gallicchio/AMOD-and-RFMOD/docs/DESIGN_NOTES.md

# Design notes

What the boards are and why they are the way they are, in one place; the decisions with reasons are in `PLAN.md`,
the night's record in `CLAUDE_CODE_CHAT.md`, the general lessons in `~/OpticsPCBs/CLAUDE_PCB.md`.  Rev A, 2026-10-25.

## AMOD-P: the passive board

13 tiles, 27 jacks, 139 parts.  AMOD-P: the passive board.  Sixteen cells, thirteen tiles (PLAN.md section 4), 27 SMA jacks, two layers.  Every tile here is a ladder (scripts/tiles.ladder) or a hand-laid circuit using the same Tile model; the responses the silkscreen and the handbook quote come from sim/passive.py.

- **p1 pi pad**: 
- **p2 RC low-pass**: 
- **p3 RC high-pass**: 
- **p4 series RLC**: Series RLC between the jacks: 100 uH and 220 pF, with 47 pF and 100 pF switched in parallel with the capacitor by a 2-way DIP.  The line runs 0.65 mm high so the 1210 clears both jacks; the switch lies across the top-right quarter the OUT jack left (its ways as columns), its left column on the L-C node through the gap between the two parts, its right column to the two capacitors standing under it, whose other ends are on the OUT line.  The number, the sections and the IN loop take the bottom-left; no OUT loop (the switch has its corner: OUT is the jack).
- **p5 LC low-pass**: 
- **p6 LC low-pass**: 
- **p7 band-pass**: Four 0603 series parts cannot fit between the stubs (10.5 mm): the row is laid by hand from x 2.3 to 17.7 and the stubs enter round its ends; the outer parts' values go under them, out of the entries' way.
- **p8 quartz crystal**: A 4 MHz crystal in series between the jacks: the sharpest resonance on the board.  An HC-49S is 11.5 mm long, more than either quarter of a cell the jacks leave, so it lies at 45 degrees across the cell, from the bottom-left to the top-right, and the two jacks sit 0.5 mm further out along the other diagonal (TLo, BRo) so its courtyard clears theirs.  Each jack's stub runs straight to the crystal's near pad; the loops stand on the stubs, the number in the top-right corner, the name in the bottom-left, the sections in the gutter above.
- **p9 ceramic res.**: A 455 kHz ceramic resonator in series between the jacks, at 45 degrees across the cell (bottom-left to top-right) between the IN jack (top-left) and the OUT jack (bottom-right); each stub runs to the resonator's near lead.
- **p10 clipper**: A 1 k series resistor and two 1N4148W antiparallel to ground: the tutorial's clipper.  The diodes stand up from the OUT line into the top-right quarter, either side of the OUT loop's lead, each to its own ground via above it.
- **p11 delay line**: 20 LC sections of 1 uH and 390 pF (50 ohm, 20 ns each): a 400 ns tapped delay line on three cells.  Each section is an 0603 inductor on the line and an 0402 capacitor hanging from the node after it, 4.0 mm a section.  The jacks sit on the checkerboard: IN at the first cell's top-left, OUT at its bottom-right, the 100 and 200 ns taps at the second and third cells' top-left, the 300 ns tap at the third cell's bottom-right.  Row A runs right along the line from IN under the top jacks (twelve sections), drops left of the 300 ns jack, and row B runs back along y = 15.25 (eight) into OUT; row B's capacitors stand up, between row A's.  Each tap leaves its node through 470 ohm: nodes 5 and 10 up past row A to a resistor beside their jack, node 15 down under row B and along the bottom edge into its jack from below.
- **p12 LEDs**: Four LEDs on a 4-way DIP from one jack through 100 ohm: V_f against wavelength is Planck's constant.  The switch stands with its ways as rows (pins 1-4 down its left column), the LEDs in a column to its left at the ways' order, each to its own ground via at the tile's edge; the LED loop sits in the empty top-right slot.
- **p13 AM loopstick**: An AM loopstick: a 3-way terminal for the ferrite rod's coil (ends and tap), 47 / 100 / 220 / 470 pF across it on a 4-way DIP, a 2-way terminal beside it for an external tuning capacitor (VAR C, in parallel with the switched ones), the jack on the tap; the rod lies along the board's bottom edge under two pairs of cable-tie slots.  Both terminals take their wires from the bottom edge, and their pins are named in the margin below them.  The DIP and its capacitors fill the right cell's top half: each capacitor's wire leaves its switch pad and turns up or down to its row (the top pad's wire outermost, so none cross).

## AMOD-N: the second passive board

11 tiles, 28 jacks, 84 parts.  AMOD-N: the second passive board, rev A (Prompt 17).  Eleven tiles on sixteen cells: the RF and analog blocks the other boards lacked or dropped, every one passive except two that run on the Pmod's own 3.3 V (no USB): a step attenuator set by hand on a switch or by the FPGA over three Pmod lines, and a one-transistor oscillator.  Prompt 18 gave the attenuator a second cell for its switch and dropped P15 (two Smith-chart loads): n1's 25 ohm standard and n11's switched loads cover the Smith chart.  Jason, Prompt 17: "It seems like there is enough pressure that I should make another analog board.  We should really call this the 2nd board because it's so much simpler than even the active board ... All of the things that you suggested along with some of the things that we've dropped should go on this new analog board ... SLOT for VNA-type calibration, passive splitters" and, mid-turn, "If something can run on 3.3V, it could still be plugged into the PMOD port but wouldn't require an external USB 5V input."  Four layers on JLC04161H-7628 as RF-MOD: L1 the parts and the drawn wires with a ground pour 0.25 mm from every 50 ohm line (coplanar waveguide over L2), L2 ground, L3 the Pmod's 3.3 V under the whole board, L4 ground with the back-side text and the Pmod lines.  Every jack has RF-MOD's launch (no plane under its centre pin) except the calibration SHORT, whose pin is the pour.

- **n1 calibration**: Calibration standards for a vector network analyzer (Jason: "SLOT for VNA-type calibration"): SHORT, OPEN and LOAD at the jacks' pins, a 25 ohm check standard, and a THRU.  Calibrating here puts the reference plane at the board's surface, so every other tile is measured from its pad with its own jack de-embedded (the jacks are all the same part). SHORT: the centre pin is ground, joined all round to the top pour (no launch void).  OPEN: the bare pin with its launch void.  LOAD: 4 mm of 50 ohm line into two 100 ohm in parallel (a matched line is still a match).  25 OHM: two 49.9 ohm at the end of 4.75 mm of line (VSWR 2, a known mismatch to check a calibration with).  THRU: 19.8 mm of line between two jacks.
- **n2 resistive splitter**: A resistive splitter: three 16.9 ohm in a star (50 / 3), every port 50 ohm, 6 dB from any port to either other, DC to 6 GHz, no isolation between the outputs (6 dB of it).  IN at the right cell's top-left, OUT 1 and OUT 2 at the two bottom corners, the star between them so both outputs' lines are the same length (8.7 + 4.65 mm).
- **n3 transformer splitter**: A transformer splitter: Mini-Circuits ADP-2-1+ (case CD636, 0.5-400 MHz, 3 dB plus 0.3, 25 dB between the outputs), turned 270 at the tile's middle so SUM faces the top jack and ports 1 and 2 the bottom corners on lines of the same length; pins 2 and 5 joined by a track under the body and kept off ground, as Mini-Circuits' layout PL-116 does.
- **n4 quarter-wave stub**: A quarter-wave open stub on the line from IN to OUT: 17.3 mm of the same coplanar waveguide, open at its end, a short circuit at the junction at 2.45 GHz (and 7.35 GHz): a notch.  The line's effective permittivity (about 3.1 on JLC04161H-7628) puts the notch within a few percent of 2.45 GHz; measure where it is.
- **n5 low-pass**: A low-pass: Mini-Circuits LFCN-1000+ (LTCC, 1206), DC-1000 MHz, 3 dB at 1.3 GHz, 30 dB from 1.9 to 5 GHz: the harmonics of a 915 MHz synthesizer off, and a clean LO.
- **n6 detector**: A diode detector: 51 ohm across IN (the match), 10 nF in series, a Skyworks SMS7630-006LF pair as a voltage doubler (pin 2, an anode, on ground; pin 3, the joint, the RF; pin 1, a cathode, the output), 100 pF and 100 k on the output. Zero-bias Schottky: square law below about -20 dBm (the output in volts goes as the power), linear above (as the amplitude); 0.9 us of video time constant, so an AM envelope or a pulse comes through.
- **n7 bias-T**: A bias-T: RF in on the top-left jack through 100 nF to RF+DC on the bottom-right, DC fed onto that line through 27 nH, 330 nH and 10 uH in series (the 27 nH nearest the line, for the GHz end) from a test loop (a bench supply's clip, the GND loop beside it), with 100 nF across the DC.  For an active antenna, an LNA at the end of a cable, a varactor or a detector diode's bias.
- **n8 step attenuator**: A digital step attenuator: pSemi PE43711 (QFN-24 4 x 4), 9 kHz-6 GHz, 0-31.75 dB in 0.25 dB steps, set by hand or by the FPGA (Jason, Prompt 18: "If the FPGA pins are high impedance, this would be nice to do manually").  An 8-way DIP switch above the chip: way 1 is SPI (P/S: off = parallel, the chip's "direct parallel" mode with LE held high by 100 k, which pSemi calls "ideal for manual control ... switches or jumpers"; on = serial), ways 2-8 the seven bits 0.25-16 dB (on = that much more attenuation), each pulled down by 100 k standing in the gap beside its line.  In serial mode the seven bits must be off (the datasheet: the parallel inputs grounded), and SDATA, SCLK and LE come from Pmod IO2, IO3 and IO4 (RF-MOD's SPI lines).  Either way the chip needs the Pmod's 3.3 V (150 uA): it is an active switch array. 100 nF blocks at both RF pins (they must sit at 0 V).  Two cells: IN at the left cell's top-left, OUT at the right cell's bottom-right, the chip between them; the plug below the left cell.
- **n9 oscillator**: A one-transistor oscillator on the Pmod's 3.3 V (switched): a Clapp (series-tuned Colpitts) on an MMBT3904 as an emitter follower, 10 uH in series with a BB133 varactor from the base (through 1 nF) to ground, 220 pF base to emitter and 220 pF emitter to ground, 100 k from the supply to the base (about 1.5 mA), 680 ohm in the emitter.  The varactor's cathode sits at (3.3 V + TUNE) / 2 through two 100 k, so TUNE's -2..+2 V moves it from 9.6 to 11.5 MHz (about 10.5 MHz at 0 V); 2.2 pF from TUNE to the same node lets a tone near the oscillator's frequency pull it into lock.  OUT through 22 pF from the emitter (about -22 dBm into 50 ohm).  The transistor stands over the switch's FET (collector down, to the supply); the tank fills the top-right quarter; the supply reaches the bias and the tank, and the output reaches the OUT jack's centre pin, on the back.
- **n10 1:1 transformer**: A 1:1 transformer (Mini-Circuits TC1-1TG2+, 0.4-500 MHz, separate windings) in the top-right quarter: IN over its top onto the primary, the secondary down onto the OUT jack, whose four legs are a ground of their own (an island with no plane within 5.6 mm), so OUT floats.  A balun (OUT's centre and shell are the two halves of a dipole, the tutorial's on-the-air feed) and a ground-loop breaker between an instrument and the host.  The centre tap is left open.
- **n11 1:4 transformer**: A 1:4 transformer (Mini-Circuits TC4-1W+, 3-800 MHz) in the top-right quarter: IN on the primary, the secondary from ground to OUT, so OUT's impedance is four times IN's and its voltage twice.  A DIP switch in the bottom-left quarter puts 200 ohm (IN then reads 50) or 49.9 ohm (IN reads 12.5) across OUT: the turns ratio squared, measured.

## AMOD-A: the active board

12 tiles, 21 jacks, 184 parts.  AMOD-A: the active board.  Sixteen cells, twelve tiles (PLAN.md section 5), four layers: L1 the parts and the drawn wires, L2 ground, L3 the rails as pours (+5 V everywhere, -5 V and +3.3 V in the gutters the tiles reach with a via), L4 ground fill with the Pmod lines and the back-side text.  Every powered tile has the standard header (scripts/tiles.power_header): a slide switch along its left edge and a P-FET between its jacks, so the tile's own rail is dead until the slider is up.  The dense tiles let scripts/router.py find their wires (Tile.route); the silk draws whatever it found, as it draws every hand-laid wire.

- **a1 power**: 
- **a2 x10**: Gain x10: an OPA810 (140 MHz GBW) non-inverting, 1.1 k and 10 k, 50 ohm in, 49.9 ohm out (x10 into a high impedance, x5 into 50 ohm); 14 MHz.
- **a3 x100**: Gain x100 in one OPA810 stage (100 ohm and 10 k): 1.4 MHz, x100 into a high impedance.  The plan's two stages of x10 (9 MHz) did not fit a 20 mm cell beside the switch with 0.2 mm clearances; a4 covers the HF case at x100.
- **a4 LNA**: HF LNA: the OPA847 (SOT-23-6) at x101 (1 k / 10 ohm) in the shared checkerboard geometry (opa_tile_br), 50 ohm at the input, 49.9 ohm out.  DIS (pin 5) is tied to +VS beside it: enabled.  The feedback pair sits right at the pins, as a decompensated amplifier needs.
- **a5 Doppler**: 10.525 GHz Doppler radar: an HB100 module on three jumper wires to a 1 x 3 header (+5 V from the tile's switch, IF, ground), its IF through 1 uF (100 k to ground) into the a2 geometry at x101 (100 ohm / 10 k), 49.9 ohm out.  1 m/s toward the module is 70 Hz; walking, a fan's blades, a speaker cone and breathing are all within reach.  (Rev A's first a5 was a Johnson-noise amplifier: the ECP5-2ADC-2DAC board has that source and a x100 input of its own.)
- **a6 1-bit ADC**: Delta-sigma: a TLV3501 compares the integrator node (IN through 10 k, the FPGA's bit back through 10 k, 10 nF to ground) with a mid-rail reference (10 k / 10 k / 100 n from VS); its bit goes to Pmod IO7 and a loop; the FPGA's bit comes in on Pmod IO8.  +3.3 V so the bit is the FPGA's logic level.
- **a7 PLL 4046**: PLL: a 74HC4046A in TSSOP-16 (rot 180: VCOin, DEMout, R1, R2, PC2, SIGin, PC3, VCC down the left column; GND, C1B, C1A, INH, VCOout, COMPin, PC1, PCP down the right) in the top-right quarter, between the diagonal jacks.  IN through 100 n and 1 k (below the IN jack) into SIGin (self-biased); the VCO (R1 10 k, C1 1 nF: about 100 kHz) out through 470 ohm (in the right strip, beside C1) to the OUT jack and back into COMPin; PC2's tri-state output up through the chip's middle to the 10 k / 100 n lag filter above it, into VCOin.  No loops: probe pin 9 (VCOin, the demodulated FM) and pin 13.
- **a8 heat**: Heater and thermometer: two 15 ohm 2512 in series across VS (0.83 W at 5 V), stacked in the top-left, switched by an AO3400 beside them from Pmod IO6 (10 k pull-down); a TMP235 (10 mV/K + 500 mV) straight above the OUT jack, its output dropping into the jack's pin.  (The plan's NTC divider did not fit beside the two 2512s.)
- **a9 mixer**: Mixer: the MC1496 (SOIC-14 across the cell, rot 90: SIG+, GAIN, GAIN, SIG-, BIAS, OUT+, NC along the bottom; VEE, NC, OUT-, NC, CAR-, NC, CAR+ along the top) on +-5 V.  RF IN through 100 n into SIG+, 51 ohm from each signal input to ground; LO IN through 100 n into CAR+, 51 ohm from each carrier input to a 2.5 V bias (10 k / 10 k / 100 n); 1 k between the gain pins, 3.9 k from BIAS to -5 V (1 mA), 1.5 k loads to the switched 5 V; OUT+ through 100 n to IF OUT (high impedance: 1.5 k source).  The board's Pmod lines pass down the back of this tile's middle x 14 ... 16.5, which the layout keeps free there.  No carrier-null trimmer.
- **a10 impedance**: Impedance and I-V, two cells, +-5 V.  Left: DRIVE IN (50 ohm) into the a2 geometry at x2 (1 k / 1 k): the driven node S, which also leaves through 49.9 ohm on S OUT (the bottom-right jack).  Right: a 4-way DIP picks the reference resistor (47, 470, 4.7 k, 47 k) from S to X, the part under test between X and ground on the DUT jack, and an OPA810 follower brings X out through 49.9 ohm on X OUT.  With the host's two ADCs on S OUT and X OUT (50 ohm: each reads half), I = (S - X) / R and Z = R X / (S - X): an impedance analyzer from DC to a few MHz after an open-short calibration, and an I-V curve tracer to +-4 V and 40 mA.  (Rev A's first a10 was an LED driver and a photodiode amplifier: the ECP5-2ADC-2DAC board has both.)
- **a11 ultrasound**: 40 kHz ultrasound, two cells.  Left: the DRV8837 H-bridge (IN1, IN2 from Pmod IO4 and IO3) drives a transducer in pins 1 and 5 of a 1 x 5 socket along the top edge; the Pmod plug hangs off the bottom edge below this cell, and the board's Pmod lines come down the back of this cell's right third to it.  Right: the second transducer in its socket, 10 nF into the a2 geometry at x100 (100 ohm / 10 k, 3.9 k to ground at +IN) and out to RX OUT at the right cell's bottom-right jack. +-5 V (the op amp), the bridge on the switched +5 V.
- **a12 audio**: Audio, two cells.  Left: a PAM8302A class-D amplifier (MSOP-8, rot 270: IN-, IN+, NC, SD along the top; VO+, VDD, GND, VO- along the bottom; JLCPCB stocks only the MSOP-8, PAM8302AASCR: the SOIC-8 first drawn here did not fit it, which JLCPCB's placement preview showed, Prompt 22) driving a speaker on the screw terminal in the right cell's top-left; its input is SPEAKER IN through 1 u and the one-bit stream from Pmod IO2 through 10 k into 10 n.  Right: an electret in the 1 x 2 socket (2.2 k bias from VS), 1 u into the a2 geometry at x100 and out to MIC OUT.  +-5 V (the op amp; the class-D runs on the switched +5 V).  No 3.5 mm jack: the one-bit stream is heard on the speaker.

## AMOD-C: the conversion board

12 tiles, 26 jacks, 209 parts.  AMOD-C: conversion, rev A (Prompt 19).  Sixteen cells, four layers, USB-C power on c1 as AMOD-A's a1.  Power conversion (a buck and an LDO under an electronic load, a charge pump the FPGA clocks) and data conversion (a second-order delta-sigma with its integrators on jacks, a track-and-hold, a comparator that makes the host's DAC a SAR or tracking ADC), the switched capacitors both use (a filter chip and a capacitor-and-two-switches resistor), and the component-level stages Analog Devices' university labs teach (a differential pair on a current mirror, common emitter against cascode, a precision rectifier, a 555).  `docs/ADI_LABS_SURVEY.md` has the survey; PLAN.md sections 12 and 13 the decisions.  Jason, Prompt 18: "Whole areas that we are missing include power regulation and other component-level circuits, but something like a switched capacitor filter or details of their Delta - Sigma Modulator, if there is room, might be worth it."  L1 the parts and the drawn wires, L2 ground, L3 the rails (+5 V under the board; -5 V in the gutter under row 0, down the left margin and along the bottom margin; +3.3 V in the gutters under rows 1 and 2, joined down the right margin), L4 ground with the Pmod lines and the back-side text.  Every powered tile has the standard header (tiles.power_header): a slide switch and a P-FET, so its rail is dead until the slider is up.

- **c1 power**: 
- **c2 regulators**: A buck converter, an LDO after it and an electronic load, two cells.  Left: the TLV62568 (1.5 MHz, pulse-skipping at light load) from the switched 5 V with 2.2 uH, 10 uF in and out, its feedback 100 k / 20 k (3.6 V) and TRIM (a DAC) through 100 k into the feedback node, so the buck's output moves 2.2-5 V and the LDO can be pushed into dropout; BUCK~ is its output AC-coupled (1 uF, 49.9 ohm) for the ripple.  Right: the TPS7A2033 LDO (3.3 V) from the buck, LDO~ its output AC-coupled likewise; an OPA810 holds 10 ohm at LOAD's voltage through an AO3400A: 100 mA per volt from the LDO's output (LOAD terminated in 49.9 ohm), its loop closed slowly through 1 k and 1 nF so the FET's gate cannot make it ring.  The buck (SOT-23-5 at rot 0: EN, GND, SW down its left; VIN, FB up its right) in the left cell's top-right quarter, EN to VIN under its body, the inductor under SW, the feedback network stacked right of FB; its output along y 9.8 to BUCK~'s coupling in the gutter and on the back to the LDO in the right cell's top-right quarter (turned 0: IN, GND, EN down its left; OUT up its right), whose output goes right and down to LDO~'s coupling over its jack and left and down to the load in the right cell's bottom-left quarter.
- **c3 charge pump**: A charge pump the FPGA clocks: the ICL7660A from the switched 5 V, its OSC pin driven from Pmod IO6 through an SN74LV1T34 and 1 k (the pump runs at half the clock), 1 uF flying and 1 uF on the output, 1 k of load on the output; CAP shows the flying capacitor's top (0-5 V) and OUT the output (about -5 V), each through 47 k / 10 k (read at high impedance).  SOIC-8 at rot 0 (BOOST, CAP+, GND, CAP- down its left at 11.925; V+, OSC, LV, VOUT down its right at 16.875) in the top-right quarter: the flying capacitor standing left of it with CAP's 47 k above, the output capacitor, V+'s capacitor and the load down the right edge, OSC under the body to the 1 k from the buffer below; CAP's 10 k under its jack, OUT's divider over the OUT jack.  VS comes up the back to the buffer and V+; IO6 from the back.
- **c4 SC filter**: A switched-capacitor filter: the MAX7410 (5th-order Butterworth, fc = fCLK / 100, 5 V) clocked from Pmod IO3 through an SN74LV1T34 (the clock pin wants 4.5 V); IN terminated in 49.9 ohm and AC-coupled into the chip's input, biased at COM (2.5 V) by 100 k; OS on COM; OUT AC-coupled through 1 uF and 49.9 ohm to the OUT jack.  The chip at rot 0 (COM, IN, GND, VDD down its left at 12.8; CLK, SHDN, OS, OUT down its right at 17.2), the buffer above its right side, VS up the back along the tile's right edge to SHDN and the buffer.
- **c5 SC integrator**: A switched-capacitor resistor and integrator, two cells along the top: a TMUX4053 (three SPDTs on +-5 V, 3.3 V logic) switches 1 nF between IN and ground on one side (phi1, Pmod IO4) and between ground and the integrator's summing node on the other (phi2, IO8): the parasitic-insensitive integrator, whose resistor is 1 / (f C).  An OPA810 with 10 nF (C0G) and 1 M across it integrates; OUT through 49.9 ohm.  The FPGA makes the two phases, so it can make them overlap on purpose.  The third switch is grounded.  The chip turned 180 in the right cell's top-left quarter (SEL3, SEL2, SEL1, S1A, S1B, D1, D2, VDD down its left at 24.14; GND, VSS, EN, S3A, D3, S3B, S2A, S2B down its right at 29.86), its grounds joined under its body; IN along y 4.75 from the jack; the capacitor standing left of D1 and D2.  The integrator below (the OPA810 at rot 270: +IN, V-, OUT along its top, -IN and V+ along its bottom), the summing node coming down from S2B to a column on its left, the feedback pair lying under it, OUT over to the right and on to the jack between its top legs.  VS up the back from the header; -5 V on the back to the right edge and the gutter.
- **c6 delta-sigma**: A second-order delta-sigma modulator with its insides on jacks, two cells.  Both OPA2810 integrators sit on a 1.65 V virtual ground (VMID: the board's +3.3 V halved by two 0.1 % 10 k), so each one-bit DAC is just an SN74LVC1G3157 switching 10 k between +3.3 V and ground: +-165 uA about VMID, ratiometric with VMID, with no negative reference; 10 k from +3.3 V into the first node cancels IN's own offset from VMID.  IN through 10 k into 220 pF, the first output through 6.8 k into 680 pF; a TLV3501 compares the second output (through 10 k, which limits the current into its input clamps when an integrator rails) with VMID; a 74LVC1G79 registers it on the FPGA's clock (Pmod IO1) and hands the bit to IO7 and to both switches (the first wired the other way round, so both loops are negative).  INT1 and INT2 on their jacks through 3.3 k / 1 k (read at high impedance: about a quarter, offset by 0.38 V).  Full scale +-1.65 V; clock 1 MHz.  The OPA2810 (SOIC-8 at rot 0: OUT A, -IN A, +IN A, V- down its left at 24.5; V+, OUT B, -IN B, +IN B down its right at 29.5) in the right cell's top-left quarter: the first integrator's parts on a column left of it, the second's right of it; OUT A crosses under the body and out of its bottom to the 6.8 k and INT1's divider; +IN A and +IN B on vias under the body joined on the back, V+ on a via under the body.  The comparator and the register over the right cell's top-right, the second switch under the second integrator, the first switch beside its 10 k; VMID's divider in the right cell's bottom-left quarter.  VS comes along the bottom edge and up the back; the bit and IO1 leave on the back for the Pmod plug.
- **c7 track and hold**: A track-and-hold: the LF398 on +-5 V (its minimum), 1 nF C0G as the hold capacitor, LOGIC from Pmod IO5 (high: track; TTL threshold 1.4 V, so 3.3 V drives it), LOGIC REF grounded; IN terminated in 49.9 ohm, OUT through 49.9 ohm. The SOIC-14 turned 90 low in the cell (IN, V-, OUT along its bottom at y 10.08; OFFSET, V+, LOGIC, LOGIC REF, CH along its top at 5.13), the hold capacitor, V+'s capacitor and the logic's via in the band above it; IN down the left to pin 1, its termination below; OUT round the right edge to its 49.9 ohm and in between the jack's right legs; V- to a via under the body and on the back to its capacitor in the strip left of the jack and the bottom margin; VS up the back on the left.
- **c8 comparator**: A comparator for a successive-approximation or tracking ADC whose DAC is the host's: a TLV3201 on +3.3 V (40 ns, 1.2 mV of hysteresis: the TLV3501's 6 mV would be 12 LSB at 12 bits) compares IN with DAC, each averaged with the 3.3 V rail through a matched pair of 0.1 % 10 k (so both sit at 1.15-2.15 V inside the comparator's range and the comparison is unchanged), its decision to Pmod IO2 and a loop.  The gateware runs the search: set the DAC, read the bit, halve the step.
- **c9 differential pair**: A differential pair on a current mirror, two cells along the bottom: a matched NPN pair (DMMT3904W) with IN+ (DAC 1) and IN- (DAC 2) on the bases, each terminated in 49.9 ohm, their emitters on a 1 mA tail (an MMBT3904 with its base at -3.4 V from 6.8 k / 3.3 k and 1 k to -5 V); a matched PNP pair (BCM857BS) mirrors the left collector's current onto the right one, so the output node carries Ic1 - Ic2, which an OPA810 transimpedance stage (1 k) turns into OUT: tanh of the input difference over 2 VT, +-1 V at the tail's full 1 mA.  The mirror (SOT-363 turned 180: E2, B2, C1 down its left; C2, B1, E1 down its right) over the pair (turned 180: E1, E2, C2 down its left; C1, B1, B2 down its right) in the left cell's top-right quarter; IN- comes down the right to B2, IN+ down the left to a via, under the pair on the back to a via right of it and in to B1 (a SOT-363 leaves no room for a via under its body); the mirror's emitters joined under its body; the pair's joined on the left and down the middle under the body to the tail; the mirror's diode node in the channel between the two; the tail standing under the pair with its divider and emitter resistor below.  The output node reaches the TIA (rot 270 in the right cell's bottom-left quarter, its feedback lying under it) on the back.  The Pmod plug in the margin below the left cell.
- **c10 cascode**: Common emitter against cascode: Q1 (one half of a DMMT3904W matched pair) at about 1.4 mA with 100 ohm in its emitter and a 1 k collector load, biased by a chain from the switched 5 V (33 k / 20 k / 10 k: 2.4 V on the cascode's base, decoupled; 0.8 V on Q1's); IN terminated, AC-coupled and through 2.2 k, so the Miller capacitance shows; Q2 (the pair's other half) the cascode; a jumper on the 1 x 2 header shorts the cascode out (common emitter), parked on one pin it leaves it in; Q3 (MMBT3904) an emitter follower at about 6 mA into 1 uF and 51 ohm on OUT.  Gain about -8 at Q1's collector, -6 from IN (the 2.2 k against the stage's 6 k); the cascode lifts the bandwidth several times.  The pair (SOT-363 turned 180: E1, E2, C2 down its left; C1, B1, B2 down its right) in the middle of the top-right quarter, Q2's emitter to Q1's collector under the body; Q1's base out to a via on the right and on the back to the input network's column left of the pair; the header at the right edge; Q3 under the pair, its output down the strip left of the OUT jack and in between the jack's left legs.  C2 reaches the header, Q3's base and its collector resistor on the back; VS comes up the back round the jack's legs.
- **c11 555**: A 555 as a VCO: the TLC555 (CMOS) astable from the switched 5 V, 1 k and 10 k with 10 nF C0G (about 6.9 kHz); CV (a DAC, terminated) into the control pin through 2.2 k moves the thresholds and the frequency; OUT through 3.9 k / 1 k (about 1 V, read at high impedance).  SOIC-8 at rot 0 (GND, TRIG, OUT, RESET down its left at 11.725; VDD, DISCH, THRES, CONT down its right at 16.675) in the top-right quarter; the timing chain (1 k, 10 k, 10 nF) standing down the right edge, TRIG to THRES under the body; RESET to a via under the body and on the back to VS, which comes up the right edge round the jack's legs; OUT down the left to its divider and along the middle to the jack; CV on the back from beside its jack to the 2.2 k standing under CONT.
- **c12 rectifier**: A precision full-wave rectifier: an OPA2197's first half inverts IN through two Schottky diodes (BAT54S), so its second node X is -IN for positive inputs and 0 for negative ones; the second half sums -(IN + 2 X) = |IN|.  10 k / 10 k / 20 k / 10 k / 20 k; IN terminated, OUT through 49.9 ohm.  The chip (VSSOP-8 on KiCad's MSOP-8 pattern at rot 0: OUT A, -IN A, +IN A, V- down its left at 12.29; V+, OUT B, -IN B, +IN B down its right at 16.51) in the top-right quarter; OUT A goes under its body to the diodes' common pin below it, -IN A out to a column on the left that comes down to the X-to-N 10 k standing beside the diodes and on to the first stage's 10 k from IN.  The second half's Rf and V+'s capacitor stand right of the chip, its inputs lie under it on a column from -IN B, OUT B goes down the right edge to the 49.9 ohm over the jack.  X and IN reach the second stage on the back (IN comes down from its jack to the first stage's resistor); VS comes up the back round the jack's legs; -5 V goes down the back on the left to the bottom margin.

## AMOD-M: the motor board

11 tiles, 18 jacks, 205 parts.  AMOD-M: motors, rev A (Prompt 19).  Sixteen cells, four layers, USB-C power on m1 as AMOD-A's a1 and a motor supply of 5-16 V on m2 (a barrel jack), with the USB's 5 V joining it through a Schottky.  A brushed DC motor with its encoder (DRV8251A, the FPGA's PWM, the current and the back-EMF on jacks), a stepper (two DRV8251A), and the actuators whose command comes from a DAC (a servo, a solenoid with its flyback chosen by a jumper, a DC-coupled power amplifier for a voice coil or an electromagnet, a buck stage the FPGA closes the loop on); the sensors those loops need (a linear hall sensor, a reflective optical sensor, a load cell's amplifier).  PLAN.md section 14 has the decisions; the parts research of 2026-10-28 the choices.  Jason, Prompt 19: "motor drivers and mechanical servo-type feedback.  DC motor, stepper motor, 3-pole BLDC motor ... along with encoders or magnetic back reaction or some other fast mechanical feedback."  The brushless half is AMOD-B.  L1 the parts and the drawn wires, L2 ground, L3 the rails (+5 V under the board; -5 V in the gutters under rows 0 and 2 and down the left margin; +3.3 V in the gutter under row 1), L4 ground with the motor rail VMOT (a 1.6 mm track along the top margin and down the gutter between columns 1 and 2, which every motor tile taps), the Pmod lines and the back-side text.  Every tile with a +5 V load has the standard header (tiles.power_header): a slide switch and a P-FET; VMOT itself is not switched.

- **m1 power**: 
- **m2 motor supply**: The motor supply, one cell at the right edge: a 5.5 / 2.1 mm barrel jack (its face at the edge, in the cell's bottom-right quarter; no screw terminal, whose place the board's rubber foot takes: bare leads want a barrel-to- terminal adapter) through an SS34 into VMOT, the USB's +5 V through another; an SMBJ16A (26 V clamp: under the buck's 30 V FETs and the TPS28225's 27 V) and 220 uF on VMOT, which also soak up a motor's braking energy (the Schottkys stop it reaching the supply); a green LED; VMOT / 16 (15 k / 1 k) through 49.9 ohm on the VM jack (top-left).  VMOT leaves on the back down the gutter on the tile's left and along the gutter under row 0 to the bus at x 50, which every motor tile taps.  The electrolytic lies in the top-right quarter, the TVS stands down the left edge, the two Schottkys (cathodes left) in the middle, the divider under the jack.
- **m3 DC motor**: A brushed DC motor with its encoder, two cells along the bottom, the Pmod plug in the margin under the left cell. A DRV8251A (4.1 A, its undervoltage lockout at 4.45 V at most, so USB's 5 V through m2's Schottky runs it) from VMOT: IN1 on Pmod IO7 and IN2 on IO1 (pulled down in the chip: the motor coasts with no FPGA, and sleeps after 1 ms), drive / brake (IPROPI continuous) or drive / coast (the back-EMF shows in the off time) as the gateware chooses; VREF 2.0 V (1.5 k / 1 k from the switched 5 V) with 620 ohm on IPROPI: a 2 A limit, 0.98 V/A, and the tile's switch takes the limit to zero.  An OPA2171 on +-5 V: one half buffers IPROPI onto I through 49.9 ohm, the other takes the terminal voltage, (M1 - M2) / 13 (13 k / 1 k), onto V.  The motor and its hall encoder on a 6-way JST PH (2.0 mm) in the bottom margin: 1 M1, 2 GND, 3 A, 4 B, 5 3.3 V (a TPS7A2033 of its own, so A and B are 3.3 V logic), 6 M2 (an N20 with a ZH plug needs a ZH-to-PH lead); A on IO5, B on IO6 (the encoder's pull-ups, or the FPGA's).  The driver turned 270 in the left cell (its logic up, VM out to the left, OUT1 and OUT2 down and right to the PH); the op amp in the right cell's top-right quarter beside I, its two 13 k at the PH, its inputs up the cell's right edge; V on the left jack, reached along the top.
- **m4 stepper**: A bipolar stepper, two cells above m3: two DRV8251A (4.1 A, IN1 / IN2: the gateware makes EN / PH or microsteps from them) from VMOT, coil A's IN1 on Pmod IO2 and IN2 on IO3, coil B's IN1 on IO4 and IN2 on IO8 (each pulled down in the chip; the assignment is the one whose lanes to the plug never cross).  VREF 1.0 V from the switched 5 V with 620 ohm on each IPROPI: 1 A per coil, and the tile's switch takes the limit to zero; each IPROPI through 10 k onto IA, IB (0.98 V/A, read at high impedance; the 10 k keeps a 50 ohm input from upsetting the regulation).  The motor on a 4-way JST XH (A+, A-, B+, B-) between the drivers at the bottom, each OUT2 on its coil's + pin; VMOT from the bus on the back to each driver's VM. Each driver turned 270, A's in the left cell, B's in the right; the Pmod lines go up from vias above each driver to the gutter over the tile, along it to the left margin and down it to the plug under m3 (BACK_WIRES).
- **m5 servo**: An RC servo, one cell: CMD (a DAC's pulse of 0 / +1 V, terminated in 49.9 ohm) through 10 k into a TLV3501 on the switched 5 V whose threshold is 0.49 V (47 k / 5.1 k), its 5 V output on a 3-pin header (S, +, -) that powers the servo from the same switched 5 V (10 uF beside it); the servo's ground returns through 0.05 ohm, read by an INA181A1 (x20: 1 V/A) onto I through 49.9 ohm.  A 1-2 ms pulse every 20 ms from the DAC sets the angle; the current shows the load. The comparator and the INA181 stand in the top-right quarter, the header at its right edge, the shunt in the middle.
- **m6 solenoid**: A solenoid's low-side switch, two cells at the top left: CMD (a DAC's pulse of 0 / +1 V, terminated in 49.9 ohm) through 10 k into a TLV3501 on the switched 5 V (threshold 0.49 V, as m5), its output through 49.9 ohm to an NCE6020AK's gate (60 V, 20 A, 40 mohm at 4.5 V; 100 k holds it off), the FET lying in the left cell with its tab (the drain) to the right.  The coil on a 2-way screw terminal at the top of the right cell (wires in from the top margin): VMOT on pin 2 from the bus beside it (10 uF), the drain on pin 1.  The flyback by jumper on a 1 x 3 header: 1-2 a B5819W from the drain to VMOT (slow decay: the current circulates at the diode's 0.4 V), 2-3 an SMAJ24A from the drain to ground (fast decay: the drain clamps near 30 V), no jumper the FET's own avalanche near 70 V.  The source returns through 0.05 ohm, read by an INA181A1 (x20, on +5 V) onto I through 49.9 ohm (1 V/A); the drain through 5.1 k / 100 ohm onto VD through 49.9 ohm (the drain / 52).  The comparator above the FET as in m5, the shunt and the INA181 under it, the header, the clamps and the divider in the right cell's left half; the drain reaches the terminal on the back.
- **m7 linear amp**: A DC-coupled bridge amplifier, two cells in row 2 on the right, for a voice coil, a speaker as an actuator or a maglev's electromagnet: a TCA0372 (two 1 A power op amps, 40 V) from VMOT.  Side A inverts IN (terminated in 49.9 ohm) with a gain of 2 about VMOT / 2 (10 k in, 20 k back, its + input at VMOT / 6), side B inverts side A about VMOT / 2 (10 k, 10 k): the load between them sees 4 x IN, +-4 V for +-1 V, both ends at VMOT / 2 with IN at 0.  One chain (2 x 15 k, 20 k, 10 k: 3 : 2 : 1) sets both + inputs, so their ratio holds whatever VMOT is.  The load on a 2-way screw terminal in the right margin; its current through 0.1 ohm (in series, on side A's lead) read by an INA181A1 (x20 about 2.5 V from 1 k / 1 k) and an OPA810 on +-5 V that takes away the 2.5 V and halves it: I = 1 V/A, through 49.9 ohm.  No switch: the amplifier runs from VMOT, which no switch takes away, and sits at 0 V across the load with IN at 0.  The TCA0372 dissipates up to VMOT^2 / (4 R): about 1 W is its limit (thermal shutdown beyond), so 8 ohm at 5-6 V, or 30 ohm and more at 12 V.  The TCA0372 turned 270 at the right end of the right cell (its inputs to the left, its outputs to the terminal), the chain to its left, the shunt and the INA181 under the terminal, the difference amplifier in the left cell's lower-left corner; side A's output reaches side B's input on the back.
- **m8 buck stage**: A synchronous buck power stage the FPGA closes the loop on, two cells at the bottom right: PWM (a DAC's square wave, 0 / +1 V, terminated in 49.9 ohm) through 10 k into a TLV3501 on +5 V (threshold 0.49 V, as m5) that drives a TPS28225 (5 V gate driver, 14 ns adaptive dead time, its own bootstrap diode; 220 nF of bootstrap; its EN from the tile's switch through 100 k, so the switch stops it) and two AO3400A (30 V, 32 mohm at 4.5 V) from VMOT (22 uF beside them); 47 uH (SWPA6045, 1.2 A) into 2 x 22 uF, the output on a 2-way screw terminal in the right margin.  At 200 kHz from 12 V to 5 V the ripple is about 0.3 A peak to peak.  The inductor's current through 0.05 ohm (between it and the output) read by an INA181A1 (x20) onto I through 49.9 ohm: 1 V/A, as m5's and m6's, one way only (at light load the synchronous stage's current dips below zero and I sits at 0 there); VO / 16 (15 k / 1 k) through 49.9 ohm.  The half-bridge, its input capacitor and the inductor along the right cell's top, the driver under the FETs, the shunt and the INA181 under the inductor; the comparator, the switch and VO's divider in the left cell.
- **m9 hall**: A linear hall sensor, one cell: a DRV5055A3 (25 mV/mT at 5 V, +-85 mT, ratiometric about half its supply) in the top-left quarter where a magnet can come close, on the switched 5 V; an OPA810 on +-5 V subtracts half the supply (two 20 k from VS and ground on its -IN, the same ratio as the sensor's) and scales by 0.39 (10 k / 3.9 k): OUT is 9.75 mV/mT, +-0.83 V at +-85 mT, through 49.9 ohm.  The maglev and the position loops' sensor.
- **m10 optical**: A reflective optical sensor, one cell: a QRE1113GR (IR LED and phototransistor in one 2.9 x 3.6 mm package, best at 1 mm, useful to a few) in the top-left quarter facing up; the LED at 21 mA through 180 ohm (0805) from the switched 5 V; the phototransistor's collector held at 0 V by an OPA810 (its emitter on -5 V through 100 ohm), so OUT = 1 k x the collector current (0.1-0.9 mA: 0.1-0.9 V), with 100 pF across 1 k, through 49.9 ohm.  Distance, a reflective mark on a wheel (a tachometer), an edge.
- **m11 load cell**: A load cell's amplifier, one cell, always on (no switch: the bridge draws 5 mA): a 4-way JST XH standing down the left edge (1 E+ red, 2 E- black, 3 S- white, 4 S+ green) excites the bridge from +5 V; an INA828 on +-5 V at gain 201 (249 ohm, lying above it between pins 1 and 8) reads it, REF on ground, its output through 49.9 ohm onto OUT (the INA828's own 10 kHz at this gain is the filter).  A 1 mV/V cell at 5 V gives 5 mV at full load: about 1 V out.

## AMOD-B: the brushless board

12 tiles, 13 jacks, 145 parts.  AMOD-B: brushless, rev A (Prompt 19).  Sixteen cells, four layers, USB-C power on b1 as AMOD-A's a1 and a motor supply of 5-12 V on b2 (a barrel jack), with the USB's 5 V joining it through a Schottky.  A gimbal motor (a GBM2804H-100T class, 12N14P) on four radial slots over an MT6701 magnetic angle sensor and two linear hall sensors in the middle of the board, on a 2 x 2 tile; a DRV8311H three-phase driver under it from three FPGA PWM lines, its low-side current amplifiers on jacks and a DAC's COAST that lets every phase float; the bus current and one phase's current in line, the phase voltages against a virtual neutral (the back-EMF), the encoder's analog angle, the halls, an index sensor under the rotor's rim, a vibration pickup and an IMU on SPI.  PLAN.md section 14 has the decisions; the parts research of 2026-10-28 the choices.  Jason, Prompt 19: "3-pole BLDC motor (like for a drone or even better a gimbal), along with encoders or magnetic back reaction or some other fast mechanical feedback."  The brushed motors and the slow actuators are AMOD-M.  L1 the parts and the drawn wires, L2 ground, L3 the rails (+5 V under the board; -5 V in the gutters under rows 0 and 2, along the bottom margin and down the left margin; +3.3 V in the gutter under row 1, which runs under the gimbal's middle, with a band over the gimbal's side slots, which cut the strip, so the middle under the encoder joins the rest), L4 ground with the motor rail (VMOT from b2 down the gutter between columns 2 and 3 to b12's shunt, VMB from it on to the driver), the lines between tiles (the Pmod's SPI lines up the gutter between columns 0 and 1 to b6, the encoder's, the halls' and the index's from b5; BACK_WIRES) and the back-side text.

- **b1 power**: 
- **b2 motor supply**: The motor supply, one cell at the right edge (AMOD-M's m2 with a 12 V clamp): a 5.5 / 2.1 mm barrel jack (its face at the edge) through an SS34 into VMOT, the USB's +5 V through another; an SMBJ12A (20 V clamp, under the DRV8311's 24 V absolute maximum) and 220 uF on VMOT, which take a motor's braking energy; a green LED; VMOT / 16 (15 k / 1 k) through 49.9 ohm on the VM jack.  VMOT leaves on the back left to the gutter beside the tile and down it to b12.
- **b3 BLDC driver**: The three-phase driver, two cells along the bottom, the Pmod plug in the margin under the left cell: a DRV8311H (3-20 V, 5 A peak, 210 mohm) from VMB in 3x PWM mode: INHA on Pmod IO5, INHB on IO1, INHC on IO2 set each phase high or low; the three INL pins together are EN, from COAST (a DAC's 0 / +1 V, terminated in 49.9 ohm) through a TLV3501 on the driver's own 3.3 V (AVDD): COAST high floats every phase, so the back-EMF shows on b4.  The strap pins left open: MODE 3x PWM with a 9 A trip, SLEW 180 V/us, GAIN 1 V/A.  nSLEEP from the tile's switch (10 k, 100 k down); nFAULT left open.  Its low-side current amplifiers SOA and SOB (CSAREF = AVDD: 1.65 V + 1 V/A) each shifted to 0 by 3.3 k from SOx and 10 k to -5 V (1.65 x 10 = 5 x 3.3): IA, IB = phase A's and B's currents while the low side conducts, 0.75 V/A from 2.5 k (no amplifier: an ADC's or a scope's high-impedance input reads them).  The motor on a 3-way screw terminal at the top of the right cell (wires in from the gimbal above), its phases C, B, A from the left; phase A out to b11's shunt and back.  The driver turned 90 in the middle (VM and the outputs to the right, INH up to vias for the Pmod lanes on the back, the current amplifiers down), COAST's comparator by its jack.
- **b4 back-EMF**: The back-EMF, one cell left of the driver: each phase through 13 k / 1 k (/14: 12 V reads 0.86 V); with every phase floating (b3's COAST) the three dividers are the motor's ground, so A and B read each phase against the neutral: its back-EMF, the sinusoid a spun motor makes.  A and B followed by an OPA2171 on +-5 V, through 49.9 ohm; C's divider keeps the star balanced.  The phases arrive on the front along the gutter over the tile from b3.
- **b5 gimbal**: The gimbal motor, four cells in the middle of the board: its stator on four radial slots (3.4 mm wide, 6-10 mm from the centre: M2-M3 screws on any of the patterns reported for a 2804, the motor turned to suit) over an MT6701 (14-bit, SSI: CLK on SCK, CSN on CS ENC, DO to b6's buffer, which puts it on MISO only while CS ENC is low; its analog angle and its 3.3 V to b7) at the centre, where a 6 x 2.5 mm diametric magnet on the shaft's end sits 0.5-2 mm above it (the motor on spacers); two DRV5055A3 linear halls under the rotor's magnets 14.5 mm out, 17.1 degrees apart (120 electrical degrees for 7 pole pairs), to b10; a QRE1113 under the bell's rim 16.5 mm out toward b9 reads a white mark once a turn.  The motor's leads go to b3's terminal; no jacks here (the bell would cover them).  The motor's outline and its stator's are drawn on the silk.
- **b6 IMU**: The IMU and the SPI lines' junction, one cell left of the gimbal's lower half: an LSM6DSO (gyro to 2000 dps, accelerometer to 16 g, both to 6.66 kHz) on SPI (mode 3, 10 MHz) and the 74LVC1G125 that puts the encoder's DO on MISO only while CS ENC is low (the MT6701's DO never lets go), so the two share the Pmod's MISO.  The five lines come up the gutter on the back from the plug under b3 (BACK_WIRES); SCK, CS ENC and DO go on to the encoder on b5; the +3.3 V from the strip in the gutter over the tile.  Stand the board on edge with the motor's axis horizontal and the accelerometer sees the roll about it: a one-axis gimbal's level reference.  No jacks: its data comes over the Pmod.
- **b7 angle**: The encoder's analog angle, one cell at the top left: the MT6701's OUT (0 to its 3.3 V over a turn, a sawtooth) from b5 into an OPA810: ANG = 0.51 x (OUT - 1.65 V), +-0.84 V over the turn, through 49.9 ohm (the 1.65 V from 20 k / 20 k of the same 3.3 V, so it tracks: the MT6701's own, which comes with the angle up the gutter on the back).  The angle without the SSI: a scope's or an ADC's view of the shaft.
- **b8 vibration**: A vibration pickup, one cell at the top: a piezo disc on a 2-way screw terminal (wires in from the top margin) into an OPA810 charge amplifier (1 nF with 1 M across: OUT = -Q / 1 nF above 160 Hz), through 49.9 ohm.  Stick the disc to the motor's mount: the cogging and the commutation's ripple, the bearing's noise, the frame's resonances.
- **b9 index**: The index, one cell at the top over the gimbal: the QRE1113 under the bell's rim (on b5) held at 0 V on its collector by an OPA810 (its emitter on -5 V through 100 ohm): IDX = 4.7 k x the collector current, 100 pF across, through 49.9 ohm.  A white mark on the bell's rim gives a pulse once a turn: an index for the encoder, a tachometer.
- **b10 halls**: The halls, one cell left of the gimbal: the two DRV5055A3 under the rotor's magnets (on b5, 120 electrical degrees apart) each less half its 5 V (20 k / 20 k) times 0.39 (10 k / 3.9 k), as AMOD-M's m9: HA, HB = 9.75 mV/mT through 49.9 ohm.  Two sinusoids in quadrature-ish: an analog encoder of the rotor's electrical angle, the commutation a hall-sensored motor uses, and the rotor's field to compare with the back-EMF.
- **b11 phase current**: Phase A's current in line, one cell right of the driver: phase A from b3 through 0.05 ohm and back to the motor's terminal, read by an INA240A1 (common mode -4 to 80 V and its PWM rejection: the phase swings the whole supply at every edge) about half its 5 V (REF1 on 5 V, REF2 on ground) and an OPA810 that takes the 2.5 V away: IPA = the phase's whole current, both ways and through every PWM state, 1 V/A, through 49.9 ohm.  Set beside b3's IA (the low side only, sampled) it shows what a low-side amplifier misses.
- **b12 bus current**: The bus current, one cell beside the gimbal: VMOT from b2 through 0.1 ohm (VMB on to the driver), read by an INA181A1 about 2.5 V and an OPA810 as AMOD-M's m7: I = the driver's supply current, 1 V/A both ways (negative while the motor brakes and gives its energy back), through 49.9 ohm.  With VM it is the electrical power in; against the phase currents it is the driver's losses.  The shunt and the INA181 in the top-left corner beside the bus, the difference amplifier right of them, I bottom right.

## RF-MOD: the RF board

10 tiles, 24 jacks, 164 parts.  RF-MOD: 915 MHz and 2.4 GHz, rev A.  Four layers: L1 the parts, the drawn wires and, on the RF tiles, a ground pour 0.25 mm from every 50 ohm line (coplanar waveguide over L2); L2 ground; L3 the rails (+5 V everywhere, +7.8 V in the gutter under row 1); L4 ground with the back-side text.  Every jack of an RF tile has a launch void under its centre pin (no copper on L2-L4 within 2.2 mm, the top pour 1.9 mm away) and every 50 ohm line a fence of ground vias.  Every tile keeps IN at the top-left slot and takes OUT at the bottom-right slot (not top-right as the AMOD boards do): the jacks then form a checkerboard whose closest pair is 14.85 mm apart instead of 10.5, room for fingers and a wrench.  Rev A builds what JLCPCB had in stock on 2026-10-25: a diode-ring mixer (r1, in the splitter's place since Prompt 15), the two filters (r2, r4), the QPL9547 LNA (r5) and a GALI-84+ gain block (r12), the power and reference tile (r9), two ADL5350 mixers (r7, r8), a MAX2871 synthesizer (r10, which carries the Pmod plug) and the TRF3722 quadrature transmitter (r13: Jason's "Yes. Add that tile.", Prompt 13). The printed antennas, the RFX2401C front end and the LTC5510 mixers stayed out.

- **r1 diode mixer**: A double-balanced diode-ring mixer: Mini-Circuits ADEX-10L+ (case CD542, 10-1000 MHz, LO +4 dBm) in the top-middle of the left cell (rot 0: LO pin 6 top-left, RF pin 3 bottom-right, IF pin 2 bottom-middle, ground 1, 4, 5), LO from the top-left jack along y 4.75 between its legs and up into pin 6, RF from pin 3 to the right cell's top-left jack, IF straight down to the left cell's bottom-right jack.  The right cell's bottom half draws what is inside the package: the LO balun, the ring of four Schottky diodes (two of them crossed), the RF balun whose centre tap is the IF.  Passive, no power: the comparison with r7/r8's ADL5350 at 915 MHz and with AMOD-A's a9 Gilbert cell at 10-30 MHz (Jason, Prompt 15: "Do the diode-ring mixer instead of the least useful passive splitter").
- **r2 2.45 GHz filter**: 2.45 GHz band-pass: Murata LFB212G45SG8A127 LTCC (2.0 x 1.25 mm), 1.7 dB loss, 2.4-2.5 GHz, 50 ohm both sides; pads 4 in, 2 out, 1 and 3 ground (as JLCPCB numbers them).
- **r4 915 MHz filter**: 915 MHz band-pass: RF360 B39921B2672P810 SAW (1.4 x 1.1 mm, 5 pads), 902-928 MHz, 1.1 dB loss; pad 1 in, 4 out, 2, 3 and 5 ground (the datasheet's section 4).  The output pad sits 0.29 mm above the line: a short 45 degree jog brings it back; pad 3, below it, joins pad 2's ground.
- **r5 LNA**: 
- **r7 TX mixer**: 
- **r8 RX mixer**: 
- **r9 power**: Power and reference, two cells.  Right cell: AMOD-A's USB-C input (CC pull-downs, 2 A PTC, 5 V TVS, 2 x 10 uF) and an MT3608 boost (22 uH, SS34, 12 k / 1 k: 7.8 V) with 10 uF out, feeding the +8V strip in the gutter below through two vias (its own and the divider's); a yellow LED says 7.8 V is up, a green one that 5 V is in.  Left cell: a TPS7A2033 makes 3.3 V for a TC32H4 25 MHz TCXO whose output a 74LVC1G17 buffers through 51 ohm to the REF OUT jack (top-left); the synthesizers' REF IN jacks are unterminated: REF OUT into r10's REF IN, and a back trace takes it on to r13.
- **r10 synthesizer**: 
- **r12 gain block**: 
- **r13 I/Q transmitter**: 

## PhMOD: the physics board

10 tiles, 26 jacks, 232 parts.  PhMOD (AMOD-2 until Prompt 17): magnetic resonance, the ionosphere and light, rev A.  The second-level HF board, for the ECP5-2ADC-2DAC board, whose converters sample DC to 30 MHz directly: a 1 W pulse amplifier and a duplexer with a low-noise preamplifier for pulsed NMR, a coil driver for gradients and Helmholtz pairs, a two-channel HF receiver front end, VLF loop amplifiers, a 50 ohm reflection bridge for complex S11, coupled and parametric resonators, a switched noise source and a laser driver with an RF bias-T.  Four layers: L1 parts and drawn wires, L2 ground, L3 the rails (+5 V everywhere, -5 V in the gutter under row 0), L4 ground with the back-side text; +-15 V only reach the pulse amplifier, on the back from h1 below it.  Designed for Prompt 13 (the second-level boards, for the ECP5-2ADC-2DAC board).  PLAN_LEVEL2.md section 3 has the reasons and the changes from Appendix D's first AMOD-2 (the optics tiles moved to a future board).

- **h1 power**: Power, two cells, no jacks.  Left: the TPS65131 boost and inverter make +15 and -15 V from the 5 V (1 M / 88.7 k and 1.3 M / 105 k, TI's 4.7 uH and Schottky rectifiers, 3 x 10 uF on each output), carried up the back to h2's pulse amplifier only.  Right: AMOD-A's USB-C input (5.1 k CC pull-downs, 2 A PTC, 5 V TVS, 2 x 10 uF) and the LM2664 that makes -5 V into the strip in the gutter above; a green LED on +5 V, a red one on -5 V, a yellow one on +15 V.
- **h2 pulse amplifier**: The pulse amplifier: a THS3491 (VQFN-16 at (12.0, 8.5), rot 0: FB, -IN, +IN down its left, VOUT on its right, +VS on top, -VS along the bottom) at gain 10.3 (698 ohm from its FB pin, which is the output, to -IN; 75 ohm to ground) from +-15 V.  IN is terminated in 49.9 ohm, so a DAC's +-1 V into 50 ohm becomes +-10 V into a 50 ohm load: 1 W.  OUT is not back-terminated (it drives the T/R switch and the probe).  PD from Pmod IO1 through 4.7 k, 10 k to ground: off unless the FPGA holds it high, so it is silent between pulses; it heats if left on at full power (pulse it).  +-15 V come up the back from h1.
- **h3 duplexer and preamp**: NMR's duplexer and preamplifier, two cells.  Left: TX IN through two pairs of crossed 1N4148W diodes to PROBE: the pulse passes (1.4 V drop), the transmitter's noise between pulses does not.  Right: LINE (from the probe through a quarter-wave cable, or a short cable and a 6 dB pad) clamped to ground by crossed diodes and terminated in 49.9 ohm, into AMOD-A's op-amp tile with an OPA847 at gain 12 (1.1 k / 100 ohm), 49.9 ohm out to RX OUT.  With the quarter-wave line the clamp shorts its far end during the pulse, so the probe sees an open there; between pulses the echo reaches the preamplifier.
- **h4 coil driver**: The coil driver, one cell in the board's corner: a DRV8876 H-bridge in PH/EN mode (Pmod IO6 enables and is the PWM, IO7 the direction; 100 k holds both low), nSLEEP and the 5 V divider from the switched rail.  VM through two B5819W: USB's 5 V (4.6 V) or 12-18 V on the right-margin terminal, whichever is higher (the 25 V bulk capacitor sets the limit).  IPROPI into 1.5 k sets the current limit with VREF (5.1 k / 3.3 k: 2 V) and is buffered by an OPA810 (from VM) into MON through 49.9 ohm. The coil on the lower terminal.  The chip at (13, 12.5), rot 0: control pins down its left, the charge pump, VM and OUT2 down its right, OUT1 at its foot; the diodes above it, the buffer beside the MON jack; IO6 / IO7 come down the back at x 9.55 / 8.95 to vias beside pins 1 and 2.
- **h5 HF receiver**: The two-channel HF receiver front end: two LMH6629 amplifiers (0.69 nV/rtHz, gain 9.9), 50 ohm in and out, from a few kHz to 100 MHz, on one switched 5 V; the host's ADCs sample both coherently (the host's own front end rolls off at 23 MHz; add a 30 MHz low-pass ahead of it for a station beside an FM transmitter).  It carries the Pmod plug in its bottom margin.
- **h6 VLF loop amplifier**: A VLF / LF loop amplifier, one cell: the loop (or a ferrite rod's coil) on the IN jack through an SMA lead, 1 uF into an OPA810 biased at half the supply by 100 k / 100 k (the loop is a low-impedance source; the 50 ohm termination stays off), gain 101 (10 k / 100 ohm, the 100 ohm to ground through 1 uF: a 1.6 kHz high-pass), 100 pF across 10 k (a 160 kHz roll-off that keeps the AM broadcast band out), 1 uF and 49.9 ohm into OUT.  The LMH6629 tile's core with other values.
- **h7 reflection bridge**: The reflection bridge, two cells, +-5 V.  DRIVE (the top-left jack) feeds node D; 49.9 ohm from D to A, which runs right along y 4.75 to the DUT jack (the right cell's top-left); 49.9 ohm from D to B and 49.9 ohm from B to ground.  With a 50 ohm DUT the bridge balances (A = B); in general A - B = B x Gamma.  Two OPA810 (SOT-23-5, rot 270) stand under the line, each input a millimetre or two from its node: U1 at gain 2 on B (INC, through 49.9 ohm to the left cell's bottom-right jack) and U2 as a difference amplifier, +IN on A and 499 ohm from U1's output to -IN, 499 ohm feedback: 2 A - 2 B (REFL, through 49.9 ohm along y 10 to the right cell's bottom-right jack).  REFL / INC = Gamma, complex, at every frequency the host makes.  -5 V comes down the back from the gutter above at x 14.6 and 19.8; VS up the back from the switch at x 10.2.
- **h8 coupled resonators**: Coupled and parametric resonators, two cells, passive: two 10 MHz LC tanks (TDK's 10 uH NLV32, Q about 30), each tuned by a back-to-back pair of BB133 varactors whose cathodes sit at half the supply through 100 k / 100 k.  Like two cavities each has weak capacitive ports: SIG (terminated in 49.9 ohm) drives tank 1 through 2.2 pF, and 2.2 pF from each tank feeds its OUT jack, which the host's 50 ohm ADC input loads (about -43 dB, no buffer, no loading of the tank).  TUNE / PUMP reaches tank 2's varactor cathodes through 100 k (DC: tank 2's frequency, half the open-circuit voltage) and 1 nF (RF: the pump at twice the resonance).  A DIP4 switches 1 pF and 2.2 pF of coupling between the tanks and 2 k of damping across either.  Tank 1 in the left cell's top-right quarter on a bus along y 4.75, tank 2 in the right cell's on y 5.5; the switch under the right jack, its top row fed along y 8.55 - 9.35 from the left and y 9.0 from the right, its bottom row joined to tank 2 round its right side.
- **h9 noise source**: A switched HF noise source: the base-emitter junction of an MMBT3904 in avalanche (the base at -5 V, the emitter fed from the switched rail VN through 680 ohm: about 8 V across it at 2-3 mA), its noise straight into an LMH6629 at gain 9.9 (the h5 channel without its input termination) and out through 1 uF and 49.9 ohm.  A TPS22917 load switch makes VN from the tile's 5 V when Pmod IO8 is high: off is the cold state of a Y-factor measurement (the amplifier's own noise), on the hot. The switch and the junction stand in the top-left quarter (no jack there), the amplifier in the top-right; -5 V comes up a finger of L3 from the gutter below.
- **h10 laser driver**: The laser driver with an RF bias-T, two cells.  SET (terminated, 1 k / 100 nF) drives OPA810 U1 and a 2N7002 that pull SET / 1 k through 1 k from VS: REF = VS - SET.  OPA810 U2 holds the AO3401's source at REF (1 k into -IN, 10 nF to its output, 100 ohm to the gate), so 10 ohm from VS carries SET / 10 ohm: 100 mA per volt, from 0.  The drain (ID) feeds the diode through 330 nH and 27 nH; RF IN reaches it through 100 pF and 47 ohm (about 20 MHz to 3 GHz); an AO3400 from ID to ground (Pmod IO5 high) steals the current for microsecond pulses without upsetting the loop; a B5819W guards against reverse current.  MON is the diode's voltage through 10 k into the host's 50 ohm (1/200).  The RF line drops from RF IN and runs along y 9 to the LD jack's left; the gate and source lines go under it on the back.

## IQ-MOD: the second-level RF board

11 tiles, 27 jacks, 183 parts.  IQ-MOD: a coherent I/Q transceiver and microwave physics, rev A.  The second-level RF board, for the ECP5-2ADC-2DAC board: its two DACs drive the I/Q modulator, its two ADCs read the I/Q demodulator, and one synthesizer's two complementary outputs are the LOs of both, so the transmitter and the receiver share one phase.  Around them a dual directional coupler, a low-noise amplifier, a log detector, an absorptive switch, a switched noise source, a GNSS front end and a loop for NV centres' magnetic resonance.  Four layers as RF-MOD: L1 the parts, the drawn wires and a ground pour 0.25 mm from every 50 ohm line; L2 ground; L3 the rails (+5 V everywhere, -5 V in the gutter under row 1 and under q10, the synthesizer's 3.3 V island); L4 ground with the back-side text.  Every jack sits at a cell's top-left or bottom-right corner (the checkerboard of rev A, Prompt 12).  Designed for Prompt 13 ("work on the 2nd version of each board, filling them with whatever would make the most interesting RF (physics and communications) tutorials"; "the second-level boards will almost certainly only be used with the 2DAC+2ADC board").  PLAN_LEVEL2.md section 4 has the reasons.

- **q1 I/Q modulator**: The ADL5375-05 I/Q modulator (LFCSP-24 at (20.0, 9.0), rot 90: the I pair down its left side, the Q pair down its right, RFOUT on top, the LO pins along the bottom).  Each baseband input is single-ended from a DAC (+-1 V into 50 ohm): the jack sees 68 ohm across 150 ohm into a node that 510 ohm from 5 V and 91 ohm to ground hold at 0.50 V, so +-1 V at the jack is +-0.34 V at the pin (0.16-0.84 V, inside the 0-1 V the pins allow); the negative pin of each pair sits at 0.50 V on 510 / 56 ohm (both nodes 50 ohm Thevenin, so the 41 uA bias currents cancel).  LO in through 100 pF to LOIP, LOIN to ground through 100 pF; RFOUT through 100 pF up to the RF OUT jack.  DSOP is grounded (always on).  The tile's switched 5 V (VS) is an island on L3 under the chip and both networks; every VS pin and resistor reaches it with a via.
- **q2 I/Q demodulator**: The ADL5380 I/Q demodulator (LFCSP-24 at (21.6, 11.0), rot 0: RF on top, LO along the bottom, the I outputs down its left side, Q down its right) and two OPA810 difference amplifiers that turn each 2.5 V-common-mode pair into one output around 0 V for the ECP5 board's +-1 V ADCs: 499 ohm into each input, 1 k of feedback and 1 k to ground (gain 2), 49.9 ohm out, so a 50 ohm ADC sees the pair's difference and a high-impedance one twice it.  RF in single-ended to RFIN through 100 pF (RFIP to ground through 100 pF), LO likewise; ADJ on 1.5 k to 5 V (the datasheet's value below 3 GHz); ENBL grounded.  The amplifiers run from the tile's 5 V and the board's -5 V; the 5 V is an island on L3.
- **q3 synthesizer**: The synthesizer: RF-MOD's MAX2871 tile (r10) with its own REF IN at the right cell's top-left (its line on the back) and RFOUTA- on OUT A- at the right cell's bottom-right, so OUT A+ and OUT A- are the LOs of q1 and q2 without a splitter (Prompt 15). It carries the Pmod plug; the switch's two lines (IO5, IO8), the noise source's (IO6) and the modulator's output disable (IO7) leave its other pads along the bottom margin, below OUT A-'s line.
- **q4 LNA**: RF-MOD's QPL9547 LNA tile, unchanged.
- **q5 coupler**: A dual directional coupler in the splitter's place (Prompt 15): two TDK HHM22137A1 couplers back to back on one 50 ohm line at y 10 from IN (top-left) to OUT (the right cell's bottom-right), each with its isolated port in 51 ohm.  The first (rot 180 at x 15.8: its through row on top, input pad 3 toward IN) samples the wave travelling from IN to OUT on its pad 4, straight down to FWD (the left cell's bottom-right jack); the second (rot 0 at x 25.7, input pad 3 toward OUT) samples the wave coming back from OUT on its pad 4, straight up to REFL (the right cell's top-left jack).  The middle ground pads go to vias above and below the line, the outer ones diagonally away from the coupled lines.
- **q6 log detector**: The AD8318 log detector (LFCSP-16 at (14.0, 6.5), rot 90: the input pins on its left, VOUT and VSET on its right, TADJ and VPSO along the top, VPSI along the bottom).  ADI's basic connections: 51 ohm across the input, 1 nF to INHI and from INLO to ground, 499 ohm on TADJ, VSET tied to VOUT (measurement mode, -25 mV/dB), CLPF open (10 ns).  VOUT (0.5-2.1 V) through 110 ohm into 91 ohm to ground: a 50 ohm source, 0.23-0.95 V open (inside the ADC's +-1 V), half that into 50 ohm.
- **q7 noise source**: A switched noise source: the base-emitter junction of an MMBT3904 in avalanche (the base at -5 V, the emitter fed from the switched rail VN through 680 ohm, about 8 V across it at 2-3 mA), its noise through 1 nF into an ADL5611 gain block (22 dB, the 43 nH choke from VN), then 1 nF and a 20 dB pi pad (62 / 240 / 62 ohm) to the OUT jack.  A TPS22917 load switch makes VN from the tile's 5 V when Pmod IO6 is high: off, nothing is biased and OUT is the pad's own 50 ohm at room temperature, the cold state of a Y-factor measurement; on, the hot state.  QOD and CT open: the ADL5611's 94 mA empties VN within microseconds anyway, and the fastest turn-on (about 100 us).
- **q8 GNSS front end**: A GNSS front end for an active antenna: a bias-T on ANT (3.3 V through 10 ohm and 18 nH, for the antenna's own LNA), a 100 pF block, Murata's 1561-1602 MHz SAW, Maxim's MAX2659 LNA (470 pF and 6.8 nH at its input, its own matched, blocked output), a second SAW, OUT.  A TPS7A2033 makes the 3.3 V from the tile's switched 5 V.
- **q9 ODMR loop**: A loop for NV centres' magnetic resonance: the IN line (50 ohm CPW) runs to a one-turn loop 1.6 mm across at the cell's centre and on to the OUT jack, so the current that makes the field is the line's own and nothing resonates: any frequency from DC to 6 GHz, the 2.87 GHz of NV's zero-field splitting and every Zeeman line around it.  No copper on any layer within 2 mm of the loop (a plane under it would carry the image current and cancel the field).  Terminate OUT in 50 ohm, or in a short to double the current (the source sees the reflection).
- **q10 power**: Power: AMOD-A's a1 without its 3.3 V regulator and rails socket.  USB-C on the right edge (5.1 k CC pull-downs), a 2 A PTC, a 5 V TVS, 2 x 10 uF; the LM2664 inverts +5 to -5 V (40 mA) for the demodulator's difference amplifiers and the noise source's junction.  +5 V leaves through a via into the pour that covers L3; -5 V through vias into the island under this tile's bottom half and the gutter strip below row 1.  A green LED on +5 V, a red one on -5 V.
- **q11 switch**: The SKY13370 absorptive SPDT (DFN-6 at (13.5, 8.0), rot 270: V1, RFC, V2 down its left side, RF1, GND, RF2 down its right).  RFC from the top-left jack, RF2 to the left cell's bottom-right jack, RF1 along y 7.5 to the right cell's.  100 pF blocks on every port (the switch wants them); V1 and V2 come from Pmod IO5 and IO8 on the back, 100 pF on each: drive one high and the other low.  The throw that is off is terminated in 50 ohm inside the chip.
