gallicchio/AMOD-and-RFMOD/CLAUDE_CODE_CHAT.md

# Claude Code Chat Log: AMOD and RF-MOD, the boards of analog and RF building blocks

Every prompt, verbatim (minor typos fixed), followed by the response as it was given, with the
renders as they were at the time (kept under `docs/history/`).  Model: Claude Fable 5.1, then Claude Opus 5.5 from Prompt 6.  The
boards were specified first in the tutorial's Appendix D
(`icepi-zero-dac-adc/tutorial/D_coming_soon.md`, "An AMOD: a board of analog blocks" and
"For the agent that will design these boards"), and Jason's answers to the open questions
there are the starting point of this log.

## Prompt 1

> I answered the questions in `~/mudd/133electronics/icepi-zero-dac-adc/tutorial/D_coming_soon.md`.
> I've decided that I want *you* to be the agent to design these things. You'll need to switch
> to PCB design mode now. Feel free to use `/home/jason/.local/bin/kicad-10.0.7-x86_64.AppImage`
> and any simulation and 3D rendering tools. I have already created a github project for these
> boards in `~/mudd/pcbs/AMOD-and-RFMOD`, where you should do this PCB-design work. There are
> other examples of PCBs in the `~/mudd/pcbs/` and `~/OpticsPCBs` directories. The recent boards
> have been designed by you and I in the style that I want you to use here (at least as a
> starting point). In particular, you should begin a `CLAUDE_CODE_CHAT.md` file somewhere in
> `~/mudd/pcbs/AMOD-and-RFMOD` and record this prompt as the first prompt, and record your
> responses as you've done for the other boards. Your main set of instructions and lessons is in
> `~/OpticsPCBs/CLAUDE_PCB.md`, and you should feel free to add to it as you learn things on
> this project. I expect that this might take most of the night, so get it right.

The answers in Appendix D that this prompt points at (2026-10-25):

> - Which boards first? **Yes, completely design the three first-level boards, but be ready to
>   modify the plan for those or for the advanced boards as things come up.**
> - How many of each? **Let's start with the usual 5+2 until we know this works and that I want
>   a class's worth of boards.**
> - The piezo rail: **I mostly have 150V piezo stacks from Thorlabs, so there should be a switch
>   or jumper option to go up to that.**
> - Lasers: **We don't have a TeachSpin optical pumping apparatus, but we have a Rubidium vapor
>   cell, a Fabry-Perot cavity, and we have been working on our own cavities and
>   grating-stabilized lasers for Rubidium.**
> - A TRF3722 on RF-MOD? **Yes. Add that tile. These boards will mostly be used with the
>   ECP5-2ADC-2DAC board, not with the IcepiZero board. If there is room on the Raspberry Pi
>   connector, though, I would like a converter board that hosts the existing ADC+DAC along with
>   a single PMOD to plug one of these boards into the Icepi Zero. If there aren't enough free
>   FPGA pins, exclusively focus on the ECP5-2ADC-2DAC board.**
> - The bimorph: **I don't know. I've never used a bimorph cantilever. If this would be
>   interesting for steering a mirror, let's go with that. The 40 kHz transducers that I have
>   don't seem that useful beyond sonar and communication. The students have already suspended
>   foam particles or drops using arrays of these 40 kHz transducers, so unless the DAC+ADC adds
>   more to something like that than a bimorph cantilever would add, stick with the bimorph
>   cantilever. You do need to find specific ones to buy and record their dimensions and
>   mechanical and electrical specs.**

### Response 1 (2026-10-25, 00:40 onward; this entry is kept up to date as the night goes on)

**The plan first** (`PLAN.md`, 01:05): the three boards on one 100 x 100 mm, 4 x 4-cell tile
grid (20 mm cells, 1.5 mm gutters, 7.75 mm margins: the geometry of Appendix D's sketches), a
jack-slot rule that keeps every pair of SMA jacks 10.5 mm or more apart whatever the neighbours
do, "IN top-left, OUT top-right, the signal along a line under the jacks", "the silkscreen is the
schematic" (every wire laid as copper and drawn on the silk, clipped round pads), and one parts
table (`scripts/parts.py`) that the schematics, the boards, the BOMs and the legends all read.
JLCPCB's shelf was queried for every part by its API with the time of the answer kept.  The
decisions that changed Appendix D are listed in the plan with their reasons: the vertical SMA
(BWSMA-KE-Z001, 113 k in stock) instead of the right-angle one (a right-angle barrel on an
interior tile has nowhere to go), the TRF3722 tile that Jason asked for, the 455 kHz ceramic
resonator for P9 (JLCPCB stocks no 455 kHz IF filter), switched capacitors instead of a trimmer on
P4 (no SMD trimmers in stock), an OPA847 for the one HF LNA and an OPA1612 for the noise tiles
beside the OPA2810s, the LTC5510 mixers with a Digi-Key fallback (35 on the shelf), the TMP235 for
the dead TMP36, and the feasible Icepi Zero adapter (ten free header pins) as a fourth, last board.

**The framework** (01:05-02:00): `scripts/geometry.py` (the grid and the jack rule, asserted per
board), `scripts/tiles.py` (a Tile declares its netlist once; the schematic drawing and the board
layout both have to reproduce it and the build checks both), `scripts/gen_sch.py` (one sheet per
board, a block per tile, ERC, the netlist, the circuit check and a text-overlap check),
`scripts/gen_pcb.py` (runs under KiCad's own Python, which has no numpy, so it reads the tiles
from a JSON the schematic step dumps), `sim/passive.py` (ABCD two-ports for every passive tile's
expected response; the silk and the handbook quote it), the footprints and 3D stand-ins drawn or
vendored (`scripts/gen_footprints.py`, `gen_models.py`), and `make.py` to run it all.

**AMOD-P** (02:00-03:40): thirteen tiles, 27 jacks, 138 parts, two layers.  ERC 0, every tile's
connectivity equal to its declared netlist, DRC 0, the fab package through every check
(gerbers, BOM, both placement files, 59 LCSC codes checked against JLCPCB's own descriptions,
$16.97 of parts a board).  What it took, and what changed on the way:

- *The 20 mm vertical budget.*  The first board put the 4 x 2.2 mm test loops on top of the name
  line and spilled the end shunts' values into the next tile.  The budget that works: jacks to
  y 8.4 (their legs' 2.2 mm pads), the values at y 9.0, the signal line at 10.6, shunts hanging
  to a via and a ground symbol by 15.4, the loops lying along x under the jacks at 16.6 with
  their names between them, the tile's name at 18.6, the frame at 19.7.  The tutorial sections
  stand one under the other below the tile's number, between the jacks' legs (3.2 mm of room:
  three-character numbers like P10 are set at 0.9 mm).  KiCad's DRC box for 0.8 mm text is 0.5
  above and 0.7 below the line, and the project rules ask 0.15 mm between silk items, so every
  margin was budgeted with those numbers, not the glyphs'.
- *Half-pitch DIP switches.*  The 2.54 mm DSIC02/04 (11.7 x 6.9 and 11.5 x 12 mm) would not fit
  beside two jacks in a cell; the DSHP02/04/06TSGET (C40735/36/37, 1.27 mm, 4.8 x 9.7 and
  7.2 x 9.7 mm, 13 k / 31 k / 5 k in stock) do.  A pen tip flips them; the part is printed ON.
- *P11, the delay line.*  Twenty 0603 inductors with 0603 capacitors at the nodes need 4.5 mm a
  section; ten do not fit beside the three top jacks.  0402 capacitors (CC0402JRNPO9BN391, NP0,
  92 k in stock) bring a section to 4.0 mm: row A along the line, row B back along y = 15.25
  into the OUT jack, row B's capacitors standing up between row A's.  The 100 and 200 ns tap
  resistors stand above the line either side of the text block, the 300 ns one lies under row B.
- *P4 lost its IN loop* (the switch took that corner; IN is the DAC's own signal) and its coil's
  and capacitor's values moved into its name (no room under the 1210 once the switch's feed runs
  there).  *P6's inner 10 nF pair* is unlabelled (no room beside the 1210's tall pads; the outer
  pair says 10nF).  *P12* lost its wavelength texts (the colours are visible lit; the handbook has
  them).  *P7's* band on the silk is the simulated 4.7-7.5 MHz, not the design's 4.7-7.8.
- *The QR code* sits on the back under P12's switch, the only 14 mm of back with no hole in it,
  as a 29-module version 3 at 0.42 mm; the back text runs between the two rows of cable-tie
  slots, which lie along x (a tie's width) 5.7 mm apart.
- *P13's terminal pins* are named in the margin below the tile, where the wires come in.

The record of the pre-compaction work in this session is in the summary at the head of the
session; the files are the truth.  AMOD-A next (03:45).

**AMOD-A** (03:45-08:30): twelve tiles, 21 jacks, 186 placed parts, four layers (L2 solid ground,
L3 the rails as pours: +5 V everywhere, -5 V as one polygon through the gutters under rows 0 and 2
and down the left margin, +3.3 V in the gutter under row 1; L4 ground with the back wires), the
Pmod plug on the bottom edge with its lines, ERC 0, DRC 0, the fab package through every check
($45.97 of parts a board, 63 BOM lines, 133 LCSC codes checked against JLCPCB's own
descriptions), the handbook and the manufacturing notes written from the same sources.  What it
took:

- *The router put a via on an SMA leg.*  The pad table was keyed by pad number, so a jack's four
  legs (all "2") and the USB-C's four shell pads collapsed to one each: three legs were invisible
  to the router and to the silk clipper.  Every pad is now an obstacle; the (ref, number) table
  keeps the first for wire ends.  That bug had eaten A2's first three hours; once found, the
  geometry below was written by hand against the real pad boxes (a `fpdump` of every footprint's
  courtyard and pads from KiCad itself).
- *One op-amp geometry for every x-gain tile* (`opa_tile` in `boards/amod_a.py`): the SOT-23-5
  at (10.5, 12.5), the output over the top at y 9.4 into the series 49.9 and down into Rf, the
  feedback along y 14.3, VS from the header's FET on the back through two vias, -5 V on the back
  to the gutter, the loop under the OUT jack with its name hidden.  A2, A3, A5 (an LT6230,
  1.1 nV/rtHz, with a 2-way DIP and a 1 x 2 socket for the source resistor where the IN jack
  would be), A11's receiver and A12's microphone amplifier use it, with an x offset for the right
  cell of a double tile.
- *The SOIC-16 and SOIC-14 across a cell* (A7, A9): rot 90 or 270, 0.25 mm below the jacks'
  legs, the wires that must cross the chip in the 3 mm gap between its pin rows, the resistors
  that hang off pins as 0402s in a column beside the chip or under the bottom row at the pin
  pitch.  The MC1496's NC pins carry the output past the chip, as the OPA847's pin 1 carries A4's
  feedback node: box symbols with those pins passive.
- *A1's socket moved to the top edge* with its pins named in the gutter above (the tile below
  owns the gutter below), the LEDs into the right margin above the USB-C, the red one on the end
  of the -5 V strip, which stops at x 93.6 so the +5 V pour keeps its only path down the right
  margin.  The USB-C's SMD ground pads reach its shell holes with a wire each.
- *The Pmod lines.*  Twelve 1.8 mm pads in two rows under a 15 mm body: the upper row fed from
  the back, the lower row through the upper row's 0.74 mm gaps on the front with 0.2 mm tracks
  or along the bottom edge for the two outer ones; the lines come down the back of A9 and A11 at
  x 21.8-24.3 (the one strip clear of those tiles' sockets and jacks), each feed above the feed
  of the pad to its right so none cross.
- *Lost on the way* (the DOA list has them): A4's loop, A7's loop-filter DIP and its two loops,
  A8's NTC divider and loop, A10's laser terminal and DIP, A12's 3.5 mm jack, A9's carrier-null
  trimmer and output follower, A5's four-way DIP (two values and a socket instead), A11's TX IN
  jack and comparator.  Each fell to the 20 mm cell beside the switch and FET; each is a line in
  the tile's handbook entry.
- *The generic schematic block* now joins adjacent same-net pins under one label, spaces its
  passive rows by the longest net name, starts them under the tallest chip symbol and shrinks
  the notes when the drawing needs the room.  Three library footprints without a STEP file in
  KiCad's share (the WSON-8, the USB-C, the 1812 fuse) are pointed at stand-in bodies.

**RF-MOD** (08:30-09:55, first five tiles, then the synthesizers): the RF framework in the same generators, then the
tiles.  What it took:

- *The RF rules, from CostasLink.*  A wire 0.29 mm wide (`Tile.rf`) is a 50 ohm CPWG line on JLC04161H-7628: an "RF"
  net class (0.25 mm clearance), a ground pour on L1 over every RF tile at 0.25 mm, a fence of ground vias 0.845 mm
  off each line every 1.0 mm wherever one fits, and rule areas under every jack of an RF tile (no fill within 2.2 mm
  of the centre pin on L2-L4, 1.9 mm on L1).  CostasLink's `gen/rf_launch.py` numbers.
- *IN top-left, OUT bottom-right* on every RF tile: the jacks form a checkerboard, closest pair 14.4 mm.
- *Stock decided the tiles.*  QPL9547 none, LTC5510 35, so: two GALI-84+ gain blocks (22 ohm from a 7.8 V MT3608
  boost on an L3 strip), the two filters, R9 (USB-C, the boost, a TC32H4 TCXO through a 74LVC1G17 to REF OUT), and
  the two MAX2871 synthesizers in CostasLink's circuit.
- *The loop filter for both bands at once.*  The VCO runs 3-6 GHz whatever the output divider, so 915 MHz (VCO / 4,
  N 146) and 2.44 GHz (VCO / 2, N 195) see the loop through Kvco / N.  A search of stocked C0G values with
  CostasLink's open-loop model gave C1 470 p, R2 820 + C2 6.8 n, R3 470, C3 100 p: 77-120 kHz and 61-64 degrees over
  Kvco 35-75 MHz/V (the first search reported 350 degrees: an unwrapped phase, caught and fixed).
- *The QFN fan-out* needed a "Fine" net class (0.127 mm, 0.15 mm tracks, 0.45 / 0.25 vias) on the synthesizer's nets
  only, the board's floor lowered to JLCPCB's four-layer limits, per-tile V33 islands on L3 under each chip, and
  `FRONT_WIRES` for the one line that had to cross the back's.
- *Stand-in 3D bodies drawn 2.54 times too big:* VRML's unit is 2.54 mm.  The loader now gives a substituted stand-in a
  1/2.54 scale, and copies the model vectors' numbers rather than the SWIG proxies (which had written a scale of
  1486236861 into the board file).

## Prompt 2 (about 08:05, during the RF-MOD work)

> Keep going, but do the mounting holes take up too much room or are inappropriate for such a board? They may be a
> good idea and maybe they should be kept, but it pushes the PMOD connector away from the edge and seems to really
> squish all of the SMA connectors together in a way that might make them difficult to use. If it would free up a lot
> of breathing room, the mounting holes could be replaced by the same type of rubber half-spheres that are stuck to
> the bottom of the PYNQ board with adhesive.

## Prompt 3 (about 08:20)

> Im not wedded to the 20 mm cell layout. The goal is just to fit it all in 100 mm by 100 mm.

## Prompt 4 (about 09:35)

> Keep going, but why are there so few tiles on the RF-MOD board?

## Prompt 5 (about 09:40)

> Fill the RF-MOD, even if it's not with what you initially thought it would be filled with. Prioritize things that
> work nicely together.

## Prompt 6 (about 09:55)

> keep going, but I switched you from Fable 5.1 to Opus 5.5 because I ran out of credits.

## Prompt 7 (about 09:57)

> You can ignore the time constraint now and keep going as long as you need to go to finish the job well.

### Response to Prompts 2-7 (09:40-10:30; Claude Opus 5.5 from 09:55)

**The holes and the jacks.**  The holes cost only the corners.  The 7.75 mm margins, and the jacks' 10.5 mm, come
from the grid: two jacks in one 20 mm cell, 4.75 mm in from its sides.  Dropping the holes alone frees nothing for
the jacks.  Moving OUT to the bottom-right slot does: the checkerboard's closest pair is 14.4 mm.  RF-MOD was laid
that way from the start of this exchange.  AMOD-P and AMOD-A keep IN and OUT along the top, because changing them
means re-laying 24 finished, DRC-clean tiles.  That rework is offered as the next decision, not done.  The holes did
go on AMOD-A and RF-MOD, for the reason below, and four rubber feet are circled on the back instead.

**Why so few tiles, and filling the board.**  RF-MOD had five tiles at that point because stock had removed half the
plan (QPL9547 none, LTC5510 35), and the antennas, the RFX2401C and the TRF3722 were cut for time.  Filled with
things that work together, it is one complete link on one reference (handbook, "The tiles together"):

| tile | what |
|---|---|
| R1 | resistive splitter, 3 x 18 ohm: the reference to both synthesizers, one LO to two mixers |
| R2, R4 | 2.45 GHz LTCC and 915 MHz SAW filters |
| R5, R12 | GALI-84+ gain blocks |
| R7, R8 | ADL5350 passive mixers (2,036 in stock), a 200 MHz crossover on the RF/IF node: every band, either direction |
| R9 | USB-C power, 7.8 V boost, 25 MHz TCXO to REF OUT |
| R10, R11 | MAX2871 synthesizers, R10 carrying the Pmod plug |

ERC 0, DRC 0, the fab checks pass, $55.78 of parts.

**The Pmod plugs were mirrored, on both boards (found while drawing the adapter's socket).**  The plug footprint is
JLCPCB's drawing of the PZ254R-12-12P.  Its pad 1 is at the other end of the row nearest the body from KiCad's
horizontal header's pad 1, so its pad p is KiCad's pad 13 - p.  The boards used KiCad's rule (Pmod pin k = pad 2k-1)
on JLCPCB's numbering, so every plug pin k met the host's pin 13 - k.  That puts IO lines on the host's ground and
3.3 V.  The fix keeps every feed as laid:

- the plug moved two columns left, into the corner where a mounting hole stood (hence the feet);
- the nets were renamed to the standard IO numbers (AMOD-A: A6 IO8/IO7, A8 IO6, A10 IO5, A11 IO4/IO3, A12 IO2);
- `check_outputs.check_pmod` maps every plug pad to its pin by position, and fails on the old layout (11 of 12 pads).

**The fourth board, the Icepi Zero adapter with a Pmod** (`icepi_adapter/`, from the OpticsPCBs generator's new board
`adda12p`).  The socket's housing does not fit on the 65 mm board, so the board is 80 x 30 mm, the extra 15 mm past
the Icepi's end.  It has four layers: the original fan-out untouched on the outside, and the eight lines on In2
between through-hole pads, with no vias and no crossings.  Header pins 8, 10, 22, 27, 28, 36, 38 and 40 are IO1-8 and
pin 1 gives 3.3 V.  DRC 0, no unconnected pads; the `.lpf` and pin map are generated with it.

Commits: c429126 (RF-MOD filled), the Pmod fix, `icepi_adapter/`, and OpticsPCBs 08305ee (the generator).

## Prompt 8 (about 10:30)

> Keep going, but do the speaker and microphone have SMAs because you need to attach them to an external speaker and
> external mic? Or are the SMAs inputs and outputs to drive an onboard speaker and microphone?

### Response 8

The SMAs are signal ports for the converters, not transducer connections.  On A12, AUDIO IN (top-left) takes a DAC's
output into the PAM8302A class-D amplifier, and MIC OUT (top-right) is the electret preamplifier's output (x100) for
the ADC.  The transducers attach on the tile itself.  The speaker's wires go into the 2-way screw terminal in the
right cell.  The electret capsule plugs into the 1 x 2 socket beside the preamplifier (pin 1 is its + side, biased
through 2.2 k).  Neither is on the board because JLCPCB stocks neither in a form worth placing.

## Prompt 9 (about 10:35)

> In general, give me a list of external components that are required that are not on the ECP5-2DAC-2ADC board and
> not on any of these boards. What will students need in their kit? A USB-C power brick of some current rating, some
> SMA cables of some particular lengths, maybe quarter wave or half wave antennas with SMA connectors, and what else?

## Prompt 10 (about 10:40)

> That list should include prices and links to specific things that are in stock and able to be purchased from the US
> and shipped there.

### Response 9 and 10

`docs/KIT.md`, read from the tiles' own declarations: per board a 5 V / 3 A USB-C supply and cable; SMA cables (6 x
15 cm, 6 x 30 cm, 2 x 1 m), SMA-BNC adapters, terminators, 10 and 20 dB attenuators and barrels; SMA-male (not RP-SMA)
2.4 GHz and 915 MHz whips; the 40 kHz transducer pair, a 2-3 W speaker, an electret capsule, a 330 uH ferrite-rod
coil, a resistor assortment and cable ties for the tiles' sockets and terminals; rubber feet; a Pmod extension cable
for the Icepi adapter.  Prices, links and stock as read on 2026-10-25 were gathered by two research agents and added
to the same file.

## Prompt 11 (about 11:13)

> Status update?

### Response 11

The design work was finished and nothing was running.  A clean rebuild of all three boards had passed every check
(ERC 0, DRC 0, the fab checks with the new Pmod check), and the Icepi adapter had no DRC errors.  This repository was
committed; OpticsPCBs had its generator and rule-book changes committed, with `ECP5-2ADC-2DAC.kicad_pro` showing as
modified by someone else; the tutorial's Appendix D additions were left uncommitted beside Jason's own answers.  Open
for Jason: the 10.5 mm jack spacing on AMOD-P and AMOD-A (RF-MOD's was 14.4 mm), a design review from
`docs/REVIEW_BRIEF.md`, and the kit list's search-result prices.

## Prompt 12 (about 11:16)

> Is ECP5-2ADC-2DAC.kicad_pro modified just because someone opened it up, possibly in a different version of kicad?
> You can commit Appendix D and anything else that's relevant to commit in that repo. It should end with a clean git
> status. If saved numpy data should be .gitignored, do that. Otherwise commit it. There's no need to match the jack
> spacing, but I would like you to spread the jacks out away from each other (even away from jacks on other tiles)

### Response 12 (11:16-12:45)

**The `.kicad_pro`:** yes.  KiCad re-saved it on 2026-10-23 at 00:37: it sorted the net classes alphabetically and
wrote `null` as `{}`.  A JSON comparison finds every value the same.  It is left uncommitted in OpticsPCBs.

**The tutorial repository** is committed (1066aa5: Appendix D with Jason's answers, the boards as built and their
renders) and clean.  The 121 `.npz`/`.npy` files were already tracked and the build outputs already ignored, so
nothing new went into `.gitignore`.

**The jacks, on every board, now stand in a checkerboard:** IN at a cell's top-left slot, OUT at its bottom-right,
a two-cell tile's third jack at its right cell's top-left.  Two jacks in one cell are 14.85 mm apart and two across a
gutter 15.2 mm; the closest pair on each board is 14.85 mm (it was 10.5 on AMOD-P and AMOD-A, 14.37 on RF-MOD).
`scripts/geometry.py` now asserts 14.3 mm for every pair.

- **AMOD-P:** all thirteen tiles re-laid with OUT at the bottom-right.  P4's inductor and capacitors, P6's and P7's
  ladders and P11's delay line were re-placed around the new jack positions; P11's taps are now at its cells'
  top-left and bottom-right slots.  P8's HC-49S crystal did not fit straight between diagonal jacks, so it stands at
  45 degrees with its jacks 0.5 mm further out (slots TLo and BRo); P9's resonator is at 45 degrees too.
- **AMOD-A:** A2, A3 and A4 share a new op-amp layout (`opa_tile_br`) in the top-right quarter.  A4's OPA847 moved
  from the SOIC-8 to the SOT-23-6 (OPA847IDBVR, C160422, 724 in stock), whose pinout was read from TI's datasheet.
  A7's 4046 moved from TI's SOIC-16 to Nexperia's 74HC4046APW-Q100J in TSSOP-16 (C546981, 234 in stock; the same pin
  table), which fits between the jacks with its loop filter above it and C1 and the output resistor beside it.
  A8's heaters moved to the top-left with the TMP235 straight above the bottom-right jack.  A9's IF OUT and A11's
  RX OUT moved to their right cells' bottom-right slots; A11's receiver uses the A2 layout.  A5, A6, A10 and A12
  kept their jacks, which were already 14.3 mm or more from every other.  The QR code on the back moved left of
  A11's new jack.
- **RF-MOD:** the two mixers' LO jacks moved from the top middle to the right cell's top-left, the 50 ohm line
  extended along the same row.

All three boards: ERC 0, DRC 0, every fab check passed.  AMOD-A's parts rose from $45.97 to $50.90 a board, mostly
the OPA847's SOT-23-6.  PLAN.md (the jack rule, the tables, the status), the DOA list (items 8, 9, 17), the review
brief, the README, the assembler's notes (the 45-degree parts) and Appendix D (the text, the cost and the three
renders) were updated, and CLAUDE_PCB.md has the lesson.

## Prompt 13 (about 12:50)

> Go back to Appendix D of the tutorial and make sure that the first AMOD and first RF-MOD board contain the right
> things to build first to maximize interesting experiments. Then work on the 2nd version of each board, filling them
> with whatever would make the most interesting RF (physics and communications) tutorials/experiments/demonstrations.

Two follow-ups during the work:

> The second-level boards will almost certainly only be used with the 2DAC+2ADC board, so make them interesting for
> thst board.

> 14 and 21 in stock isn't great, but I would not consider that level too low to proceed.

### Response 13 (12:50 onward)

**The first level, checked against Appendix D and the host.**  The ECP5-2ADC-2DAC board has its own Johnson-noise
source, photodiode amplifier and LED driver, so two AMOD-A tiles were duplicates, and two parts Appendix D wanted had
come into stock.  Four changes, each built to ERC 0, DRC 0 and the fab checks (`PLAN_LEVEL2.md` section 2):

- RF-MOD's R5 is now the QPL9547 LNA (QPL9547TR7, C5367093, 5,070 in stock): 0.3 dB of noise figure instead of a
  second GALI-84+.
- RF-MOD gained R13, a TRF3722 quadrature transmitter (C1850395) fed by the host's two DACs, in place of the second
  MAX2871: an image-free transmitter whose LO output drives a receive mixer coherently.
- AMOD-A's A5 is a Doppler tile: a socket for an HB100 10.525 GHz module and x101 of IF gain.
- AMOD-A's A10 is an impedance and I-V tile: a DIP-selected reference resistor and two buffered outputs, V and I, for
  the host's two ADCs.

**RF-MOD-2 (rev A, $98.61 of parts a board): a coherent I/Q transceiver and microwave physics.**  One MAX2871 (X3,
locked to the host's CLK OUT) split by X5 is the LO of an ADL5375 modulator (X1, the host's DACs on I and Q) and an
ADL5380 demodulator (X2, the host's ADCs on I and Q, through OPA810 difference amplifiers): a 0.4-6 GHz zero-IF
transceiver whose baseband is the host's 30 MHz.  Around it the QPL9547 LNA (X4), an AD8318 log detector (X6), an
ADL5611 noise source switched by a TPS22917 (X7), a GNSS front end with a MAX2659 between two SAWs (X8), a broadband
through-line loop for NV-centre ODMR (X9), USB-C power (X10) and a SKY13370 absorptive SPDT (X11).  The ADL5380 had
14 in stock; Jason accepted it, and `check_outputs` records the exception per part.  The plan's printed coupler and
split-ring resonator were dropped (they need a field solver and bench tuning); the switch moved to X11 and X5 became
the splitter the shared LO needs.

**AMOD-2 (rev A, $78.19 a board): HF, magnetic resonance and the reflectometer.**  Ten tiles for DC to 30 MHz:
Y1 power (USB-C, an LM2664 for -5 V, a TPS65131 for +-15 V carried to Y2 only); Y2 a THS3491 pulse amplifier (1 W into
50 ohm, gated by IO1); Y3 NMR's passive duplexer (crossed diodes) and an OPA847 preamplifier; Y4 a DRV8876 coil driver
(IO6 PWM, IO7 direction, IPROPI buffered to MON, USB or 12-18 V); Y5 two LMH6629 receive channels at x9.9 with the
Pmod plug; Y6 a VLF loop amplifier (x101, 1.6-160 kHz); Y7 a reflection bridge (REFL / INC = Gamma); Y8 two passive
coupled 10 MHz tanks with varactor tuning, a pump input and 2.2 pF ports; Y9 a switched avalanche-noise source
(IO8); Y10 a 100 mA/V laser driver with a 20 MHz-3 GHz bias-T and an IO5 shunt for pulses.  The handbook's "tiles
together" lists the experiments: pulsed NMR and one-dimensional MRI, Earth's-field NMR, ESR of DPPH, WWV Doppler and
VLF sferics, the Smith chart, normal modes and the EIT analogue, parametric gain, noise figure, CPT and ODMR.

Where AMOD-2 differs from its plan, `PLAN_LEVEL2.md` section 3 says why: no I/O expander (five Pmod lines suffice),
crossed diodes instead of a PIN switch, Y5 without attenuators, Y6 with one channel (two did not fit a cell), Y8
without buffers, Y10 with one range.

**Build and documents.**  Both boards: ERC 0, DRC 0, every fab check.  New this round in the scripts: per-board
fiducials, the schematic's label-width layout with wrapped notes, `+-15 V` as power symbols, stacked hidden pins as
passive, footprints for the MAX2659, the 1109 SAW and the SKY13370 from JLCPCB's drawings, `stock_exception` for
accepted thin stock.  Handbooks (`docs/HANDBOOK_amod_2.md`, `docs/HANDBOOK_rf_mod_2.md`), DOA lists for both new
boards and the updated first-level ones, `PLAN_LEVEL2.md` as built, the README, the kit list and Appendix D were
written; CLAUDE_PCB.md section 20 has the lessons (the empty-string replace that corrupted a board module, net-name
collisions with helpers, planning a tile's crossings before its coordinates, back-layer polylines and vias).

## Prompt 14 (2026-10-27/28)

> In the README.md, under each board's rendering, make a table of the regions in each board with what it does, a link
> to the IC's web page or data sheet (if it's more than a passive), some specs, some limitations, what experiments can
> be done with it, how do I use it, and what external components (not on the board) need to be bought to use that
> region.  While you're at it, answer some questions about your design choices: [AMOD-P: why that band-pass range,
> why both a crystal and a ceramic resonator, why the LEDs, why switched capacitors on the loopstick rather than a
> knob.  AMOD-A: do "4.06 5.02" refer to section numbers (if so, get rid of all references to section numbers); how to
> use the Doppler module, and is an external module or antenna needed; how to use the 1-bit ADC and what "DRIVE IN"
> and "TEMP OUT" mean; the mixer's useful range and quality, and should a double-balanced diode mixer be on a board;
> what A10 and its switches do; how to use the ultrasound tile and how it differs from clipping the transducers on;
> what A12's two SMAs and screw terminal are.  RF-MOD: why so much space on the splitter; is the I/Q modulator useful
> without a demodulator; the silk does not say what the blocks are (QPL9547, GALI-84+, MAX2871); the mixers'
> frequency and power ranges belong on the board; jacks in a box need their own labels.  RF-MOD-2: how useful is the
> splitter; what the AD8318, QPL9547, MAX2871, SKY13370 and X7 do; how its I/Q pair differs from RF-MOD's
> modulator.]  Better silkscreen labels are required.

Then, while it ran: "Maybe some of this information is in docs/HANDBOOK*.  Make sure that a summary is also in README,
with a link to the relevant HANDBOOK for more info." and "In the handbooks, each tile should be a table where the
first column is a thumbnail of just that tile so that I don't have to scroll up when I read the description.  The
other information there can be other columns.  Be sure to say what external components need to be added."

**What was done.**

- *The jacks' names.*  They sat in the 1.5 mm gutter between rows, where "OUT A  REF IN  IF" under R7 read as R7's when
  two belonged to R10 below (and "DRIVE IN  TEMP OUT" under A8 was A10's input and A8's output).  Every jack's name now
  sits on its own tile's frame line beside the jack, the frame broken round it (`gen_pcb.frame_texts`); any tile text
  on the frame breaks it the same way (A1's socket pins moved there from the gutter).
- *What each tile is, in words.*  A title on the top frame where it fits ("LNA QPL9547", "GAIN", "TX MIXER ADL5350",
  "SYNTHESIZER", "POWER METER", "NOISE SOURCE", "GNSS PREAMP", "PULSE AMP", "NMR DUPLEXER", "PREAMP x12",
  "REFLECTOMETER", "LASER DRIVER", "VLF LOOP AMP"), and ranges and levels inside the tile, placed by a raster search
  clear of pads, bodies, wires and other text (`Tile.info`, `gen_pcb.place_labels`): the mixers' RF, LO, IF and loss,
  the synthesizer's range, output and reference, the switch's control lines, A11's TX and RX sockets, A5's IF pin, Y4's
  coil and 12-18 V terminals.  About fifteen tiles had no room for their ranges; those are in the README and handbook.
- *Section numbers.*  Yes, "4.06 5.02" were the tutorial's sections.  They are off every board; the handbooks name the
  tutorial's pages by title, and the tiles' notes no longer cite numbers.  The tutorial's own cross-links are untouched.
- *README.*  Under each board's picture, a table of its tiles: what it does, the chip with its maker's page, specs,
  limits, experiments, how to use it and what to buy, each tile linked to its handbook entry.  Generated by
  `gen_docs.readme` from `boards/tile_docs.py` between markers; the rest of the README is hand-written.
- *Handbooks.*  Each tile is a table: its picture (`scripts/tile_thumbs.py` crops it from a 25 px/mm render), then what
  it does, its jacks and where they are, its Pmod lines, what to expect, how to use it, what to buy (with KIT.md's
  products), specs, limits, experiments, the chip, the tutorial pages, the circuit and the parts.
- All five boards rebuilt: ERC 0, DRC 0, every fab check passed; costs unchanged.  Appendix D's renders refreshed and
  a bullet added for the silkscreen; its spec row no longer asks for section numbers on the boards.

**The answers** (the full text is the session's reply): P7's band is the digital-communications pages' 6.25 MHz
carrier and its chips; LC, ceramic and quartz are three points on a ladder of Q (6, hundreds, 50,000), the ceramic at
the AM superhet's 455 kHz; the LEDs are Planck's constant; the loopstick has switched C0G capacitors because JLCPCB
stocks no tuning capacitor (nothing hand-soldered) and known values let the tuning be checked against the silk.
The HB100 is a module to buy (it carries its own antennas); A6 is a delta-sigma loop closed through the FPGA (IO7 in,
IO8 out); A9 is a teaching Gilbert cell whose 1.5 k IF output limits it to an IF of about 1 MHz on a metre of coax;
a diode-ring mixer is worth adding (proposed, not placed); A10's switches pick the reference resistor; A11 gives about
50 dB more than transducers clipped to the converters (10 V p-p drive, x100 at the receiver); A12 is a speaker
channel and a microphone channel.  RF-MOD's splitter takes two cells for its three jacks, and is the least needed tile
(the reference is shared by a trace); R13 pairs with R8 and R10 as a heterodyne receiver on one reference.  RF-MOD-2's
splitter is what makes X1 and X2 coherent.  Proposed for Jason's decision: bring each MAX2871's complementary output
(RFOUTA-, now terminated) to a second jack and free both splitters' two cells.

## Prompt 15 (2026-10-28)

> Your decision was correct to remove the section numbers from the PCB and keep them in the computer files.  Web pages
> can be updated; PCBs are forever.
>
> I'd be willing to hand solder the AM tuning capacitor.  I don't know if you can find a physically small enough knob
> for the board.  If you can't, keep the switches, but maybe add screw terminals for an external large knob if there is
> room.
>
> Do the diode-ring mixer instead of the "least useful" passive splitter.  I have passive splitters.
>
> On the ultrasound module tile, I understand that the header pins are not power, but what is power used for at all on
> this tile?  TX and RX amplifiers, it would seem.
>
> Don't say "AUDIO IN".  That's confusing.  Whose "in"?  Say SPEAKER IN and MIC OUT.
>
> Yes, free both splitters and bring out RFOUTA-.  Add the diode-ring mixer and, on RF-MOD-2, a directional coupler.

**Response** (2026-10-28, 08:00-09:00).

- *The AM tuning capacitor (P13).*  The smallest AM polyvaricons are 15-20 mm square, with a 20-25 mm dial on top: a
  whole cell beside the jack, the dial overhanging the neighbours.  So the switches stay, and a 2-way screw terminal
  (VAR C, the same KF301 as the coil's) sits beside the coil's terminal at the bottom edge, in parallel with the
  switched capacitors.  An external 365 pF air variable with a big knob tunes the whole band by itself (switches off),
  or between the switches' steps.  The DIP and its four capacitors moved up into the right cell's top half.  KIT.md
  lists one (Amplified Parts' single-section 365 pF, about $31; its page refused a script, so unverified).
- *The diode-ring mixer instead of RF-MOD's splitter.*  R1 is now a Mini-Circuits ADEX-10L+ (861 in stock at JLCPCB,
  $8.93): LO and RF 10-1000 MHz, IF DC-800 MHz, +4 dBm of LO (R10 at its top setting drives it directly), 7.2 dB of
  loss.  The silk draws what is in the package beside it: the LO balun, the ring of four diodes (two crossed), the RF
  balun whose centre tap is the IF.  It covers 10-30 MHz, where AMOD-A's MC1496 Gilbert cell works, and 915 MHz, where
  R8's ADL5350 works, so it can be compared with both.  The jack order is LO top-left, RF top of the right cell, IF
  bottom of the left cell: the package's pins only allow that without a crossing.
- *RFOUTA- on both synthesizers.*  R10 and X3 bring the MAX2871's complementary output to its own jack: OUT A+ and
  OUT A-, the same frequency and power, 180 degrees apart.  The line drops past the chip, runs in the margin 1.25 mm
  below the tile (the slide switch fills the tile's bottom edge) with the ground pour following it, and turns up into
  the right cell's bottom-right jack.  On RF-MOD-2, X3's REF IN moved to the right cell's top-left with its line on the
  back, and the IO5 and IO6 wires in the margin moved 1 mm down.  An unused output wants the kit's 50 ohm terminator.
- *A directional coupler on RF-MOD-2.*  X5 is two TDK HHM22137A1 couplers back to back, each with its isolated port in
  51 ohm.  FWD samples the wave going from IN to OUT, REFL the wave coming back from OUT, 25 dB down from 0.67 to 2.7
  GHz (27 dB at 0.6, 14 dB at 3.5 GHz), with about 20 dB of directivity.  X1 on IN, a device on OUT and REFL into X2
  measure the device's reflection (S11, magnitude and phase) as well as the transmission the pair already measured.
  JLCPCB's land pattern left 0.2 mm between pads, under the RF class's 0.25; the pads are drawn 0.29 wide (the part's
  terminals are 0.25).
- *SPEAKER IN.*  A12's jack is SPEAKER IN on the board, in the handbook, README, plan and tutorial.
- *The ultrasound tile's power.*  Yes: the slide switch's 5 V feeds the two amplifiers.  The DRV8837 H-bridge drives
  the transmitter (each end swings 0-5 V in antiphase, so the transducer sees 10 V peak to peak), and the receive op
  amp takes its positive rail from it (its negative rail is the board's -5 V).  The handbook now says so.
- *Generators.*  Silk drawings that are not wires (`Tile.draw_line`, `draw_arc`), a pour tongue below a tile
  (`Tile.pour_below`), jack names that slide up to 4.5 mm and print what blocks them when they cannot fit.
- All five boards rebuilt: ERC 0, DRC 0, every fab check passed.  Parts per board: AMOD-P $17.07 (was $16.97),
  AMOD-A $50.40, RF-MOD $66.51 (was $57.18: the mixer), AMOD-2 $78.19, RF-MOD-2 $99.65 (was $98.61).  Handbooks,
  README tables, DOA lists, PLAN files, the review brief, KIT.md and Appendix D's renders updated; CLAUDE_PCB.md
  section 22 has the lessons.  One thing noticed, not changed: AMOD-A's In2 pour fills to one of two equivalent shapes
  on alternate builds (both DRC-clean).

## Prompt 16 (2026-10-28)

> Are there any other RF or Analof building blocks that we are sorely lacking in this set of tiles?

### Response 16 (about 10:50; an answer, no change to the boards)

Every tile on the five boards was checked against the usual RF and analog blocks, and JLCPCB's shelf read for the
candidates (2026-10-28).  Mixers (six kinds), amplifiers, switches, detectors, couplers and bridges, noise sources and
synthesizers are well covered.  Two real gaps and two smaller ones:

1. *A step attenuator* (the biggest gap).  Nothing changes a signal's level by a known amount; the only attenuator is
   P1's fixed 20 dB.  It is what compression point, IP3, noise figure, sensitivity, bit-error rate against SNR, the
   log detector's slope and an AGC loop all need.  The pSemi PE43711B-Z (C470929, 1,673, $3.91): 9 kHz-6 GHz,
   0-31.75 dB in 0.25 dB steps, so one tile serves HF and RF; a DIP switch (parallel mode) or three Pmod lines
   (serial: on RF-MOD-2 the MAX2871's data and clock, its latch on IO7, the spare line).  The PE4312C-Z (C500480,
   1,978, $2.22) is the 1 MHz-4 GHz, 0.5 dB alternative.
2. *An oscillator made of a transistor and a tank.*  Every frequency on the boards comes from a chip.  A Colpitts on an
   MMBTH10 (C545531, 7,387, $0.015) or BFR92P (C273250, 1,508, $0.42), an LC tank with BB133 varactors (Y8's) or a
   crystal on a DIP switch, a TUNE/INJECT jack and OUT: start-up and loop gain, an FM transmitter from a DAC, phase
   noise against the crystal and the MAX2871, and injection locking (Adler's equation) from the DAC.
3. *A zero-bias Schottky detector* (smaller): square law at low power, linear at high, AM's envelope; the AD8318 hides
   the diode.  SMS7630-006LF (C6489012, 83, $6.22) or SMS7621-005LF (C74287, 354, $3.59, wants a little bias).
4. *Wideband transformers* (smaller; Appendix D's "maybe" twice): TC4-1W+ 1:4 (C879855, 2,227, $1.71) and
   TC1-1TG2+ 1:1 (C3305009, 85, $4.17): baluns for 6.12's dipole, breaking a ground loop, single-ended to balanced.

Not on the list: RF low-passes for the MAX2871's harmonics (LFCN-320+/530+ are in stock) if the lab has none on SMA.
All 80 cells are full.  Suggested homes: the attenuator in place of RF-MOD-2's X4 (a copy of RF-MOD's R5; a cable to
R5 does its job); the oscillator in place of AMOD-A's A3 (the host's x100 input now does its job, though A2 and A3
together show gain times bandwidth).  Waiting for Jason's choice.

## Prompt 17 (2026-10-28)

> It seems like there is enough pressure that I should make another analog board. We should really call this the 2nd
> board because it's so much simpler than even the active board. The board with the laser stuff and NV center stuff
> should maybe be renamed  OMOD for optics or PhMOD for physics. All of the things that you suggested along with some of
> the things that we've dropped should go on this new analog board. Things that I can recall off the top of my head which
> would benefit from inclusion in a new analog passive board include SLOT for VNA-type calibration, passive splitters,  If
> it make sense to move the diode mixer onto this new analog passive board, do that to free up space there. Allow
> yourself to make a analog passive board and fill it with the tiles that got bumped or new one that would be great to
> have. Work on this for however long it takes and let me know when the images and docs are all updated.

Mid-turn:

> Keep going. If something can run on 3.3V, it could still be plugged into the PMOD port but wouldn't require an
> external USB 5V input.

> To distinguish whole-tile labels from SMA or port labels, use different cases (upper, lower, mixed).

### Response 17 (about 11:00 to 17:00)

- *AMOD-2 is PhMOD* (physics: magnetic resonance, the ionosphere and light).  The stem is `phmod`; the tiles keep
  Y1-Y10.  OMOD is left for the optics board of PLAN_LEVEL2 section 6.
- *AMOD-P2, the second passive board*, second in every list.  It did not take the freed name AMOD-2, which the history
  uses for the physics board.  Twelve tiles, P14-P25, on sixteen cells, four layers on RF-MOD's stack and launch, no USB:
  - P14 calibration: SHORT and OPEN at the pin, LOAD, a 25 ohm check standard, a 19.8 mm THRU.
  - P15 two Smith-chart loads: 200 ohm, and 200 ohm matched at 9.2 MHz.
  - P16 a resistive splitter, DC-6 GHz.
  - P17 an ADP-2-1+ transformer splitter.
  - P18 a quarter-wave stub, with a notch near 2.45 GHz.
  - P19 an LFCN-1000+ low-pass.
  - P20 a zero-bias SMS7630 doubler detector.
  - P21 a bias-T.
  - P22 a PE43711 step attenuator on the Pmod's SPI lines.
  - P23 a 10.5 MHz Clapp oscillator, varactor-tuned and injection-lockable from TUNE.
  - P24 a 1:1 balun whose OUT jack floats.
  - P25 a 1:4 transformer with switched loads.

  P22 and P23 run on the Pmod's 3.3 V, as the mid-turn message said, and carry the board's plug.  $43.91 of parts.
- *The diode mixer stayed on RF-MOD.*  With the two powered tiles on AMOD-P2, the tiles asked for, suggested and dropped
  filled its sixteen cells exactly.  Moving R1 would have left two cells on RF-MOD with nothing waiting for them.
- *Left out:* the oscillator's crystal (a VCXO; no room), a 30 MHz anti-alias low-pass (the host has its own), a crystal
  ladder filter, a 10.7 MHz ceramic filter (none in stock), a quadrature hybrid.
- *Case on the silk, all six boards:* ports in capitals, tile labels in mixed case, the rest lower case.
- *Placements.*  A new check (`scripts/check_rotations.py`) fits JLCPCB's own drawing of every part onto its footprint.
  It found every SOT-23-family part at 0 where JLCPCB needs 180 (or 270), including the AO3401A in every powered tile.
  It also found SOICs, the TSSOP and the headers needing 270, and the USB-C, SOT-89s, slide switches and headers needing
  a move to JLCPCB's origin.  The upload CPLs of all six boards now apply both; the DOA lists make it an order gate.
- All six boards: ERC 0, DRC 0, every fab check.  Handbooks, README, PLAN.md section 11, the review brief, KIT.md,
  DOA_amod_p2.md, Appendix D (with fresh renders) and CLAUDE_PCB.md section 23 updated.  Nothing pushed.

## Prompt 18 (2026-10-28)

> Make sure that the rotation bug you found is documented in the appropriate place in ~/OpticsPCBs/CLAUDE_PCB.md. I
> think you probably put that there, but just check.. Can the P22 Attenuator (PE43711) also still be controlled with
> switches? Does this part need the 3.3V power? If the FPGA pins are high impedance, this would be nice to do manually.
> Can the P23 Oscillator be used with a mixer (and the DAC board) to transmit FM in a way that an FM radio can pick it
> up? Is there a path to receive and digitize broadcast FM with these boards? Are there any tiles that would make sense
> to swap around between boards in terms of power (3.3V vs the 5V USB input) or similarity for logical or pedagogical
> reasons? I hope that the silkscreen (including on the back) is appropriately used to document anything that a user
> definitely needs to know to use the tiles successfully and without damaging anything. If there is additional room on
> the back, putting plots of expected responses or other relevant parameters would be great. When someone is screwing
> things into the board, it's far easier to read the silkscreen in front of them than it is to look up stuff on github
> and try to make sure they are looking at the correct list for the correct board. Is there a path on these boards to
> transmit and receive Bluetooth Low Energy (BLE) from back and forth between the ECP5 FPGA and, say, a phone or laptop?
> What other common radio protocols could be done from these boards to a phone, laptop, or handheld radio?

Mid-turn:

> Look at these sets of labs from Analog Devices: https://wiki.analog.com/university/courses/electronics/labs  Maybe you
> already did this. I think that there is value in building most of these things on a breadboard with individual ICs,
> but if there are some labs here that fit in the spirit of these boards (along with the ECP5 2DAC 2ADC board), if we
> are missing something, let's see if we can add it. Whole areas that we are missing include power regulation and other
> component-level circuits, but something like a switched capacitor filter or details of their Delta – Sigma Modulator,
> if there is room, might be worth it.

### Response 18 (about 17:00 onward)

- *The rotation bug* is in CLAUDE_PCB.md section 8's rotation table (the SOT-23 family by its drawing's suffix, SOIC and
  TSSOP, headers, 3225 crystals, the datums) and section 23's lessons; section 24 now adds the back panels' lessons.
- *P22 by hand:* yes.  The PE43711's direct parallel mode (P/S low, LE high) is meant for switches.  P22 took a second
  cell for an 8-way DIP: way 1 SPI, ways 2-8 the bits, 100 k pull-downs, LE pulled up so a floating FPGA pin leaves the
  switches in charge; in SPI mode the bits must be off.  It still needs the Pmod's 3.3 V (an active switch array).  P15
  (the Smith-chart loads) gave up its cell; P23 moved to (3,0).
- *The back of every board:* a panel under each tile (its limits, loads, supply, the one thing that breaks it) and a
  plot of the response to expect where there is room (AMOD-P's ladders, P10's clipping curve, P17, P18, P19, P23, A2-A4,
  Y5, Y6, X5).  Placed in reading order, every panel and plot on all six boards, DRC 0.  The front gained PULSES ONLY
  (Y2), "start at mV" (Y10) and the LNAs' "IN -20 dBm" (R5, X4).
- *FM:* transmit with the DAC (an FM IF from the gateware) or P23 (audio on TUNE, about 0.5 MHz/V) into R1's IF, R10 at
  about 87 MHz on its LO, 98 MHz on its RF port, a few centimetres of wire (Part 15.239).  Receive with R1 and R10 down to
  a few MHz, AMOD-P's LC low-pass, the ADC at 25 MS/s and an FM discriminator in the gateware, A12 for the sound.
- *BLE:* advertising from the FPGA is practical (GFSK on the two DACs into RF-MOD-2's X1 on X3's LO at 2402/2426/2480
  MHz, or R13 alone); a phone's scanner lists it.  Receiving a phone's advertising through R2, R5 and X2 into the ADCs
  is practical too.  A connection (150 us turnaround, hopping) is possible in gateware but the largest project.
- *Other protocols:* an 802.11b beacon (a fake SSID in a laptop's list), AM broadcast straight from the DAC, 433 MHz OOK
  for rtl_433, LoRa at 915 MHz to a Meshtastic handheld, receiving FRS/GMRS or a ham handheld's NBFM; receive-only
  ADS-B, GPS and NOAA APT.  Not practical: Bluetooth Classic, OFDM Wi-Fi, Zigbee/Thread to a phone.
- *Swaps:* none made (PLAN.md section 12): X4 duplicates R5 and is the first cell to give up; R1 suits AMOD-P2 but wants
  R10 beside it; A6 and A7 could run on 3.3 V but moving them saves AMOD-A nothing.
- *Analog Devices' labs* (a subagent read all 109 pages; docs/ADI_LABS_SURVEY.md): power regulation is the one whole
  area missing; switched capacitors, a second-order delta-sigma, track-and-hold, SAR and transistor blocks also fit.  The
  boards are full, so PLAN.md section 12 proposes a seventh board, AMOD-A2, for Jason to decide.
- Full rebuild: ERC 0, DRC 0, every check; check_rotations 186 codes, 0 differ.  AMOD-P2: eleven tiles, 28 jacks,
  $43.82.  README, PLAN.md, DOA, KIT, review brief, handbooks, Appendix D (fresh renders and AMOD-P2's back) updated.
  Nothing pushed.

## Prompt 19 (2026-10-28)

> The only other things that I might be interested in are motor drivers and mechanical servo-type feedback. DC motor,
> stepper motor, 3-pole BLDC motor (like for a drone or even better a gimball), along with encoders or magnetic back
> reaction or some other fast mechanical feedback. Would this fit on your 7th board, or would these things be an 8th
> board. Either way, design those boards. We need a better naming system for the boards and tiles. I'm happy with the
> 11th tile on the passive analog board being called A11, but should we call the 11th tile on the active analog board
> B11 or C11 or something? For the RF boards, I'm happy with R11, but then S11 and T11?  Or go back to C11 for comms?
> For the motor board, M11 for its 11th tile? If we can have a nice, well justified single-letter designator for each
> board, it would make everything much more clear. Do all of this. Take your time and do it right. Cross check all
> existing documentation for consistency.

Mid-turn:

> If it makes more sense to do 2 boards rather than one board with two Pmods, stick with an extra board. If you need
> more than 8 FPGA pins, I guess you're stuck with the two Pmods.

> Maybe you want to make the tiles lower case, because D11, Q11, C11, etc look like a  reference designators for
> diodes, transistors, and capacitors. d11, q11, and c11 don't look like obvious electronics or PCB things.

### Response 19 (2026-10-28 into 10-29)

- *Names* (PLAN.md section 13): one letter per board, the initial of what it is about, and tiles as that letter in
  lower case with a number: p (AMOD-P), n (AMOD-N, was AMOD-P2: the pieces of a network analyzer), a (AMOD-A), c
  (AMOD-C, conversion), m (AMOD-M, motors), b (AMOD-B, brushless), r (RF-MOD), h (PhMOD), q (IQ-MOD, was RF-MOD-2:
  quadrature).  No letter moved to another board and no retired name is reused, so a stale reference points at
  nothing rather than at the wrong tile; not s (s11 is a reflection coefficient), not i, l or o.  Every board, the
  handbooks, the README and Appendix D renamed with a tokenizer; the generator refuses a tile whose name is not its
  board's letter and a number.
- *The seventh board, AMOD-C* (conversion, the ADI labs' missing area from Prompt 18): a buck and an LDO with an
  electronic load, a charge pump the FPGA clocks, a switched-capacitor filter and integrator, a second-order
  delta-sigma modulator with both integrators on jacks, a track-and-hold, a SAR comparator, a differential pair, a
  cascode, a 555 V-to-F and a precision rectifier.  Twelve tiles, 26 jacks, $43.57.  check_pinouts.py (new: every
  symbol's pins against EasyEDA's) found two real pinout errors, fixed: the DMMT3904W pair and RF-MOD's 915 MHz SAW.
- *Motors take two boards, one Pmod each* (sixteen FPGA lines in all).  **AMOD-M** (eleven tiles, 18 jacks, $35.98): a
  DC motor with its encoder and a stepper on DRV8251A (it runs from USB's 5 V through the Schottky, unlike the
  DRV8876), a servo, a solenoid with three flybacks on a jumper, a TCA0372 bridge amplifier for a voice coil or a
  maglev, a TPS28225 buck stage the FPGA closes the loop on, and a hall, an optical and a load-cell sensor.
  **AMOD-B** (twelve tiles, 13 jacks, $42.11): a GBM2804 gimbal motor on four slots over an MT6701 encoder, two halls
  and an index sensor (a 2 x 2 tile); a DRV8311H in 3x PWM from three Pmod lines with COAST from a DAC; the back-EMF,
  the phase current in line (INA240) and the bus current; the encoder's angle as a voltage, a vibration pickup; an
  LSM6DSO sharing MISO with the encoder through a buffer (the MT6701's DO never lets go).  The driver's current
  amplifiers reach the jacks through a passive 3.3 k / 10 k shift to -5 V (0.75 V/A) where an op amp did not fit.  The
  SPI lines nest up a gutter because their Pmod pins were chosen for it; the encoder's lines run on 45-degree corridors
  between the motor's slots; the +3.3 V pour got a band over the slots, which had cut it.
- *Checks*: all nine boards rebuilt: ERC 0, DRC 0, every fab check; check_rotations 241 codes, 0 differ;
  check_pinouts: naming differences only on the new boards, each read against its datasheet (DOA lists).
- *Documents cross-checked*: PLAN.md sections 13-15 (section 14 rewritten as built, 15 for AMOD-C), KIT.md (AMOD-C's
  note, a motors section from a parts search: about $100 a bench; no fixed 12 V adapter was in stock, so the 3-12 V
  supply PhMOD already uses; the a12 speaker now out of stock), REVIEW_BRIEF.md (nine boards, three review items),
  README (nine boards, AMOD-B's row and table), DOA_amod_c/m/b, the handbooks, AMOD-M's module note (it still said
  DRV8876), Appendix D (the three boards with renders, and three image links Prompt 19's rename had broken), and
  CLAUDE_PCB.md section 26.  Nothing pushed.
- *Left for Jason*: the gimbal motor's base thread is unpublished (iFlight says M2), so the kit's screws are unpriced;
  the tutorial checker's three remaining errors are on pages this prompt did not touch (two anchors in 0.01, one in
  0.00).

## Prompt 20 (2026-10-29)

> Great. Fix those links in 3.00 and 6.00. I rewrote some of the earlier material, stripping it down to its essentials
> so that the students could see something running on their boards as soon as possible. If the section names simply
> changed, that's an easy fix. But check that the content that those links were meant to point to is still relevant.

### Response 20 (2026-10-29)

Tutorial repo only, one commit (60b6d5e); the checker now reports 0 errors.
- *3.00 and 6.00*: the heading was renamed ("Where does this run?" became "Where does a command run?") and the table
  of prompts is still under it, matching what the pages use (Chapter 3: `#`, `>>>`; Chapter 6: `$`).  One gap: 6.12
  and 7.03 type at `B$`, which the table lacked, so its two-board row became two rows (`A#`, `B#`: root's shell on each
  board; `A$`, `B$`: the laptop, a command for board A or B).
- *Appendix B*: "Which SMA is which?" moved from 0.00 to 1.02; the link follows it.
- *Not flagged by the checker*: 0.00's converter table (ranges, the conversions code = 126.7 + 25.35 x V and V =
  0.0307 x code - 3.95, 7.1 effective bits) moved to 1.02's "What the converters can do", but 1.04, 1.06, 1.07 and
  2.05 still linked 0.00's top for it, and six printed code files (with their src/ copies) and two dev figure scripts
  said "(0.00)".  All now cite 1.02; 2.05's "half-code residual of 0.00's sine fit" became "behind 1.02's 7.1
  effective bits", which is what it meant.  The other links to 0.00 and 0.01 (the hardware list, cloning, the serial
  port's name) still find their content.
- *Left*: the checker's one warning, that 0.00 opens with a sentence rather than a picture, is from the rewrite and
  left for Jason.  Nothing pushed.

## Prompt 21 (2026-10-29)

> There are some new lessons in ~/OpticsPCBs/CLAUDE_PCB.md. Look over them and do any checks that you think would help
> ensure the successful fabrication and assembly of revA of this board. Then I will submit the JLCPCB order for at least
> a few boards. Make a table here of the board, its approximate price, and the likelihood that it will work (or the
> fraction of tiles you expect, on average, to work).

Mid-turn:

> Check ~/OpticsPCBs/CostasLink-PYNQ-Z2/tools/fit_pdf.py for those tools

### Response 21 (2026-10-29)

The new lessons (sections 1, 2, 5, 9, 10, 11, 14, 27, 28 since 9561e5d) run as checks on all nine boards; what they found,
fixed and rebuilt (all nine: ERC 0, DRC 0, the new layout checks, every fab check; check_rotations 241 codes, 0 differ):
- *Screw terminals backwards* (section 28, the op-amp review): JLCPCB's KF301 has its wire openings on the side our
  footprint called the back, so all ten blocks (AMOD-P, -A, -M, -B, PhMOD) would have faced into the board.  CPL +180,
  the footprint body 3.7 / 4.0 and its 3D model flipped, four blocks moved 0.4 mm forward off their neighbours, and a
  wire-face check in `check_outputs.py`.
- *Oversold parts* (the stock gate read raw stock): four codes showed stock but a negative free count.  Swapped for the
  same value and package: 27 ohm (C100353), 6.8 k (C93940), 220 nF (C16772, X7R 16 V: both uses at 5 V or less),
  OPA847IDBVT (C2059024, whose JLCPCB drawing is a quarter turn from the IDBVR's: +180, caught by check_rotations).  The
  gate now uses the free count, for codes a BOM orders.
- *Vias in pads*: ten vias had their holes in or across SMD lead pads, four more 0.02-0.03 mm inside (a12, m2, b2, r5,
  r9, r12, q4, h1, h4, h7, h10).  All moved; `scripts/check_layout.py` fails one in every build (and gate 24's detours).
- *Terminations' power* (the op-amp review's scope clip): the 49.9 ohm terminations and back-terminations, 62.5 mW in
  0402 and 0.1 W in 0603, become 200 mW (Vishay CRCW0402...HP) and 250 mW (Yageo SR0603): a generator's 10 V p-p is 0.25 W.
- *Assembly drawings* (section 2, `fit_pdf.py` from CostasLink as asked): they put the board 1:1 in an A4 corner under the
  pours; now Fab, silkscreen and outline fitted to Letter with the scale, 88-92 % fill, checked in the build.
- *RF gates 24-32* (`scripts/rf_extract.py`, `rf_survey.py`): lines exact, no matching part on a branch (the chips are
  internally matched), chokes 0.5-2 mm off the line; fences 0.2-1.7 vias/mm and the pour up to 9.8 mm from a via: fine at
  2.4 GHz, short at the 5.8 GHz stretch.  In the RF DOA lists.  The as-laid simulation was not run.
- *Checked and fine*: diode, LED, TVS and electrolytic polarity against JLCPCB's drawings; the slide switches' posts
  (already slotted); the LF398's pin 1; the THS3491's unisolated OUT goes on the bench list (terminate it).

| board | tiles | parts / board | 5 PCBs, 2 assembled | 5 PCBs, 5 assembled | tiles expected to work |
|---|---|---|---|---|---|
| AMOD-P | 13 | $17 | ~$155 | ~$195 | ~95 % |
| AMOD-N | 11 | $44 | ~$175 | ~$300 | ~90 % |
| AMOD-A | 12 | $50 | ~$220 | ~$340 | ~88 % |
| AMOD-C | 12 | $44 | ~$240 | ~$355 | ~85 % |
| AMOD-M | 11 | $36 | ~$230 | ~$320 | ~85 % |
| AMOD-B | 12 | $42 | ~$200 | ~$305 | ~78 % |
| RF-MOD | 10 | $67 | ~$270 | ~$445 | ~80 % |
| PhMOD | 10 | $78 | ~$295 | ~$490 | ~78 % |
| IQ-MOD | 11 | $100 | ~$355 | ~$630 | ~72 % |

Costs: JLCPCB's economic PCBA fees of 2026-10-09 ($8.18 setup, $1.53 stencil, $3.58 hand-soldering, $3.07 per Extended
part, $0.0164 per through-hole joint), today's part prices with JLCPCB's own attrition, and a guessed $12 for five bare
4-layer boards ($5 for 2-layer); no shipping or tariff.  The tutorial repo's index had been set to 1493241's tree by
something else (commit there would revert eight commits), so Appendix D's new prices are left uncommitted.  Nothing pushed.

## Prompt 22 (2026-10-29)

> AMOD-A's U1201 seems to have the wrong package in the preview.

(with a screenshot of JLCPCB's placement preview: the PAM8302's leads half-way between U1201's pads)

Mid-turn:

> For the RF-MOD board, I cannot pick the particular stackup.

(with screenshots of the PCB quote page: Specify Stackup No / Yes, Via Covering Plugged, Min via hole size 0.3 mm)

### Response 22 (2026-10-29)

- *U1201*: right.  C113367 (PAM8302AASCR) is an MSOP-8, the only PAM8302 JLCPCB stocks (the SOP-8 PAM8302AADCR, C112137,
  has none); the footprint was a SOIC-8.  check_rotations had fitted it at +270 with 0.77 mm rms and called it ok: it
  never failed on a residual.  a12 re-laid on KiCad's MSOP-8 (every wire into the chip redrawn, pin 2 NC as Diodes'
  application circuit and JLCPCB's symbol have it, its 1 u dropped), rms now 0.03 mm, ERC 0, DRC 0.
- *The gate*: `scripts/check_overlay.py`, run in the out stage: JLCPCB's drawing laid where the table's turn and datum put
  it, every pad centre inside our same-numbered pad (custom pads' primitives read: the SOT-89 tabs).  All nine boards:
  108 codes, 0 off their pads; it fails a quarter turn by 2 mm.  The 310 two-pad lines' size codes all agree with
  JLCPCB's packages.  `check_pinouts.py` paired EasyEDA's names by c_spicepin, which is not the printed number on the
  PAM8302's symbol; fixed (only the PAM8302 and ADL5350 readings changed, both now agree).
- *The stackup*: leave Specify Stackup at No.  JLCPCB's impedance page lists "No requirement" for 4-layer 1.6 mm as the
  JLC04161H-7628 layers (0.2104 mm 7628 prepreg, 1.065 mm core).  Min via hole size 0.25mm/(0.35/0.4mm) for RF-MOD,
  IQ-MOD, PhMOD, AMOD-B and AMOD-N (0.25 mm holes in 0.45 mm vias), the default 0.3 mm for the rest; Plugged vias are
  fine.  These are now in MANUFACTURING.md's order steps.
- *MSK12C02*: section 28's new 0.55 mm datum is for round post holes; AMOD's slotted posts take JLCPCB's drawing at the
  0.251 mm datum (its posts at the slots' centre) and Shouhan's spacing alike.  Kept.
- AMOD-A's parts $49.73.  CLAUDE_PCB.md section 29 extended (b01eb39).  Nothing pushed.

## Prompt 23 (2026-10-29)

> Now for the RF-MOD, my order looks like this (still no Impedance Control).

(with screenshots of the quote: Specify Stackup Yes, JLC04161H-7628; Impedance Control No requirement; Min via
0.25 mm, which made JLCPCB select FR4 TG155 and a 4-wire Kelvin test; LeadFree HASL; Economic PCBA, top, 2 pieces,
Confirm Parts Placement Yes; PCB $51.43)

### Response 23 (2026-10-29)

- The order is right.  JLC04161H-7628 by name is better than "No requirement" (the same layers, stated).  Keep Impedance
  Control at No requirement: the lines are drawn for that stack (0.29 mm, 0.25 mm gap: about 54 ohm, CostasLink's field
  solve of the same geometry), and the service would let the fab re-width them.
- The 0.25 mm vias cost about $38 on each of the five fine boards (TG155 $3.56, Kelvin test $17.20, via size $17.37):
  my $12 PCB guess holds for the other four, so the total is about $190 more than my table.  Changing those vias to
  0.3 mm holes would need every tight via re-checked on five boards; not worth it for this order.
- ENIG instead of lead-free HASL is optional: flatter pads for the 0.5 mm leadless parts; HASL assembles them too.
- MANUFACTURING.md's order steps say all of this.  Nothing pushed.
