gallicchio/AMOD-and-RFMOD/docs/DOA_amod_a.md

# AMOD-A: what could make it dead on arrival, and what to check before paying

Rev A, 2026-10-25.  Every item is a fact the design assumed that a datasheet, JLCPCB's placement preview or the
first bench test must confirm.  The ones marked **order gate** must be confirmed before the order is placed.

**Placements (Prompt 17).**  `scripts/check_rotations.py` found rev A's table placing every SOT-23, SOT-23-5 and
SOT-23-6 as KiCad draws them, while JLCPCB's drawings are turned 180 ("-BR") or 90 ("-BL"); the upload CPL now turns
them, and moves the USB-C, SOT-89s, slide switches and headers to JLCPCB's origins (`parts.JLC_DATUM`).  In the preview,
check that each SOT-23's pin 1 sits at its silkscreen dot and the USB-C's shell sits on its pads: an **order gate**.

## Order gate: pin and polarity assumptions

1. **The HB100's header (a5, J501).**  A 1 x 3 socket wired +5 V (the tile's switched rail), IF, ground.  HB100
   modules differ in their pin order (some print "+5V GND IF", some "IF GND +5V"): the module goes on three jumper
   wires, so read the module's own print and wire it to match.  +5 V on the IF pin does no harm through 1 uF; on the
   ground pin it shorts the tile's rail through the P-FET (the PTC on a1 limits it).
2. **a10's DIP4 (SW1001).**  One reference resistor at a time (47, 470, 4.7 k, 47 k from S to X); two closed give
   their parallel value, which the analysis must use.  The DUT jack's part sees up to +-4 V and 40 mA (47 ohm).
3. (Rev A's LT6230 item: a5 no longer carries an LT6230.)
4. **TLV3501 (a6, U601).** SOT-23-6, taken as -IN 1, V- 2, +IN 3, V+ 4, OUT 5, SHDN 6 with SHDN grounded (active
   high).  Confirm.
5. **PAM8302A (a12, U1201).** MSOP-8 (PAM8302AASCR, C113367: JLCPCB stocks no other), SD 1, NC 2, IN+ 3, IN- 4,
   VO+ 5, VDD 6, GND 7, VO- 8 (Diodes' application circuit and JLCPCB's symbol).  Until 2026-10-29 it sat on a SOIC-8
   footprint, which JLCPCB's placement preview showed (its leads half-way between our pads); `check_overlay.py` now
   fails a part whose drawing does not land on its pads.  SD is tied to VS (on when the tile is on).  Confirm SD's polarity (active low shutdown).
6. **DRV8837 (a11, U1101).** WSON-8 with the thermal pad on ground; pins taken as VM 1, OUT1 2, OUT2 3, GND 4,
   IN2 5, IN1 6, nSLEEP 7, VCC 8, nSLEEP tied to VS.  Confirm against the DSG package drawing (pin 1 at the dot).
7. **MC1496 (a9, U901).** SOIC-14 as the datasheet's "pin connections": SIG+ 1, GAIN 2 and 3, SIG- 4, BIAS 5,
   OUT+ 6, CAR+ 8, CAR- 10, OUT- 12, VEE 14; pins 7, 9, 11, 13 no connection.  Pin 7 carries the output wire past
   the chip: that is only safe if pin 7 is truly unconnected inside the package (the datasheet says so).
8. **OPA847 (a4, U401).** Now the SOT-23-6 (OPA847IDBVT, C2059024, the 250-piece reel: the IDBVR reel, C160422,
   was oversold on 2026-10-29; the SOIC-8 did not fit between the checkerboard jacks), taken as TI's DBV pinout: OUT 1, -VS 2, +IN 3, -IN 4, DIS 5, +VS 6, with DIS tied to +VS (enabled; low
   disables).  Confirm against the DBV package drawing and the pin-1 mark in JLCPCB's preview.
9. **74HC4046A (a7, U701).** Now Nexperia's 74HC4046APW-Q100J in TSSOP-16 (C546981, 234 in stock on 2026-10-25):
   TI's SOIC-16 (C6542) was too long for the cell between the checkerboard jacks.  Nexperia's pin table is the same
   as TI's (pin 15 is PC3out, unused).  Check two things: the stock on the order day (TI's CD74HC4046APWR, C6543,
   is the same footprint but had only 21), and the VCO range with R1 10 k and C1 1 nF against Nexperia's Fig. 29,
   since its curves differ a little from TI's.
10. **The MSK12C02 slide switch** (every powered tile): pad 1 is taken as the contact made with the slider UP
    (toward the jacks), pad 2 the common, pad 3 the other end.  The tile grounds pad 1 (on) and puts the rail on
    pad 3 (off); if the switch is mirrored the labels are wrong but nothing is damaged (the FET is either on or
    off).  Check the "ON" marking in the preview.
11. **The HRO TYPE-C-31-M-12 footprint** (a1): both CC pins have 5.1 k; the SMD ground pads A1/B1 reach the shell
    holes with a short wire each (the plane carries them).  Check the connector's overhang (1.2 mm past the edge)
    in the preview.

12a. **The Pmod plug (J1104).**  Fixed 2026-10-25: the first layout mirrored every line (see PLAN.md section 2).  The
     plug now sits two columns left with ground on pads 3-4 and 3.3 V on pads 1-2 in JLCPCB's numbering, which is
     Pmod pins 5/11 and 6/12; `check_pmod` confirms every pad.  Confirm in the placement preview that the plug's body
     hangs off the bottom edge and pad 1's square is at the left end of the row nearest the edge.  The lines are now
     IO8/IO7 (a6), IO6 (a8), IO4/IO3 (a11), IO2 (a12); IO1 and IO5 are spare (a10 and a5 no longer use a line).
12b. **No mounting holes.**  Four stick-on rubber feet (8 mm, circled on the back) replace them; buy them with the order.

## Order gate: the rails

12. The -5 V rail is one polygon on L3 (In2) through the gutters under rows 0 and 2 and down the left margin; its
    end in the right margin stops at x 93.6 so the +5 V pour keeps a path down that margin.  Every tile's -5 V via
    lands in a gutter strip; `check_outputs` found the net connected, and KiCad's DRC found no island.
13. The +3.3 V rail is the strip in the gutter under row 1; only a6 draws from it, through the header via at the
    tile's bottom edge.
14. a1's LM2664 gives 40 mA of -5 V.  The op-amp tiles draw about 4 mA each at rest (OPA810), the MC1496 2 mA, the
    class-D nothing from -5 V: all twelve tiles on at once stay under 40 mA.  The USB-C source must give 1.5 A for
    the heater (170 mA), the HB100 (about 40 mA), a10's DUT drive (40 mA at most) and the class-D at full volume.

## Bench, first power

15. With every tile off, the green LED lights and the socket shows +5, -5 and 3.3 V.  Then one tile at a time.
16. a10: with the DUT jack open, S OUT and X OUT read the same (half of S each into 50 ohm); shorted, X OUT reads 0.
    Calibrate open and short at every range before measuring.  a5: wave a hand a metre in front of the HB100 and the
    IF shows tens of hertz at x101.
17. a8's heater is 170 mA when Pmod IO6 is high; the 2512 pair runs warm (0.83 W).  It now sits in a8's top-left,
    about 2 mm below a4's slide switch and FET across the gutter, which tolerate the rise; no precise part is near it.
18. a9's IF OUT is a 1.5 k source: read it with a high-impedance scope input or the ADC's high-impedance setting.

## What was dropped from the plan (not faults: scope)

a4's loop; a7's loop-filter and VCO-capacitor DIPs and its two loops (probe pins 9 and 13); a8's NTC divider and
loop; rev A's first a10 (an LED driver and a photodiode amplifier, now on the host) and a5 (Johnson noise, now on the
host); a12's 3.5 mm jack; a9's
carrier-null trimmer and output follower; a5's 4-way DIP (10 k, 1 k and a socket instead); a11's TX IN jack and
comparator (the bridge is driven from the Pmod); a2's and a3's two-stage variants.
