gallicchio/AMOD-and-RFMOD/docs/HANDBOOK_phmod.md

# PhMOD handbook: the physics board

Generated by `scripts/gen_docs.py` from the tiles' own declarations (`boards/phmod.py`); the expected results come from
the same text the silkscreen quotes.  Rev A, 2026-10-25.

## The board

front

Ten tiles on sixteen 20 mm cells, four layers, USB-C power on h1, built for the ECP5-2ADC-2DAC board, whose converters sample
DC to 30 MHz directly: two DACs and two ADCs, so most tiles take one or two DAC channels and give one or two ADC channels.
Every tile's input is its top-left jack and its output its bottom-right jack; a two-cell tile has two of each.  The powered
tiles have the AMOD-A slide switch (up: on).  +5 V is everywhere on L3; -5 V (40 mA, the LM2664) reaches the tiles above and
below the gutter under row 0 (h3, h7, h9); +-15 V from the TPS65131 reach only h2, on two tracks on the back.  Nothing here
needs more than USB's 5 V except h4's coil, which may have 12-18 V of its own on its upper terminal.

### Pmod lines

The 2 x 6 plug on h5's bottom edge (pins 1-4 are IO1-4, 7-10 are IO5-8, 5 and 11 ground, 6 and 12 the FPGA's 3.3 V,
which the board does not use: every chip here runs from its own 3.3 V, so the lines are 3.3 V CMOS both ways):

- Pmod pin 1 (PMOD1): h2's PD (high: the pulse amplifier on), h2
- Pmod pin 7 (PMOD5): h10's shunt (high: the laser's current diverted), h10
- Pmod pin 8 (PMOD6): h4's EN (high: the bridge on; PWM it), h4
- Pmod pin 9 (PMOD7): h4's PH (the current's direction), h4
- Pmod pin 10 (PMOD8): h9's load switch (high: noise on), h9

## The tiles together

Every experiment below uses the ECP5 board's converters directly: DAC 1 and DAC 2 make the stimulus, ADC 1 and ADC 2 read the
response, and the gateware does the rest (quadrature demodulation, averaging, lock-in).  One clock, so phase means something.

1. **Pulsed NMR, 5-25 MHz.**  DAC 1 into h2 (IO1 high only during the pulse: +-1 V becomes +-10 V, 1 W into 50 ohm), h2's
   OUT into h3's TX IN, h3's PROBE to the probe (match it first with h7: S11 below -20 dB at the Larmor frequency), a
   quarter-wave cable from a tee at the probe back to LINE; h3's RX OUT (the OPA847, x12) into ADC 1, demodulated at the
   Larmor frequency in the gateware.  A Halbach or yoke magnet of N52
   cubes (0.3-0.5 T, protons at 13-21 MHz), a 5 mm vial of water with a little copper sulphate: the FID, the spin echo, CPMG,
   T1 by inversion recovery, T2.  h4 on a gradient coil during the echo: a one-dimensional image.
2. **Earth's-field NMR, 2 kHz.**  h4 drives a polarizing coil round a litre of water for a few seconds (12 V, an amp), then
   stops (IO6 low); a second, receive coil round the same bottle into h6 (gain 101) and ADC 1: the protons' precession in the
   Earth's 50 uT, outdoors, away from mains wiring.
3. **ESR of DPPH, 10-100 MHz.**  A small loop round the sample, tuned to the DAC's frequency and read by h7 (DRIVE from DAC 1,
   INC and REFL into the ADCs); h4 sweeps a Helmholtz pair through g = 2 (1.07 mT at 30 MHz): the loop's S11 dips on resonance.
4. **The ionosphere.**  Two HF antennas into h5's IN A and IN B (gain 9.9 each, 0.7 nV/rtHz): WWV's carrier Doppler at 5, 10
   and 15 MHz (HamSCI), the phase between the channels as a bearing, FT8 and WSPR decoded in software.  A VLF loop into h6:
   sferics from lightning thousands of kilometres away, the Navy's MSK stations near 24 kHz (and their daily phase change at
   sunrise and sunset), sudden ionospheric disturbances from solar flares, WWVB's 60 kHz time code.
5. **Impedance and the Smith chart.**  h7: DRIVE from DAC 1, REFL and INC into the ADCs; REFL / INC = Gamma at every
   frequency the DAC makes.  Calibrate with an open, a short and 50 ohm on DUT, then a crystal's motional arm, an antenna's
   match, a cable's length (time-domain reflectometry from a step), an NMR probe's tuning.
6. **Coupled and parametric resonators.**  h8: DAC 1 into SIG, DAC 2 into TUNE / PUMP (a slow ramp, a 20 MHz pump, or both
   added), OUT 1 and OUT 2 into the ADCs.  Normal-mode splitting and the avoided crossing as TUNE sweeps tank 2 through tank
   1 (the DIP's 1 and 2.2 pF set the coupling); damp tank 1 (the DIP's 2 k) and its response shows a transparency window: the
   EIT analogue; pump at twice the frequency: phase-sensitive gain and de-amplification, then parametric oscillation.
7. **Noise.**  h9 into h5 (or h3's preamp) with IO8 toggled: the Y-factor gives the amplifier's noise figure; h9's noise into
   a filter with ADC 1 on its input and ADC 2 on its output: the transfer function from the cross-spectrum.
8. **Lasers and atoms.**  h10 drives a VCSEL or a laser diode on its LD jack (SET from DAC 1: 100 mA per volt; a VCSEL runs
   at about 1.5 mA, so put 30 dB of SMA attenuation on SET and the DAC's full scale is 3 mA); IQ-MOD's synthesizer on RF IN
   puts sidebands on the light: 3.417 GHz on a 795 nm VCSEL through a rubidium
   cell is coherent population trapping, the chip-scale atomic clock's physics; IO5 blanks the light for pulsed ODMR with
   IQ-MOD's q9 loop; MON (the diode's voltage) with a photodiode on an ADC gives the L-I-V curve and the threshold.

Levels to remember: h2 gives 1 W into 50 ohm from +-1 V and is for pulses (keep the duty cycle under 10 %); h3 lets through
the transmitter above about 0.7 V and gives x12 on the way back; h5's channels give x9.9 (20 dB); h6 x101; h7's REFL and INC
reach the ADCs at half (49.9 ohm into 50 ohm), and so does every output here; h8's ports are -43 dB; h10 stops at 100 mA (1 V);
h4 chops at about 1.3 A.

## The tiles

Each tile in a table: its picture, then what it does, its jacks, what to expect, how to cable it, what to buy
(the links are in [KIT.md](KIT.md)), its numbers and limits, the experiments it is for and the circuit.

### h1  power, USB-C 5 V in: +5, -5, +15, -15 out

<table><tr>
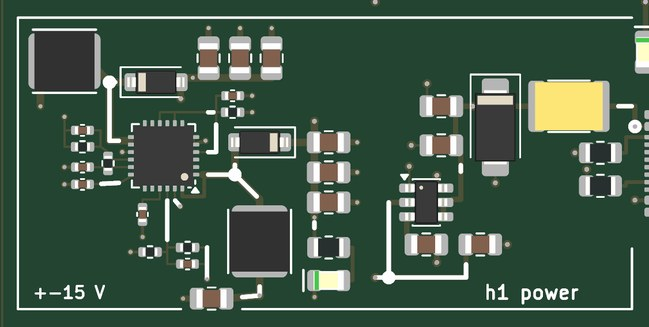
[picture p23: docs/images/tiles/phmod_h1.jpg]
h1 power, USB-C 5 V in: +5, -5, +15, -15 out
<td valign="top" width="528"></td>
<td valign="top">

<b>Power: 5 V from USB-C, and -5 V and +-15 V made from it (the +-15 V for the pulse amplifier).</b><br><br>
<b>Expect:</b> +5 V from the USB-C (up to 2 A), -5 V at 40 mA, +15 V and -15 V at about 150 mA each for the pulse amplifier; green: 5 V in, red: -5 V up, yellow: +15 V up<br><br>
<b>How to use it:</b> Plug in the USB-C; switch on each tile you use.<br><br>
<b>You need:</b> A 5 V USB-C supply, 2 A or more (kit: Raspberry Pi 5.1 V 3 A supply). (<a href="KIT.md">KIT.md</a>)<br><br>
<b>Specs:</b> +5 V up to 2 A; -5 V at 40 mA; +15 V and -15 V at about 150 mA each; LEDs: green 5 V, red -5 V, yellow +15 V.<br><br>
<b>Limits:</b> +-15 V reaches only h2.<br><br>
<b>Chip:</b> <a href="https://www.ti.com/product/TPS65131">TPS65131</a>, <a href="https://www.ti.com/product/LM2664">LM2664</a><br><br>
<b>The circuit:</b> USB-C power only (5.1 k on each CC).  The TPS65131 runs both converters at 1.25 MHz with power-save off (quieter); +15 V = 1.213 V x (1 + 1 M / 88.7 k) = 14.9 V, -15 V = -1.213 V x 1.3 M / 105 k = -15.0 V.  Only h2 draws them, through two back-side tracks; everything else runs from +5 V and the LM2664's -5 V (40 mA: h3, h7 and h9 draw about 30).<br><br>
<b>Parts:</b> B5819W (C64885), SWPA4030S4R7MT (C57269), KT-0805G (C2297), NCD0805R1 (C84256), KT-0805Y (C2296), LM2664M6X/NOPB (C108573), MF-MSMF200-2 (C210837), TPS65131RGER (C87663), SMAJ5.0A (C78401), TYPE-C-31-M-12 (C165948).

</td></tr></table>

### h2  pulse amplifier, THS3491

<table><tr>
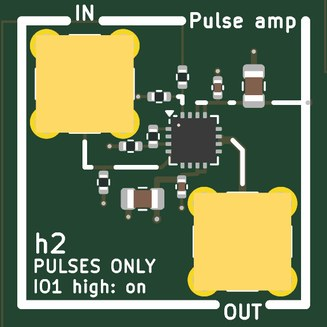
[picture p24: docs/images/tiles/phmod_h2.jpg]
h2 pulse amplifier, THS3491
<td valign="top" width="270"></td>
<td valign="top">

<b>A pulse amplifier: a DAC's +-1 V becomes +-10 V into 50 ohm (1 W), for NMR and ESR transmit pulses.  Pmod IO1 turns it on.</b><br><br>
<b>Jacks:</b> IN, top left (+-1 V); OUT, bottom right (+-10 V into 50 ohm).<br><br>
<b>Pmod:</b> IO1 (Pmod pin 1): h2's PD (high: the pulse amplifier on)<br><br>
<b>Supply:</b> +-15 V<br><br>
<b>Expect:</b> gain 10.3 to 30 MHz: a DAC's +-1 V to +-10 V into 50 ohm (1 W); off (PD low) unless Pmod IO1 is high<br><br>
<b>How to use it:</b> DAC 1 to IN; IO1 high only during the pulse; OUT to h3's TX IN (or a 50 ohm load).<br><br>
<b>You need:</b> A 2 W 50 ohm termination for tests (kit: TERM-2W-183S+). (<a href="KIT.md">KIT.md</a>)<br><br>
<b>Specs:</b> Gain 10.3, DC to 30 MHz (a 900 MHz part); +-10 V into 50 ohm; IO1 high: on.<br><br>
<b>Limits:</b> Pulses only: keep the duty cycle under 10 % (1 W continuous overheats it); never into an open or a short for long.<br><br>
<b>Experiments:</b> NMR and ESR excitation pulses; a 1 W HF source for antenna and coil experiments.<br><br>
<b>Chip:</b> <a href="https://www.ti.com/product/THS3491">THS3491</a><br><br>
<b>The circuit:</b> TI THS3491, current feedback, 900 MHz and 420 mA from +-15 V.  698 ohm from the FB pin (the output, inside) to -IN and 75 ohm to ground set gain 10.3.  The 49.9 ohm input termination makes the DAC's +-1 V into 50 ohm the full +-10 V output. PD from Pmod IO1 (4.7 k, 10 k to ground): high = on.  Pulse it: 1 W continuous heats the 3 x 3 mm package past its limit.<br><br>
<b>Parts:</b> THS3491IRGTR (C2058688).

</td></tr></table>

### h3  duplexer and preamp, OPA847

<table><tr>
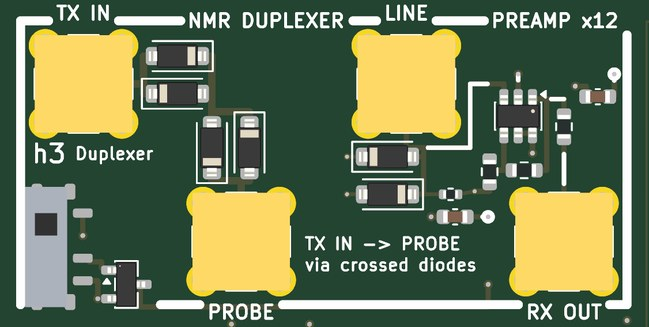
[picture p25: docs/images/tiles/phmod_h3.jpg]
h3 duplexer and preamp, OPA847
<td valign="top" width="528"></td>
<td valign="top">

<b>The pulsed-NMR duplexer and preamplifier: the transmitter reaches the probe through crossed diodes, and the echo, through a quarter-wave cable, reaches a x12 low-noise amplifier.</b><br><br>
<b>Jacks:</b> TX IN, top left (+-15 V); PROBE, bottom of the left cell; LINE, top of the right cell; RX OUT, bottom right.<br><br>
<b>Supply:</b> +5 V<br><br>
<b>Expect:</b> TX IN passes to PROBE through 1.4 V of diodes; the echo at LINE gains 12 (OPA847, 0.85 nV/rtHz) to RX OUT, about 200 MHz wide; LINE is clamped to +-0.7 V and terminated in 50 ohm<br><br>
<b>How to use it:</b> h2's OUT to TX IN; PROBE to the NMR probe; a quarter-wave cable from a tee at the probe back to LINE; RX OUT to ADC 1.<br><br>
<b>You need:</b> An NMR probe (a coil and trimmer capacitors: kit's magnet wire and BFC280811229 trimmers), a quarter-wave of coax and an SMA tee, a magnet (kit: N52 cubes for a Halbach ring). (<a href="KIT.md">KIT.md</a>)<br><br>
<b>Specs:</b> TX IN to PROBE through 1.4 V of diodes; LINE clamped to +-0.7 V and terminated in 50 ohm; RX OUT = x12 (0.85 nV/rtHz), about 200 MHz wide.<br><br>
<b>Limits:</b> Needs the quarter-wave cable cut for your frequency (2.6 m of RG-316 at 20 MHz); without it, a short cable and a 6 dB pad work at a few dB of loss.<br><br>
<b>Experiments:</b> The FID, spin echoes, CPMG, T1 by inversion recovery, T2; a one-dimensional image with h4 on a gradient coil.<br><br>
<b>Chip:</b> <a href="https://www.ti.com/product/OPA847">OPA847</a><br><br>
<b>The circuit:</b> The classic pulsed-NMR duplexer, broadband except for its one cable: crossed diodes in series with the transmitter, and a quarter wave of coax from PROBE to LINE (2.6 m of RG-316 at 20 MHz) whose far end the clamp diodes short during the pulse. Between pulses the diodes are off: the PA's noise does not reach the probe, the echo reaches the OPA847 (1.1 k / 100 ohm: x12, its minimum stable gain).  Without the cable, a short one and a 6 dB pad work at a few dB of loss.<br><br>
<b>Parts:</b> 1N4148W (C81598), OPA847IDBVT (C2059024).

</td></tr></table>

### h4  coil driver, DRV8876

<table><tr>
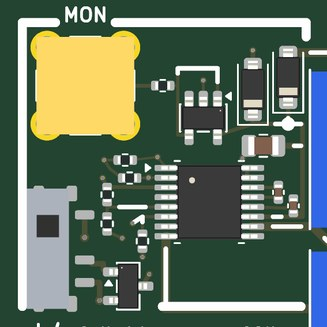
[picture p26: docs/images/tiles/phmod_h4.jpg]
h4 coil driver, DRV8876
<td valign="top" width="270"></td>
<td valign="top">

<b>A coil driver (H-bridge): up to about 1.3 A either way into a coil, PWM from Pmod IO6, direction from IO7, current measured on MON.</b><br><br>
<b>Jacks:</b> MON, top left (IPROPI).<br><br>
<b>Pmod:</b> IO6 (Pmod pin 8): h4's EN (high: the bridge on; PWM it); IO7 (Pmod pin 9): h4's PH (the current's direction)<br><br>
<b>Supply:</b> +5 V or 12-18 V<br><br>
<b>Expect:</b> about 1.3 A either way into a coil, PWM on IO6; MON about 1.5 V per amp<br><br>
<b>How to use it:</b> The coil in the lower terminal; optionally 12-18 V in the upper; PWM on IO6 and the direction on IO7; MON to an ADC.<br><br>
<b>You need:</b> The coil (kit's magnet wire); a 12 V supply for more current (kit: Adafruit 4880 and 368). (<a href="KIT.md">KIT.md</a>)<br><br>
<b>Specs:</b> About 1.3 A (cycle-by-cycle limit); MON about 1.5 V per amp; VM from USB (4.6 V) or 12-18 V on the upper terminal; the coil on the lower terminal.<br><br>
<b>Limits:</b> Keep the outside supply at 18 V or less (the 25 V capacitor); USB's 4.6 V is just above the DRV8876's minimum.<br><br>
<b>Experiments:</b> Gradient coils for imaging, a Helmholtz sweep for ESR, the Earth's-field NMR polarizing pulse, magnetic field mapping.<br><br>
<b>Chip:</b> <a href="https://www.ti.com/product/DRV8876">DRV8876</a>, <a href="https://www.ti.com/product/OPA810">OPA810</a><br><br>
<b>The circuit:</b> DRV8876 in PH/EN mode: IO6 enables (PWM), IO7 the direction; VM = USB or 12-18 V (two B5819W); IPROPI buffered to MON.<br><br>
<b>Parts:</b> B5819W (C64885), DRV8876PWPR (C575551), OPA810IDBVR (C2833513).

</td></tr></table>

### h5  HF receiver, 2 x LMH6629

<table><tr>
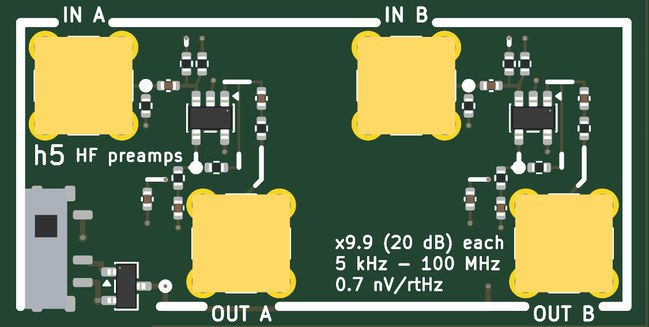
[picture p27: docs/images/tiles/phmod_h5.jpg]
h5 HF receiver, 2 x LMH6629
<td valign="top" width="528"></td>
<td valign="top">

<b>A two-channel HF preamplifier: x9.9 (20 dB) on each channel with 0.7 nV/rtHz input noise, 50 ohm in and out.</b><br><br>
<b>Jacks:</b> IN A, top left (-10 dBm); OUT A, bottom of the left cell; IN B, top of the right cell (-10 dBm); OUT B, bottom right.<br><br>
<b>Supply:</b> +5 V<br><br>
<b>Expect:</b> gain 9.9 (20 dB) on each channel, 50 ohm in and out, about 5 kHz to 100 MHz; 0.7 nV/rtHz at the input (NF about 2.5 dB)<br><br>
<b>How to use it:</b> Two antennas to IN A and IN B; OUT A and OUT B through low-pass filters to the two ADCs.<br><br>
<b>You need:</b> HF antennas (kit: HAON MLA-30 active loop) and 30 MHz low-pass filters (kit: SLP-30+). (<a href="KIT.md">KIT.md</a>)<br><br>
<b>Specs:</b> x9.9 each; about 5 kHz to 100 MHz; NF about 2.5 dB; inputs up to about -10 dBm.<br><br>
<b>Limits:</b> Wideband: strong broadcast stations and anything above the ADC's Nyquist fold in unless you filter (the kit's 30 MHz low-pass).<br><br>
<b>Experiments:</b> WWV's carrier Doppler (the ionosphere), the phase between two antennas (direction finding), FT8 and WSPR decoded in software.<br><br>
<b>Chip:</b> <a href="https://www.ti.com/product/LMH6629">LMH6629</a><br><br>
<b>The circuit:</b> Two TI LMH6629 (0.69 nV/rtHz, 4 GHz at gain 10) on one 5 V: 49.9 ohm terminates each input, 1 uF couples it to +IN at half the supply, 240 / 27 ohm (the 27 ohm to ground through 1 uF) set the gain, 1 uF and 49.9 ohm feed the output jack.  Two antennas into IN A and IN B and the host's two ADCs: a coherent two-channel HF receiver (WWV Doppler, direction finding).<br><br>
<b>Parts:</b> LMH6629MFX/NOPB (C2059678).

</td></tr></table>

### h6  VLF loop amplifier, OPA810 x101

<table><tr>
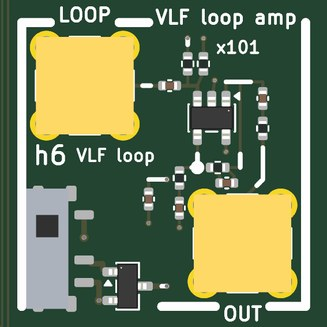
[picture p28: docs/images/tiles/phmod_h6.jpg]
h6 VLF loop amplifier, OPA810 x101
<td valign="top" width="270"></td>
<td valign="top">

<b>A VLF loop amplifier: x101 from 1.6 to 160 kHz for a loop antenna.</b><br><br>
<b>Jacks:</b> LOOP, top left (mV); OUT, bottom right.<br><br>
<b>Supply:</b> +5 V<br><br>
<b>Expect:</b> gain 101 from 1.6 kHz to 160 kHz (the loop's EMF rises with frequency on top): sferics, the Navy's MSK stations near 24 kHz, WWVB at 60 kHz<br><br>
<b>How to use it:</b> The loop to LOOP; OUT to an ADC.<br><br>
<b>You need:</b> A loop antenna: about 10 turns of wire on a 1 m square frame, or the kit's 60 kHz ferrite rod. (<a href="KIT.md">KIT.md</a>)<br><br>
<b>Specs:</b> Gain 101; 1.6-160 kHz.<br><br>
<b>Limits:</b> Mains hum and its harmonics: work outdoors, away from wiring; the loop sets the sensitivity.<br><br>
<b>Experiments:</b> Sferics from lightning thousands of kilometres away; the Navy's MSK stations near 24 kHz and their phase at sunrise; WWVB's 60 kHz time code; solar-flare ionospheric disturbances.<br><br>
<b>Chip:</b> <a href="https://www.ti.com/product/OPA810">OPA810</a><br><br>
<b>The circuit:</b> A loop's EMF is N A dB/dt: a 1 m square of 10 turns gives about 1 uV for 1 pT at 20 kHz.  1 uF into an OPA810 at half the supply (100 k / 100 k), gain 101 (10 k / 100 ohm to ground through 1 uF), 100 pF across 10 k: 1.6 - 160 kHz.  Sferics (lightning, thousands of kilometres away), NAA's 24 kHz MSK, WWVB's 60 kHz time code.  Two loops at right angles (this and h5's IN A, or two boards) give a lightning stroke's bearing from the ratio of the two signals.<br><br>
<b>Parts:</b> OPA810IDBVR (C2833513).

</td></tr></table>

### h7  reflection bridge, 2 x OPA810

<table><tr>
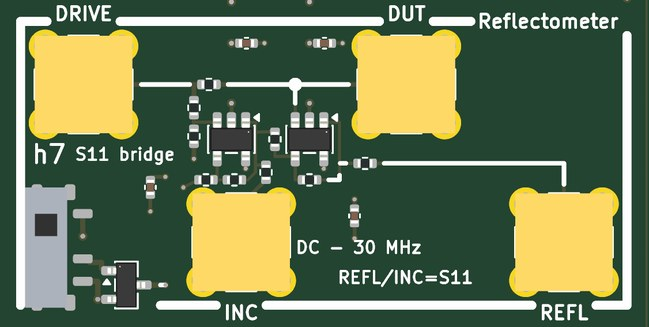
[picture p29: docs/images/tiles/phmod_h7.jpg]
h7 reflection bridge, 2 x OPA810
<td valign="top" width="528"></td>
<td valign="top">

<b>A reflection bridge: REFL / INC is the reflection coefficient (S11) of whatever is on the DUT jack, magnitude and phase, DC to 30 MHz.</b><br><br>
<b>Jacks:</b> DRIVE, top left (+-1 V into 50 ohm); INC, bottom of the left cell; DUT, top of the right cell; REFL, bottom right.<br><br>
<b>Supply:</b> +-5 V<br><br>
<b>Expect:</b> REFL / INC = Gamma (S11) from DC to about 30 MHz: 0 for 50 ohm, +1 open, -1 short; after open-short-load calibration, better than -35 dB<br><br>
<b>How to use it:</b> DAC 1 to DRIVE; INC to ADC 1, REFL to ADC 2; the device on DUT.<br><br>
<b>You need:</b> An SMA open, short and 50 ohm load for calibration (kit: ANNE-50+ and a short). (<a href="KIT.md">KIT.md</a>)<br><br>
<b>Specs:</b> REFL / INC = Gamma: 0 for 50 ohm, +1 open, -1 short; better than -35 dB after open-short-load calibration.<br><br>
<b>Limits:</b> DC to about 30 MHz; calibrate at each frequency (three complex numbers).<br><br>
<b>Experiments:</b> Impedance and the Smith chart; matching an NMR probe or an antenna; a crystal's motional arm; a cable's length by time-domain reflectometry; ESR as a dip in a loop's S11.<br><br>
<b>Chip:</b> <a href="https://www.ti.com/product/OPA810">OPA810</a><br><br>
<b>The circuit:</b> A 50 ohm resistive bridge: D from DRIVE, 49.9 ohm to A (the DUT jack) and 49.9 + 49.9 ohm from D to ground with B between. A - B = B x Gamma.  OPA810 U1 at gain 2 on B gives INC; U2, +IN on A and 499 / 499 ohm from U1's output, gives 2 A - 2 B, REFL; each leaves through 49.9 ohm, so into the host's 50 ohm inputs REFL / INC = Gamma, magnitude and phase.  Calibrate with an open, a short and a 50 ohm load on DUT (three complex numbers per frequency), then match an NMR probe or an antenna.<br><br>
<b>Parts:</b> OPA810IDBVR (C2833513).

</td></tr></table>

### h8  coupled resonators, 2 x LC + BB133

<table><tr>
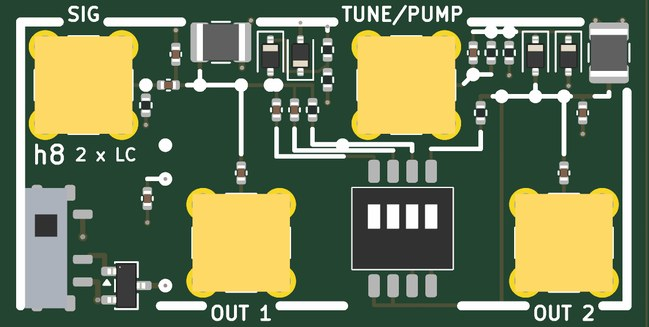
[picture p30: docs/images/tiles/phmod_h8.jpg]
h8 coupled resonators, 2 x LC + BB133
<td valign="top" width="528"></td>
<td valign="top">

<b>Two coupled 10 MHz LC resonators with varactor tuning: normal modes, the avoided crossing, an EIT analogue and parametric gain on one tile.</b><br><br>
<b>Jacks:</b> SIG, top left (+-1 V into 50 ohm); OUT 1, bottom of the left cell; TUNE/PUMP, top of the right cell (+-2 V open); OUT 2, bottom right.<br><br>
<b>Supply:</b> +5 V<br><br>
<b>Expect:</b> two 10 MHz tanks (Q about 30); coupled by 1, 2.2 or 3.2 pF they split by 0.4 - 1.2 MHz; TUNE moves tank 2 by +-5 %; a 20 MHz pump on it gives parametric gain<br><br>
<b>How to use it:</b> DAC 1 to SIG, DAC 2 to TUNE / PUMP (a slow ramp, a 20 MHz pump, or both); OUT 1 and OUT 2 to the ADCs; the DIP sets coupling and loss.<br><br>
<b>You need:</b> Nothing beyond SMA cables.<br><br>
<b>Specs:</b> Two tanks near 10 MHz, Q about 30; coupling 1, 2.2 or 3.2 pF (DIP) splits them by 0.4-1.2 MHz; TUNE moves tank 2 by +-5 %; a 20 MHz pump on TUNE / PUMP gives parametric gain.<br><br>
<b>Limits:</b> The ports couple through 2.2 pF: -43 dB into 50 ohm, so the ADCs see small signals.<br><br>
<b>Experiments:</b> Normal-mode splitting and the avoided crossing; a lossy tank coupled to a sharp one (EIT analogue); phase-sensitive parametric gain and oscillation.<br><br>
<b>Chip:</b> <a href="https://www.lcsc.com/product-detail/C5334579.html">BB133</a><br><br>
<b>The circuit:</b> Two LC tanks, 10 uH and about 25 pF each (fixed, two BB133 back to back at 2.5 V, the ports), near 10 MHz, Q about 30. SIG drives tank 1 through 2.2 pF; each tank feeds its OUT jack through 2.2 pF, -43 dB into the host's 50 ohm.  The DIP: 1 pF and 2.2 pF between the tanks (normal modes, the avoided crossing as TUNE sweeps tank 2), 2 k across tank 1 or tank 2 (a lossy tank coupled to a sharp one: the EIT analogue).  A pump at twice the frequency on TUNE / PUMP: parametric gain.<br><br>
<b>Parts:</b> BB133 (C5334579), DSHP04TSGET (C40736).

</td></tr></table>

### h9  noise source, MMBT3904 + LMH6629

<table><tr>
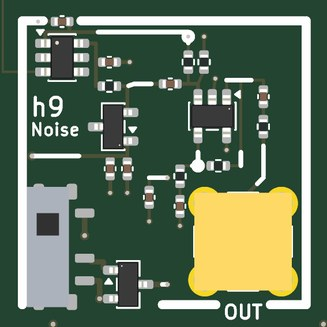
[picture p31: docs/images/tiles/phmod_h9.jpg]
h9 noise source, MMBT3904 + LMH6629
<td valign="top" width="270"></td>
<td valign="top">

<b>A switched noise source: avalanche noise from a transistor junction, amplified, from 10 kHz to 50 MHz.  Pmod IO8 turns it on.</b><br><br>
<b>Jacks:</b> OUT, bottom right.<br><br>
<b>Pmod:</b> IO8 (Pmod pin 10): h9's load switch (high: noise on)<br><br>
<b>Supply:</b> +5 V<br><br>
<b>Expect:</b> off: the amplifier's own noise (about 6 nV/rtHz at OUT); on: tens to hundreds of nV/rtHz from 10 kHz to 50 MHz, flat to about 1 dB<br><br>
<b>How to use it:</b> OUT to the amplifier or filter under test; toggle IO8.<br><br>
<b>You need:</b> Nothing beyond SMA cables.<br><br>
<b>Specs:</b> On: tens to hundreds of nV/rtHz, flat to about 1 dB; off: the amplifier's own 6 nV/rtHz.<br><br>
<b>Limits:</b> Its level must be calibrated for absolute noise figures.<br><br>
<b>Experiments:</b> Y-factor noise figure of h5 or h3's preamp; a transfer function from the cross-spectrum of a filter's input and output.<br><br>
<b>Chip:</b> <a href="https://www.ti.com/product/LMH6629">LMH6629</a>, <a href="https://www.ti.com/product/TPS22917">TPS22917</a><br><br>
<b>The circuit:</b> An MMBT3904's emitter-base junction breaks down near 8 V; between -5 V and the switched 5 V through 680 ohm it carries 2-3 mA and its avalanche noise, many times kT's, goes straight into an LMH6629 at gain 9.9 and out through 49.9 ohm.  IO8 high turns it on (a TPS22917 switches its 5 V): hot and cold for a Y-factor noise figure, or a broadband stimulus whose cross-spectrum against the response on the host's second ADC is a transfer function.<br><br>
<b>Parts:</b> LMH6629MFX/NOPB (C2059678), MMBT3904(RANGE:100-300) (C20526), TPS22917DBVR (C2681320).

</td></tr></table>

### h10  laser driver, current source + bias-T

<table><tr>
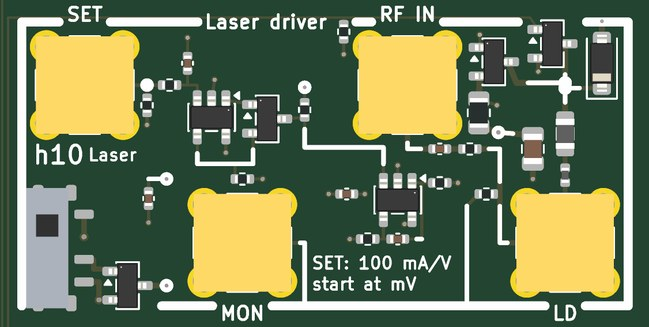
[picture p32: docs/images/tiles/phmod_h10.jpg]
h10 laser driver, current source + bias-T
<td valign="top" width="528"></td>
<td valign="top">

<b>A laser-diode driver: 0-100 mA set by a voltage, with an RF input (bias-T) to modulate the current at 20 MHz-3 GHz and a Pmod line to blank it.</b><br><br>
<b>Jacks:</b> SET, top left (0-1 V: 0-100 mA); MON, bottom of the left cell; RF IN, top of the right cell (+10 dBm max); LD, bottom right (100 mA max).<br><br>
<b>Pmod:</b> IO5 (Pmod pin 7): h10's shunt (high: the laser's current diverted)<br><br>
<b>Supply:</b> +5 V<br><br>
<b>Expect:</b> 0-100 mA from 0-1 V on SET, about 10 kHz of loop bandwidth; IO5 blanks it in about 1 us; RF from about 20 MHz to 3 GHz rides on the current<br><br>
<b>How to use it:</b> DAC 1 to SET (through 30 dB for a VCSEL); the laser on LD; RF IN from a synthesizer; MON to an ADC.<br><br>
<b>You need:</b> A laser diode or VCSEL (kit: Thorlabs L650P007, L795VH1) with a socket (S7060R) or soldered to an SMA plug; 10 and 20 dB SMA attenuators; laser goggles. (<a href="KIT.md">KIT.md</a>)<br><br>
<b>Specs:</b> 100 mA per volt on SET (0-1 V); about 10 kHz loop bandwidth; RF IN 20 MHz-3 GHz, +10 dBm max; IO5 high blanks it in about 1 us; MON = the diode's voltage / 200.<br><br>
<b>Limits:</b> No current limit beyond SET: a VCSEL (about 1.5 mA) needs 30 dB of attenuation on SET; start every laser at a few millivolts.<br><br>
<b>Experiments:</b> L-I-V curves and threshold; coherent population trapping in rubidium (3.417 GHz on a 795 nm VCSEL: an atomic clock); pulsed ODMR with IQ-MOD's q9.<br><br>
<b>Chip:</b> <a href="https://www.ti.com/product/OPA810">OPA810</a><br><br>
<b>The circuit:</b> A high-side current source: REF = VS - SET (OPA810 and a 2N7002 through 1 k / 1 k), OPA810 holds the AO3401's source at REF so 10 ohm carries SET / 10 ohm, 100 mA per volt (start a VCSEL at a few millivolts).  The drain feeds the diode through 330 nH + 27 nH; RF IN joins through 100 pF + 47 ohm: the modulation for a rubidium CPT clock (3.4 GHz) or NV ODMR.  IO5 high shorts the drain (the AO3400) for pulses.  MON = the diode's voltage / 200 into 50 ohm: with SET swept, its I-V curve.<br><br>
<b>Parts:</b> B5819W (C64885), AO3400A (C20917), 2N7002 (C8545), OPA810IDBVR (C2833513).

</td></tr></table>

## Ground, loops and probing

Two ground loops stand in the margins; every tile's loops are on the signal they name.  The RH-5019
loops take a scope's grabber.  The SMA jacks are 50 ohm; where an input is not 50 ohm the jack's silk says so.
