gallicchio/AMOD-and-RFMOD/docs/images/amod_a-bottom.png

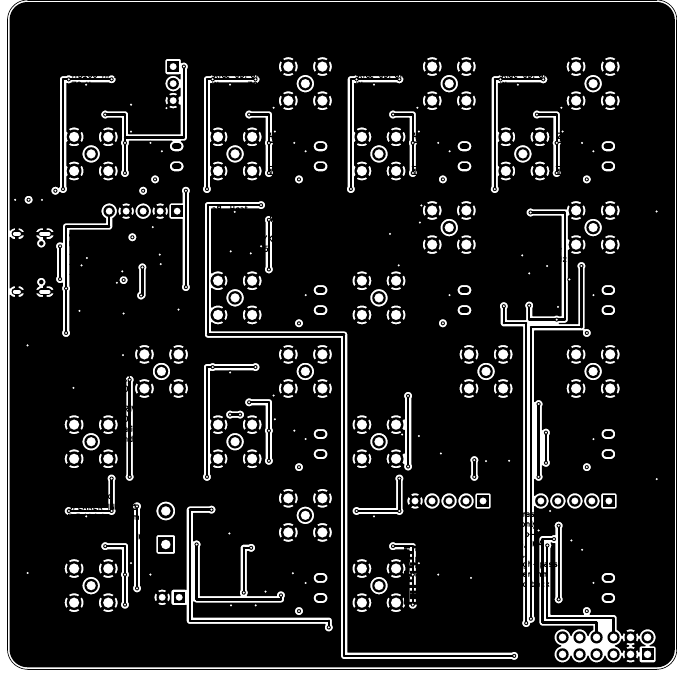
docs/images/amod_a-bottom.png
