gallicchio/AMOD-and-RFMOD/docs/images/amod_a-in1-ground.png

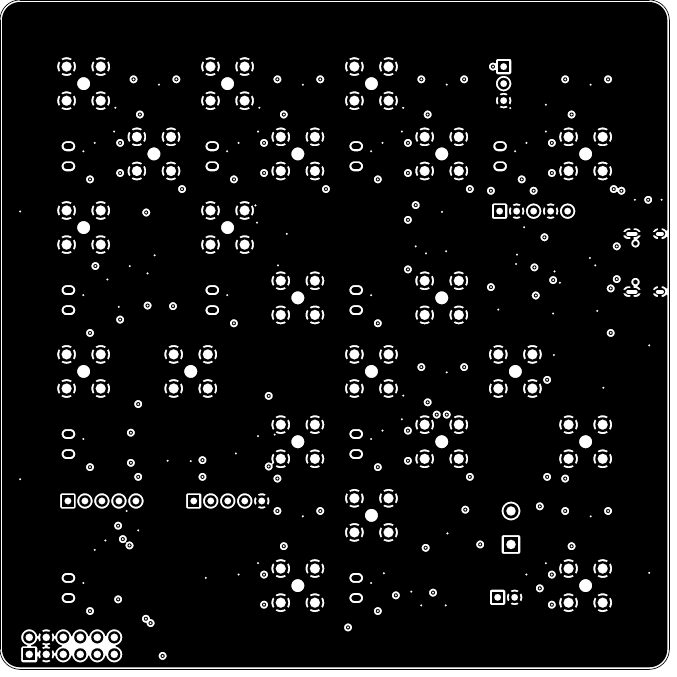
docs/images/amod_a-in1-ground.png
