gallicchio/AMOD-and-RFMOD/docs/images/amod_a-in2-power.png

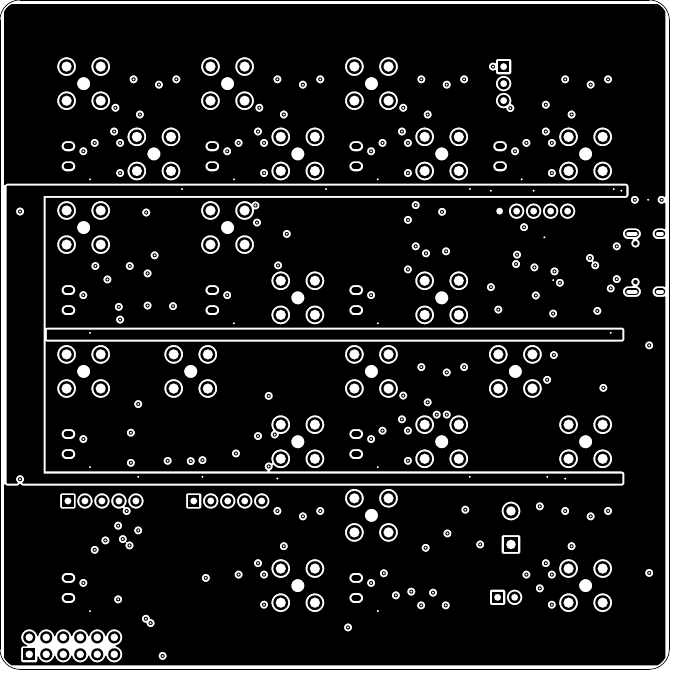
docs/images/amod_a-in2-power.png
