gallicchio/AMOD-and-RFMOD/docs/images/amod_a-render-bottom.png

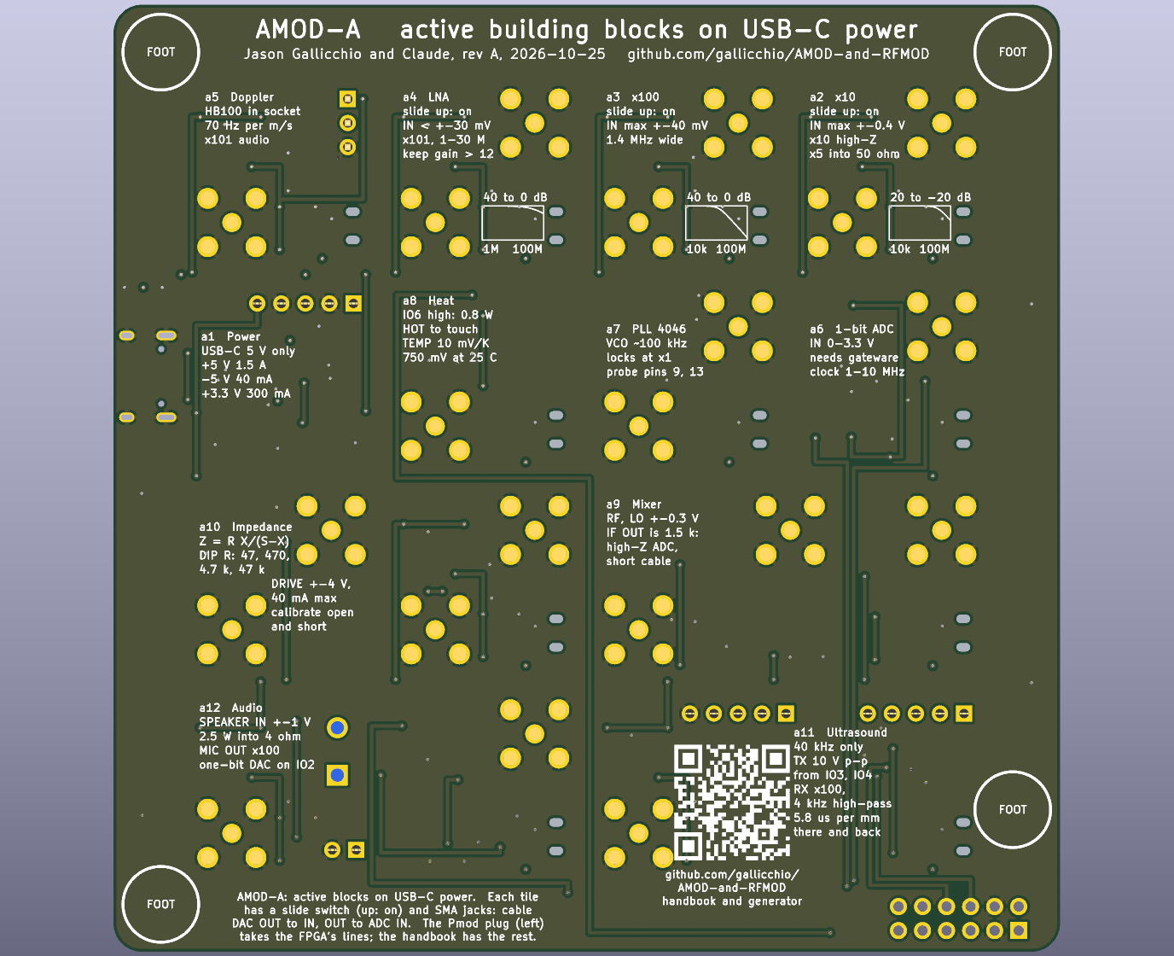
docs/images/amod_a-render-bottom.png
