gallicchio/AMOD-and-RFMOD/docs/images/amod_a-render-iso.png

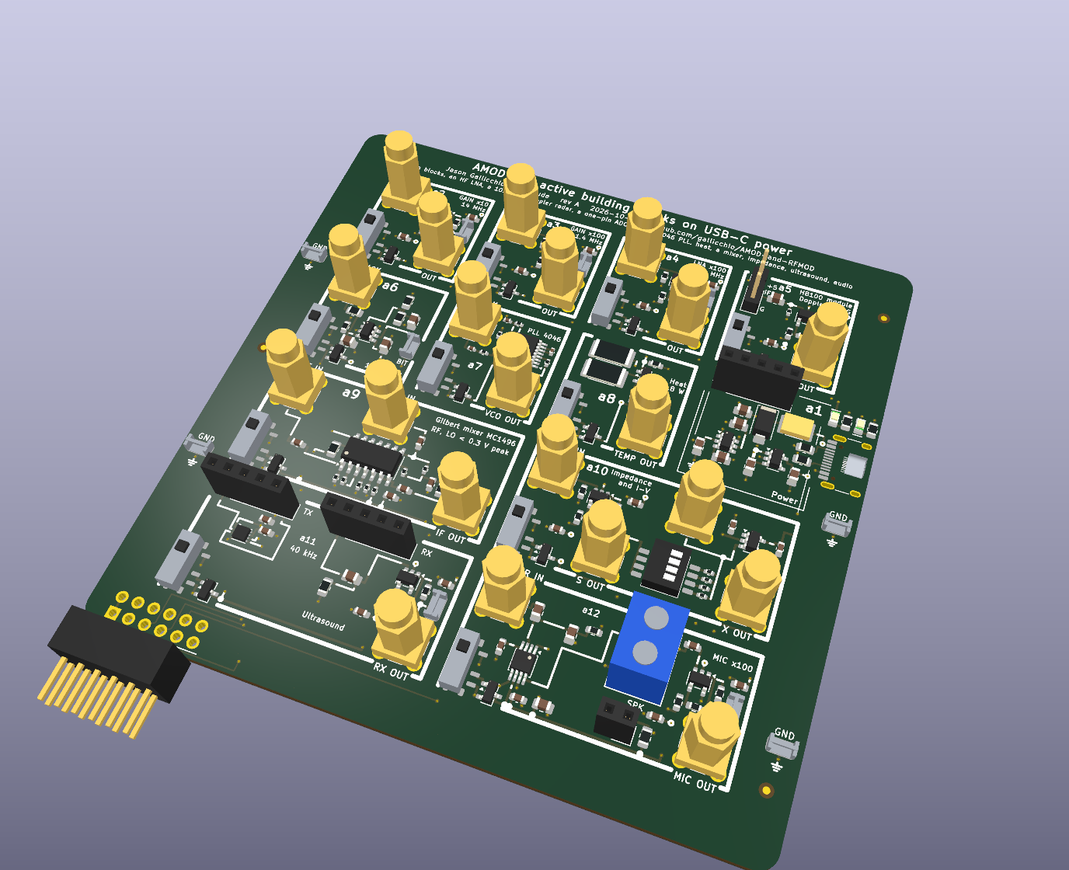
docs/images/amod_a-render-iso.png
