gallicchio/AMOD-and-RFMOD/docs/images/amod_a-schematic.png

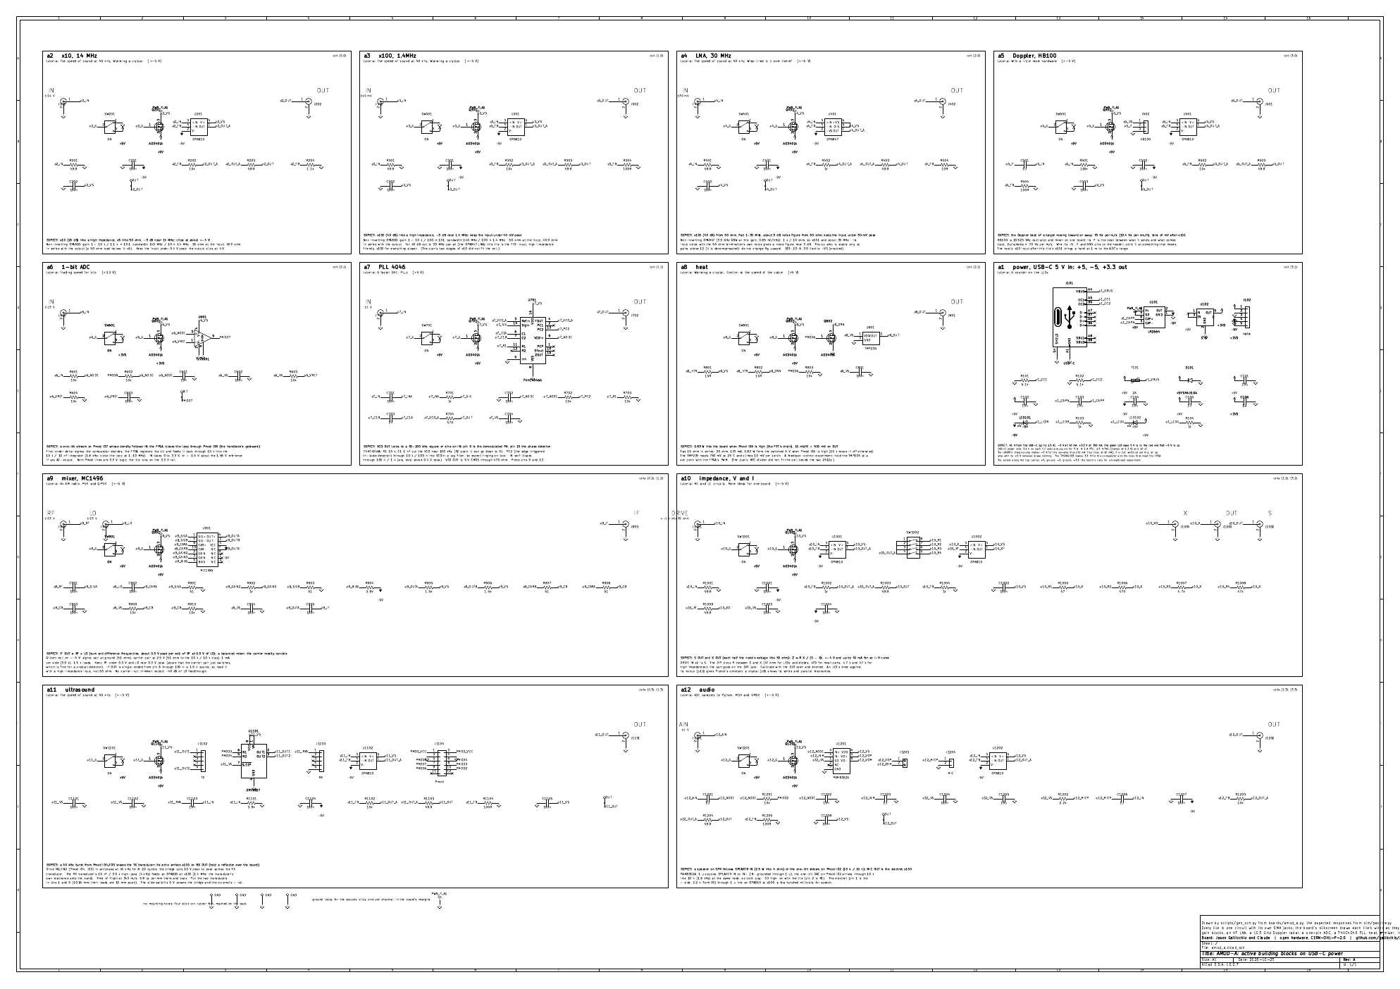
docs/images/amod_a-schematic.png
