gallicchio/AMOD-and-RFMOD/docs/images/amod_a-silk-bottom.png

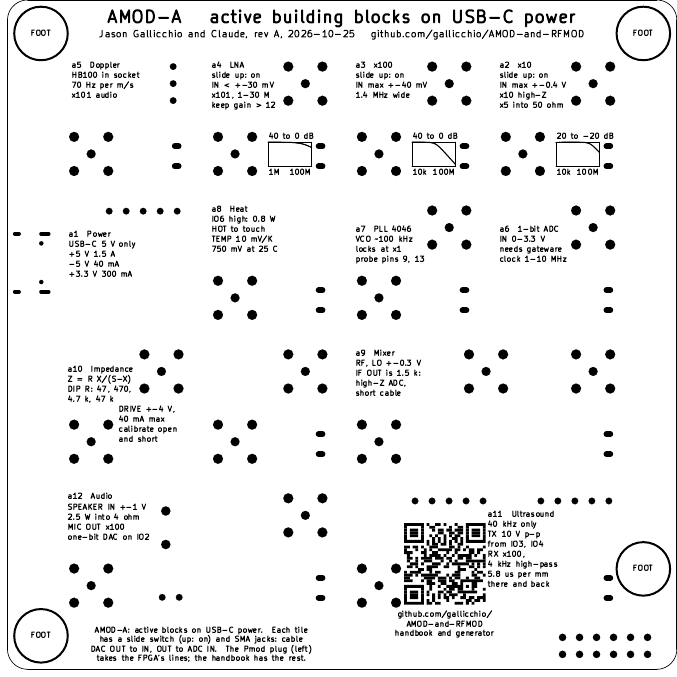
docs/images/amod_a-silk-bottom.png
