gallicchio/AMOD-and-RFMOD/docs/images/amod_a-silk-top.png

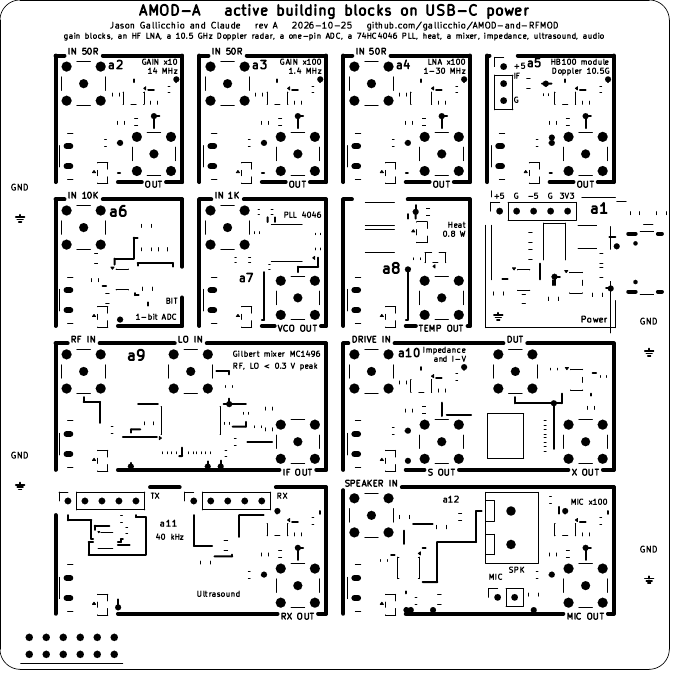
docs/images/amod_a-silk-top.png
