gallicchio/AMOD-and-RFMOD/docs/images/amod_a-top.png

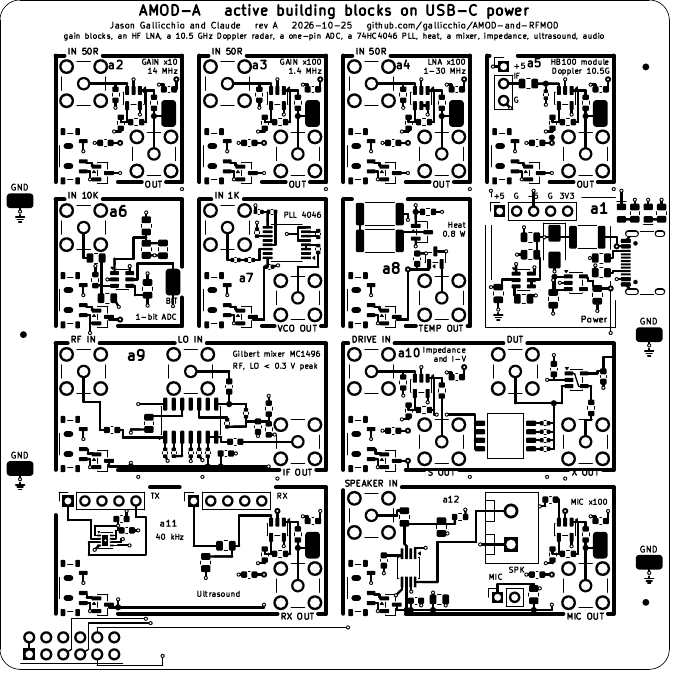
docs/images/amod_a-top.png
