gallicchio/AMOD-and-RFMOD/docs/images/amod_b-bottom.png

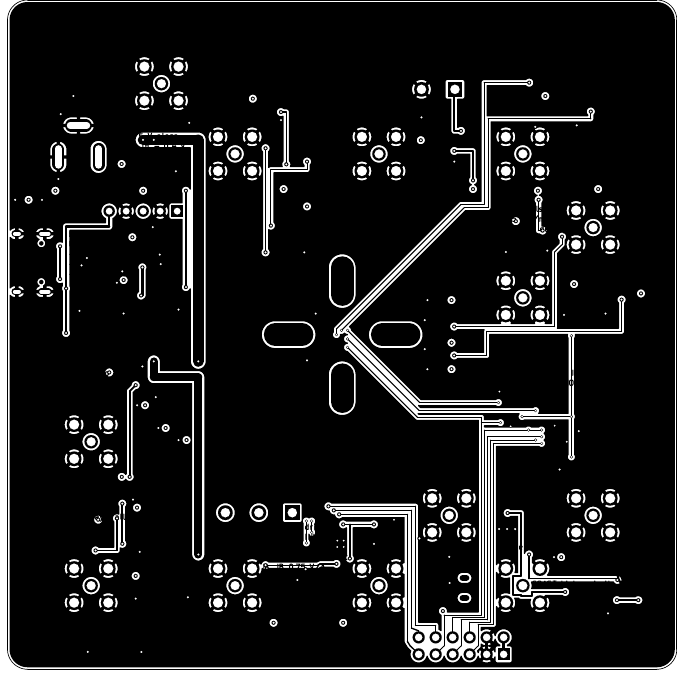
docs/images/amod_b-bottom.png
