gallicchio/AMOD-and-RFMOD/docs/images/amod_b-in1-ground.png

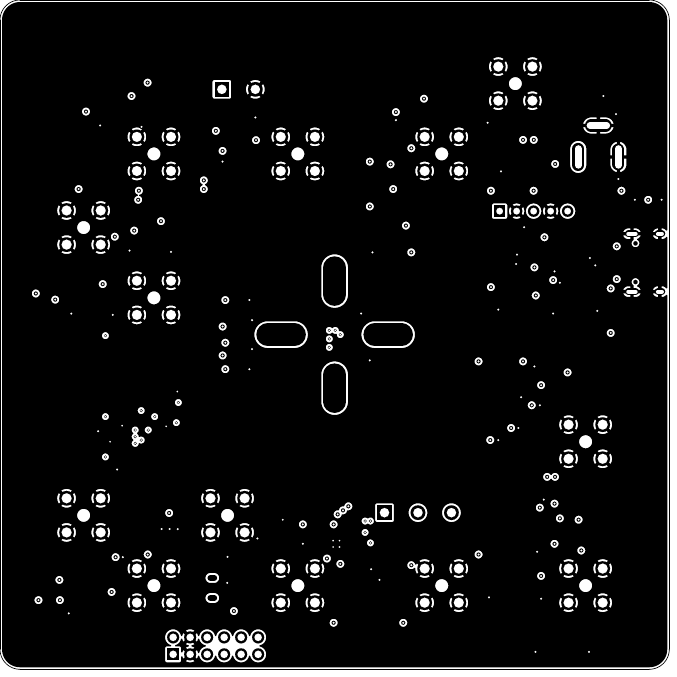
docs/images/amod_b-in1-ground.png
