gallicchio/AMOD-and-RFMOD/docs/images/amod_b-in2-power.png

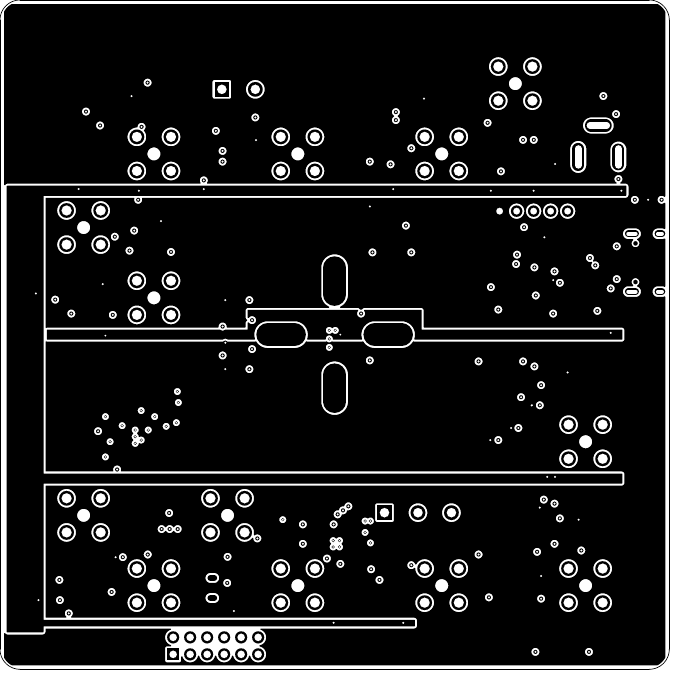
docs/images/amod_b-in2-power.png
