gallicchio/AMOD-and-RFMOD/docs/images/amod_b-render-bottom.png

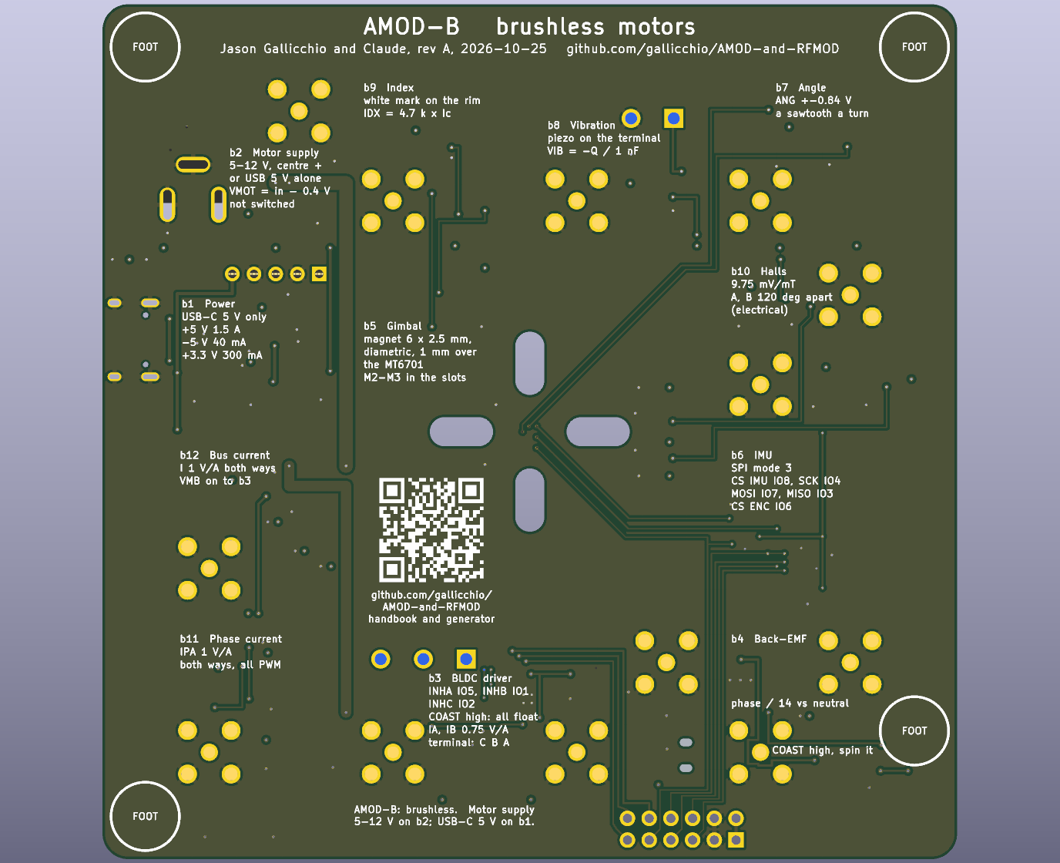
docs/images/amod_b-render-bottom.png
