gallicchio/AMOD-and-RFMOD/docs/images/amod_b-render-iso.png

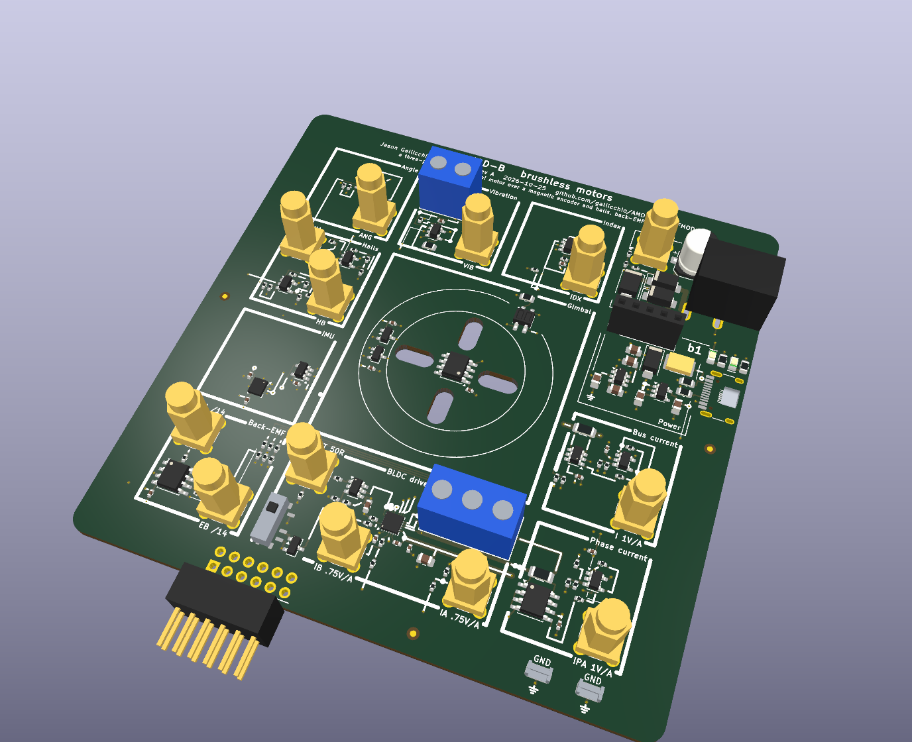
docs/images/amod_b-render-iso.png
