gallicchio/AMOD-and-RFMOD/docs/images/amod_b-schematic.png

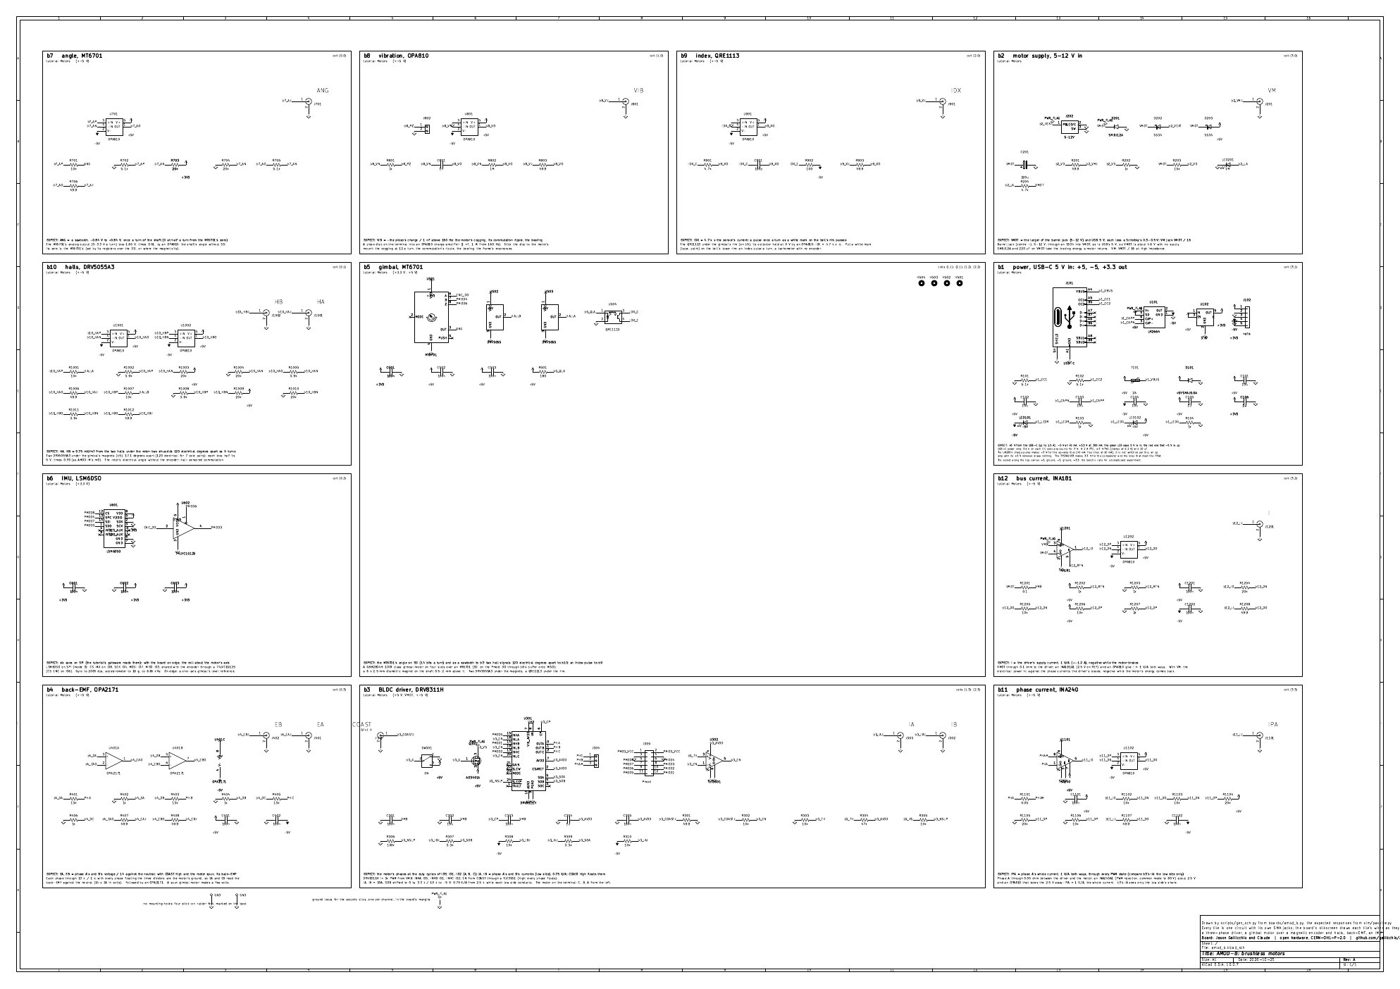
docs/images/amod_b-schematic.png
