gallicchio/AMOD-and-RFMOD/docs/images/amod_b-silk-bottom.png

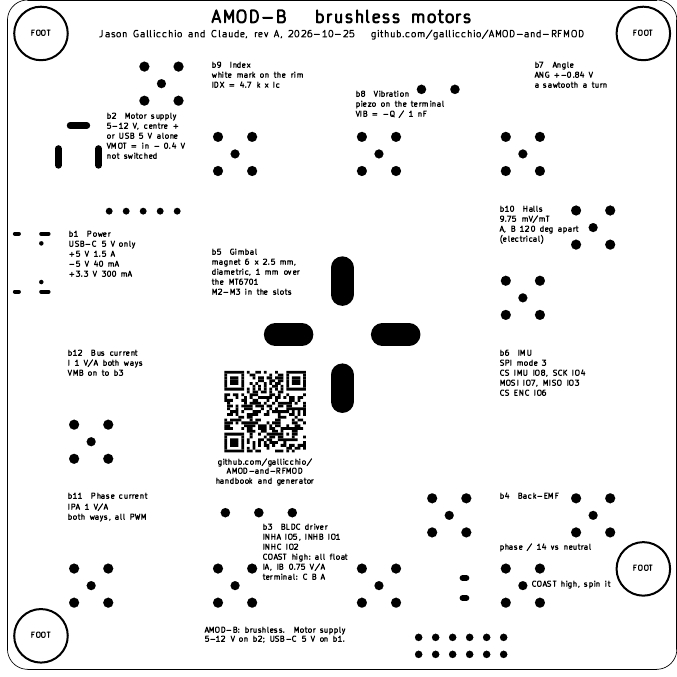
docs/images/amod_b-silk-bottom.png
