gallicchio/AMOD-and-RFMOD/docs/images/amod_b-silk-top.png

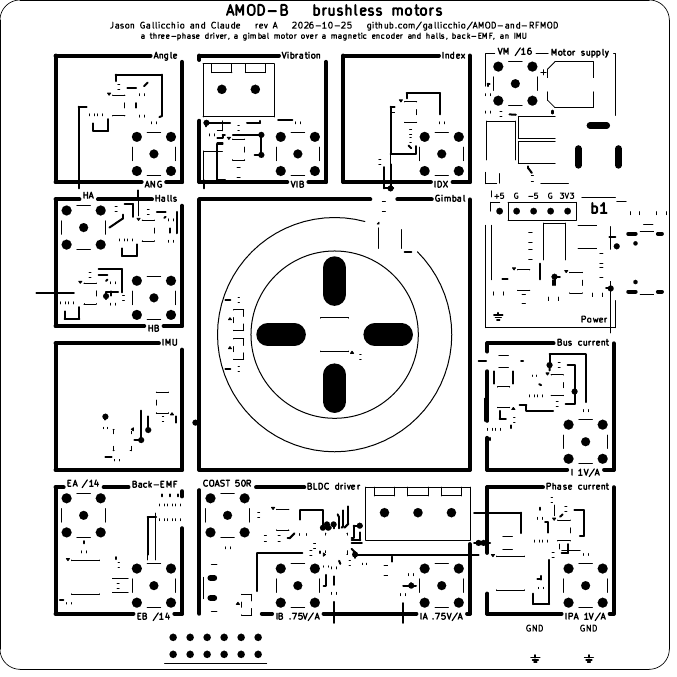
docs/images/amod_b-silk-top.png
