gallicchio/AMOD-and-RFMOD/docs/images/amod_b-top.png

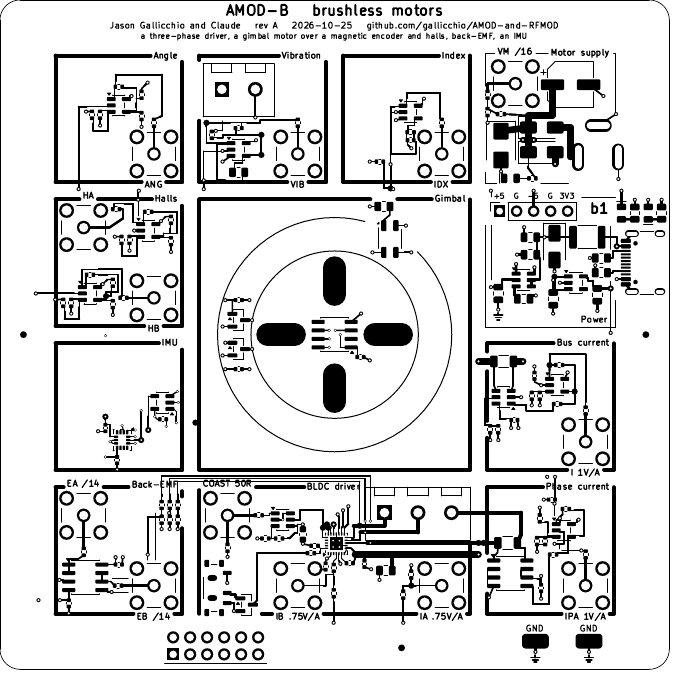
docs/images/amod_b-top.png
