gallicchio/AMOD-and-RFMOD/docs/images/amod_c-bottom.png

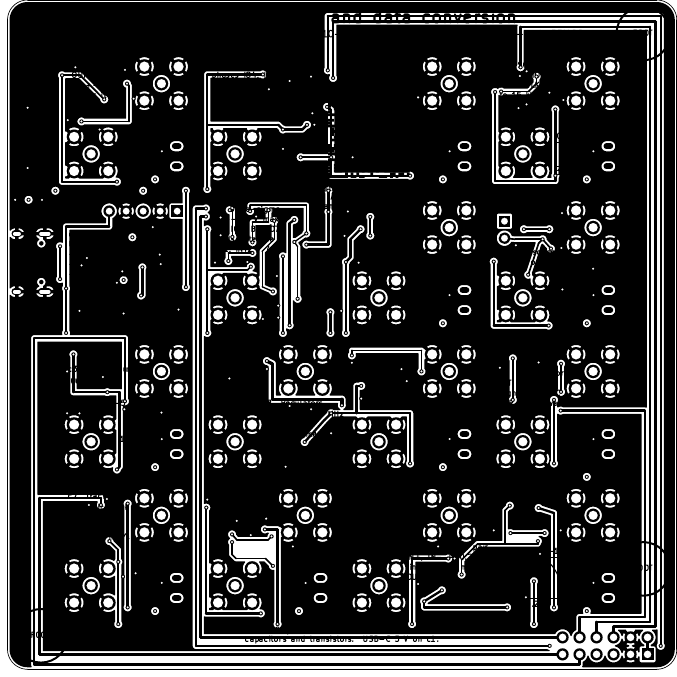
docs/images/amod_c-bottom.png
