gallicchio/AMOD-and-RFMOD/docs/images/amod_c-in1-ground.png

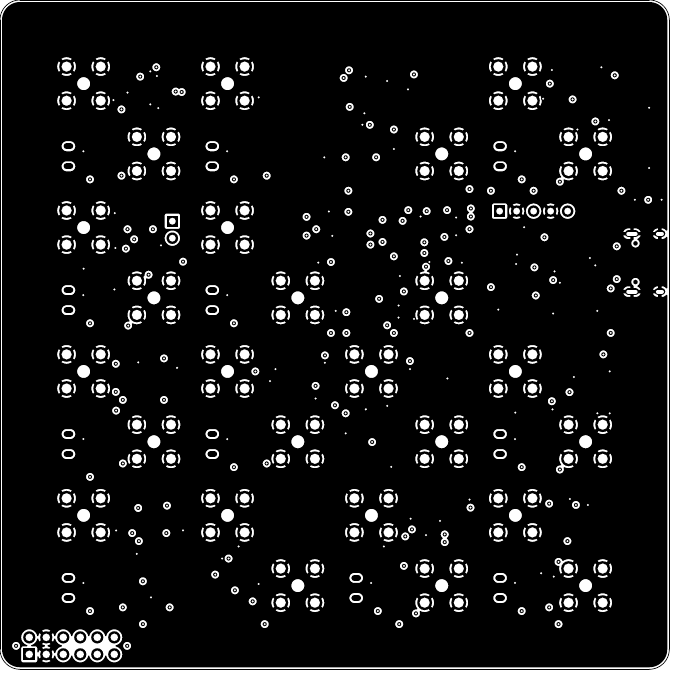
docs/images/amod_c-in1-ground.png
