gallicchio/AMOD-and-RFMOD/docs/images/amod_c-in2-power.png

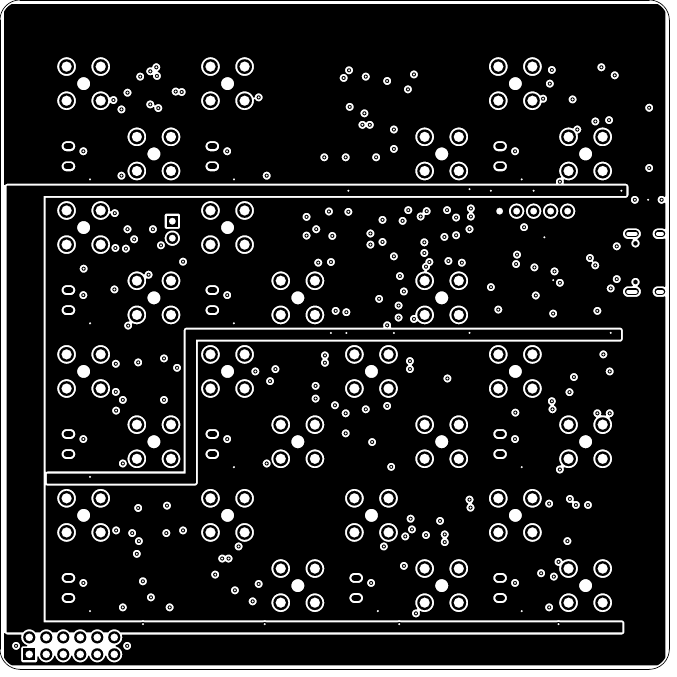
docs/images/amod_c-in2-power.png
