gallicchio/AMOD-and-RFMOD/docs/images/amod_c-render-bottom.png

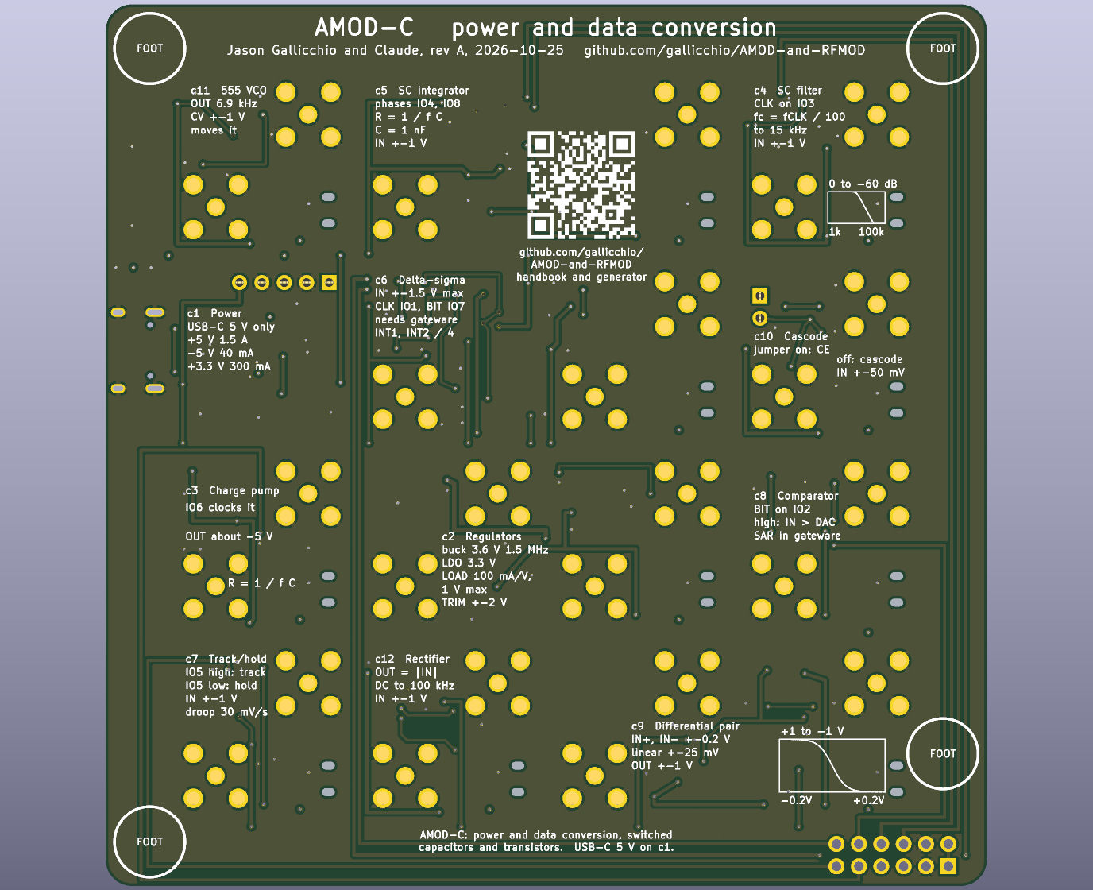
docs/images/amod_c-render-bottom.png
