gallicchio/AMOD-and-RFMOD/docs/images/amod_c-render-iso.png

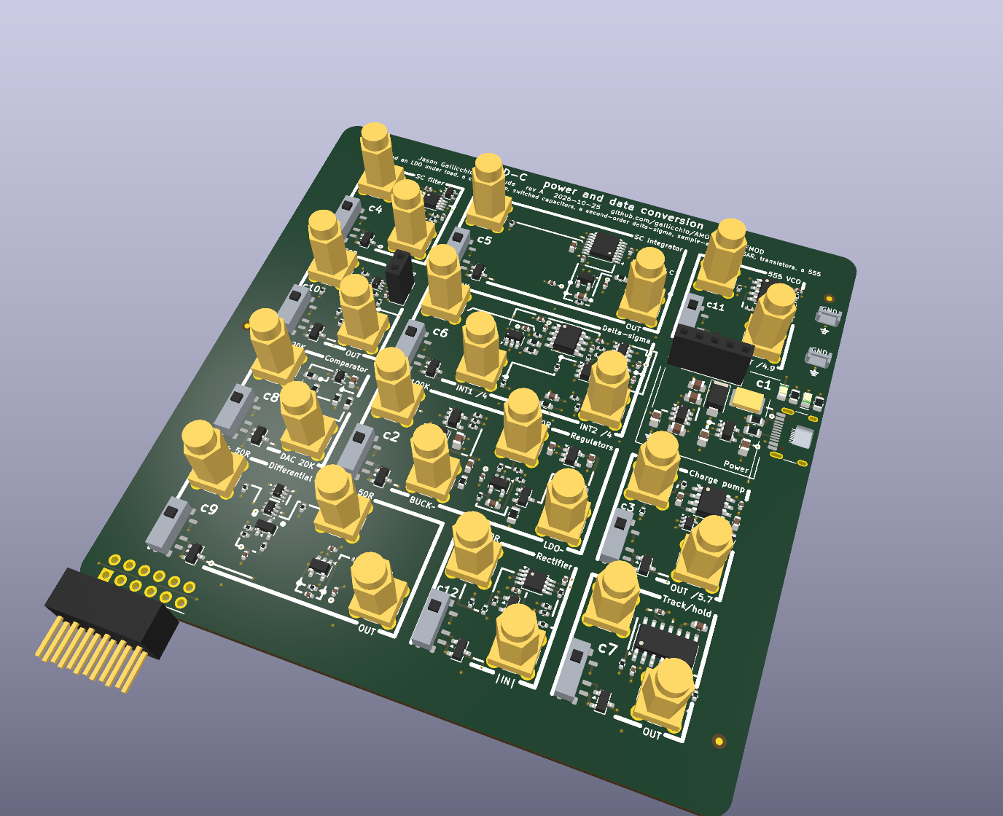
docs/images/amod_c-render-iso.png
