gallicchio/AMOD-and-RFMOD/docs/images/amod_c-schematic.png

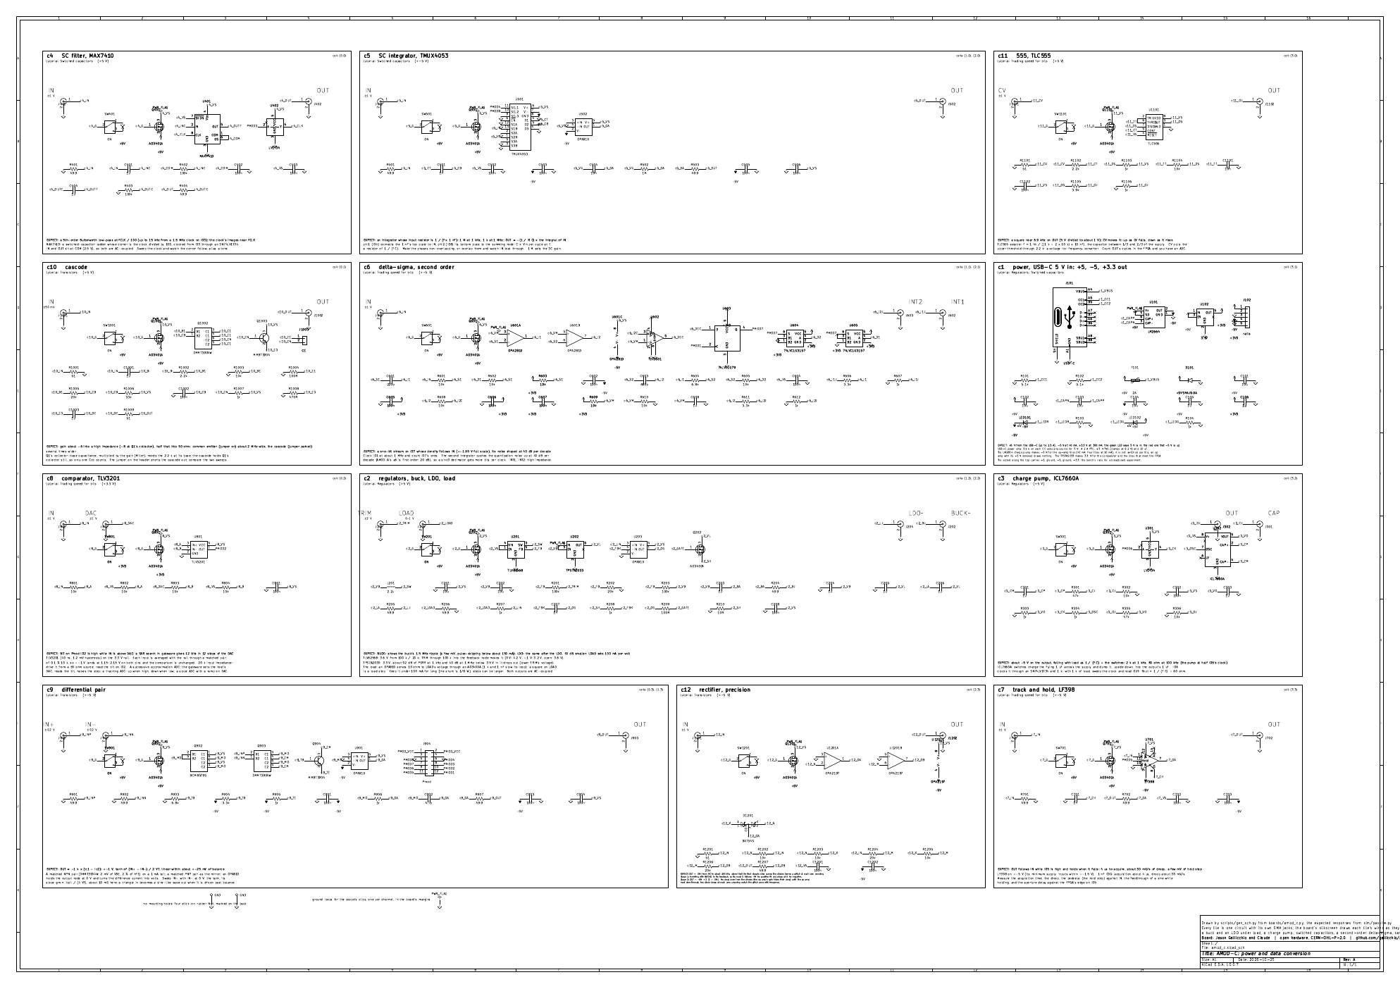
docs/images/amod_c-schematic.png
