gallicchio/AMOD-and-RFMOD/docs/images/amod_c-silk-bottom.png

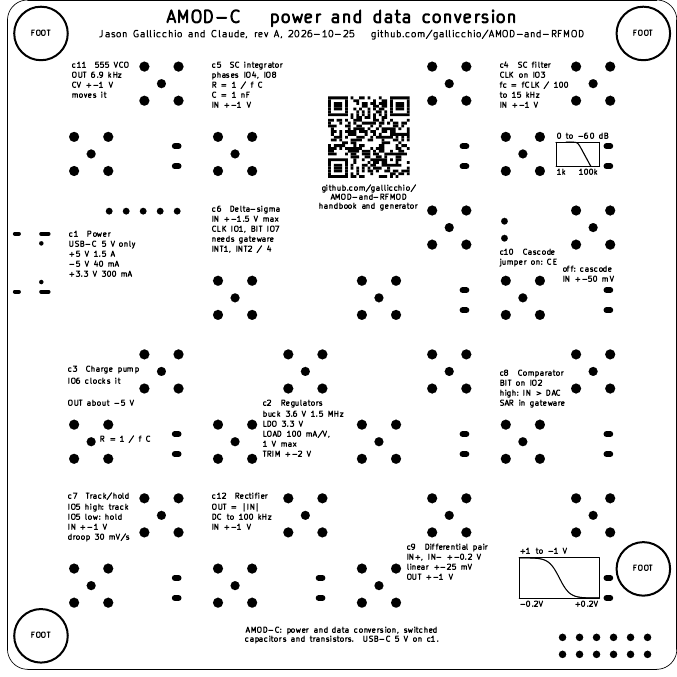
docs/images/amod_c-silk-bottom.png
