gallicchio/AMOD-and-RFMOD/docs/images/amod_c-silk-top.png

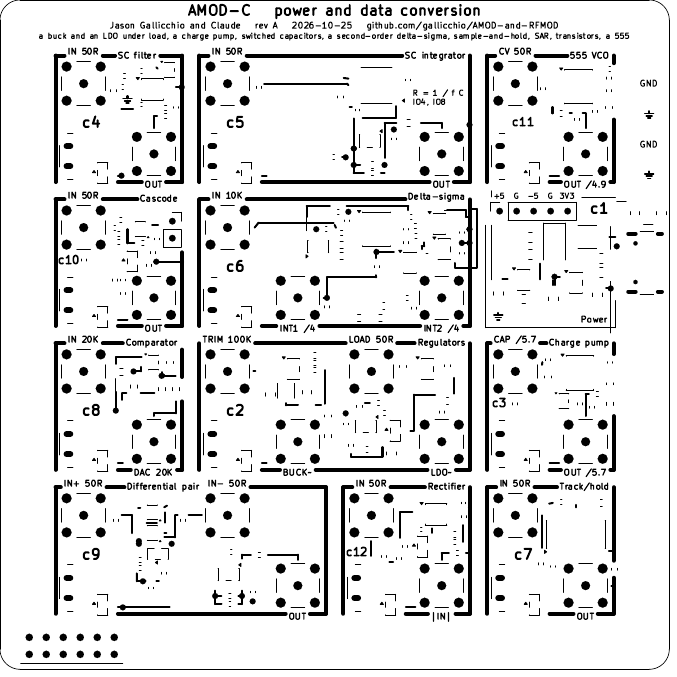
docs/images/amod_c-silk-top.png
