gallicchio/AMOD-and-RFMOD/docs/images/amod_c-top.png

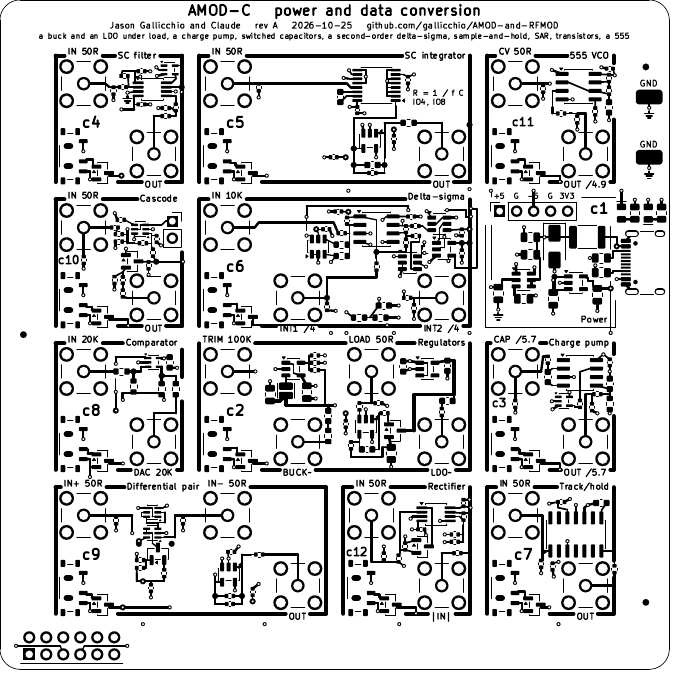
docs/images/amod_c-top.png
