gallicchio/AMOD-and-RFMOD/docs/images/amod_m-bottom.png

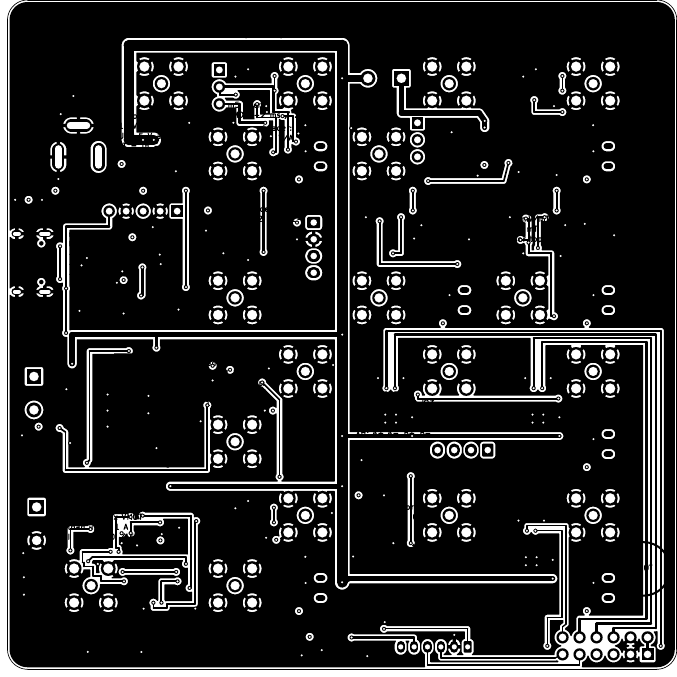
docs/images/amod_m-bottom.png
