gallicchio/AMOD-and-RFMOD/docs/images/amod_m-in1-ground.png

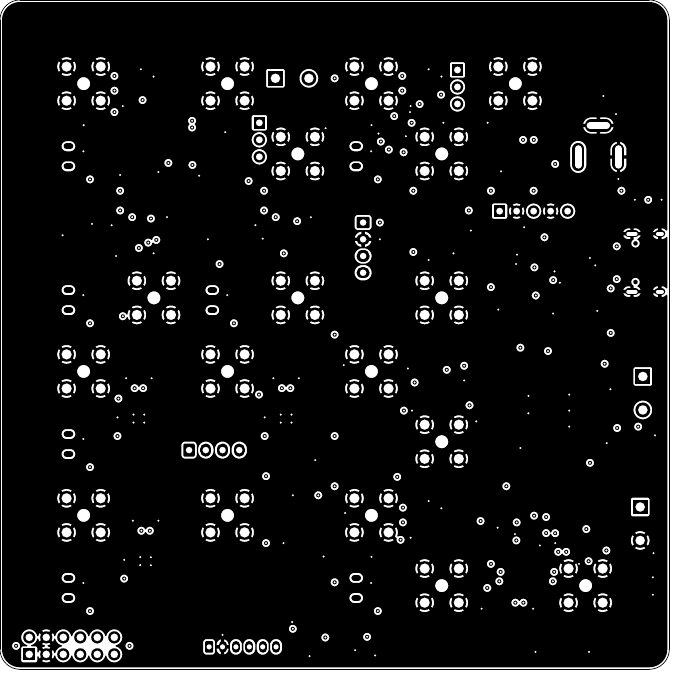
docs/images/amod_m-in1-ground.png
