gallicchio/AMOD-and-RFMOD/docs/images/amod_m-in2-power.png

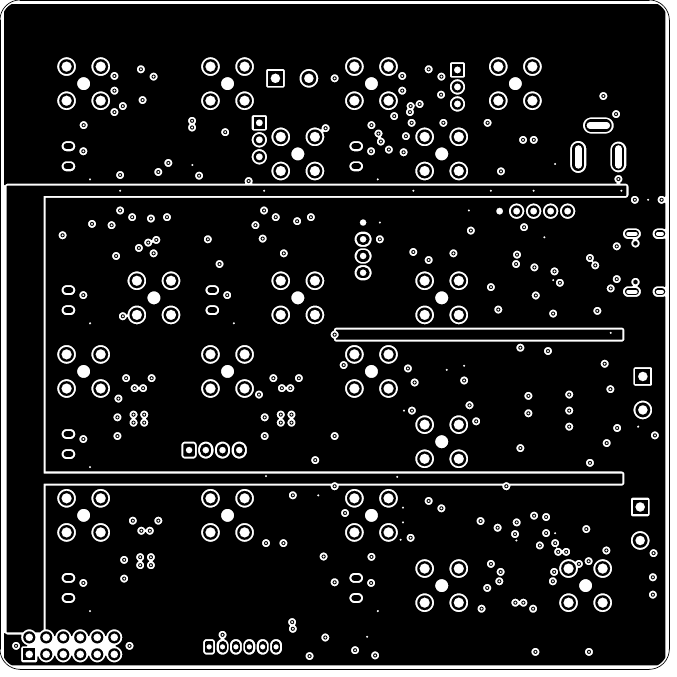
docs/images/amod_m-in2-power.png
