gallicchio/AMOD-and-RFMOD/docs/images/amod_m-render-bottom.png

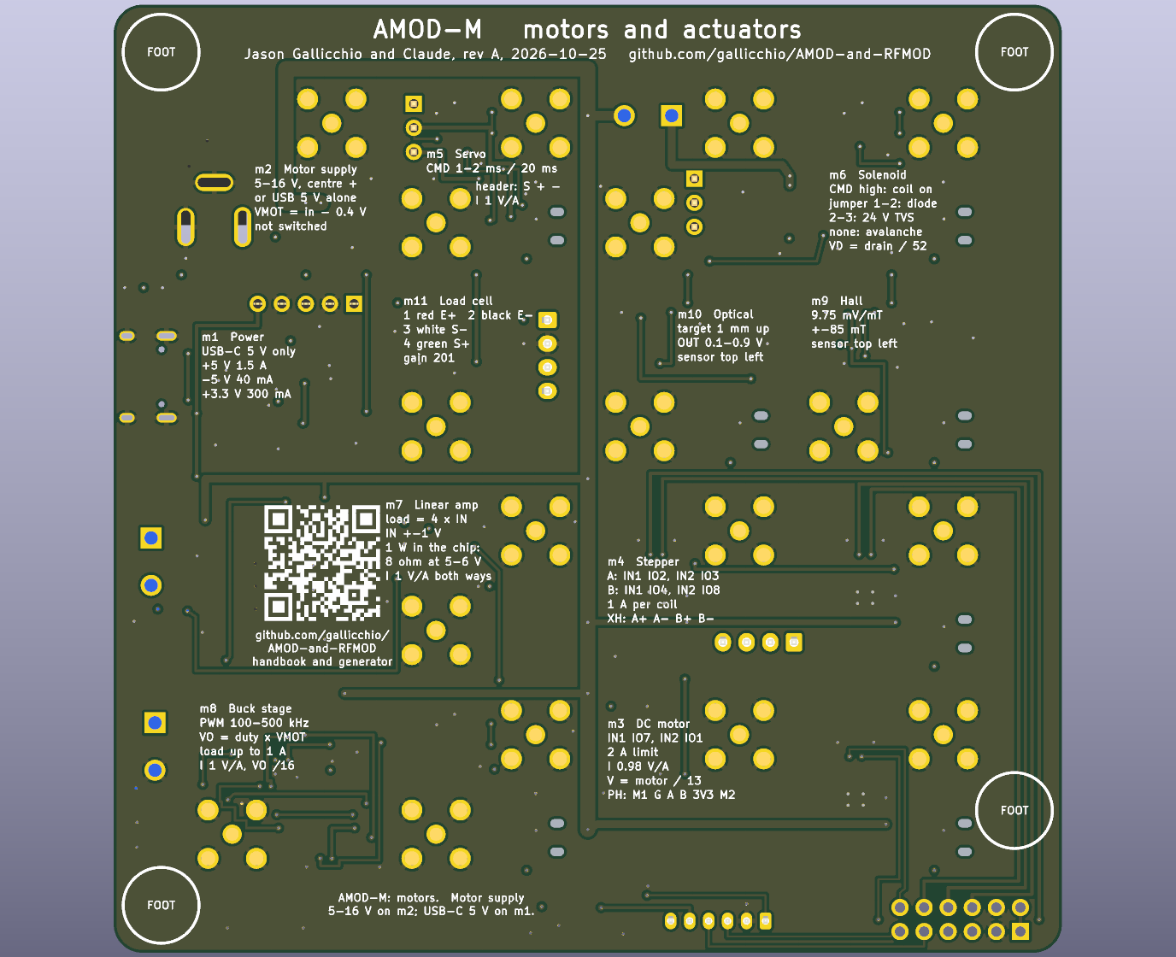
docs/images/amod_m-render-bottom.png
