gallicchio/AMOD-and-RFMOD/docs/images/amod_m-render-iso.png

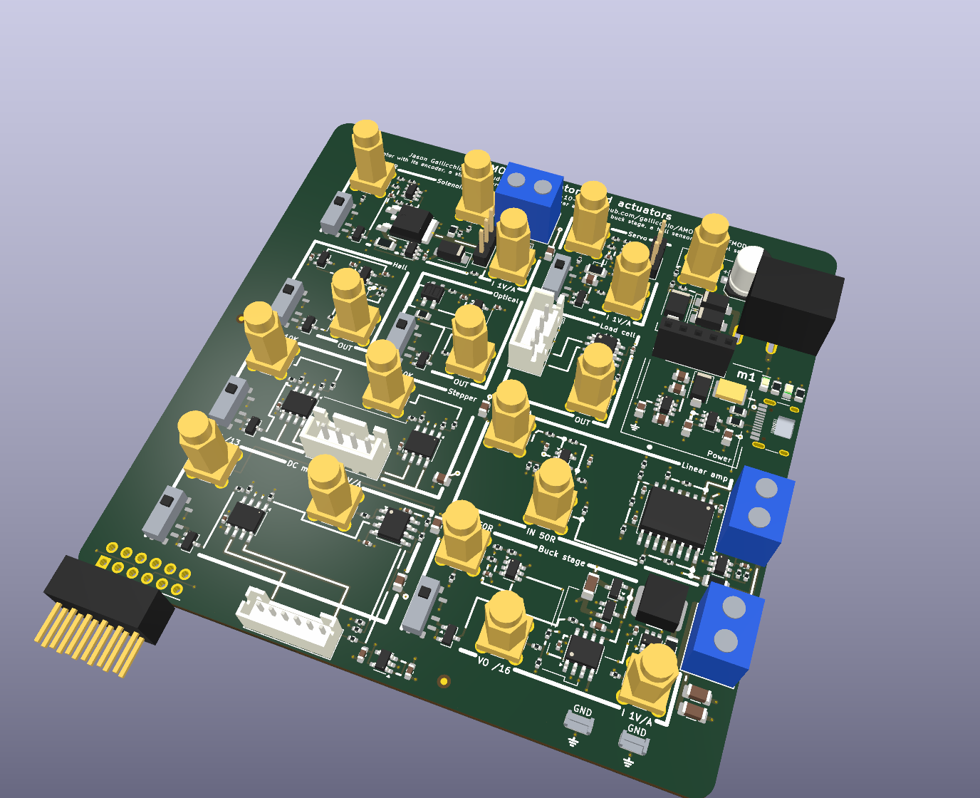
docs/images/amod_m-render-iso.png
