gallicchio/AMOD-and-RFMOD/docs/images/amod_m-schematic.png

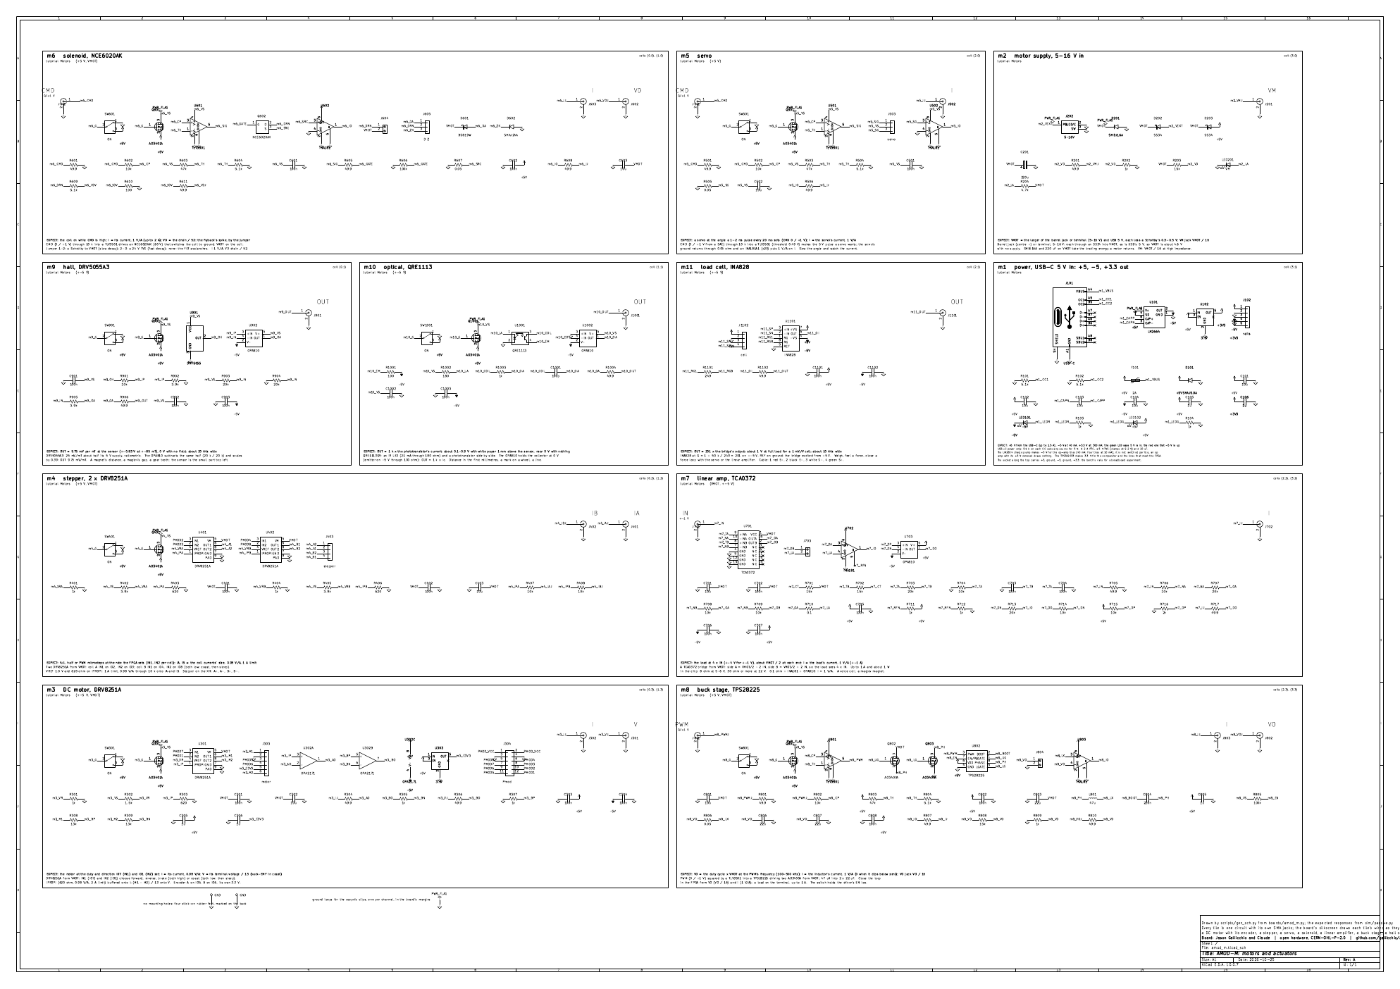
docs/images/amod_m-schematic.png
