gallicchio/AMOD-and-RFMOD/docs/images/amod_m-silk-bottom.png

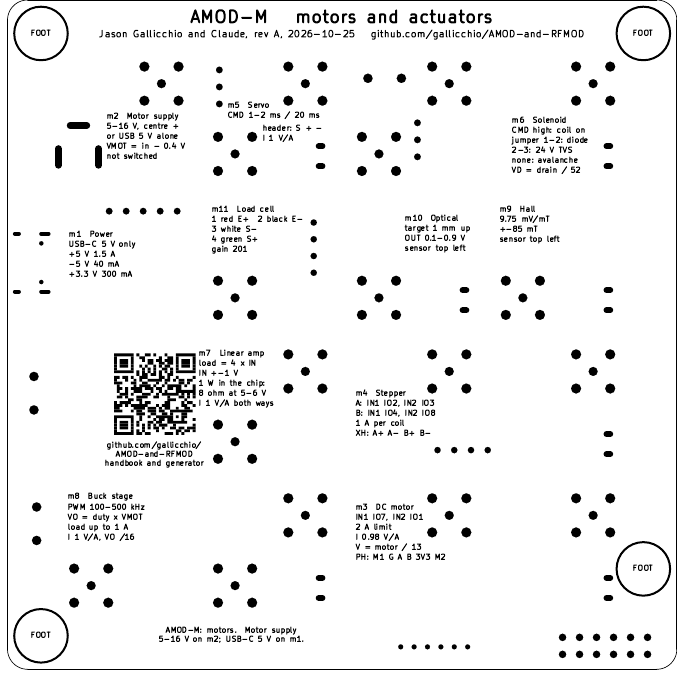
docs/images/amod_m-silk-bottom.png
