gallicchio/AMOD-and-RFMOD/docs/images/amod_m-silk-top.png

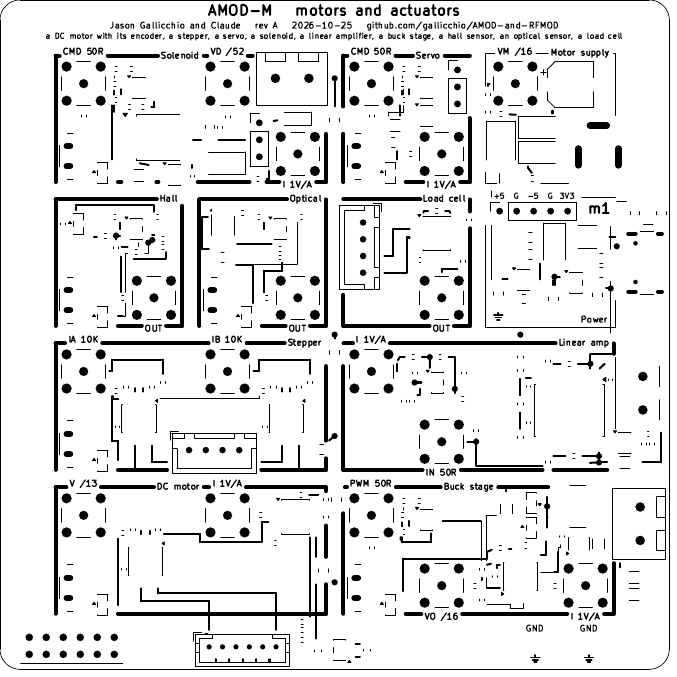
docs/images/amod_m-silk-top.png
