gallicchio/AMOD-and-RFMOD/docs/images/amod_m-top.png

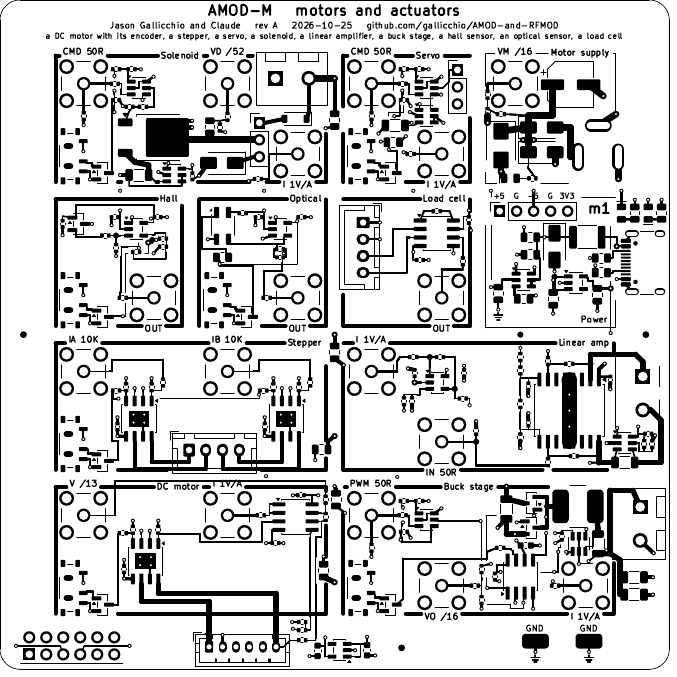
docs/images/amod_m-top.png
