gallicchio/AMOD-and-RFMOD/docs/images/amod_n-bottom.png

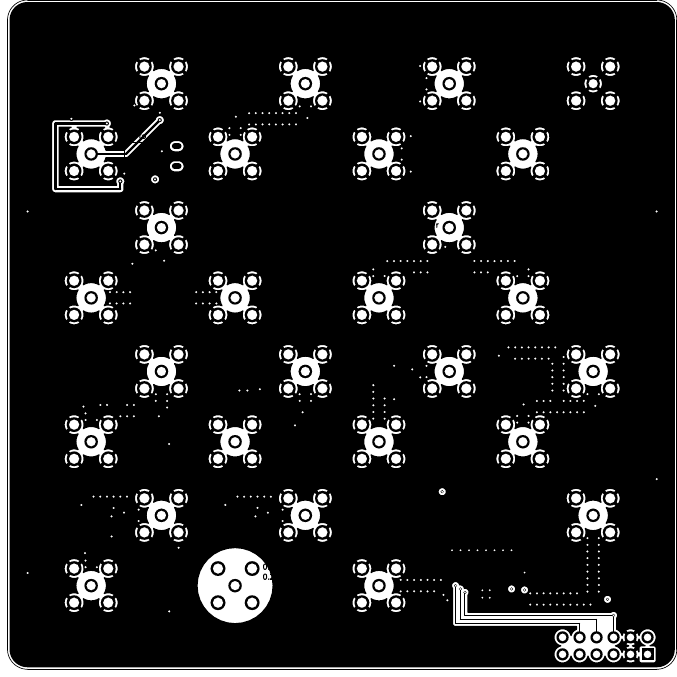
docs/images/amod_n-bottom.png
