gallicchio/AMOD-and-RFMOD/docs/images/amod_n-in1-ground.png

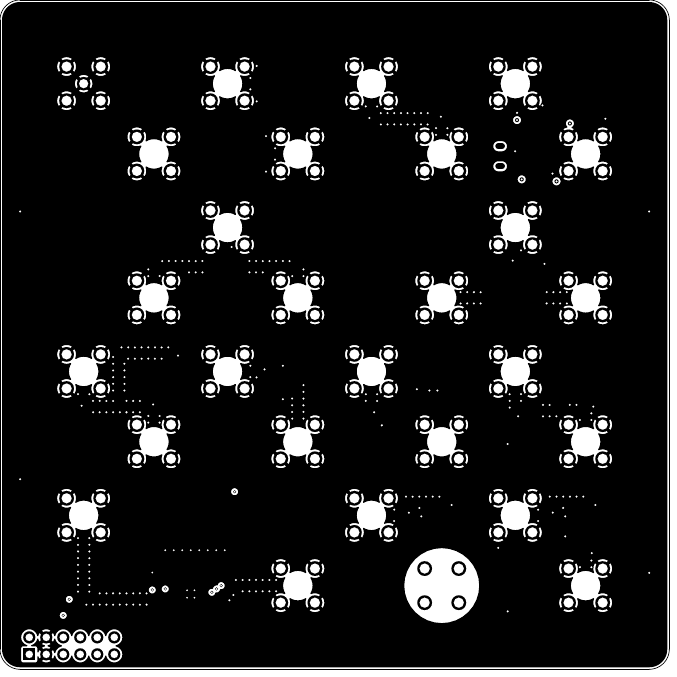
docs/images/amod_n-in1-ground.png
