gallicchio/AMOD-and-RFMOD/docs/images/amod_n-in2-power.png

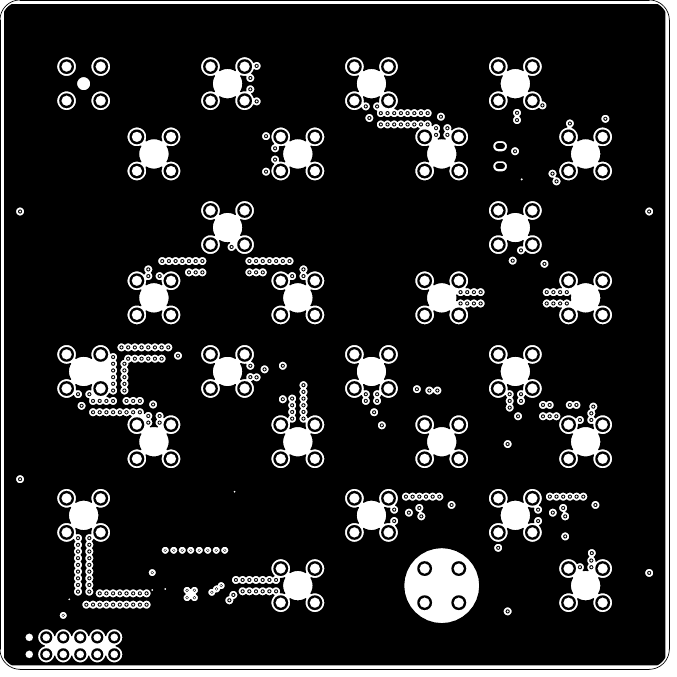
docs/images/amod_n-in2-power.png
