gallicchio/AMOD-and-RFMOD/docs/images/amod_n-render-bottom.png

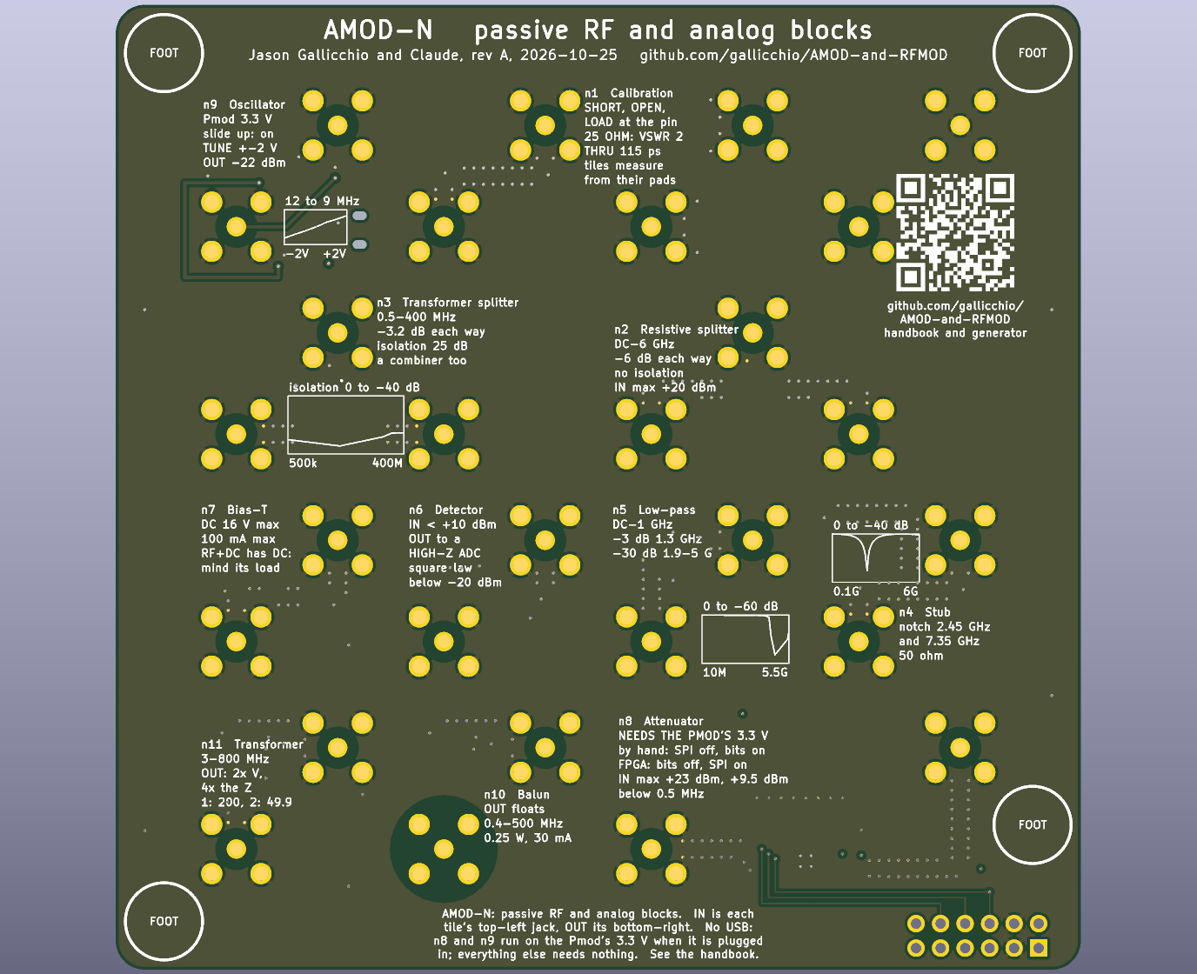
docs/images/amod_n-render-bottom.png
