gallicchio/AMOD-and-RFMOD/docs/images/amod_n-render-iso.png

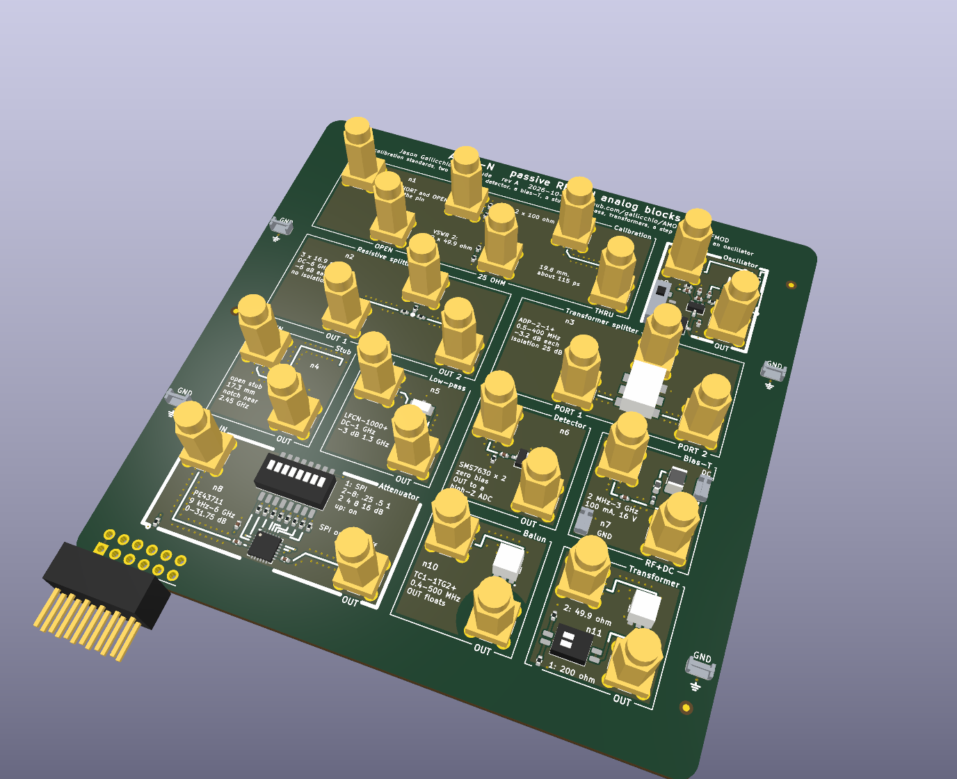
docs/images/amod_n-render-iso.png
