gallicchio/AMOD-and-RFMOD/docs/images/amod_n-schematic.png

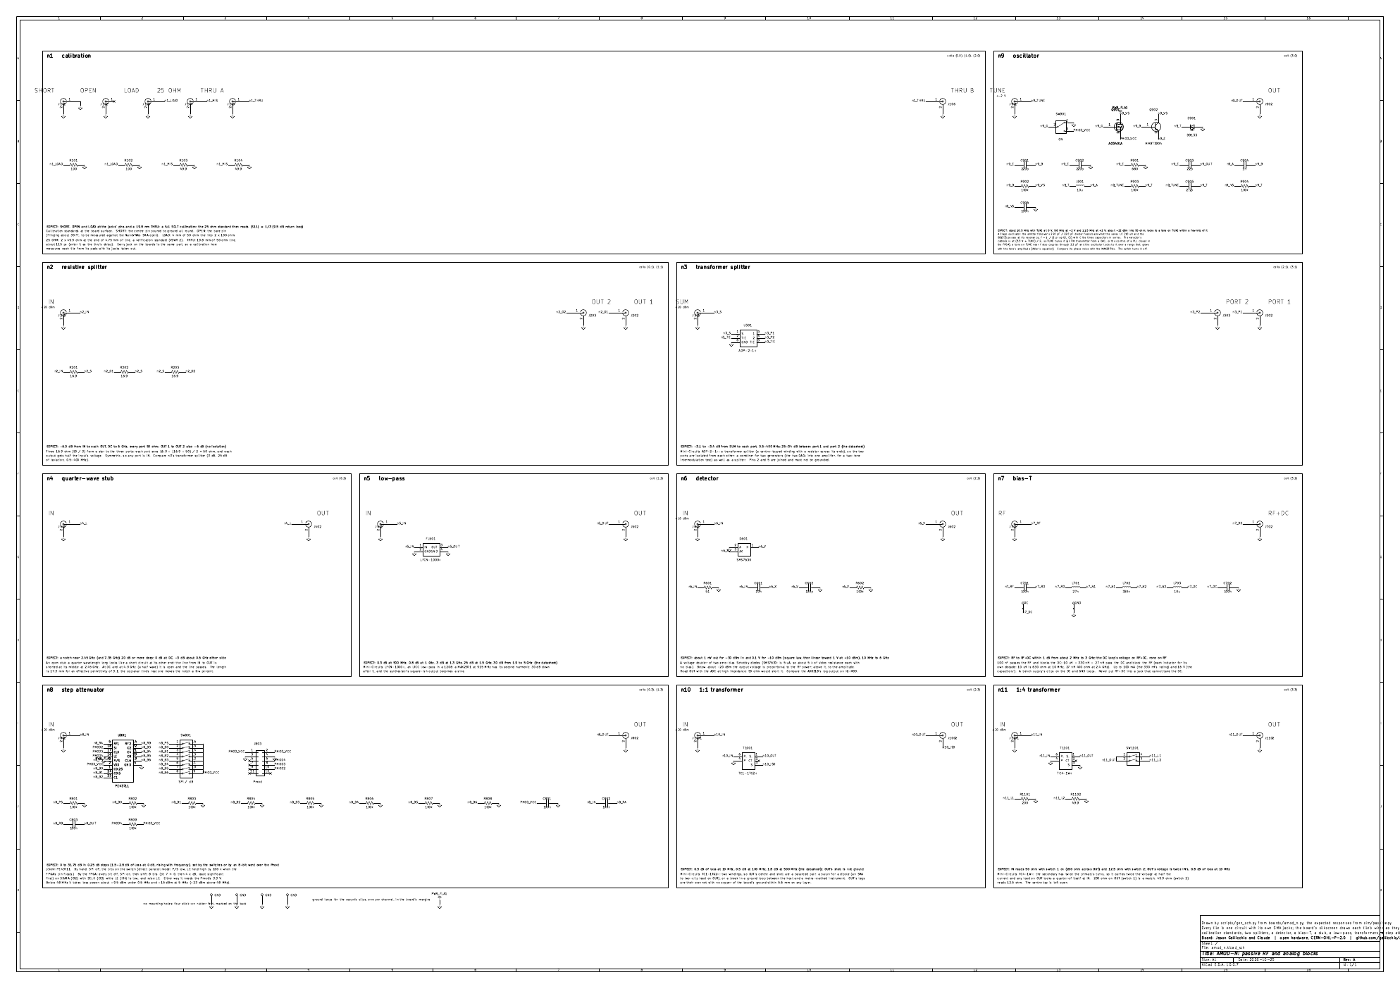
docs/images/amod_n-schematic.png
