gallicchio/AMOD-and-RFMOD/docs/images/amod_n-silk-bottom.png

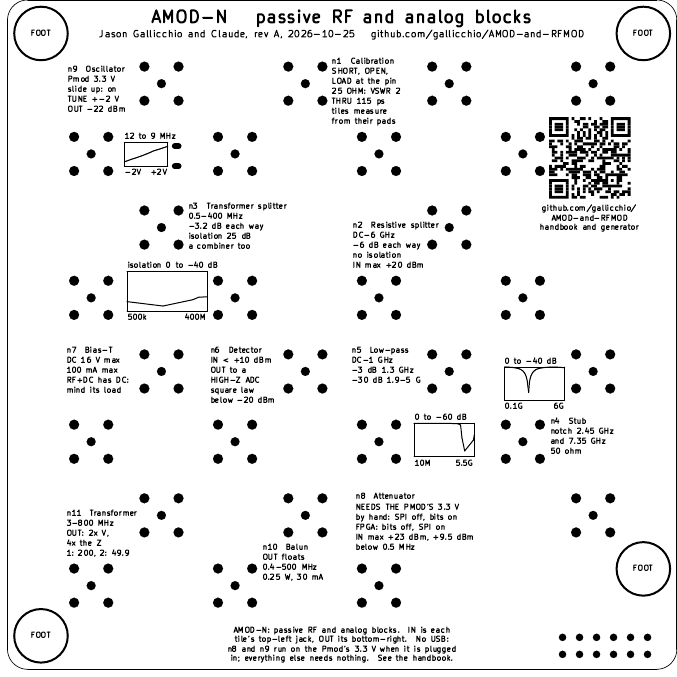
docs/images/amod_n-silk-bottom.png
