gallicchio/AMOD-and-RFMOD/docs/images/amod_n-silk-top.png

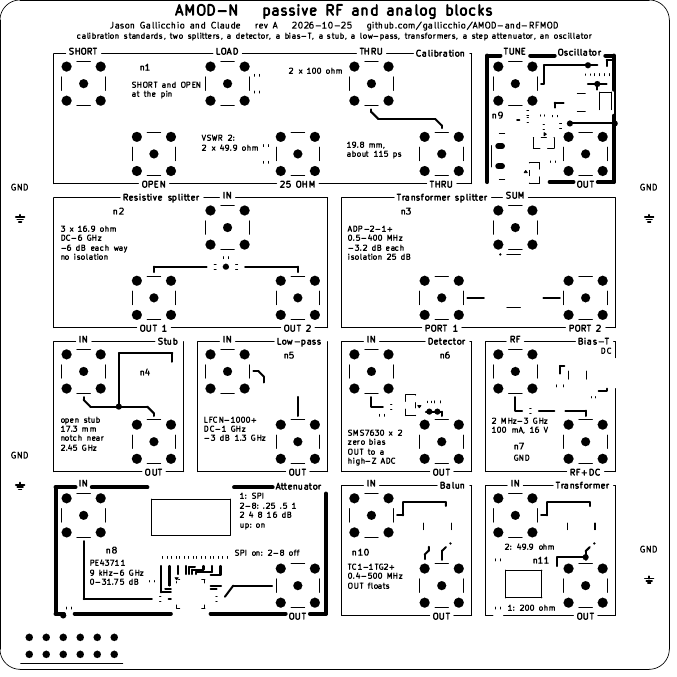
docs/images/amod_n-silk-top.png
