gallicchio/AMOD-and-RFMOD/docs/images/amod_n-top.png

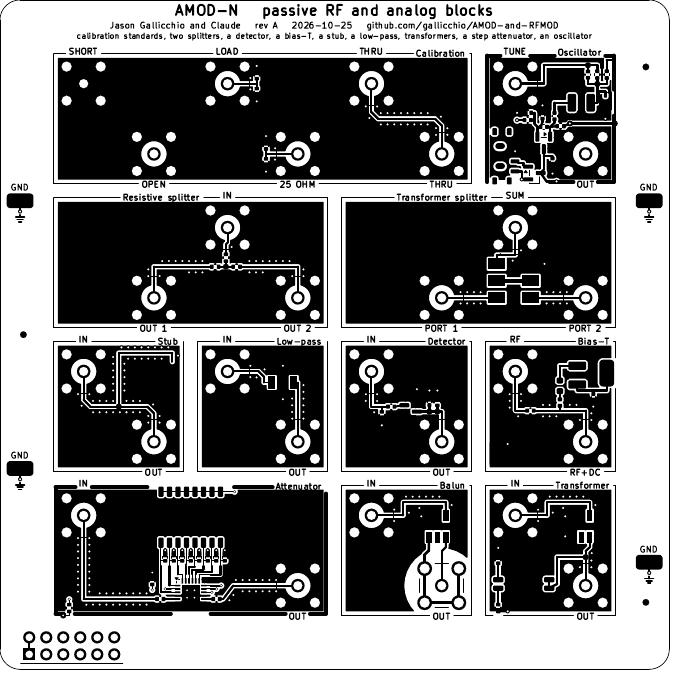
docs/images/amod_n-top.png
