gallicchio/AMOD-and-RFMOD/docs/images/amod_p-bottom.png

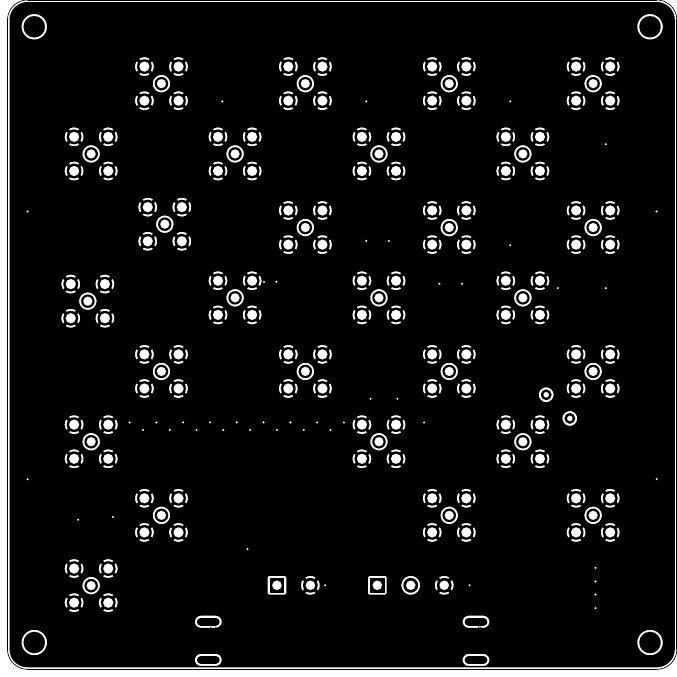
docs/images/amod_p-bottom.png
