gallicchio/AMOD-and-RFMOD/docs/images/amod_p-render-bottom.png

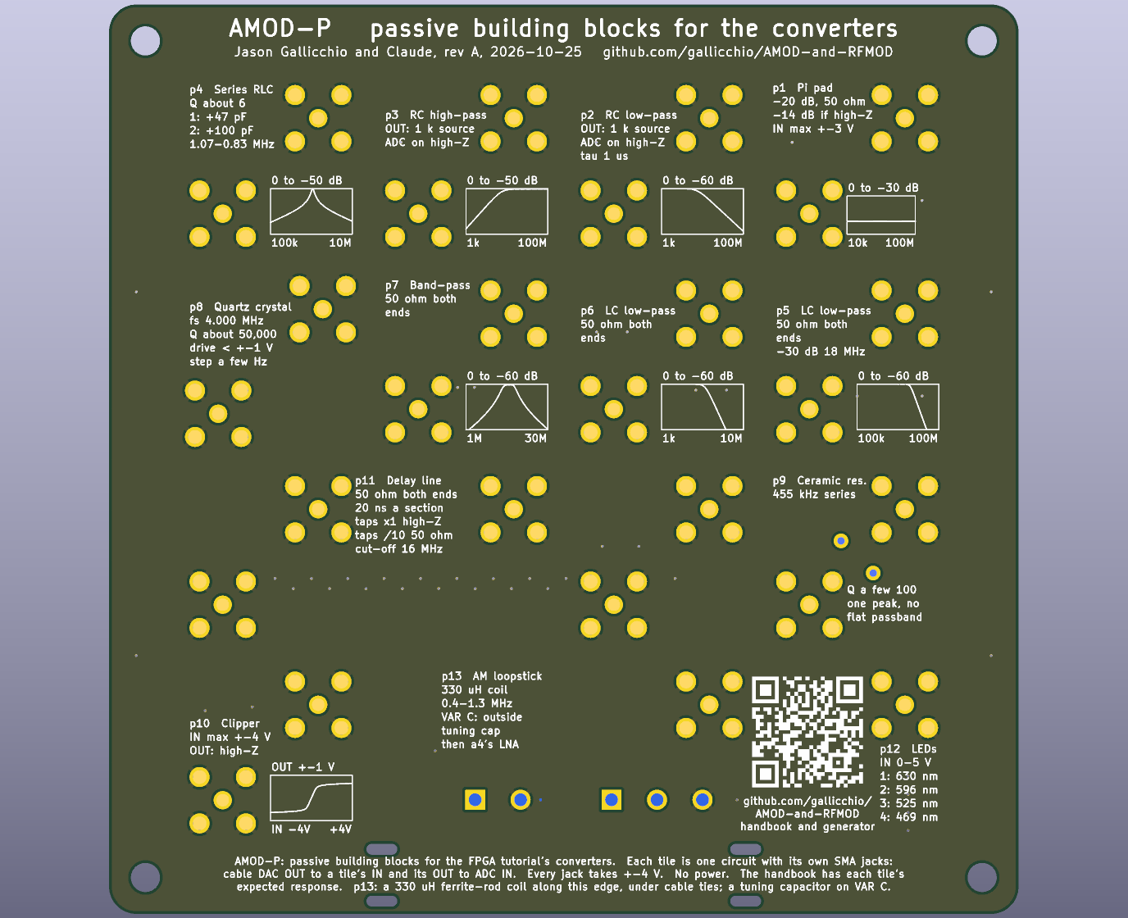
docs/images/amod_p-render-bottom.png
