gallicchio/AMOD-and-RFMOD/docs/images/amod_p-render-iso.png

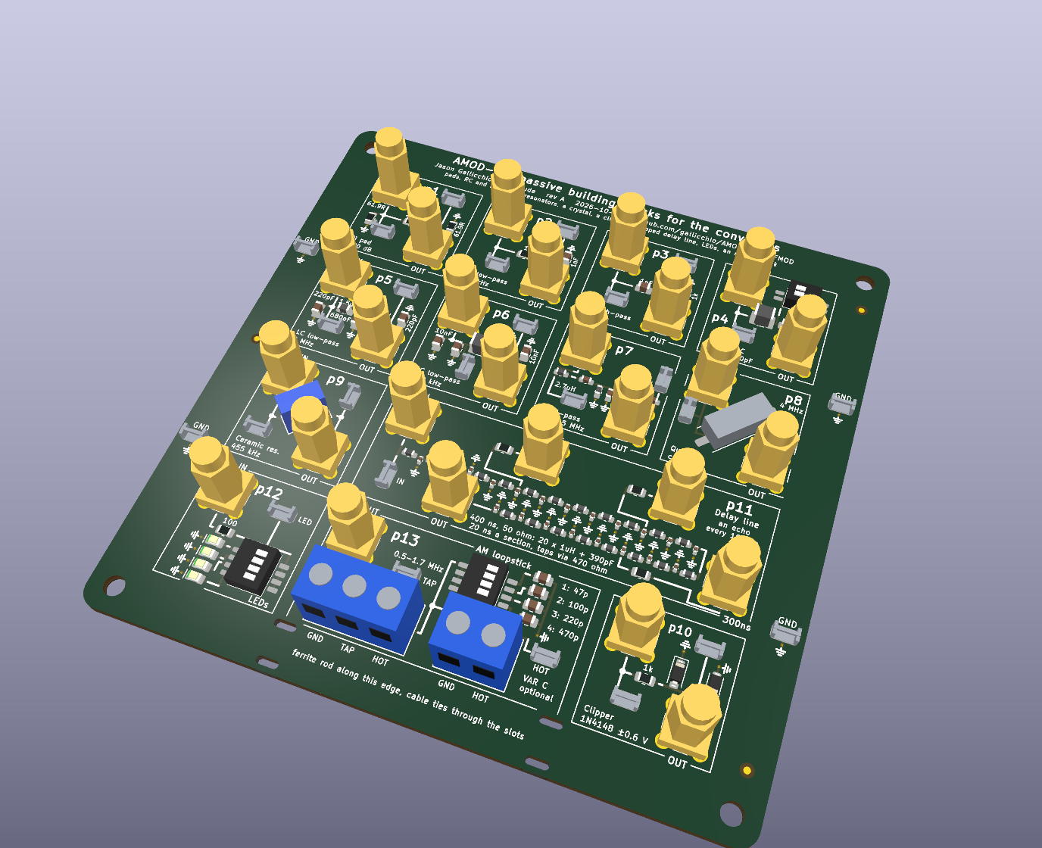
docs/images/amod_p-render-iso.png
