gallicchio/AMOD-and-RFMOD/docs/images/amod_p-schematic.png

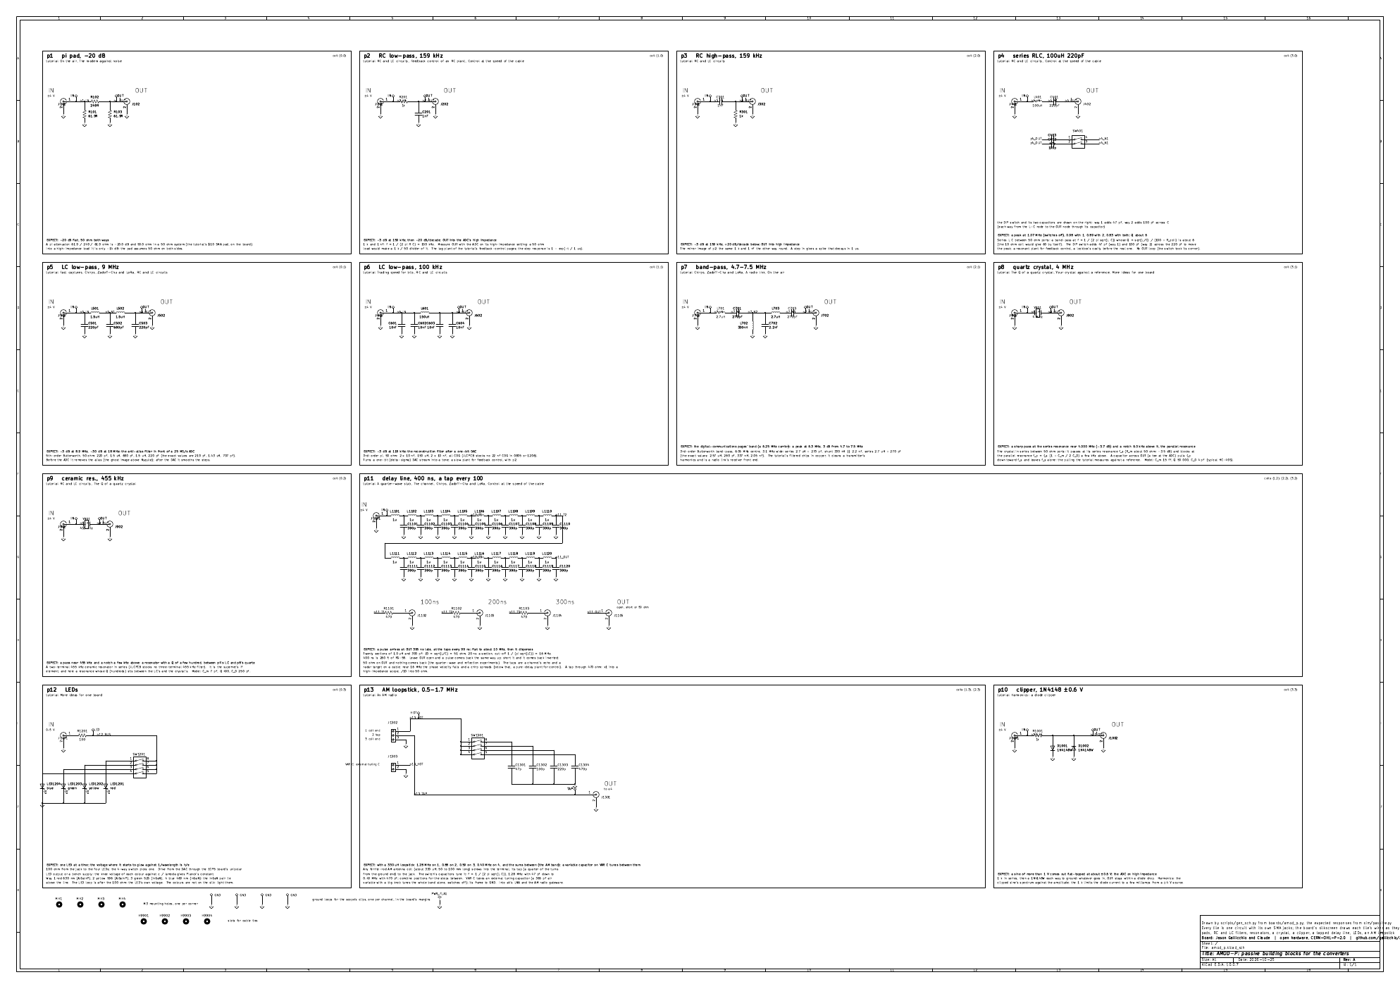
docs/images/amod_p-schematic.png
