gallicchio/AMOD-and-RFMOD/docs/images/amod_p-silk-bottom.png

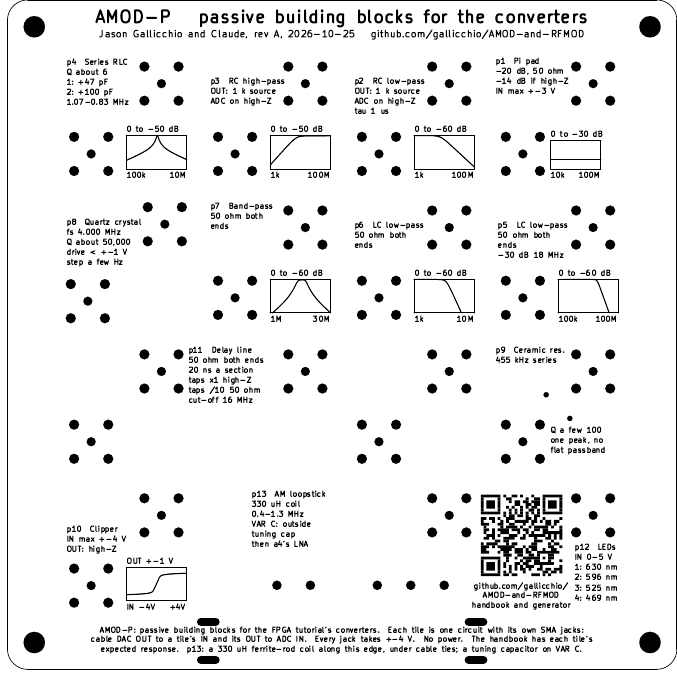
docs/images/amod_p-silk-bottom.png
