gallicchio/AMOD-and-RFMOD/docs/images/amod_p-silk-top.png

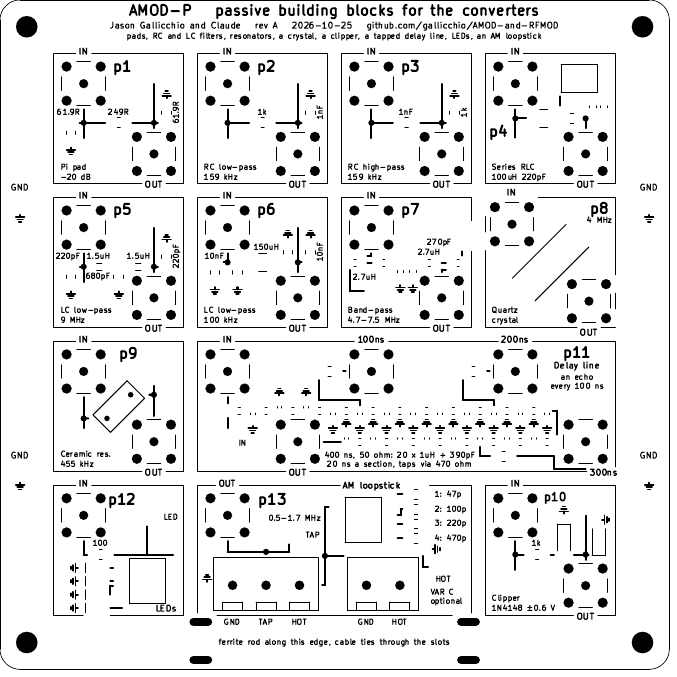
docs/images/amod_p-silk-top.png
