gallicchio/AMOD-and-RFMOD/docs/images/amod_p-top.png

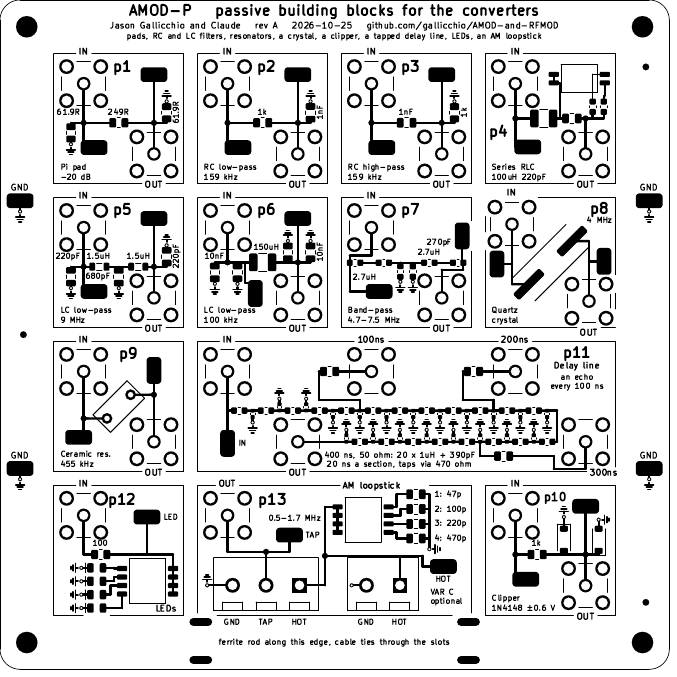
docs/images/amod_p-top.png
