gallicchio/AMOD-and-RFMOD/docs/images/iq_mod-bottom.png

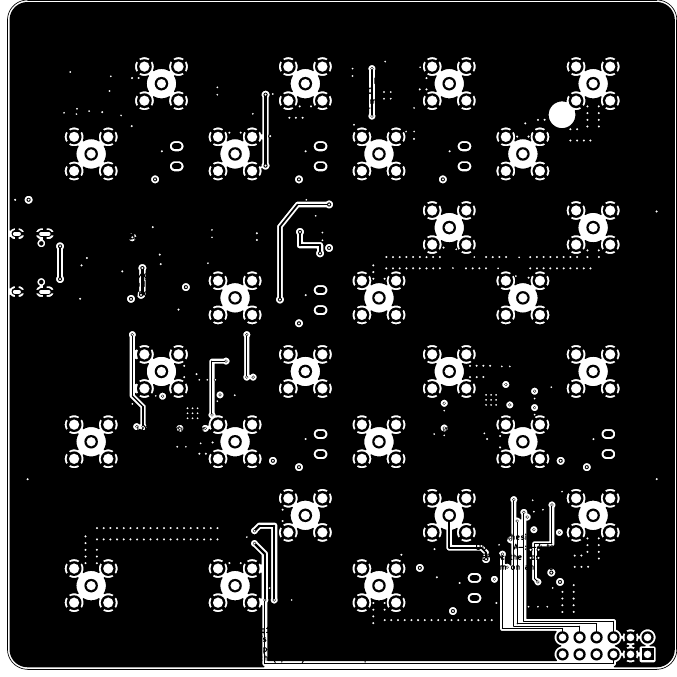
docs/images/iq_mod-bottom.png
