gallicchio/AMOD-and-RFMOD/docs/images/iq_mod-in1-ground.png

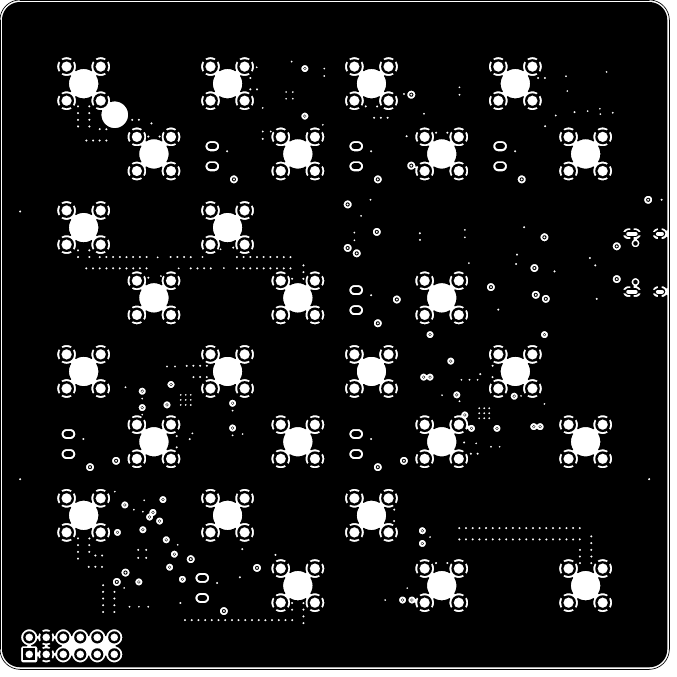
docs/images/iq_mod-in1-ground.png
