gallicchio/AMOD-and-RFMOD/docs/images/iq_mod-in2-power.png

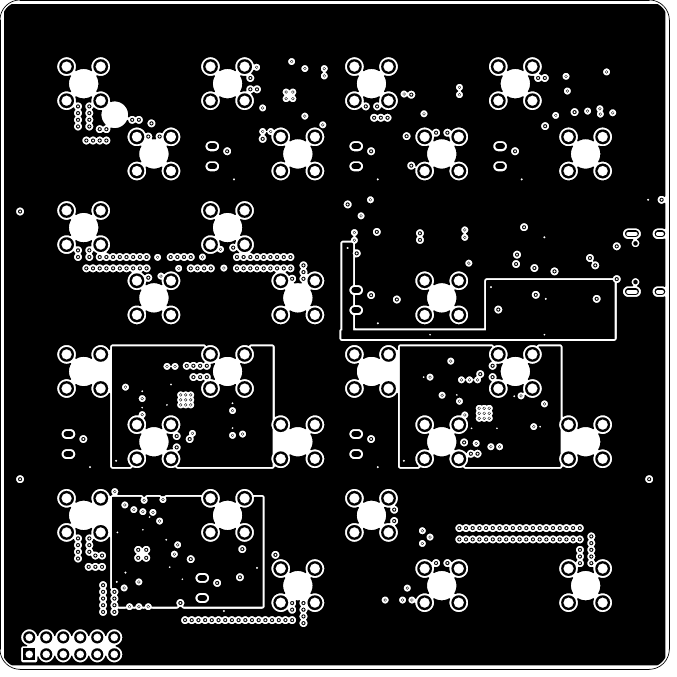
docs/images/iq_mod-in2-power.png
