gallicchio/AMOD-and-RFMOD/docs/images/iq_mod-render-bottom.png

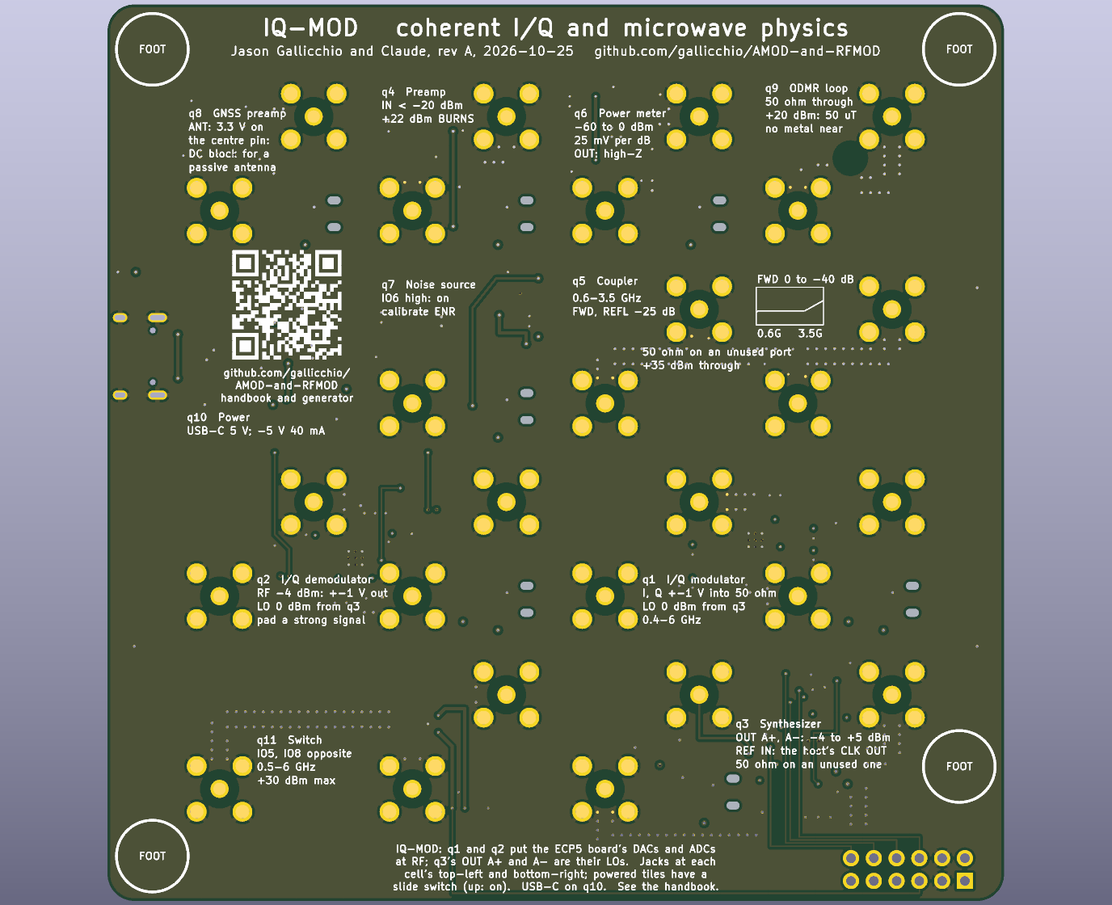
docs/images/iq_mod-render-bottom.png
