gallicchio/AMOD-and-RFMOD/docs/images/iq_mod-render-iso.png

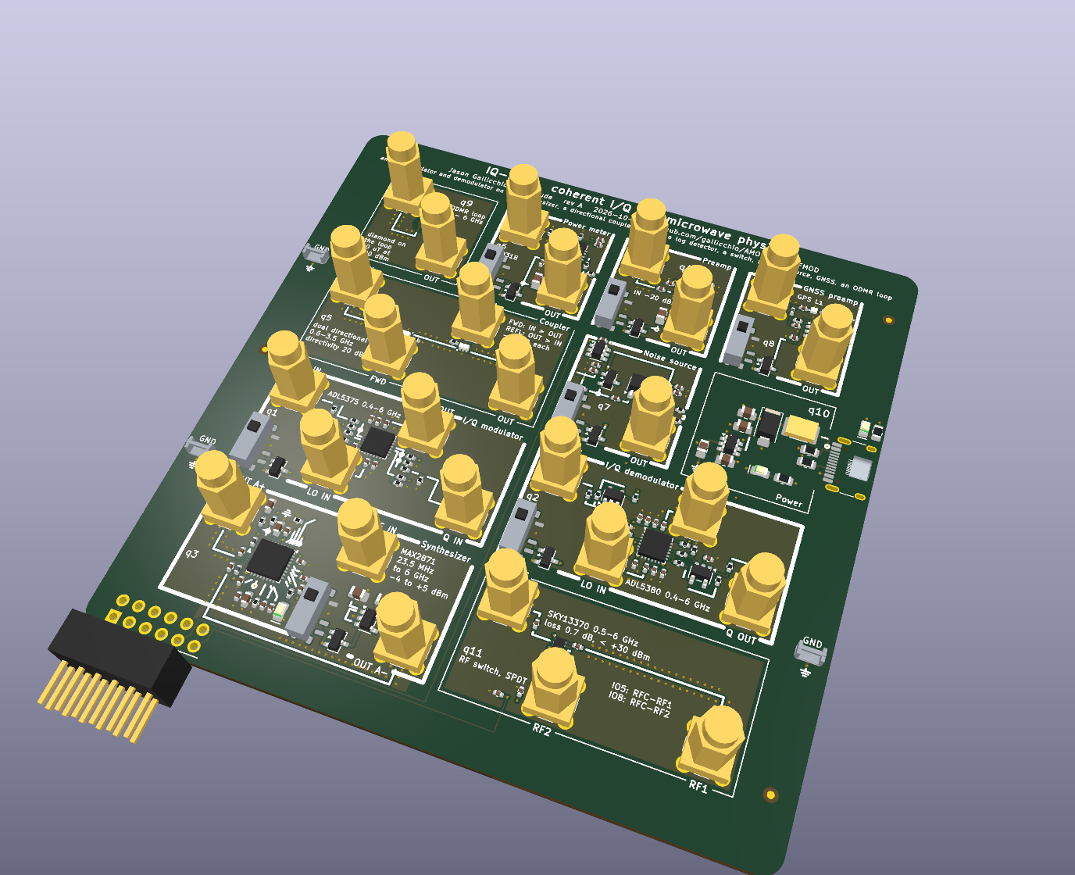
docs/images/iq_mod-render-iso.png
