gallicchio/AMOD-and-RFMOD/docs/images/iq_mod-schematic.png

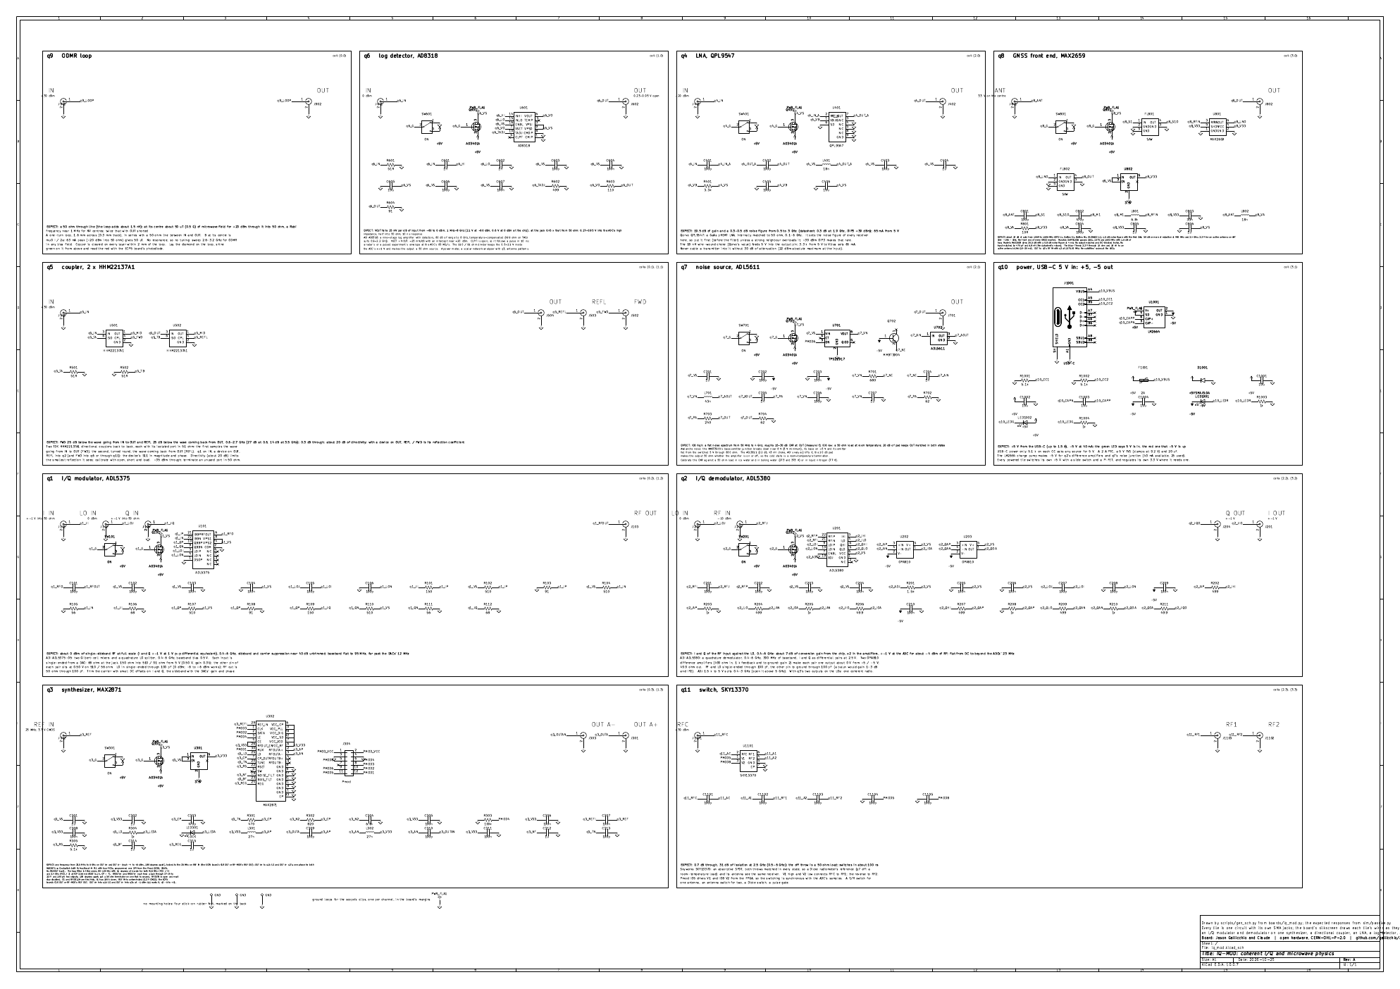
docs/images/iq_mod-schematic.png
