gallicchio/AMOD-and-RFMOD/docs/images/iq_mod-silk-bottom.png

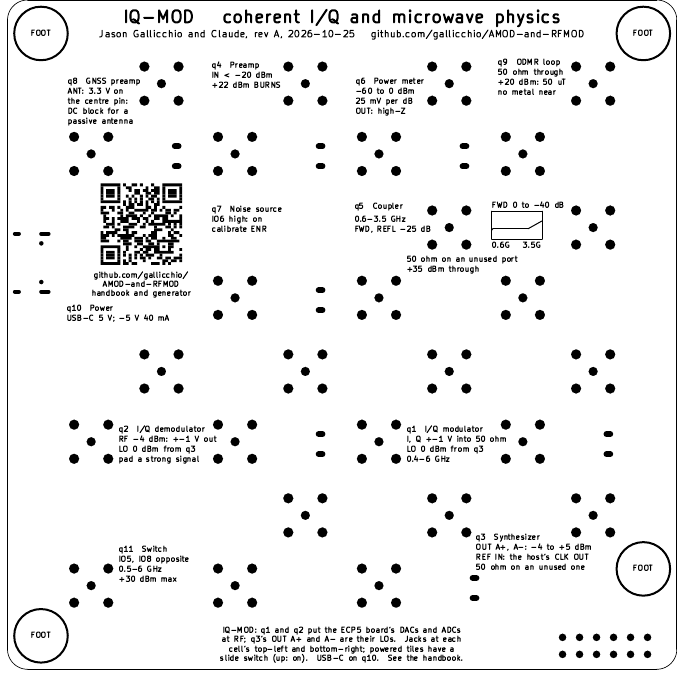
docs/images/iq_mod-silk-bottom.png
