gallicchio/AMOD-and-RFMOD/docs/images/iq_mod-silk-top.png

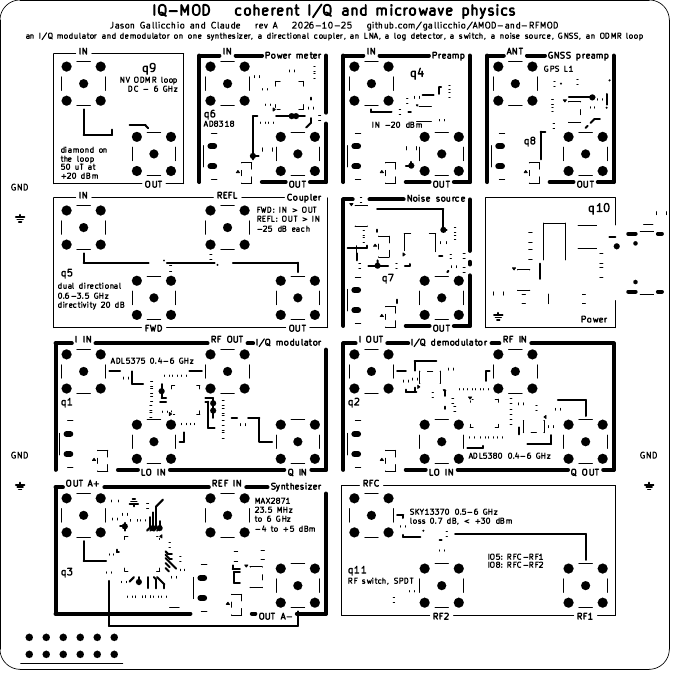
docs/images/iq_mod-silk-top.png
