gallicchio/AMOD-and-RFMOD/docs/images/iq_mod-top.png

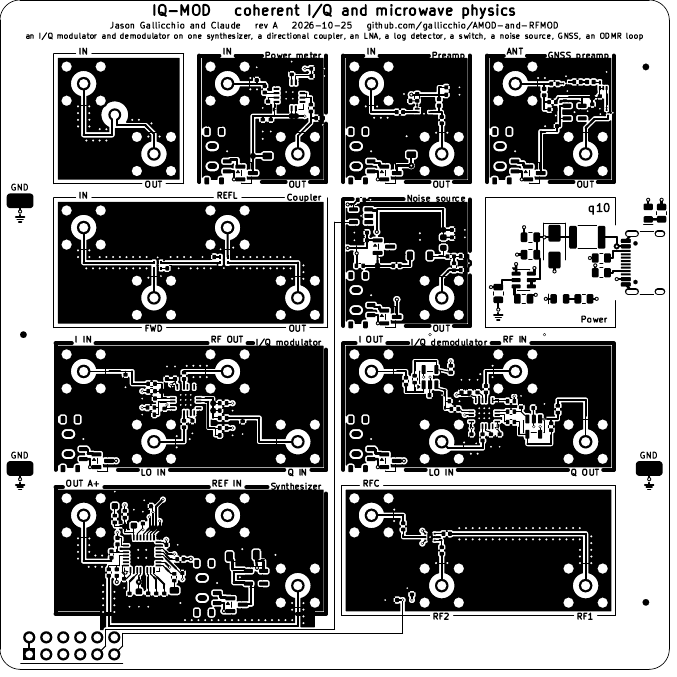
docs/images/iq_mod-top.png
