gallicchio/AMOD-and-RFMOD/docs/images/phmod-bottom.png

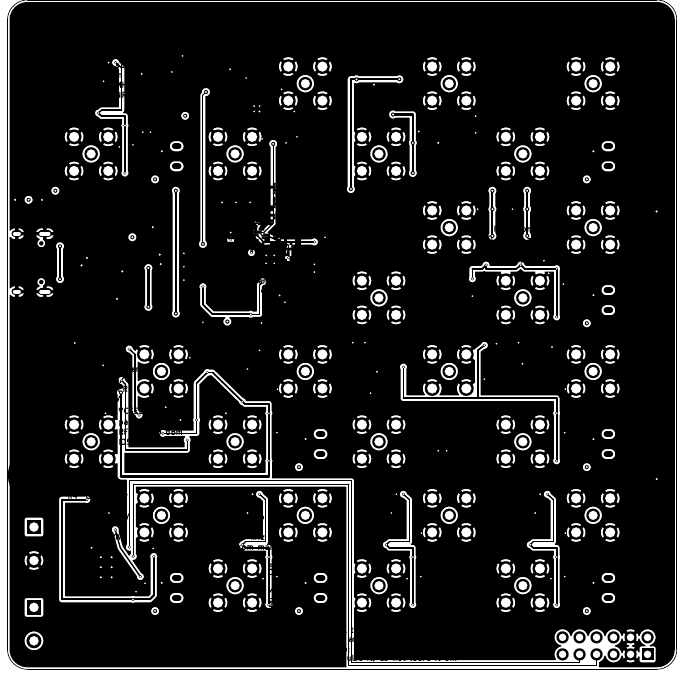
docs/images/phmod-bottom.png
