gallicchio/AMOD-and-RFMOD/docs/images/phmod-in1-ground.png

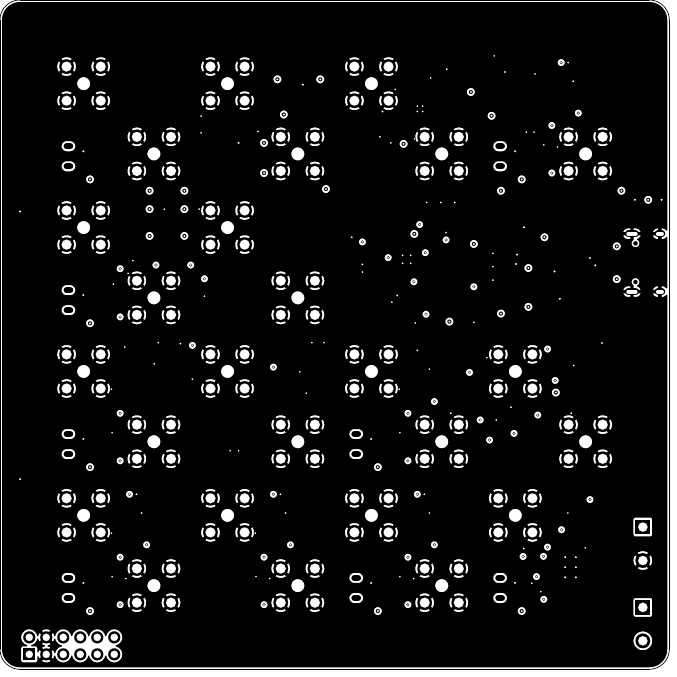
docs/images/phmod-in1-ground.png
