gallicchio/AMOD-and-RFMOD/docs/images/phmod-in2-power.png

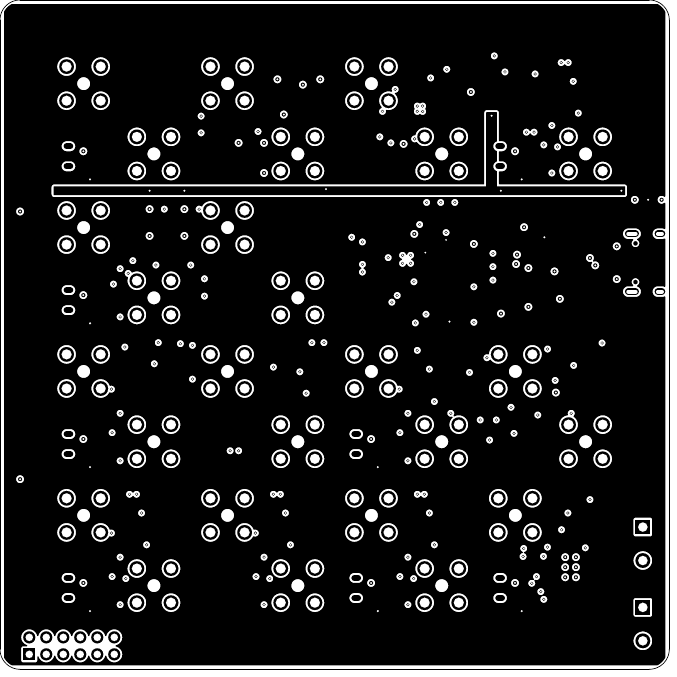
docs/images/phmod-in2-power.png
