gallicchio/AMOD-and-RFMOD/docs/images/phmod-render-bottom.png

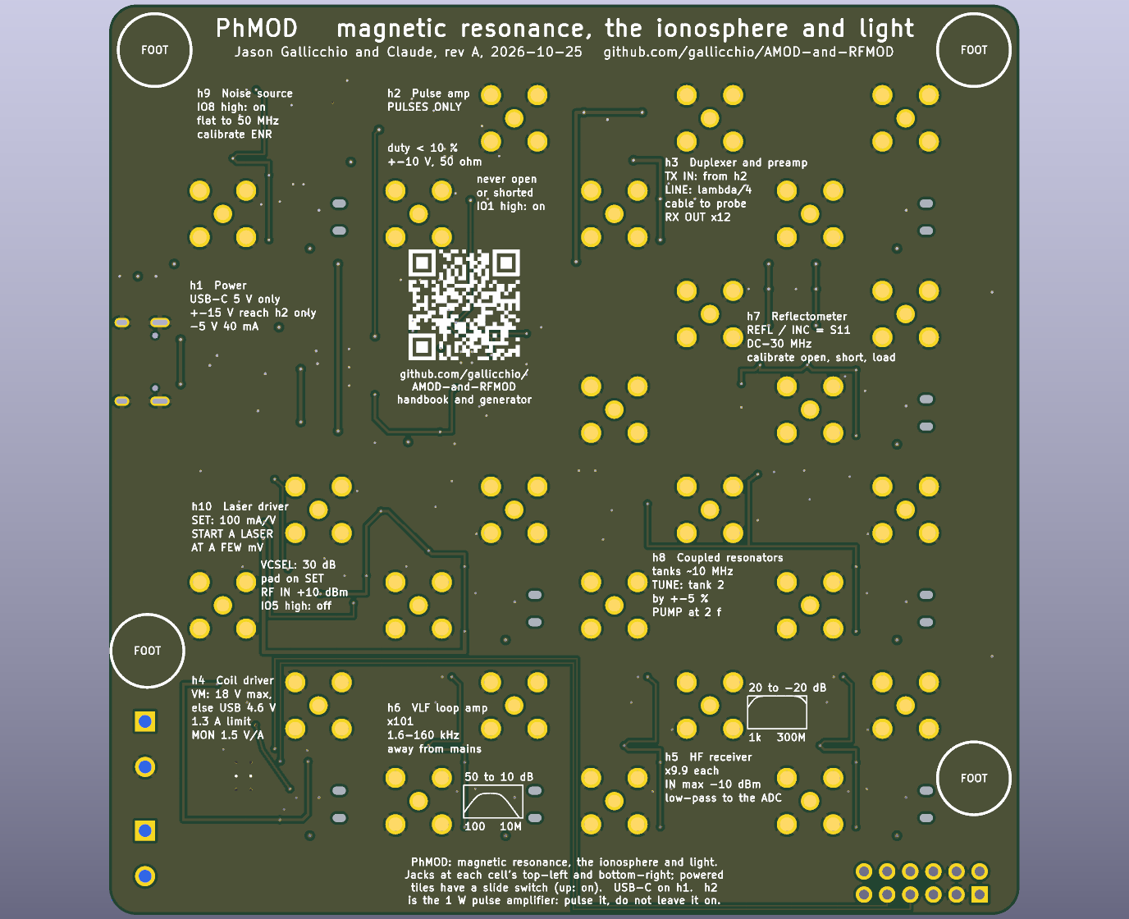
docs/images/phmod-render-bottom.png
