gallicchio/AMOD-and-RFMOD/docs/images/phmod-render-iso.png

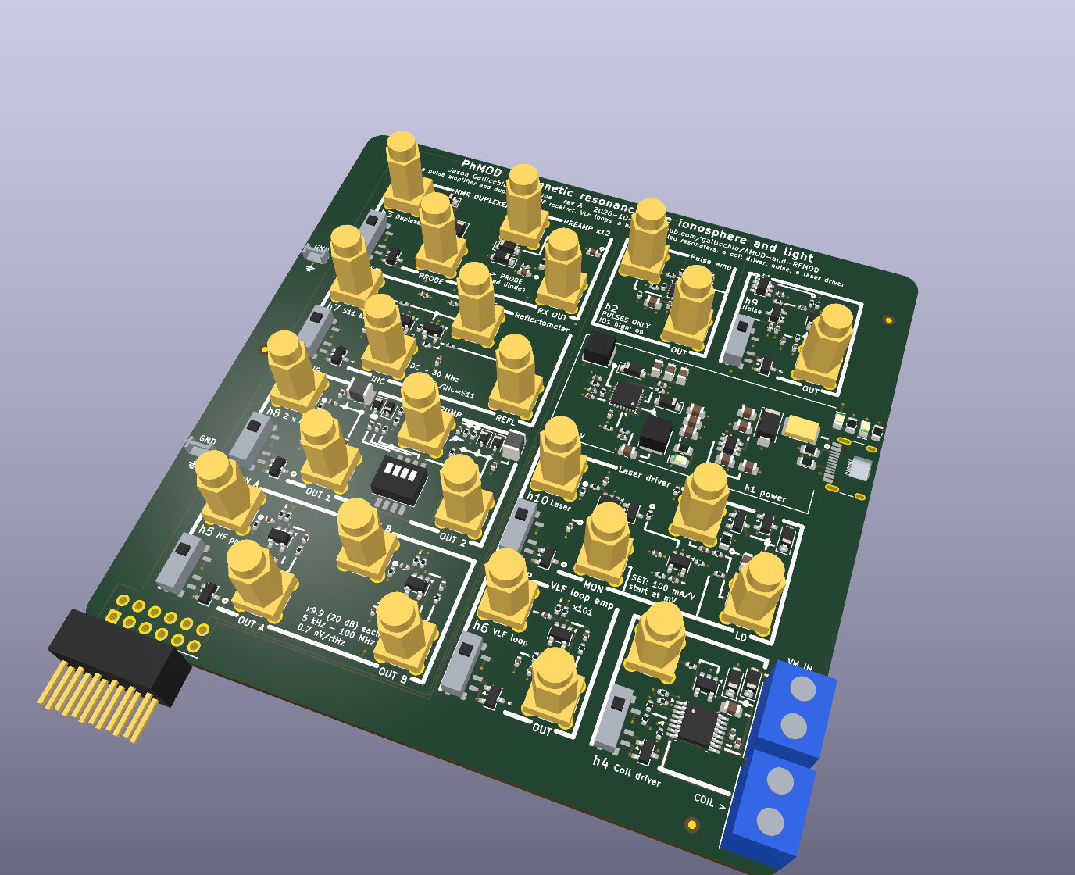
docs/images/phmod-render-iso.png
