gallicchio/AMOD-and-RFMOD/docs/images/phmod-schematic.png

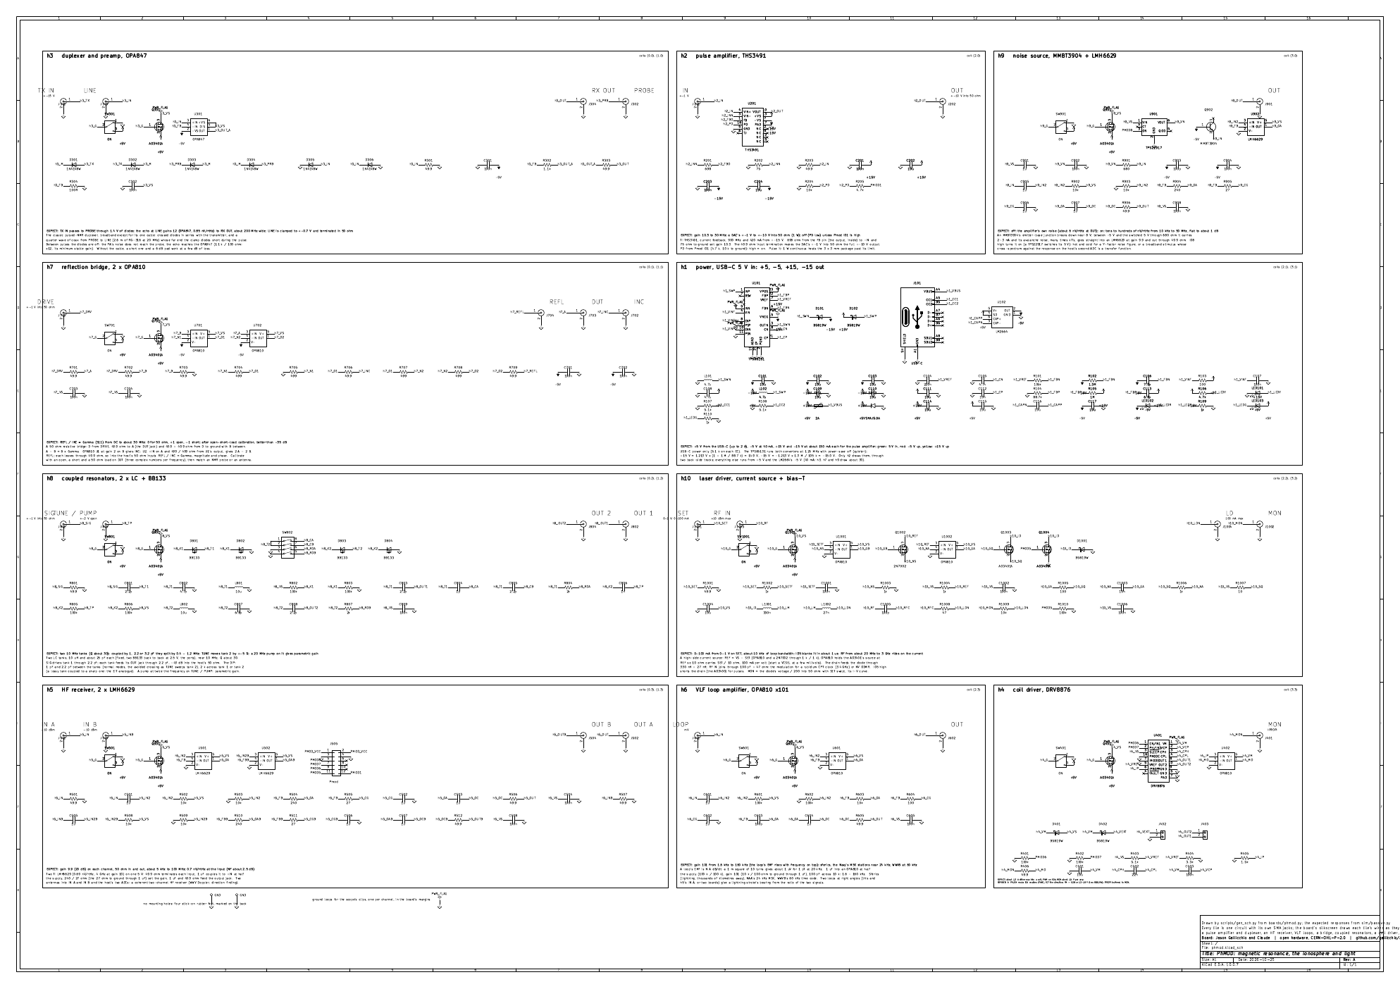
docs/images/phmod-schematic.png
