gallicchio/AMOD-and-RFMOD/docs/images/phmod-silk-bottom.png

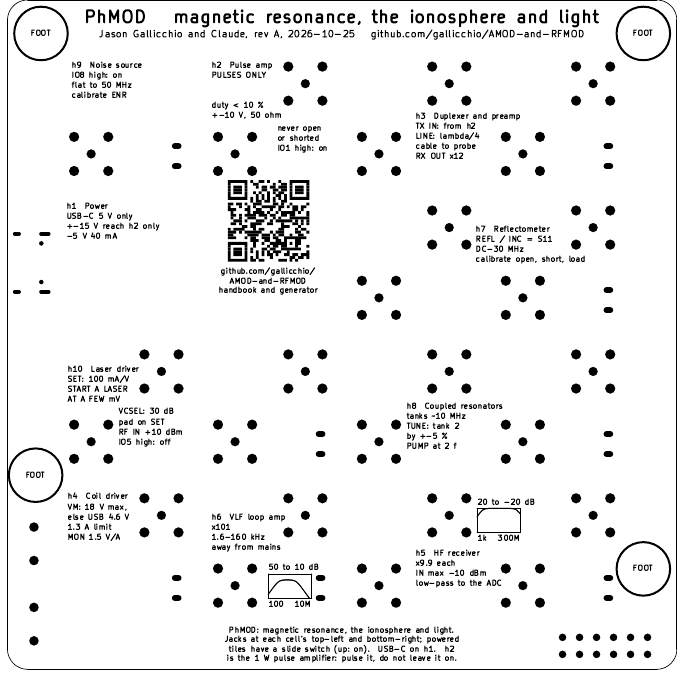
docs/images/phmod-silk-bottom.png
