gallicchio/AMOD-and-RFMOD/docs/images/phmod-silk-top.png

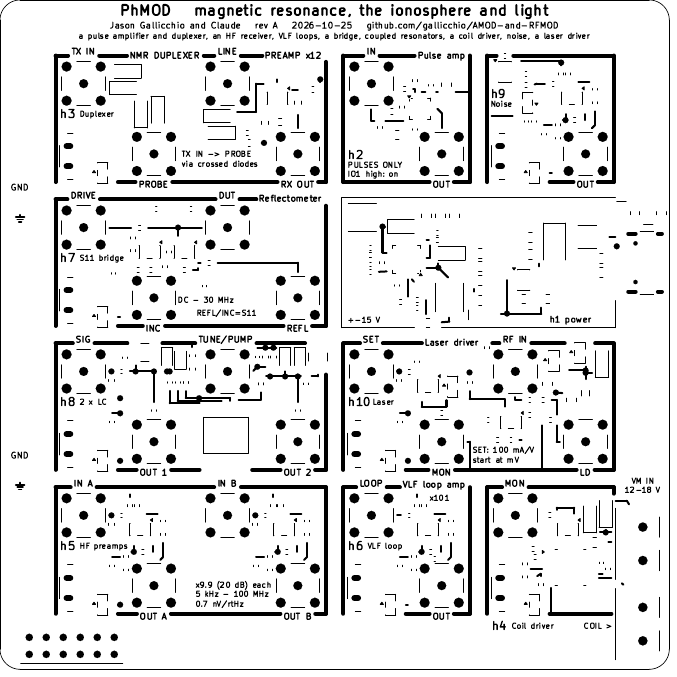
docs/images/phmod-silk-top.png
