gallicchio/AMOD-and-RFMOD/docs/images/phmod-top.png

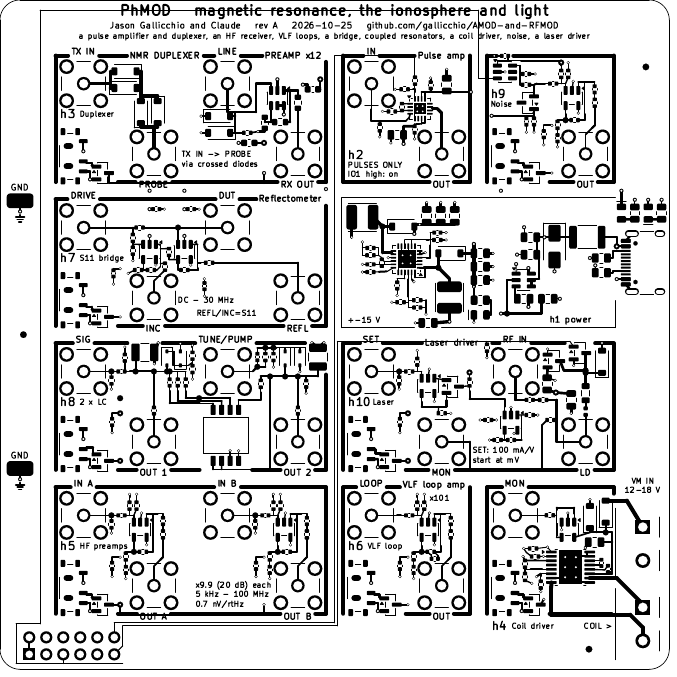
docs/images/phmod-top.png
