gallicchio/AMOD-and-RFMOD/docs/images/rf_mod-bottom.png

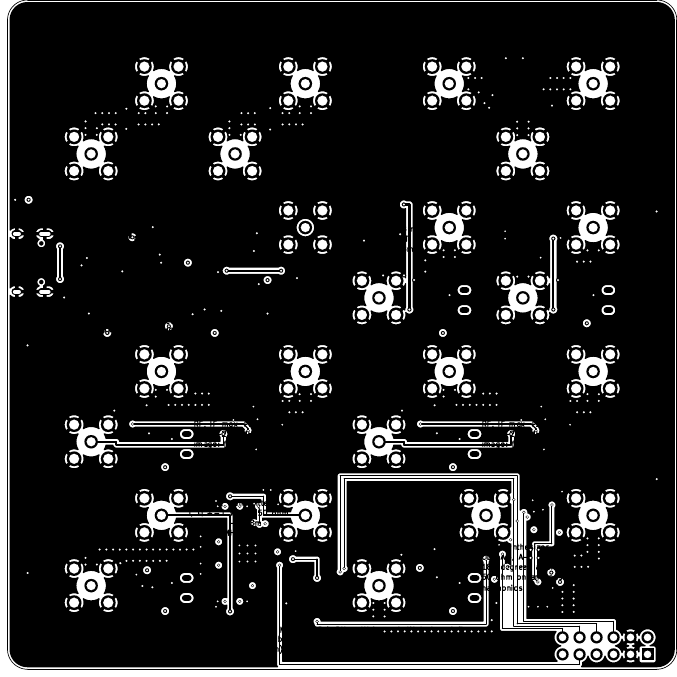
docs/images/rf_mod-bottom.png
