gallicchio/AMOD-and-RFMOD/docs/images/rf_mod-in1-ground.png

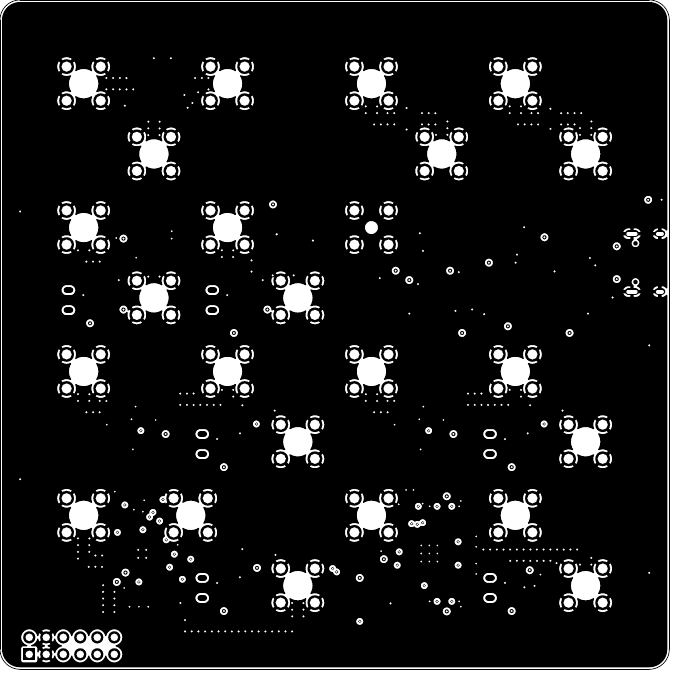
docs/images/rf_mod-in1-ground.png
