gallicchio/AMOD-and-RFMOD/docs/images/rf_mod-in2-power.png

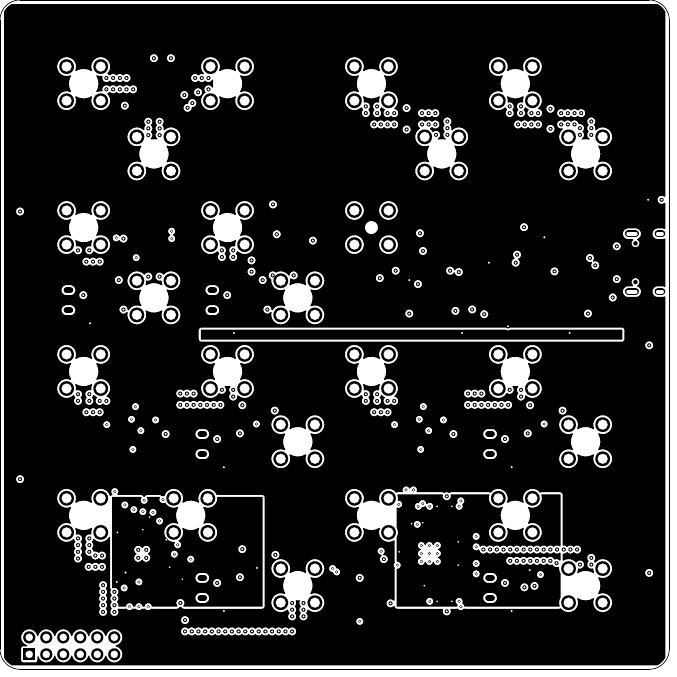
docs/images/rf_mod-in2-power.png
