gallicchio/AMOD-and-RFMOD/docs/images/rf_mod-render-bottom.png

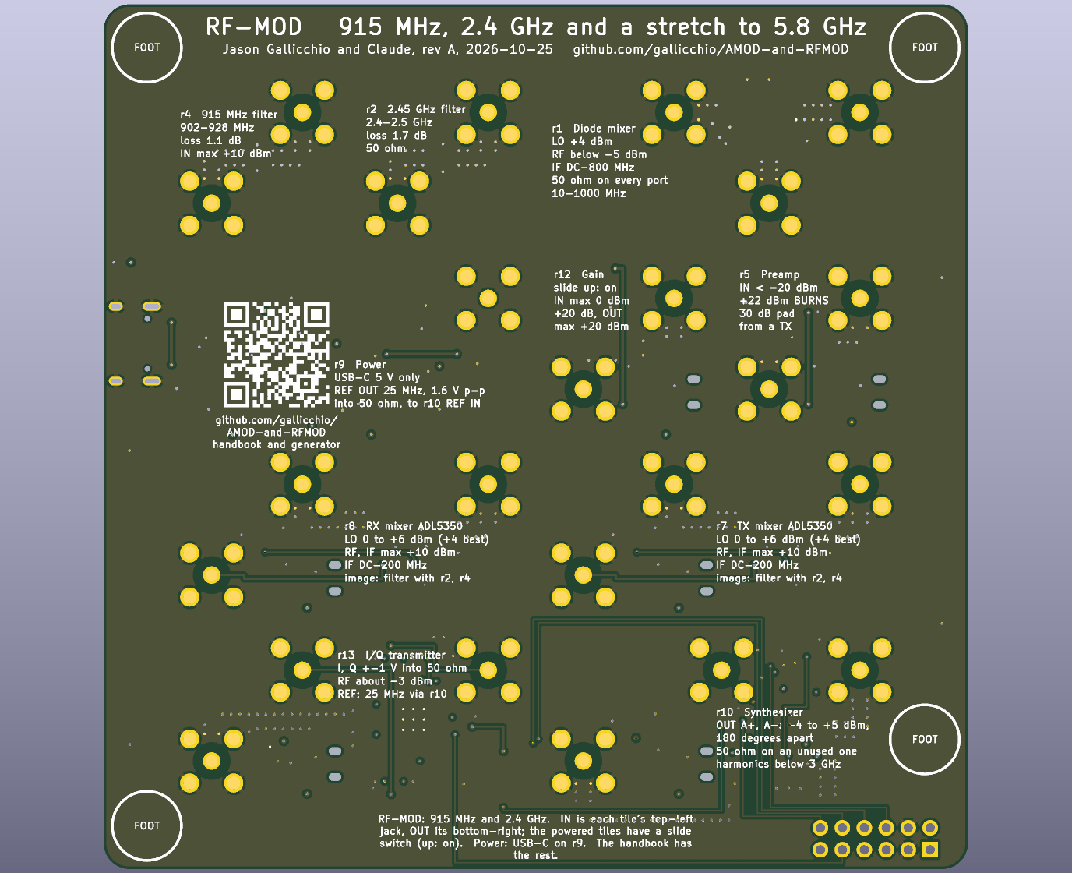
docs/images/rf_mod-render-bottom.png
