gallicchio/AMOD-and-RFMOD/docs/images/rf_mod-render-iso.png

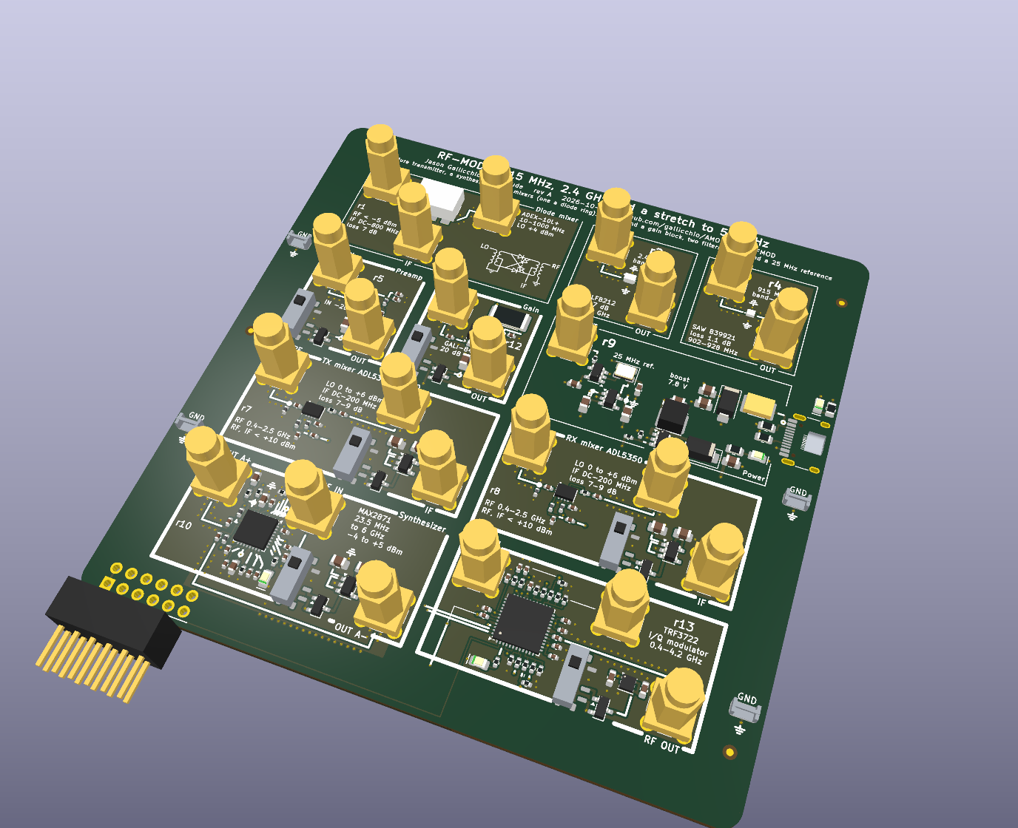
docs/images/rf_mod-render-iso.png
