gallicchio/AMOD-and-RFMOD/docs/images/rf_mod-schematic.png

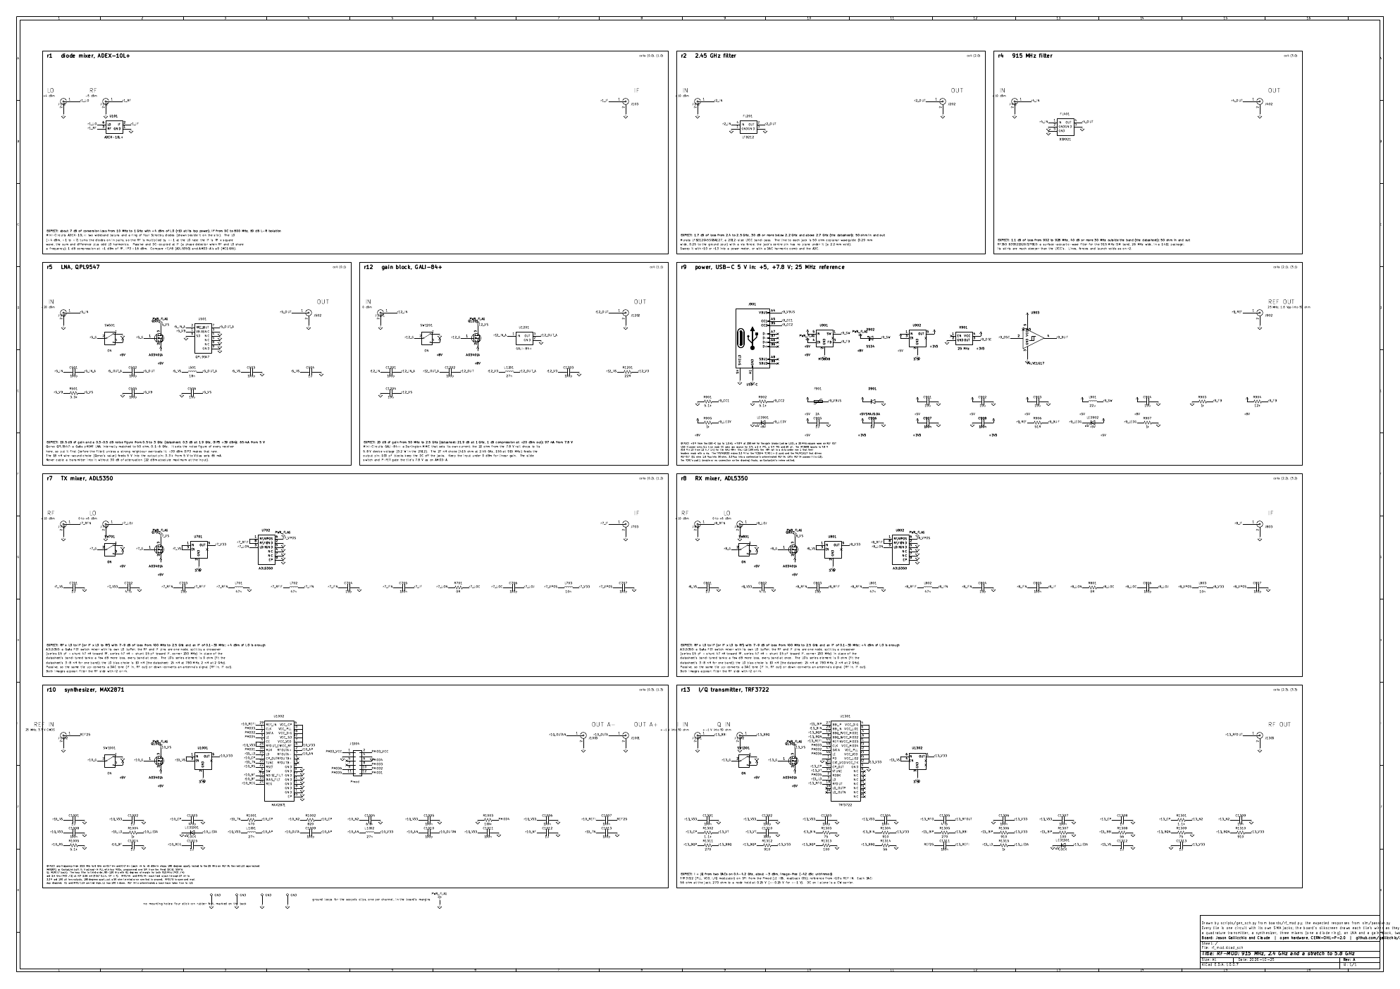
docs/images/rf_mod-schematic.png
