gallicchio/AMOD-and-RFMOD/docs/images/rf_mod-silk-bottom.png

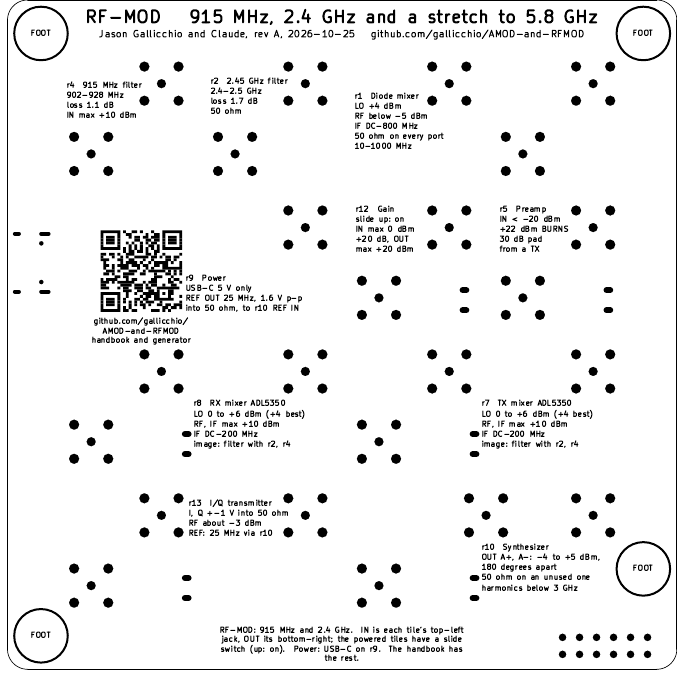
docs/images/rf_mod-silk-bottom.png
