gallicchio/AMOD-and-RFMOD/docs/images/rf_mod-silk-top.png

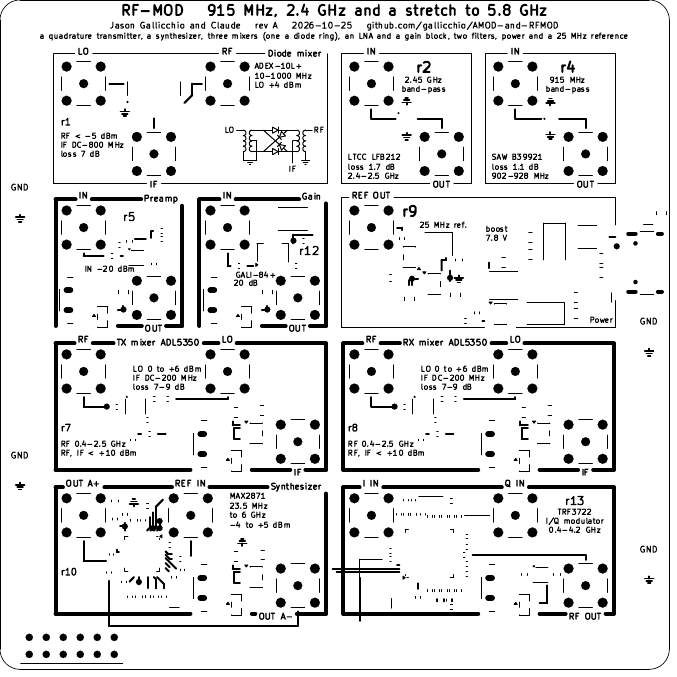
docs/images/rf_mod-silk-top.png
