gallicchio/AMOD-and-RFMOD/docs/images/rf_mod-top.png

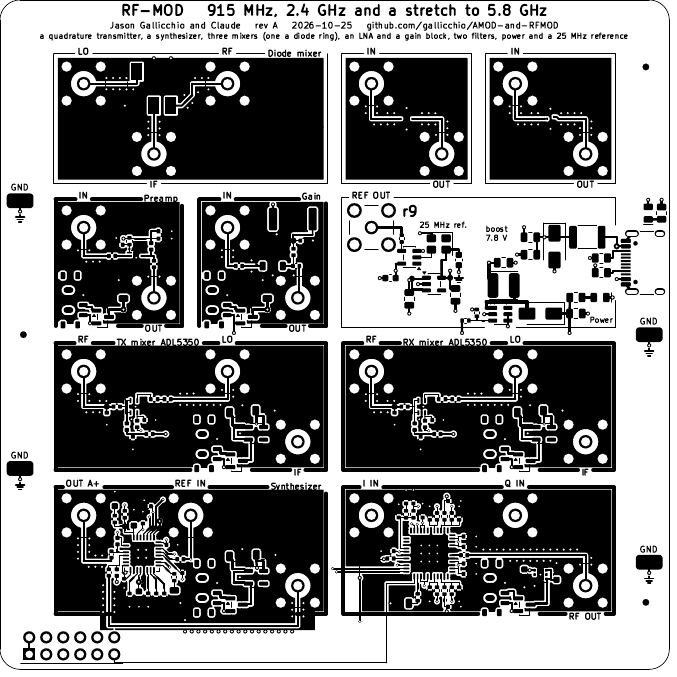
docs/images/rf_mod-top.png
