gallicchio/AMOD-and-RFMOD/icepi_adapter/render-iso.png

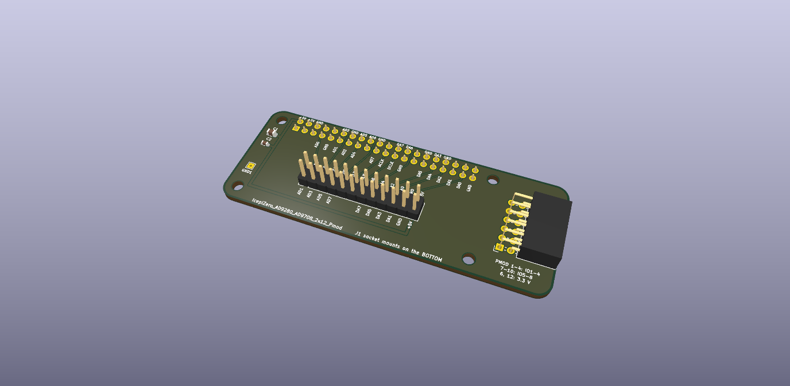
icepi_adapter/render-iso.png
