gallicchio/AMOD-and-RFMOD/out/amod_a/amod_a_bom_costed.csv

Comment | Designator | Footprint | LCSC Part # | MPN | Qty | Unit $ | Ext $ | JLC
1n | C703 | C_0402_1005Metric | C1523 | 0402B102K500NT | 1 | 0.0038 | 0.004 | basic
100n | C602,C603 | C_0805_2012Metric | C49678 | CC0805KRX7R9BB104 | 2 | 0.0205 | 0.041 | basic
1u | C1203,C1206 | C_0603_1608Metric | C15849 | CL10A105KB8NNNC | 2 | 0.0146 | 0.029 | basic
100n | C701,C702,C704 | C_0402_1005Metric | C1525 | CL05B104KO5NNNC | 3 | 0.0035 | 0.011 | basic
10n | C601,C1103,C1202 | C_0805_2012Metric | C2971995 | 0805CG103J500NT | 3 | 0.0421 | 0.126 | extended
1u | C105,C106,C501,C1201 | C_0805_2012Metric | C28323 | CL21B105KBFNNNE | 4 | 0.0341 | 0.136 | basic
10u | C101,C102,C103,C104,C1205 | C_0805_2012Metric | C15850 | CL21A106KAYNNNE | 5 | 0.0426 | 0.213 | basic
100n | C201,C202,C301,C302,C401,C402,C502,C503,C801,C901,C902,C903,C904,C905,C1001,C1002,C1003,C1004,C1101,C1102,C1104,C1105,C1204,C1207,C1208 | C_0603_1608Metric | C14663 | CC0603KRX7R9BB104 | 25 | 0.0084 | 0.210 | basic
SMAJ5.0A | D101 | D_SMA | C78401 | SMAJ5.0A | 1 | 0.0537 | 0.054 | extended
2A | F101 | Fuse_1812_4532Metric | C210837 | MF-MSMF200-2 | 1 | 0.0650 | 0.065 | extended
USB-C | J101 | USB_C_Receptacle_HRO_TYPE-C-31-M-12 | C165948 | TYPE-C-31-M-12 | 1 | 0.1888 | 0.189 | extended
rails | J102 | PinSocket_1x05_P2.54mm_Vertical | C2894928 | PZ254-1-05-Z-8.5 | 1 | 0.0588 | 0.059 | extended
HB100 | J502 | PinHeader_1x03_P2.54mm_Vertical | C2937625 | PZ254V-11-03P | 1 | 0.0199 | 0.020 | extended
TX | J1102 | PinSocket_1x05_P2.54mm_Vertical | C2894928 | PZ254-1-05-Z-8.5 | 1 | 0.0588 | 0.059 | extended
RX | J1103 | PinSocket_1x05_P2.54mm_Vertical | C2894928 | PZ254-1-05-Z-8.5 | 1 | 0.0588 | 0.059 | extended
Pmod | J1104 | PinHeader_2x06_P2.54mm_Horizontal_PZ254R-12-12P | C492434 | PZ254R-12-12P | 1 | 0.1036 | 0.104 | extended
SPK | J1203 | TerminalBlock_KF301_1x02_P5.00mm | C474881 | KF301-5.0-2P | 1 | 0.1017 | 0.102 | extended
MIC | J1204 | PinSocket_1x02_P2.54mm_Vertical | C2894925 | PZ254-1-02-Z-8.5 | 1 | 0.0266 | 0.027 | extended
SMA | J201,J202,J301,J302,J401,J402,J501,J601,J701,J702,J801,J901,J902,J903,J1001,J1002,J1003,J1004,J1101,J1201,J1202 | SMA_BWSMA-KE-Z001_Vertical | C496549 | BWSMA-KE-Z001 | 21 | 0.4043 | 8.490 | extended
-5V | LED101 | LED_0805_2012Metric_Kbar | C84256 | NCD0805R1 | 1 | 0.0135 | 0.013 | basic
+5V | LED102 | LED_0805_2012Metric_Kbar | C2297 | KT-0805G | 1 | 0.0164 | 0.016 | basic
AO3400A | Q802 | SOT-23 | C20917 | AO3400A | 1 | 0.0889 | 0.089 | basic
AO3401A | Q201,Q301,Q401,Q501,Q601,Q701,Q801,Q901,Q1001,Q1101,Q1201 | SOT-23 | C15127 | AO3401A | 11 | 0.0959 | 1.055 | basic
1.1k | R204 | R_0603_1608Metric | C22764 | 0603WAF1101T5E | 1 | 0.0018 | 0.002 | extended
10R | R404 | R_0603_1608Metric | C22859 | 0603WAF100JT5E | 1 | 0.0032 | 0.003 | basic
100k | R501 | R_0402_1005Metric | C25741 | 0402WGF1003TCE | 1 | 0.0015 | 0.002 | basic
3.9k | R904 | R_0402_1005Metric | C51721 | 0402WGF3901TCE | 1 | 0.0012 | 0.001 | extended
1.5k | R905 | R_0402_1005Metric | C25867 | 0402WGF1501TCE | 1 | 0.0029 | 0.003 | basic
1.5k | R906 | R_0805_2012Metric | C4310 | 0805W8F1501T5E | 1 | 0.0038 | 0.004 | basic
47 | R1005 | R_0402_1005Metric | C25118 | 0402WGF470JTCE | 1 | 0.0012 | 0.001 | basic
4.7k | R1007 | R_0402_1005Metric | C25900 | 0402WGF4701TCE | 1 | 0.0021 | 0.002 | basic
47k | R1008 | R_0402_1005Metric | C25792 | 0402WGF4702TCE | 1 | 0.0020 | 0.002 | basic
3.9k | R1101 | R_0805_2012Metric | C17614 | 0805W8F3901T5E | 1 | 0.0030 | 0.003 | basic
2.2k | R1202 | R_0805_2012Metric | C17520 | 0805W8F2201T5E | 1 | 0.0049 | 0.005 | basic
5.1k | R101,R102 | R_0805_2012Metric | C27834 | 0805W8F5101T5E | 2 | 0.0036 | 0.007 | basic
1k | R103,R104 | R_0805_2012Metric | C17513 | 0805W8F1001T5E | 2 | 0.0035 | 0.007 | basic
1k | R701,R902 | R_0402_1005Metric | C11702 | 0402WGF1001TCE | 2 | 0.0013 | 0.003 | basic
10k | R702,R703 | R_0402_1005Metric | C25744 | 0402WGF1002TCE | 2 | 0.0011 | 0.002 | basic
15R | R801,R802 | R_2512_6332Metric | C20087 | 25121WF150JT4E | 2 | 0.0375 | 0.075 | extended
470 | R704,R1006 | R_0402_1005Metric | C25117 | 0402WGF4700TCE | 2 | 0.0012 | 0.002 | basic
10k | R601,R603,R604 | R_0805_2012Metric | C17414 | 0805W8F1002T5E | 3 | 0.0034 | 0.010 | basic
1k | R402,R1002,R1004 | R_0603_1608Metric | C21190 | 0603WAF1001T5E | 3 | 0.0017 | 0.005 | basic
51 | R901,R903,R907,R908 | R_0402_1005Metric | C25125 | 0402WGF510JTCE | 4 | 0.0012 | 0.005 | extended
100R | R304,R504,R1104,R1205 | R_0603_1608Metric | C22775 | 0603WAF1000T5E | 4 | 0.0023 | 0.009 | basic
10k | R202,R302,R502,R602,R803,R909,R910,R1102,R1201,R1203 | R_0603_1608Metric | C25804 | 0603WAF1002T5E | 10 | 0.0022 | 0.022 | basic
49.9 | R201,R203,R301,R303,R401,R403,R503,R1001,R1003,R1009,R1103,R1204 | R_0603_1608Metric | C6230117 | SR0603FR-7T49R9L | 12 | 0.0150 | 0.180 | extended
DIP4 | SW1002 | SW_DIP_SPSTx04_Slide_1.27mm_DSHP04 | C40736 | DSHP04TSGET | 1 | 0.5450 | 0.545 | extended
ON | SW201,SW301,SW401,SW501,SW601,SW701,SW801,SW901,SW1001,SW1101,SW1201 | SW_SPDT_Shouhan_MSK12C02 | C431540 | MSK12C02 | 11 | 0.0529 | 0.582 | extended
BIT | TP601 | TestPoint_Loop_RH-5019 | C5199800 | RH-5019 | 1 | 0.0966 | 0.097 | extended
GND | TP9901,TP9902,TP9903,TP9904 | TestPoint_Loop_RH-5019 | C5199800 | RH-5019 | 4 | 0.0966 | 0.386 | extended
OUT | TP201,TP301,TP401,TP501,TP1101,TP1201 | TestPoint_Loop_RH-5019 | C5199800 | RH-5019 | 6 | 0.0966 | 0.580 | extended
LM2664 | U101 | SOT-23-6 | C108573 | LM2664M6X/NOPB | 1 | 0.3346 | 0.335 | extended
3.3V | U102 | SOT-23-5 | C2862740 | TPS7A2033PDBVR | 1 | 0.2097 | 0.210 | extended
OPA847 | U401 | SOT-23-6 | C2059024 | OPA847IDBVT | 1 | 9.5279 | 9.528 | extended
TLV3501 | U601 | SOT-23-6 | C193413 | TLV3501AIDBVR | 1 | 1.9246 | 1.925 | extended
74HC4046A | U701 | TSSOP-16_4.4x5mm_P0.65mm | C546981 | 74HC4046APW-Q100J | 1 | 1.1816 | 1.182 | extended
TMP235 | U801 | SOT-23 | C2868809 | TMP235A4DBZR | 1 | 0.3243 | 0.324 | extended
MC1496 | U901 | SOIC-14_3.9x8.7mm_P1.27mm | C7295 | MC1496DR2G | 1 | 0.2492 | 0.249 | extended
DRV8837 | U1101 | Texas_DSG0008A_WSON-8-1EP_2x2mm_P0.5mm_EP0.9x1.6mm | C39159 | DRV8837DSGR | 1 | 0.2622 | 0.262 | extended
PAM8302A | U1201 | MSOP-8_3x3mm_P0.65mm | C113367 | PAM8302AASCR | 1 | 0.3089 | 0.309 | extended
OPA810 | U201,U301,U501,U1001,U1002,U1102,U1202 | SOT-23-5 | C2833513 | OPA810IDBVR | 7 | 3.0996 | 21.697 | extended
