gallicchio/AMOD-and-RFMOD/out/amod_b/amod_b_bom_costed.csv

Comment | Designator | Footprint | LCSC Part # | MPN | Qty | Unit $ | Ext $ | JLC
220u | C201 | CP_Elec_6.3x7.7 | C2992606 | XT220UF25V90RV0075 | 1 | 0.0534 | 0.053 | extended
1u | C304 | C_0603_1608Metric | C15849 | CL10A105KB8NNNC | 1 | 0.0146 | 0.015 | basic
1n | C801 | C_0402_1005Metric | C1523 | 0402B102K500NT | 1 | 0.0038 | 0.004 | basic
100p | C901 | C_0402_1005Metric | C1546 | 0402CG101J500NT | 1 | 0.0033 | 0.003 | basic
1u | C105,C106 | C_0805_2012Metric | C28323 | CL21B105KBFNNNE | 2 | 0.0341 | 0.068 | basic
10u | C101,C102,C103,C104,C302 | C_0805_2012Metric | C15850 | CL21A106KAYNNNE | 5 | 0.0426 | 0.213 | basic
100n | C301,C303,C305,C401,C402,C501,C502,C503,C601,C602,C603,C1101,C1102,C1201,C1202 | C_0402_1005Metric | C1525 | CL05B104KO5NNNC | 15 | 0.0035 | 0.052 | basic
SMAJ5.0A | D101 | D_SMA | C78401 | SMAJ5.0A | 1 | 0.0537 | 0.054 | extended
SMBJ12A | D201 | D_SMB | C19077565 | SMBJ12A | 1 | 0.0525 | 0.052 | preferred
SS34 | D202,D203 | D_SMA | C8678 | SS34 | 2 | 0.0351 | 0.070 | basic
2A | F101 | Fuse_1812_4532Metric | C210837 | MF-MSMF200-2 | 1 | 0.0650 | 0.065 | extended
USB-C | J101 | USB_C_Receptacle_HRO_TYPE-C-31-M-12 | C165948 | TYPE-C-31-M-12 | 1 | 0.1888 | 0.189 | extended
rails | J102 | PinSocket_1x05_P2.54mm_Vertical | C2894928 | PZ254-1-05-Z-8.5 | 1 | 0.0588 | 0.059 | extended
5-12V | J202 | BarrelJack_DC-005-5A_Horizontal | C381116 | DC-005-5A-2.0 | 1 | 0.2631 | 0.263 | extended
motor | J304 | TerminalBlock_KF301_1x03_P5.00mm | C474882 | KF301-5.0-3P | 1 | 0.1396 | 0.140 | extended
Pmod | J305 | PinHeader_2x06_P2.54mm_Horizontal_PZ254R-12-12P | C492434 | PZ254R-12-12P | 1 | 0.1036 | 0.104 | extended
piezo | J802 | TerminalBlock_KF301_1x02_P5.00mm | C474881 | KF301-5.0-2P | 1 | 0.1017 | 0.102 | extended
SMA | J201,J301,J302,J303,J401,J402,J701,J801,J901,J1001,J1002,J1101,J1201 | SMA_BWSMA-KE-Z001_Vertical | C496549 | BWSMA-KE-Z001 | 13 | 0.4043 | 5.256 | extended
-5V | LED101 | LED_0805_2012Metric_Kbar | C84256 | NCD0805R1 | 1 | 0.0135 | 0.013 | basic
+5V | LED102 | LED_0805_2012Metric_Kbar | C2297 | KT-0805G | 1 | 0.0164 | 0.016 | basic
VM | LED201 | LED_0805_2012Metric_Kbar | C2297 | KT-0805G | 1 | 0.0164 | 0.016 | basic
AO3401A | Q301 | SOT-23 | C15127 | AO3401A | 1 | 0.0959 | 0.096 | basic
15k | R203 | R_0402_1005Metric | C25756 | 0402WGF1502TCE | 1 | 0.0010 | 0.001 | basic
47k | R304 | R_0402_1005Metric | C25792 | 0402WGF4702TCE | 1 | 0.0020 | 0.002 | basic
100k | R306 | R_0402_1005Metric | C25741 | 0402WGF1003TCE | 1 | 0.0015 | 0.002 | basic
180 | R501 | R_0805_2012Metric | C25270 | 0805W8F1800T5E | 1 | 0.0031 | 0.003 | extended
1M | R802 | R_0805_2012Metric | C17514 | 0805W8F1004T5E | 1 | 0.0038 | 0.004 | basic
100 | R902 | R_0402_1005Metric | C25076 | 0402WGF1000TCE | 1 | 0.0012 | 0.001 | basic
0.05 | R1101 | R_1206_3216Metric | C127691 | 1206W3F500MT5E | 1 | 0.0110 | 0.011 | extended
0.1 | R1201 | R_1206_3216Metric | C25334 | 1206W4F100LT5E | 1 | 0.0080 | 0.008 | basic
2k | R1207 | R_0402_1005Metric | C4109 | 0402WGF2001TCE | 1 | 0.0026 | 0.003 | basic
5.1k | R101,R102 | R_0805_2012Metric | C27834 | 0805W8F5101T5E | 2 | 0.0036 | 0.007 | basic
1k | R103,R104 | R_0805_2012Metric | C17513 | 0805W8F1001T5E | 2 | 0.0035 | 0.007 | basic
4.7k | R204,R901 | R_0402_1005Metric | C25900 | 0402WGF4701TCE | 2 | 0.0021 | 0.004 | basic
3.3k | R307,R309 | R_0402_1005Metric | C25890 | 0402WGF3301TCE | 2 | 0.0036 | 0.007 | basic
5.1k | R702,R705 | R_0402_1005Metric | C25905 | 0402WGF5101TCE | 2 | 0.0023 | 0.005 | basic
13k | R401,R403,R405 | R_0402_1005Metric | C25754 | 0402WGF1302TCE | 3 | 0.0023 | 0.007 | extended
3.9k | R1002,R1005,R1008,R1011 | R_0402_1005Metric | C51721 | 0402WGF3901TCE | 4 | 0.0012 | 0.005 | extended
1k | R202,R402,R404,R406,R801,R1202,R1203 | R_0402_1005Metric | C11702 | 0402WGF1001TCE | 7 | 0.0013 | 0.009 | basic
20k | R703,R704,R1003,R1004,R1009,R1010,R1104,R1105,R1204 | R_0402_1005Metric | C25765 | 0402WGF2002TCE | 9 | 0.0011 | 0.010 | basic
49.9 | R201,R301,R407,R408,R706,R803,R903,R1006,R1012,R1107,R1208 | R_0402_1005Metric | C844112 | CRCW040249R9FKEDHP | 11 | 0.0318 | 0.350 | extended
10k | R302,R303,R305,R308,R310,R701,R1001,R1007,R1102,R1103,R1106,R1205,R1206 | R_0402_1005Metric | C25744 | 0402WGF1002TCE | 13 | 0.0011 | 0.014 | basic
ON | SW301 | SW_SPDT_Shouhan_MSK12C02 | C431540 | MSK12C02 | 1 | 0.0529 | 0.053 | extended
GND | TP9901,TP9902 | TestPoint_Loop_RH-5019 | C5199800 | RH-5019 | 2 | 0.0966 | 0.193 | extended
LM2664 | U101 | SOT-23-6 | C108573 | LM2664M6X/NOPB | 1 | 0.3346 | 0.335 | extended
3.3V | U102 | SOT-23-5 | C2862740 | TPS7A2033PDBVR | 1 | 0.2097 | 0.210 | extended
DRV8311H | U301 | Texas_RRW0024A_WQFN-24-1EP_3x3mm_P0.4mm_EP1.9x1.9mm | C5218862 | DRV8311HRRWR | 1 | 1.3773 | 1.377 | extended
TLV3501 | U302 | SOT-23-6 | C193413 | TLV3501AIDBVR | 1 | 1.9246 | 1.925 | extended
OPA2171 | U401 | SOIC-8_3.9x4.9mm_P1.27mm | C40904 | OPA2171AIDR | 1 | 0.3423 | 0.342 | extended
MT6701 | U501 | SOIC-8_3.9x4.9mm_P1.27mm | C3003196 | MT6701CT-STD-R | 1 | 1.7343 | 1.734 | extended
QRE1113 | U504 | OnSemi_CASE100CY | C232862 | QRE1113GR | 1 | 0.7354 | 0.735 | extended
LSM6DSO | U601 | LGA-14_3x2.5mm_P0.5mm_LayoutBorder3x4y | C2655100 | LSM6DSOTR | 1 | 3.9926 | 3.993 | extended
74LVC1G125 | U602 | SOT-23-5 | C23654 | SN74LVC1G125DBVR | 1 | 0.0667 | 0.067 | extended
INA240 | U1101 | SOIC-8_3.9x4.9mm_P1.27mm | C2060769 | INA240A1DR | 1 | 0.9008 | 0.901 | extended
INA181 | U1201 | SOT-23-6 | C2058943 | INA181A1IDBVR | 1 | 0.4717 | 0.472 | extended
DRV5055 | U502,U503 | SOT-23 | C266128 | DRV5055A3QDBZR | 2 | 0.5241 | 1.048 | extended
OPA810 | U701,U801,U901,U1001,U1002,U1102,U1202 | SOT-23-5 | C2833513 | OPA810IDBVR | 7 | 3.0996 | 21.697 | extended
