gallicchio/AMOD-and-RFMOD/out/amod_m/amod_m_bom_costed.csv

Comment | Designator | Footprint | LCSC Part # | MPN | Qty | Unit $ | Ext $ | JLC
220u | C201 | CP_Elec_6.3x7.7 | C2992606 | XT220UF25V90RV0075 | 1 | 0.0534 | 0.053 | extended
220n | C804 | C_0402_1005Metric | C16772 | CL05B224KO5NNNC | 1 | 0.0047 | 0.005 | basic
100p | C1001 | C_0402_1005Metric | C1546 | 0402CG101J500NT | 1 | 0.0033 | 0.003 | basic
1u | C105,C106 | C_0805_2012Metric | C28323 | CL21B105KBFNNNE | 2 | 0.0341 | 0.068 | basic
1u | C305,C306,C805 | C_0603_1608Metric | C15849 | CL10A105KB8NNNC | 3 | 0.0146 | 0.044 | basic
22u | C803,C806,C807 | C_1206_3216Metric | C12891 | CL31A226KAHNNNE | 3 | 0.1673 | 0.502 | basic
10u | C101,C102,C103,C104,C302,C403,C502,C603,C701,C801 | C_0805_2012Metric | C15850 | CL21A106KAYNNNE | 10 | 0.0426 | 0.426 | basic
100n | C301,C303,C304,C401,C402,C501,C601,C602,C702,C703,C704,C705,C706,C707,C802,C808,C901,C902,C903,C1002,C1003,C1101,C1102 | C_0402_1005Metric | C1525 | CL05B104KO5NNNC | 23 | 0.0035 | 0.081 | basic
SMAJ5.0A | D101 | D_SMA | C78401 | SMAJ5.0A | 1 | 0.0537 | 0.054 | extended
SMBJ16A | D201 | D_SMB | C353386 | SMBJ16A | 1 | 0.0395 | 0.040 | extended
B5819W | D601 | D_SOD-123 | C64885 | B5819W | 1 | 0.0195 | 0.019 | extended
SMAJ24A | D602 | D_SMA | C113962 | SMAJ24A | 1 | 0.0407 | 0.041 | extended
SS34 | D202,D203 | D_SMA | C8678 | SS34 | 2 | 0.0351 | 0.070 | basic
2A | F101 | Fuse_1812_4532Metric | C210837 | MF-MSMF200-2 | 1 | 0.0650 | 0.065 | extended
USB-C | J101 | USB_C_Receptacle_HRO_TYPE-C-31-M-12 | C165948 | TYPE-C-31-M-12 | 1 | 0.1888 | 0.189 | extended
rails | J102 | PinSocket_1x05_P2.54mm_Vertical | C2894928 | PZ254-1-05-Z-8.5 | 1 | 0.0588 | 0.059 | extended
5-16V | J202 | BarrelJack_DC-005-5A_Horizontal | C381116 | DC-005-5A-2.0 | 1 | 0.2631 | 0.263 | extended
motor | J303 | JST_PH_B6B-PH-K_1x06_P2.00mm_Vertical | C131342 | B6B-PH-K-S(LF)(SN) | 1 | 0.0728 | 0.073 | extended
Pmod | J304 | PinHeader_2x06_P2.54mm_Horizontal_PZ254R-12-12P | C492434 | PZ254R-12-12P | 1 | 0.1036 | 0.104 | extended
stepper | J403 | JST_XH_B4B-XH-A_1x04_P2.50mm_Vertical | C144395 | B4B-XH-A(LF)(SN) | 1 | 0.0569 | 0.057 | extended
servo | J503 | PinHeader_1x03_P2.54mm_Vertical | C2937625 | PZ254V-11-03P | 1 | 0.0199 | 0.020 | extended
coil | J604 | TerminalBlock_KF301_1x02_P5.00mm | C474881 | KF301-5.0-2P | 1 | 0.1017 | 0.102 | extended
D Z | J605 | PinHeader_1x03_P2.54mm_Vertical | C2937625 | PZ254V-11-03P | 1 | 0.0199 | 0.020 | extended
load | J703 | TerminalBlock_KF301_1x02_P5.00mm | C474881 | KF301-5.0-2P | 1 | 0.1017 | 0.102 | extended
out | J804 | TerminalBlock_KF301_1x02_P5.00mm | C474881 | KF301-5.0-2P | 1 | 0.1017 | 0.102 | extended
cell | J1102 | JST_XH_B4B-XH-A_1x04_P2.50mm_Vertical | C144395 | B4B-XH-A(LF)(SN) | 1 | 0.0569 | 0.057 | extended
SMA | J201,J301,J302,J401,J402,J501,J502,J601,J602,J603,J701,J702,J801,J802,J803,J901,J1001,J1101 | SMA_BWSMA-KE-Z001_Vertical | C496549 | BWSMA-KE-Z001 | 18 | 0.4043 | 7.277 | extended
47u | L801 | L_6x6_SWPA6045 | C36414 | SWPA6045S470MT | 1 | 0.0801 | 0.080 | extended
-5V | LED101 | LED_0805_2012Metric_Kbar | C84256 | NCD0805R1 | 1 | 0.0135 | 0.013 | basic
+5V | LED102 | LED_0805_2012Metric_Kbar | C2297 | KT-0805G | 1 | 0.0164 | 0.016 | basic
VM | LED201 | LED_0805_2012Metric_Kbar | C2297 | KT-0805G | 1 | 0.0164 | 0.016 | basic
NCE6020AK | Q602 | TO-252-2 | C108639 | NCE6020AK | 1 | 0.1560 | 0.156 | extended
AO3400A | Q802,Q803 | SOT-23 | C20917 | AO3400A | 2 | 0.0889 | 0.178 | basic
AO3401A | Q301,Q401,Q501,Q601,Q801,Q901,Q1001 | SOT-23 | C15127 | AO3401A | 7 | 0.0959 | 0.671 | basic
4.7k | R204 | R_0402_1005Metric | C25900 | 0402WGF4701TCE | 1 | 0.0021 | 0.002 | basic
1.5k | R302 | R_0402_1005Metric | C25867 | 0402WGF1501TCE | 1 | 0.0029 | 0.003 | basic
0.1 | R710 | R_1206_3216Metric | C25334 | 1206W4F100LT5E | 1 | 0.0080 | 0.008 | basic
2k | R716 | R_0402_1005Metric | C4109 | 0402WGF2001TCE | 1 | 0.0026 | 0.003 | basic
180 | R1002 | R_0805_2012Metric | C25270 | 0805W8F1800T5E | 1 | 0.0031 | 0.003 | extended
249 | R1101 | R_0402_1005Metric | C25096 | 0402WGF2490TCE | 1 | 0.0015 | 0.002 | extended
1k | R103,R104 | R_0805_2012Metric | C17513 | 0805W8F1001T5E | 2 | 0.0035 | 0.007 | basic
13k | R308,R309 | R_0402_1005Metric | C25754 | 0402WGF1302TCE | 2 | 0.0023 | 0.005 | extended
100k | R606,R805 | R_0402_1005Metric | C25741 | 0402WGF1003TCE | 2 | 0.0015 | 0.003 | basic
100 | R610,R1001 | R_0402_1005Metric | C25076 | 0402WGF1000TCE | 2 | 0.0012 | 0.002 | basic
5.1k | R101,R102,R609 | R_0805_2012Metric | C27834 | 0805W8F5101T5E | 3 | 0.0036 | 0.011 | basic
620 | R303,R403,R406 | R_0402_1005Metric | C4961 | 0402WGF6200TCE | 3 | 0.0019 | 0.006 | extended
47k | R503,R603,R803 | R_0402_1005Metric | C25792 | 0402WGF4702TCE | 3 | 0.0020 | 0.006 | basic
5.1k | R504,R604,R804 | R_0402_1005Metric | C25905 | 0402WGF5101TCE | 3 | 0.0023 | 0.007 | basic
0.05 | R505,R607,R806 | R_1206_3216Metric | C127691 | 1206W3F500MT5E | 3 | 0.0110 | 0.033 | extended
15k | R203,R701,R702,R808 | R_0402_1005Metric | C25756 | 0402WGF1502TCE | 4 | 0.0010 | 0.004 | basic
3.9k | R402,R405,R902,R905 | R_0402_1005Metric | C51721 | 0402WGF3901TCE | 4 | 0.0012 | 0.005 | extended
20k | R703,R707,R713,R903,R904 | R_0402_1005Metric | C25765 | 0402WGF2002TCE | 5 | 0.0011 | 0.006 | basic
1k | R202,R301,R305,R307,R401,R404,R711,R712,R809,R1003 | R_0402_1005Metric | C11702 | 0402WGF1001TCE | 10 | 0.0013 | 0.013 | basic
10k | R407,R408,R502,R602,R704,R706,R708,R709,R714,R715,R802,R901 | R_0402_1005Metric | C25744 | 0402WGF1002TCE | 12 | 0.0011 | 0.013 | basic
49.9 | R201,R304,R306,R501,R506,R601,R605,R608,R611,R705,R717,R801,R807,R810,R906,R1004,R1102 | R_0402_1005Metric | C844112 | CRCW040249R9FKEDHP | 17 | 0.0318 | 0.541 | extended
ON | SW301,SW401,SW501,SW601,SW801,SW901,SW1001 | SW_SPDT_Shouhan_MSK12C02 | C431540 | MSK12C02 | 7 | 0.0529 | 0.370 | extended
GND | TP9901,TP9902 | TestPoint_Loop_RH-5019 | C5199800 | RH-5019 | 2 | 0.0966 | 0.193 | extended
LM2664 | U101 | SOT-23-6 | C108573 | LM2664M6X/NOPB | 1 | 0.3346 | 0.335 | extended
OPA2171 | U302 | SOIC-8_3.9x4.9mm_P1.27mm | C40904 | OPA2171AIDR | 1 | 0.3423 | 0.342 | extended
TCA0372 | U701 | SOIC-16W_7.5x10.3mm_P1.27mm | C362060 | TCA0372DWR2G | 1 | 1.1775 | 1.177 | extended
TPS28225 | U802 | SOIC-8_3.9x4.9mm_P1.27mm | C52897 | TPS28225DR | 1 | 0.8565 | 0.857 | extended
DRV5055 | U901 | SOT-23 | C266128 | DRV5055A3QDBZR | 1 | 0.5241 | 0.524 | extended
QRE1113 | U1001 | OnSemi_CASE100CY | C232862 | QRE1113GR | 1 | 0.7354 | 0.735 | extended
INA828 | U1101 | SOIC-8_3.9x4.9mm_P1.27mm | C544342 | INA828IDR | 1 | 1.5394 | 1.539 | extended
3.3V | U102,U303 | SOT-23-5 | C2862740 | TPS7A2033PDBVR | 2 | 0.2097 | 0.419 | extended
DRV8251A | U301,U401,U402 | HSOP-8-1EP_3.9x4.9mm_P1.27mm_EP2.41x3.1mm | C5218844 | DRV8251ADDAR | 3 | 0.4420 | 1.326 | extended
TLV3501 | U501,U601,U801 | SOT-23-6 | C193413 | TLV3501AIDBVR | 3 | 1.9246 | 5.774 | extended
OPA810 | U703,U902,U1002 | SOT-23-5 | C2833513 | OPA810IDBVR | 3 | 3.0996 | 9.299 | extended
INA181 | U502,U602,U702,U803 | SOT-23-6 | C2058943 | INA181A1IDBVR | 4 | 0.4717 | 1.887 | extended
