gallicchio/AMOD-and-RFMOD/out/amod_n/amod_n_bom_jlcpcb_upload.csv

Comment | Designator | Footprint | LCSC Part #
10n | C601 | C_0402_1005Metric | C15195
100p | C602 | C_0402_1005Metric | C1546
22p | C903 | C_0402_1005Metric | C1555
1n | C904 | C_0402_1005Metric | C1523
2.2p | C905 | C_0402_1005Metric | C1559
220p | C901,C902 | C_0402_1005Metric | C39122
100n | C701,C702,C801,C802,C803,C906 | C_0402_1005Metric | C1525
SMS7630 | D601 | SOT-23 | C6489012
BB133 | D901 | D_SOD-323 | C5334579
LFCN-1000+ | FL501 | Filter_LTCC_1206_LFCN | C879868
Pmod | J803 | PinHeader_2x06_P2.54mm_Horizontal_PZ254R-12-12P | C492434
SMA | J101,J102,J103,J104,J105,J106,J201,J202,J203,J301,J302,J303,J401,J402,J501,J502,J601,J602,J701,J702,J801,J802,J901,J902,J1001,J1002,J1101,J1102 | SMA_BWSMA-KE-Z001_Vertical | C496549
27n | L701 | L_0402_1005Metric | C882469
330n | L702 | L_0603_1608Metric | C142165
10u | L703,L901 | L_1210_3225Metric | C76835
AO3401A | Q901 | SOT-23 | C15127
MMBT3904 | Q902 | SOT-23 | C20526
51 | R601 | R_0402_1005Metric | C25125
680 | R901 | R_0402_1005Metric | C25130
200 | R1101 | R_0402_1005Metric | C25087
100 | R101,R102 | R_0402_1005Metric | C25076
16.9 | R201,R202,R203 | R_0402_1005Metric | C82287
49.9 | R103,R104,R1102 | R_0402_1005Metric | C844112
100k | R602,R801,R802,R803,R804,R805,R806,R807,R808,R809,R902,R903,R904 | R_0402_1005Metric | C25741
SPI / dB | SW801 | SW_DIP_SPSTx08_Slide_1.27mm_DSHP08 | C40738
ON | SW901 | SW_SPDT_Shouhan_MSK12C02 | C431540
LOAD | SW1101 | SW_DIP_SPSTx02_Slide_1.27mm_DSHP02 | C40735
TC1-1TG2+ | T1001 | MiniCircuits_AT224_5P | C3305009
TC4-1W+ | T1101 | MiniCircuits_AT224_5P | C879855
DC | TP701 | TestPoint_Loop_RH-5019 | C5199800
GND | TP702,TP9901,TP9902,TP9903,TP9904 | TestPoint_Loop_RH-5019 | C5199800
ADP-2-1+ | U301 | MiniCircuits_CD636_ADP-2-1 | C2683460
PE43711 | U801 | QFN-24-1EP_4x4mm_P0.5mm_EP2.7x2.7mm | C470929
