gallicchio/AMOD-and-RFMOD/docs/MANUFACTURING.md

# Manufacturing: ordering the boards at JLCPCB

Generated by `scripts/gen_docs.py` from the fab packages in `out/`.  Rev A, 2026-10-25.  Five boards of each, two
assembled, is the order Appendix D asked for; the cost lines below are the parts of one assembled board at JLCPCB's
unit prices on the day the stock was checked (`scripts/jlc_cache.json` has the time of every answer).

## AMOD-P: the passive board

- Gerbers and drills: `out/amod_p/amod_p-gerbers.zip` (upload as the PCB file).
- Board: 100 x 100 mm, 2 layers, 1.6 mm, JLCPCB's standard stack.
- BOM: `out/amod_p/amod_p_bom_jlcpcb_upload.csv`; placements: `out/amod_p/amod_p_cpl_jlcpcb_upload.csv` (rotations already turned
  for JLCPCB's conventions; the native KiCad file is beside it).
- Assembly: top side only, every part from JLCPCB's shelf, nothing hand-soldered.  42 BOM lines, 31 of them
  extended parts (each adds JLCPCB's loading fee).
- Parts per board: $17.07.  Read `out/amod_p/amod_p-assembly-notes.txt` before confirming the order.

### Order steps

1. Order now > PCB: upload the gerber zip; 100 x 100 mm, 2 layers, 1.6 mm, any colour, HASL or ENIG, 5 pieces.
   Specify Stackup: No (two layers: no stack to choose).
   Min via hole size: the default 0.3mm/(0.4/0.45mm); every via is 0.3 mm in 0.6 mm.
   Via covering: Plugged (the default) is fine: the design assumes tented vias, and plugged is better.
2. PCB assembly: economic, top side, 2 pieces; upload the BOM and placement files; confirm the parts list (check
   every line against the notes: the DIP switches and the LEDs have printed orientation, the SMA and terminals are
   through-hole and must be selected for assembly).
3. Check the placement preview against `docs/images/amod_p-render-top.png`: polarised parts (diodes, LEDs, ICs' pin 1).
4. Pay; keep the order number in the chat log.

## AMOD-N: the second passive board

- Gerbers and drills: `out/amod_n/amod_n-gerbers.zip` (upload as the PCB file).
- Board: 100 x 100 mm, 4 layers, 1.6 mm, JLCPCB's standard stack (JLC04161H-7628 for the RF lines).
- BOM: `out/amod_n/amod_n_bom_jlcpcb_upload.csv`; placements: `out/amod_n/amod_n_cpl_jlcpcb_upload.csv` (rotations already turned
  for JLCPCB's conventions; the native KiCad file is beside it).
- Assembly: top side only, every part from JLCPCB's shelf, nothing hand-soldered.  33 BOM lines, 22 of them
  extended parts (each adds JLCPCB's loading fee).
- Parts per board: $43.91.  Read `out/amod_n/amod_n-assembly-notes.txt` before confirming the order.

### Order steps

1. Order now > PCB: upload the gerber zip; 100 x 100 mm, 4 layers, 1.6 mm, any colour, HASL or ENIG, 5 pieces.
   Specify Stackup: Yes, JLC04161H-7628 ("No requirement" is the same construction: 0.2104 mm of 7628 prepreg under
   L1, a 1.065 mm core, 1 oz outer and 0.5 oz inner copper; jlcpcb.com/impedance, 2026-10-29).  Impedance Control: No
   requirement: the lines are drawn for that stack (0.29 mm, 0.25 mm to the pour, about 54 ohm by CostasLink's field
   solve of the same geometry), and the service would let the fab change their widths.
   Min via hole size: 0.25mm/(0.35/0.4mm); this board's fine rules use 0.25 mm holes in 0.45 mm vias.  JLCPCB then
   selects FR4 TG155 and a 4-wire Kelvin test itself: about $38 more for five boards (RF-MOD's quote, 2026-10-29).
   Via covering: Plugged (the default) is fine: the design assumes tented vias, and plugged is better.
2. PCB assembly: economic, top side, 2 pieces; upload the BOM and placement files; confirm the parts list (check
   every line against the notes: the DIP switches and the LEDs have printed orientation, the SMA and terminals are
   through-hole and must be selected for assembly).
3. Check the placement preview against `docs/images/amod_n-render-top.png`: polarised parts (diodes, LEDs, ICs' pin 1).
4. Pay; keep the order number in the chat log.

## AMOD-A: the active board

- Gerbers and drills: `out/amod_a/amod_a-gerbers.zip` (upload as the PCB file).
- Board: 100 x 100 mm, 4 layers, 1.6 mm, JLCPCB's standard stack.
- BOM: `out/amod_a/amod_a_bom_jlcpcb_upload.csv`; placements: `out/amod_a/amod_a_cpl_jlcpcb_upload.csv` (rotations already turned
  for JLCPCB's conventions; the native KiCad file is beside it).
- Assembly: top side only, every part from JLCPCB's shelf, nothing hand-soldered.  61 BOM lines, 32 of them
  extended parts (each adds JLCPCB's loading fee).
- Parts per board: $49.74.  Read `out/amod_a/amod_a-assembly-notes.txt` before confirming the order.

### Order steps

1. Order now > PCB: upload the gerber zip; 100 x 100 mm, 4 layers, 1.6 mm, any colour, HASL or ENIG, 5 pieces.
   Specify Stackup: Yes, JLC04161H-7628 ("No requirement" is the same construction: 0.2104 mm of 7628 prepreg under
   L1, a 1.065 mm core, 1 oz outer and 0.5 oz inner copper; jlcpcb.com/impedance, 2026-10-29).  Impedance Control: No
   requirement: the lines are drawn for that stack (0.29 mm, 0.25 mm to the pour, about 54 ohm by CostasLink's field
   solve of the same geometry), and the service would let the fab change their widths.
   Min via hole size: the default 0.3mm/(0.4/0.45mm); every via is 0.3 mm in 0.6 mm.
   Via covering: Plugged (the default) is fine: the design assumes tented vias, and plugged is better.
2. PCB assembly: economic, top side, 2 pieces; upload the BOM and placement files; confirm the parts list (check
   every line against the notes: the DIP switches and the LEDs have printed orientation, the SMA and terminals are
   through-hole and must be selected for assembly).
3. Check the placement preview against `docs/images/amod_a-render-top.png`: polarised parts (diodes, LEDs, ICs' pin 1).
4. Pay; keep the order number in the chat log.

## AMOD-C: the conversion board

- Gerbers and drills: `out/amod_c/amod_c-gerbers.zip` (upload as the PCB file).
- Board: 100 x 100 mm, 4 layers, 1.6 mm, JLCPCB's standard stack.
- BOM: `out/amod_c/amod_c_bom_jlcpcb_upload.csv`; placements: `out/amod_c/amod_c_cpl_jlcpcb_upload.csv` (rotations already turned
  for JLCPCB's conventions; the native KiCad file is beside it).
- Assembly: top side only, every part from JLCPCB's shelf, nothing hand-soldered.  67 BOM lines, 42 of them
  extended parts (each adds JLCPCB's loading fee).
- Parts per board: $43.93.  Read `out/amod_c/amod_c-assembly-notes.txt` before confirming the order.

### Order steps

1. Order now > PCB: upload the gerber zip; 100 x 100 mm, 4 layers, 1.6 mm, any colour, HASL or ENIG, 5 pieces.
   Specify Stackup: Yes, JLC04161H-7628 ("No requirement" is the same construction: 0.2104 mm of 7628 prepreg under
   L1, a 1.065 mm core, 1 oz outer and 0.5 oz inner copper; jlcpcb.com/impedance, 2026-10-29).  Impedance Control: No
   requirement: the lines are drawn for that stack (0.29 mm, 0.25 mm to the pour, about 54 ohm by CostasLink's field
   solve of the same geometry), and the service would let the fab change their widths.
   Min via hole size: the default 0.3mm/(0.4/0.45mm); every via is 0.3 mm in 0.6 mm.
   Via covering: Plugged (the default) is fine: the design assumes tented vias, and plugged is better.
2. PCB assembly: economic, top side, 2 pieces; upload the BOM and placement files; confirm the parts list (check
   every line against the notes: the DIP switches and the LEDs have printed orientation, the SMA and terminals are
   through-hole and must be selected for assembly).
3. Check the placement preview against `docs/images/amod_c-render-top.png`: polarised parts (diodes, LEDs, ICs' pin 1).
4. Pay; keep the order number in the chat log.

## AMOD-M: the motor board

- Gerbers and drills: `out/amod_m/amod_m-gerbers.zip` (upload as the PCB file).
- Board: 100 x 100 mm, 4 layers, 1.6 mm, JLCPCB's standard stack.
- BOM: `out/amod_m/amod_m_bom_jlcpcb_upload.csv`; placements: `out/amod_m/amod_m_cpl_jlcpcb_upload.csv` (rotations already turned
  for JLCPCB's conventions; the native KiCad file is beside it).
- Assembly: top side only, every part from JLCPCB's shelf, nothing hand-soldered.  69 BOM lines, 42 of them
  extended parts (each adds JLCPCB's loading fee).
- Parts per board: $36.49.  Read `out/amod_m/amod_m-assembly-notes.txt` before confirming the order.

### Order steps

1. Order now > PCB: upload the gerber zip; 100 x 100 mm, 4 layers, 1.6 mm, any colour, HASL or ENIG, 5 pieces.
   Specify Stackup: Yes, JLC04161H-7628 ("No requirement" is the same construction: 0.2104 mm of 7628 prepreg under
   L1, a 1.065 mm core, 1 oz outer and 0.5 oz inner copper; jlcpcb.com/impedance, 2026-10-29).  Impedance Control: No
   requirement: the lines are drawn for that stack (0.29 mm, 0.25 mm to the pour, about 54 ohm by CostasLink's field
   solve of the same geometry), and the service would let the fab change their widths.
   Min via hole size: the default 0.3mm/(0.4/0.45mm); every via is 0.3 mm in 0.6 mm.
   Via covering: Plugged (the default) is fine: the design assumes tented vias, and plugged is better.
2. PCB assembly: economic, top side, 2 pieces; upload the BOM and placement files; confirm the parts list (check
   every line against the notes: the DIP switches and the LEDs have printed orientation, the SMA and terminals are
   through-hole and must be selected for assembly).
3. Check the placement preview against `docs/images/amod_m-render-top.png`: polarised parts (diodes, LEDs, ICs' pin 1).
4. Pay; keep the order number in the chat log.

## AMOD-B: the brushless board

- Gerbers and drills: `out/amod_b/amod_b-gerbers.zip` (upload as the PCB file).
- Board: 100 x 100 mm, 4 layers, 1.6 mm, JLCPCB's standard stack.
- BOM: `out/amod_b/amod_b_bom_jlcpcb_upload.csv`; placements: `out/amod_b/amod_b_cpl_jlcpcb_upload.csv` (rotations already turned
  for JLCPCB's conventions; the native KiCad file is beside it).
- Assembly: top side only, every part from JLCPCB's shelf, nothing hand-soldered.  57 BOM lines, 30 of them
  extended parts (each adds JLCPCB's loading fee).
- Parts per board: $42.45.  Read `out/amod_b/amod_b-assembly-notes.txt` before confirming the order.

### Order steps

1. Order now > PCB: upload the gerber zip; 100 x 100 mm, 4 layers, 1.6 mm, any colour, HASL or ENIG, 5 pieces.
   Specify Stackup: Yes, JLC04161H-7628 ("No requirement" is the same construction: 0.2104 mm of 7628 prepreg under
   L1, a 1.065 mm core, 1 oz outer and 0.5 oz inner copper; jlcpcb.com/impedance, 2026-10-29).  Impedance Control: No
   requirement: the lines are drawn for that stack (0.29 mm, 0.25 mm to the pour, about 54 ohm by CostasLink's field
   solve of the same geometry), and the service would let the fab change their widths.
   Min via hole size: 0.25mm/(0.35/0.4mm); this board's fine rules use 0.25 mm holes in 0.45 mm vias.  JLCPCB then
   selects FR4 TG155 and a 4-wire Kelvin test itself: about $38 more for five boards (RF-MOD's quote, 2026-10-29).
   Via covering: Plugged (the default) is fine: the design assumes tented vias, and plugged is better.
2. PCB assembly: economic, top side, 2 pieces; upload the BOM and placement files; confirm the parts list (check
   every line against the notes: the DIP switches and the LEDs have printed orientation, the SMA and terminals are
   through-hole and must be selected for assembly).
3. Check the placement preview against `docs/images/amod_b-render-top.png`: polarised parts (diodes, LEDs, ICs' pin 1).
4. Pay; keep the order number in the chat log.

## RF-MOD: the RF board

- Gerbers and drills: `out/rf_mod/rf_mod-gerbers.zip` (upload as the PCB file).
- Board: 100 x 100 mm, 4 layers, 1.6 mm, JLCPCB's standard stack (JLC04161H-7628 for the RF lines).
- BOM: `out/rf_mod/rf_mod_bom_jlcpcb_upload.csv`; placements: `out/rf_mod/rf_mod_cpl_jlcpcb_upload.csv` (rotations already turned
  for JLCPCB's conventions; the native KiCad file is beside it).
- Assembly: top side only, every part from JLCPCB's shelf, nothing hand-soldered.  64 BOM lines, 38 of them
  extended parts (each adds JLCPCB's loading fee).
- Parts per board: $66.51.  Read `out/rf_mod/rf_mod-assembly-notes.txt` before confirming the order.

### Order steps

1. Order now > PCB: upload the gerber zip; 100 x 100 mm, 4 layers, 1.6 mm, any colour, HASL or ENIG, 5 pieces.
   Specify Stackup: Yes, JLC04161H-7628 ("No requirement" is the same construction: 0.2104 mm of 7628 prepreg under
   L1, a 1.065 mm core, 1 oz outer and 0.5 oz inner copper; jlcpcb.com/impedance, 2026-10-29).  Impedance Control: No
   requirement: the lines are drawn for that stack (0.29 mm, 0.25 mm to the pour, about 54 ohm by CostasLink's field
   solve of the same geometry), and the service would let the fab change their widths.
   Min via hole size: 0.25mm/(0.35/0.4mm); this board's fine rules use 0.25 mm holes in 0.45 mm vias.  JLCPCB then
   selects FR4 TG155 and a 4-wire Kelvin test itself: about $38 more for five boards (RF-MOD's quote, 2026-10-29).
   Via covering: Plugged (the default) is fine: the design assumes tented vias, and plugged is better.
2. PCB assembly: economic, top side, 2 pieces; upload the BOM and placement files; confirm the parts list (check
   every line against the notes: the DIP switches and the LEDs have printed orientation, the SMA and terminals are
   through-hole and must be selected for assembly).
3. Check the placement preview against `docs/images/rf_mod-render-top.png`: polarised parts (diodes, LEDs, ICs' pin 1).
4. Pay; keep the order number in the chat log.

## PhMOD: the physics board

- Gerbers and drills: `out/phmod/phmod-gerbers.zip` (upload as the PCB file).
- Board: 100 x 100 mm, 4 layers, 1.6 mm, JLCPCB's standard stack.
- BOM: `out/phmod/phmod_bom_jlcpcb_upload.csv`; placements: `out/phmod/phmod_cpl_jlcpcb_upload.csv` (rotations already turned
  for JLCPCB's conventions; the native KiCad file is beside it).
- Assembly: top side only, every part from JLCPCB's shelf, nothing hand-soldered.  76 BOM lines, 41 of them
  extended parts (each adds JLCPCB's loading fee).
- Parts per board: $77.89.  Read `out/phmod/phmod-assembly-notes.txt` before confirming the order.

### Order steps

1. Order now > PCB: upload the gerber zip; 100 x 100 mm, 4 layers, 1.6 mm, any colour, HASL or ENIG, 5 pieces.
   Specify Stackup: Yes, JLC04161H-7628 ("No requirement" is the same construction: 0.2104 mm of 7628 prepreg under
   L1, a 1.065 mm core, 1 oz outer and 0.5 oz inner copper; jlcpcb.com/impedance, 2026-10-29).  Impedance Control: No
   requirement: the lines are drawn for that stack (0.29 mm, 0.25 mm to the pour, about 54 ohm by CostasLink's field
   solve of the same geometry), and the service would let the fab change their widths.
   Min via hole size: 0.25mm/(0.35/0.4mm); this board's fine rules use 0.25 mm holes in 0.45 mm vias.  JLCPCB then
   selects FR4 TG155 and a 4-wire Kelvin test itself: about $38 more for five boards (RF-MOD's quote, 2026-10-29).
   Via covering: Plugged (the default) is fine: the design assumes tented vias, and plugged is better.
2. PCB assembly: economic, top side, 2 pieces; upload the BOM and placement files; confirm the parts list (check
   every line against the notes: the DIP switches and the LEDs have printed orientation, the SMA and terminals are
   through-hole and must be selected for assembly).
3. Check the placement preview against `docs/images/phmod-render-top.png`: polarised parts (diodes, LEDs, ICs' pin 1).
4. Pay; keep the order number in the chat log.

## IQ-MOD: the second-level RF board

- Gerbers and drills: `out/iq_mod/iq_mod-gerbers.zip` (upload as the PCB file).
- Board: 100 x 100 mm, 4 layers, 1.6 mm, JLCPCB's standard stack (JLC04161H-7628 for the RF lines).
- BOM: `out/iq_mod/iq_mod_bom_jlcpcb_upload.csv`; placements: `out/iq_mod/iq_mod_cpl_jlcpcb_upload.csv` (rotations already turned
  for JLCPCB's conventions; the native KiCad file is beside it).
- Assembly: top side only, every part from JLCPCB's shelf, nothing hand-soldered.  63 BOM lines, 39 of them
  extended parts (each adds JLCPCB's loading fee).
- Parts per board: $99.71.  Read `out/iq_mod/iq_mod-assembly-notes.txt` before confirming the order.

### Order steps

1. Order now > PCB: upload the gerber zip; 100 x 100 mm, 4 layers, 1.6 mm, any colour, HASL or ENIG, 5 pieces.
   Specify Stackup: Yes, JLC04161H-7628 ("No requirement" is the same construction: 0.2104 mm of 7628 prepreg under
   L1, a 1.065 mm core, 1 oz outer and 0.5 oz inner copper; jlcpcb.com/impedance, 2026-10-29).  Impedance Control: No
   requirement: the lines are drawn for that stack (0.29 mm, 0.25 mm to the pour, about 54 ohm by CostasLink's field
   solve of the same geometry), and the service would let the fab change their widths.
   Min via hole size: 0.25mm/(0.35/0.4mm); this board's fine rules use 0.25 mm holes in 0.45 mm vias.  JLCPCB then
   selects FR4 TG155 and a 4-wire Kelvin test itself: about $38 more for five boards (RF-MOD's quote, 2026-10-29).
   Via covering: Plugged (the default) is fine: the design assumes tented vias, and plugged is better.
2. PCB assembly: economic, top side, 2 pieces; upload the BOM and placement files; confirm the parts list (check
   every line against the notes: the DIP switches and the LEDs have printed orientation, the SMA and terminals are
   through-hole and must be selected for assembly).
3. Check the placement preview against `docs/images/iq_mod-render-top.png`: polarised parts (diodes, LEDs, ICs' pin 1).
4. Pay; keep the order number in the chat log.
