gallicchio/AMOD-and-RFMOD/out/amod_a/amod_a-assembly-bottom.pdf

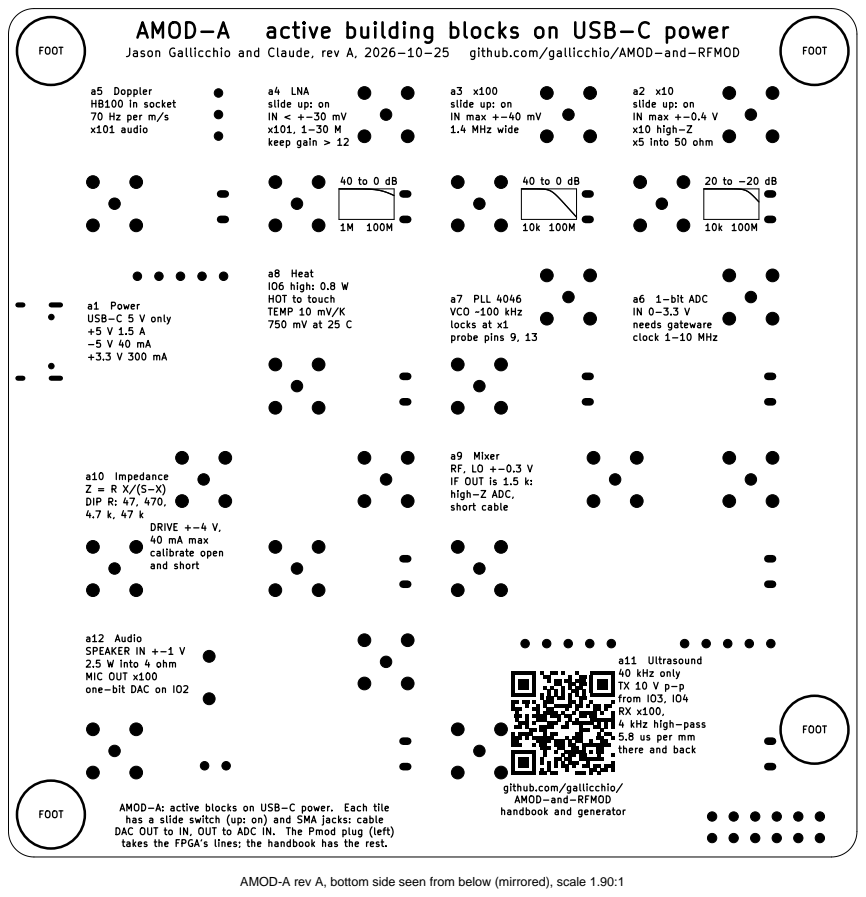
[picture p193: page 1]

a12 Audio
SPEAKER IN +-1 V
2.5 W into 4 ohm
MIC OUT x100
one-bit DAC on IO2

handbook and generator AMOD-A: active blocks on USB-C power. Each tile
has a slide switch (up: on) and SMA jacks: cable
DAC OUT to IN, OUT to ADC IN. The Pmod plug (left)
takes the FPGA's lines; the handbook has the rest.

AMOD-A rev A, bottom side seen from below (mirrored), scale 1.90:1
