gallicchio/AMOD-and-RFMOD/out/amod_a/amod_a-assembly-top.pdf

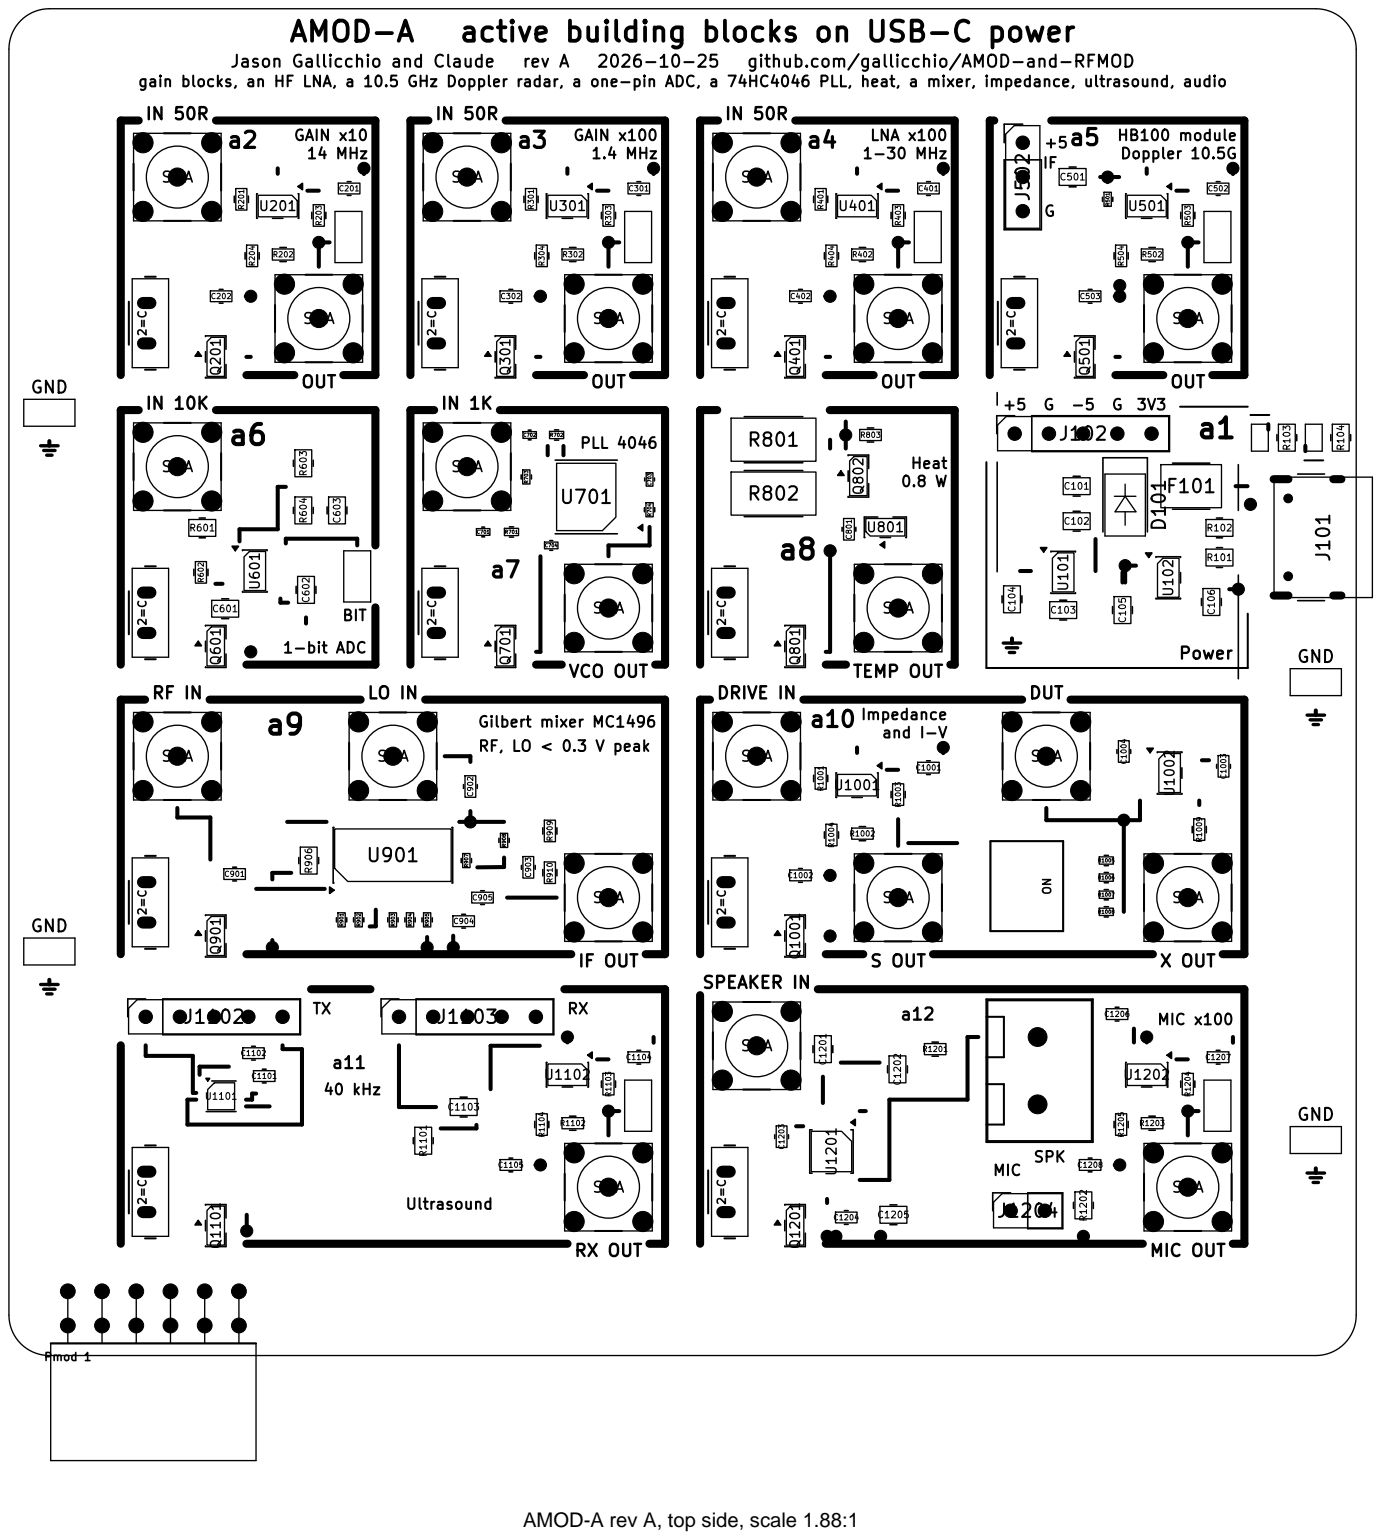
[picture p194: page 1]

gain blocks, an HF LNA, a 10.5 GHz Doppler radar, a one-pin ADC, a 74HC4046 PLL, heat, a mixer, impedance, ultrasound, audio

AMOD-A rev A, top side, scale 1.88:1
