gallicchio/AMOD-and-RFMOD/out/amod_b/amod_b-assembly-bottom.pdf

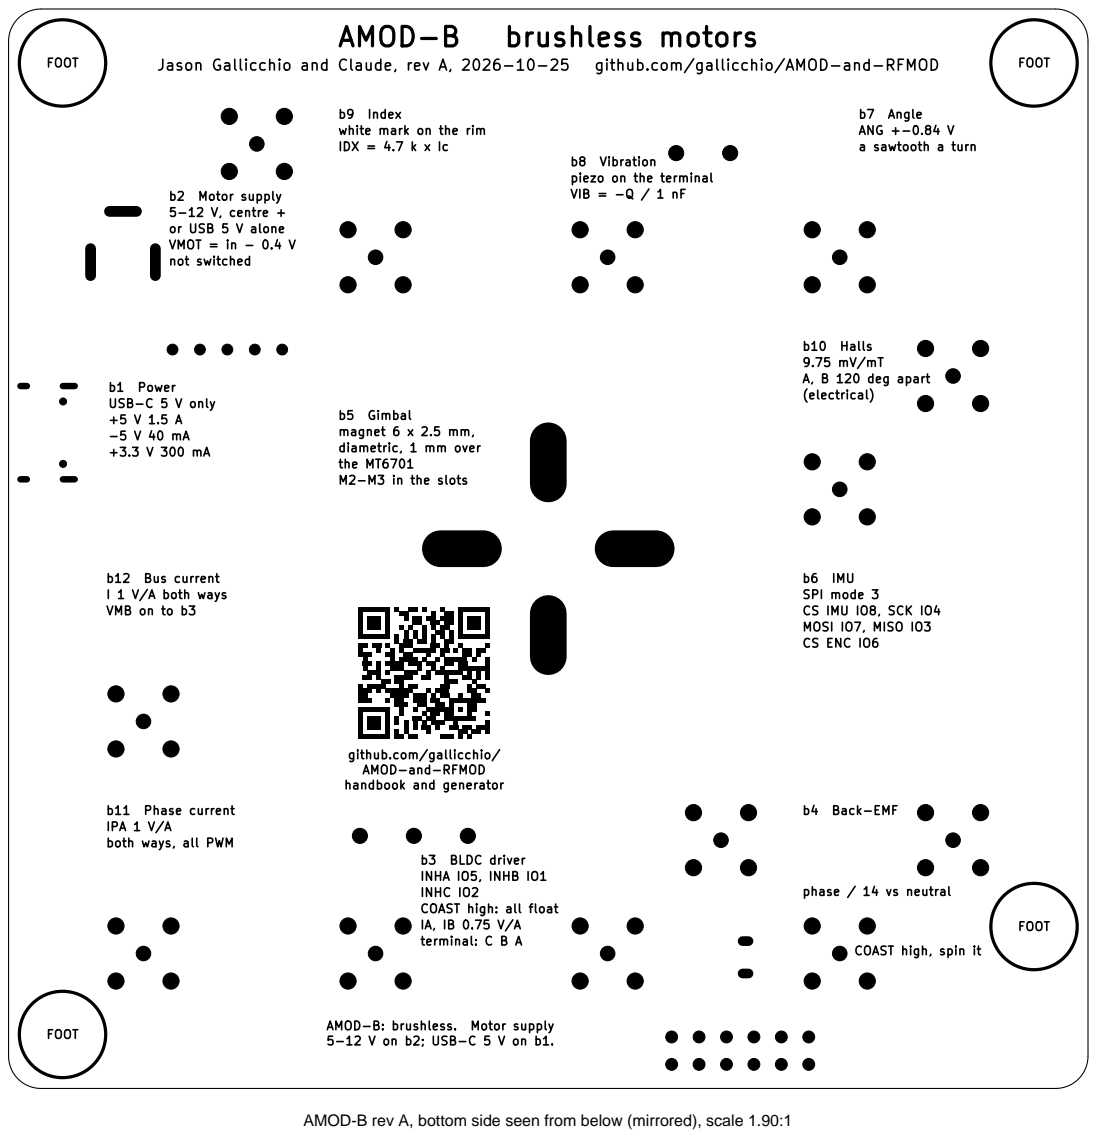
[picture p195: page 1]

b9 Index
white mark on the rim
IDX = 4.7 k x Ic

b8 Vibration
piezo on the terminal
VIB = -Q / 1 nF

b11 Phase current
IPA 1 V/A
both ways, all PWM

b3 BLDC driver
INHA IO5, INHB IO1
INHC IO2
COAST high: all float
terminal: C B A

COAST high, spin it

AMOD-B: brushless. Motor supply
5-12 V on b2; USB-C 5 V on b1.

AMOD-B rev A, bottom side seen from below (mirrored), scale 1.90:1
