gallicchio/AMOD-and-RFMOD/out/amod_b/amod_b-assembly-top.pdf

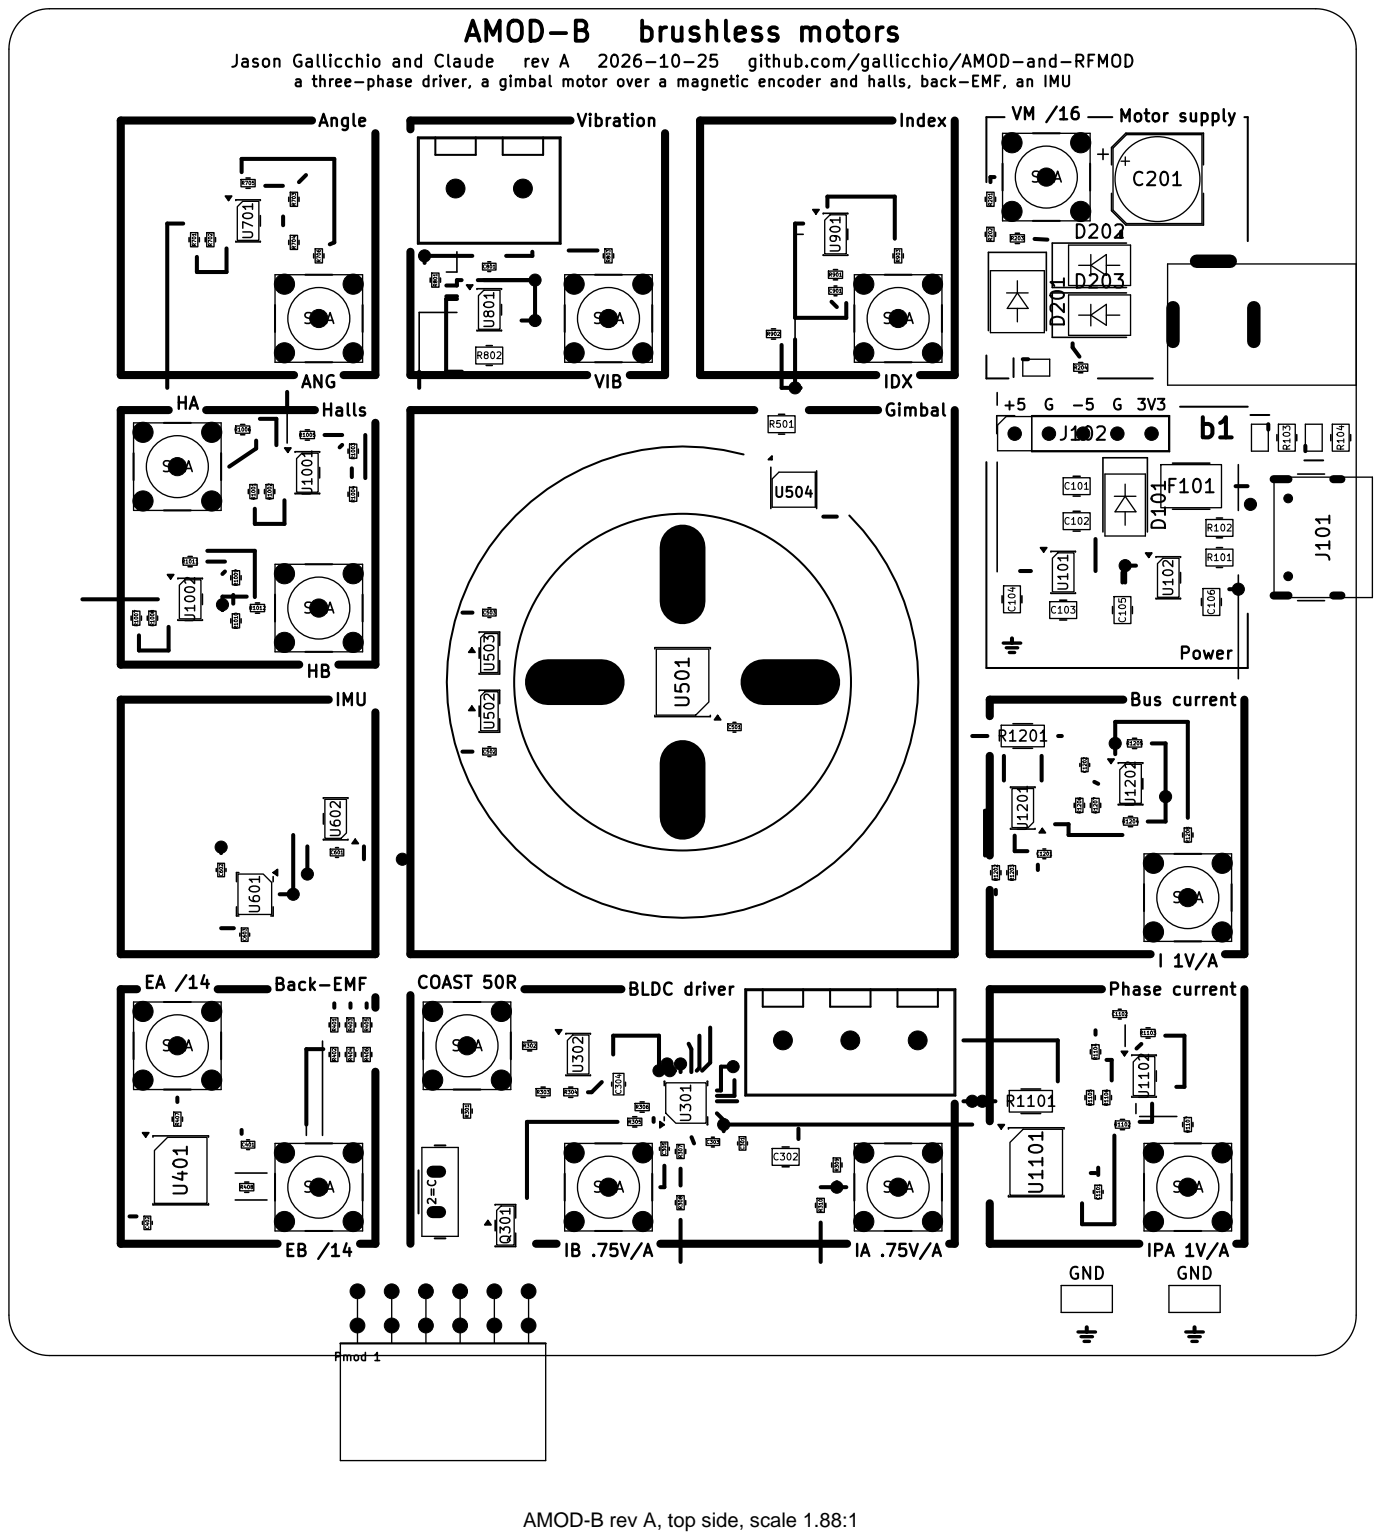
[picture p196: page 1]

a three-phase driver, a gimbal motor over a magnetic encoder and halls, back-EMF, an IMU

AMOD-B rev A, top side, scale 1.88:1
