gallicchio/AMOD-and-RFMOD/out/amod_b/amod_b-schematic.pdf

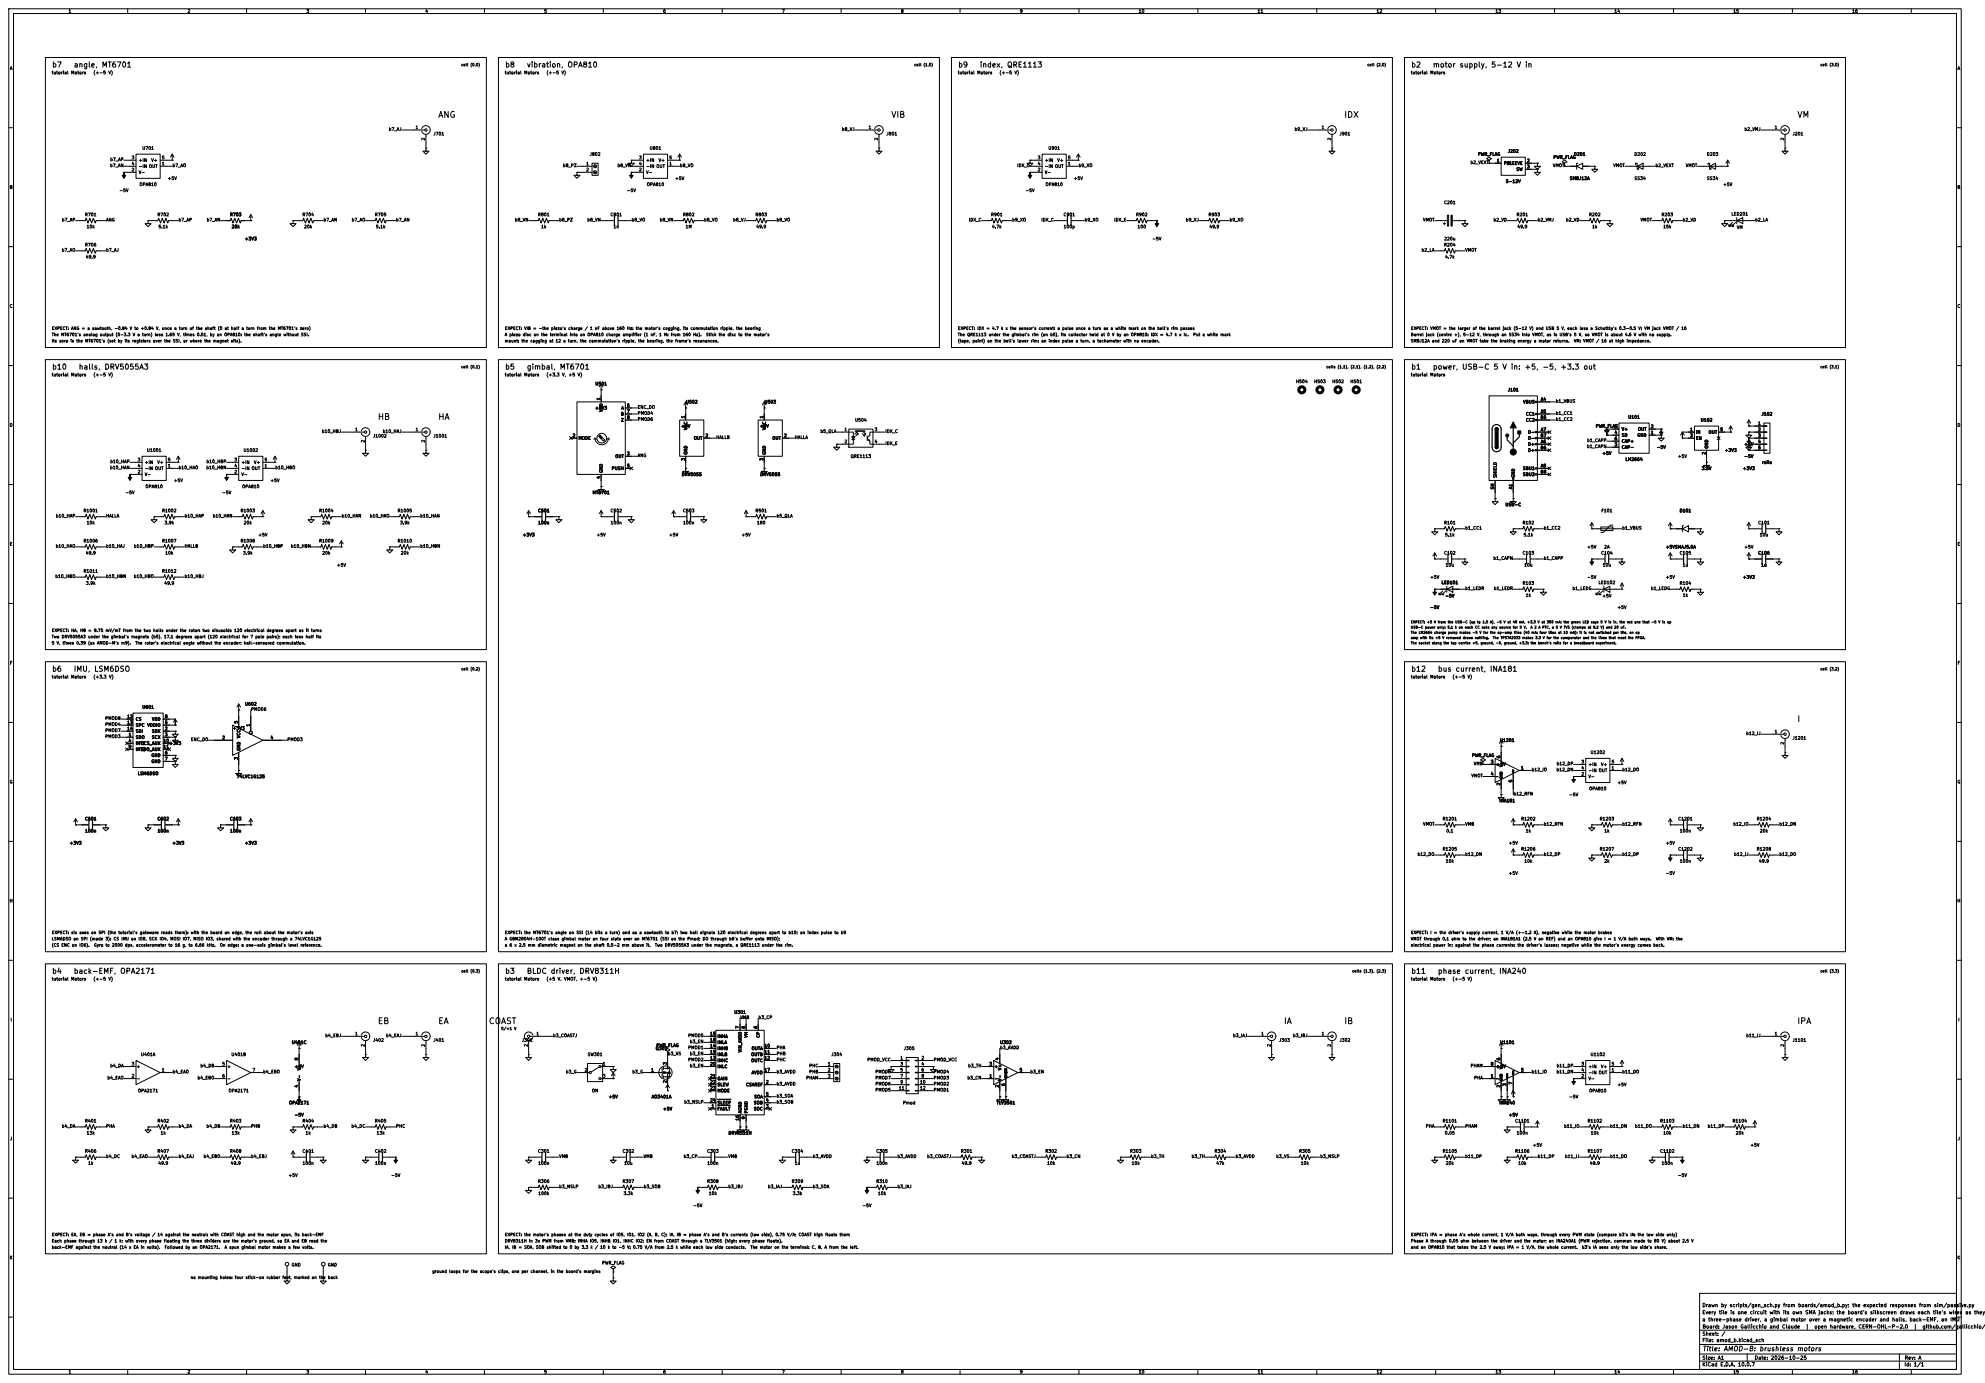
[picture p197: page 1]

EXPECT: ANG = a sawtooth, -0.84 V to +0.84 V, once a turn of the shaft (0 at half a turn from the MT6701's zero)

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

EXPECT: VIB = -the piezo's charge / 1 nF above 160 Hz: the motor's cogging, its commutation ripple, the bearing
A piezo disc on the terminal into an OPA810 charge amplifier (1 nF, 1 M: from 160 Hz). Stick the disc to the motor's
mount: the cogging at 12 a turn, the commutation's ripple, the bearing, the frame's resonances.
10k VDD

The QRE1113 under the gimbal's rim (on b5), its collector held at 0 V by an OPA810: IDX = 4.7 k x Ic. Put a white mark EXPECT: IDX = 4.7 k x the sensor's current: a pulse once a turn as a white mark on the bell's rim passes

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

(tape, paint) on the bell's lower rim: an index pulse a turn, a tachometer with no encoder. HB

EXPECT: +5 V from the USB-C (up to 1.5 A), -5 V at 40 mA, +3.3 V at 300 mA; the green LED says 5 V is in, the red one that -5 V is up USB-C power only: 5.1 k on each CC asks any source for 5 V. A 2 A PTC, a 5 V TVS (clamps at 9.2 V) and 20 uF.

EXPECT: HA, HB = 9.75 mV/mT from the two halls under the rotor: two sinusoids 120 electrical degrees apart as it turns

The socket along the top carries +5, ground, -5, ground, +3.3: the bench's rails for a breadboard experiment. amp with its +5 V removed draws nothing. The TPS7A2033 makes 3.3 V for the comparator and the lines that meet the FPGA. The LM2664 charge pump makes -5 V for the op-amp tiles (40 mA: four tiles at 10 mA); it is not switched per tile, an op

EXPECT: six axes on SPI (the tutorial's gateware reads them): with the board on edge, the roll about the motor's axis
LSM6DSO on SPI (mode 3): CS IMU on IO8, SCK IO4, MOSI IO7, MISO IO3, shared with the encoder through a 74LVC1G125

EXPECT: the MT6701's angle on SSI (14 bits a turn) and as a sawtooth to b7; two hall signals 120 electrical degrees apart to b10; an index pulse to b9
a 6 x 2.5 mm diametric magnet on the shaft 0.5-2 mm above it. Two DRV5055A3 under the magnets, a QRE1113 under the rim.

VMOT through 0.1 ohm to the driver; an INA181A1 (2.5 V on REF) and an OPA810 give I = 1 V/A both ways. With VM: the EXPECT: I = the driver's supply current, 1 V/A (+-1.2 A), negative while the motor brakes electrical power in; against the phase currents: the driver's losses; negative while the motor's energy comes back.

9 OUTA 10 OUTB 11 OUTC 12 INHC 13
INLB 19

EXPECT: EA, EB = phase A's and B's voltage / 14 against the neutral: with COAST high and the motor spun, its back-EMF Each phase through 13 k / 1 k; with every phase floating the three dividers are the motor's ground, so EA and EB read the

and an OPA810 that takes the 2.5 V away: IPA = 1 V/A, the whole current. b3's IA sees only the low side's share. Phase A through 0.05 ohm between the driver and the motor; an INA240A1 (PWM rejection, common mode to 80 V) about 2.5 V EXPECT: IPA = phase A's whole current, 1 V/A both ways, through every PWM state (compare b3's IA: the low side only) no mounting holes: four stick-on rubber feet, marked on the back

EXPECT: the motor's phases at the duty cycles of IO5, IO1, IO2 (A, B, C); IA, IB = phase A's and B's currents (low side), 0.75 V/A; COAST high floats them
DRV8311H in 3x PWM from VMB: INHA IO5, INHB IO1, INHC IO2; EN from COAST through a TLV3501 (high: every phase floats).
IA, IB = SOA, SOB shifted to 0 by 3.3 k / 10 k to -5 V: 0.75 V/A from 2.5 k while each low side conducts. The motor on the terminal: C, B, A from the left.

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

ground loops for the scope's clips, one per channel, in the board's margins

Drawn by scripts/gen_sch.py from boards/amod_b.py; the expected responses from sim/passive.py
Every tile is one circuit with its own SMA jacks; the board's silkscreen draws each tile's wires as they are laid.
a three-phase driver, a gimbal motor over a magnetic encoder and halls, back-EMF, an IMU
Board: Jason Gallicchio and Claude | open hardware, CERN-OHL-P-2.0 | github.com/gallicchio/AMOD-and-RFMOD
Sheet: /
File: amod_b.kicad_sch
Title: AMOD-B: brushless motors

Size: A1 | Rev: A
KiCad E.D.A. 10.0.7 | Id: 1/1
