gallicchio/AMOD-and-RFMOD/out/amod_c/amod_c-assembly-bottom.pdf

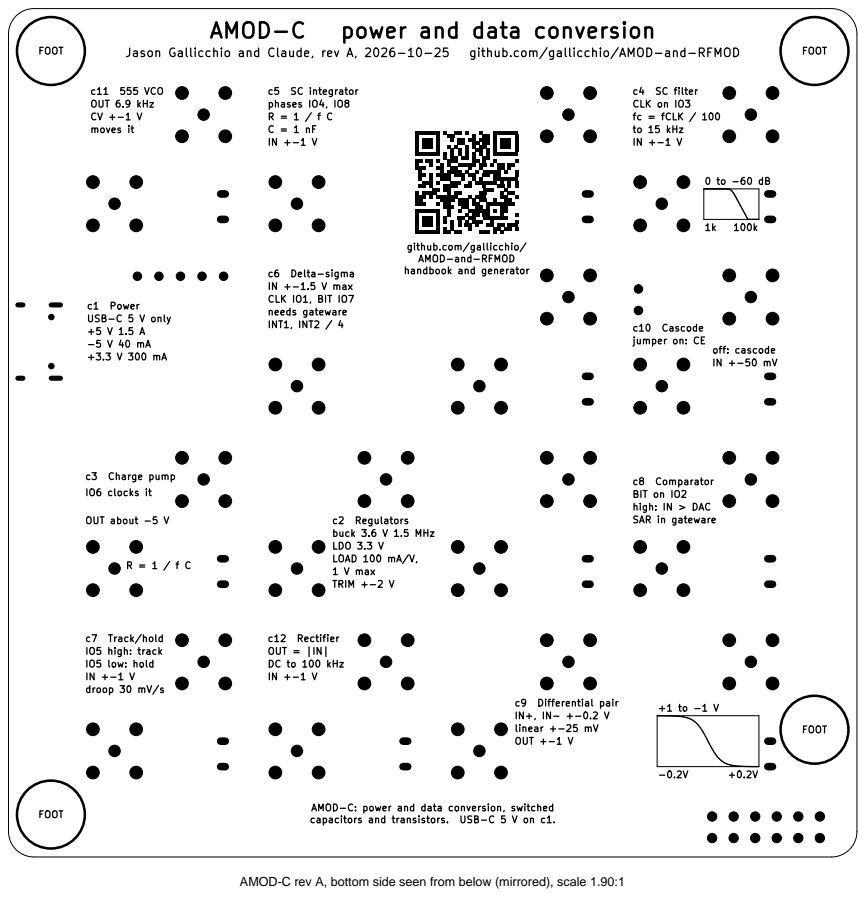
[picture p198: page 1]

AMOD-C: power and data conversion, switched
capacitors and transistors. USB-C 5 V on c1.

AMOD-C rev A, bottom side seen from below (mirrored), scale 1.90:1
