gallicchio/AMOD-and-RFMOD/out/amod_c/amod_c-assembly-top.pdf

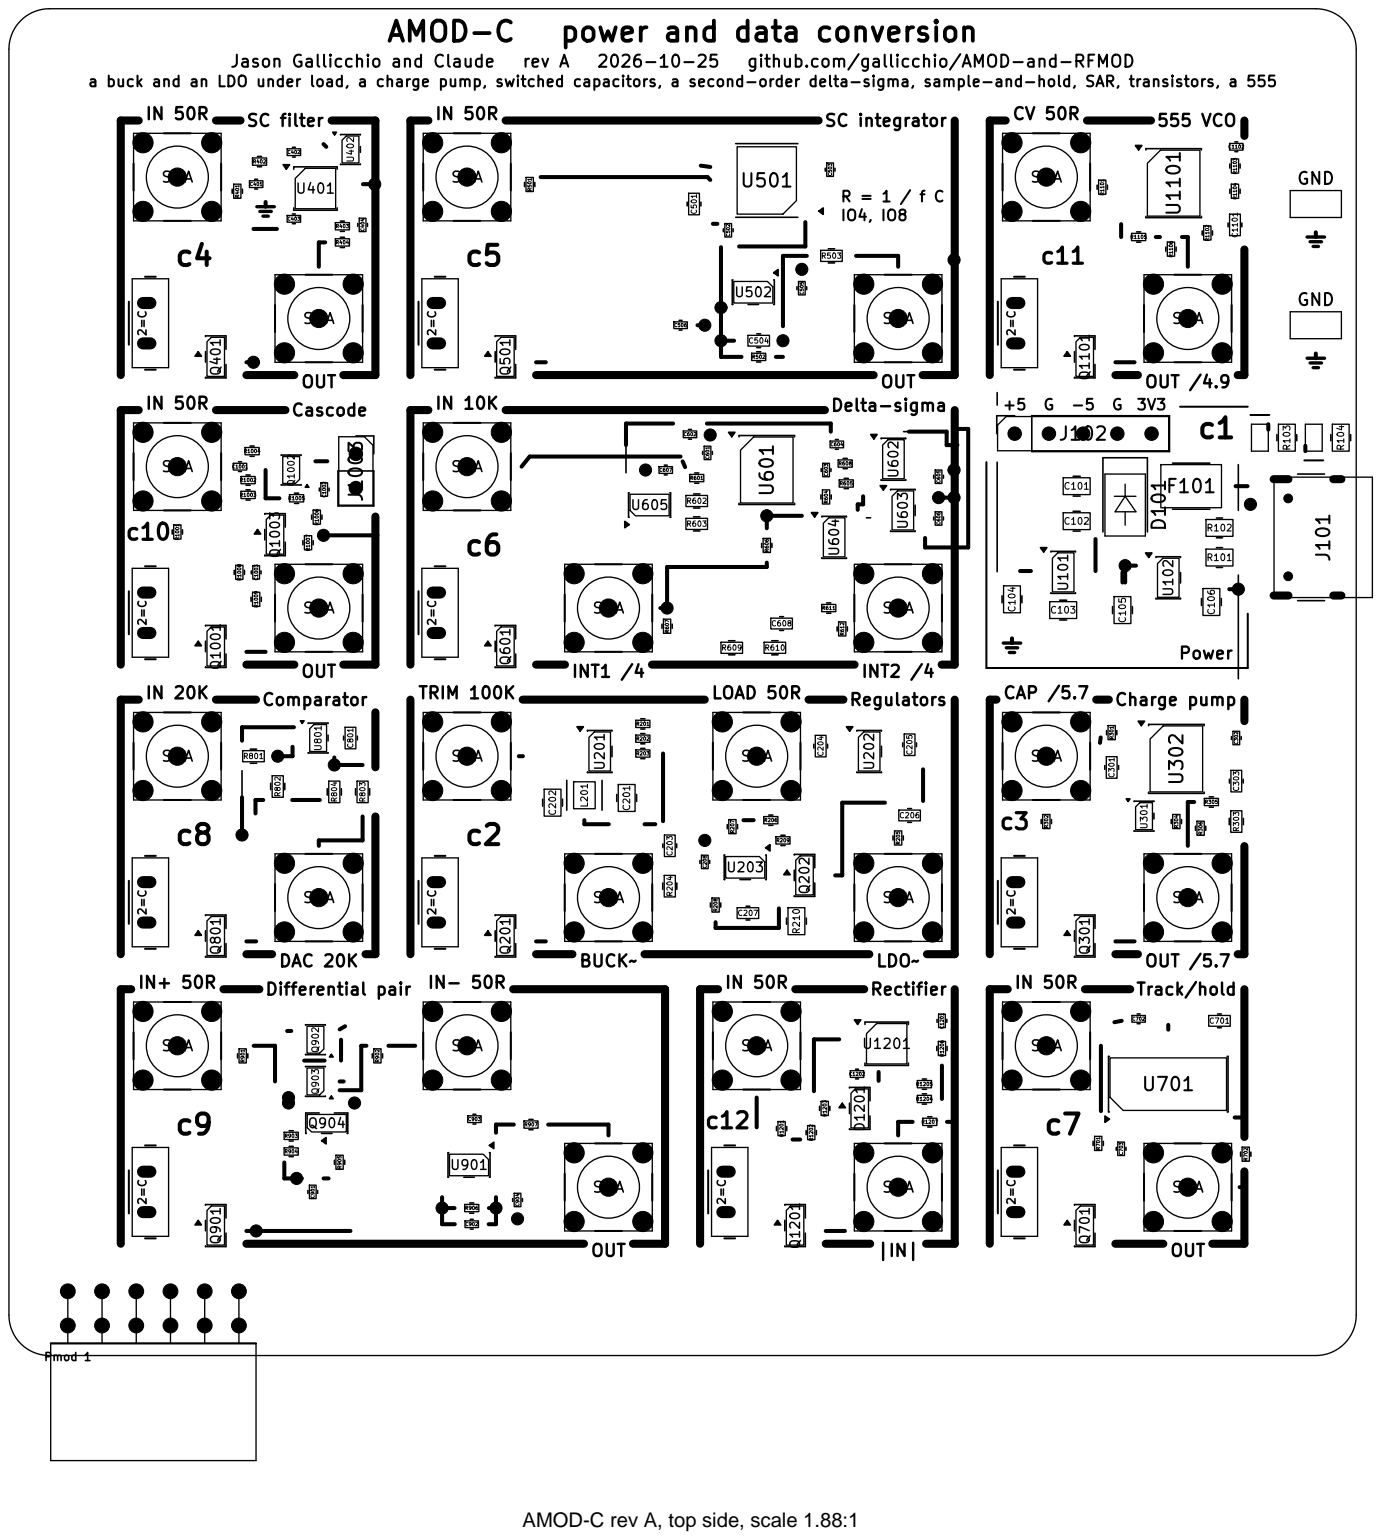
[picture p199: page 1]

a buck and an LDO under load, a charge pump, switched capacitors, a second-order delta-sigma, sample-and-hold, SAR, transistors, a 555
555 VCO IN 50R

AMOD-C rev A, top side, scale 1.88:1
