gallicchio/AMOD-and-RFMOD/out/amod_m/amod_m-assembly-bottom.pdf

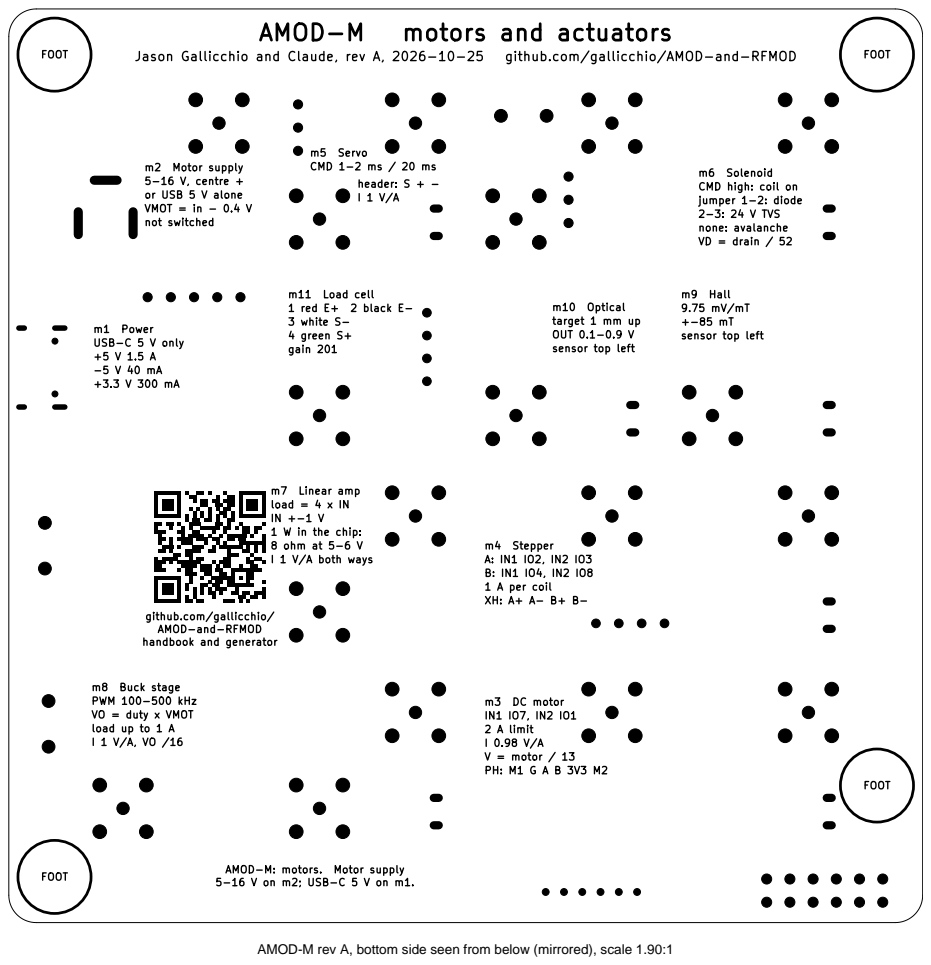
[picture p200: page 1]

m6 Solenoid
CMD high: coil on
jumper 1-2: diode
2-3: 24 V TVS
none: avalanche
VD = drain / 52

AMOD-M: motors. Motor supply
5-16 V on m2; USB-C 5 V on m1.

AMOD-M rev A, bottom side seen from below (mirrored), scale 1.90:1
