gallicchio/AMOD-and-RFMOD/out/amod_m/amod_m-assembly-top.pdf

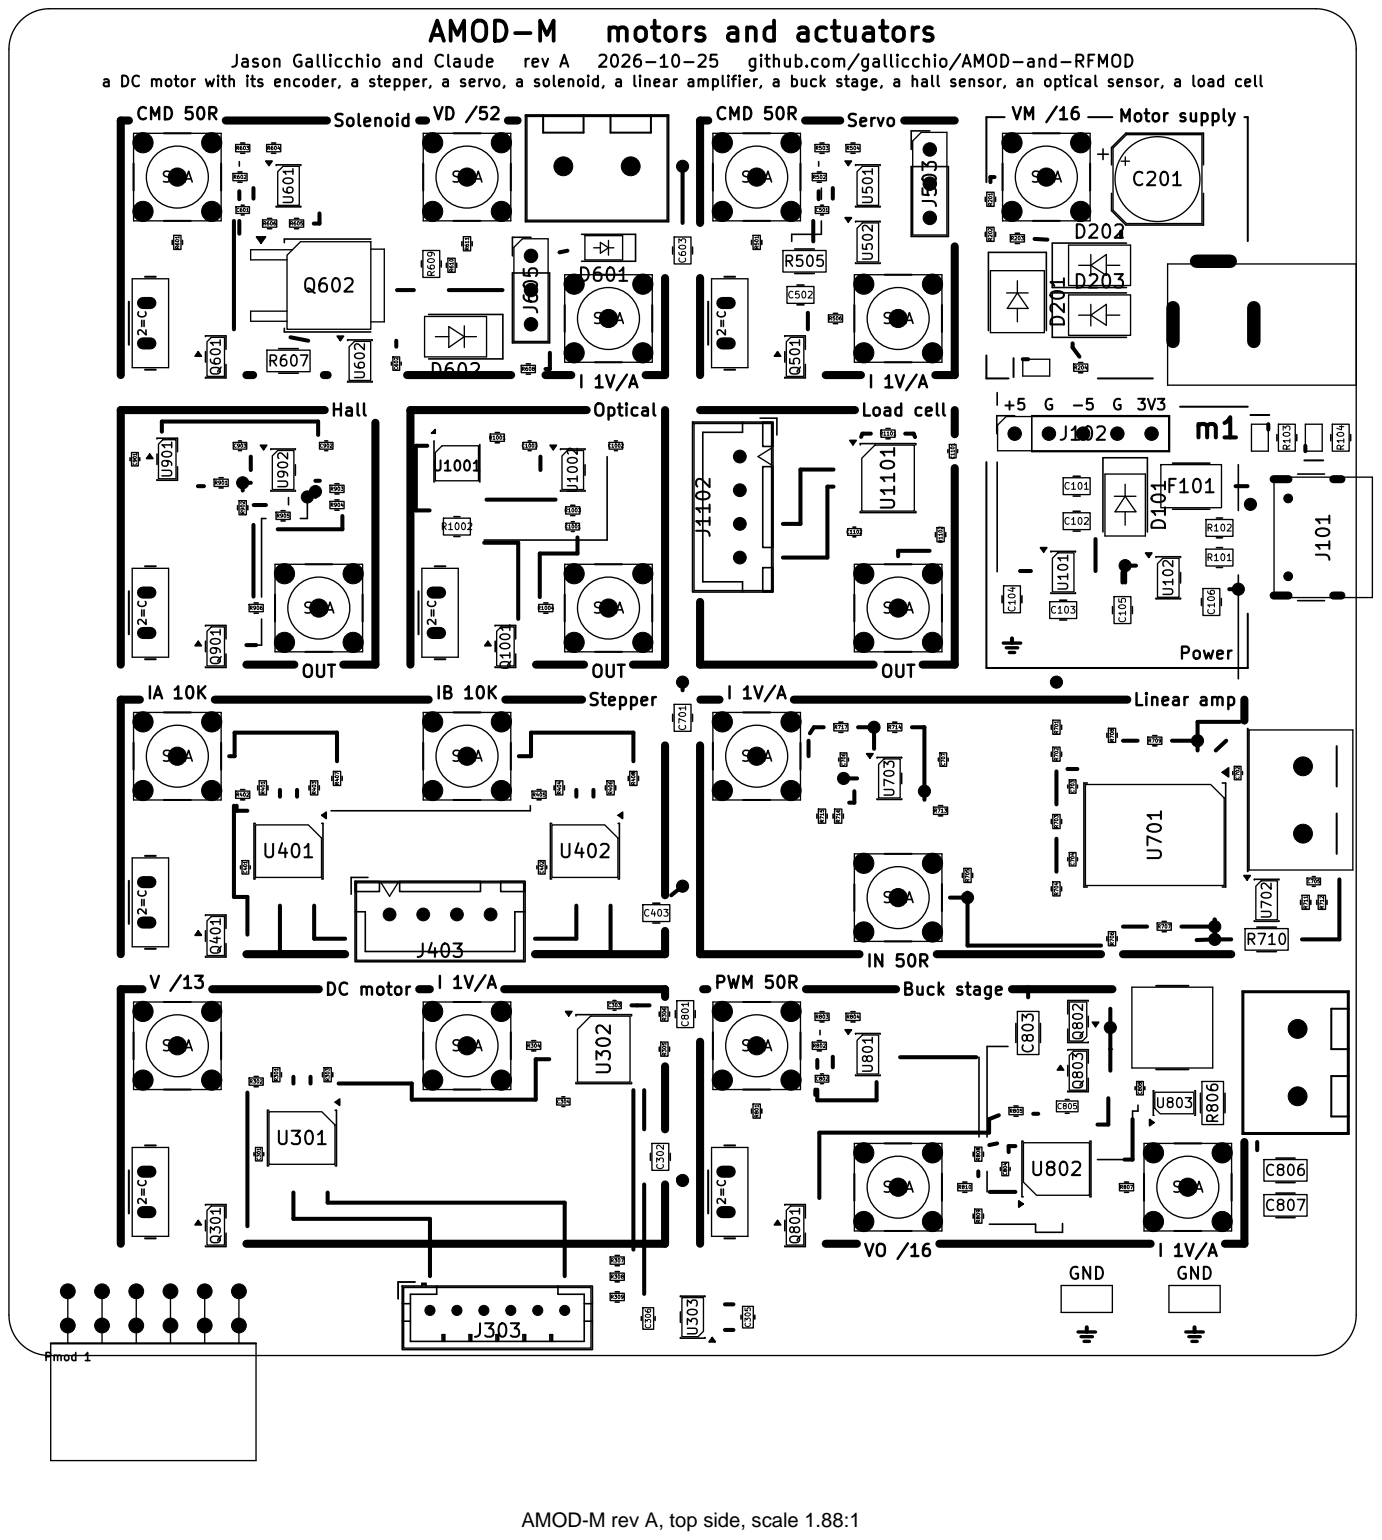
[picture p201: page 1]

a DC motor with its encoder, a stepper, a servo, a solenoid, a linear amplifier, a buck stage, a hall sensor, an optical sensor, a load cell
CMD 50R

AMOD-M rev A, top side, scale 1.88:1
