gallicchio/AMOD-and-RFMOD/out/amod_n/amod_n-assembly-bottom.pdf

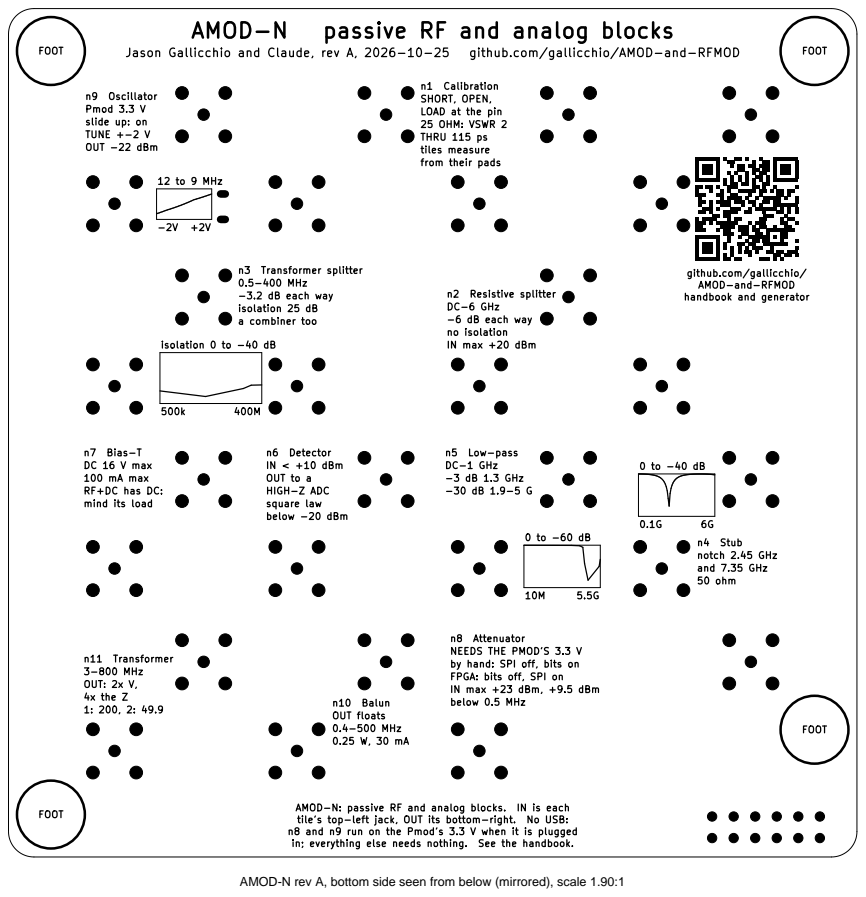
[picture p202: page 1]

n1 Calibration
SHORT, OPEN,
LOAD at the pin
25 OHM: VSWR 2
THRU 115 ps
tiles measure
from their pads

n7 Bias-T
DC 16 V max
100 mA max
RF+DC has DC:
mind its load

n8 Attenuator
NEEDS THE PMOD'S 3.3 V
by hand: SPI off, bits on
FPGA: bits off, SPI on
IN max +23 dBm, +9.5 dBm
below 0.5 MHz

AMOD-N: passive RF and analog blocks. IN is each
tile's top-left jack, OUT its bottom-right. No USB:
n8 and n9 run on the Pmod's 3.3 V when it is plugged
in; everything else needs nothing. See the handbook.

AMOD-N rev A, bottom side seen from below (mirrored), scale 1.90:1
