gallicchio/AMOD-and-RFMOD/out/amod_n/amod_n-assembly-top.pdf

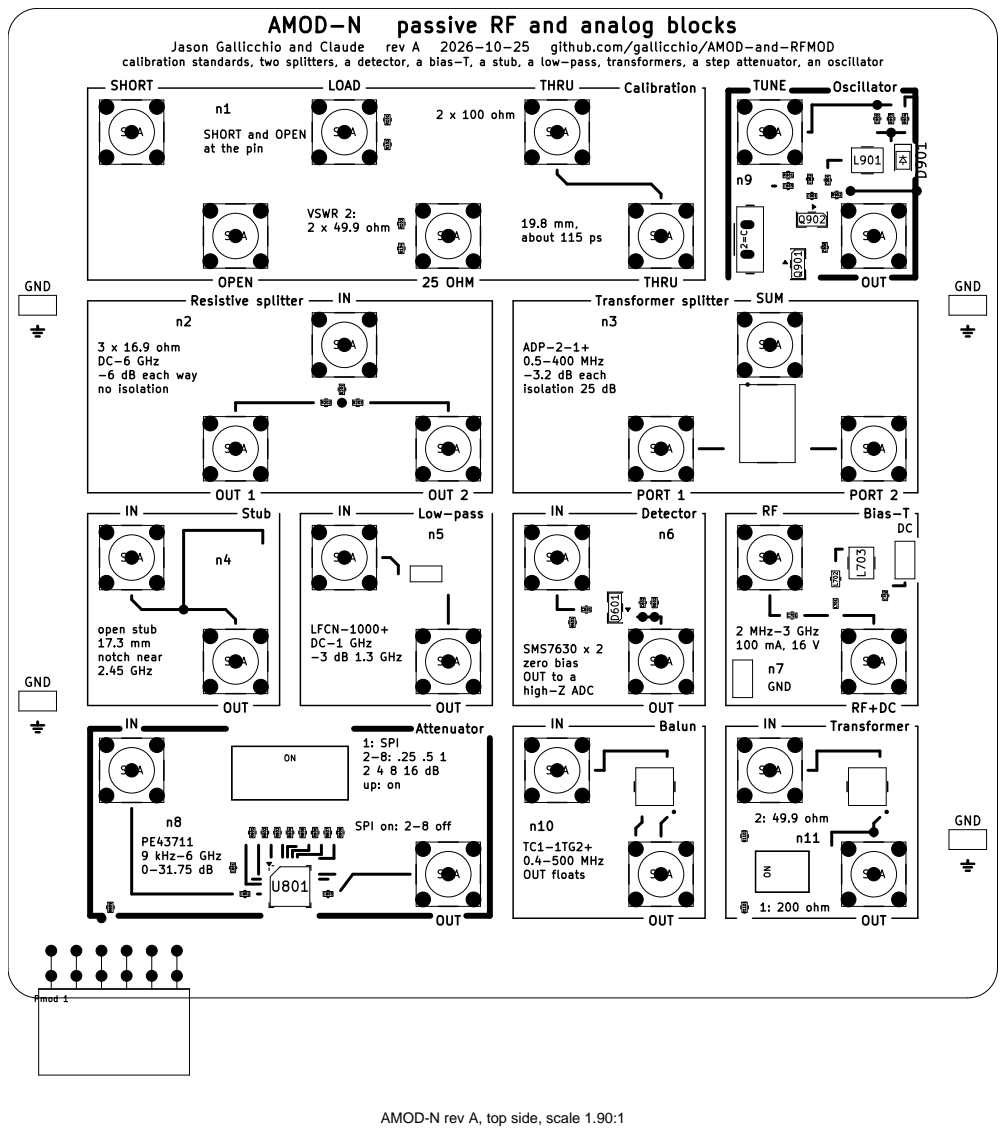
[picture p203: page 1]

calibration standards, two splitters, a detector, a bias-T, a stub, a low-pass, transformers, a step attenuator, an oscillator
SHORT

AMOD-N rev A, top side, scale 1.90:1
