gallicchio/AMOD-and-RFMOD/out/amod_p/amod_p-assembly-bottom.pdf

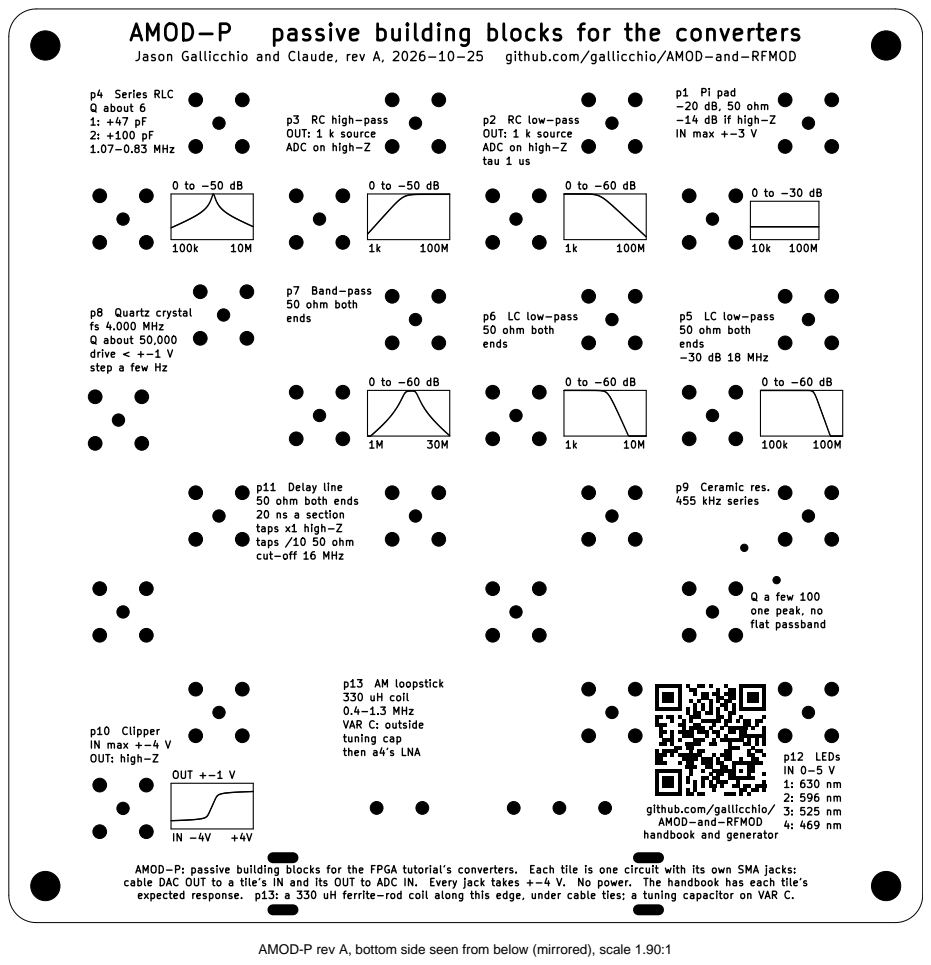
[picture p204: page 1]

AMOD-P: passive building blocks for the FPGA tutorial's converters. Each tile is one circuit with its own SMA jacks:
cable DAC OUT to a tile's IN and its OUT to ADC IN. Every jack takes +-4 V. No power. The handbook has each tile's
expected response. p13: a 330 uH ferrite-rod coil along this edge, under cable ties; a tuning capacitor on VAR C.

AMOD-P rev A, bottom side seen from below (mirrored), scale 1.90:1
