gallicchio/AMOD-and-RFMOD/out/amod_p/amod_p-assembly-top.pdf

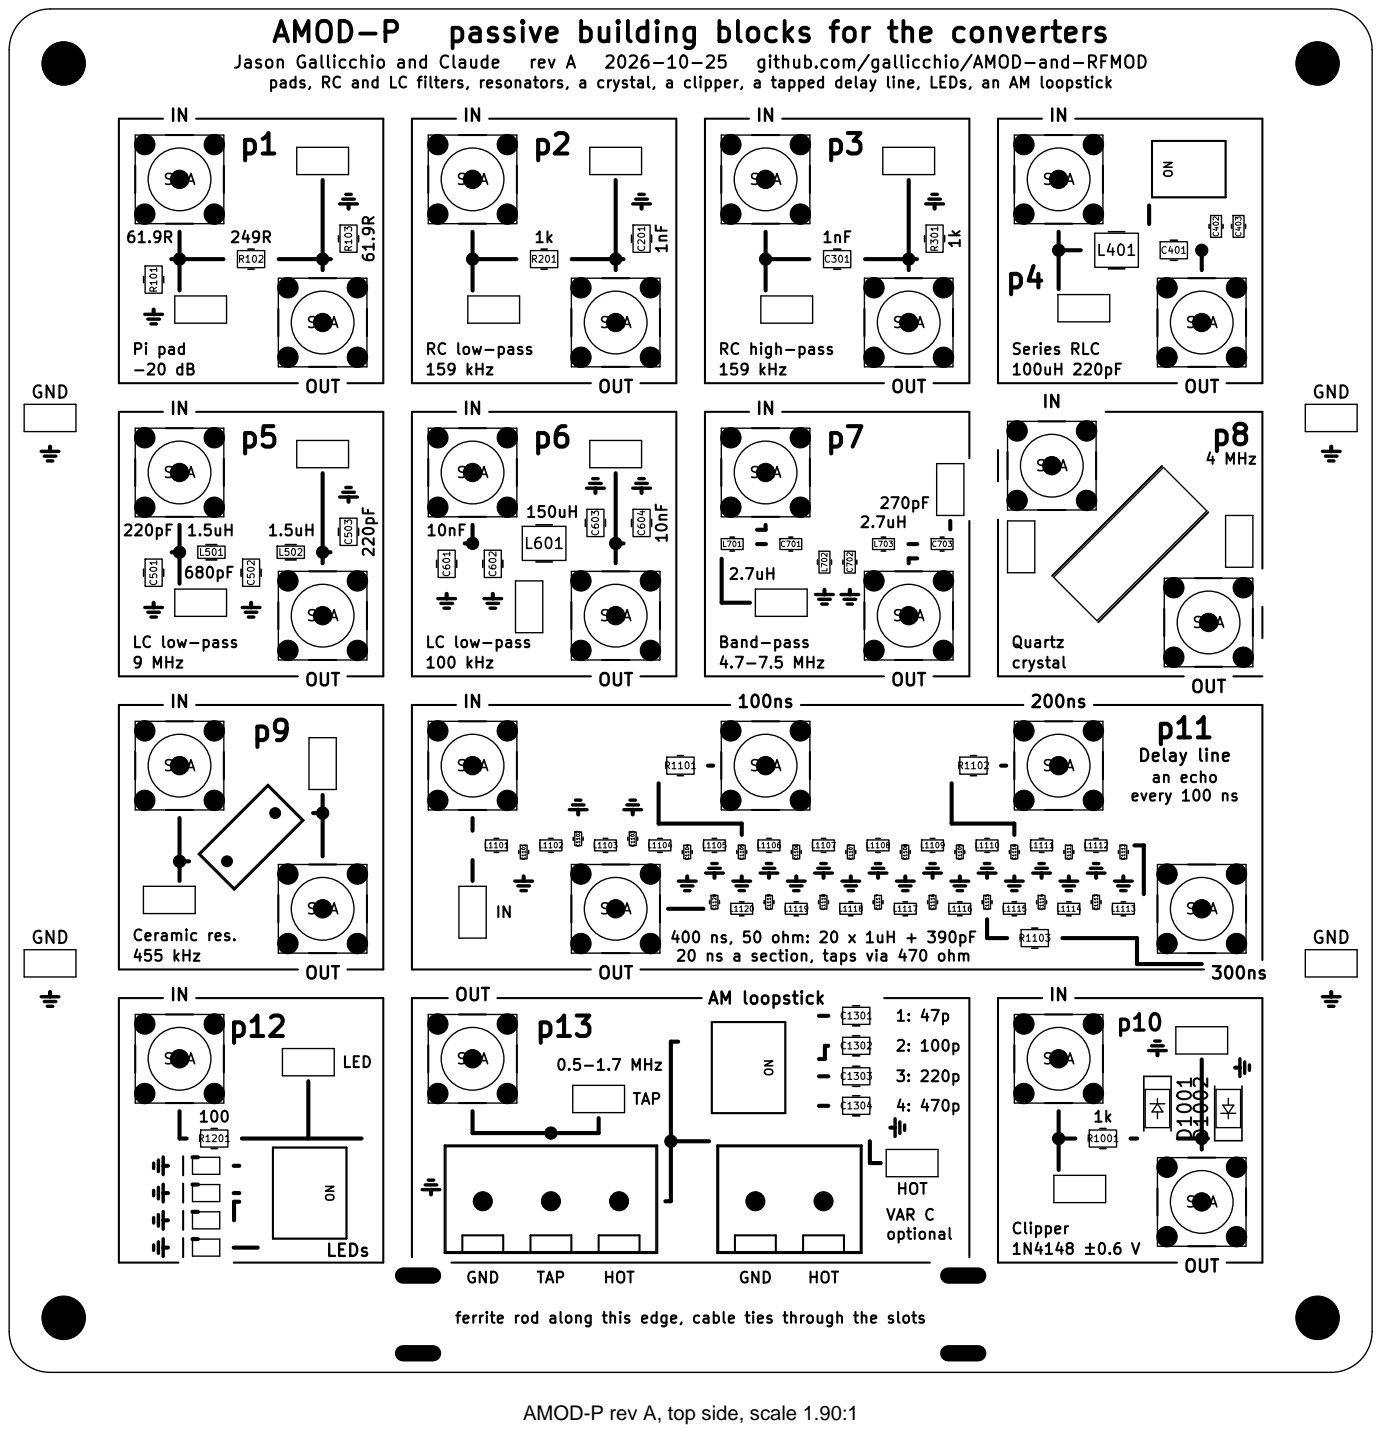
[picture p205: page 1]
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

400 ns, 50 ohm: 20 x 1uH + 390pF
20 ns a section, taps via 470 ohm

ferrite rod along this edge, cable ties through the slots

AMOD-P rev A, top side, scale 1.90:1
