gallicchio/AMOD-and-RFMOD/out/amod_p/amod_p-schematic.pdf

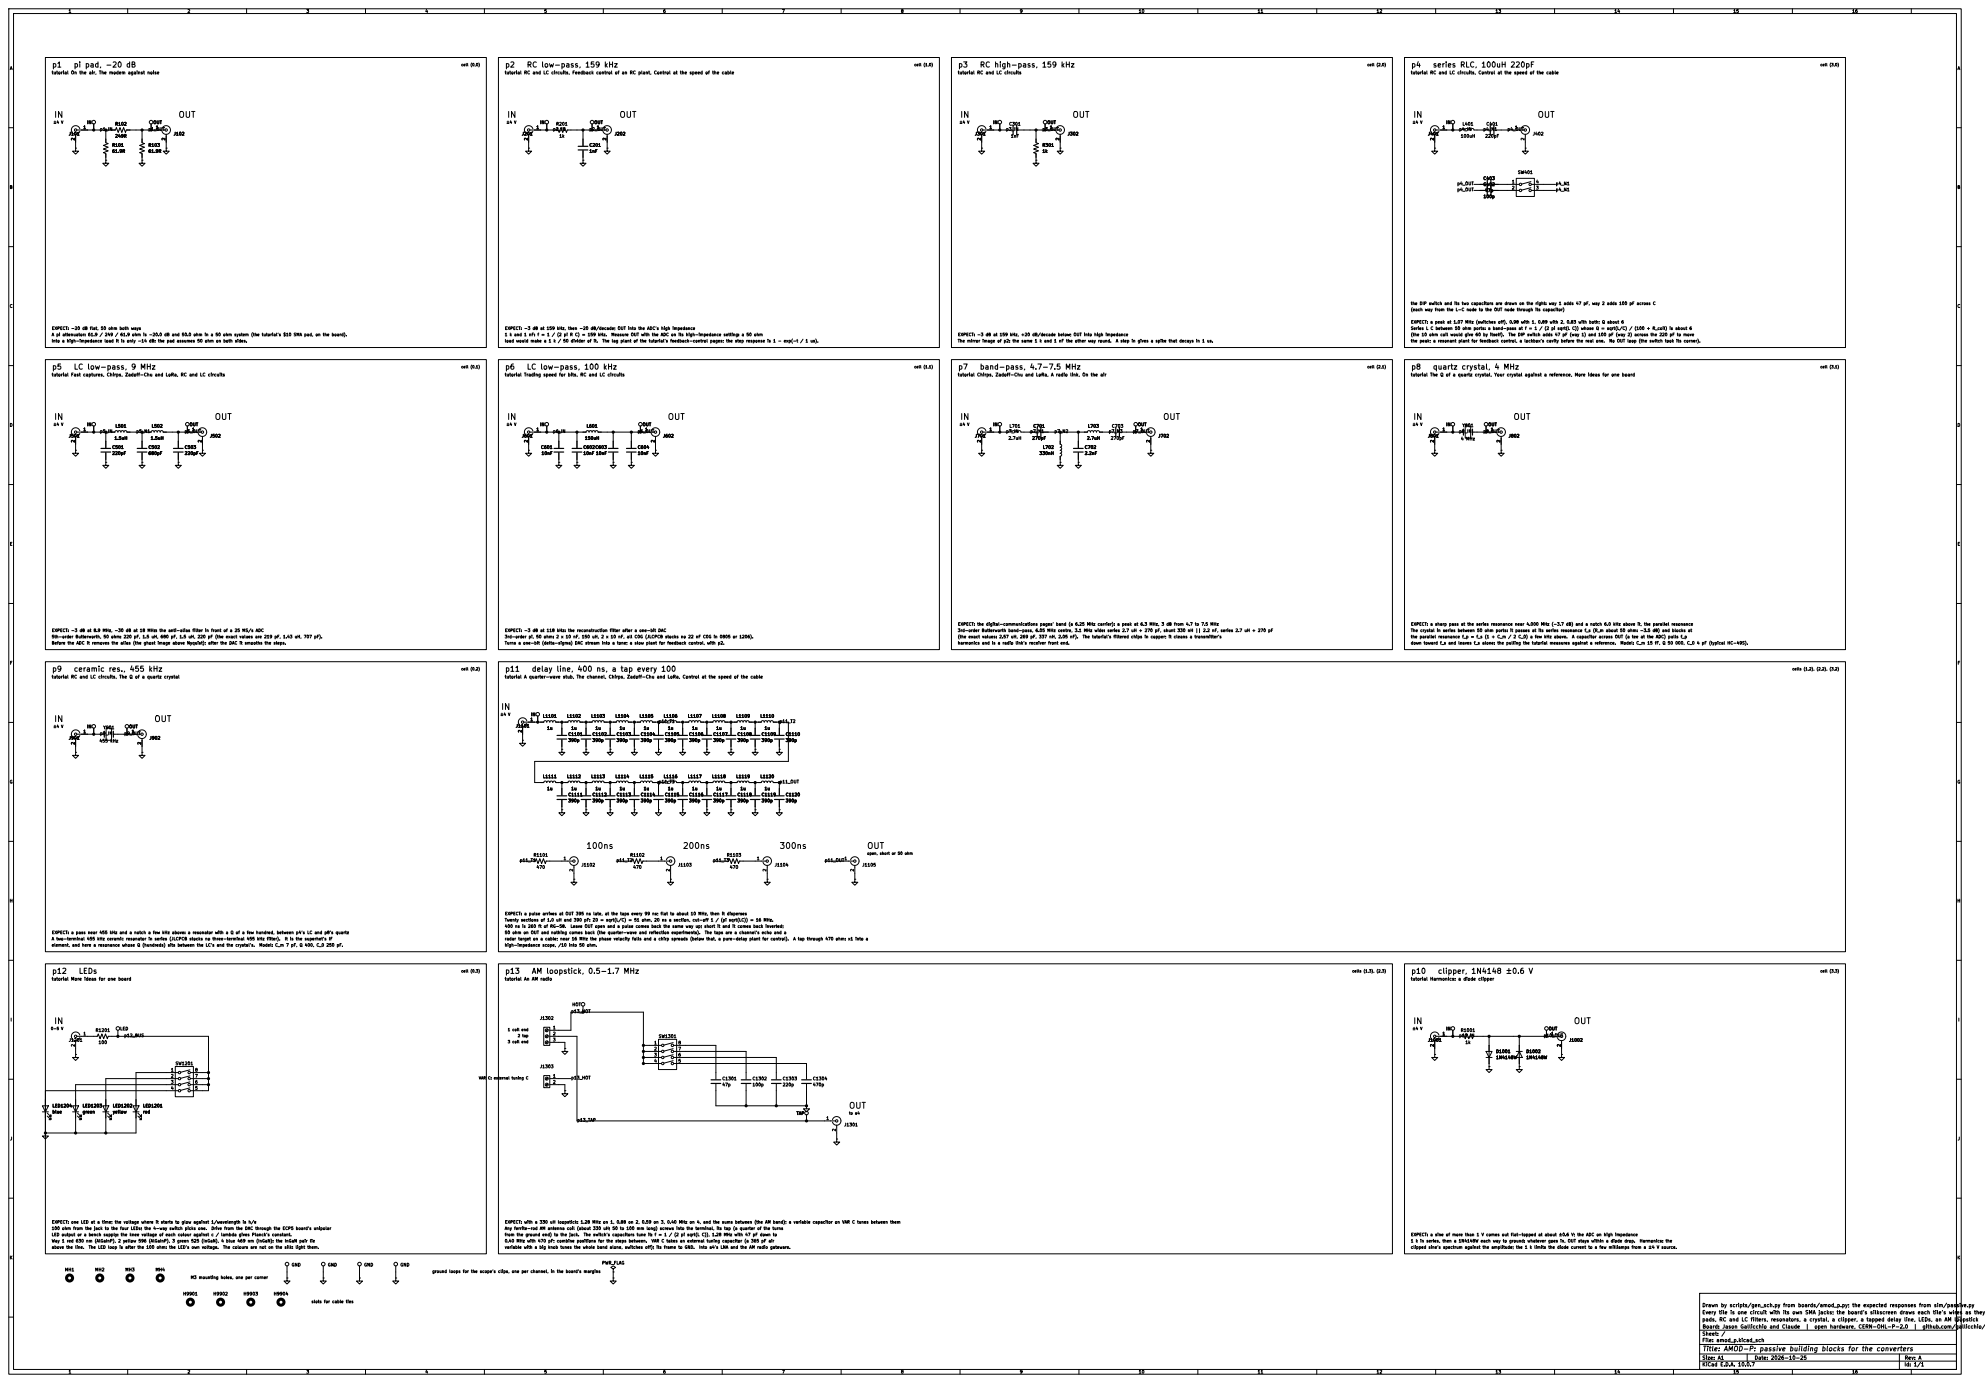
[picture p206: page 1]

tutorial RC and LC circuits, Feedback control of an RC plant, Control at the speed of the cable

tutorial RC and LC circuits

the DIP switch and its two capacitors are drawn on the right: way 1 adds 47 pF, way 2 adds 100 pF across C OUT
(each way from the L-C node to the OUT node through its capacitor) EXPECT: a peak at 1.07 MHz (switches off), 0.98 with 1, 0.89 with 2, 0.83 with both; Q about 6

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

tutorial Chirps, Zadoff-Chu and LoRa, A radio link, On the air EXPECT: -3 dB at 118 kHz: the reconstruction filter after a one-bit DAC

tutorial Fast captures, Chirps, Zadoff-Chu and LoRa, RC and LC circuits ±4 V IN

tutorial Trading speed for bits, RC and LC circuits

tutorial The Q of a quartz crystal, Your crystal against a reference, More ideas for one board

EXPECT: the digital-communications pages' band (a 6.25 MHz carrier): a peak at 6.3 MHz, 3 dB from 4.7 to 7.5 MHz ±4 V 3rd-order pi, 50 ohm: 2 x 10 nF, 150 uH, 2 x 10 nF, all C0G (JLCPCB stocks no 22 nF C0G in 0805 or 1206).

EXPECT: a sharp pass at the series resonance near 4.000 MHz (-3.7 dB) and a notch 6.0 kHz above it, the parallel resonance
The crystal in series between 50 ohm ports: it passes at its series resonance f_s (R_m about 50 ohm: -3.5 dB) and blocks at
the parallel resonance f_p = f_s (1 + C_m / 2 C_0) a few kHz above. A capacitor across OUT (a tee at the ADC) pulls f_p
down toward f_s and leaves f_s alone: the pulling the tutorial measures against a reference. Model: C_m 15 fF, Q 50 000, C_0 4 pF (typical HC-49S).

EXPECT: -3 dB at 8.9 MHz, -30 dB at 18 MHz: the anti-alias filter in front of a 25 MS/s ADC
Before the ADC it removes the alias (the ghost image above Nyquist); after the DAC it smooths the steps. 5th-order Butterworth, 50 ohm: 220 pF, 1.5 uH, 680 pF, 1.5 uH, 220 pF (the exact values are 219 pF, 1.43 uH, 707 pF).

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

tutorial RC and LC circuits, The Q of a quartz crystal

tutorial A quarter-wave stub, The channel, Chirps, Zadoff-Chu and LoRa, Control at the speed of the cable

1 coil end EXPECT: with a 330 uH loopstick: 1.28 MHz on 1, 0.88 on 2, 0.59 on 3, 0.40 MHz on 4, and the sums between (the AM band); a variable capacitor on VAR C tunes between them 100ns

open, short or 50 ohm OUT

EXPECT: a pulse arrives at OUT 395 ns late, at the taps every 99 ns; flat to about 10 MHz, then it disperses
Twenty sections of 1.0 uH and 390 pF: Z0 = sqrt(L/C) = 51 ohm, 20 ns a section, cut-off 1 / (pi sqrt(LC)) = 16 MHz. radar target on a cable; near 16 MHz the phase velocity falls and a chirp spreads (below that, a pure-delay plant for control). A tap through 470 ohm: x1 into a

A two-terminal 455 kHz ceramic resonator in series (JLCPCB stocks no three-terminal 455 kHz filter). It is the superhet's IF EXPECT: a pass near 455 kHz and a notch a few kHz above: a resonator with a Q of a few hundred, between p4's LC and p8's quartz element, and here a resonance whose Q (hundreds) sits between the LC's and the crystal's. Model: C_m 7 pF, Q 400, C_0 250 pF.

tutorial More ideas for one board

tutorial An AM radio

tutorial Harmonics: a diode clipper

clipped sine's spectrum against the amplitude; the 1 k limits the diode current to a few milliamps from a ±4 V source. 1 k in series, then a 1N4148W each way to ground: whatever goes in, OUT stays within a diode drop. Harmonics: the OUT

EXPECT: one LED at a time; the voltage where it starts to glow against 1/wavelength is h/e
LED output or a bench supply: the knee voltage of each colour against c / lambda gives Planck's constant. above the line. The LED loop is after the 100 ohm: the LED's own voltage. The colours are not on the silk: light them. 100 ohm from the jack to the four LEDs; the 4-way switch picks one. Drive from the DAC through the ECP5 board's unipolar

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

slots for cable ties Way 1 red 630 nm (AlGaInP), 2 yellow 596 (AlGaInP), 3 green 525 (InGaN), 4 blue 469 nm (InGaN): the InGaN pair lie

ground loops for the scope's clips, one per channel, in the board's margins

Drawn by scripts/gen_sch.py from boards/amod_p.py; the expected responses from sim/passive.py
Every tile is one circuit with its own SMA jacks; the board's silkscreen draws each tile's wires as they are laid.
pads, RC and LC filters, resonators, a crystal, a clipper, a tapped delay line, LEDs, an AM loopstick
Board: Jason Gallicchio and Claude | open hardware, CERN-OHL-P-2.0 | github.com/gallicchio/AMOD-and-RFMOD
Sheet: /
File: amod_p.kicad_sch
Title: AMOD-P: passive building blocks for the converters

Size: A1 | Rev: A
KiCad E.D.A. 10.0.7 | Id: 1/1
