gallicchio/AMOD-and-RFMOD/out/iq_mod/iq_mod-assembly-bottom.pdf

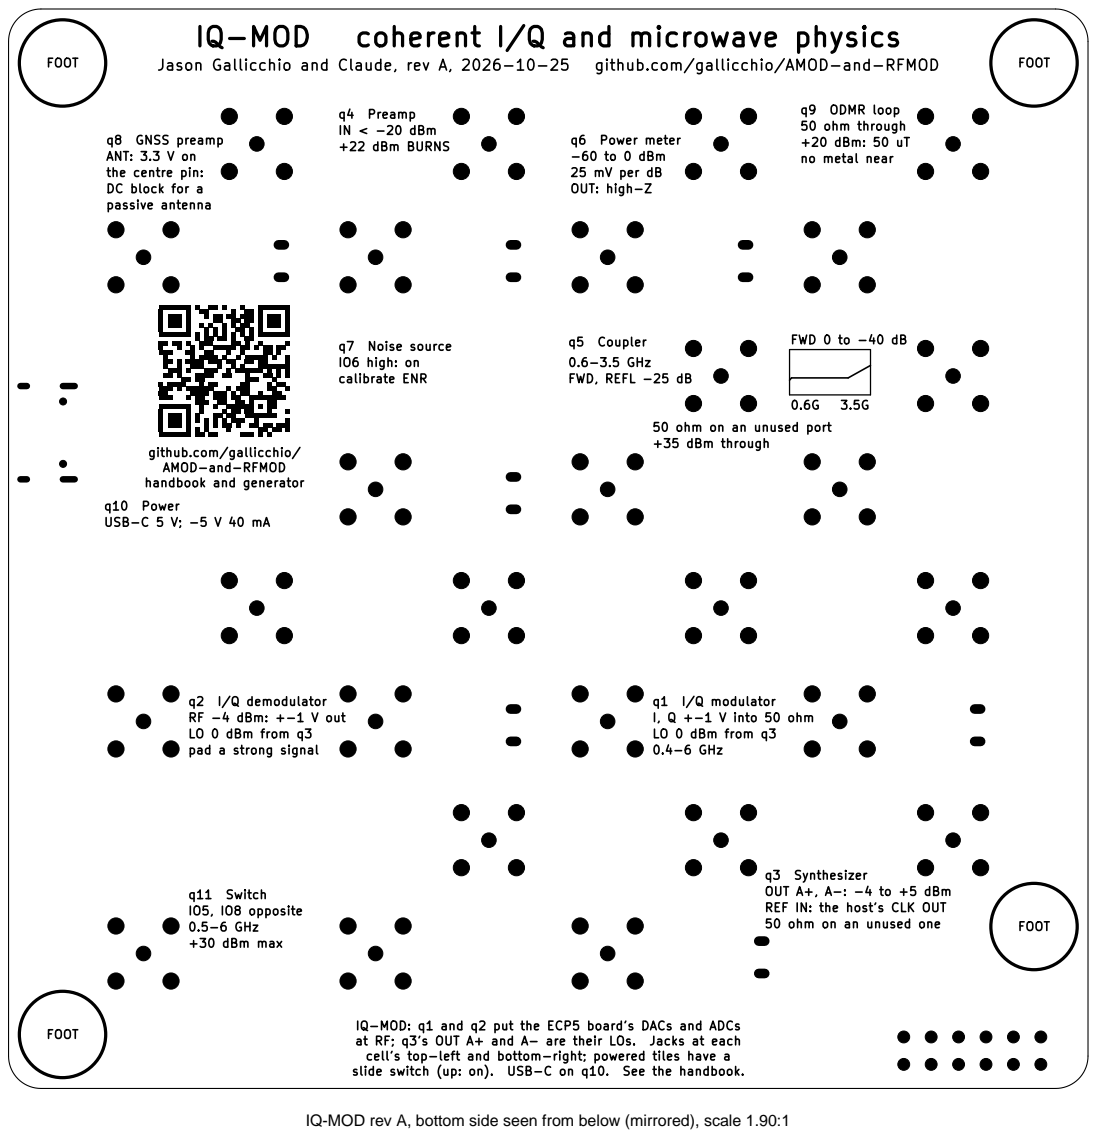
[picture p207: page 1]

50 ohm on an unused port
+35 dBm through

q3 Synthesizer
OUT A+, A-: -4 to +5 dBm
REF IN: the host's CLK OUT
50 ohm on an unused one

IQ-MOD: q1 and q2 put the ECP5 board's DACs and ADCs
at RF; q3's OUT A+ and A- are their LOs. Jacks at each
cell's top-left and bottom-right; powered tiles have a
slide switch (up: on). USB-C on q10. See the handbook.

IQ-MOD rev A, bottom side seen from below (mirrored), scale 1.90:1
