gallicchio/AMOD-and-RFMOD/out/iq_mod/iq_mod-assembly-top.pdf

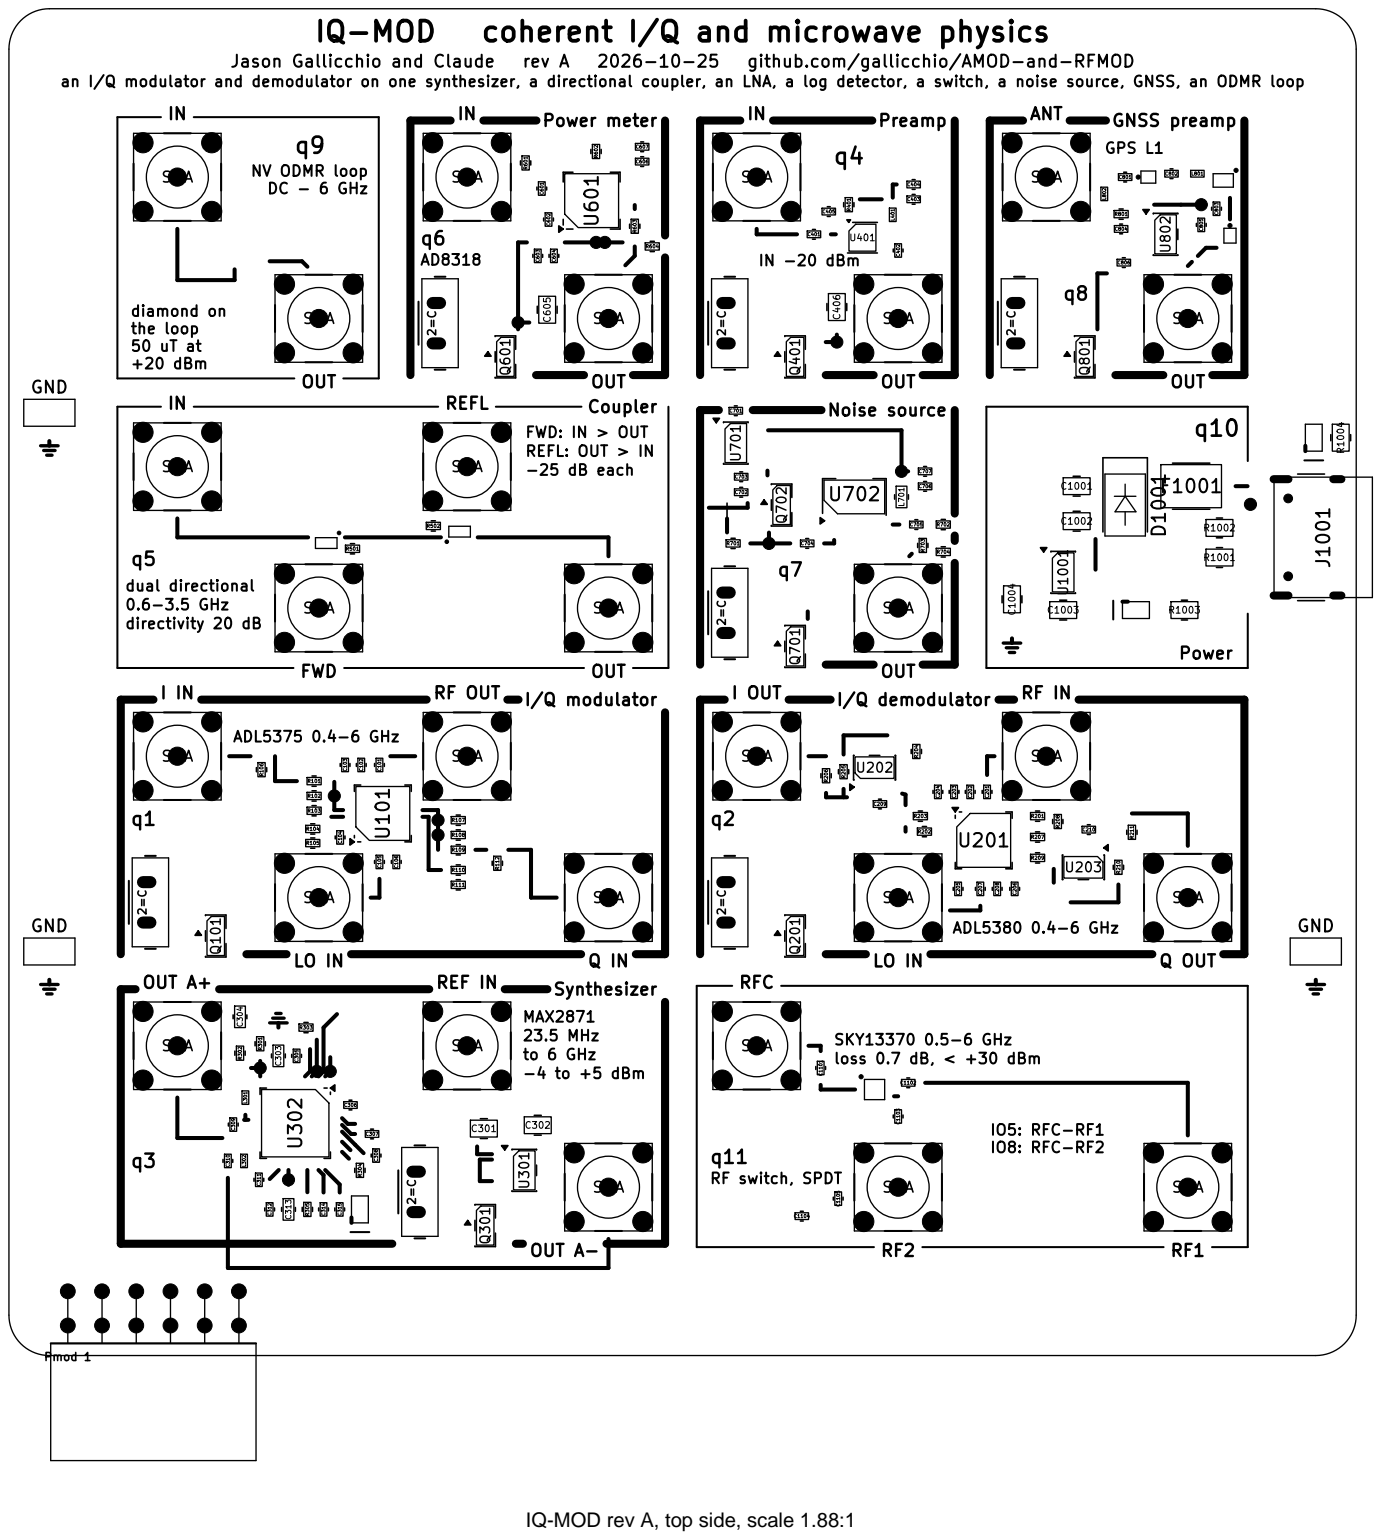
[picture p208: page 1]

an I/Q modulator and demodulator on one synthesizer, a directional coupler, an LNA, a log detector, a switch, a noise source, GNSS, an ODMR loop

IQ-MOD rev A, top side, scale 1.88:1
