gallicchio/AMOD-and-RFMOD/out/phmod/phmod-assembly-bottom.pdf

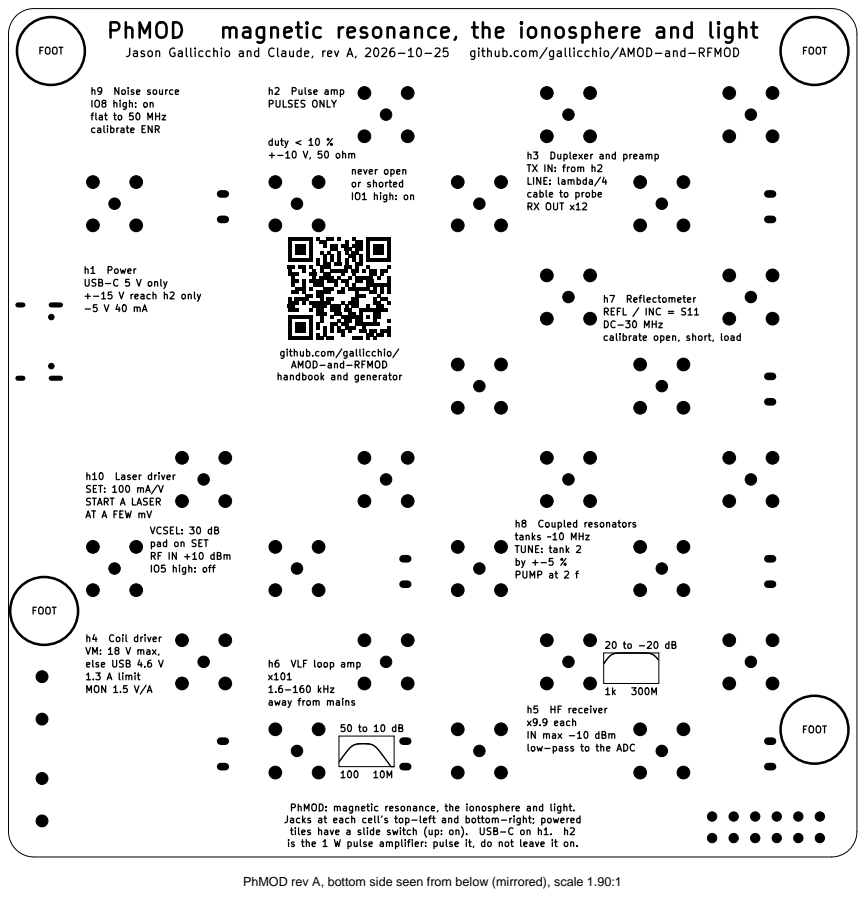
[picture p209: page 1]

h7 Reflectometer
REFL / INC = S11
DC-30 MHz
calibrate open, short, load

h5 HF receiver
x9.9 each
IN max -10 dBm
low-pass to the ADC

PhMOD: magnetic resonance, the ionosphere and light.
Jacks at each cell's top-left and bottom-right; powered
tiles have a slide switch (up: on). USB-C on h1. h2
is the 1 W pulse amplifier: pulse it, do not leave it on.

PhMOD rev A, bottom side seen from below (mirrored), scale 1.90:1
