gallicchio/AMOD-and-RFMOD/out/phmod/phmod-assembly-top.pdf

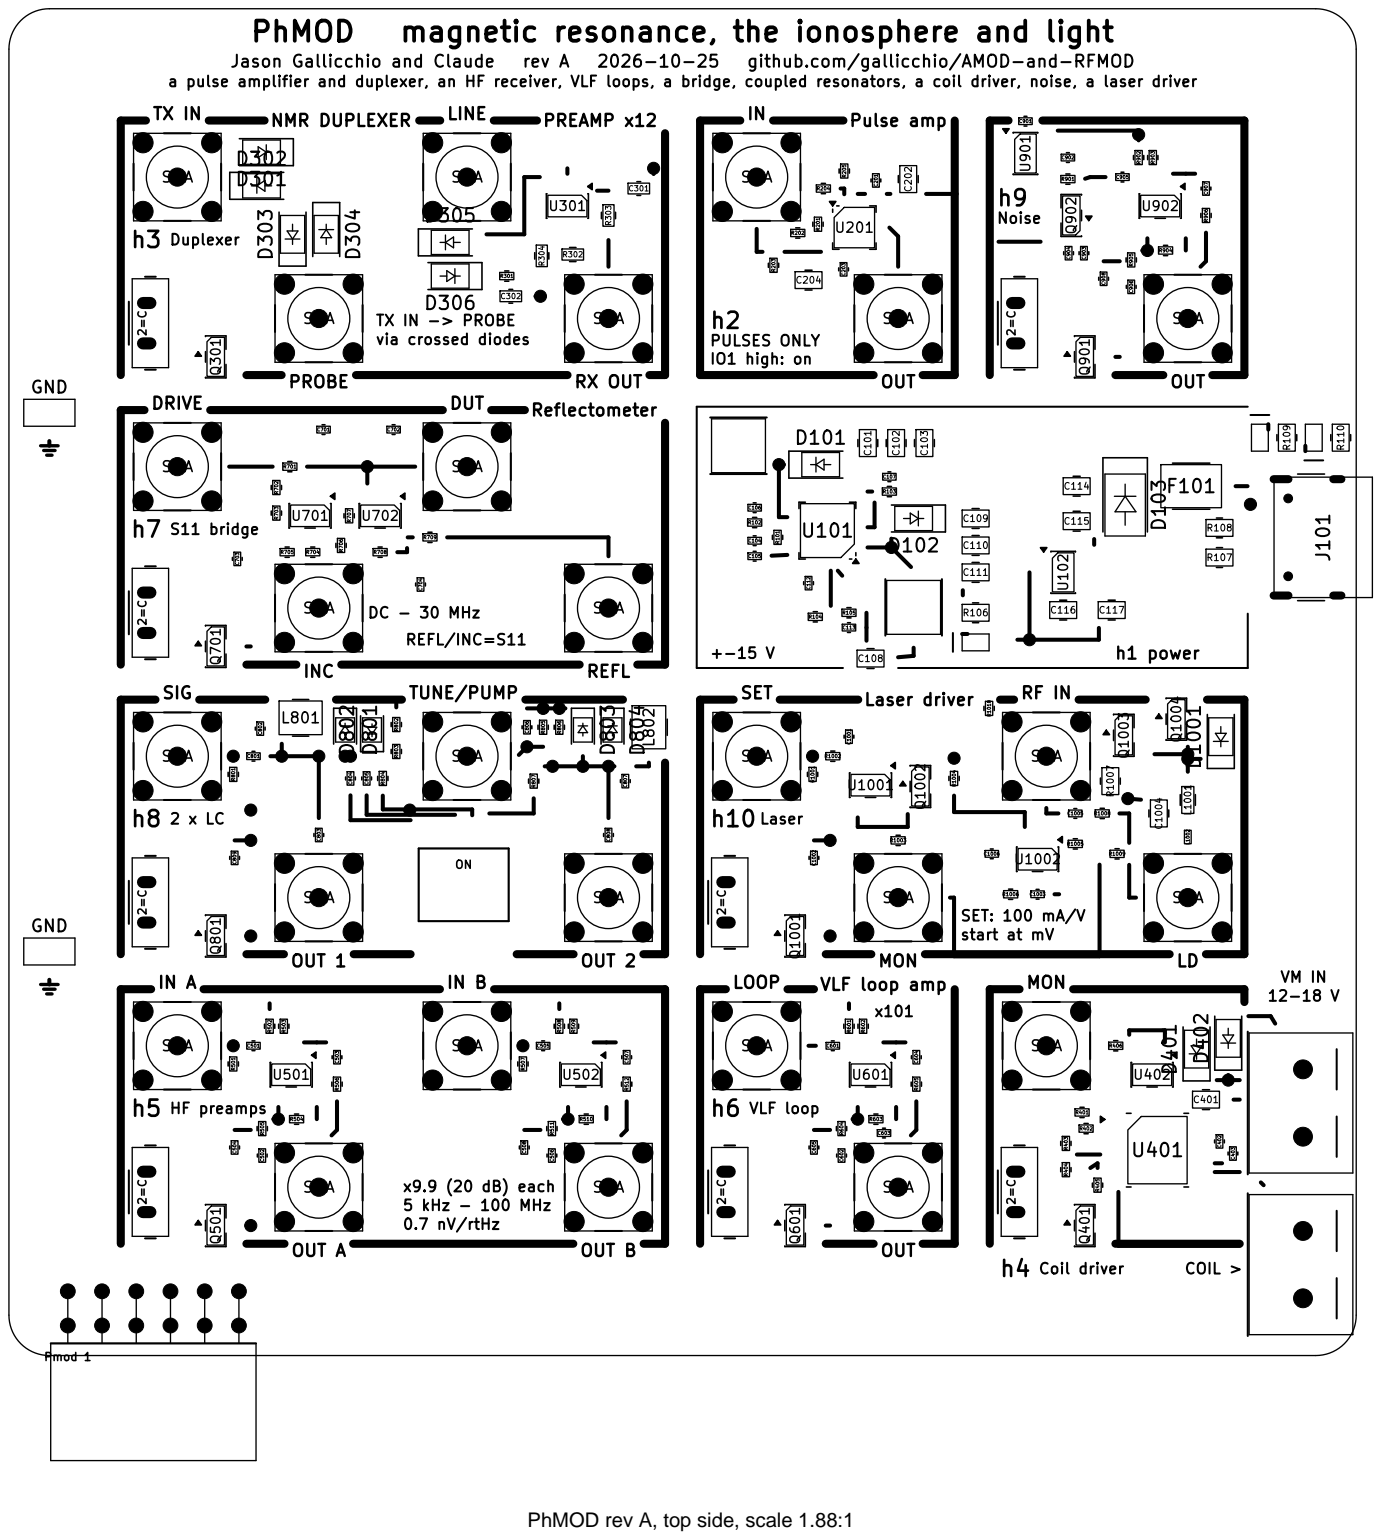
[picture p210: page 1]

a pulse amplifier and duplexer, an HF receiver, VLF loops, a bridge, coupled resonators, a coil driver, noise, a laser driver

SMA | C701 C702 | SMA

PhMOD rev A, top side, scale 1.88:1
