gallicchio/AMOD-and-RFMOD/out/rf_mod/rf_mod-assembly-bottom.pdf

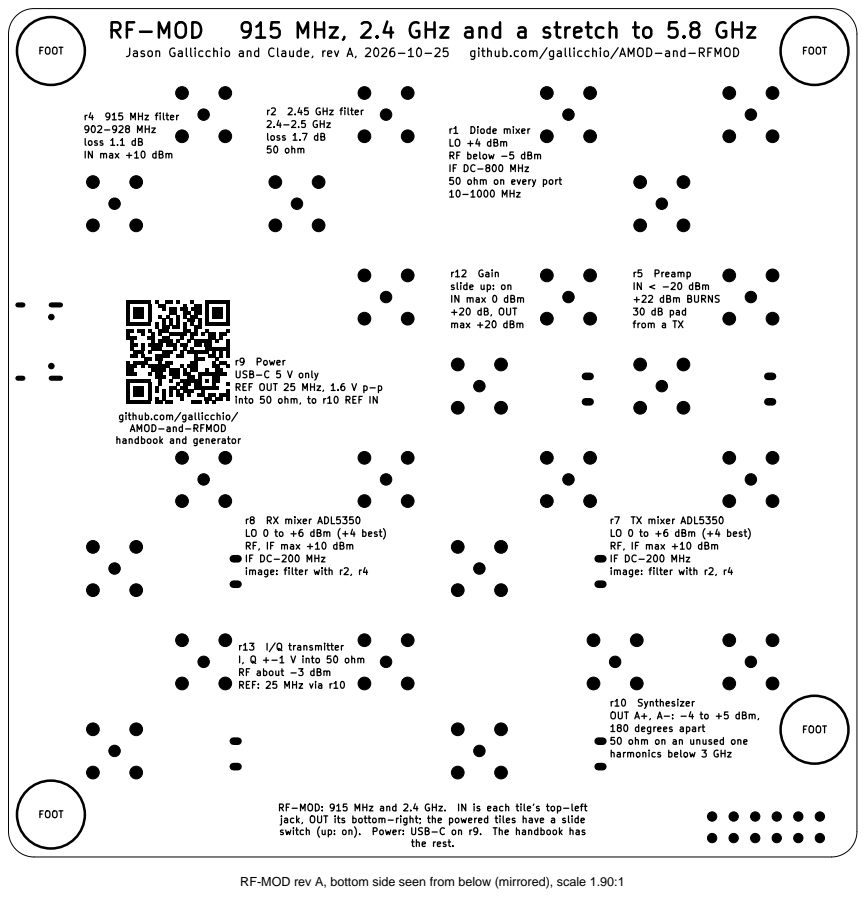
[picture p211: page 1]

r1 Diode mixer
LO +4 dBm
RF below -5 dBm
IF DC-800 MHz
50 ohm on every port
10-1000 MHz

r9 Power
USB-C 5 V only
REF OUT 25 MHz, 1.6 V p-p
into 50 ohm, to r10 REF IN

r8 RX mixer ADL5350
LO 0 to +6 dBm (+4 best)
RF, IF max +10 dBm
IF DC-200 MHz
image: filter with r2, r4

r7 TX mixer ADL5350

r10 Synthesizer
OUT A+, A-: -4 to +5 dBm,
180 degrees apart
50 ohm on an unused one
harmonics below 3 GHz

RF-MOD: 915 MHz and 2.4 GHz. IN is each tile's top-left
jack, OUT its bottom-right; the powered tiles have a slide
switch (up: on). Power: USB-C on r9. The handbook has

RF-MOD rev A, bottom side seen from below (mirrored), scale 1.90:1
