gallicchio/AMOD-and-RFMOD/out/rf_mod/rf_mod-assembly-top.pdf

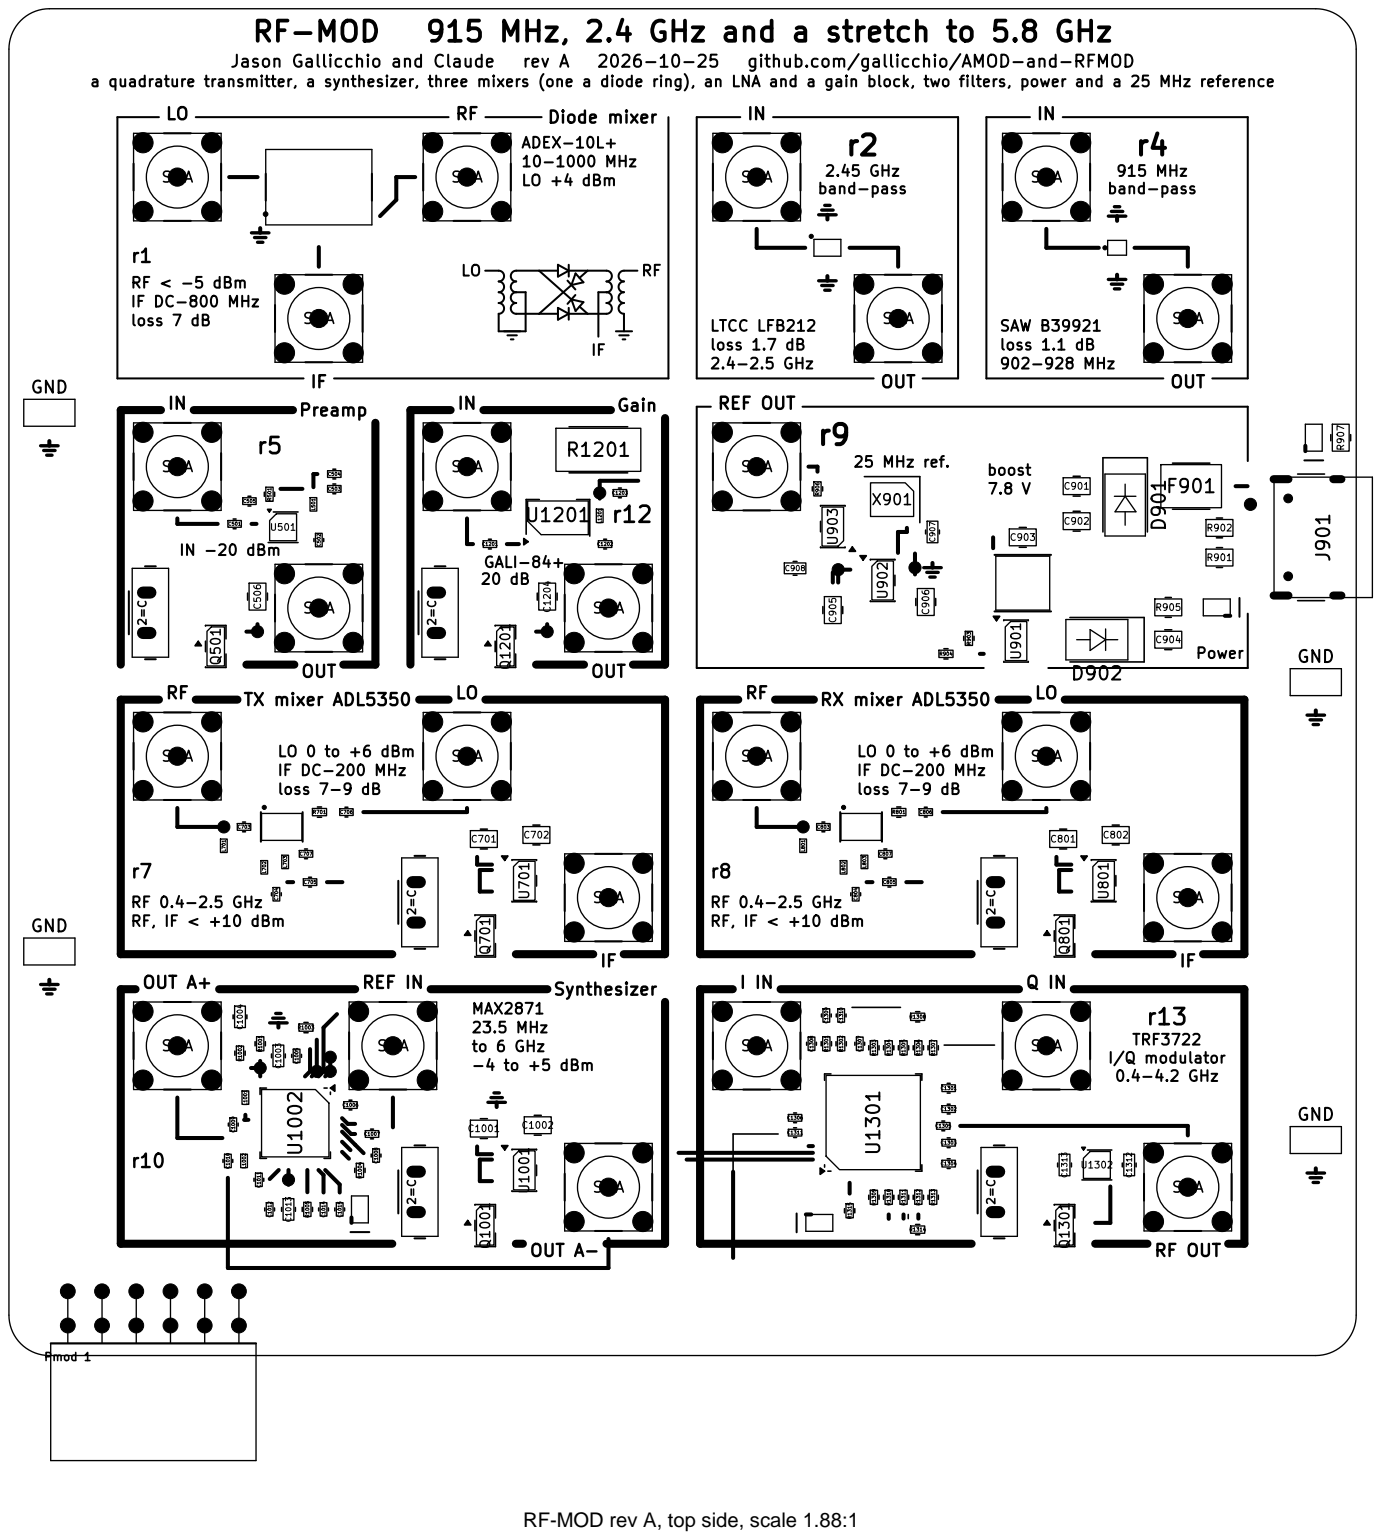
[picture p212: page 1]

a quadrature transmitter, a synthesizer, three mixers (one a diode ring), an LNA and a gain block, two filters, power and a 25 MHz reference

RF-MOD rev A, top side, scale 1.88:1
