gallicchio/AMOD-and-RFMOD/hardware/amod_a.kicad_pcb

## KiCad design hardware/amod_a.kicad_pcb (2026-10-30)

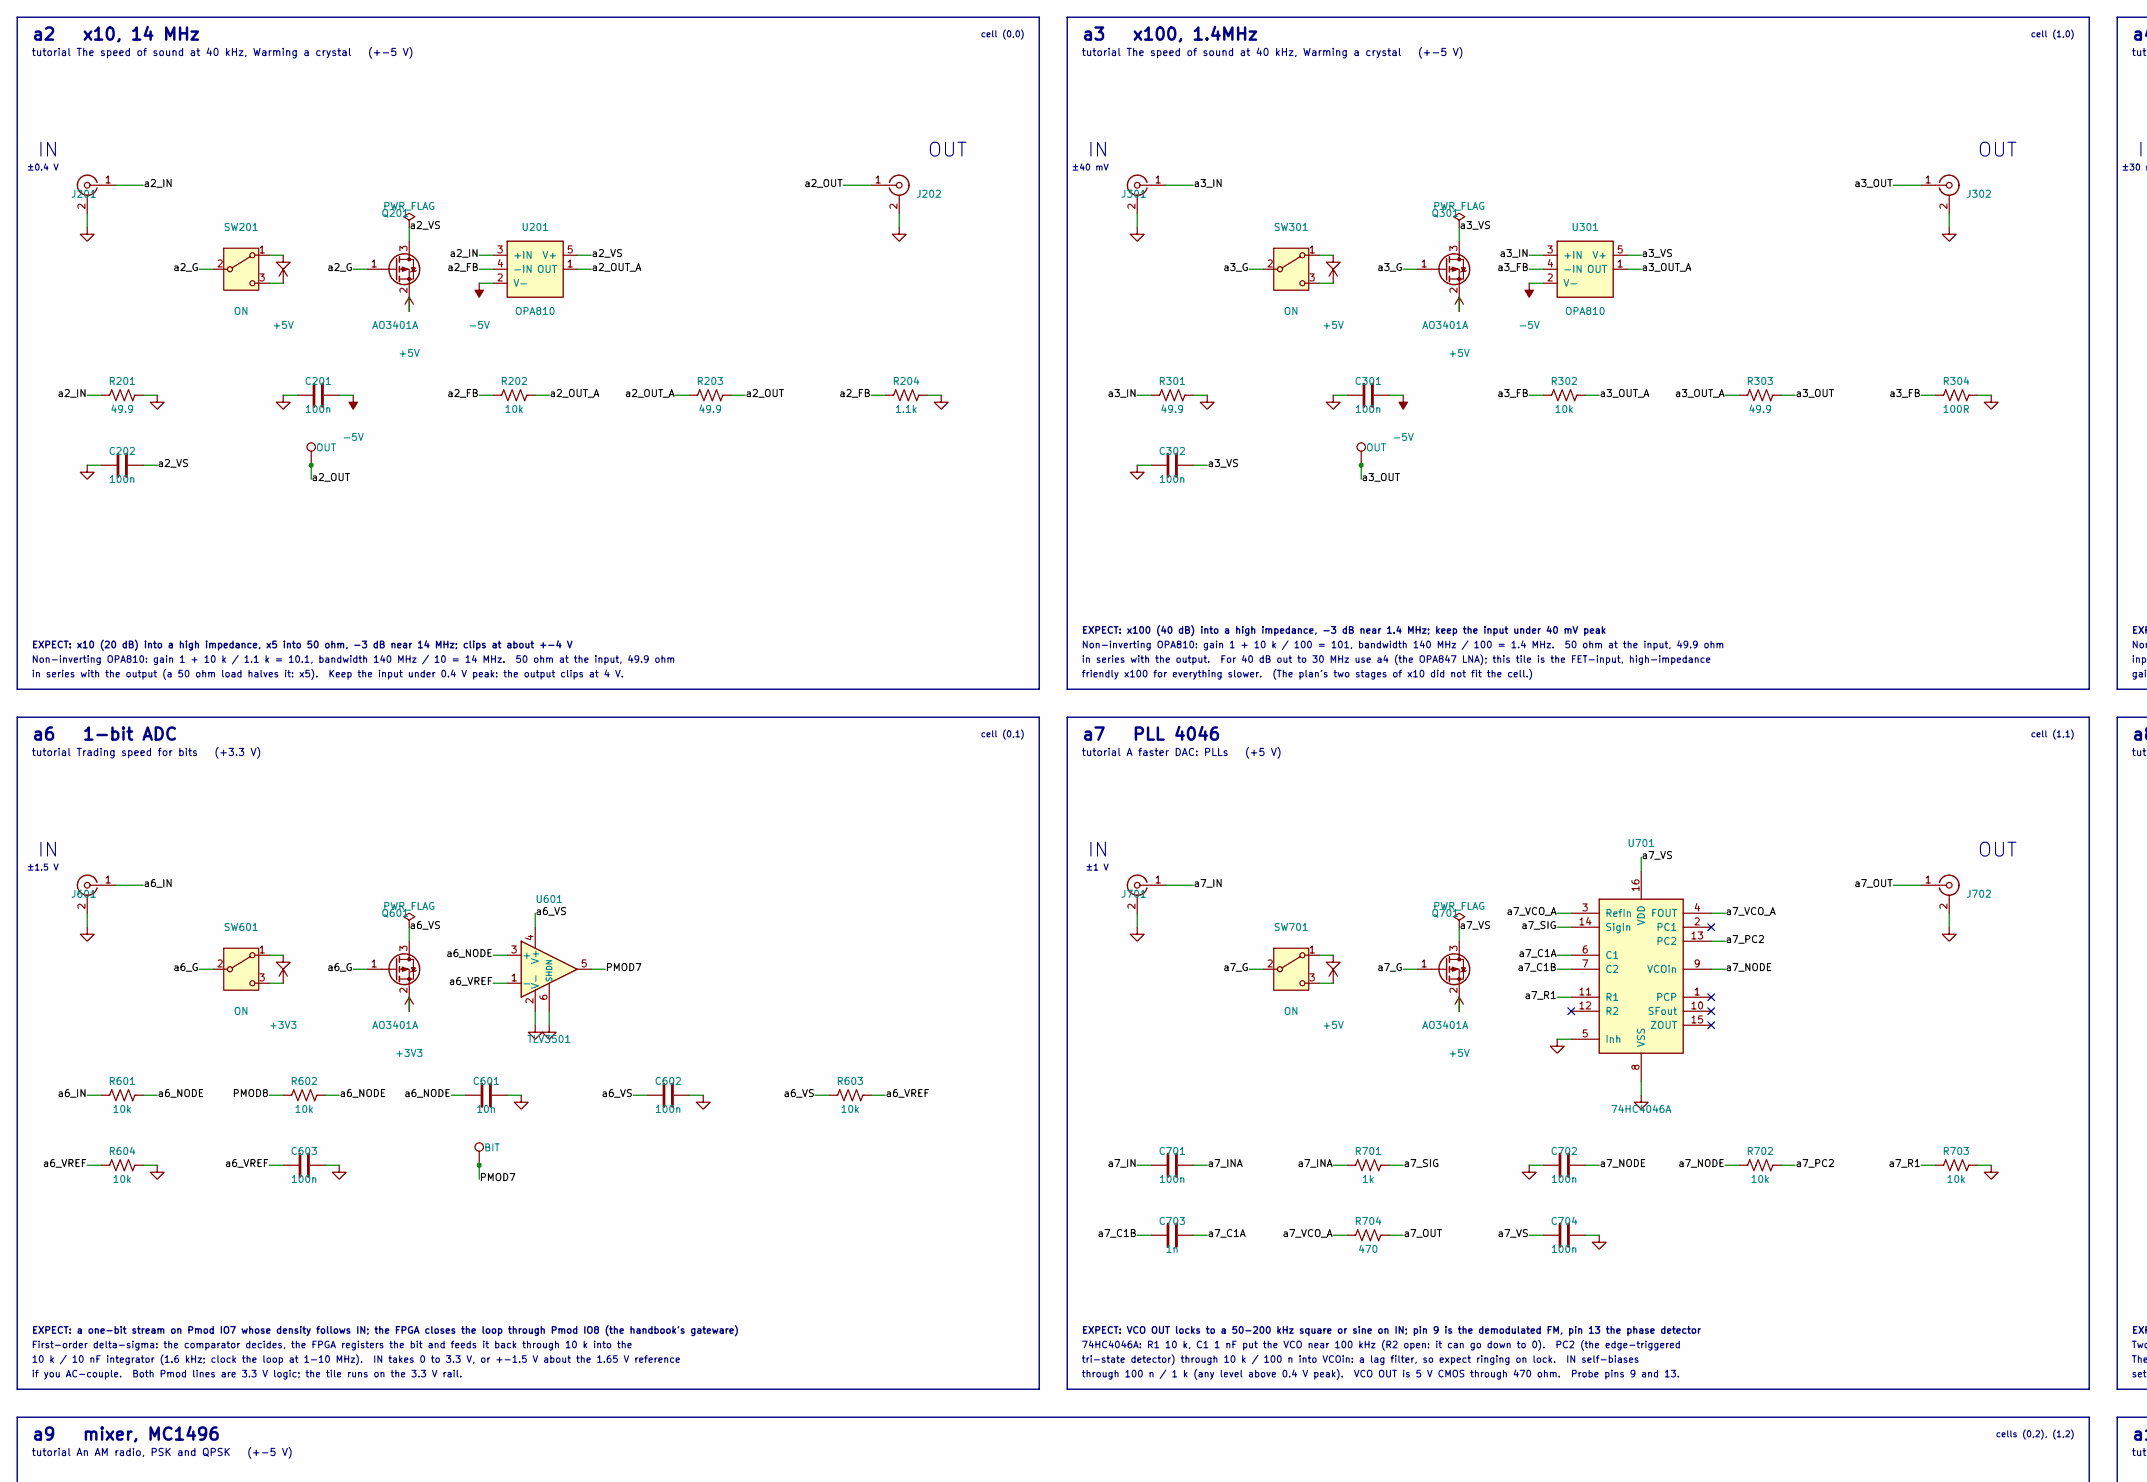
[picture p213: schematic amod_a.kicad_sch, AMOD-A: active building blocks on USB-C power, part in row 1, column 1]

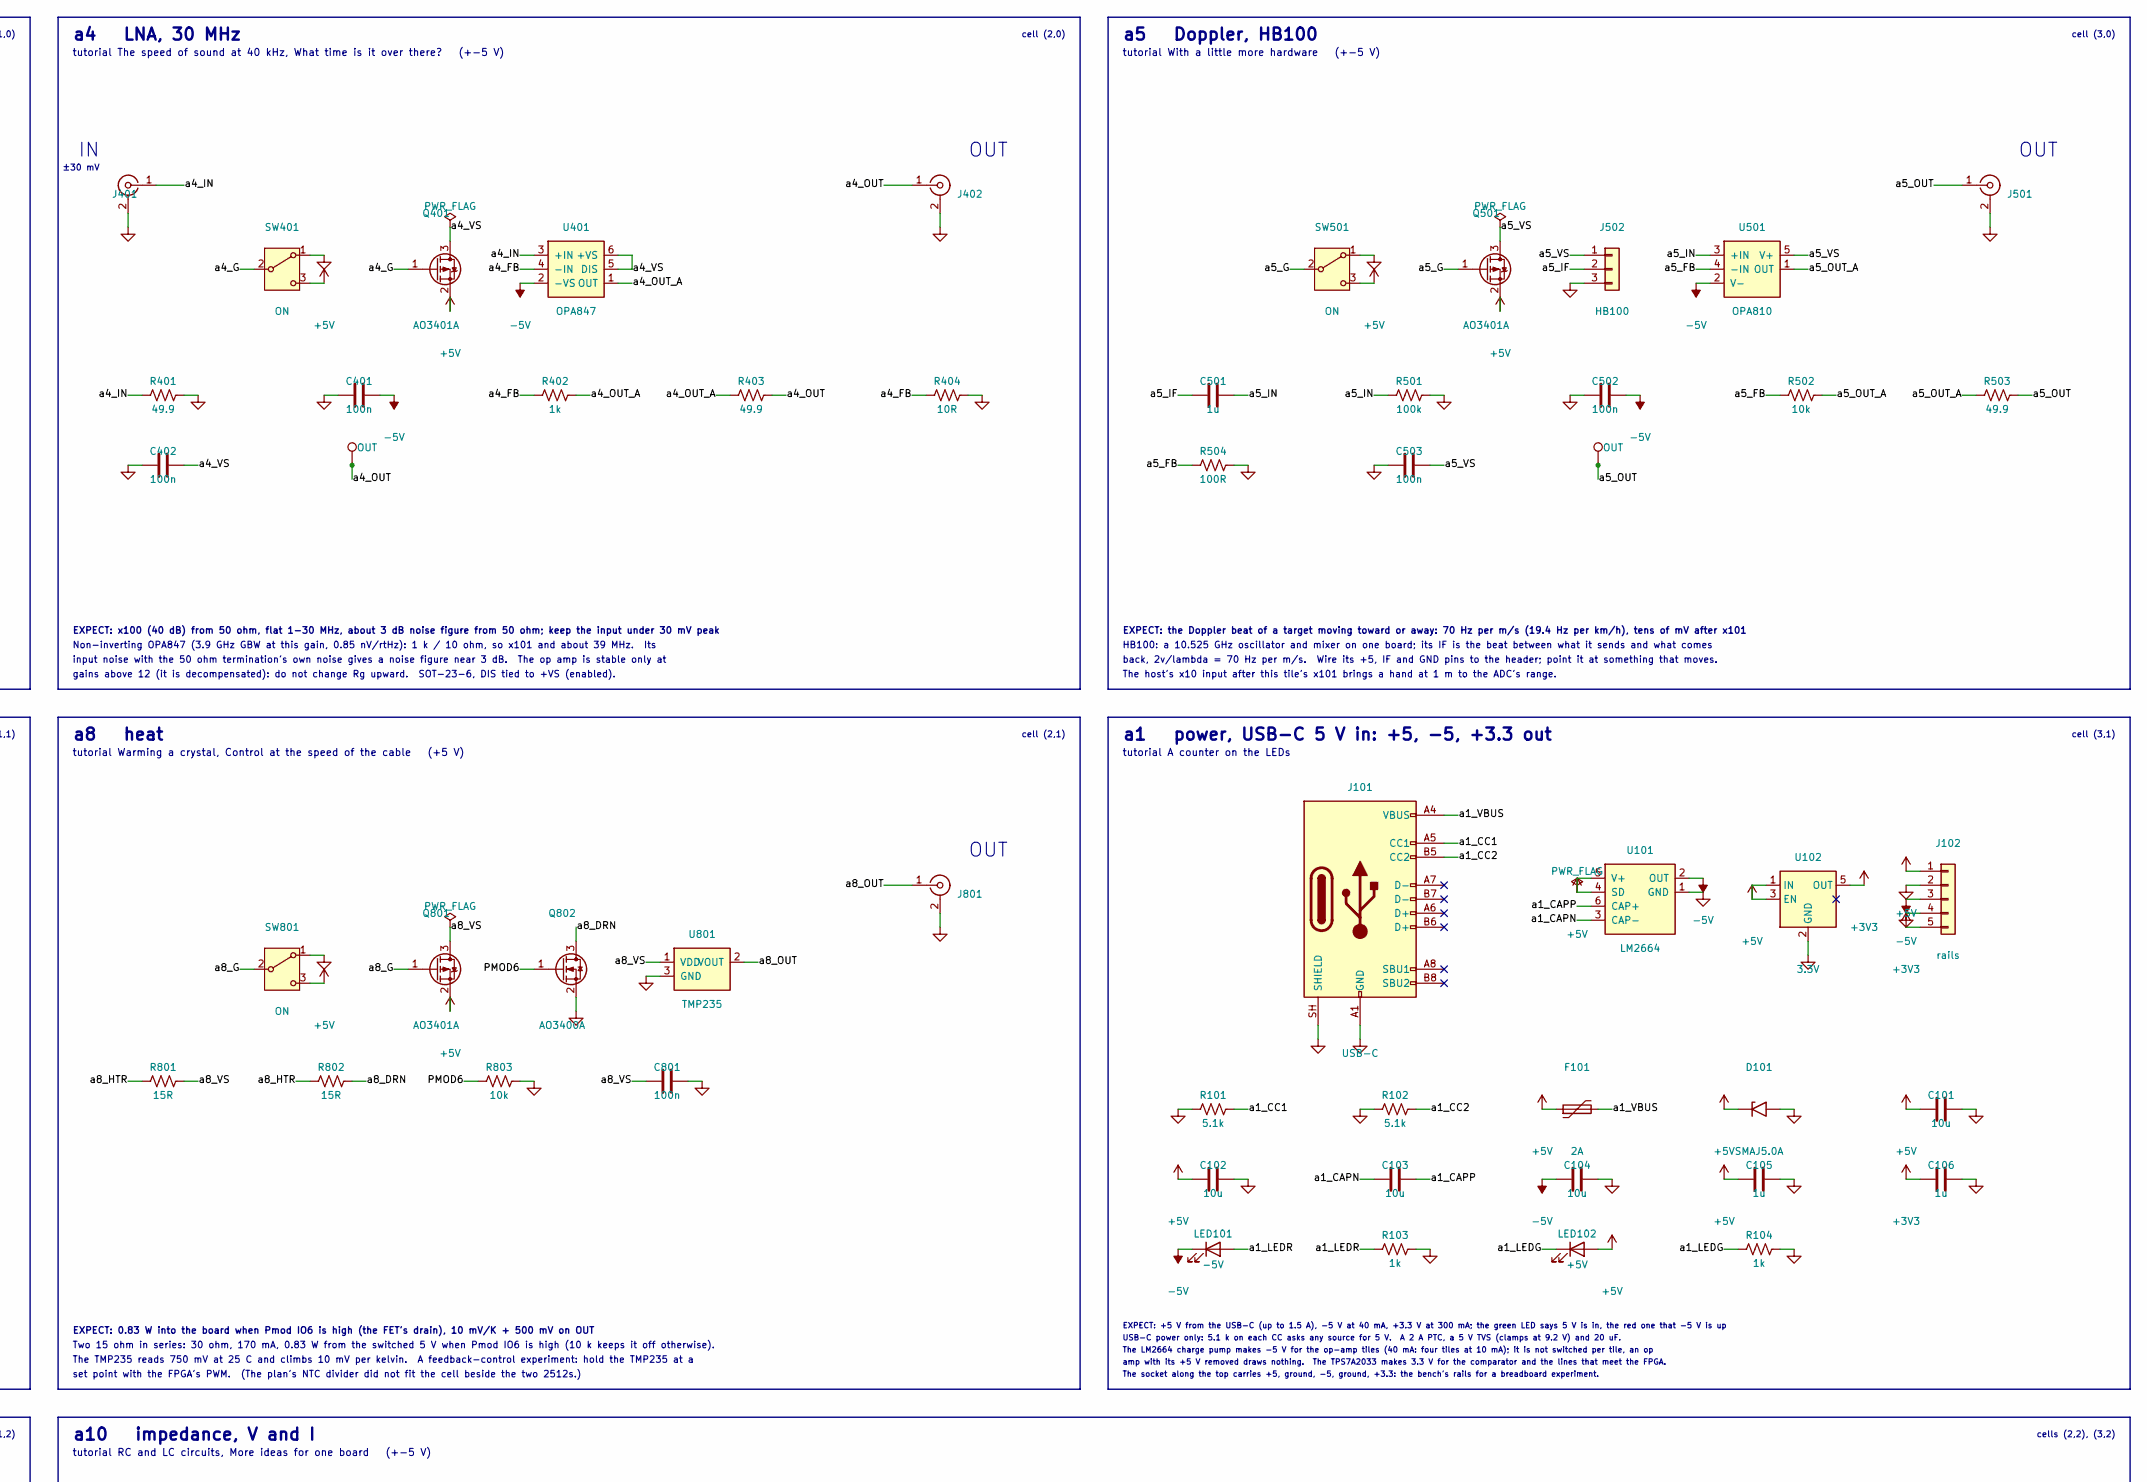
[picture p214: schematic amod_a.kicad_sch, AMOD-A: active building blocks on USB-C power, part in row 1, column 2]

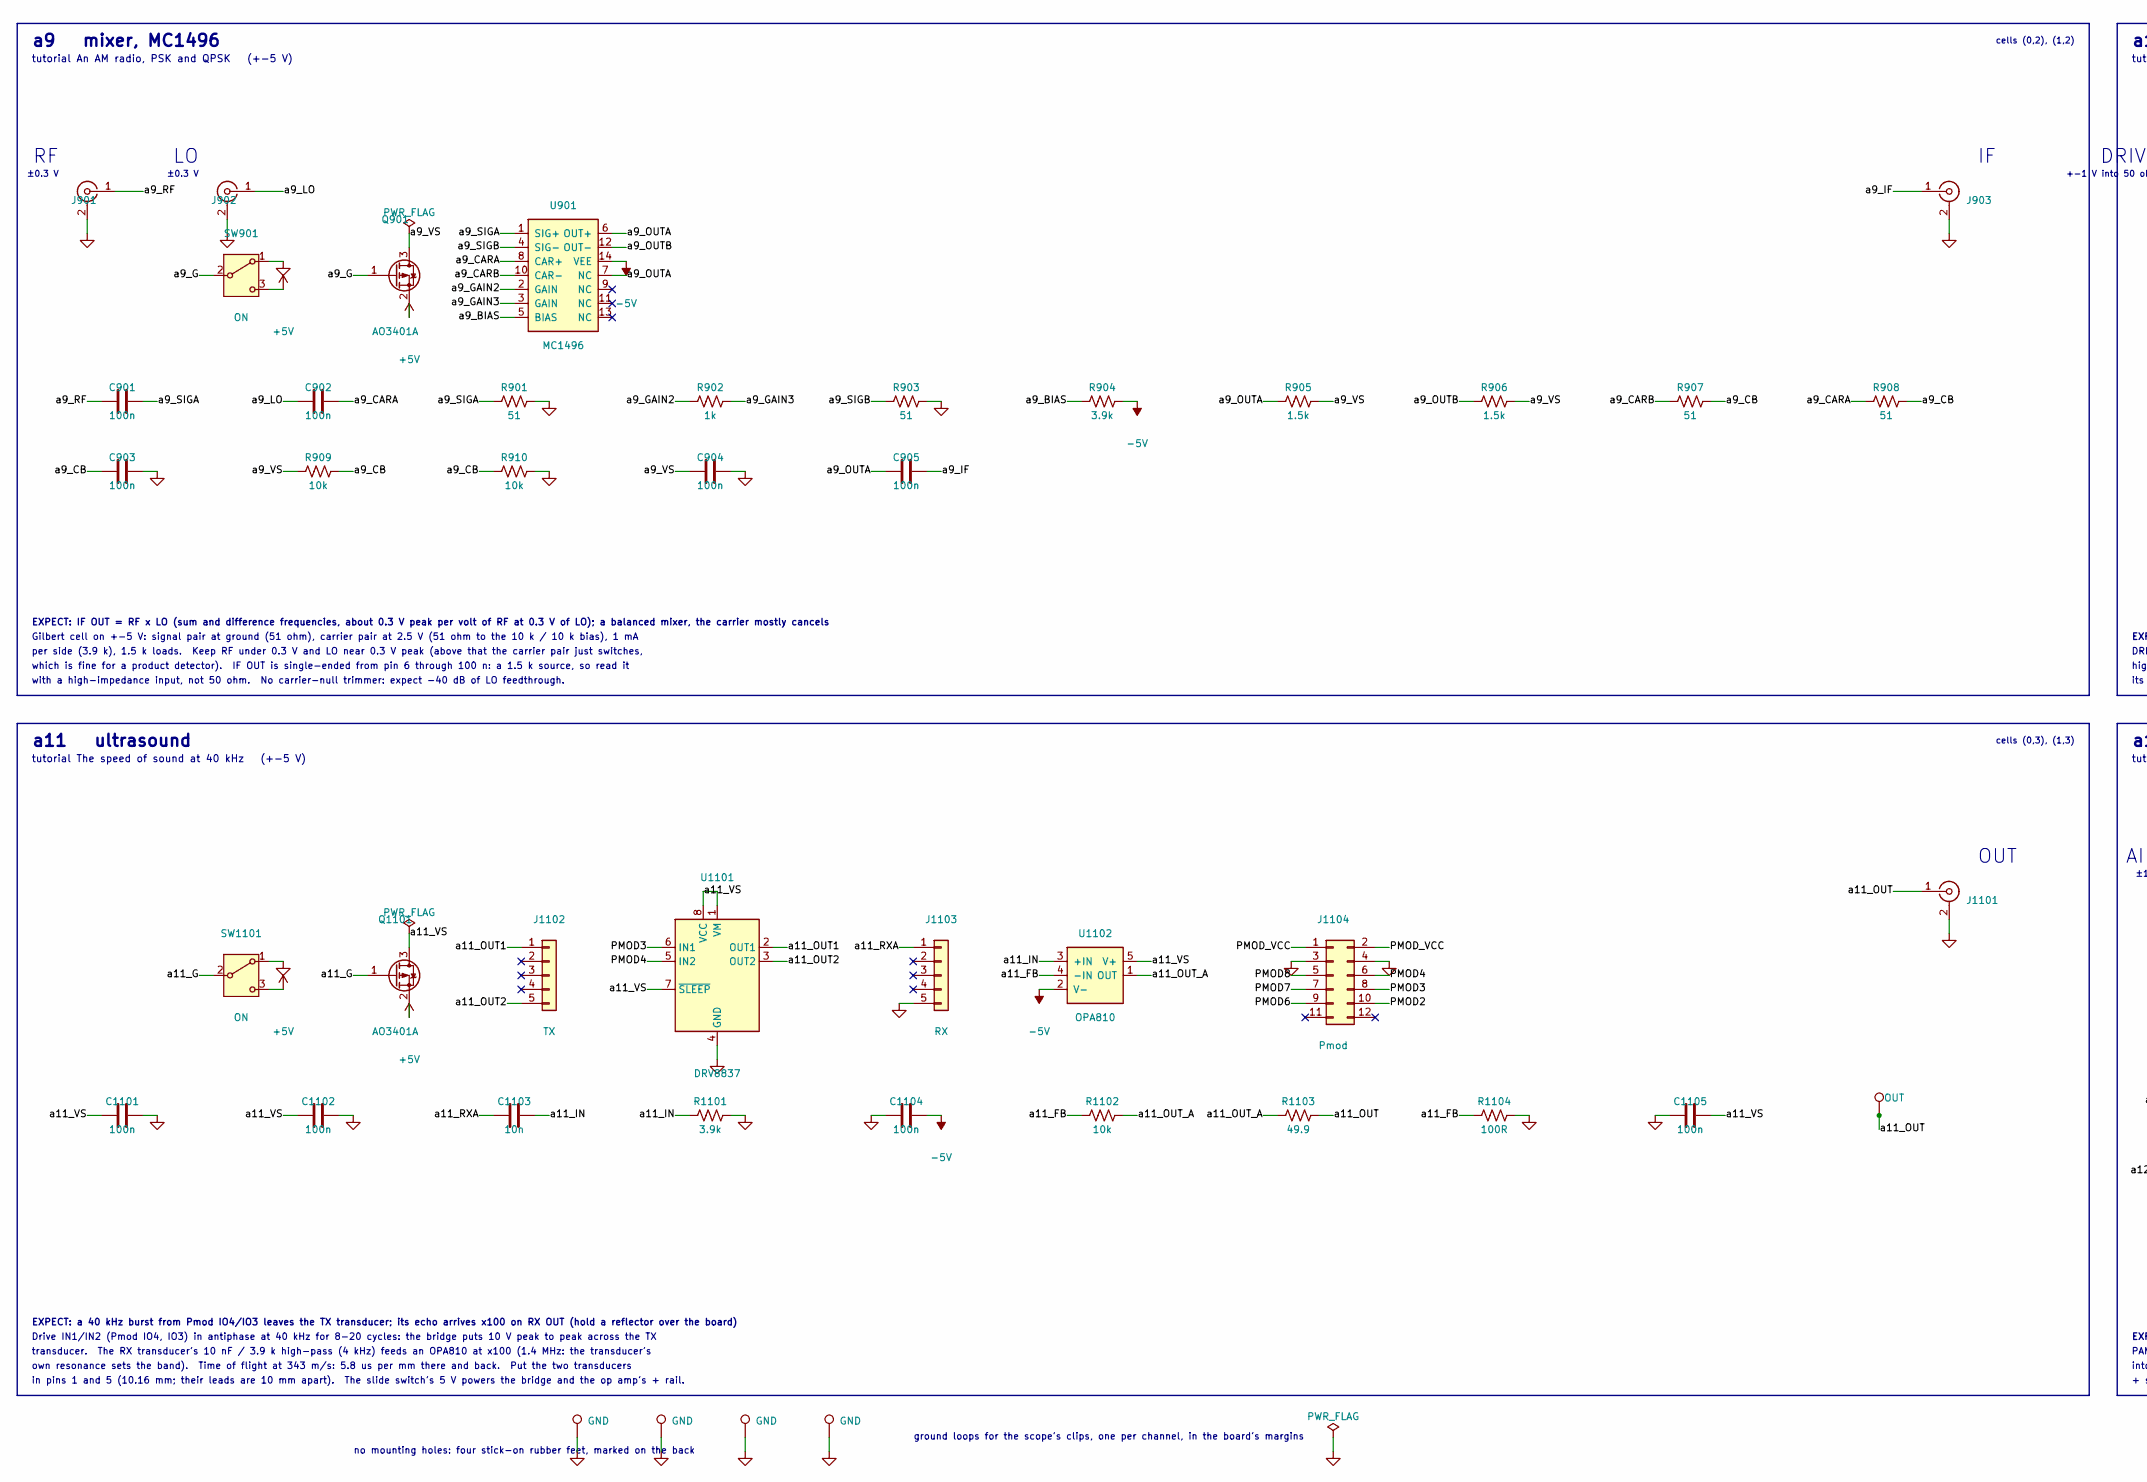
[picture p215: schematic amod_a.kicad_sch, AMOD-A: active building blocks on USB-C power, part in row 2, column 1]

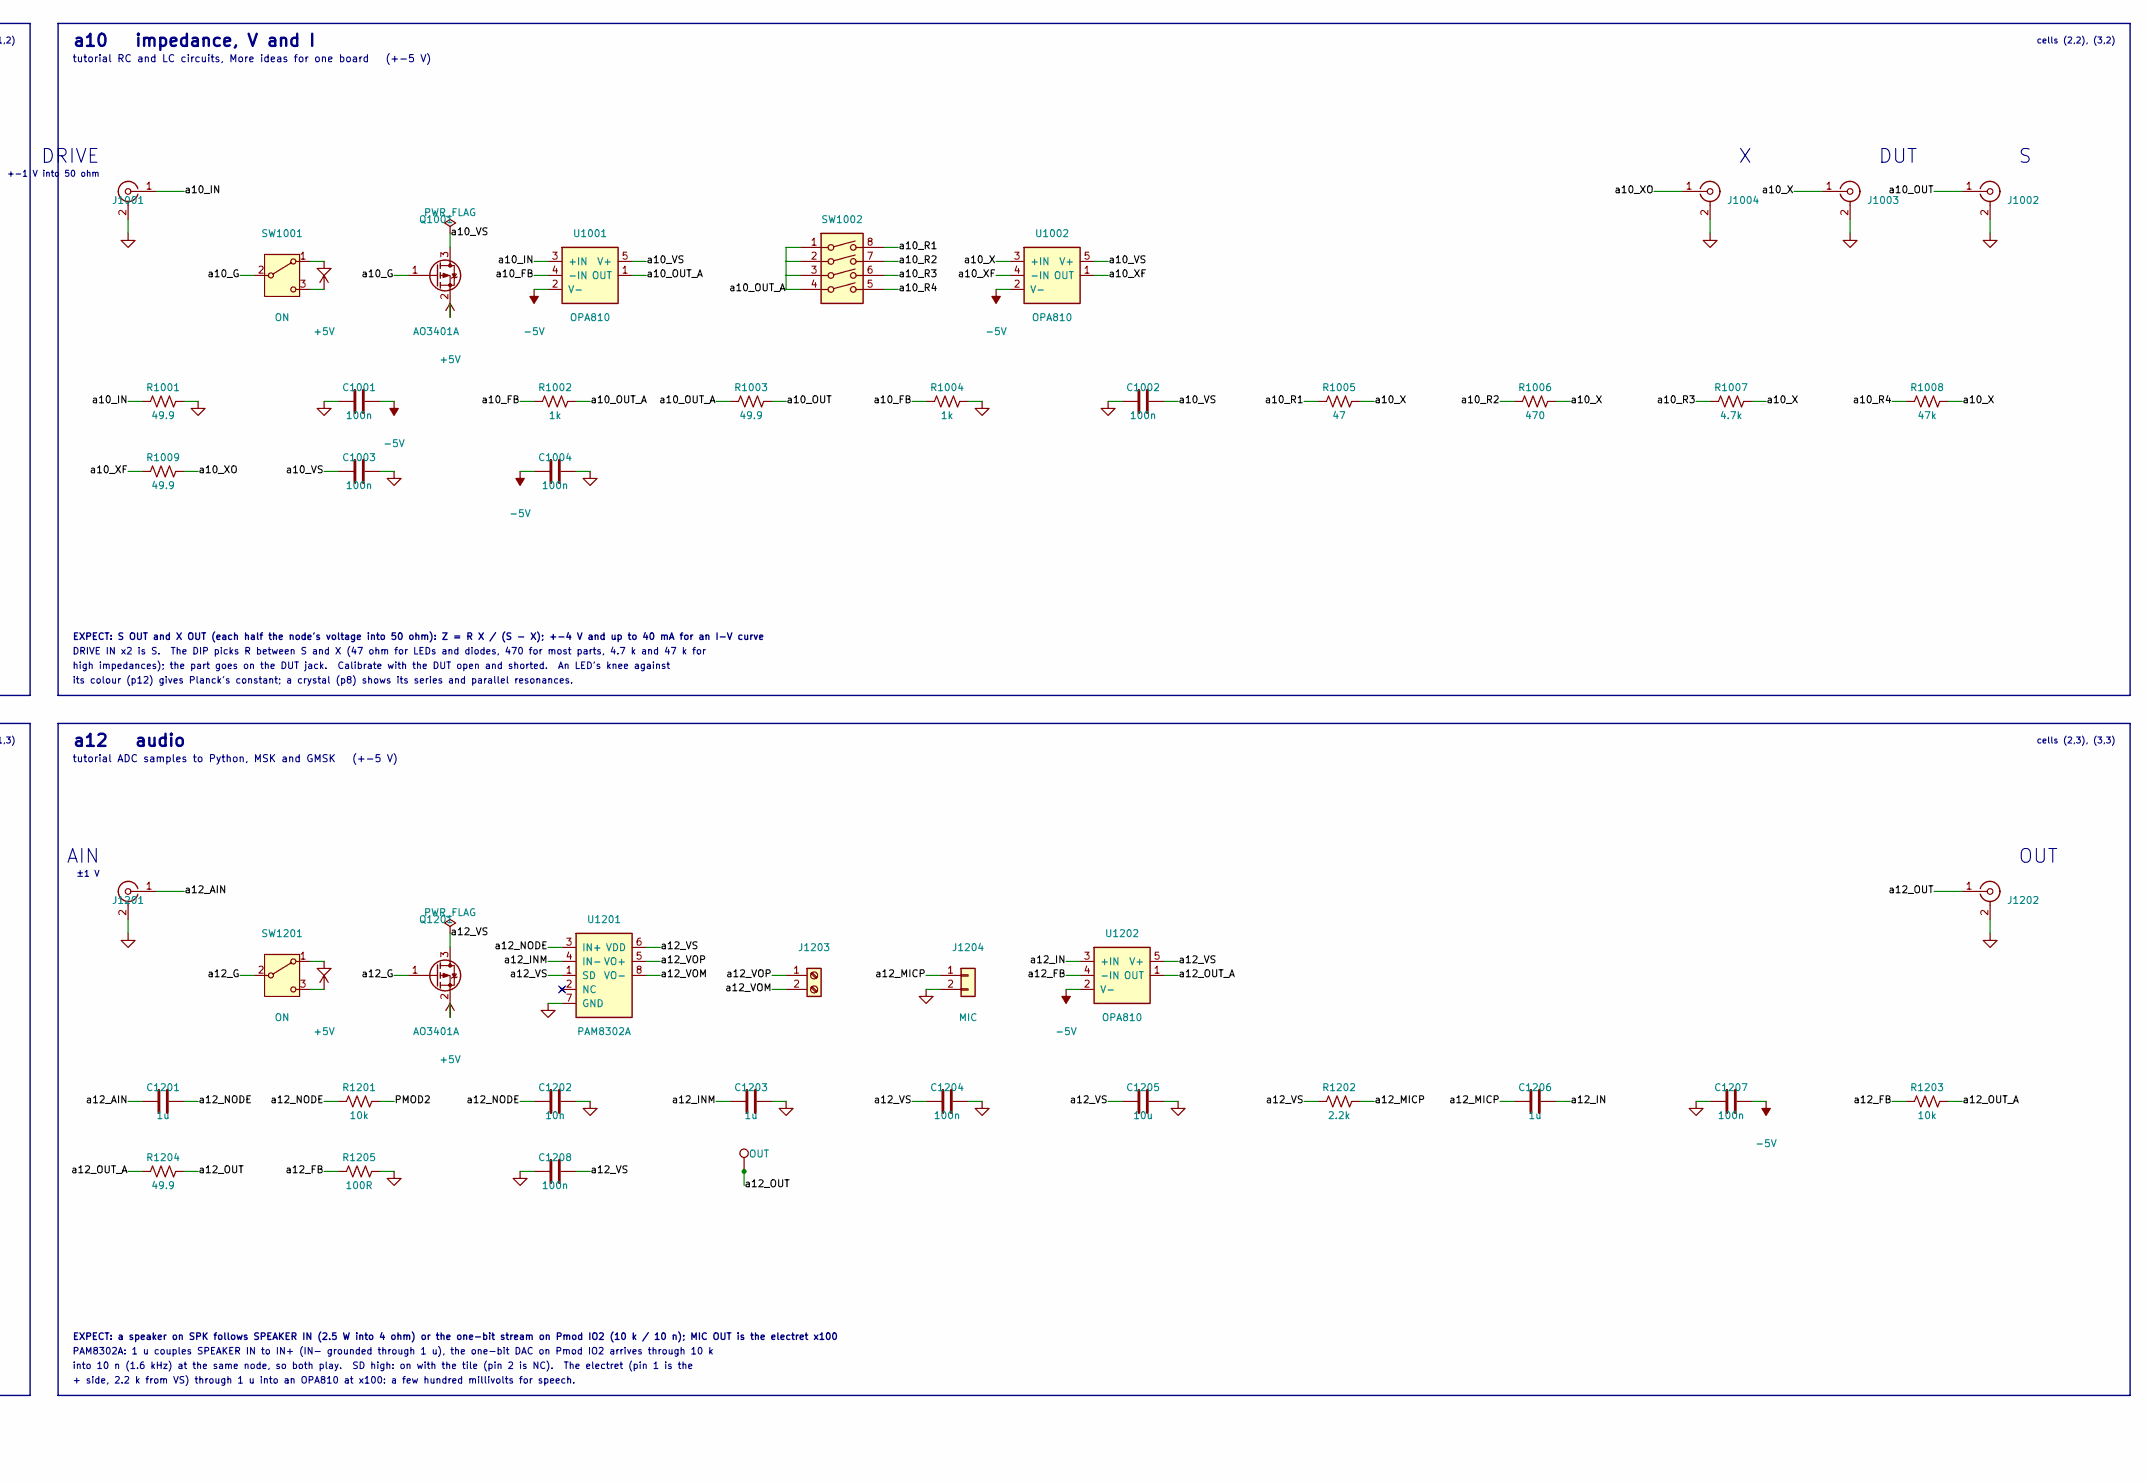
[picture p216: schematic amod_a.kicad_sch, AMOD-A: active building blocks on USB-C power, part in row 2, column 2]

Parts:
C101, C102, C103, C104, C1205: 10u; C_0805_2012Metric; MPN CL21A106KAYNNNE; LCSC C15850
C105, C106, C501, C1201: 1u; C_0805_2012Metric; MPN CL21B105KBFNNNE; LCSC C28323
C201, C202, C301, C302, C401, C402, C502, C503, C801, C901, C902, C903, C904, C905, C1001, C1002, C1003, C1004, C1101, C1102, C1104, C1105, C1204, C1207, C1208: 100n; C_0603_1608Metric; MPN CC0603KRX7R9BB104; LCSC C14663
C601, C1103, C1202: 10n; C_0805_2012Metric; MPN 0805CG103J500NT; LCSC C2971995
C602, C603: 100n; C_0805_2012Metric; MPN CC0805KRX7R9BB104; LCSC C49678
C701, C702, C704: 100n; C_0402_1005Metric; MPN CL05B104KO5NNNC; LCSC C1525
C703: 1n; C_0402_1005Metric; MPN 0402B102K500NT; LCSC C1523
C1203, C1206: 1u; C_0603_1608Metric; MPN CL10A105KB8NNNC; LCSC C15849
D101: SMAJ5.0A; D_SMA; MPN SMAJ5.0A; LCSC C78401
F101: 2A; Fuse_1812_4532Metric; MPN MF-MSMF200-2; LCSC C210837
J101: USB-C; USB_C_Receptacle_HRO_TYPE-C-31-M-12; MPN TYPE-C-31-M-12; LCSC C165948
J102: rails; PinSocket_1x05_P2.54mm_Vertical; MPN PZ254-1-05-Z-8.5; LCSC C2894928
J201, J202, J301, J302, J401, J402, J501, J601, J701, J702, J801, J901, J902, J903, J1001, J1002, J1003, J1004, J1101, J1201, J1202: SMA; SMA_BWSMA-KE-Z001_Vertical; MPN BWSMA-KE-Z001; LCSC C496549
J502: HB100; PinHeader_1x03_P2.54mm_Vertical; MPN PZ254V-11-03P; LCSC C2937625
J1102: TX; PinSocket_1x05_P2.54mm_Vertical; MPN PZ254-1-05-Z-8.5; LCSC C2894928
J1103: RX; PinSocket_1x05_P2.54mm_Vertical; MPN PZ254-1-05-Z-8.5; LCSC C2894928
J1104: Pmod; PinHeader_2x06_P2.54mm_Horizontal_PZ254R-12-12P; MPN PZ254R-12-12P; LCSC C492434
J1203: SPK; TerminalBlock_KF301_1x02_P5.00mm; MPN KF301-5.0-2P; LCSC C474881
J1204: MIC; PinSocket_1x02_P2.54mm_Vertical; MPN PZ254-1-02-Z-8.5; LCSC C2894925
LED101: -5V; LED_0805_2012Metric_Kbar; MPN NCD0805R1; LCSC C84256
LED102: +5V; LED_0805_2012Metric_Kbar; MPN KT-0805G; LCSC C2297
Q201, Q301, Q401, Q501, Q601, Q701, Q801, Q901, Q1001, Q1101, Q1201: AO3401A; SOT-23; MPN AO3401A; LCSC C15127
Q802: AO3400A; SOT-23; MPN AO3400A; LCSC C20917
R101, R102: 5.1k; R_0805_2012Metric; MPN 0805W8F5101T5E; LCSC C27834
R103, R104: 1k; R_0805_2012Metric; MPN 0805W8F1001T5E; LCSC C17513
R201, R203, R301, R303, R401, R403, R503, R1001, R1003, R1009, R1103, R1204: 49.9; R_0603_1608Metric; MPN SR0603FR-7T49R9L; LCSC C6230117
R202, R302, R502, R602, R803, R909, R910, R1102, R1201, R1203: 10k; R_0603_1608Metric; MPN 0603WAF1002T5E; LCSC C25804
R204: 1.1k; R_0603_1608Metric; MPN 0603WAF1101T5E; LCSC C22764
R304, R504, R1104, R1205: 100R; R_0603_1608Metric; MPN 0603WAF1000T5E; LCSC C22775
R402, R1002, R1004: 1k; R_0603_1608Metric; MPN 0603WAF1001T5E; LCSC C21190
R404: 10R; R_0603_1608Metric; MPN 0603WAF100JT5E; LCSC C22859
R501: 100k; R_0402_1005Metric; MPN 0402WGF1003TCE; LCSC C25741
R601, R603, R604: 10k; R_0805_2012Metric; MPN 0805W8F1002T5E; LCSC C17414
R701, R902: 1k; R_0402_1005Metric; MPN 0402WGF1001TCE; LCSC C11702
R702, R703: 10k; R_0402_1005Metric; MPN 0402WGF1002TCE; LCSC C25744
R704, R1006: 470; R_0402_1005Metric; MPN 0402WGF4700TCE; LCSC C25117
R801, R802: 15R; R_2512_6332Metric; MPN 25121WF150JT4E; LCSC C20087
R901, R903, R907, R908: 51; R_0402_1005Metric; MPN 0402WGF510JTCE; LCSC C25125
R904: 3.9k; R_0402_1005Metric; MPN 0402WGF3901TCE; LCSC C51721
R905: 1.5k; R_0402_1005Metric; MPN 0402WGF1501TCE; LCSC C25867
R906: 1.5k; R_0805_2012Metric; MPN 0805W8F1501T5E; LCSC C4310
R1005: 47; R_0402_1005Metric; MPN 0402WGF470JTCE; LCSC C25118
R1007: 4.7k; R_0402_1005Metric; MPN 0402WGF4701TCE; LCSC C25900
R1008: 47k; R_0402_1005Metric; MPN 0402WGF4702TCE; LCSC C25792
R1101: 3.9k; R_0805_2012Metric; MPN 0805W8F3901T5E; LCSC C17614
R1202: 2.2k; R_0805_2012Metric; MPN 0805W8F2201T5E; LCSC C17520
SW201, SW301, SW401, SW501, SW601, SW701, SW801, SW901, SW1001, SW1101, SW1201: ON; SW_SPDT_Shouhan_MSK12C02; MPN MSK12C02; LCSC C431540
SW1002: DIP4; SW_DIP_SPSTx04_Slide_1.27mm_DSHP04; MPN DSHP04TSGET; LCSC C40736
TP201, TP301, TP401, TP501, TP1101, TP1201: OUT; TestPoint_Loop_RH-5019; MPN RH-5019; LCSC C5199800
TP601: BIT; TestPoint_Loop_RH-5019; MPN RH-5019; LCSC C5199800
TP9901, TP9902, TP9903, TP9904: GND; TestPoint_Loop_RH-5019; MPN RH-5019; LCSC C5199800
U101: LM2664; SOT-23-6; MPN LM2664M6X/NOPB; LCSC C108573
U102: 3.3V; SOT-23-5; MPN TPS7A2033PDBVR; LCSC C2862740
U201, U301, U501, U1001, U1002, U1102, U1202: OPA810; SOT-23-5; MPN OPA810IDBVR; LCSC C2833513
U401: OPA847; SOT-23-6; MPN OPA847IDBVT; LCSC C2059024
U601: TLV3501; SOT-23-6; MPN TLV3501AIDBVR; LCSC C193413
U701: 74HC4046A; TSSOP-16_4.4x5mm_P0.65mm; MPN 74HC4046APW-Q100J; LCSC C546981
U801: TMP235; SOT-23; MPN TMP235A4DBZR; LCSC C2868809
U901: MC1496; SOIC-14_3.9x8.7mm_P1.27mm; MPN MC1496DR2G; LCSC C7295
U1101: DRV8837; Texas_DSG0008A_WSON-8-1EP_2x2mm_P0.5mm_EP0.9x1.6mm; MPN DRV8837DSGR; LCSC C39159
U1201: PAM8302A; MSOP-8_3x3mm_P0.65mm; MPN PAM8302AASCR; LCSC C113367

Connections:
+3V3: C106.1, J102.5, Q601.2 (S), SW601.3 (C), U102.5 (OUT)
+5V: C101.1, C102.1, C105.1, D101.1 (A1), F101.1, J102.1, LED102.2 (A), Q201.2 (S), Q301.2 (S), Q401.2 (S), Q501.2 (S), Q701.2 (S), Q801.2 (S), Q901.2 (S), Q1001.2 (S), Q1101.2 (S), Q1201.2 (S), SW201.3 (C), SW301.3 (C), SW401.3 (C), SW501.3 (C), SW701.3 (C), SW801.3 (C), SW901.3 (C), SW1001.3 (C), SW1101.3 (C), SW1201.3 (C), U101.4 (SD), U101.5 (V+), U102.1 (IN), U102.3 (EN)
-5V: C104.1, C201.2, C301.2, C401.2, C502.2, C1001.2, C1004.1, C1104.2, C1207.2, J102.3, LED101.1 (K), R904.2, U101.2 (OUT), U201.2 (V-), U301.2 (V-), U401.2 (-VS), U501.2 (V-), U901.14 (VEE), U1001.2 (V-), U1002.2 (V-), U1102.2 (V-), U1202.2 (V-)
/PMOD2: J1104.10, R1201.2
/PMOD3: J1104.8, U1101.6 (IN1)
/PMOD4: J1104.6, U1101.5 (IN2)
/PMOD6: J1104.9, Q802.1 (G), R803.1
/PMOD7: J1104.7, TP601.1, U601.5
/PMOD8: J1104.5, R602.1
/PMOD_VCC: J1104.1, J1104.2
/a1_CAPN: C103.1, U101.3 (CAP-)
/a1_CAPP: C103.2, U101.6 (CAP+)
/a1_CC1: J101.A5 (CC1), R101.2
/a1_CC2: J101.B5 (CC2), R102.2
/a1_LEDG: LED102.1 (K), R104.1
/a1_LEDR: LED101.2 (A), R103.1
/a1_VBUS: F101.2, J101.A4 (VBUS), J101.A9 (VBUS), J101.B4 (VBUS), J101.B9 (VBUS)
/a2_FB: R202.1, R204.1, U201.4 (-IN)
/a2_G: Q201.1 (G), SW201.2 (B)
/a2_IN: J201.1 (In), R201.1, U201.3 (+IN)
/a2_OUT: J202.1 (In), R203.2, TP201.1
/a2_OUT_A: R202.2, R203.1, U201.1 (OUT)
/a2_VS: C202.2, Q201.3 (D), U201.5 (V+)
/a3_FB: R302.1, R304.1, U301.4 (-IN)
/a3_G: Q301.1 (G), SW301.2 (B)
/a3_IN: J301.1 (In), R301.1, U301.3 (+IN)
/a3_OUT: J302.1 (In), R303.2, TP301.1
/a3_OUT_A: R302.2, R303.1, U301.1 (OUT)
/a3_VS: C302.2, Q301.3 (D), U301.5 (V+)
/a4_FB: R402.1, R404.1, U401.4 (-IN)
/a4_G: Q401.1 (G), SW401.2 (B)
/a4_IN: J401.1 (In), R401.1, U401.3 (+IN)
/a4_OUT: J402.1 (In), R403.2, TP401.1
/a4_OUT_A: R402.2, R403.1, U401.1 (OUT)
/a4_VS: C402.2, Q401.3 (D), U401.5 (DIS), U401.6 (+VS)
/a5_FB: R502.1, R504.1, U501.4 (-IN)
/a5_G: Q501.1 (G), SW501.2 (B)
/a5_IF: C501.1, J502.2
/a5_IN: C501.2, R501.1, U501.3 (+IN)
/a5_OUT: J501.1 (In), R503.2, TP501.1
/a5_OUT_A: R502.2, R503.1, U501.1 (OUT)
/a5_VS: C503.2, J502.1, Q501.3 (D), U501.5 (V+)
/a6_G: Q601.1 (G), SW601.2 (B)
/a6_IN: J601.1 (In), R601.1
/a6_NODE: C601.1, R601.2, R602.2, U601.3 (+)
/a6_VREF: C603.1, R603.2, R604.1, U601.1 (-)
/a6_VS: C602.1, Q601.3 (D), R603.1, U601.4 (V+)
/a7_C1A: C703.2, U701.6 (C1)
/a7_C1B: C703.1, U701.7 (C2)
/a7_G: Q701.1 (G), SW701.2 (B)
/a7_IN: C701.1, J701.1 (In)
/a7_INA: C701.2, R701.1
/a7_NODE: C702.2, R702.1, U701.9 (VCOin)
/a7_OUT: J702.1 (In), R704.2
/a7_PC2: R702.2, U701.13 (PC2)
/a7_R1: R703.1, U701.11 (R1)
/a7_SIG: R701.2, U701.14 (SigIn)
/a7_VCO_A: R704.1, U701.3 (RefIn), U701.4 (FOUT)
/a7_VS: C704.1, Q701.3 (D), U701.16 (VDD)
/a8_DRN: Q802.3 (D), R802.2
/a8_G: Q801.1 (G), SW801.2 (B)
/a8_HTR: R801.1, R802.1
/a8_OUT: J801.1 (In), U801.2 (VOUT)
/a8_VS: C801.1, Q801.3 (D), R801.2, U801.1 (VDD)
/a9_BIAS: R904.1, U901.5 (BIAS)
/a9_CARA: C902.2, R908.1, U901.8 (CAR+)
/a9_CARB: R907.1, U901.10 (CAR-)
/a9_CB: C903.1, R907.2, R908.2, R909.2, R910.1
/a9_G: Q901.1 (G), SW901.2 (B)
/a9_GAIN2: R902.1, U901.2 (GAIN)
/a9_GAIN3: R902.2, U901.3 (GAIN)
/a9_IF: C905.2, J903.1 (In)
/a9_LO: C902.1, J902.1 (In)
/a9_OUTA: C905.1, R905.1, U901.6 (OUT+), U901.7 (NC)
/a9_OUTB: R906.1, U901.12 (OUT-)
/a9_RF: C901.1, J901.1 (In)
/a9_SIGA: C901.2, R901.1, U901.1 (SIG+)
/a9_SIGB: R903.1, U901.4 (SIG-)
/a9_VS: C904.1, Q901.3 (D), R905.2, R906.2, R909.1
/a10_FB: R1002.1, R1004.1, U1001.4 (-IN)
/a10_G: Q1001.1 (G), SW1001.2 (B)
/a10_IN: J1001.1 (In), R1001.1, U1001.3 (+IN)
/a10_OUT: J1002.1 (In), R1003.2
/a10_OUT_A: R1002.2, R1003.1, SW1002.1, SW1002.2, SW1002.3, SW1002.4, U1001.1 (OUT)
/a10_R1: R1005.1, SW1002.8
/a10_R2: R1006.1, SW1002.7
/a10_R3: R1007.1, SW1002.6
/a10_R4: R1008.1, SW1002.5
/a10_VS: C1002.2, C1003.1, Q1001.3 (D), U1001.5 (V+), U1002.5 (V+)
/a10_X: J1003.1 (In), R1005.2, R1006.2, R1007.2, R1008.2, U1002.3 (+IN)
/a10_XF: R1009.1, U1002.1 (OUT), U1002.4 (-IN)
/a10_XO: J1004.1 (In), R1009.2
/a11_FB: R1102.1, R1104.1, U1102.4 (-IN)
/a11_G: Q1101.1 (G), SW1101.2 (B)
/a11_IN: C1103.2, R1101.1, U1102.3 (+IN)
/a11_OUT: J1101.1 (In), R1103.2, TP1101.1
/a11_OUT1: J1102.1, U1101.2 (OUT1)
/a11_OUT2: J1102.5, U1101.3 (OUT2)
/a11_OUT_A: R1102.2, R1103.1, U1102.1 (OUT)
/a11_RXA: C1103.1, J1103.1
/a11_VS: C1101.1, C1102.1, C1105.2, Q1101.3 (D), U1101.1 (VM), U1101.7 (~SLEEP), U1101.8 (VCC), U1102.5 (V+)
/a12_AIN: C1201.1, J1201.1 (In)
/a12_FB: R1203.1, R1205.1, U1202.4 (-IN)
/a12_G: Q1201.1 (G), SW1201.2 (B)
/a12_IN: C1206.2, U1202.3 (+IN)
/a12_INM: C1203.1, U1201.4 (IN-)
/a12_MICP: C1206.1, J1204.1, R1202.2
/a12_NODE: C1201.2, C1202.1, R1201.1, U1201.3 (IN+)
/a12_OUT: J1202.1 (In), R1204.2, TP1201.1
/a12_OUT_A: R1203.2, R1204.1, U1202.1 (OUT)
/a12_VOM: J1203.2, U1201.8 (VO-)
/a12_VOP: J1203.1, U1201.5 (VO+)
/a12_VS: C1204.1, C1205.1, C1208.2, Q1201.3 (D), R1202.1, U1201.1 (SD), U1201.6 (VDD), U1202.5 (V+)
GND: C101.2, C102.2, C104.2, C105.2, C106.2, C201.1, C202.1, C301.1, C302.1, C401.1, C402.1, C502.1, C503.1, C601.2, C602.2, C603.2, C702.1, C704.2, C801.2, C903.2, C904.2, C1001.1, C1002.1, C1003.2, C1004.2, C1101.2, C1102.2, C1104.1, C1105.1, C1202.2, C1203.2, C1204.2, C1205.2, C1207.1, C1208.1, D101.2 (A2), J101.A1 (GND), J101.A12 (GND), J101.B1 (GND), J101.B12 (GND), J101.SH (SHIELD), J102.2, J102.4, J201.2 (Ext), J202.2 (Ext), J301.2 (Ext), J302.2 (Ext), J401.2 (Ext), J402.2 (Ext), J501.2 (Ext), J502.3, J601.2 (Ext), J701.2 (Ext), J702.2 (Ext), J801.2 (Ext), J901.2 (Ext), J902.2 (Ext), J903.2 (Ext), J1001.2 (Ext), J1002.2 (Ext), J1003.2 (Ext), J1004.2 (Ext), J1101.2 (Ext), J1103.5, J1104.3, J1104.4, J1201.2 (Ext), J1202.2 (Ext), J1204.2, Q802.2 (S), R101.1, R102.1, R103.2, R104.2, R201.2, R204.2, R301.2, R304.2, R401.2, R404.2, R501.2, R504.2, R604.2, R703.2, R803.2, R901.2, R903.2, R910.2, R1001.2, R1004.2, R1101.2, R1104.2, R1205.2, SW201.1 (A), SW301.1 (A), SW401.1 (A), SW501.1 (A), SW601.1 (A), SW701.1 (A), SW801.1 (A), SW901.1 (A), SW1001.1 (A), SW1101.1 (A), SW1201.1 (A), TP9901.1, TP9902.1, TP9903.1, TP9904.1, U101.1 (GND), U102.2 (GND), U601.2 (V-), U601.6 (SHDN), U701.5 (Inh), U701.8 (VSS), U801.3 (GND), U1101.4 (GND), U1101.9 (GND), U1201.7 (GND)

Notes on the sheet:
OUT
tutorial The speed of sound at 40 kHz, Warming a crystal (+-5 V)
per side (3.9 k), 1.5 k loads. Keep RF under 0.3 V and LO near 0.3 V peak (above that the carrier pair just switches,
±1.5 V
tutorial ADC samples to Python, MSK and GMSK (+-5 V)
cells (2,2), (3,2)
Gilbert cell on +-5 V: signal pair at ground (51 ohm), carrier pair at 2.5 V (51 ohm to the 10 k / 10 k bias), 1 mA
cell (2,1)
a1 power, USB-C 5 V in: +5, -5, +3.3 out
a10 impedance, V and I
tutorial The speed of sound at 40 kHz, What time is it over there? (+-5 V)
a11 ultrasound
cell (2,0)
10 k / 10 nF integrator (1.6 kHz; clock the loop at 1-10 MHz). IN takes 0 to 3.3 V, or +-1.5 V about the 1.65 V reference
USB-C power only: 5.1 k on each CC asks any source for 5 V. A 2 A PTC, a 5 V TVS (clamps at 9.2 V) and 20 uF.
±40 mV
a9 mixer, MC1496
Non-inverting OPA847 (3.9 GHz GBW at this gain, 0.85 nV/rtHz): 1 k / 10 ohm, so x101 and about 39 MHz. Its
gains above 12 (it is decompensated): do not change Rg upward. SOT-23-6, DIS tied to +VS (enabled).
The socket along the top carries +5, ground, -5, ground, +3.3: the bench's rails for a breadboard experiment.
The TMP235 reads 750 mV at 25 C and climbs 10 mV per kelvin. A feedback-control experiment: hold the TMP235 at a
Drive IN1/IN2 (Pmod IO4, IO3) in antiphase at 40 kHz for 8-20 cycles: the bridge puts 10 V peak to peak across the TX
First-order delta-sigma: the comparator decides, the FPGA registers the bit and feeds it back through 10 k into the
cell (0,1)
with a high-impedance input, not 50 ohm. No carrier-null trimmer: expect -40 dB of LO feedthrough.
Non-inverting OPA810: gain 1 + 10 k / 1.1 k = 10.1, bandwidth 140 MHz / 10 = 14 MHz. 50 ohm at the input, 49.9 ohm
in series with the output. For 40 dB out to 30 MHz use a4 (the OPA847 LNA); this tile is the FET-input, high-impedance
set point with the FPGA's PWM. (The plan's NTC divider did not fit the cell beside the two 2512s.)
DUT
EXPECT: x100 (40 dB) from 50 ohm, flat 1-30 MHz, about 3 dB noise figure from 50 ohm; keep the input under 30 mV peak
cells (2,3), (3,3)
amp with its +5 V removed draws nothing. The TPS7A2033 makes 3.3 V for the comparator and the lines that meet the FPGA.
tutorial The speed of sound at 40 kHz (+-5 V)
The LM2664 charge pump makes -5 V for the op-amp tiles (40 mA: four tiles at 10 mA); it is not switched per tile, an op
±0.3 V
its colour (p12) gives Planck's constant; a crystal (p8) shows its series and parallel resonances.
PAM8302A: 1 u couples SPEAKER IN to IN+ (IN- grounded through 1 u), the one-bit DAC on Pmod IO2 arrives through 10 k
tutorial A counter on the LEDs
cells (0,3), (1,3)
ground loops for the scope's clips, one per channel, in the board's margins
which is fine for a product detector). IF OUT is single-ended from pin 6 through 100 n: a 1.5 k source, so read it
a12 audio
±0.4 V
EXPECT: S OUT and X OUT (each half the node's voltage into 50 ohm): Z = R X / (S - X); +-4 V and up to 40 mA for an I-V curve
+ side, 2.2 k from VS) through 1 u into an OPA810 at x100: a few hundred millivolts for speech.
no mounting holes: four stick-on rubber feet, marked on the back
EXPECT: 0.83 W into the board when Pmod IO6 is high (the FET's drain), 10 mV/K + 500 mV on OUT
EXPECT: x100 (40 dB) into a high impedance, -3 dB near 1.4 MHz; keep the input under 40 mV peak
tri-state detector) through 10 k / 100 n into VCOin: a lag filter, so expect ringing on lock. IN self-biases
74HC4046A: R1 10 k, C1 1 nF put the VCO near 100 kHz (R2 open: it can go down to 0). PC2 (the edge-triggered
input noise with the 50 ohm termination's own noise gives a noise figure near 3 dB. The op amp is stable only at
a2 x10, 14 MHz
DRIVE
EXPECT: a 40 kHz burst from Pmod IO4/IO3 leaves the TX transducer; its echo arrives x100 on RX OUT (hold a reflector over the board)
in pins 1 and 5 (10.16 mm; their leads are 10 mm apart). The slide switch's 5 V powers the bridge and the op amp's + rail.
transducer. The RX transducer's 10 nF / 3.9 k high-pass (4 kHz) feeds an OPA810 at x100 (1.4 MHz: the transducer's
back, 2v/lambda = 70 Hz per m/s. Wire its +5, IF and GND pins to the header; point it at something that moves.
Non-inverting OPA810: gain 1 + 10 k / 100 = 101, bandwidth 140 MHz / 100 = 1.4 MHz. 50 ohm at the input, 49.9 ohm
a3 x100, 1.4MHz
tutorial RC and LC circuits, More ideas for one board (+-5 V)
friendly x100 for everything slower. (The plan's two stages of x10 did not fit the cell.)
±1 V
EXPECT: a speaker on SPK follows SPEAKER IN (2.5 W into 4 ohm) or the one-bit stream on Pmod IO2 (10 k / 10 n); MIC OUT is the electret x100
EXPECT: a one-bit stream on Pmod IO7 whose density follows IN; the FPGA closes the loop through Pmod IO8 (the handbook's gateware)
tutorial Trading speed for bits (+3.3 V)
Two 15 ohm in series: 30 ohm, 170 mA, 0.83 W from the switched 5 V when Pmod IO6 is high (10 k keeps it off otherwise).
a7 PLL 4046
cell (0,0)
EXPECT: +5 V from the USB-C (up to 1.5 A), -5 V at 40 mA, +3.3 V at 300 mA; the green LED says 5 V is in, the red one that -5 V is up
tutorial Warming a crystal, Control at the speed of the cable (+5 V)
a5 Doppler, HB100
AIN
own resonance sets the band). Time of flight at 343 m/s: 5.8 us per mm there and back. Put the two transducers
a6 1-bit ADC
tutorial An AM radio, PSK and QPSK (+-5 V)
in series with the output (a 50 ohm load halves it: x5). Keep the input under 0.4 V peak: the output clips at 4 V.
±30 mV
through 100 n / 1 k (any level above 0.4 V peak). VCO OUT is 5 V CMOS through 470 ohm. Probe pins 9 and 13.
tutorial A faster DAC: PLLs (+5 V)
cell (3,0)
EXPECT: VCO OUT locks to a 50-200 kHz square or sine on IN; pin 9 is the demodulated FM, pin 13 the phase detector
HB100: a 10.525 GHz oscillator and mixer on one board; its IF is the beat between what it sends and what comes
+-1 V into 50 ohm
DRIVE IN x2 is S. The DIP picks R between S and X (47 ohm for LEDs and diodes, 470 for most parts, 4.7 k and 47 k for
EXPECT: x10 (20 dB) into a high impedance, x5 into 50 ohm, -3 dB near 14 MHz; clips at about +-4 V
cell (1,0)
EXPECT: IF OUT = RF x LO (sum and difference frequencies, about 0.3 V peak per volt of RF at 0.3 V of LO); a balanced mixer, the carrier mostly cancels
The host's x10 input after this tile's x101 brings a hand at 1 m to the ADC's range.
a4 LNA, 30 MHz
tutorial With a little more hardware (+-5 V)
a8 heat
high impedances); the part goes on the DUT jack. Calibrate with the DUT open and shorted. An LED's knee against
cells (0,2), (1,2)
if you AC-couple. Both Pmod lines are 3.3 V logic; the tile runs on the 3.3 V rail.
cell (1,1)
cell (3,1)
into 10 n (1.6 kHz) at the same node, so both play. SD high: on with the tile (pin 2 is NC). The electret (pin 1 is the
EXPECT: the Doppler beat of a target moving toward or away: 70 Hz per m/s (19.4 Hz per km/h), tens of mV after x101
