gallicchio/AMOD-and-RFMOD/hardware/amod_a.kicad_pcb

## KiCad design hardware/amod_a.kicad_pcb (continued)

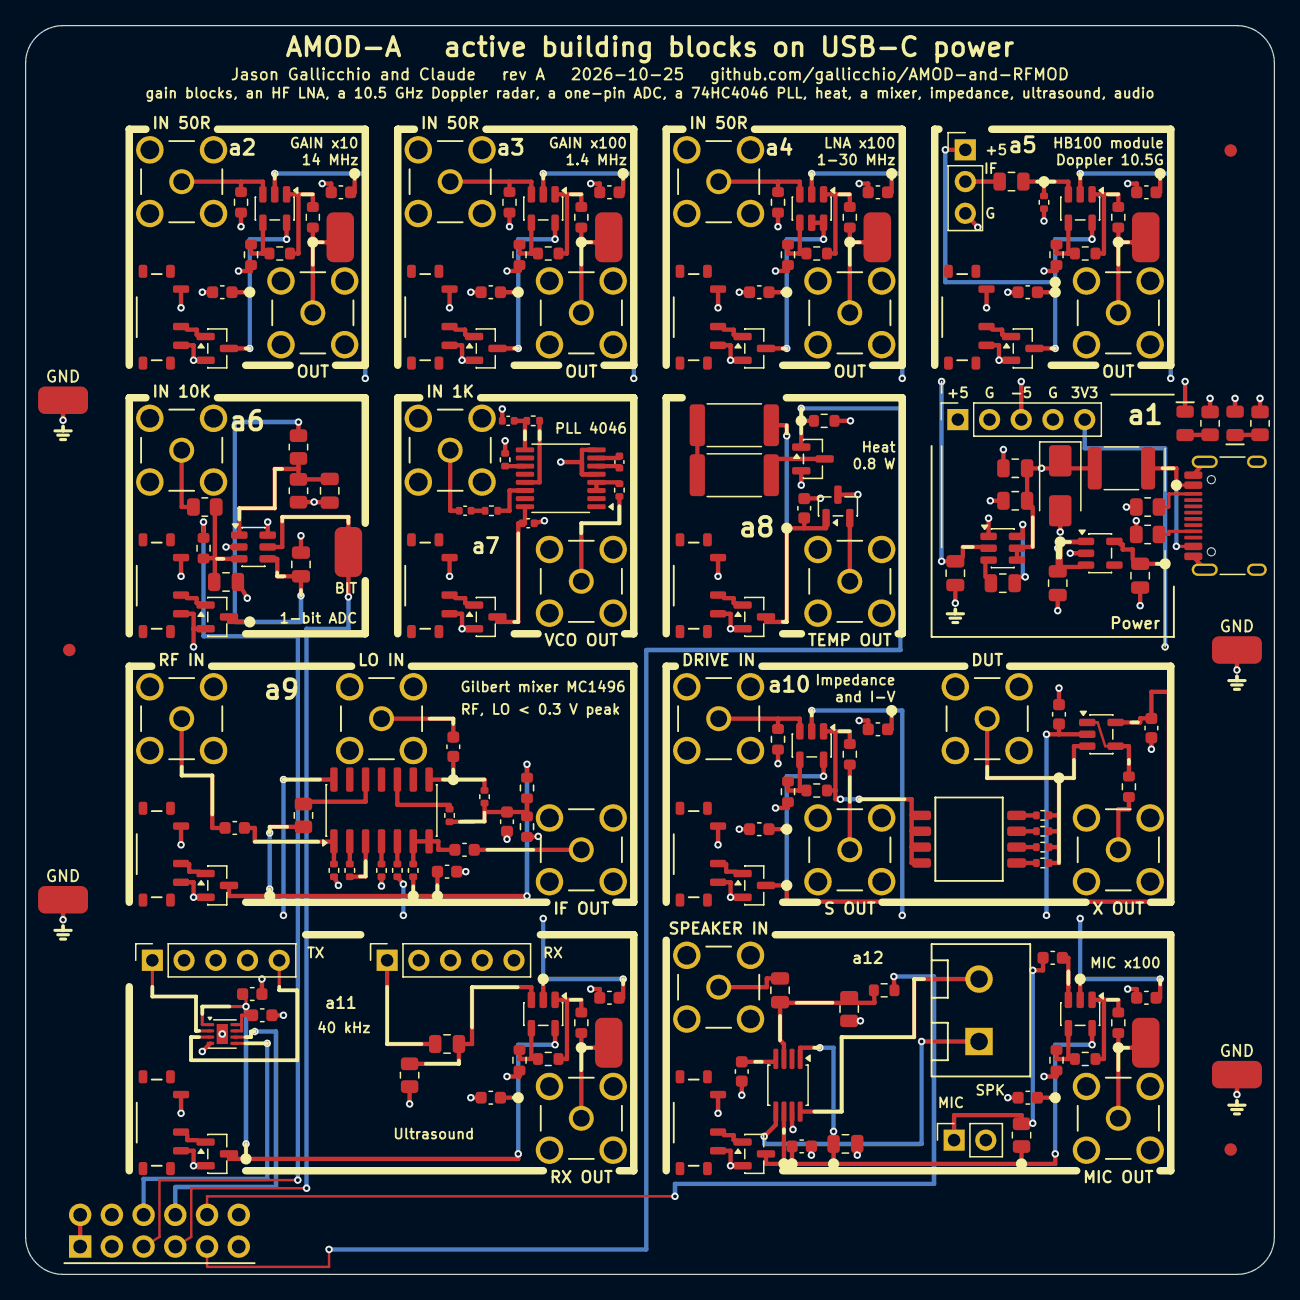
[picture p217: board amod_a.kicad_pcb from above]

Board: 4 copper layers, 100.0 x 100.0 mm, 188 parts (0 on the bottom side), 114 nets.
