gallicchio/AMOD-and-RFMOD/hardware/amod_m.kicad_pcb

## KiCad design hardware/amod_m.kicad_pcb (2026-10-30)

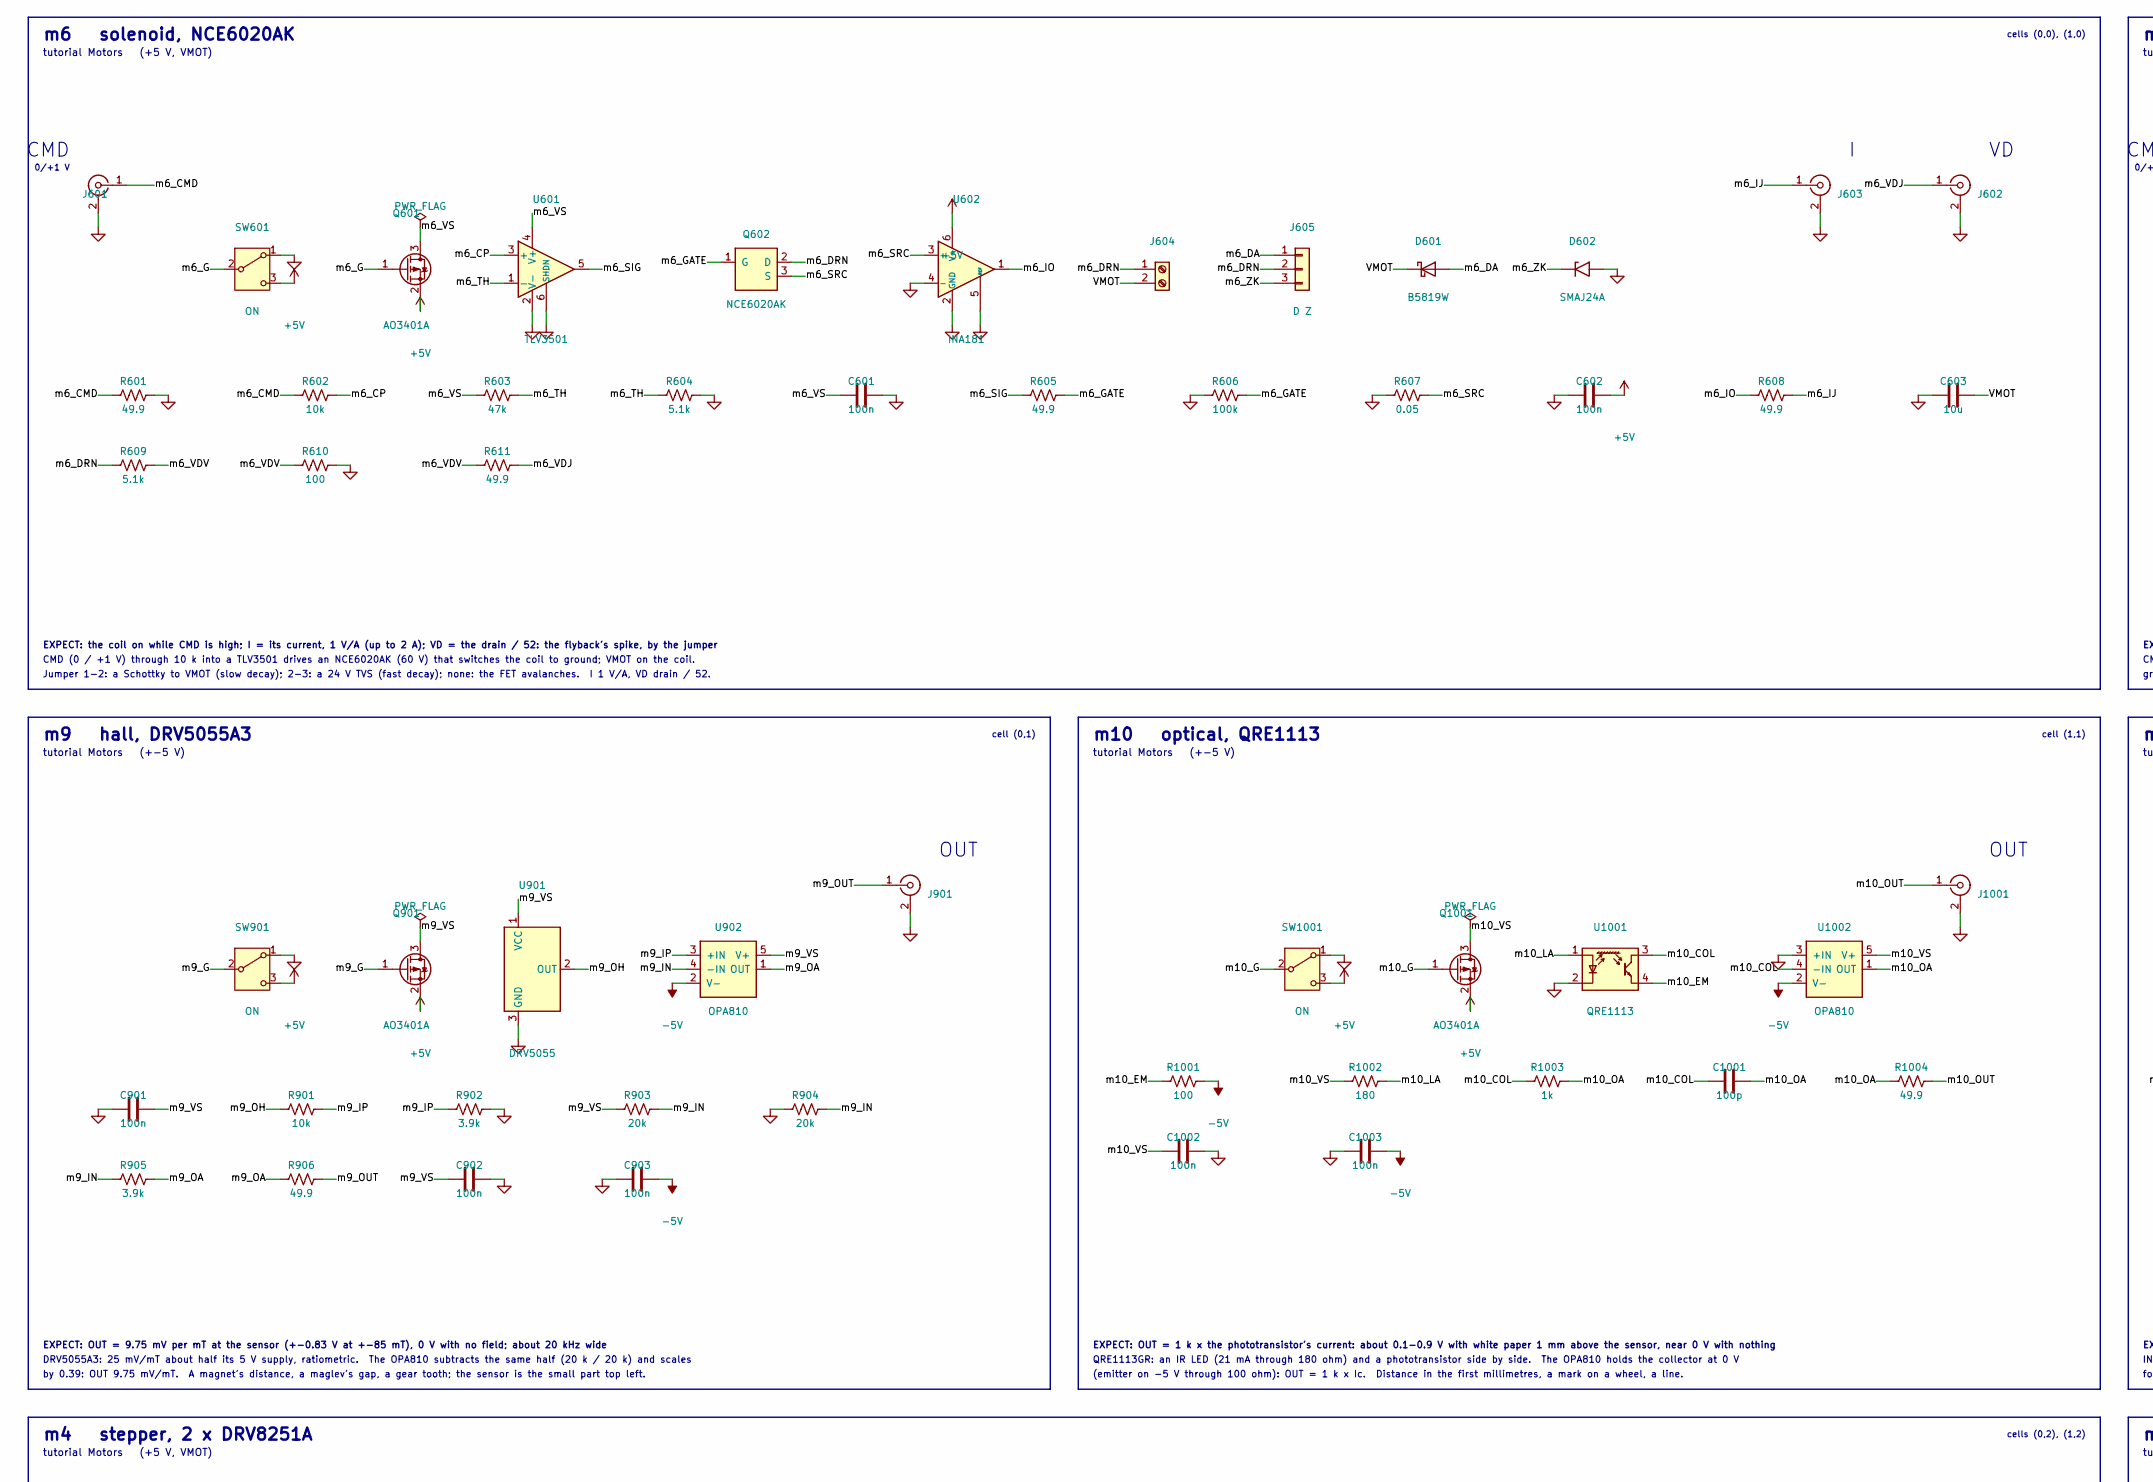
[picture p218: schematic amod_m.kicad_sch, AMOD-M: motors and actuators, part in row 1, column 1]

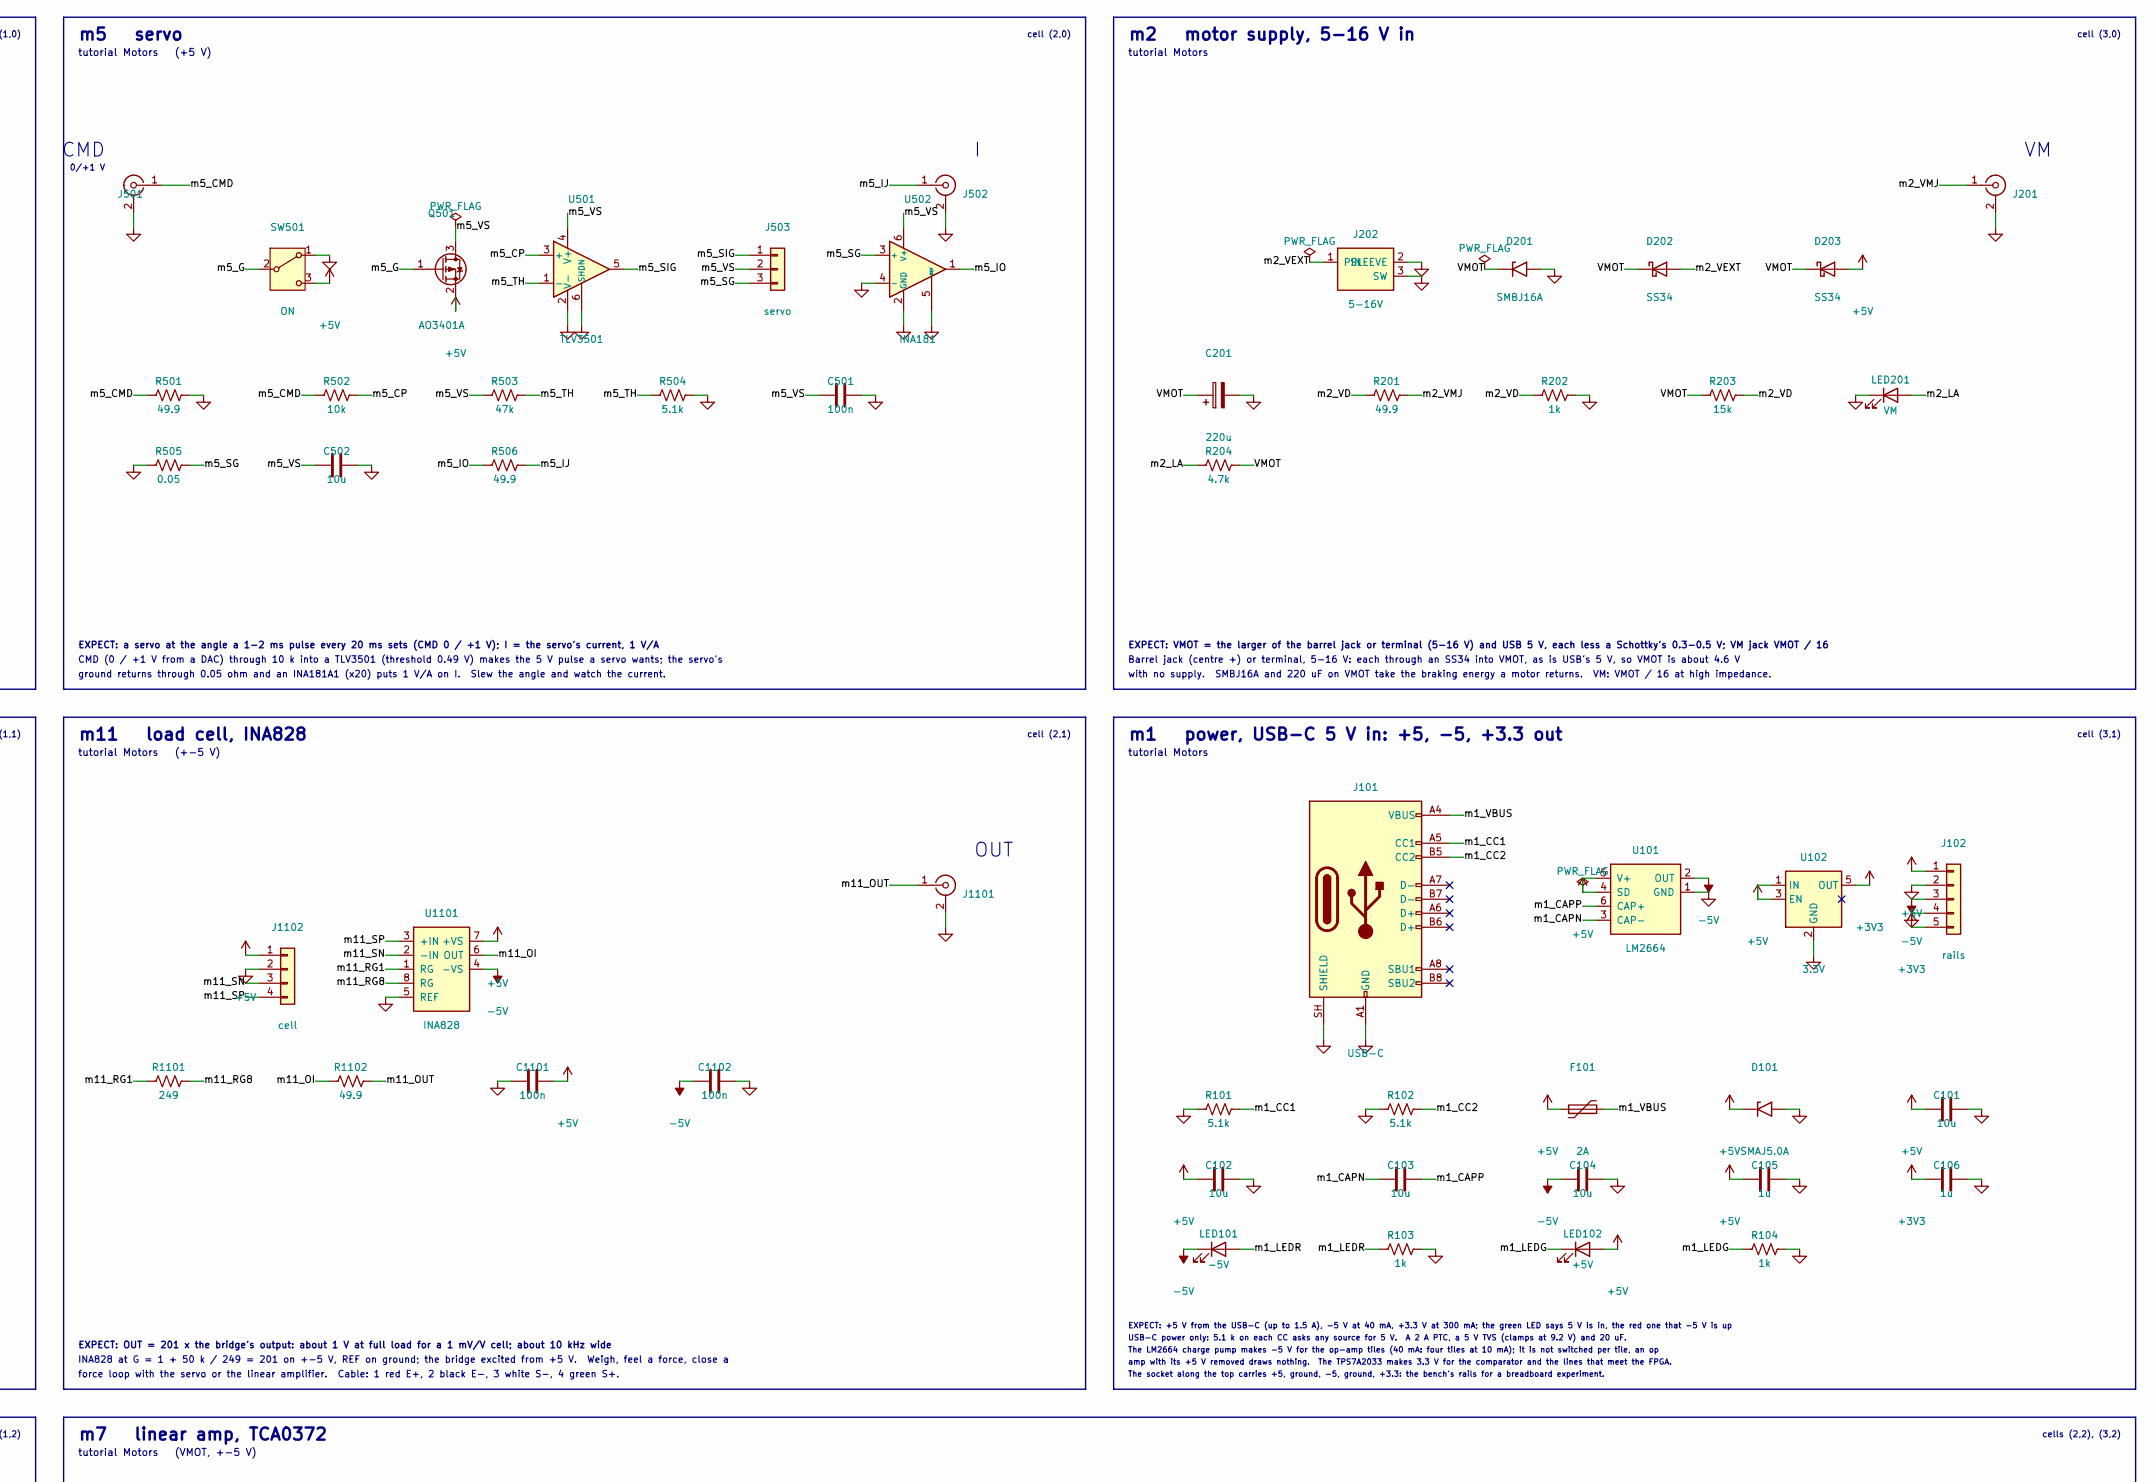
[picture p219: schematic amod_m.kicad_sch, AMOD-M: motors and actuators, part in row 1, column 2]

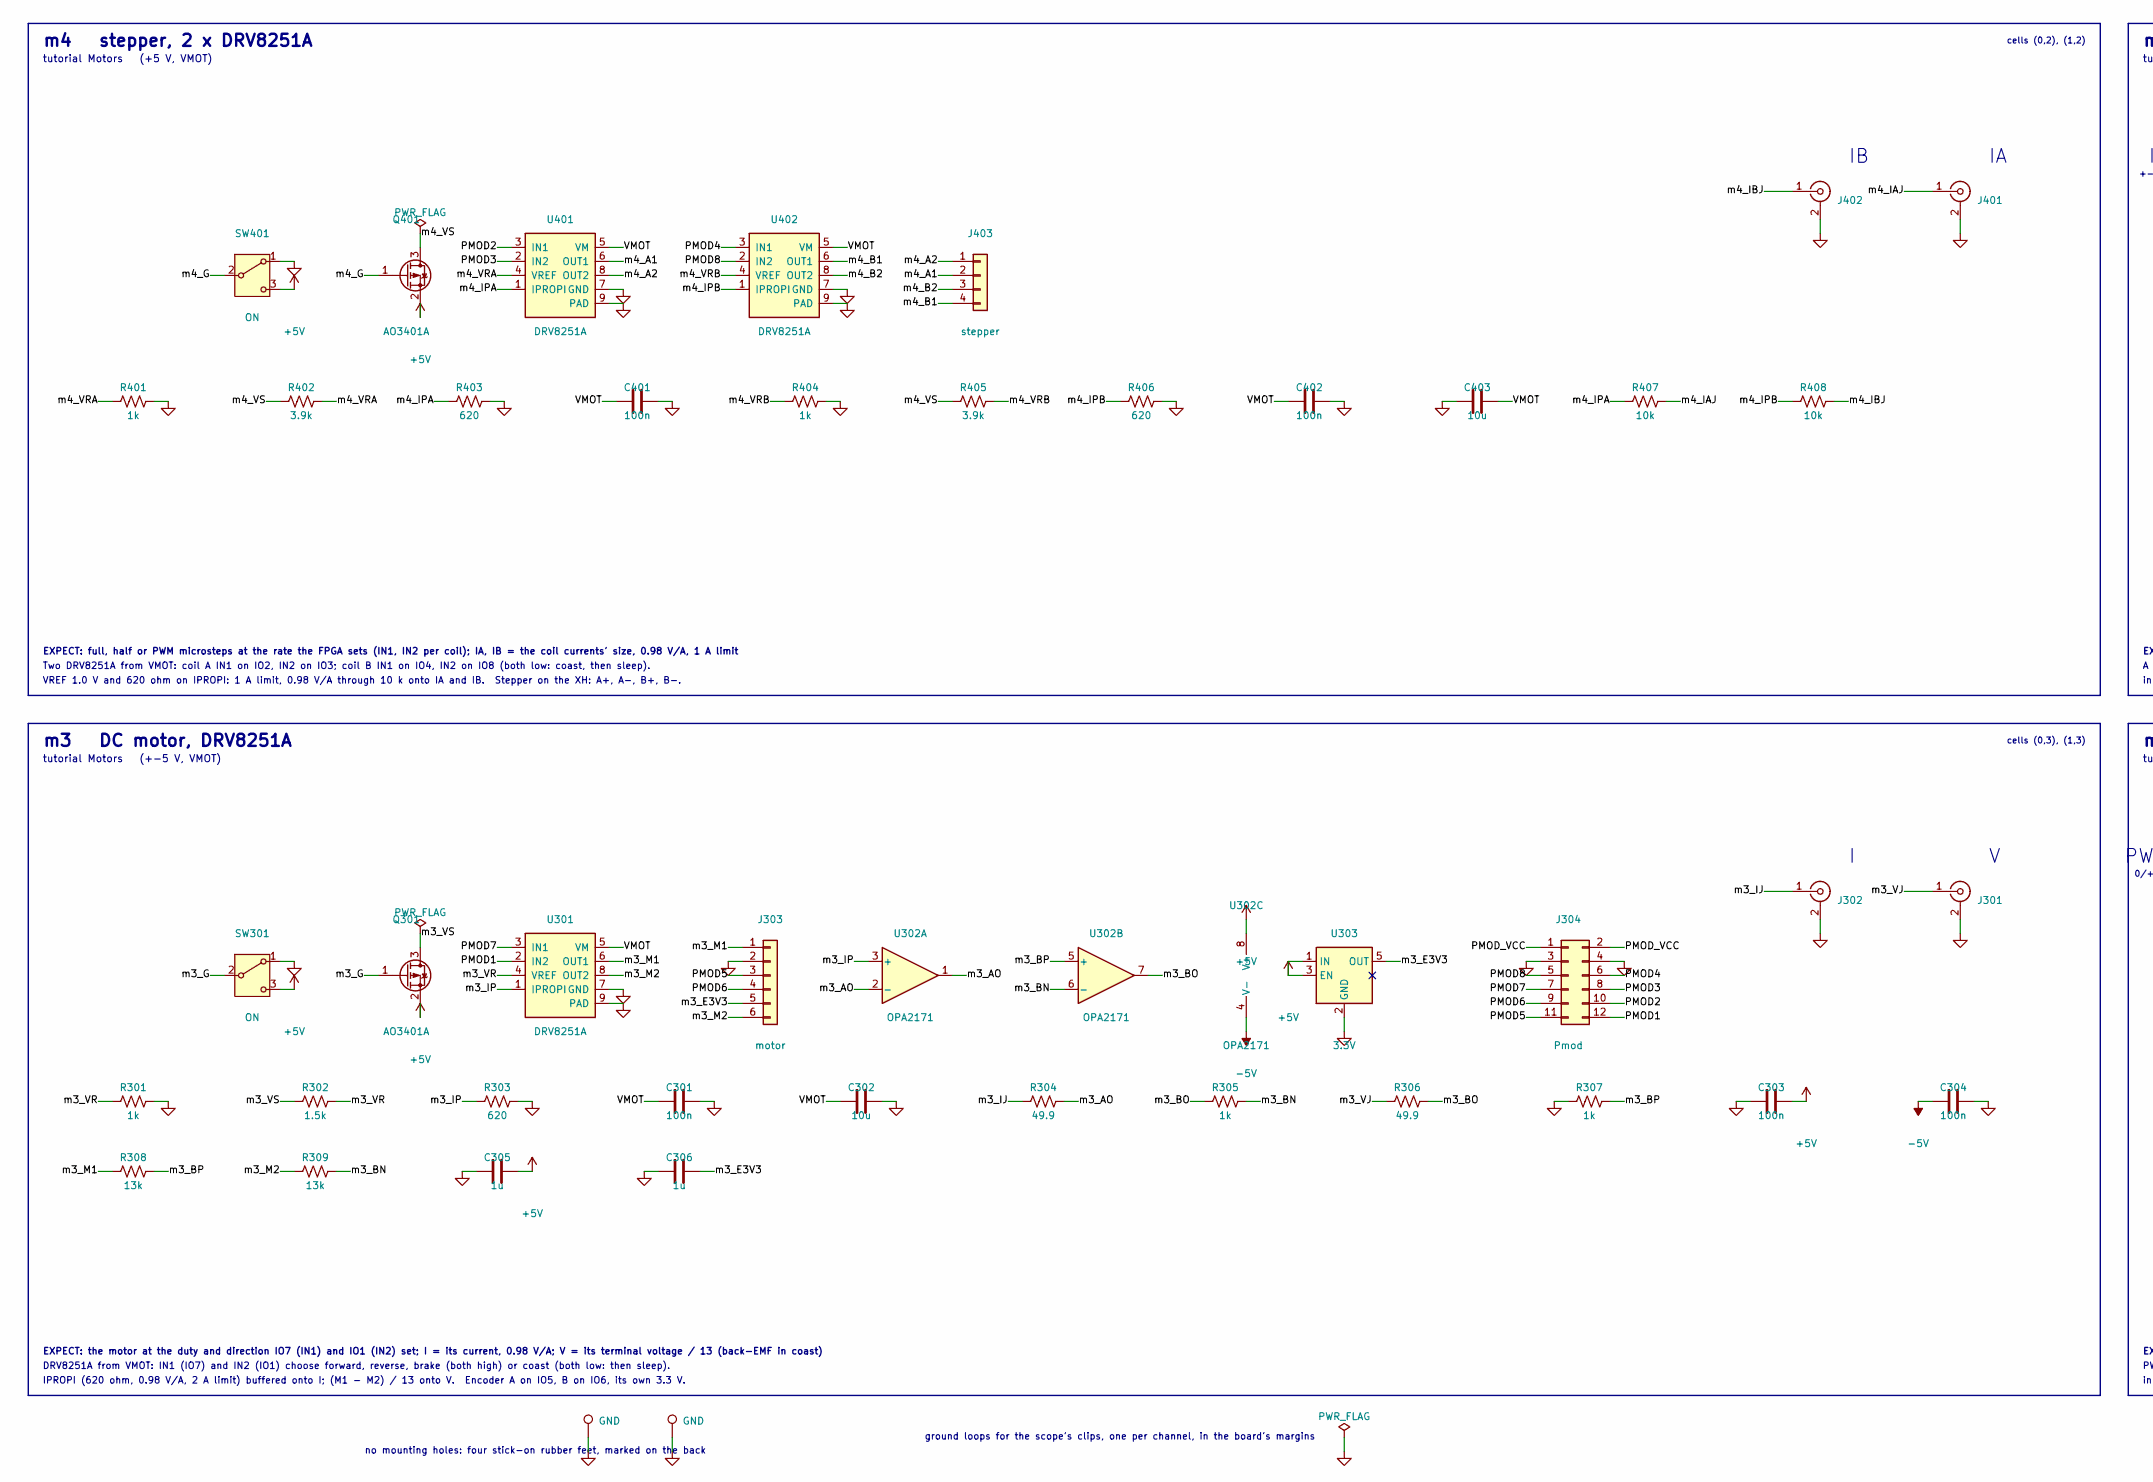
[picture p220: schematic amod_m.kicad_sch, AMOD-M: motors and actuators, part in row 2, column 1]

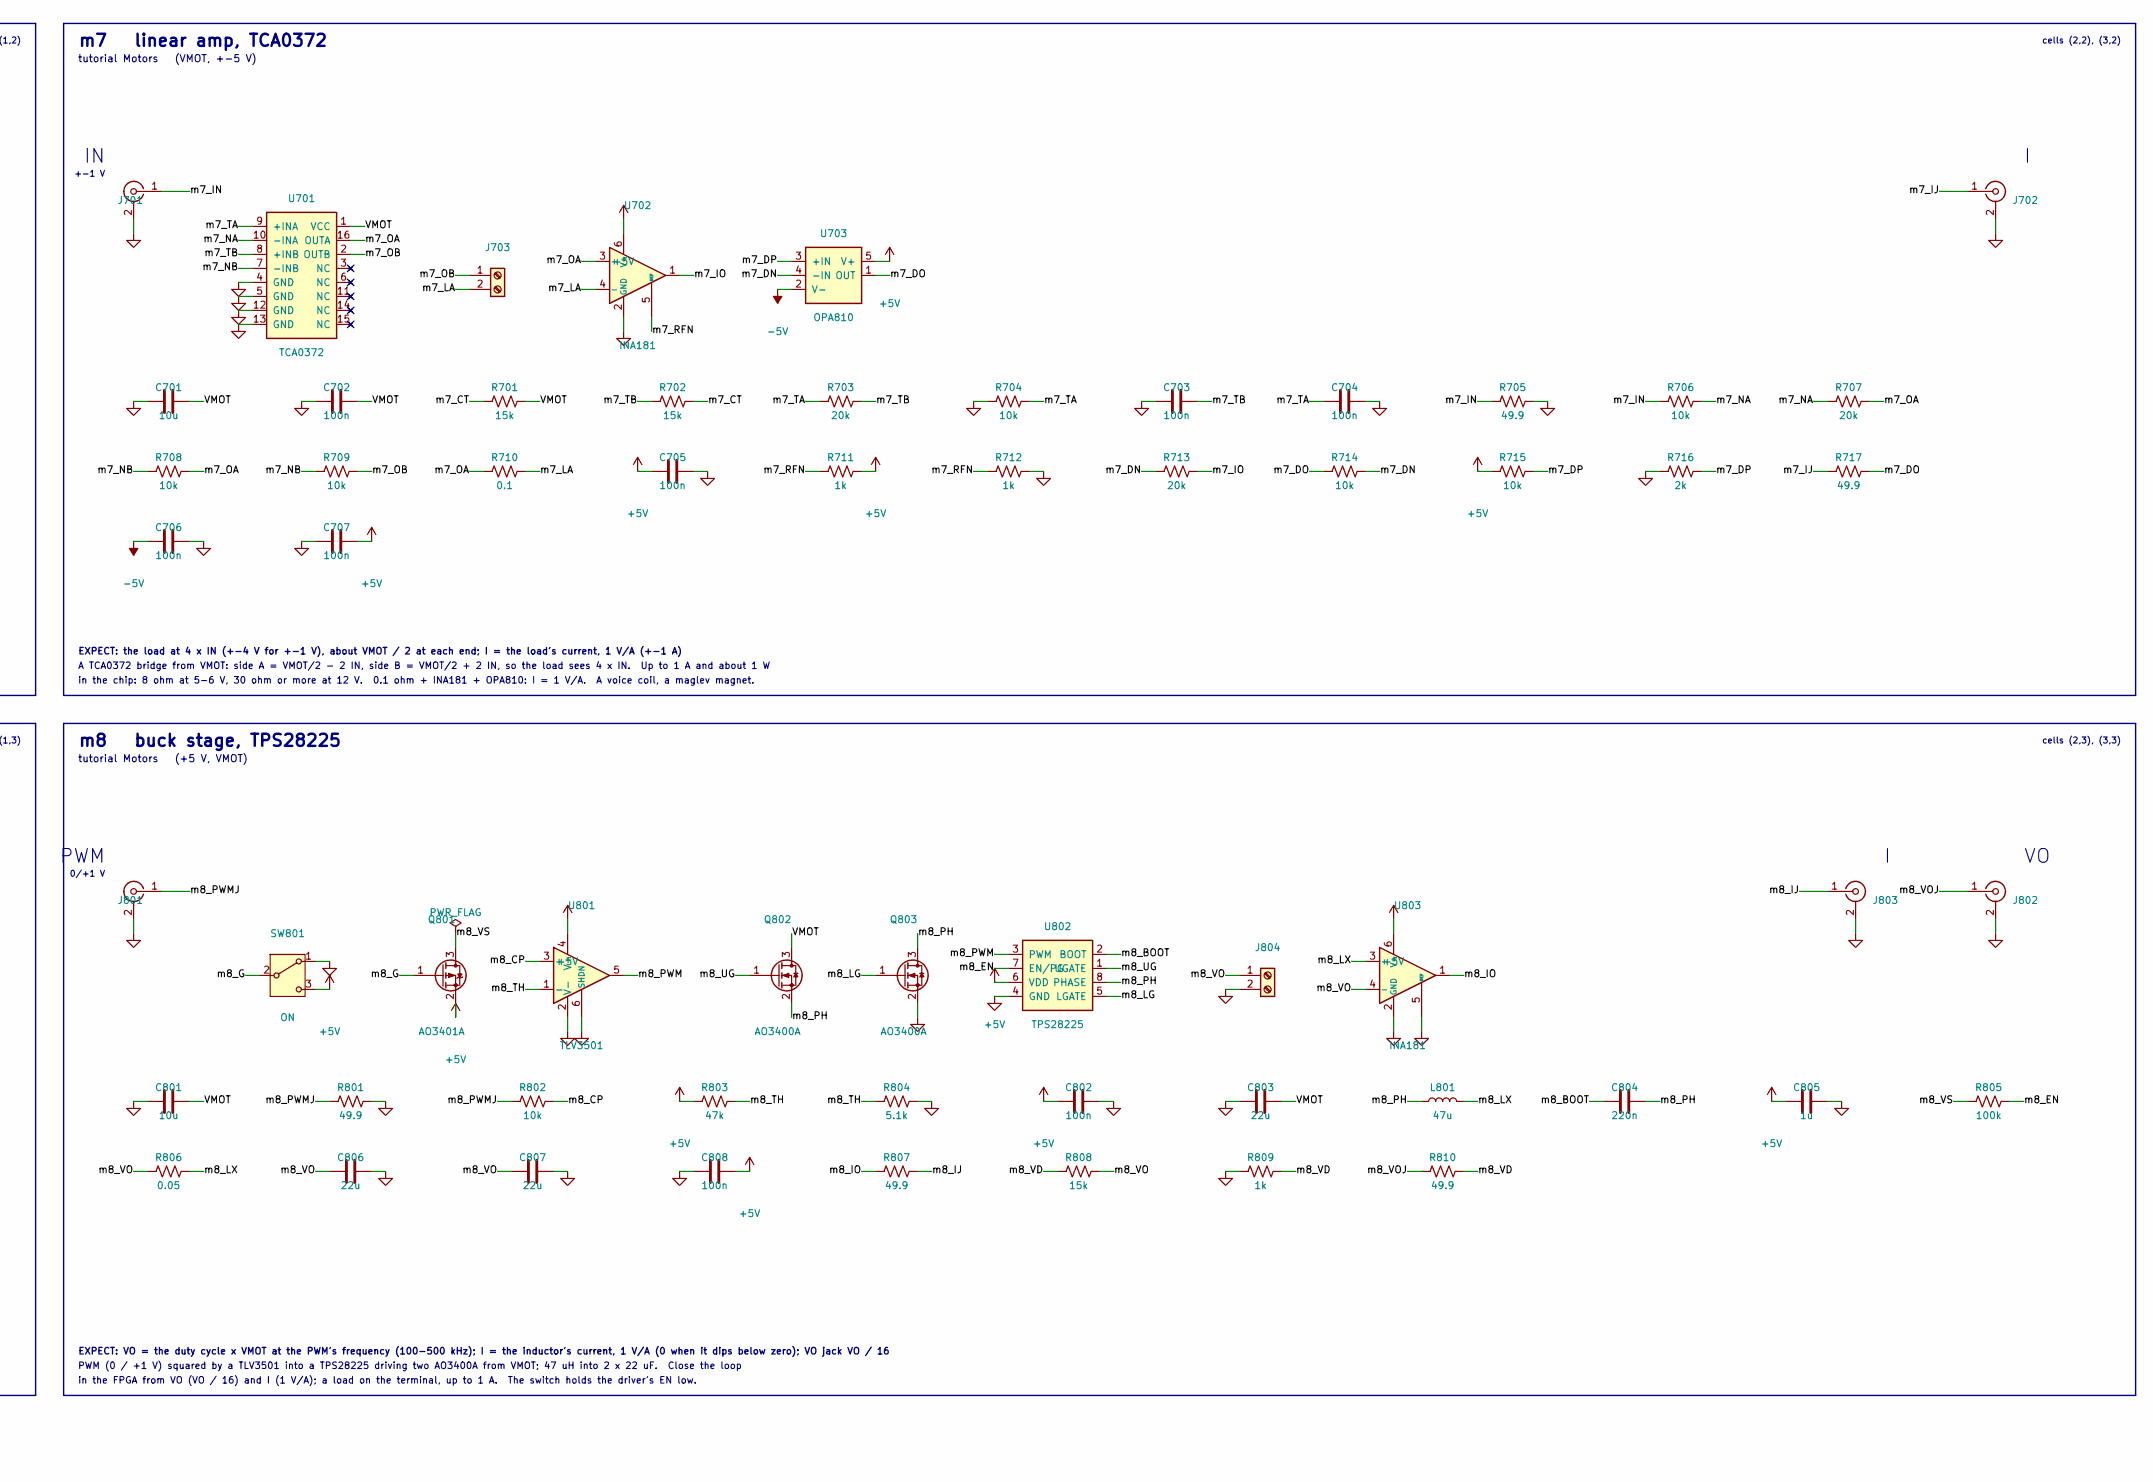
[picture p221: schematic amod_m.kicad_sch, AMOD-M: motors and actuators, part in row 2, column 2]

Parts:
C101, C102, C103, C104, C302, C403, C502, C603, C701, C801: 10u; C_0805_2012Metric; MPN CL21A106KAYNNNE; LCSC C15850
C105, C106: 1u; C_0805_2012Metric; MPN CL21B105KBFNNNE; LCSC C28323
C201: 220u; CP_Elec_6.3x7.7; MPN XT220UF25V90RV0075; LCSC C2992606
C301, C303, C304, C401, C402, C501, C601, C602, C702, C703, C704, C705, C706, C707, C802, C808, C901, C902, C903, C1002, C1003, C1101, C1102: 100n; C_0402_1005Metric; MPN CL05B104KO5NNNC; LCSC C1525
C305, C306, C805: 1u; C_0603_1608Metric; MPN CL10A105KB8NNNC; LCSC C15849
C803, C806, C807: 22u; C_1206_3216Metric; MPN CL31A226KAHNNNE; LCSC C12891
C804: 220n; C_0402_1005Metric; MPN CL05B224KO5NNNC; LCSC C16772
C1001: 100p; C_0402_1005Metric; MPN 0402CG101J500NT; LCSC C1546
D101: SMAJ5.0A; D_SMA; MPN SMAJ5.0A; LCSC C78401
D201: SMBJ16A; D_SMB; MPN SMBJ16A; LCSC C353386
D202, D203: SS34; D_SMA; MPN SS34; LCSC C8678
D601: B5819W; D_SOD-123; MPN B5819W; LCSC C64885
D602: SMAJ24A; D_SMA; MPN SMAJ24A; LCSC C113962
F101: 2A; Fuse_1812_4532Metric; MPN MF-MSMF200-2; LCSC C210837
J101: USB-C; USB_C_Receptacle_HRO_TYPE-C-31-M-12; MPN TYPE-C-31-M-12; LCSC C165948
J102: rails; PinSocket_1x05_P2.54mm_Vertical; MPN PZ254-1-05-Z-8.5; LCSC C2894928
J201, J301, J302, J401, J402, J501, J502, J601, J602, J603, J701, J702, J801, J802, J803, J901, J1001, J1101: SMA; SMA_BWSMA-KE-Z001_Vertical; MPN BWSMA-KE-Z001; LCSC C496549
J202: 5-16V; BarrelJack_DC-005-5A_Horizontal; MPN DC-005-5A-2.0; LCSC C381116
J303: motor; JST_PH_B6B-PH-K_1x06_P2.00mm_Vertical; MPN B6B-PH-K-S(LF)(SN); LCSC C131342
J304: Pmod; PinHeader_2x06_P2.54mm_Horizontal_PZ254R-12-12P; MPN PZ254R-12-12P; LCSC C492434
J403: stepper; JST_XH_B4B-XH-A_1x04_P2.50mm_Vertical; MPN B4B-XH-A(LF)(SN); LCSC C144395
J503: servo; PinHeader_1x03_P2.54mm_Vertical; MPN PZ254V-11-03P; LCSC C2937625
J604: coil; TerminalBlock_KF301_1x02_P5.00mm; MPN KF301-5.0-2P; LCSC C474881
J605: D Z; PinHeader_1x03_P2.54mm_Vertical; MPN PZ254V-11-03P; LCSC C2937625
J703: load; TerminalBlock_KF301_1x02_P5.00mm; MPN KF301-5.0-2P; LCSC C474881
J804: out; TerminalBlock_KF301_1x02_P5.00mm; MPN KF301-5.0-2P; LCSC C474881
J1102: cell; JST_XH_B4B-XH-A_1x04_P2.50mm_Vertical; MPN B4B-XH-A(LF)(SN); LCSC C144395
L801: 47u; L_6x6_SWPA6045; MPN SWPA6045S470MT; LCSC C36414
LED101: -5V; LED_0805_2012Metric_Kbar; MPN NCD0805R1; LCSC C84256
LED102: +5V; LED_0805_2012Metric_Kbar; MPN KT-0805G; LCSC C2297
LED201: VM; LED_0805_2012Metric_Kbar; MPN KT-0805G; LCSC C2297
Q301, Q401, Q501, Q601, Q801, Q901, Q1001: AO3401A; SOT-23; MPN AO3401A; LCSC C15127
Q602: NCE6020AK; TO-252-2; MPN NCE6020AK; LCSC C108639
Q802, Q803: AO3400A; SOT-23; MPN AO3400A; LCSC C20917
R101, R102, R609: 5.1k; R_0805_2012Metric; MPN 0805W8F5101T5E; LCSC C27834
R103, R104: 1k; R_0805_2012Metric; MPN 0805W8F1001T5E; LCSC C17513
R201, R304, R306, R501, R506, R601, R605, R608, R611, R705, R717, R801, R807, R810, R906, R1004, R1102: 49.9; R_0402_1005Metric; MPN CRCW040249R9FKEDHP; LCSC C844112
R202, R301, R305, R307, R401, R404, R711, R712, R809, R1003: 1k; R_0402_1005Metric; MPN 0402WGF1001TCE; LCSC C11702
R203, R701, R702, R808: 15k; R_0402_1005Metric; MPN 0402WGF1502TCE; LCSC C25756
R204: 4.7k; R_0402_1005Metric; MPN 0402WGF4701TCE; LCSC C25900
R302: 1.5k; R_0402_1005Metric; MPN 0402WGF1501TCE; LCSC C25867
R303, R403, R406: 620; R_0402_1005Metric; MPN 0402WGF6200TCE; LCSC C4961
R308, R309: 13k; R_0402_1005Metric; MPN 0402WGF1302TCE; LCSC C25754
R402, R405, R902, R905: 3.9k; R_0402_1005Metric; MPN 0402WGF3901TCE; LCSC C51721
R407, R408, R502, R602, R704, R706, R708, R709, R714, R715, R802, R901: 10k; R_0402_1005Metric; MPN 0402WGF1002TCE; LCSC C25744
R503, R603, R803: 47k; R_0402_1005Metric; MPN 0402WGF4702TCE; LCSC C25792
R504, R604, R804: 5.1k; R_0402_1005Metric; MPN 0402WGF5101TCE; LCSC C25905
R505, R607, R806: 0.05; R_1206_3216Metric; MPN 1206W3F500MT5E; LCSC C127691
R606, R805: 100k; R_0402_1005Metric; MPN 0402WGF1003TCE; LCSC C25741
R610, R1001: 100; R_0402_1005Metric; MPN 0402WGF1000TCE; LCSC C25076
R703, R707, R713, R903, R904: 20k; R_0402_1005Metric; MPN 0402WGF2002TCE; LCSC C25765
R710: 0.1; R_1206_3216Metric; MPN 1206W4F100LT5E; LCSC C25334
R716: 2k; R_0402_1005Metric; MPN 0402WGF2001TCE; LCSC C4109
R1002: 180; R_0805_2012Metric; MPN 0805W8F1800T5E; LCSC C25270
R1101: 249; R_0402_1005Metric; MPN 0402WGF2490TCE; LCSC C25096
SW301, SW401, SW501, SW601, SW801, SW901, SW1001: ON; SW_SPDT_Shouhan_MSK12C02; MPN MSK12C02; LCSC C431540
TP9901, TP9902: GND; TestPoint_Loop_RH-5019; MPN RH-5019; LCSC C5199800
U101: LM2664; SOT-23-6; MPN LM2664M6X/NOPB; LCSC C108573
U102, U303: 3.3V; SOT-23-5; MPN TPS7A2033PDBVR; LCSC C2862740
U301, U401, U402: DRV8251A; HSOP-8-1EP_3.9x4.9mm_P1.27mm_EP2.41x3.1mm; MPN DRV8251ADDAR; LCSC C5218844
U302: OPA2171; SOIC-8_3.9x4.9mm_P1.27mm; MPN OPA2171AIDR; LCSC C40904
U501, U601, U801: TLV3501; SOT-23-6; MPN TLV3501AIDBVR; LCSC C193413
U502, U602, U702, U803: INA181; SOT-23-6; MPN INA181A1IDBVR; LCSC C2058943
U701: TCA0372; SOIC-16W_7.5x10.3mm_P1.27mm; MPN TCA0372DWR2G; LCSC C362060
U703, U902, U1002: OPA810; SOT-23-5; MPN OPA810IDBVR; LCSC C2833513
U802: TPS28225; SOIC-8_3.9x4.9mm_P1.27mm; MPN TPS28225DR; LCSC C52897
U901: DRV5055; SOT-23; MPN DRV5055A3QDBZR; LCSC C266128
U1001: QRE1113; OnSemi_CASE100CY; MPN QRE1113GR; LCSC C232862
U1101: INA828; SOIC-8_3.9x4.9mm_P1.27mm; MPN INA828IDR; LCSC C544342

Connections:
+3V3: C106.1, J102.5, U102.5 (OUT)
+5V: C101.1, C102.1, C105.1, C303.2, C305.2, C602.2, C705.1, C707.2, C802.1, C805.1, C808.2, C1101.2, D101.1 (A1), D203.2 (A), F101.1, J102.1, J1102.1, LED102.2 (A), Q301.2 (S), Q401.2 (S), Q501.2 (S), Q601.2 (S), Q801.2 (S), Q901.2 (S), Q1001.2 (S), R711.2, R715.1, R803.1, SW301.3 (C), SW401.3 (C), SW501.3 (C), SW601.3 (C), SW801.3 (C), SW901.3 (C), SW1001.3 (C), U101.4 (SD), U101.5 (V+), U102.1 (IN), U102.3 (EN), U302.8 (V+), U303.1 (IN), U303.3 (EN), U602.6 (V+), U702.6 (V+), U703.5 (V+), U801.4 (V+), U802.6 (VDD), U803.6 (V+), U1101.7 (+VS)
-5V: C104.1, C304.1, C706.1, C903.2, C1003.2, C1102.1, J102.3, LED101.1 (K), R1001.2, U101.2 (OUT), U302.4 (V-), U703.2 (V-), U902.2 (V-), U1002.2 (V-), U1101.4 (-VS)
/PMOD1: J304.12, U301.2 (IN2)
/PMOD2: J304.10, U401.3 (IN1)
/PMOD3: J304.8, U401.2 (IN2)
/PMOD4: J304.6, U402.3 (IN1)
/PMOD5: J303.3, J304.11
/PMOD6: J303.4, J304.9
/PMOD7: J304.7, U301.3 (IN1)
/PMOD8: J304.5, U402.2 (IN2)
/PMOD_VCC: J304.1, J304.2
/VMOT: C201.1, C301.1, C302.1, C401.1, C402.1, C403.2, C603.2, C701.2, C702.2, C801.2, C803.2, D201.1 (A1), D202.1 (K), D203.1 (K), D601.1 (K), J604.2, Q802.3 (D), R203.1, R204.2, R701.2, U301.5 (VM), U401.5 (VM), U402.5 (VM), U701.1 (VCC)
/m1_CAPN: C103.1, U101.3 (CAP-)
/m1_CAPP: C103.2, U101.6 (CAP+)
/m1_CC1: J101.A5 (CC1), R101.2
/m1_CC2: J101.B5 (CC2), R102.2
/m1_LEDG: LED102.1 (K), R104.1
/m1_LEDR: LED101.2 (A), R103.1
/m1_VBUS: F101.2, J101.A4 (VBUS), J101.A9 (VBUS), J101.B4 (VBUS), J101.B9 (VBUS)
/m2_LA: LED201.2 (A), R204.1
/m2_VD: R201.1, R202.1, R203.2
/m2_VEXT: D202.2 (A), J202.1 (PIN)
/m2_VMJ: J201.1 (In), R201.2
/m3_AO: R304.2, U302.1, U302.2 (-)
/m3_BN: R305.2, R309.2, U302.6 (-)
/m3_BO: R305.1, R306.2, U302.7
/m3_BP: R307.2, R308.2, U302.5 (+)
/m3_E3V3: C306.2, J303.5, U303.5 (OUT)
/m3_G: Q301.1 (G), SW301.2 (B)
/m3_IJ: J302.1 (In), R304.1
/m3_IP: R303.1, U301.1 (IPROPI), U302.3 (+)
/m3_M1: J303.1, R308.1, U301.6 (OUT1)
/m3_M2: J303.6, R309.1, U301.8 (OUT2)
/m3_VJ: J301.1 (In), R306.1
/m3_VR: R301.1, R302.2, U301.4 (VREF)
/m3_VS: Q301.3 (D), R302.1
/m4_A1: J403.2, U401.6 (OUT1)
/m4_A2: J403.1, U401.8 (OUT2)
/m4_B1: J403.4, U402.6 (OUT1)
/m4_B2: J403.3, U402.8 (OUT2)
/m4_G: Q401.1 (G), SW401.2 (B)
/m4_IAJ: J401.1 (In), R407.2
/m4_IBJ: J402.1 (In), R408.2
/m4_IPA: R403.1, R407.1, U401.1 (IPROPI)
/m4_IPB: R406.1, R408.1, U402.1 (IPROPI)
/m4_VRA: R401.1, R402.2, U401.4 (VREF)
/m4_VRB: R404.1, R405.2, U402.4 (VREF)
/m4_VS: Q401.3 (D), R402.1, R405.1
/m5_CMD: J501.1 (In), R501.1, R502.1
/m5_CP: R502.2, U501.3 (+)
/m5_G: Q501.1 (G), SW501.2 (B)
/m5_IJ: J502.1 (In), R506.2
/m5_IO: R506.1, U502.1
/m5_SG: J503.3, R505.2, U502.3 (+)
/m5_SIG: J503.1, U501.5
/m5_TH: R503.2, R504.1, U501.1 (-)
/m5_VS: C501.1, C502.1, J503.2, Q501.3 (D), R503.1, U501.4 (V+), U502.6 (V+)
/m6_CMD: J601.1 (In), R601.1, R602.1
/m6_CP: R602.2, U601.3 (+)
/m6_DA: D601.2 (A), J605.1
/m6_DRN: J604.1, J605.2, Q602.2 (D), R609.1
/m6_G: Q601.1 (G), SW601.2 (B)
/m6_GATE: Q602.1 (G), R605.2, R606.2
/m6_IJ: J603.1 (In), R608.2
/m6_IO: R608.1, U602.1
/m6_SIG: R605.1, U601.5
/m6_SRC: Q602.3 (S), R607.2, U602.3 (+)
/m6_TH: R603.2, R604.1, U601.1 (-)
/m6_VDJ: J602.1 (In), R611.2
/m6_VDV: R609.2, R610.1, R611.1
/m6_VS: C601.1, Q601.3 (D), R603.1, U601.4 (V+)
/m6_ZK: D602.1 (A1), J605.3
/m7_CT: R701.1, R702.2
/m7_DN: R713.1, R714.2, U703.4 (-IN)
/m7_DO: R714.1, R717.2, U703.1 (OUT)
/m7_DP: R715.2, R716.2, U703.3 (+IN)
/m7_IJ: J702.1 (In), R717.1
/m7_IN: J701.1 (In), R705.1, R706.1
/m7_IO: R713.2, U702.1
/m7_LA: J703.2, R710.2, U702.4 (-)
/m7_NA: R706.2, R707.1, U701.10 (-INA)
/m7_NB: R708.1, R709.1, U701.7 (-INB)
/m7_OA: R707.2, R708.2, R710.1, U701.16 (OUTA), U702.3 (+)
/m7_OB: J703.1, R709.2, U701.2 (OUTB)
/m7_RFN: R711.1, R712.1, U702.5 (REF)
/m7_TA: C704.1, R703.1, R704.2, U701.9 (+INA)
/m7_TB: C703.2, R702.1, R703.2, U701.8 (+INB)
/m8_BOOT: C804.1, U802.2 (BOOT)
/m8_CP: R802.2, U801.3 (+)
/m8_EN: R805.2, U802.7 (EN/PG)
/m8_G: Q801.1 (G), SW801.2 (B)
/m8_IJ: J803.1 (In), R807.2
/m8_IO: R807.1, U803.1
/m8_LG: Q803.1 (G), U802.5 (LGATE)
/m8_LX: L801.2, R806.2, U803.3 (+)
/m8_PH: C804.2, L801.1, Q802.2 (S), Q803.3 (D), U802.8 (PHASE)
/m8_PWM: U801.5, U802.3 (PWM)
/m8_PWMJ: J801.1 (In), R801.1, R802.1
/m8_TH: R803.2, R804.1, U801.1 (-)
/m8_UG: Q802.1 (G), U802.1 (UGATE)
/m8_VD: R808.1, R809.2, R810.2
/m8_VO: C806.1, C807.1, J804.1, R806.1, R808.2, U803.4 (-)
/m8_VOJ: J802.1 (In), R810.1
/m8_VS: Q801.3 (D), R805.1
/m9_G: Q901.1 (G), SW901.2 (B)
/m9_IN: R903.2, R904.2, R905.1, U902.4 (-IN)
/m9_IP: R901.2, R902.1, U902.3 (+IN)
/m9_OA: R905.2, R906.1, U902.1 (OUT)
/m9_OH: R901.1, U901.2 (OUT)
/m9_OUT: J901.1 (In), R906.2
/m9_VS: C901.2, C902.1, Q901.3 (D), R903.1, U901.1 (VCC), U902.5 (V+)
/m10_COL: C1001.1, R1003.1, U1001.3, U1002.4 (-IN)
/m10_EM: R1001.1, U1001.4
/m10_G: Q1001.1 (G), SW1001.2 (B)
/m10_LA: R1002.2, U1001.1 (A)
/m10_OA: C1001.2, R1003.2, R1004.1, U1002.1 (OUT)
/m10_OUT: J1001.1 (In), R1004.2
/m10_VS: C1002.1, Q1001.3 (D), R1002.1, U1002.5 (V+)
/m11_OI: R1102.1, U1101.6 (OUT)
/m11_OUT: J1101.1 (In), R1102.2
/m11_RG1: R1101.1, U1101.1 (RG)
/m11_RG8: R1101.2, U1101.8 (RG)
/m11_SN: J1102.3, U1101.2 (-IN)
/m11_SP: J1102.4, U1101.3 (+IN)
GND: C101.2, C102.2, C104.2, C105.2, C106.2, C201.2, C301.2, C302.2, C303.1, C304.2, C305.1, C306.1, C401.2, C402.2, C403.1, C501.2, C502.2, C601.2, C602.1, C603.1, C701.1, C702.1, C703.1, C704.2, C705.2, C706.2, C707.1, C801.1, C802.2, C803.1, C805.2, C806.2, C807.2, C808.1, C901.1, C902.2, C903.1, C1002.2, C1003.1, C1101.1, C1102.2, D101.2 (A2), D201.2 (A2), D602.2 (A2), J101.A1 (GND), J101.A12 (GND), J101.B1 (GND), J101.B12 (GND), J101.SH (SHIELD), J102.2, J102.4, J201.2 (Ext), J202.2 (SLEEVE), J202.3 (SW), J301.2 (Ext), J302.2 (Ext), J303.2, J304.3, J304.4, J401.2 (Ext), J402.2 (Ext), J501.2 (Ext), J502.2 (Ext), J601.2 (Ext), J602.2 (Ext), J603.2 (Ext), J701.2 (Ext), J702.2 (Ext), J801.2 (Ext), J802.2 (Ext), J803.2 (Ext), J804.2, J901.2 (Ext), J1001.2 (Ext), J1101.2 (Ext), J1102.2, LED201.1 (K), Q803.2 (S), R101.1, R102.1, R103.2, R104.2, R202.2, R301.2, R303.2, R307.1, R401.2, R403.2, R404.2, R406.2, R501.2, R504.2, R505.1, R601.2, R604.2, R606.1, R607.1, R610.2, R704.1, R705.2, R712.2, R716.1, R801.2, R804.2, R809.1, R902.2, R904.1, SW301.1 (A), SW401.1 (A), SW501.1 (A), SW601.1 (A), SW801.1 (A), SW901.1 (A), SW1001.1 (A), TP9901.1, TP9902.1, U101.1 (GND), U102.2 (GND), U301.7 (GND), U301.9 (PAD), U303.2 (GND), U401.7 (GND), U401.9 (PAD), U402.7 (GND), U402.9 (PAD), U501.2 (V-), U501.6 (SHDN), U502.2 (GND), U502.4 (-), U502.5 (REF), U601.2 (V-), U601.6 (SHDN), U602.2 (GND), U602.4 (-), U602.5 (REF), U701.4 (GND), U701.5 (GND), U701.12 (GND), U701.13 (GND), U702.2 (GND), U801.2 (V-), U801.6 (SHDN), U802.4 (GND), U803.2 (GND), U803.5 (REF), U901.3 (GND), U1001.2 (K), U1002.3 (+IN), U1101.5 (REF)

Notes on the sheet:
CMD
OUT
cells (2,2), (3,2)
cell (2,1)
Two DRV8251A from VMOT: coil A IN1 on IO2, IN2 on IO3; coil B IN1 on IO4, IN2 on IO8 (both low: coast, then sleep).
DRV8251A from VMOT: IN1 (IO7) and IN2 (IO1) choose forward, reverse, brake (both high) or coast (both low: then sleep).
cell (2,0)
m4 stepper, 2 x DRV8251A
INA828 at G = 1 + 50 k / 249 = 201 on +-5 V, REF on ground; the bridge excited from +5 V. Weigh, feel a force, close a
USB-C power only: 5.1 k on each CC asks any source for 5 V. A 2 A PTC, a 5 V TVS (clamps at 9.2 V) and 20 uF.
EXPECT: the coil on while CMD is high; I = its current, 1 V/A (up to 2 A); VD = the drain / 52: the flyback's spike, by the jumper
EXPECT: VO = the duty cycle x VMOT at the PWM's frequency (100-500 kHz); I = the inductor's current, 1 V/A (0 when it dips below zero); VO jack VO / 16
The socket along the top carries +5, ground, -5, ground, +3.3: the bench's rails for a breadboard experiment.
in the FPGA from VO (VO / 16) and I (1 V/A); a load on the terminal, up to 1 A. The switch holds the driver's EN low.
cell (0,1)
m3 DC motor, DRV8251A
tutorial Motors
cells (0,0), (1,0)
A TCA0372 bridge from VMOT: side A = VMOT/2 - 2 IN, side B = VMOT/2 + 2 IN, so the load sees 4 x IN. Up to 1 A and about 1 W
cells (2,3), (3,3)
amp with its +5 V removed draws nothing. The TPS7A2033 makes 3.3 V for the comparator and the lines that meet the FPGA.
PWM
EXPECT: the load at 4 x IN (+-4 V for +-1 V), about VMOT / 2 at each end; I = the load's current, 1 V/A (+-1 A)
0/+1 V
The LM2664 charge pump makes -5 V for the op-amp tiles (40 mA: four tiles at 10 mA); it is not switched per tile, an op
tutorial Motors (+5 V, VMOT)
VREF 1.0 V and 620 ohm on IPROPI: 1 A limit, 0.98 V/A through 10 k onto IA and IB. Stepper on the XH: A+, A-, B+, B-.
tutorial Motors (+-5 V, VMOT)
cells (0,3), (1,3)
ground loops for the scope's clips, one per channel, in the board's margins
Barrel jack (centre +) or terminal, 5-16 V: each through an SS34 into VMOT, as is USB's 5 V, so VMOT is about 4.6 V
m11 load cell, INA828
+-1 V
tutorial Motors (+-5 V)
CMD (0 / +1 V from a DAC) through 10 k into a TLV3501 (threshold 0.49 V) makes the 5 V pulse a servo wants; the servo's
no mounting holes: four stick-on rubber feet, marked on the back
CMD (0 / +1 V) through 10 k into a TLV3501 drives an NCE6020AK (60 V) that switches the coil to ground; VMOT on the coil.
in the chip: 8 ohm at 5-6 V, 30 ohm or more at 12 V. 0.1 ohm + INA181 + OPA810: I = 1 V/A. A voice coil, a maglev magnet.
m5 servo
EXPECT: VMOT = the larger of the barrel jack or terminal (5-16 V) and USB 5 V, each less a Schottky's 0.3-0.5 V; VM jack VMOT / 16
(emitter on -5 V through 100 ohm): OUT = 1 k x Ic. Distance in the first millimetres, a mark on a wheel, a line.
QRE1113GR: an IR LED (21 mA through 180 ohm) and a phototransistor side by side. The OPA810 holds the collector at 0 V
tutorial Motors (+5 V)
EXPECT: a servo at the angle a 1-2 ms pulse every 20 ms sets (CMD 0 / +1 V); I = the servo's current, 1 V/A
Jumper 1-2: a Schottky to VMOT (slow decay); 2-3: a 24 V TVS (fast decay); none: the FET avalanches. I 1 V/A, VD drain / 52.
m6 solenoid, NCE6020AK
EXPECT: OUT = 9.75 mV per mT at the sensor (+-0.83 V at +-85 mT), 0 V with no field; about 20 kHz wide
EXPECT: full, half or PWM microsteps at the rate the FPGA sets (IN1, IN2 per coil); IA, IB = the coil currents' size, 0.98 V/A, 1 A limit
EXPECT: +5 V from the USB-C (up to 1.5 A), -5 V at 40 mA, +3.3 V at 300 mA; the green LED says 5 V is in, the red one that -5 V is up
EXPECT: OUT = 201 x the bridge's output: about 1 V at full load for a 1 mV/V cell; about 10 kHz wide
IPROPI (620 ohm, 0.98 V/A, 2 A limit) buffered onto I; (M1 - M2) / 13 onto V. Encoder A on IO5, B on IO6, its own 3.3 V.
m7 linear amp, TCA0372
ground returns through 0.05 ohm and an INA181A1 (x20) puts 1 V/A on I. Slew the angle and watch the current.
by 0.39: OUT 9.75 mV/mT. A magnet's distance, a maglev's gap, a gear tooth; the sensor is the small part top left.
m9 hall, DRV5055A3
m1 power, USB-C 5 V in: +5, -5, +3.3 out
DRV5055A3: 25 mV/mT about half its 5 V supply, ratiometric. The OPA810 subtracts the same half (20 k / 20 k) and scales
m2 motor supply, 5-16 V in
cell (3,0)
tutorial Motors (VMOT, +-5 V)
PWM (0 / +1 V) squared by a TLV3501 into a TPS28225 driving two AO3400A from VMOT; 47 uH into 2 x 22 uF. Close the loop
EXPECT: the motor at the duty and direction IO7 (IN1) and IO1 (IN2) set; I = its current, 0.98 V/A; V = its terminal voltage / 13 (back-EMF in coast)
EXPECT: OUT = 1 k x the phototransistor's current: about 0.1-0.9 V with white paper 1 mm above the sensor, near 0 V with nothing
cells (0,2), (1,2)
cell (1,1)
with no supply. SMBJ16A and 220 uF on VMOT take the braking energy a motor returns. VM: VMOT / 16 at high impedance.
cell (3,1)
m10 optical, QRE1113
m8 buck stage, TPS28225
force loop with the servo or the linear amplifier. Cable: 1 red E+, 2 black E-, 3 white S-, 4 green S+.
