gallicchio/AMOD-and-RFMOD/hardware/amod_m.kicad_pcb

## KiCad design hardware/amod_m.kicad_pcb (continued)

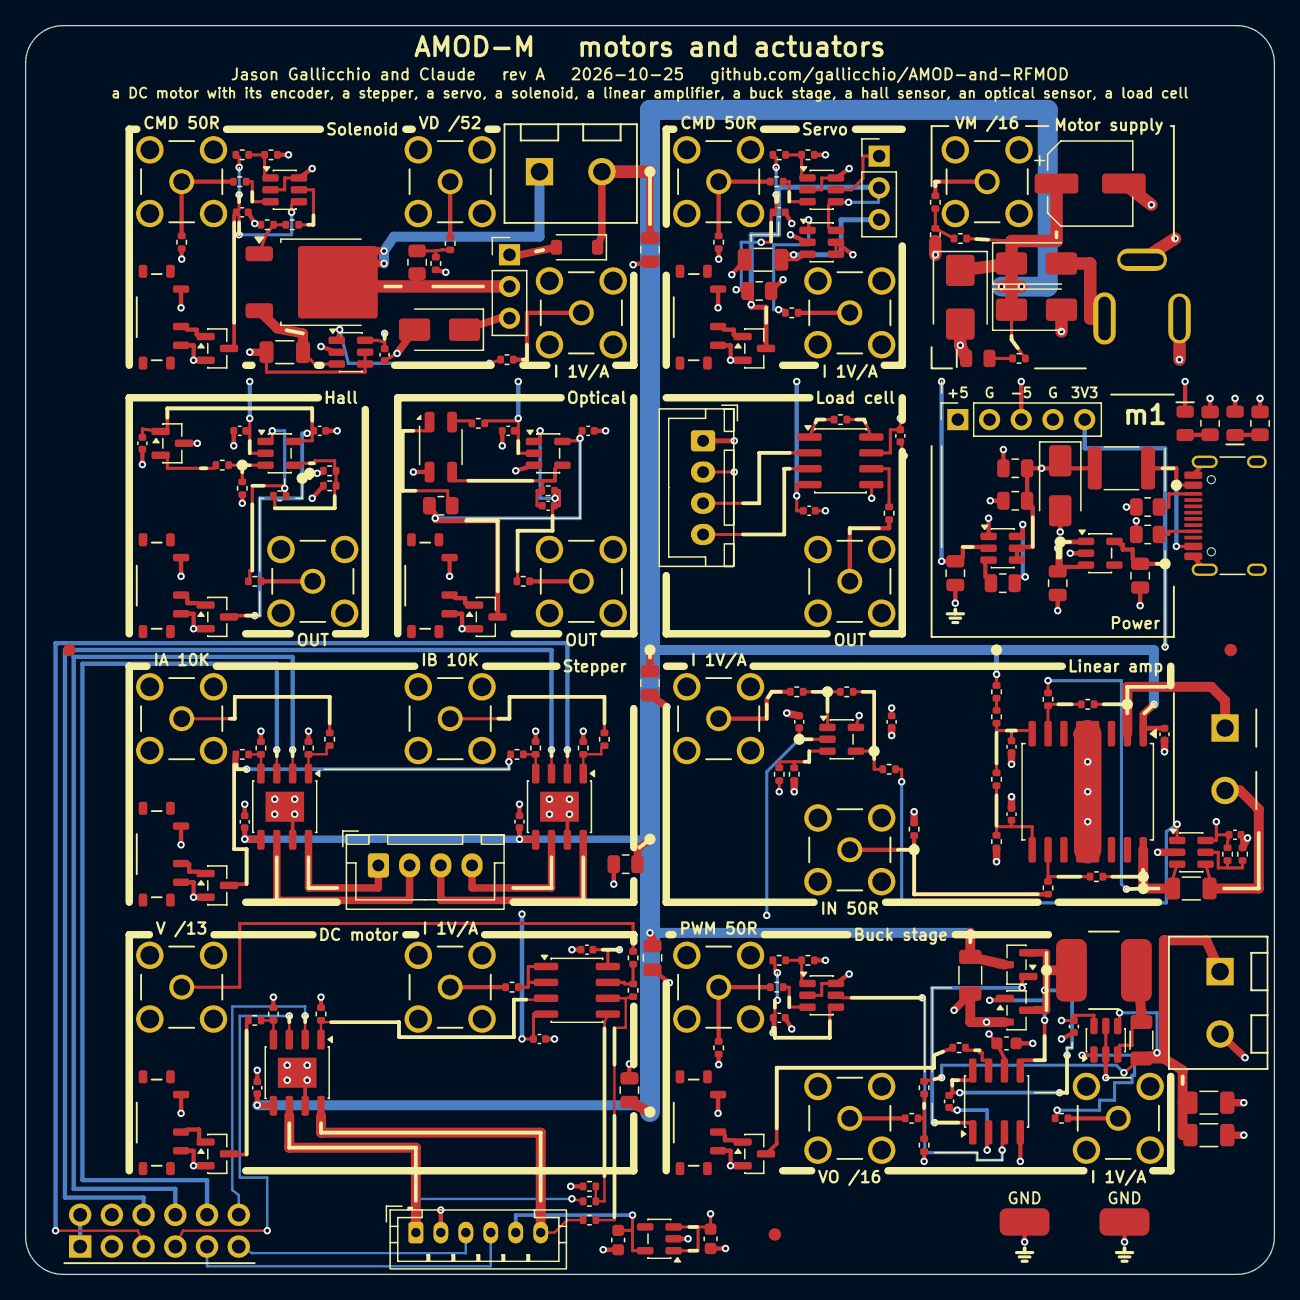
[picture p222: board amod_m.kicad_pcb from above]

Board: 4 copper layers, 100.0 x 100.0 mm, 207 parts (0 on the bottom side), 126 nets.
