gallicchio/AMOD-and-RFMOD/hardware/rf_mod.kicad_pcb

## KiCad design hardware/rf_mod.kicad_pcb (2026-10-30)

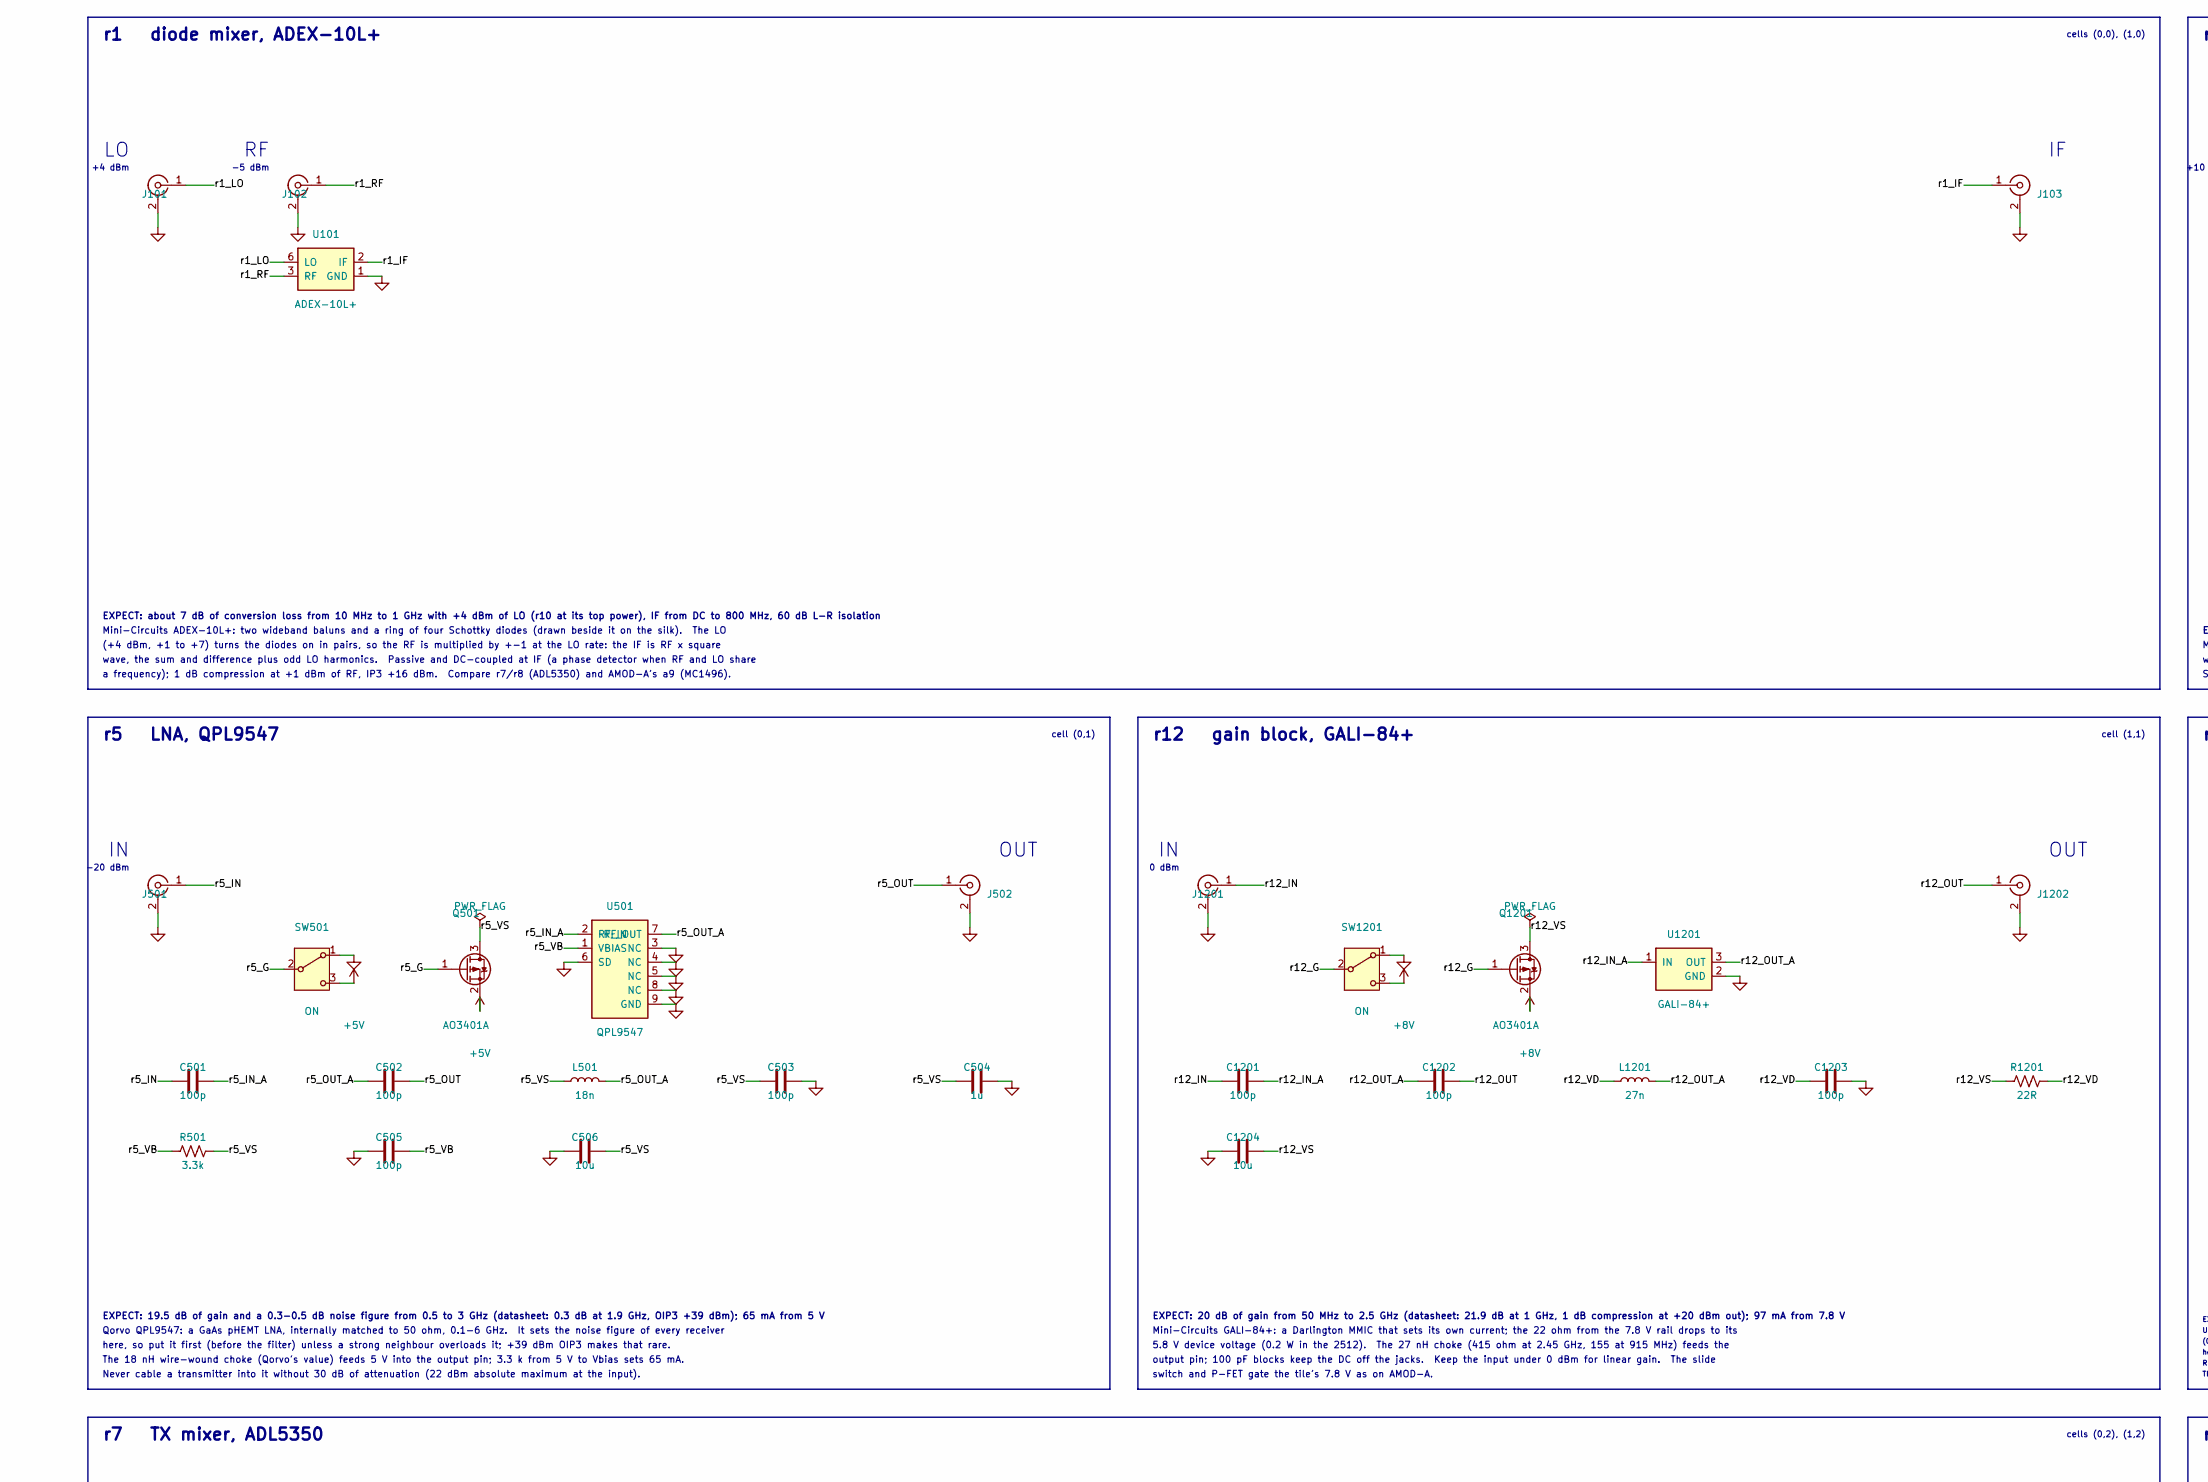
[picture p223: schematic rf_mod.kicad_sch, RF-MOD: 915 MHz, 2.4 GHz and a stretch to 5.8 GHz, part in row 1, column 1]

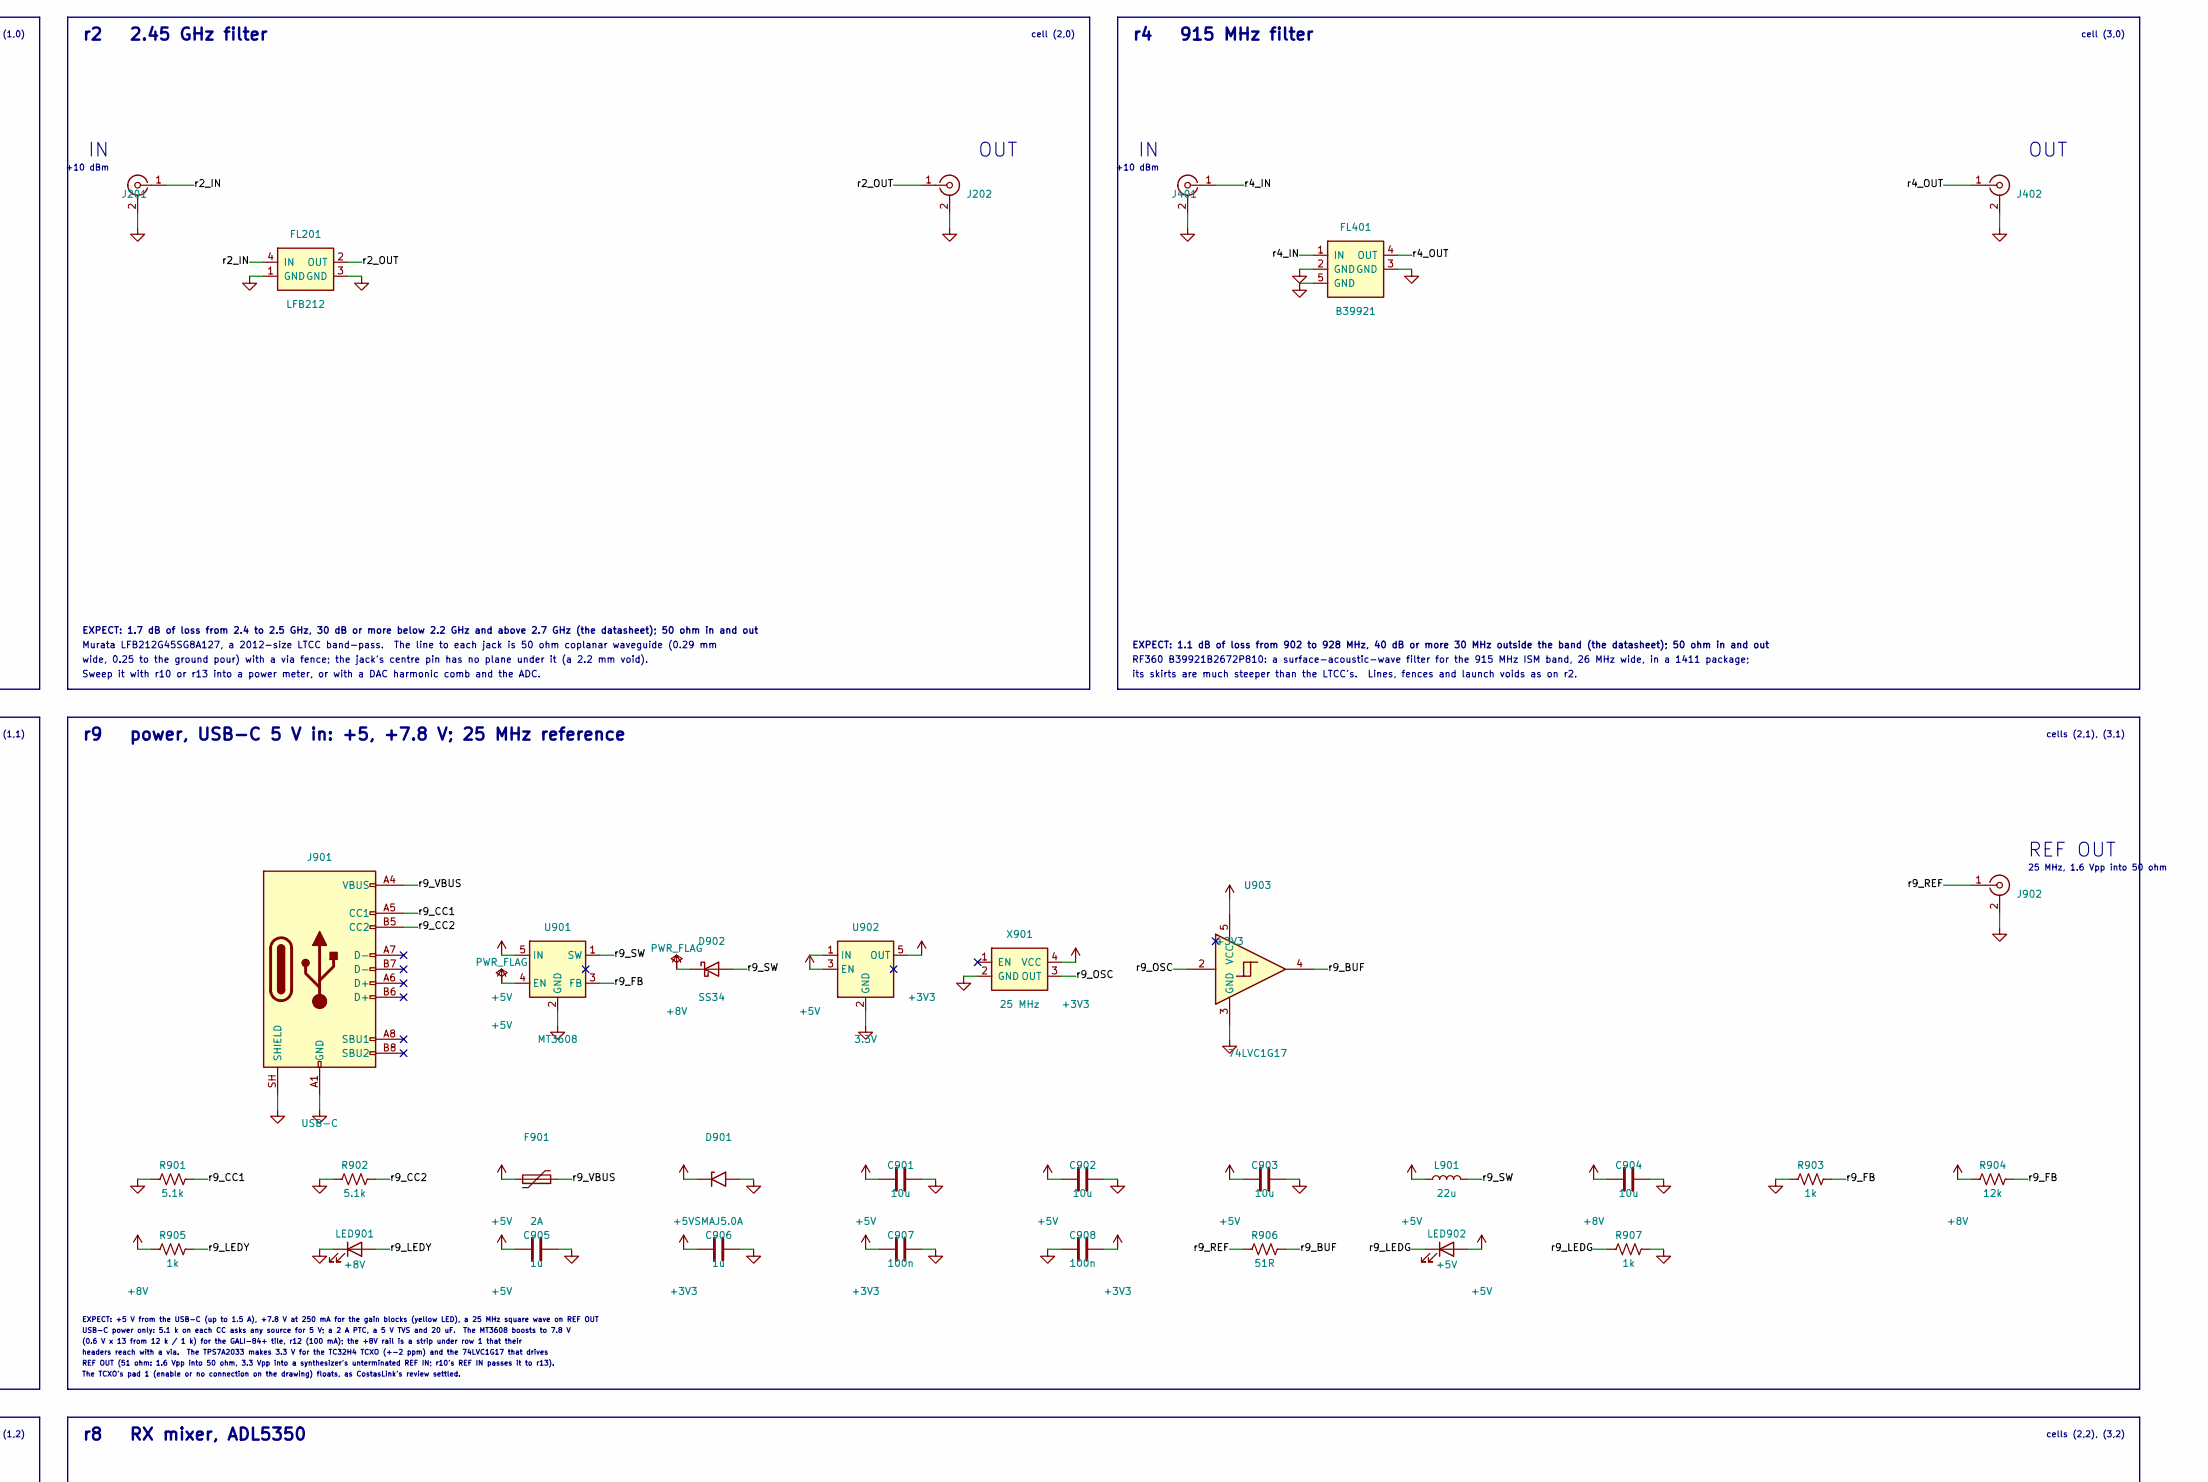
[picture p224: schematic rf_mod.kicad_sch, RF-MOD: 915 MHz, 2.4 GHz and a stretch to 5.8 GHz, part in row 1, column 2]

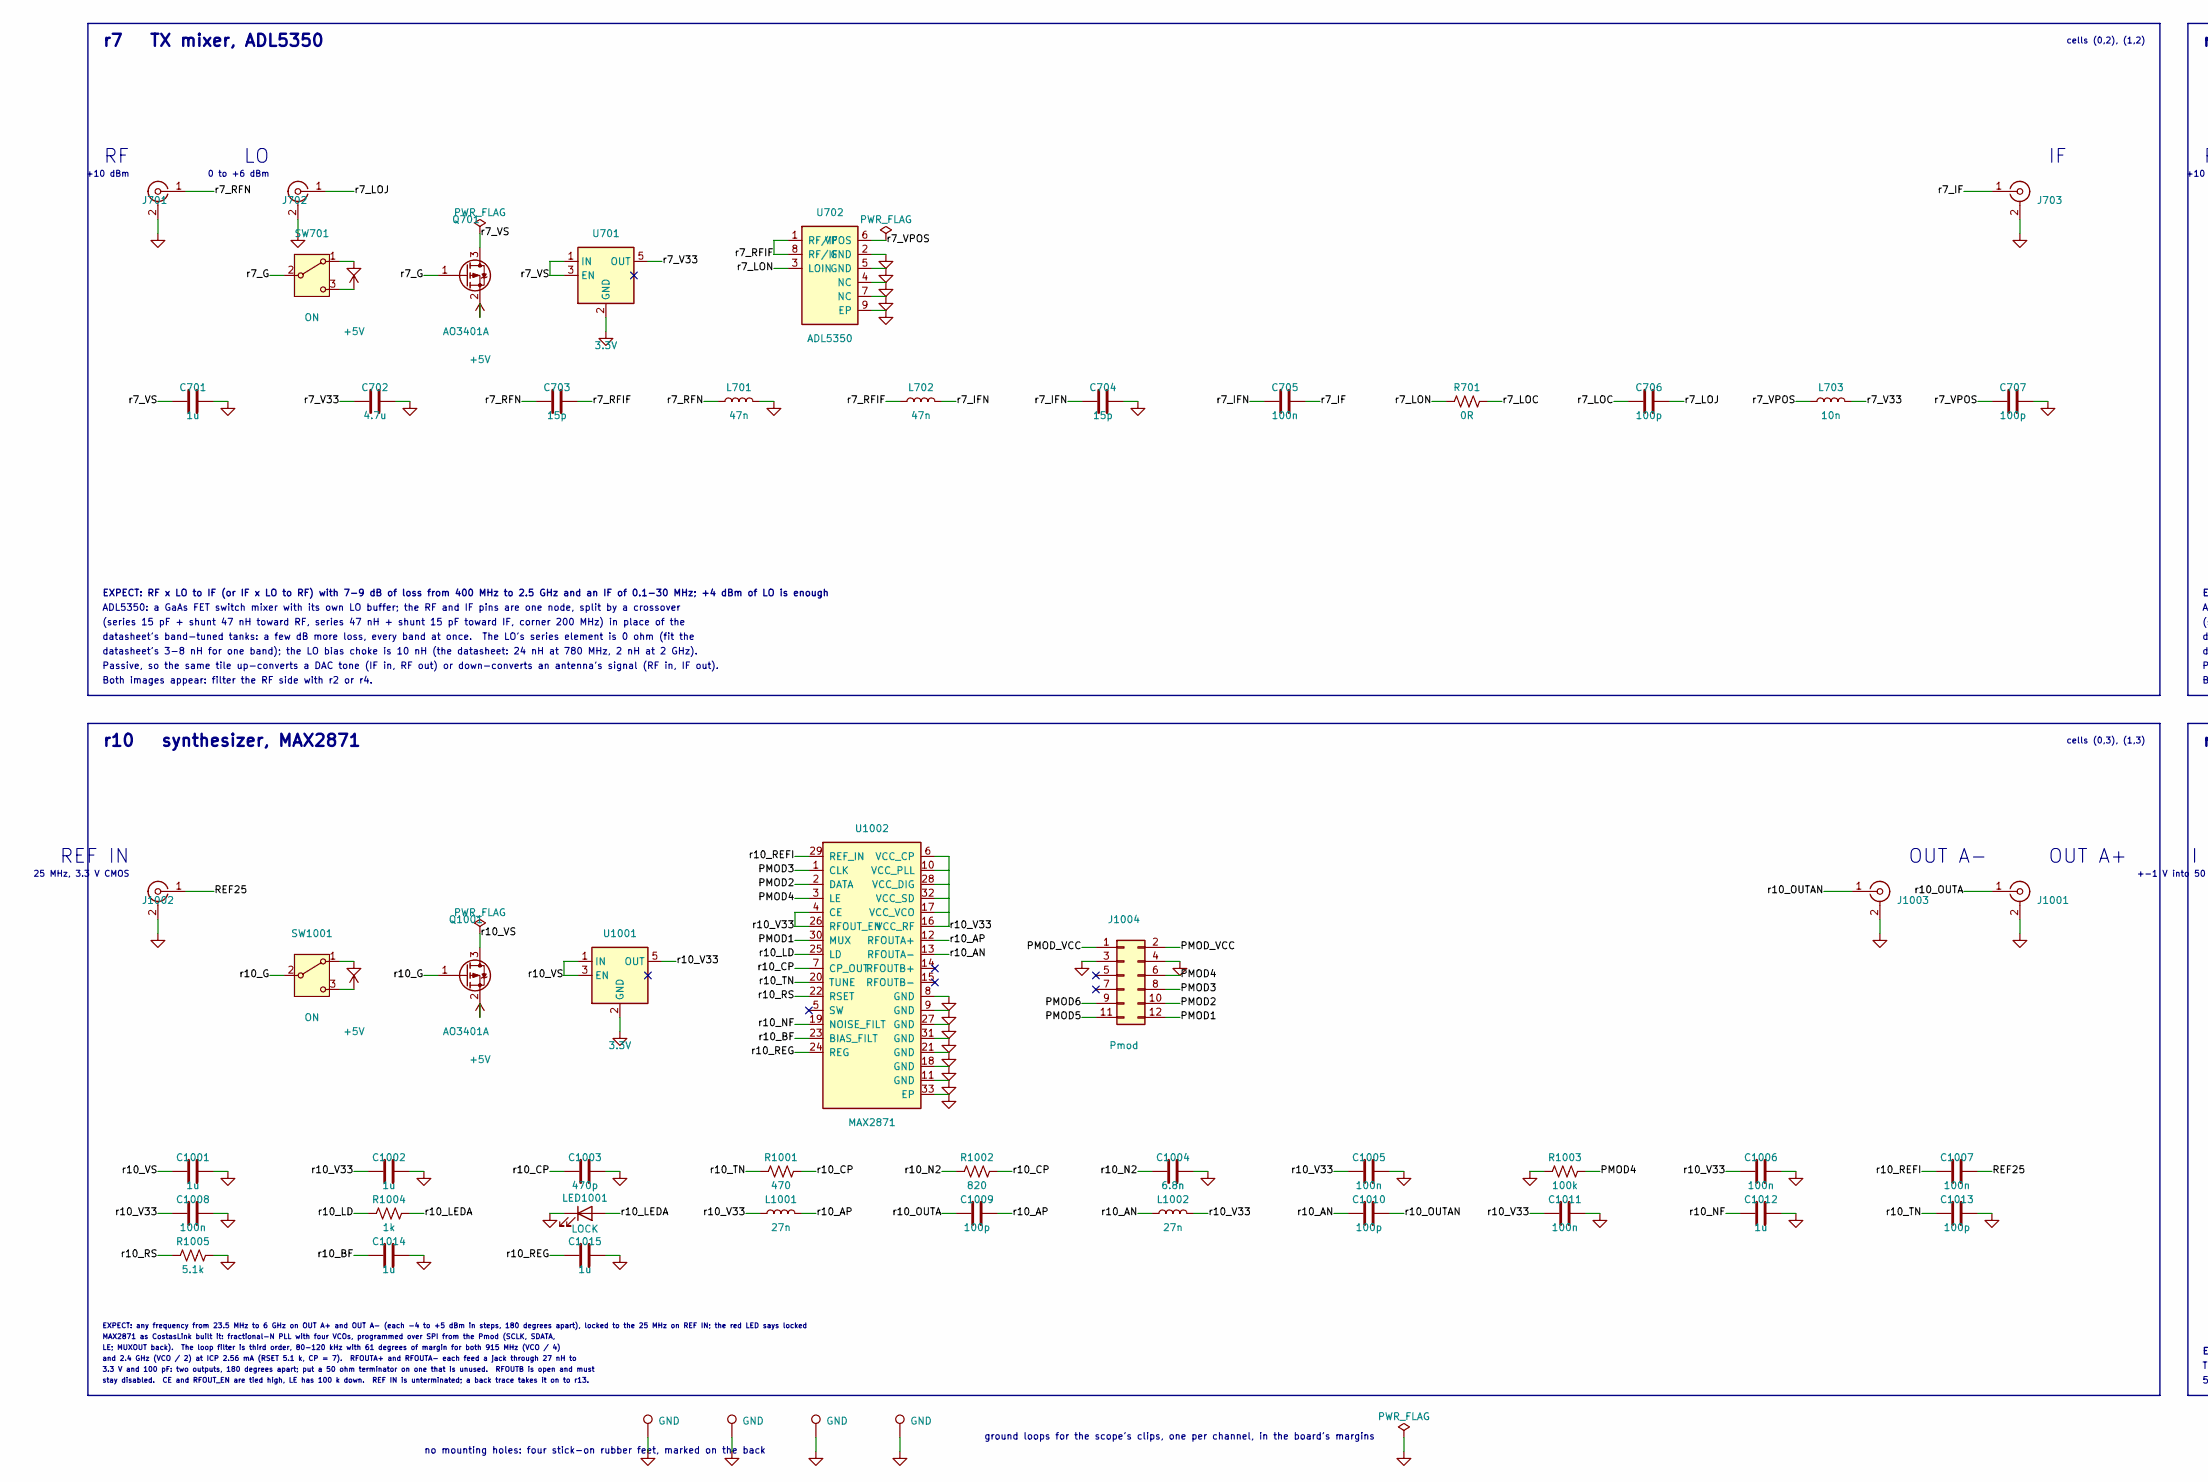
[picture p225: schematic rf_mod.kicad_sch, RF-MOD: 915 MHz, 2.4 GHz and a stretch to 5.8 GHz, part in row 2, column 1]

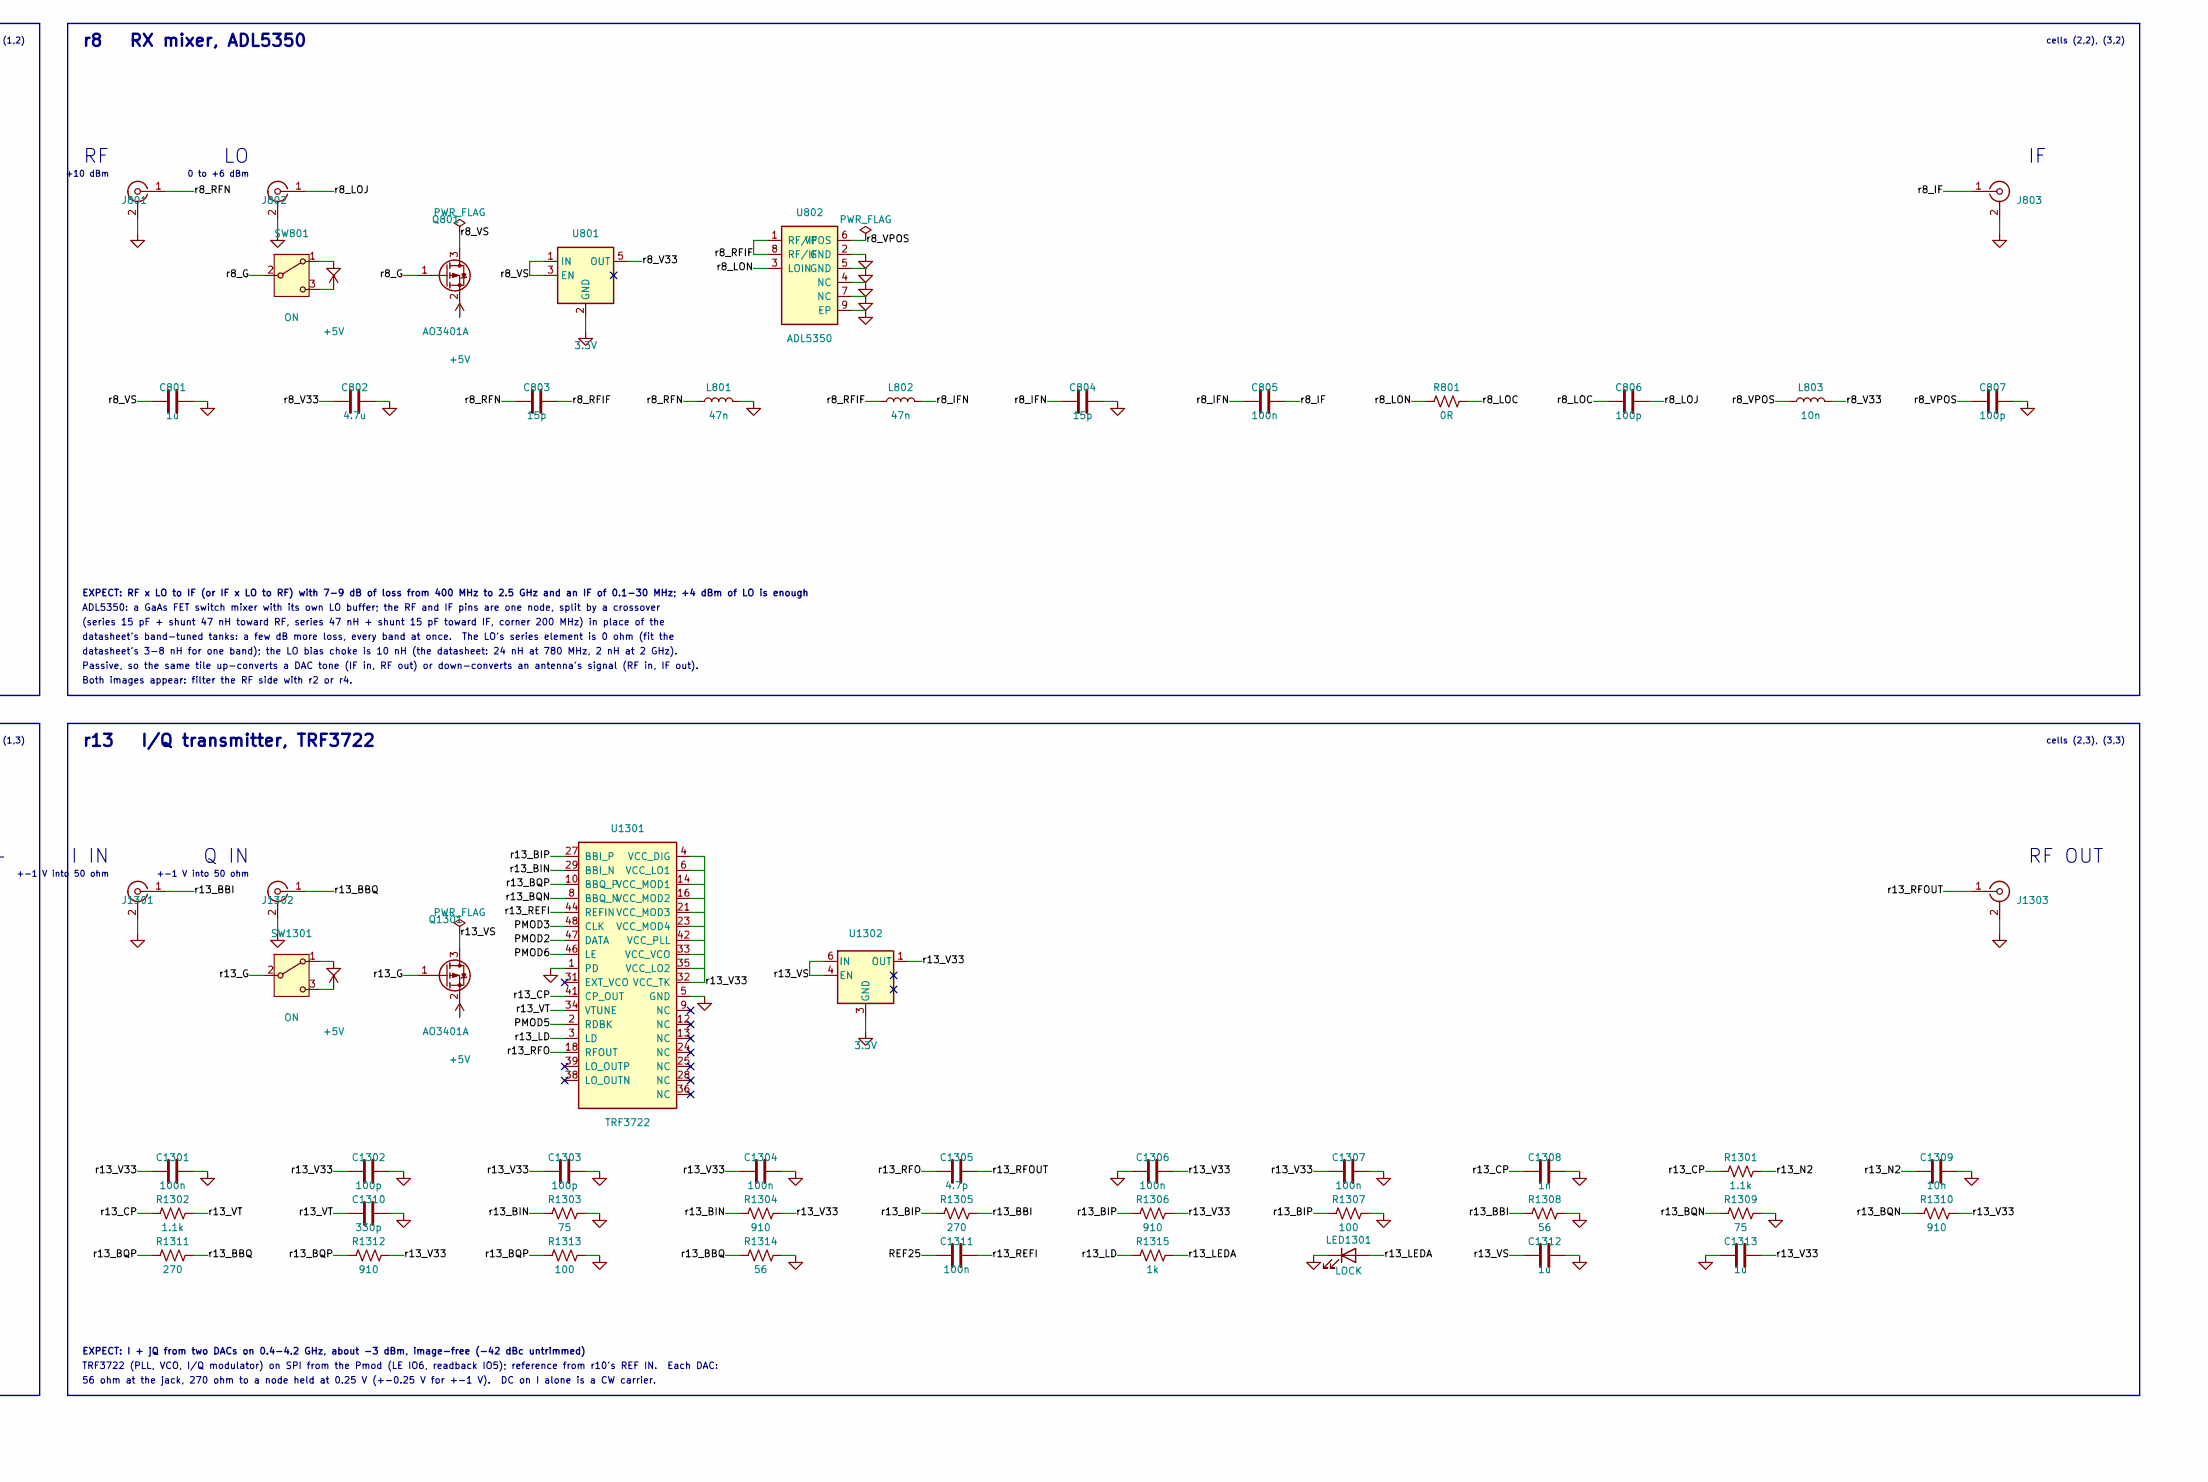
[picture p226: schematic rf_mod.kicad_sch, RF-MOD: 915 MHz, 2.4 GHz and a stretch to 5.8 GHz, part in row 2, column 2]

Parts:
C501, C502, C503, C505, C706, C707, C806, C807, C1009, C1010, C1201, C1202, C1203, C1302, C1303: 100p; C_0402_1005Metric; MPN 0402CG101J500NT; LCSC C1546
C504, C1012, C1014, C1015: 1u; C_0402_1005Metric; MPN CL05A105KP5NNNC; LCSC C14445
C506, C901, C902, C903, C904, C1204: 10u; C_0805_2012Metric; MPN CL21A106KAYNNNE; LCSC C15850
C701, C801, C905, C906, C1001, C1002: 1u; C_0805_2012Metric; MPN CL21B105KBFNNNE; LCSC C28323
C702, C802: 4.7u; C_0805_2012Metric; MPN CL21A475KAQNNNE; LCSC C1779
C703, C704, C803, C804: 15p; C_0402_1005Metric; MPN 0402CG150J500NT; LCSC C1548
C705, C805, C1005, C1006, C1007, C1008, C1011, C1301, C1304, C1306, C1307, C1311: 100n; C_0402_1005Metric; MPN CL05B104KO5NNNC; LCSC C1525
C907, C908: 100n; C_0603_1608Metric; MPN CC0603KRX7R9BB104; LCSC C14663
C1003: 470p; C_0603_1608Metric; MPN 0603CG471J500NT; LCSC C36252
C1004: 6.8n; C_0603_1608Metric; MPN GRM1885C1H682JA01D; LCSC C162241
C1013: 100p; C_0603_1608Metric; MPN CL10C101JB8NNNC; LCSC C14858
C1305: 4.7p; C_0402_1005Metric; MPN 0402CG4R7C500NT; LCSC C1569
C1308: 1n; C_0402_1005Metric; MPN 0402B102K500NT; LCSC C1523
C1309: 10n; C_0402_1005Metric; MPN CL05B103KB5NNNC; LCSC C15195
C1310: 330p; C_0402_1005Metric; MPN 0402CG331J500NT; LCSC C190579
C1312, C1313: 1u; C_0603_1608Metric; MPN CL10A105KB8NNNC; LCSC C15849
D901: SMAJ5.0A; D_SMA; MPN SMAJ5.0A; LCSC C78401
D902: SS34; D_SMA; MPN SS34; LCSC C8678
F901: 2A; Fuse_1812_4532Metric; MPN MF-MSMF200-2; LCSC C210837
FL201: LFB212; Filter_LTCC_2012_LFB212; MPN LFB212G45SG8A127; LCSC C341536
FL401: B39921; Filter_SAW_1411-5P_B39921; MPN B39921B2672P810; LCSC C1518004
J101, J102, J103, J201, J202, J401, J402, J501, J502, J701, J702, J703, J801, J802, J803, J902, J1001, J1002, J1003, J1201, J1202, J1301, J1302, J1303: SMA; SMA_BWSMA-KE-Z001_Vertical; MPN BWSMA-KE-Z001; LCSC C496549
J901: USB-C; USB_C_Receptacle_HRO_TYPE-C-31-M-12; MPN TYPE-C-31-M-12; LCSC C165948
J1004: Pmod; PinHeader_2x06_P2.54mm_Horizontal_PZ254R-12-12P; MPN PZ254R-12-12P; LCSC C492434
L501: 18n; L_0402_1005Metric; MPN LQW15AN18NG00D; LCSC C91622
L701, L702, L801, L802: 47n; L_0402_1005Metric; MPN LQW15AN47NJ00D; LCSC C192855
L703, L803: 10n; L_0402_1005Metric; MPN LQW15AN10NJ00D; LCSC C184029
L901: 22u; L_4x4_XRNR4030; MPN XRNR4030-22uH/M; LCSC C5289362
L1001, L1002, L1201: 27n; L_0402_1005Metric; MPN LQW15AN27NG80D; LCSC C882469
LED901: +8V; LED_0805_2012Metric_Kbar; MPN KT-0805Y; LCSC C2296
LED902: +5V; LED_0805_2012Metric_Kbar; MPN KT-0805G; LCSC C2297
LED1001, LED1301: LOCK; LED_0805_2012Metric_Kbar; MPN NCD0805R1; LCSC C84256
Q501, Q701, Q801, Q1001, Q1201, Q1301: AO3401A; SOT-23; MPN AO3401A; LCSC C15127
R501: 3.3k; R_0402_1005Metric; MPN 0402WGF3301TCE; LCSC C25890
R701, R801: 0R; R_0402_1005Metric; MPN 0402WGF0000TCE; LCSC C17168
R901, R902: 5.1k; R_0805_2012Metric; MPN 0805W8F5101T5E; LCSC C27834
R903, R1004, R1315: 1k; R_0402_1005Metric; MPN 0402WGF1001TCE; LCSC C11702
R904: 12k; R_0402_1005Metric; MPN 0402WGF1202TCE; LCSC C25752
R905, R907: 1k; R_0805_2012Metric; MPN 0805W8F1001T5E; LCSC C17513
R906: 51R; R_0402_1005Metric; MPN 0402WGF510JTCE; LCSC C25125
R1001: 470; R_0402_1005Metric; MPN 0402WGF4700TCE; LCSC C25117
R1002: 820; R_0402_1005Metric; MPN 0402WGF8200TCE; LCSC C25135
R1003: 100k; R_0402_1005Metric; MPN 0402WGF1003TCE; LCSC C25741
R1005: 5.1k; R_0402_1005Metric; MPN 0402WGF5101TCE; LCSC C25905
R1201: 22R; R_2512_6332Metric; MPN 25121WJ0220T4E; LCSC C27258
R1301, R1302: 1.1k; R_0402_1005Metric; MPN 0402WGF1101TCE; LCSC C25860
R1303, R1309: 75; R_0402_1005Metric; MPN 0402WGF750JTCE; LCSC C25133
R1304, R1306, R1310, R1312: 910; R_0402_1005Metric; MPN 0402WGF9100TCE; LCSC C44933
R1305, R1311: 270; R_0402_1005Metric; MPN 0402WGF2700TCE; LCSC C25099
R1307, R1313: 100; R_0402_1005Metric; MPN 0402WGF1000TCE; LCSC C25076
R1308, R1314: 56; R_0402_1005Metric; MPN 0402WGF560JTCE; LCSC C25127
SW501, SW701, SW801, SW1001, SW1201, SW1301: ON; SW_SPDT_Shouhan_MSK12C02; MPN MSK12C02; LCSC C431540
TP9901, TP9902, TP9903, TP9904: GND; TestPoint_Loop_RH-5019; MPN RH-5019; LCSC C5199800
U101: ADEX-10L+; MiniCircuits_CD542_ADEX-10L; MPN ADEX-10L+; LCSC C118997
U501: QPL9547; DFN-8-1EP_2x2mm_P0.5mm_EP0.9x1.6mm; MPN QPL9547TR7; LCSC C5367093
U701, U801, U902, U1001: 3.3V; SOT-23-5; MPN TPS7A2033PDBVR; LCSC C2862740
U702, U802: ADL5350; LFCSP-8_2x3mm_P0.5mm_ADL5350; MPN ADL5350ACPZ-R7; LCSC C206667
U901: MT3608; SOT-23-6; MPN MT3608; LCSC C84817
U903: 74LVC1G17; SOT-23-5; MPN SN74LVC1G17DBVR; LCSC C7836
U1002: MAX2871; QFN-32-1EP_5x5mm_P0.5mm_EP3.1x3.1mm; MPN MAX2871ETJ+T; LCSC C7458627
U1201: GALI-84+; SOT-89-3; MPN GALI-84+; LCSC C3193261
U1301: TRF3722; Texas_RGZ0048A_VQFN-48-1EP_7x7mm_P0.5mm_EP5.15x5.15mm; MPN TRF3722IRGZR; LCSC C1850395
U1302: 3.3V; WSON-6-1EP_2x2mm_P0.65mm_EP1x1.6mm; MPN TLV75733PDRVR; LCSC C2868428
X901: 25 MHz; Crystal_SMD_3225-4Pin_3.2x2.5mm; MPN TC32H4-25.000-33GNDTNL; LCSC C5119013

Connections:
+3V3: C906.1, C907.1, C908.2, U902.5 (OUT), U903.5 (VCC), X901.4 (VCC)
+5V: C901.1, C902.1, C903.1, C905.1, D901.1 (A1), F901.1, L901.1, LED902.2 (A), Q501.2 (S), Q701.2 (S), Q801.2 (S), Q1001.2 (S), Q1301.2 (S), SW501.3 (C), SW701.3 (C), SW801.3 (C), SW1001.3 (C), SW1301.3 (C), U901.4 (EN), U901.5 (IN), U902.1 (IN), U902.3 (EN)
+8V: C904.1, D902.1 (K), Q1201.2 (S), R904.1, R905.1, SW1201.3 (C)
/PMOD1: J1004.12, U1002.30 (MUX)
/PMOD2: J1004.10, U1002.2 (DATA), U1301.47 (DATA)
/PMOD3: J1004.8, U1002.1 (CLK), U1301.48 (CLK)
/PMOD4: J1004.6, R1003.2, U1002.3 (LE)
/PMOD5: J1004.11, U1301.2 (RDBK)
/PMOD6: J1004.9, U1301.46 (LE)
/PMOD_VCC: J1004.1, J1004.2
/REF25: C1007.2, C1311.1, J1002.1 (In)
/r1_IF: J103.1 (In), U101.2 (IF)
/r1_LO: J101.1 (In), U101.6 (LO)
/r1_RF: J102.1 (In), U101.3 (RF)
/r2_IN: FL201.4 (IN), J201.1 (In)
/r2_OUT: FL201.2 (OUT), J202.1 (In)
/r4_IN: FL401.1 (IN), J401.1 (In)
/r4_OUT: FL401.4 (OUT), J402.1 (In)
/r5_G: Q501.1 (G), SW501.2 (B)
/r5_IN: C501.1, J501.1 (In)
/r5_IN_A: C501.2, U501.2 (RF_IN)
/r5_OUT: C502.2, J502.1 (In)
/r5_OUT_A: C502.1, L501.2, U501.7 (RF_OUT)
/r5_VB: C505.2, R501.1, U501.1 (VBIAS)
/r5_VS: C503.1, C504.1, C506.2, L501.1, Q501.3 (D), R501.2
/r7_G: Q701.1 (G), SW701.2 (B)
/r7_IF: C705.2, J703.1 (In)
/r7_IFN: C704.1, C705.1, L702.2
/r7_LOC: C706.1, R701.2
/r7_LOJ: C706.2, J702.1 (In)
/r7_LON: R701.1, U702.3 (LOIN)
/r7_RFIF: C703.2, L702.1, U702.1 (RF/IF), U702.8 (RF/IF)
/r7_RFN: C703.1, J701.1 (In), L701.1
/r7_V33: C702.1, L703.2, U701.5 (OUT)
/r7_VPOS: C707.1, L703.1, U702.6 (VPOS)
/r7_VS: C701.1, Q701.3 (D), U701.1 (IN), U701.3 (EN)
/r8_G: Q801.1 (G), SW801.2 (B)
/r8_IF: C805.2, J803.1 (In)
/r8_IFN: C804.1, C805.1, L802.2
/r8_LOC: C806.1, R801.2
/r8_LOJ: C806.2, J802.1 (In)
/r8_LON: R801.1, U802.3 (LOIN)
/r8_RFIF: C803.2, L802.1, U802.1 (RF/IF), U802.8 (RF/IF)
/r8_RFN: C803.1, J801.1 (In), L801.1
/r8_V33: C802.1, L803.2, U801.5 (OUT)
/r8_VPOS: C807.1, L803.1, U802.6 (VPOS)
/r8_VS: C801.1, Q801.3 (D), U801.1 (IN), U801.3 (EN)
/r9_BUF: R906.2, U903.4
/r9_CC1: J901.A5 (CC1), R901.2
/r9_CC2: J901.B5 (CC2), R902.2
/r9_FB: R903.2, R904.2, U901.3 (FB)
/r9_LEDG: LED902.1 (K), R907.1
/r9_LEDY: LED901.2 (A), R905.2
/r9_OSC: U903.2, X901.3 (OUT)
/r9_REF: J902.1 (In), R906.1
/r9_SW: D902.2 (A), L901.2, U901.1 (SW)
/r9_VBUS: F901.2, J901.A4 (VBUS), J901.A9 (VBUS), J901.B4 (VBUS), J901.B9 (VBUS)
/r10_AN: C1010.1, L1002.1, U1002.13 (RFOUTA-)
/r10_AP: C1009.2, L1001.2, U1002.12 (RFOUTA+)
/r10_BF: C1014.1, U1002.23 (BIAS_FILT)
/r10_CP: C1003.1, R1001.2, R1002.2, U1002.7 (CP_OUT)
/r10_G: Q1001.1 (G), SW1001.2 (B)
/r10_LD: R1004.1, U1002.25 (LD)
/r10_LEDA: LED1001.2 (A), R1004.2
/r10_N2: C1004.1, R1002.1
/r10_NF: C1012.1, U1002.19 (NOISE_FILT)
/r10_OUTA: C1009.1, J1001.1 (In)
/r10_OUTAN: C1010.2, J1003.1 (In)
/r10_REFI: C1007.1, U1002.29 (REF_IN)
/r10_REG: C1015.1, U1002.24 (REG)
/r10_RS: R1005.1, U1002.22 (RSET)
/r10_TN: C1013.1, R1001.1, U1002.20 (TUNE)
/r10_V33: C1002.1, C1005.1, C1006.1, C1008.1, C1011.1, L1001.1, L1002.2, U1001.5 (OUT), U1002.4 (CE), U1002.6 (VCC_CP), U1002.10 (VCC_PLL), U1002.16 (VCC_RF), U1002.17 (VCC_VCO), U1002.26 (RFOUT_EN), U1002.28 (VCC_DIG), U1002.32 (VCC_SD)
/r10_VS: C1001.1, Q1001.3 (D), U1001.1 (IN), U1001.3 (EN)
/r12_G: Q1201.1 (G), SW1201.2 (B)
/r12_IN: C1201.1, J1201.1 (In)
/r12_IN_A: C1201.2, U1201.1 (IN)
/r12_OUT: C1202.2, J1202.1 (In)
/r12_OUT_A: C1202.1, L1201.2, U1201.3 (OUT)
/r12_VD: C1203.1, L1201.1, R1201.2
/r12_VS: C1204.2, Q1201.3 (D), R1201.1
/r13_BBI: J1301.1 (In), R1305.2, R1308.1
/r13_BBQ: J1302.1 (In), R1311.2, R1314.1
/r13_BIN: R1303.1, R1304.1, U1301.29 (BBI_N)
/r13_BIP: R1305.1, R1306.1, R1307.1, U1301.27 (BBI_P)
/r13_BQN: R1309.1, R1310.1, U1301.8 (BBQ_N)
/r13_BQP: R1311.1, R1312.1, R1313.1, U1301.10 (BBQ_P)
/r13_CP: C1308.1, R1301.1, R1302.1, U1301.41 (CP_OUT)
/r13_G: Q1301.1 (G), SW1301.2 (B)
/r13_LD: R1315.1, U1301.3 (LD)
/r13_LEDA: LED1301.2 (A), R1315.2
/r13_N2: C1309.1, R1301.2
/r13_REFI: C1311.2, U1301.44 (REFIN)
/r13_RFO: C1305.1, U1301.18 (RFOUT)
/r13_RFOUT: C1305.2, J1303.1 (In)
/r13_V33: C1301.1, C1302.1, C1303.1, C1304.1, C1306.2, C1307.1, C1313.2, R1304.2, R1306.2, R1310.2, R1312.2, U1301.4 (VCC_DIG), U1301.6 (VCC_LO1), U1301.14 (VCC_MOD1), U1301.16 (VCC_MOD2), U1301.21 (VCC_MOD3), U1301.23 (VCC_MOD4), U1301.32 (VCC_TK), U1301.33 (VCC_VCO), U1301.35 (VCC_LO2), U1301.42 (VCC_PLL), U1302.1 (OUT)
/r13_VS: C1312.1, Q1301.3 (D), U1302.4 (EN), U1302.6 (IN)
/r13_VT: C1310.1, R1302.2, U1301.34 (VTUNE)
GND: C503.2, C504.2, C505.1, C506.1, C701.2, C702.2, C704.2, C707.2, C801.2, C802.2, C804.2, C807.2, C901.2, C902.2, C903.2, C904.2, C905.2, C906.2, C907.2, C908.1, C1001.2, C1002.2, C1003.2, C1004.2, C1005.2, C1006.2, C1008.2, C1011.2, C1012.2, C1013.2, C1014.2, C1015.2, C1203.2, C1204.1, C1301.2, C1302.2, C1303.2, C1304.2, C1306.1, C1307.2, C1308.2, C1309.2, C1310.2, C1312.2, C1313.1, D901.2 (A2), FL201.1 (GND), FL201.3 (GND), FL401.2 (GND), FL401.3 (GND), FL401.5 (GND), J101.2 (Ext), J102.2 (Ext), J103.2 (Ext), J201.2 (Ext), J202.2 (Ext), J401.2 (Ext), J402.2 (Ext), J501.2 (Ext), J502.2 (Ext), J701.2 (Ext), J702.2 (Ext), J703.2 (Ext), J801.2 (Ext), J802.2 (Ext), J803.2 (Ext), J901.A1 (GND), J901.A12 (GND), J901.B1 (GND), J901.B12 (GND), J901.SH (SHIELD), J902.2 (Ext), J1001.2 (Ext), J1002.2 (Ext), J1003.2 (Ext), J1004.3, J1004.4, J1201.2 (Ext), J1202.2 (Ext), J1301.2 (Ext), J1302.2 (Ext), J1303.2 (Ext), L701.2, L801.2, LED901.1 (K), LED1001.1 (K), LED1301.1 (K), R901.1, R902.1, R903.1, R907.2, R1003.1, R1005.2, R1303.2, R1307.2, R1308.2, R1309.2, R1313.2, R1314.2, SW501.1 (A), SW701.1 (A), SW801.1 (A), SW1001.1 (A), SW1201.1 (A), SW1301.1 (A), TP9901.1, TP9902.1, TP9903.1, TP9904.1, U101.1 (GND), U101.4 (GND), U101.5 (GND), U501.3 (NC), U501.4 (NC), U501.5 (NC), U501.6 (SD), U501.8 (NC), U501.9 (GND), U701.2 (GND), U702.2 (GND), U702.4 (NC), U702.5 (GND), U702.7 (NC), U702.9 (EP), U801.2 (GND), U802.2 (GND), U802.4 (NC), U802.5 (GND), U802.7 (NC), U802.9 (EP), U901.2 (GND), U902.2 (GND), U903.3 (GND), U1001.2 (GND), U1002.8 (GND), U1002.9 (GND), U1002.11 (GND), U1002.18 (GND), U1002.21 (GND), U1002.27 (GND), U1002.31 (GND), U1002.33 (EP), U1201.2 (GND), U1301.1 (PD), U1301.5 (GND), U1301.7 (GND), U1301.11 (GND), U1301.15 (GND), U1301.17 (GND), U1301.19 (GND), U1301.20 (GND), U1301.22 (GND), U1301.26 (GND), U1301.30 (GND), U1301.37 (GND), U1301.40 (GND), U1301.43 (GND), U1301.45 (GND), U1301.49 (GND), U1302.3 (GND), U1302.7 (GND), X901.2 (GND)

Notes on the sheet:
+-1 V into 50 ohm
here, so put it first (before the filter) unless a strong neighbour overloads it; +39 dBm OIP3 makes that rare.
cells (2,1), (3,1)
+10 dBm
56 ohm at the jack, 270 ohm to a node held at 0.25 V (+-0.25 V for +-1 V). DC on I alone is a CW carrier.
OUT
cells (2,2), (3,2)
ADL5350: a GaAs FET switch mixer with its own LO buffer; the RF and IF pins are one node, split by a crossover
EXPECT: I + jQ from two DACs on 0.4-4.2 GHz, about -3 dBm, image-free (-42 dBc untrimmed)
REF OUT
OUT A-
datasheet's band-tuned tanks: a few dB more loss, every band at once. The LO's series element is 0 ohm (fit the
r2 2.45 GHz filter
cell (2,0)
switch and P-FET gate the tile's 7.8 V as on AMOD-A.
(0.6 V x 13 from 12 k / 1 k) for the GALI-84+ tile, r12 (100 mA); the +8V rail is a strip under row 1 that their
r7 TX mixer, ADL5350
I IN
Q IN
cell (0,1)
Qorvo QPL9547: a GaAs pHEMT LNA, internally matched to 50 ohm, 0.1-6 GHz. It sets the noise figure of every receiver
Both images appear: filter the RF side with r2 or r4.
r1 diode mixer, ADEX-10L+
cells (0,0), (1,0)
25 MHz, 3.3 V CMOS
r13 I/Q transmitter, TRF3722
r12 gain block, GALI-84+
EXPECT: any frequency from 23.5 MHz to 6 GHz on OUT A+ and OUT A- (each -4 to +5 dBm in steps, 180 degrees apart), locked to the 25 MHz on REF IN; the red LED says locked
REF IN
cells (2,3), (3,3)
stay disabled. CE and RFOUT_EN are tied high, LE has 100 k down. REF IN is unterminated; a back trace takes it on to r13.
-20 dBm
Sweep it with r10 or r13 into a power meter, or with a DAC harmonic comb and the ADC.
0 to +6 dBm
5.8 V device voltage (0.2 W in the 2512). The 27 nH choke (415 ohm at 2.45 GHz, 155 at 915 MHz) feeds the
wave, the sum and difference plus odd LO harmonics. Passive and DC-coupled at IF (a phase detector when RF and LO share
cells (0,3), (1,3)
ground loops for the scope's clips, one per channel, in the board's margins
(series 15 pF + shunt 47 nH toward RF, series 47 nH + shunt 15 pF toward IF, corner 200 MHz) in place of the
Passive, so the same tile up-converts a DAC tone (IF in, RF out) or down-converts an antenna's signal (RF in, IF out).
no mounting holes: four stick-on rubber feet, marked on the back
EXPECT: RF x LO to IF (or IF x LO to RF) with 7-9 dB of loss from 400 MHz to 2.5 GHz and an IF of 0.1-30 MHz; +4 dBm of LO is enough
EXPECT: +5 V from the USB-C (up to 1.5 A), +7.8 V at 250 mA for the gain blocks (yellow LED), a 25 MHz square wave on REF OUT
r10 synthesizer, MAX2871
datasheet's 3-8 nH for one band); the LO bias choke is 10 nH (the datasheet: 24 nH at 780 MHz, 2 nH at 2 GHz).
r9 power, USB-C 5 V in: +5, +7.8 V; 25 MHz reference
RF360 B39921B2672P810: a surface-acoustic-wave filter for the 915 MHz ISM band, 26 MHz wide, in a 1411 package;
r4 915 MHz filter
RF OUT
Murata LFB212G45SG8A127, a 2012-size LTCC band-pass. The line to each jack is 50 ohm coplanar waveguide (0.29 mm
Mini-Circuits GALI-84+: a Darlington MMIC that sets its own current; the 22 ohm from the 7.8 V rail drops to its
MAX2871 as CostasLink built it: fractional-N PLL with four VCOs, programmed over SPI from the Pmod (SCLK, SDATA,
OUT A+
Mini-Circuits ADEX-10L+: two wideband baluns and a ring of four Schottky diodes (drawn beside it on the silk). The LO
EXPECT: 1.7 dB of loss from 2.4 to 2.5 GHz, 30 dB or more below 2.2 GHz and above 2.7 GHz (the datasheet); 50 ohm in and out
The 18 nH wire-wound choke (Qorvo's value) feeds 5 V into the output pin; 3.3 k from 5 V to Vbias sets 65 mA.
EXPECT: 20 dB of gain from 50 MHz to 2.5 GHz (datasheet: 21.9 dB at 1 GHz, 1 dB compression at +20 dBm out); 97 mA from 7.8 V
TRF3722 (PLL, VCO, I/Q modulator) on SPI from the Pmod (LE IO6, readback IO5); reference from r10's REF IN. Each DAC:
EXPECT: about 7 dB of conversion loss from 10 MHz to 1 GHz with +4 dBm of LO (r10 at its top power), IF from DC to 800 MHz, 60 dB L-R isolation
r8 RX mixer, ADL5350
output pin; 100 pF blocks keep the DC off the jacks. Keep the input under 0 dBm for linear gain. The slide
(+4 dBm, +1 to +7) turns the diodes on in pairs, so the RF is multiplied by +-1 at the LO rate: the IF is RF x square
r5 LNA, QPL9547
-5 dBm
and 2.4 GHz (VCO / 2) at ICP 2.56 mA (RSET 5.1 k, CP = 7). RFOUTA+ and RFOUTA- each feed a jack through 27 nH to
headers reach with a via. The TPS7A2033 makes 3.3 V for the TC32H4 TCXO (+-2 ppm) and the 74LVC1G17 that drives
25 MHz, 1.6 Vpp into 50 ohm
wide, 0.25 to the ground pour) with a via fence; the jack's centre pin has no plane under it (a 2.2 mm void).
cell (3,0)
The TCXO's pad 1 (enable or no connection on the drawing) floats, as CostasLink's review settled.
its skirts are much steeper than the LTCC's. Lines, fences and launch voids as on r2.
a frequency); 1 dB compression at +1 dBm of RF, IP3 +16 dBm. Compare r7/r8 (ADL5350) and AMOD-A's a9 (MC1496).
Never cable a transmitter into it without 30 dB of attenuation (22 dBm absolute maximum at the input).
LE; MUXOUT back). The loop filter is third order, 80-120 kHz with 61 degrees of margin for both 915 MHz (VCO / 4)
+4 dBm
USB-C power only: 5.1 k on each CC asks any source for 5 V; a 2 A PTC, a 5 V TVS and 20 uF. The MT3608 boosts to 7.8 V
0 dBm
cells (0,2), (1,2)
3.3 V and 100 pF: two outputs, 180 degrees apart; put a 50 ohm terminator on one that is unused. RFOUTB is open and must
EXPECT: 19.5 dB of gain and a 0.3-0.5 dB noise figure from 0.5 to 3 GHz (datasheet: 0.3 dB at 1.9 GHz, OIP3 +39 dBm); 65 mA from 5 V
cell (1,1)
EXPECT: 1.1 dB of loss from 902 to 928 MHz, 40 dB or more 30 MHz outside the band (the datasheet); 50 ohm in and out
REF OUT (51 ohm: 1.6 Vpp into 50 ohm, 3.3 Vpp into a synthesizer's unterminated REF IN; r10's REF IN passes it to r13).
