gallicchio/AMOD-and-RFMOD/hardware/rf_mod.kicad_pcb

## KiCad design hardware/rf_mod.kicad_pcb (continued)

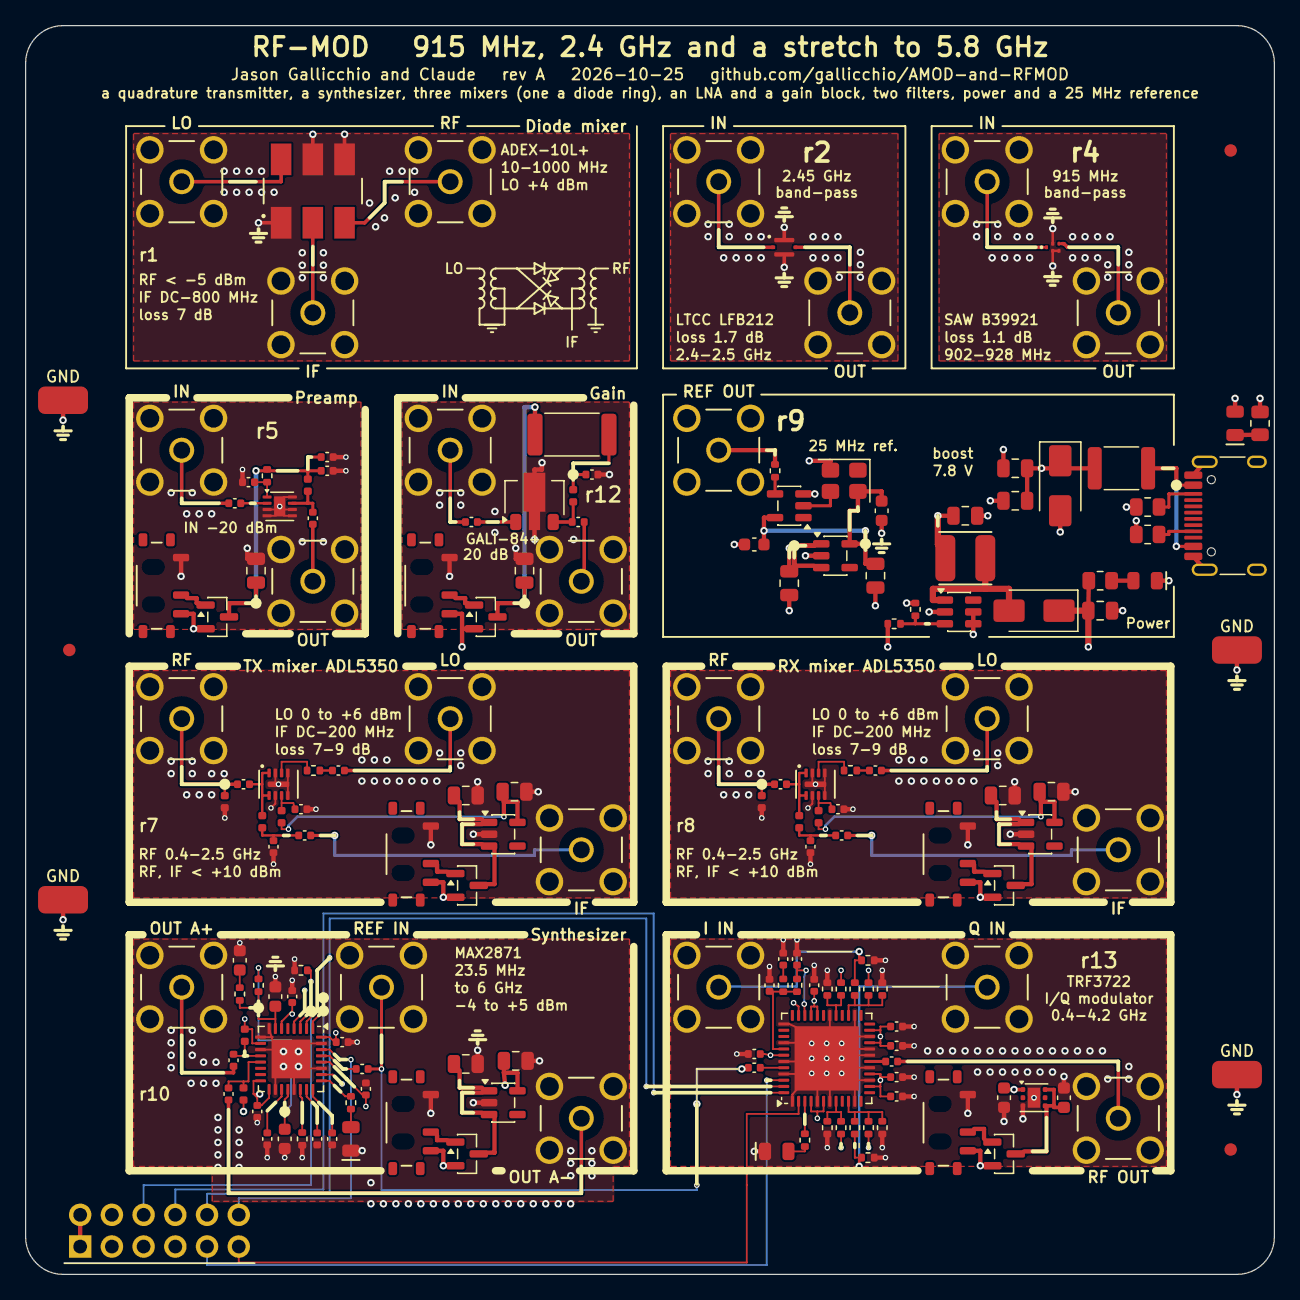
[picture p227: board rf_mod.kicad_pcb from above]

Board: 4 copper layers, 100.0 x 100.0 mm, 168 parts (0 on the bottom side), 99 nets.
