gallicchio/AMOD-and-RFMOD/hardware/iq_mod.kicad_pcb

## KiCad design hardware/iq_mod.kicad_pcb (2026-10-30)

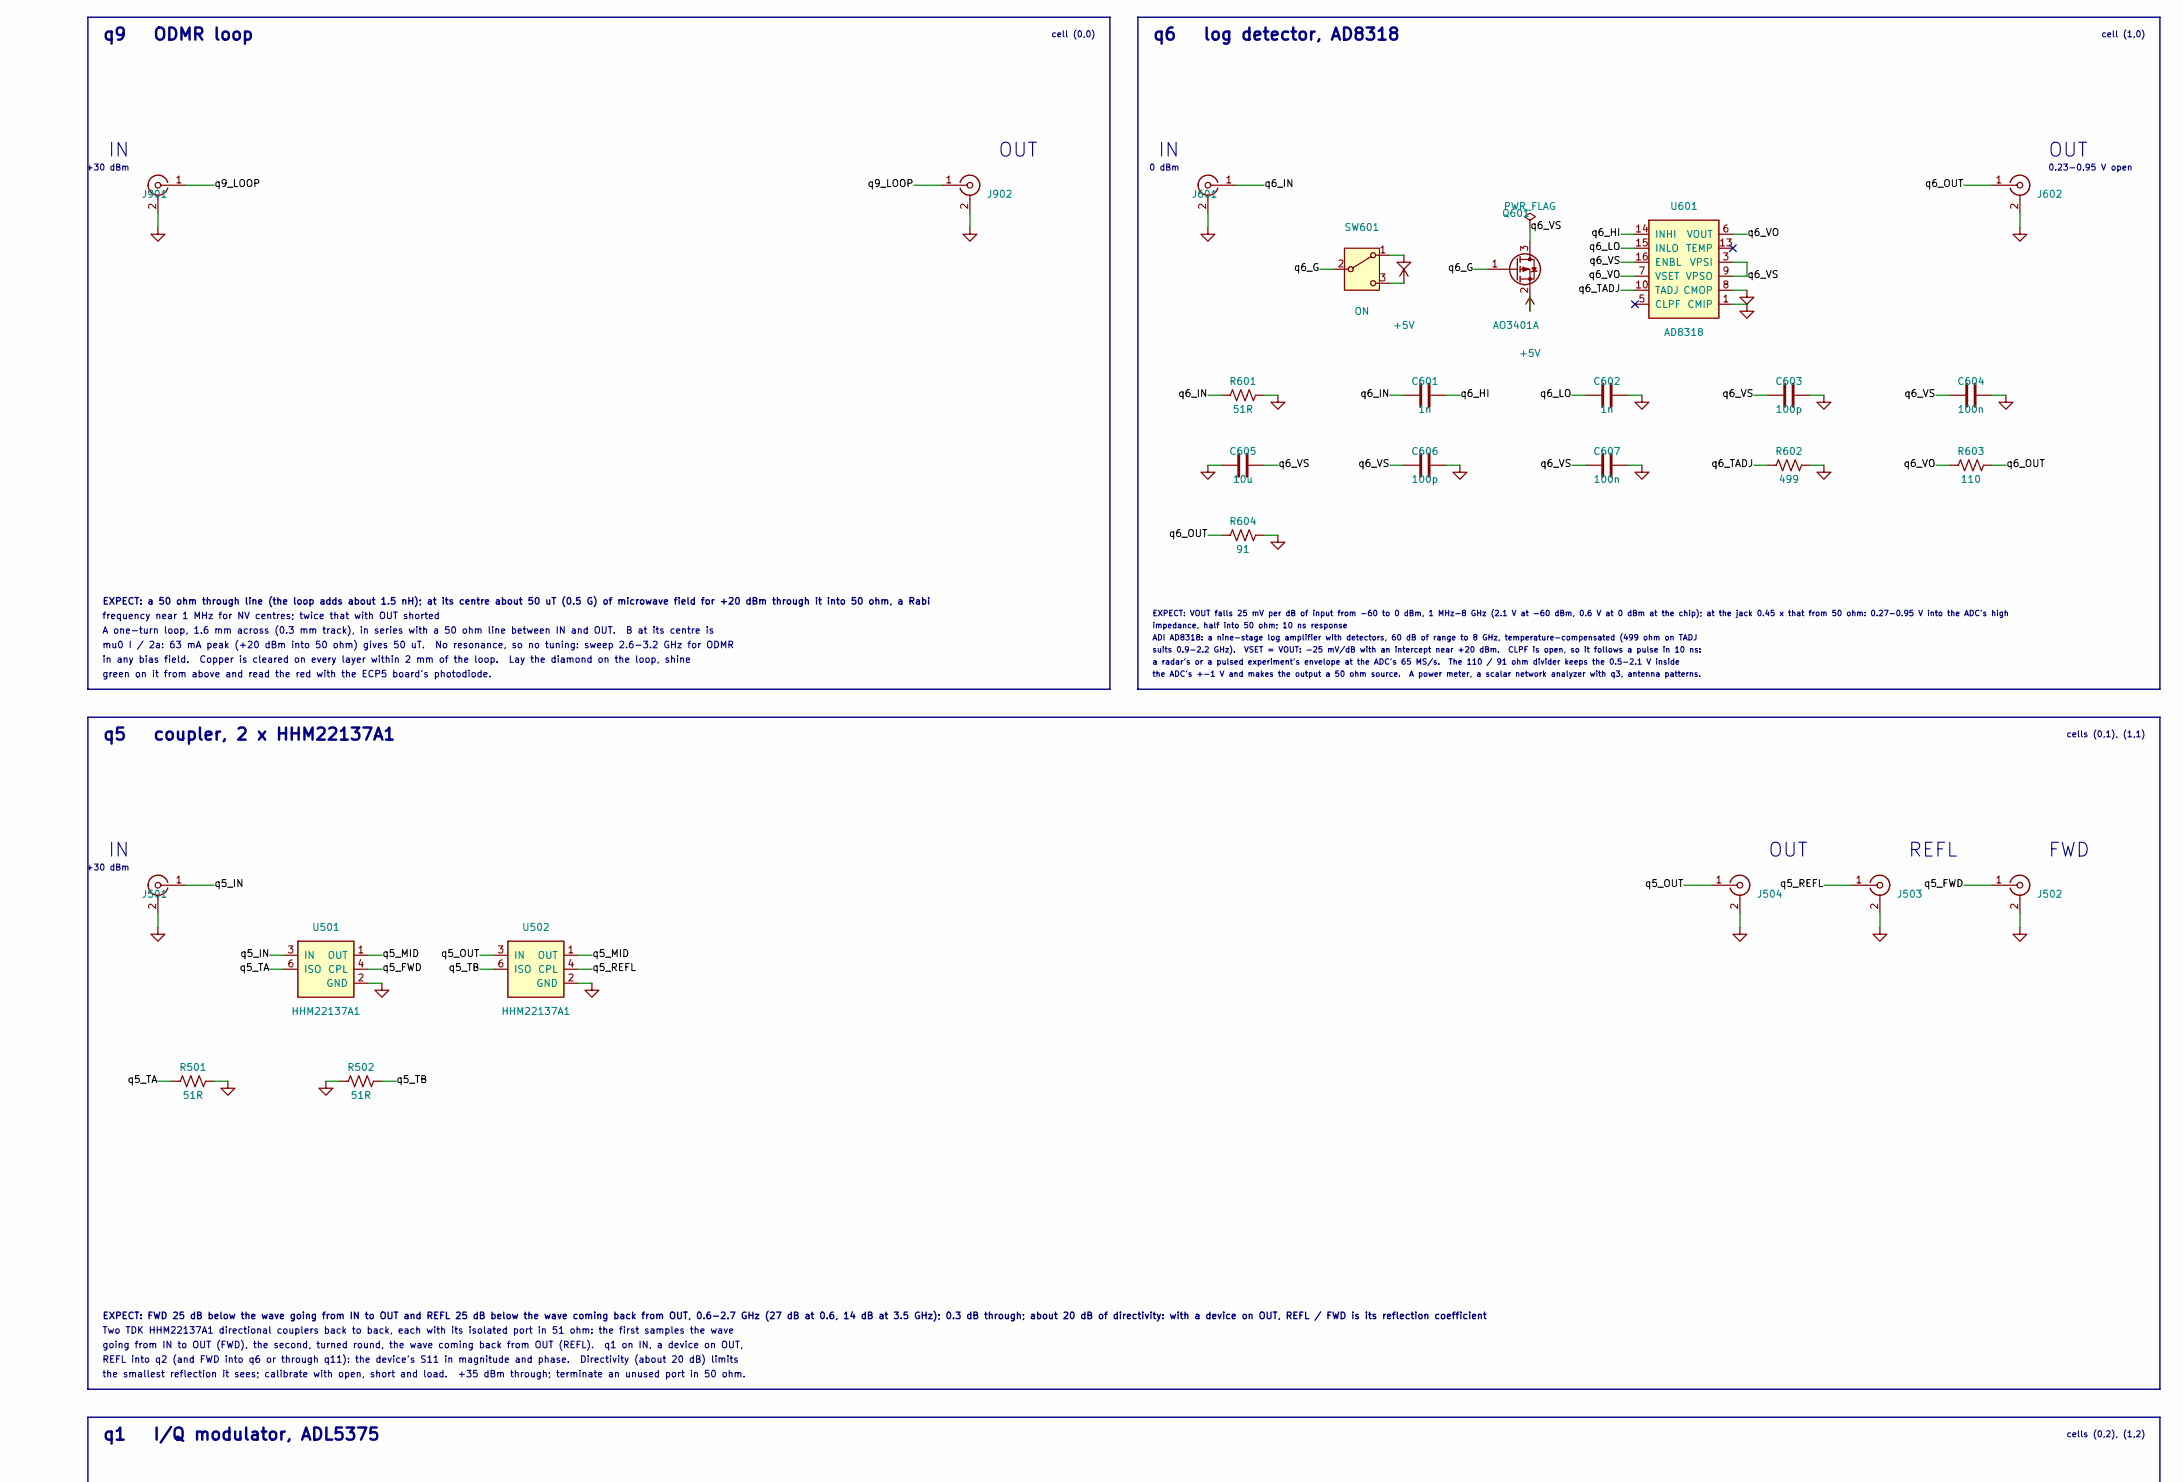
[picture p228: schematic iq_mod.kicad_sch, IQ-MOD: coherent I/Q and microwave physics, part in row 1, column 1]

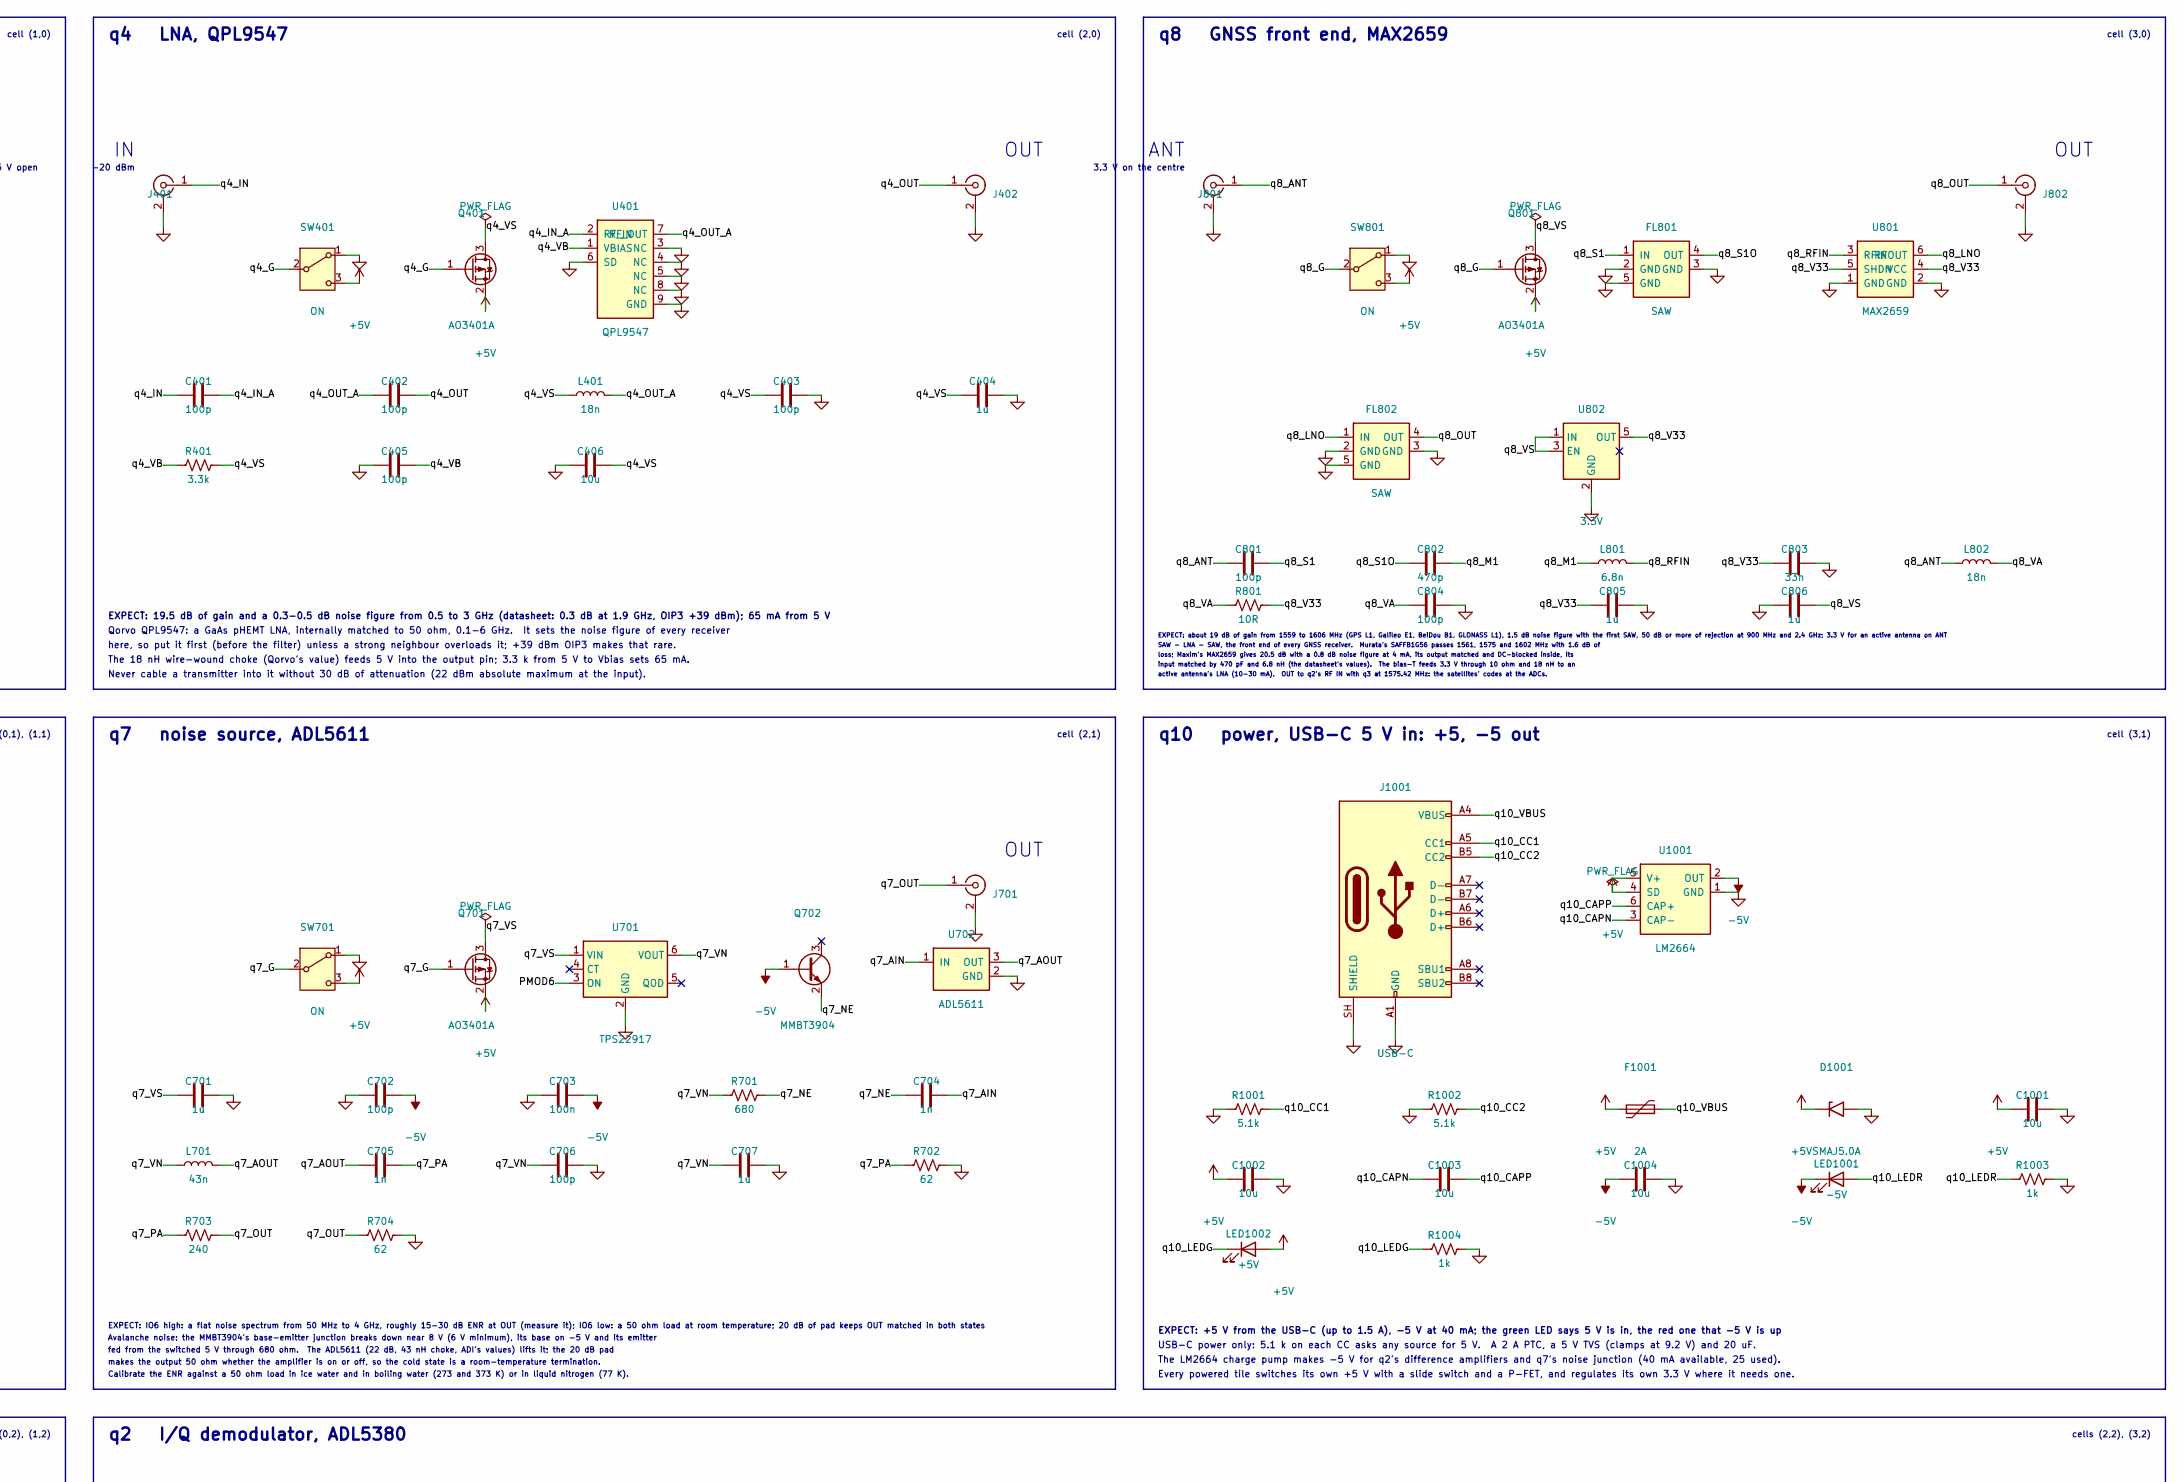
[picture p229: schematic iq_mod.kicad_sch, IQ-MOD: coherent I/Q and microwave physics, part in row 1, column 2]

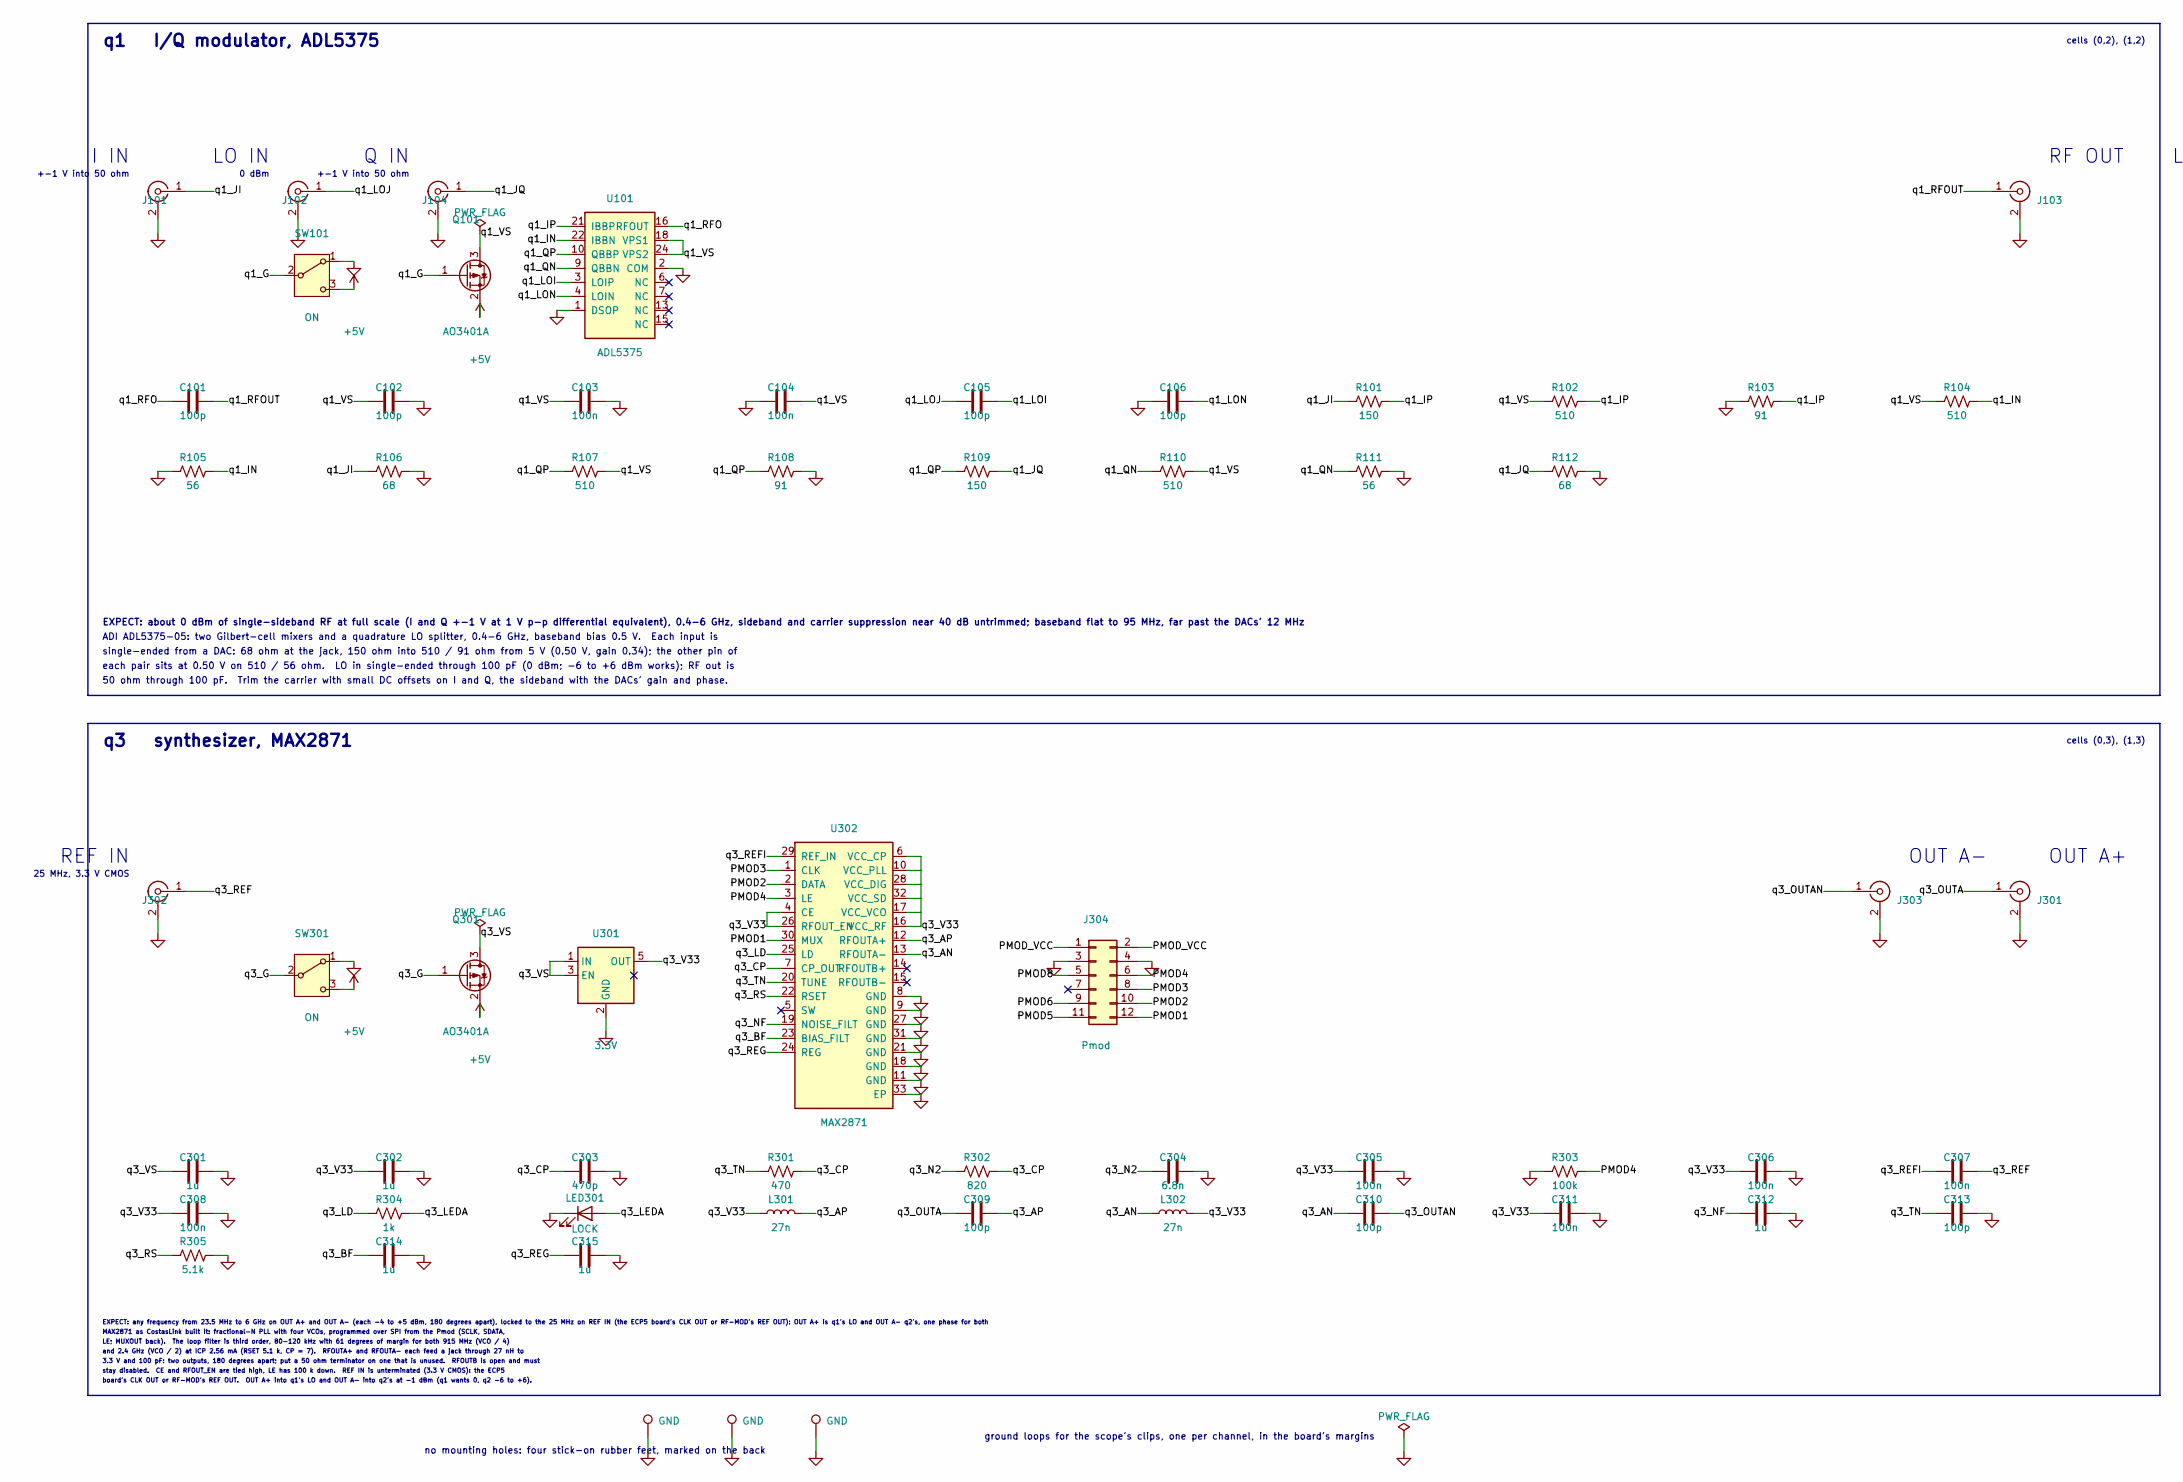
[picture p230: schematic iq_mod.kicad_sch, IQ-MOD: coherent I/Q and microwave physics, part in row 2, column 1]

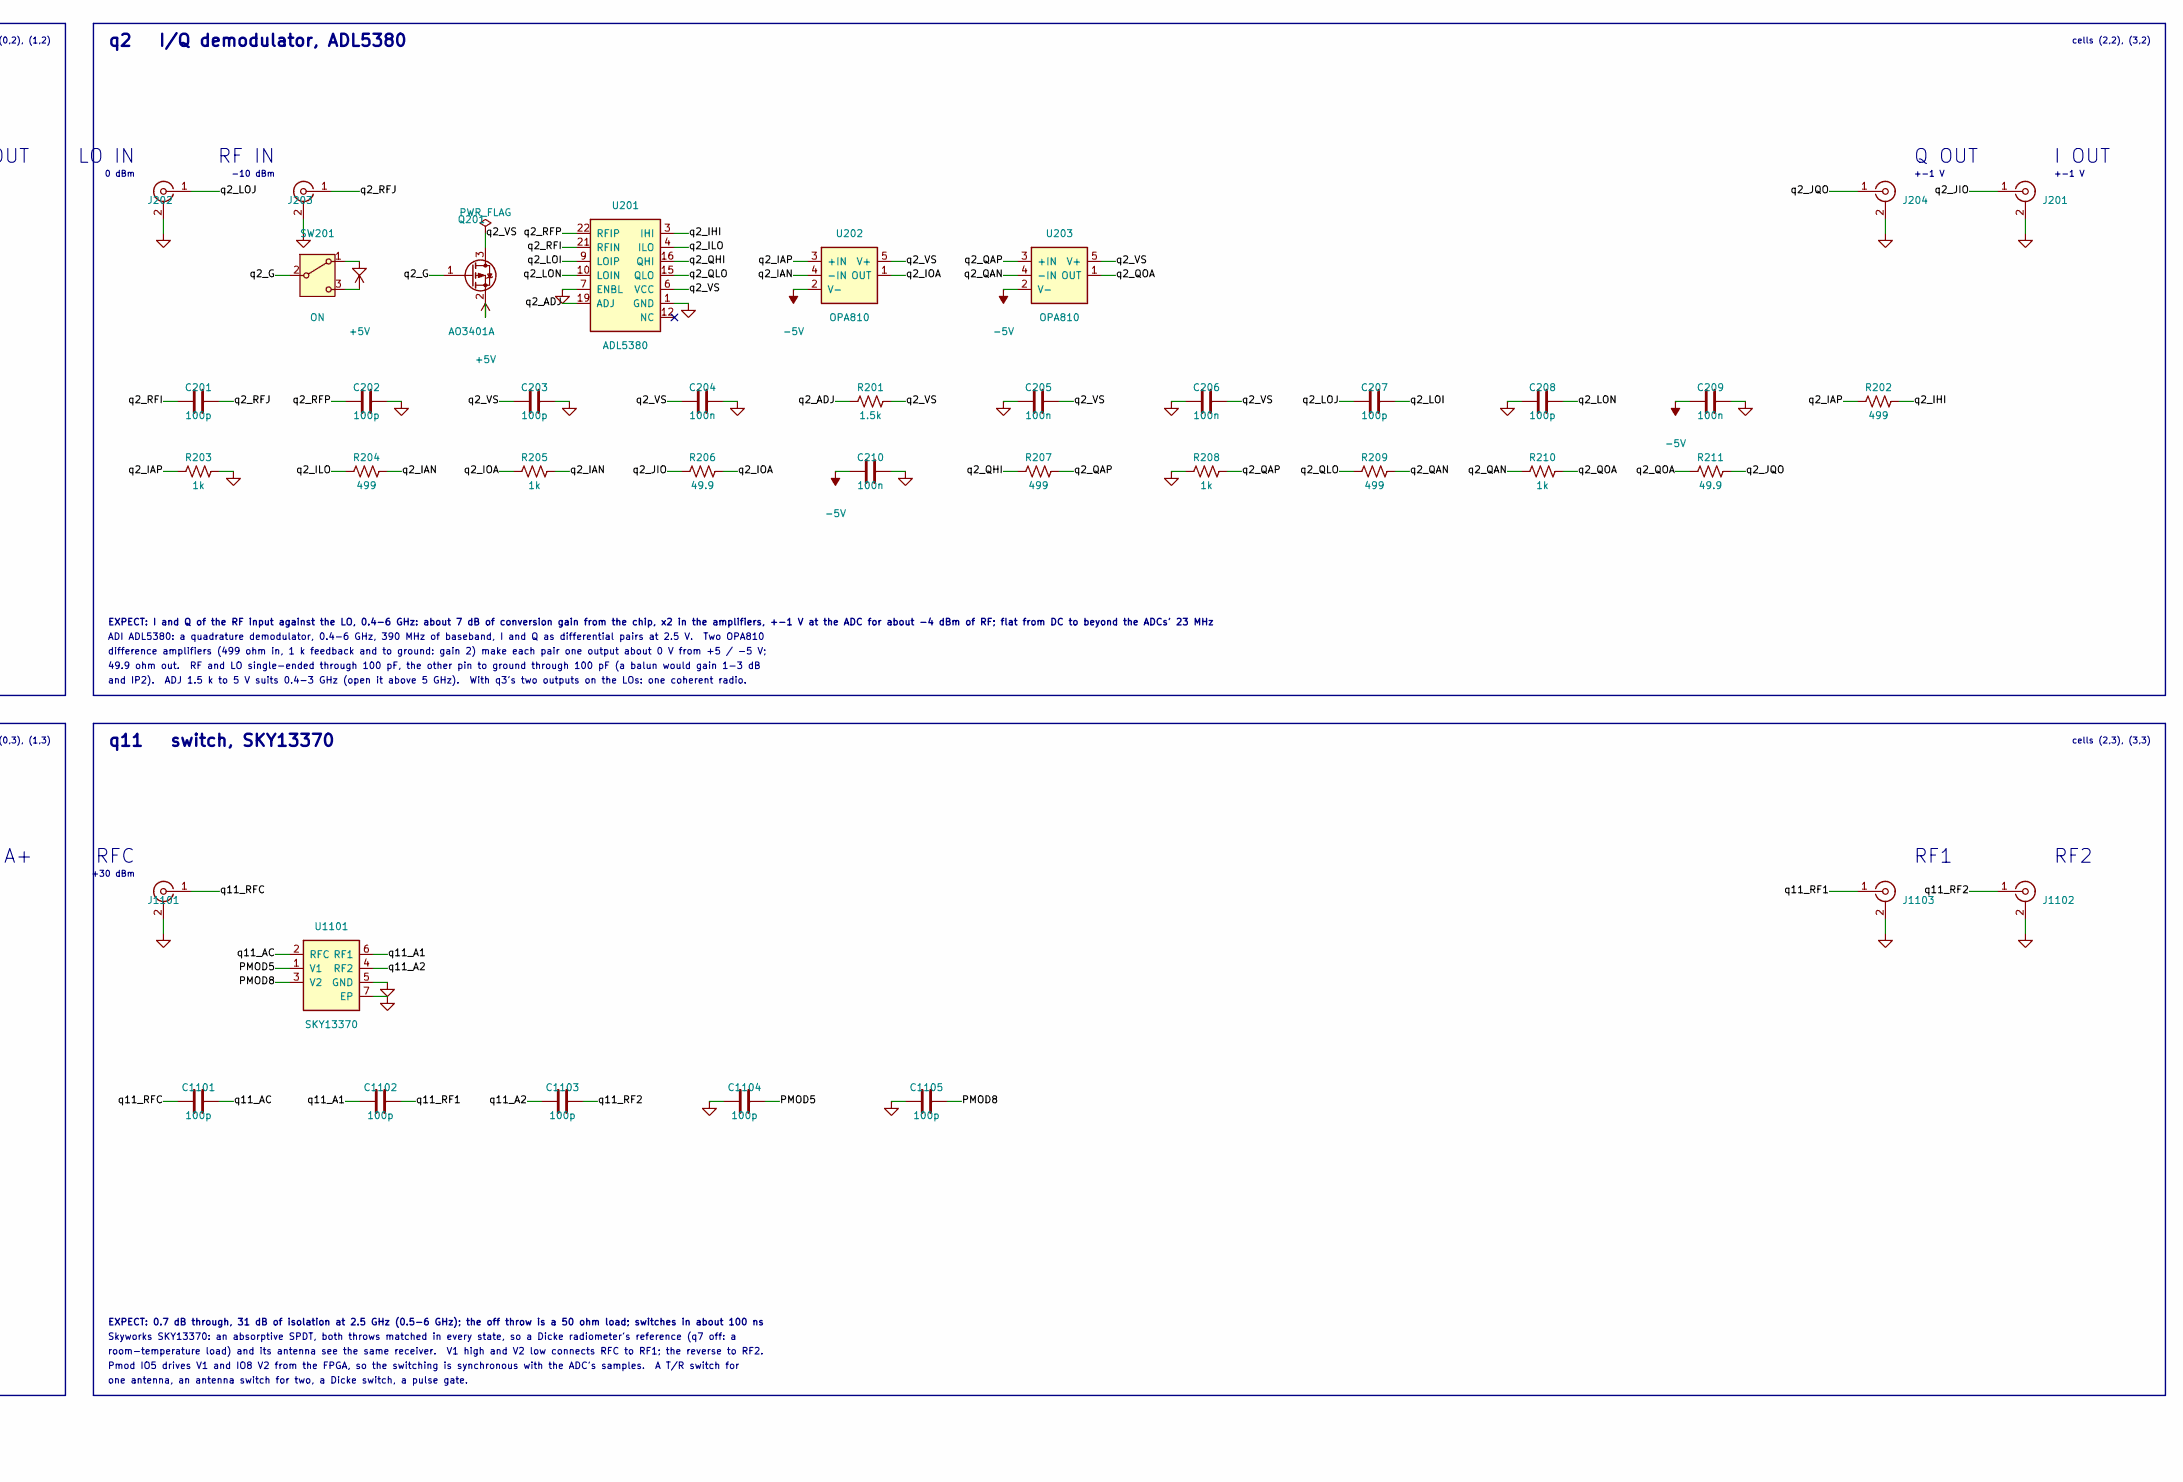
[picture p231: schematic iq_mod.kicad_sch, IQ-MOD: coherent I/Q and microwave physics, part in row 2, column 2]

Parts:
C101, C102, C105, C106, C201, C202, C203, C207, C208, C309, C310, C401, C402, C403, C405, C603, C606, C702, C706, C801, C804, C1101, C1102, C1103, C1104, C1105: 100p; C_0402_1005Metric; MPN 0402CG101J500NT; LCSC C1546
C103, C104, C204, C205, C206, C209, C210, C305, C306, C307, C308, C311, C604, C607, C703: 100n; C_0402_1005Metric; MPN CL05B104KO5NNNC; LCSC C1525
C301, C302: 1u; C_0805_2012Metric; MPN CL21B105KBFNNNE; LCSC C28323
C303: 470p; C_0603_1608Metric; MPN 0603CG471J500NT; LCSC C36252
C304: 6.8n; C_0603_1608Metric; MPN GRM1885C1H682JA01D; LCSC C162241
C312, C314, C315, C404, C701, C707, C805, C806: 1u; C_0402_1005Metric; MPN CL05A105KP5NNNC; LCSC C14445
C313: 100p; C_0603_1608Metric; MPN CL10C101JB8NNNC; LCSC C14858
C406, C605, C1001, C1002, C1003, C1004: 10u; C_0805_2012Metric; MPN CL21A106KAYNNNE; LCSC C15850
C601, C602, C704, C705: 1n; C_0402_1005Metric; MPN 0402B102K500NT; LCSC C1523
C802: 470p; C_0402_1005Metric; MPN 0402CG471J500NT; LCSC C75274
C803: 33n; C_0402_1005Metric; MPN FCC0402B333K500AT; LCSC C7419416
D1001: SMAJ5.0A; D_SMA; MPN SMAJ5.0A; LCSC C78401
F1001: 2A; Fuse_1812_4532Metric; MPN MF-MSMF200-2; LCSC C210837
FL801, FL802: SAW; Filter_SAW_1109-5P_SAFFB1G56; MPN SAFFB1G56KB0F0AR1X; LCSC C91647
J101, J102, J103, J104, J201, J202, J203, J204, J301, J302, J303, J401, J402, J501, J502, J503, J504, J601, J602, J701, J801, J802, J901, J902, J1101, J1102, J1103: SMA; SMA_BWSMA-KE-Z001_Vertical; MPN BWSMA-KE-Z001; LCSC C496549
J304: Pmod; PinHeader_2x06_P2.54mm_Horizontal_PZ254R-12-12P; MPN PZ254R-12-12P; LCSC C492434
J1001: USB-C; USB_C_Receptacle_HRO_TYPE-C-31-M-12; MPN TYPE-C-31-M-12; LCSC C165948
L301, L302: 27n; L_0402_1005Metric; MPN LQW15AN27NG80D; LCSC C882469
L401, L802: 18n; L_0402_1005Metric; MPN LQW15AN18NG00D; LCSC C91622
L701: 43n; L_0603_1608Metric; MPN LQW18AN43NG00D; LCSC C113126
L801: 6.8n; L_0402_1005Metric; MPN LQW15AN6N8G00D; LCSC C82919
LED301: LOCK; LED_0805_2012Metric_Kbar; MPN NCD0805R1; LCSC C84256
LED1001: -5V; LED_0805_2012Metric_Kbar; MPN NCD0805R1; LCSC C84256
LED1002: +5V; LED_0805_2012Metric_Kbar; MPN KT-0805G; LCSC C2297
Q101, Q201, Q301, Q401, Q601, Q701, Q801: AO3401A; SOT-23; MPN AO3401A; LCSC C15127
Q702: MMBT3904; SOT-23; MPN MMBT3904(RANGE:100-300); LCSC C20526
R101, R109: 150; R_0402_1005Metric; MPN 0402WGF1500TCE; LCSC C25082
R102, R104, R107, R110: 510; R_0402_1005Metric; MPN 0402WGF5100TCE; LCSC C25123
R103, R108, R604: 91; R_0402_1005Metric; MPN 0402WGF910JTCE; LCSC C270574
R105, R111: 56; R_0402_1005Metric; MPN 0402WGF560JTCE; LCSC C25127
R106, R112: 68; R_0402_1005Metric; MPN 0402WGF680JTCE; LCSC C25131
R201: 1.5k; R_0402_1005Metric; MPN 0402WGF1501TCE; LCSC C25867
R202, R204, R207, R209, R602: 499; R_0402_1005Metric; MPN 0402WGF4990TCE; LCSC C4125
R203, R205, R208, R210, R304: 1k; R_0402_1005Metric; MPN 0402WGF1001TCE; LCSC C11702
R206, R211: 49.9; R_0402_1005Metric; MPN CRCW040249R9FKEDHP; LCSC C844112
R301: 470; R_0402_1005Metric; MPN 0402WGF4700TCE; LCSC C25117
R302: 820; R_0402_1005Metric; MPN 0402WGF8200TCE; LCSC C25135
R303: 100k; R_0402_1005Metric; MPN 0402WGF1003TCE; LCSC C25741
R305: 5.1k; R_0402_1005Metric; MPN 0402WGF5101TCE; LCSC C25905
R401: 3.3k; R_0402_1005Metric; MPN 0402WGF3301TCE; LCSC C25890
R501, R502, R601: 51R; R_0402_1005Metric; MPN 0402WGF510JTCE; LCSC C25125
R603: 110; R_0402_1005Metric; MPN 0402WGF1100TCE; LCSC C25078
R701: 680; R_0402_1005Metric; MPN 0402WGF6800TCE; LCSC C25130
R702, R704: 62; R_0402_1005Metric; MPN 0402WGF620JTCE; LCSC C4962
R703: 240; R_0402_1005Metric; MPN 0402WGF2400TCE; LCSC C25094
R801: 10R; R_0402_1005Metric; MPN 0402WGF100JTCE; LCSC C25077
R1001, R1002: 5.1k; R_0805_2012Metric; MPN 0805W8F5101T5E; LCSC C27834
R1003, R1004: 1k; R_0805_2012Metric; MPN 0805W8F1001T5E; LCSC C17513
SW101, SW201, SW301, SW401, SW601, SW701, SW801: ON; SW_SPDT_Shouhan_MSK12C02; MPN MSK12C02; LCSC C431540
TP9901, TP9902, TP9903: GND; TestPoint_Loop_RH-5019; MPN RH-5019; LCSC C5199800
U101: ADL5375; QFN-24-1EP_4x4mm_P0.5mm_EP2.5x2.5mm; MPN ADL5375-05ACPZ-R7; LCSC C579150
U201: ADL5380; QFN-24-1EP_4x4mm_P0.5mm_EP2.5x2.5mm; MPN ADL5380ACPZ-R7; LCSC C579152
U202, U203: OPA810; SOT-23-5; MPN OPA810IDBVR; LCSC C2833513
U301, U802: 3.3V; SOT-23-5; MPN TPS7A2033PDBVR; LCSC C2862740
U302: MAX2871; QFN-32-1EP_5x5mm_P0.5mm_EP3.1x3.1mm; MPN MAX2871ETJ+T; LCSC C7458627
U401: QPL9547; DFN-8-1EP_2x2mm_P0.5mm_EP0.9x1.6mm; MPN QPL9547TR7; LCSC C5367093
U501, U502: HHM22137A1; Coupler_1608-6P_HHM22137A1; MPN HHM22137A1; LCSC C415328
U601: AD8318; QFN-16-1EP_4x4mm_P0.65mm_EP2.1x2.1mm; MPN AD8318ACPZ-REEL7; LCSC C578694
U701: TPS22917; SOT-23-6; MPN TPS22917DBVR; LCSC C2681320
U702: ADL5611; SOT-89-3; MPN ADL5611ARKZ-R7; LCSC C208262
U801: MAX2659; UDFN-6_1.5x1.0mm_P0.5mm_MAX2659; MPN MAX2659ELT+T; LCSC C28043
U1001: LM2664; SOT-23-6; MPN LM2664M6X/NOPB; LCSC C108573
U1101: SKY13370; DFN-6-1EP_1.5x1.5mm_P0.5mm_SKY13370; MPN SKY13370-374LF; LCSC C105628

Connections:
+5V: C1001.1, C1002.1, D1001.1 (A1), F1001.1, LED1002.2 (A), Q101.2 (S), Q201.2 (S), Q301.2 (S), Q401.2 (S), Q601.2 (S), Q701.2 (S), Q801.2 (S), SW101.3 (C), SW201.3 (C), SW301.3 (C), SW401.3 (C), SW601.3 (C), SW701.3 (C), SW801.3 (C), U1001.4 (SD), U1001.5 (V+)
-5V: C209.1, C210.1, C702.2, C703.2, C1004.1, LED1001.1 (K), Q702.1 (B), U202.2 (V-), U203.2 (V-), U1001.2 (OUT)
/PMOD1: J304.12, U302.30 (MUX)
/PMOD2: J304.10, U302.2 (DATA)
/PMOD3: J304.8, U302.1 (CLK)
/PMOD4: J304.6, R303.2, U302.3 (LE)
/PMOD5: C1104.2, J304.11, U1101.1 (V1)
/PMOD6: J304.9, U701.3 (ON)
/PMOD8: C1105.2, J304.5, U1101.3 (V2)
/PMOD_VCC: J304.1, J304.2
/q1_G: Q101.1 (G), SW101.2 (B)
/q1_IN: R104.2, R105.2, U101.22 (IBBN)
/q1_IP: R101.2, R102.2, R103.2, U101.21 (IBBP)
/q1_JI: J101.1 (In), R101.1, R106.1
/q1_JQ: J104.1 (In), R109.2, R112.1
/q1_LOI: C105.2, U101.3 (LOIP)
/q1_LOJ: C105.1, J102.1 (In)
/q1_LON: C106.2, U101.4 (LOIN)
/q1_QN: R110.1, R111.1, U101.9 (QBBN)
/q1_QP: R107.1, R108.1, R109.1, U101.10 (QBBP)
/q1_RFO: C101.1, U101.16 (RFOUT)
/q1_RFOUT: C101.2, J103.1 (In)
/q1_VS: C102.1, C103.1, C104.2, Q101.3 (D), R102.1, R104.1, R107.2, R110.2, U101.18 (VPS1), U101.24 (VPS2)
/q2_ADJ: R201.1, U201.19 (ADJ)
/q2_G: Q201.1 (G), SW201.2 (B)
/q2_IAN: R204.2, R205.2, U202.4 (-IN)
/q2_IAP: R202.1, R203.1, U202.3 (+IN)
/q2_IHI: R202.2, U201.3 (IHI)
/q2_ILO: R204.1, U201.4 (ILO)
/q2_IOA: R205.1, R206.2, U202.1 (OUT)
/q2_JIO: J201.1 (In), R206.1
/q2_JQO: J204.1 (In), R211.2
/q2_LOI: C207.2, U201.9 (LOIP)
/q2_LOJ: C207.1, J202.1 (In)
/q2_LON: C208.2, U201.10 (LOIN)
/q2_QAN: R209.2, R210.1, U203.4 (-IN)
/q2_QAP: R207.2, R208.2, U203.3 (+IN)
/q2_QHI: R207.1, U201.16 (QHI)
/q2_QLO: R209.1, U201.15 (QLO)
/q2_QOA: R210.2, R211.1, U203.1 (OUT)
/q2_RFI: C201.1, U201.21 (RFIN)
/q2_RFJ: C201.2, J203.1 (In)
/q2_RFP: C202.1, U201.22 (RFIP)
/q2_VS: C203.1, C204.1, C205.2, C206.2, Q201.3 (D), R201.2, U201.6 (VCC), U201.13 (VCC), U201.24 (VCC), U202.5 (V+), U203.5 (V+)
/q3_AN: C310.1, L302.1, U302.13 (RFOUTA-)
/q3_AP: C309.2, L301.2, U302.12 (RFOUTA+)
/q3_BF: C314.1, U302.23 (BIAS_FILT)
/q3_CP: C303.1, R301.2, R302.2, U302.7 (CP_OUT)
/q3_G: Q301.1 (G), SW301.2 (B)
/q3_LD: R304.1, U302.25 (LD)
/q3_LEDA: LED301.2 (A), R304.2
/q3_N2: C304.1, R302.1
/q3_NF: C312.1, U302.19 (NOISE_FILT)
/q3_OUTA: C309.1, J301.1 (In)
/q3_OUTAN: C310.2, J303.1 (In)
/q3_REF: C307.2, J302.1 (In)
/q3_REFI: C307.1, U302.29 (REF_IN)
/q3_REG: C315.1, U302.24 (REG)
/q3_RS: R305.1, U302.22 (RSET)
/q3_TN: C313.1, R301.1, U302.20 (TUNE)
/q3_V33: C302.1, C305.1, C306.1, C308.1, C311.1, L301.1, L302.2, U301.5 (OUT), U302.4 (CE), U302.6 (VCC_CP), U302.10 (VCC_PLL), U302.16 (VCC_RF), U302.17 (VCC_VCO), U302.26 (RFOUT_EN), U302.28 (VCC_DIG), U302.32 (VCC_SD)
/q3_VS: C301.1, Q301.3 (D), U301.1 (IN), U301.3 (EN)
/q4_G: Q401.1 (G), SW401.2 (B)
/q4_IN: C401.1, J401.1 (In)
/q4_IN_A: C401.2, U401.2 (RF_IN)
/q4_OUT: C402.2, J402.1 (In)
/q4_OUT_A: C402.1, L401.2, U401.7 (RF_OUT)
/q4_VB: C405.2, R401.1, U401.1 (VBIAS)
/q4_VS: C403.1, C404.1, C406.2, L401.1, Q401.3 (D), R401.2
/q5_FWD: J502.1 (In), U501.4 (CPL)
/q5_IN: J501.1 (In), U501.3 (IN)
/q5_MID: U501.1 (OUT), U502.1 (OUT)
/q5_OUT: J504.1 (In), U502.3 (IN)
/q5_REFL: J503.1 (In), U502.4 (CPL)
/q5_TA: R501.1, U501.6 (ISO)
/q5_TB: R502.2, U502.6 (ISO)
/q6_G: Q601.1 (G), SW601.2 (B)
/q6_HI: C601.2, U601.14 (INHI)
/q6_IN: C601.1, J601.1 (In), R601.1
/q6_LO: C602.1, U601.15 (INLO)
/q6_OUT: J602.1 (In), R603.2, R604.1
/q6_TADJ: R602.1, U601.10 (TADJ)
/q6_VO: R603.1, U601.6 (VOUT), U601.7 (VSET)
/q6_VS: C603.1, C604.1, C605.2, C606.1, C607.1, Q601.3 (D), U601.3 (VPSI), U601.4 (VPSI), U601.9 (VPSO), U601.16 (ENBL)
/q7_AIN: C704.2, U702.1 (IN)
/q7_AOUT: C705.1, L701.2, U702.3 (OUT)
/q7_G: Q701.1 (G), SW701.2 (B)
/q7_NE: C704.1, Q702.2 (E), R701.2
/q7_OUT: J701.1 (In), R703.2, R704.1
/q7_PA: C705.2, R702.1, R703.1
/q7_VN: C706.1, C707.1, L701.1, R701.1, U701.6 (VOUT)
/q7_VS: C701.1, Q701.3 (D), U701.1 (VIN)
/q8_ANT: C801.1, J801.1 (In), L802.1
/q8_G: Q801.1 (G), SW801.2 (B)
/q8_LNO: FL802.1 (IN), U801.6 (RFOUT)
/q8_M1: C802.2, L801.1
/q8_OUT: FL802.4 (OUT), J802.1 (In)
/q8_RFIN: L801.2, U801.3 (RFIN)
/q8_S1: C801.2, FL801.1 (IN)
/q8_S1O: C802.1, FL801.4 (OUT)
/q8_V33: C803.1, C805.1, R801.2, U801.4 (VCC), U801.5 (SHDN), U802.5 (OUT)
/q8_VA: C804.1, L802.2, R801.1
/q8_VS: C806.2, Q801.3 (D), U802.1 (IN), U802.3 (EN)
/q9_LOOP: J901.1 (In), J902.1 (In)
/q10_CAPN: C1003.1, U1001.3 (CAP-)
/q10_CAPP: C1003.2, U1001.6 (CAP+)
/q10_CC1: J1001.A5 (CC1), R1001.2
/q10_CC2: J1001.B5 (CC2), R1002.2
/q10_LEDG: LED1002.1 (K), R1004.1
/q10_LEDR: LED1001.2 (A), R1003.1
/q10_VBUS: F1001.2, J1001.A4 (VBUS), J1001.A9 (VBUS), J1001.B4 (VBUS), J1001.B9 (VBUS)
/q11_A1: C1102.1, U1101.6 (RF1)
/q11_A2: C1103.1, U1101.4 (RF2)
/q11_AC: C1101.2, U1101.2 (RFC)
/q11_RF1: C1102.2, J1103.1 (In)
/q11_RF2: C1103.2, J1102.1 (In)
/q11_RFC: C1101.1, J1101.1 (In)
GND: C102.2, C103.2, C104.1, C106.1, C202.2, C203.2, C204.2, C205.1, C206.1, C208.1, C209.2, C210.2, C301.2, C302.2, C303.2, C304.2, C305.2, C306.2, C308.2, C311.2, C312.2, C313.2, C314.2, C315.2, C403.2, C404.2, C405.1, C406.1, C602.2, C603.2, C604.2, C605.1, C606.2, C607.2, C701.2, C702.1, C703.1, C706.2, C707.2, C803.2, C804.2, C805.2, C806.1, C1001.2, C1002.2, C1004.2, C1104.1, C1105.1, D1001.2 (A2), FL801.2 (GND), FL801.3 (GND), FL801.5 (GND), FL802.2 (GND), FL802.3 (GND), FL802.5 (GND), J101.2 (Ext), J102.2 (Ext), J103.2 (Ext), J104.2 (Ext), J201.2 (Ext), J202.2 (Ext), J203.2 (Ext), J204.2 (Ext), J301.2 (Ext), J302.2 (Ext), J303.2 (Ext), J304.3, J304.4, J401.2 (Ext), J402.2 (Ext), J501.2 (Ext), J502.2 (Ext), J503.2 (Ext), J504.2 (Ext), J601.2 (Ext), J602.2 (Ext), J701.2 (Ext), J801.2 (Ext), J802.2 (Ext), J901.2 (Ext), J902.2 (Ext), J1001.A1 (GND), J1001.A12 (GND), J1001.B1 (GND), J1001.B12 (GND), J1001.SH (SHIELD), J1101.2 (Ext), J1102.2 (Ext), J1103.2 (Ext), LED301.1 (K), R103.1, R105.1, R106.2, R108.2, R111.2, R112.2, R203.2, R208.1, R303.1, R305.2, R501.2, R502.1, R601.2, R602.2, R604.2, R702.2, R704.2, R1001.1, R1002.1, R1003.2, R1004.2, SW101.1 (A), SW201.1 (A), SW301.1 (A), SW401.1 (A), SW601.1 (A), SW701.1 (A), SW801.1 (A), TP9901.1, TP9902.1, TP9903.1, U101.1 (DSOP), U101.2 (COM), U101.5 (COM), U101.8 (COM), U101.11 (COM), U101.12 (COM), U101.14 (COM), U101.17 (COM), U101.19 (COM), U101.20 (COM), U101.23 (COM), U101.25 (COM), U201.1 (GND), U201.2 (GND), U201.5 (GND), U201.7 (ENBL), U201.8 (GND), U201.11 (GND), U201.14 (GND), U201.17 (GND), U201.18 (GND), U201.20 (GND), U201.23 (GND), U201.25 (GND), U301.2 (GND), U302.8 (GND), U302.9 (GND), U302.11 (GND), U302.18 (GND), U302.21 (GND), U302.27 (GND), U302.31 (GND), U302.33 (EP), U401.3 (NC), U401.4 (NC), U401.5 (NC), U401.6 (SD), U401.8 (NC), U401.9 (GND), U501.2 (GND), U501.5 (GND), U502.2 (GND), U502.5 (GND), U601.1 (CMIP), U601.2 (CMIP), U601.8 (CMOP), U601.11 (CMIP), U601.12 (CMIP), U601.17 (CMIP), U701.2 (GND), U702.2 (GND), U801.1 (GND), U801.2 (GND), U802.2 (GND), U1001.1 (GND), U1101.5 (GND), U1101.7 (EP)

Notes on the sheet:
+30 dBm
OUT
SAW - LNA - SAW, the front end of every GNSS receiver. Murata's SAFFB1G56 passes 1561, 1575 and 1602 MHz with 1.6 dB of
Q IN
cells (2,2), (3,2)
active antenna's LNA (10-30 mA). OUT to q2's RF IN with q3 at 1575.42 MHz: the satellites' codes at the ADCs.
MAX2871 as CostasLink built it: fractional-N PLL with four VCOs, programmed over SPI from the Pmod (SCLK, SDATA,
one antenna, an antenna switch for two, a Dicke switch, a pulse gate.
cell (2,1)
the ADC's +-1 V and makes the output a 50 ohm source. A power meter, a scalar network analyzer with q3, antenna patterns.
0.23-0.95 V open
OUT A-
cell (2,0)
0 dBm
3.3 V and 100 pF: two outputs, 180 degrees apart; put a 50 ohm terminator on one that is unused. RFOUTB is open and must
LE; MUXOUT back). The loop filter is third order, 80-120 kHz with 61 degrees of margin for both 915 MHz (VCO / 4)
+-1 V into 50 ohm
EXPECT: a 50 ohm through line (the loop adds about 1.5 nH); at its centre about 50 uT (0.5 G) of microwave field for +20 dBm through it into 50 ohm, a Rabi
The 18 nH wire-wound choke (Qorvo's value) feeds 5 V into the output pin; 3.3 k from 5 V to Vbias sets 65 mA.
+-1 V
q11 switch, SKY13370
green on it from above and read the red with the ECP5 board's photodiode.
and IP2). ADJ 1.5 k to 5 V suits 0.4-3 GHz (open it above 5 GHz). With q3's two outputs on the LOs: one coherent radio.
difference amplifiers (499 ohm in, 1 k feedback and to ground: gain 2) make each pair one output about 0 V from +5 / -5 V;
I IN
board's CLK OUT or RF-MOD's REF OUT. OUT A+ into q1's LO and OUT A- into q2's at -1 dBm (q1 wants 0, q2 -6 to +6).
frequency near 1 MHz for NV centres; twice that with OUT shorted
RF OUT
RF IN
q2 I/Q demodulator, ADL5380
impedance, half into 50 ohm; 10 ns response
49.9 ohm out. RF and LO single-ended through 100 pF, the other pin to ground through 100 pF (a balun would gain 1-3 dB
25 MHz, 3.3 V CMOS
q9 ODMR loop
EXPECT: +5 V from the USB-C (up to 1.5 A), -5 V at 40 mA; the green LED says 5 V is in, the red one that -5 V is up
REF IN
cells (2,3), (3,3)
RF2
A one-turn loop, 1.6 mm across (0.3 mm track), in series with a 50 ohm line between IN and OUT. B at its centre is
Never cable a transmitter into it without 30 dB of attenuation (22 dBm absolute maximum at the input).
each pair sits at 0.50 V on 510 / 56 ohm. LO in single-ended through 100 pF (0 dBm; -6 to +6 dBm works); RF out is
USB-C power only: 5.1 k on each CC asks any source for 5 V. A 2 A PTC, a 5 V TVS (clamps at 9.2 V) and 20 uF.
q5 coupler, 2 x HHM22137A1
q7 noise source, ADL5611
3.3 V on the centre
q4 LNA, QPL9547
Qorvo QPL9547: a GaAs pHEMT LNA, internally matched to 50 ohm, 0.1-6 GHz. It sets the noise figure of every receiver
ADI ADL5380: a quadrature demodulator, 0.4-6 GHz, 390 MHz of baseband, I and Q as differential pairs at 2.5 V. Two OPA810
room-temperature load) and its antenna see the same receiver. V1 high and V2 low connects RFC to RF1; the reverse to RF2.
q10 power, USB-C 5 V in: +5, -5 out
cells (0,3), (1,3)
ground loops for the scope's clips, one per channel, in the board's margins
EXPECT: 19.5 dB of gain and a 0.3-0.5 dB noise figure from 0.5 to 3 GHz (datasheet: 0.3 dB at 1.9 GHz, OIP3 +39 dBm); 65 mA from 5 V
EXPECT: about 0 dBm of single-sideband RF at full scale (I and Q +-1 V at 1 V p-p differential equivalent), 0.4-6 GHz, sideband and carrier suppression near 40 dB untrimmed; baseband flat to 95 MHz, far past the DACs' 12 MHz
EXPECT: I and Q of the RF input against the LO, 0.4-6 GHz: about 7 dB of conversion gain from the chip, x2 in the amplifiers, +-1 V at the ADC for about -4 dBm of RF; flat from DC to beyond the ADCs' 23 MHz
EXPECT: FWD 25 dB below the wave going from IN to OUT and REFL 25 dB below the wave coming back from OUT, 0.6-2.7 GHz (27 dB at 0.6, 14 dB at 3.5 GHz); 0.3 dB through; about 20 dB of directivity: with a device on OUT, REFL / FWD is its reflection coefficient
no mounting holes: four stick-on rubber feet, marked on the back
Every powered tile switches its own +5 V with a slide switch and a P-FET, and regulates its own 3.3 V where it needs one.
q3 synthesizer, MAX2871
single-ended from a DAC: 68 ohm at the jack, 150 ohm into 510 / 91 ohm from 5 V (0.50 V, gain 0.34); the other pin of
REFL
RF1
in any bias field. Copper is cleared on every layer within 2 mm of the loop. Lay the diamond on the loop, shine
going from IN to OUT (FWD), the second, turned round, the wave coming back from OUT (REFL). q1 on IN, a device on OUT,
OUT A+
fed from the switched 5 V through 680 ohm. The ADL5611 (22 dB, 43 nH choke, ADI's values) lifts it; the 20 dB pad
ANT
a radar's or a pulsed experiment's envelope at the ADC's 65 MS/s. The 110 / 91 ohm divider keeps the 0.5-2.1 V inside
50 ohm through 100 pF. Trim the carrier with small DC offsets on I and Q, the sideband with the DACs' gain and phase.
EXPECT: VOUT falls 25 mV per dB of input from -60 to 0 dBm, 1 MHz-8 GHz (2.1 V at -60 dBm, 0.6 V at 0 dBm at the chip); at the jack 0.45 x that from 50 ohm: 0.27-0.95 V into the ADC's high
Skyworks SKY13370: an absorptive SPDT, both throws matched in every state, so a Dicke radiometer's reference (q7 off: a
input matched by 470 pF and 6.8 nH (the datasheet's values). The bias-T feeds 3.3 V through 10 ohm and 18 nH to an
Q OUT
EXPECT: 0.7 dB through, 31 dB of isolation at 2.5 GHz (0.5-6 GHz); the off throw is a 50 ohm load; switches in about 100 ns
-20 dBm
LO IN
ADI AD8318: a nine-stage log amplifier with detectors, 60 dB of range to 8 GHz, temperature-compensated (499 ohm on TADJ
q6 log detector, AD8318
here, so put it first (before the filter) unless a strong neighbour overloads it; +39 dBm OIP3 makes that rare.
cell (0,0)
REFL into q2 (and FWD into q6 or through q11): the device's S11 in magnitude and phase. Directivity (about 20 dB) limits
loss; Maxim's MAX2659 gives 20.5 dB with a 0.8 dB noise figure at 4 mA, its output matched and DC-blocked inside, its
makes the output 50 ohm whether the amplifier is on or off, so the cold state is a room-temperature termination.
ADI ADL5375-05: two Gilbert-cell mixers and a quadrature LO splitter, 0.4-6 GHz, baseband bias 0.5 V. Each input is
EXPECT: any frequency from 23.5 MHz to 6 GHz on OUT A+ and OUT A- (each -4 to +5 dBm, 180 degrees apart), locked to the 25 MHz on REF IN (the ECP5 board's CLK OUT or RF-MOD's REF OUT): OUT A+ is q1's LO and OUT A- q2's, one phase for both
suits 0.9-2.2 GHz). VSET = VOUT: -25 mV/dB with an intercept near +20 dBm. CLPF is open, so it follows a pulse in 10 ns:
-10 dBm
the smallest reflection it sees; calibrate with open, short and load. +35 dBm through; terminate an unused port in 50 ohm.
cell (3,0)
I OUT
and 2.4 GHz (VCO / 2) at ICP 2.56 mA (RSET 5.1 k, CP = 7). RFOUTA+ and RFOUTA- each feed a jack through 27 nH to
The LM2664 charge pump makes -5 V for q2's difference amplifiers and q7's noise junction (40 mA available, 25 used).
q8 GNSS front end, MAX2659
Calibrate the ENR against a 50 ohm load in ice water and in boiling water (273 and 373 K) or in liquid nitrogen (77 K).
cells (0,1), (1,1)
Two TDK HHM22137A1 directional couplers back to back, each with its isolated port in 51 ohm: the first samples the wave
cell (1,0)
RFC
stay disabled. CE and RFOUT_EN are tied high, LE has 100 k down. REF IN is unterminated (3.3 V CMOS): the ECP5
q1 I/Q modulator, ADL5375
cells (0,2), (1,2)
Avalanche noise: the MMBT3904's base-emitter junction breaks down near 8 V (6 V minimum), its base on -5 V and its emitter
mu0 I / 2a: 63 mA peak (+20 dBm into 50 ohm) gives 50 uT. No resonance, so no tuning: sweep 2.6-3.2 GHz for ODMR
cell (3,1)
EXPECT: about 19 dB of gain from 1559 to 1606 MHz (GPS L1, Galileo E1, BeiDou B1, GLONASS L1), 1.5 dB noise figure with the first SAW, 50 dB or more of rejection at 900 MHz and 2.4 GHz; 3.3 V for an active antenna on ANT
FWD
EXPECT: IO6 high: a flat noise spectrum from 50 MHz to 4 GHz, roughly 15-30 dB ENR at OUT (measure it); IO6 low: a 50 ohm load at room temperature; 20 dB of pad keeps OUT matched in both states
Pmod IO5 drives V1 and IO8 V2 from the FPGA, so the switching is synchronous with the ADC's samples. A T/R switch for
