gallicchio/AMOD-and-RFMOD/hardware/iq_mod.kicad_pcb

## KiCad design hardware/iq_mod.kicad_pcb (continued)

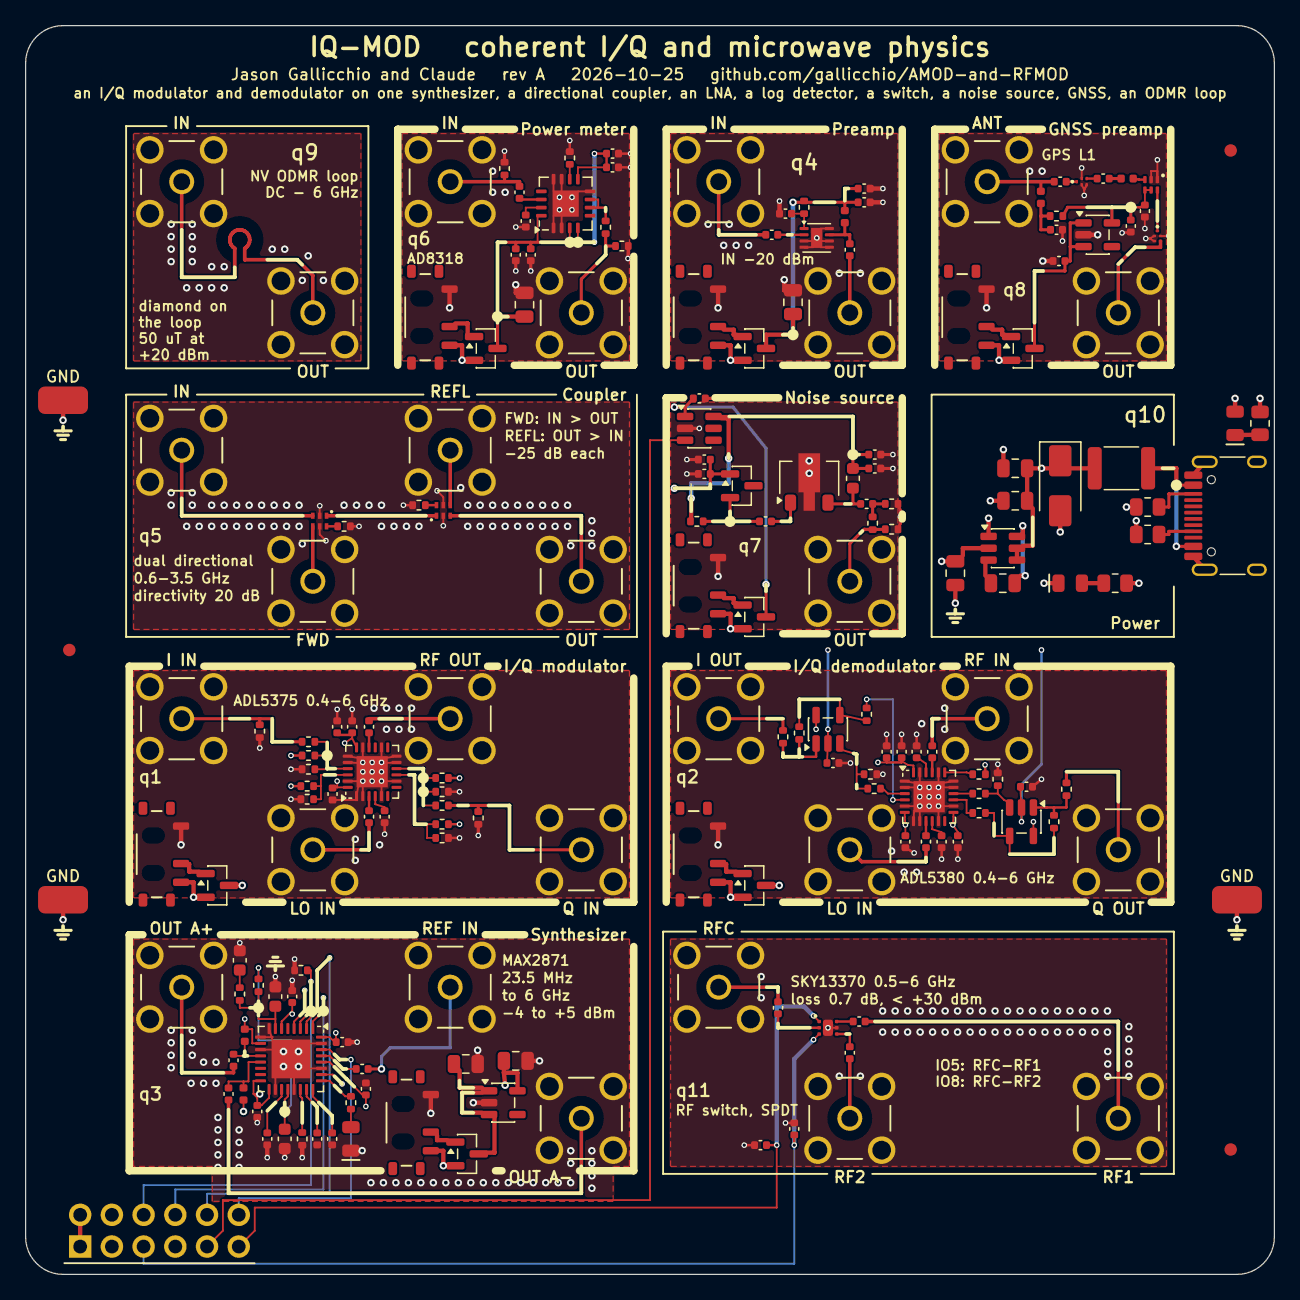
[picture p232: board iq_mod.kicad_pcb from above]

Board: 4 copper layers, 100.0 x 100.0 mm, 186 parts (0 on the bottom side), 118 nets.
