gallicchio/AMOD-and-RFMOD/hardware/amod_n.kicad_pcb

## KiCad design hardware/amod_n.kicad_pcb (2026-10-30)

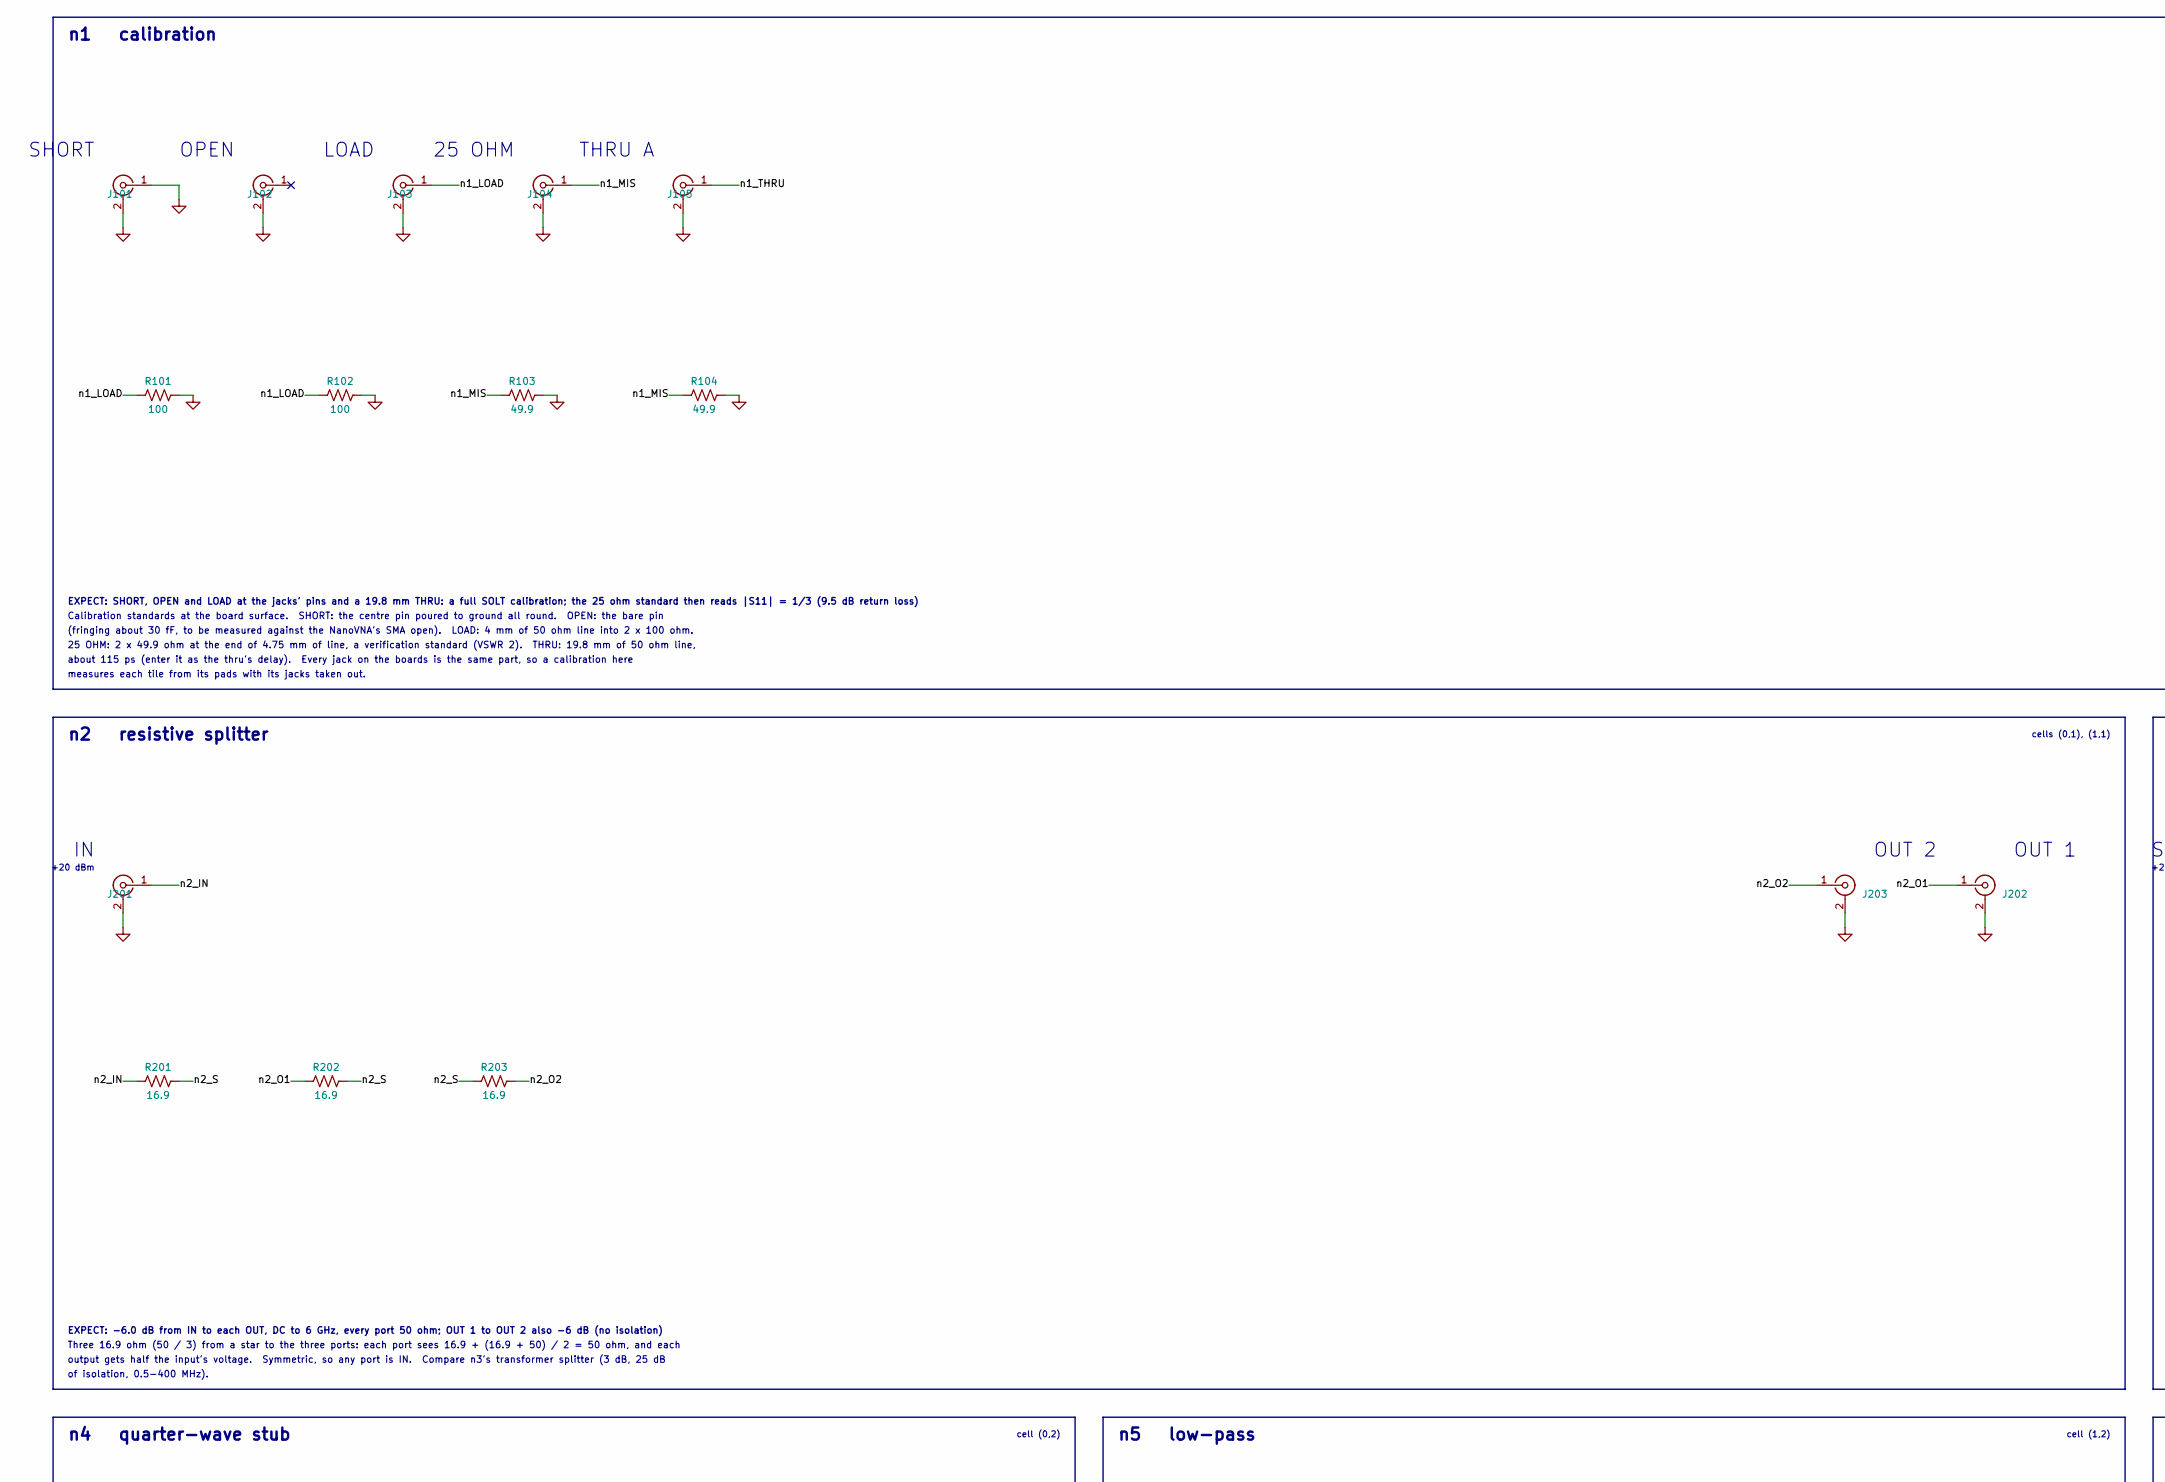
[picture p233: schematic amod_n.kicad_sch, AMOD-N: passive RF and analog blocks, part in row 1, column 1]

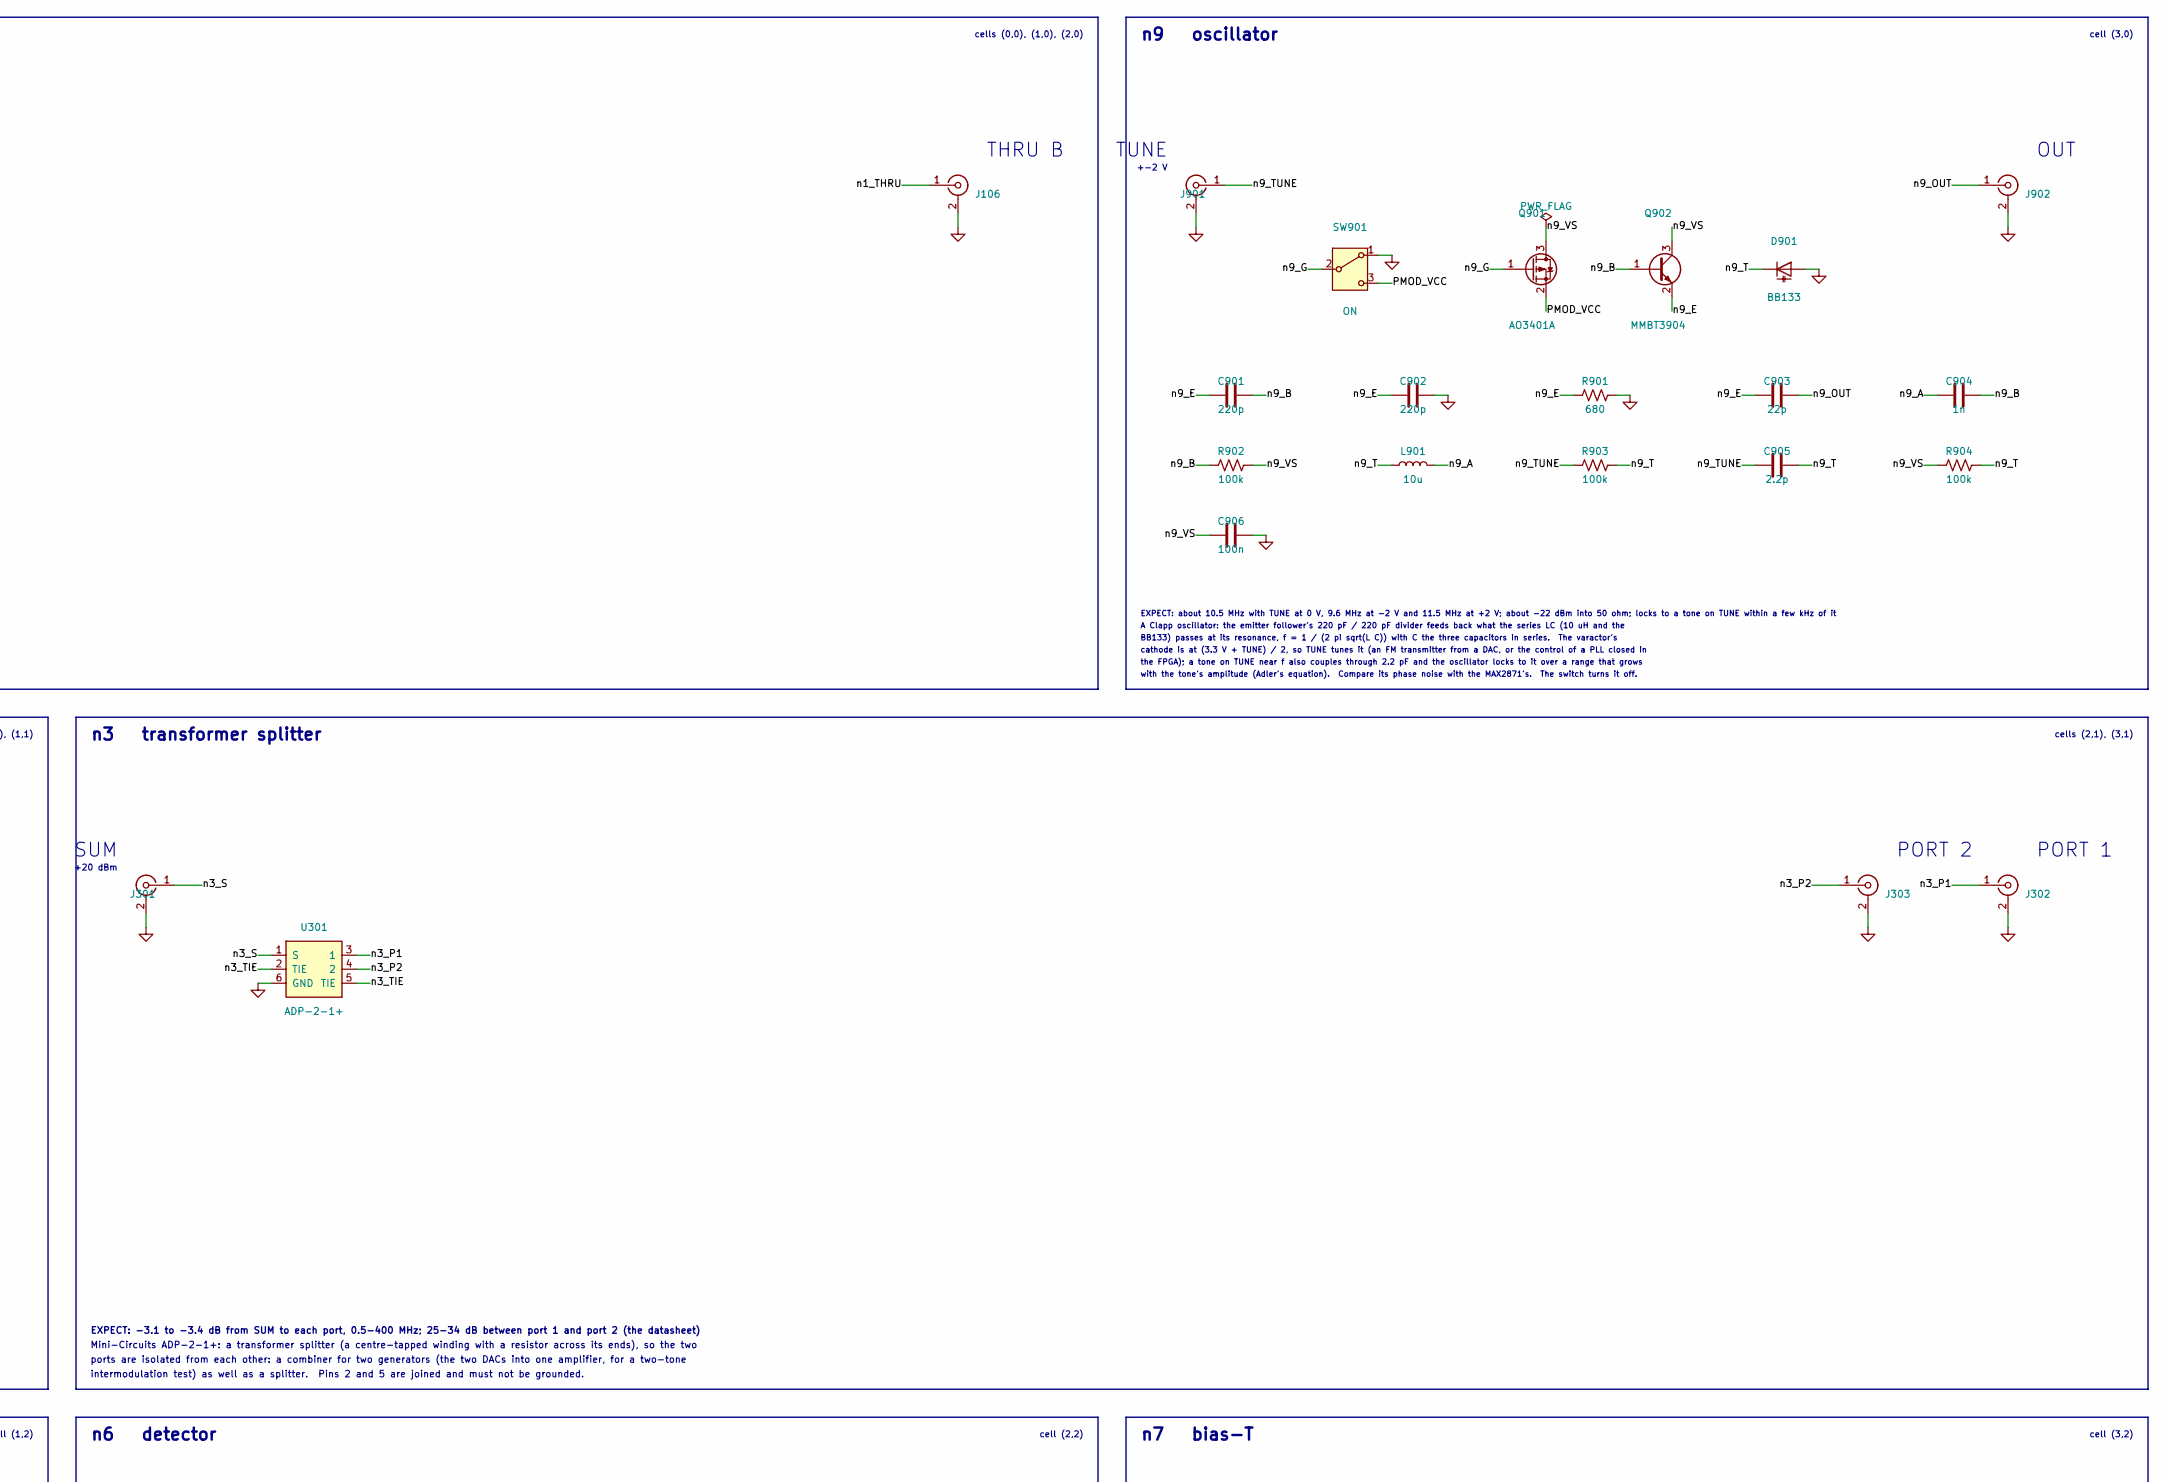
[picture p234: schematic amod_n.kicad_sch, AMOD-N: passive RF and analog blocks, part in row 1, column 2]

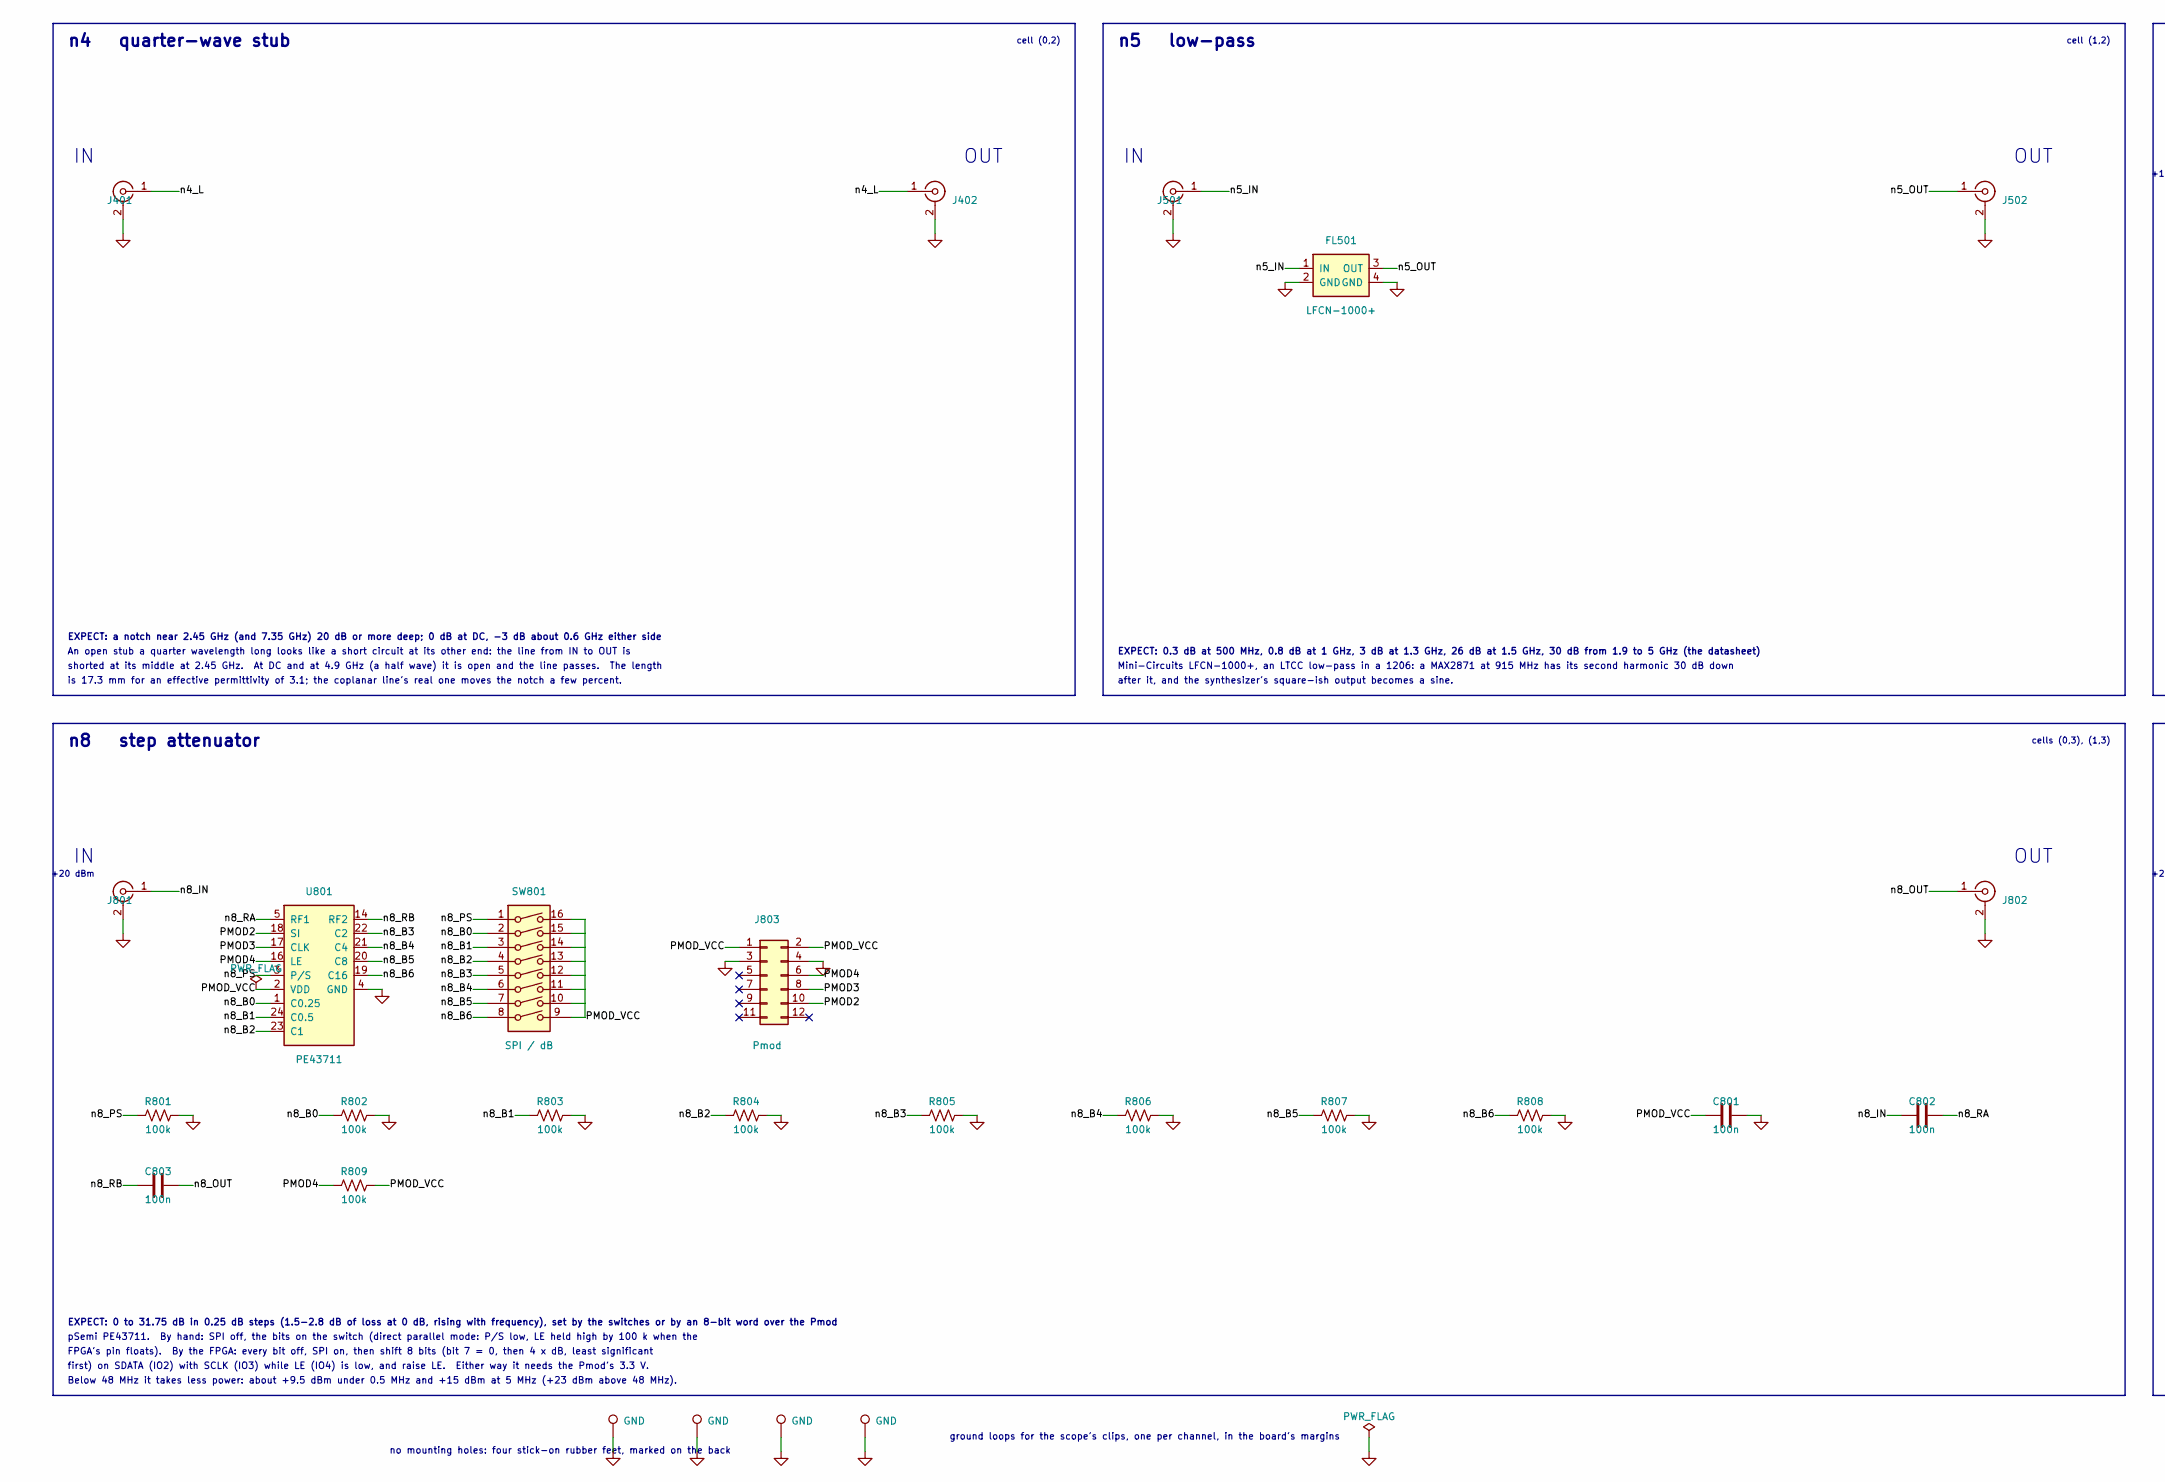
[picture p235: schematic amod_n.kicad_sch, AMOD-N: passive RF and analog blocks, part in row 2, column 1]

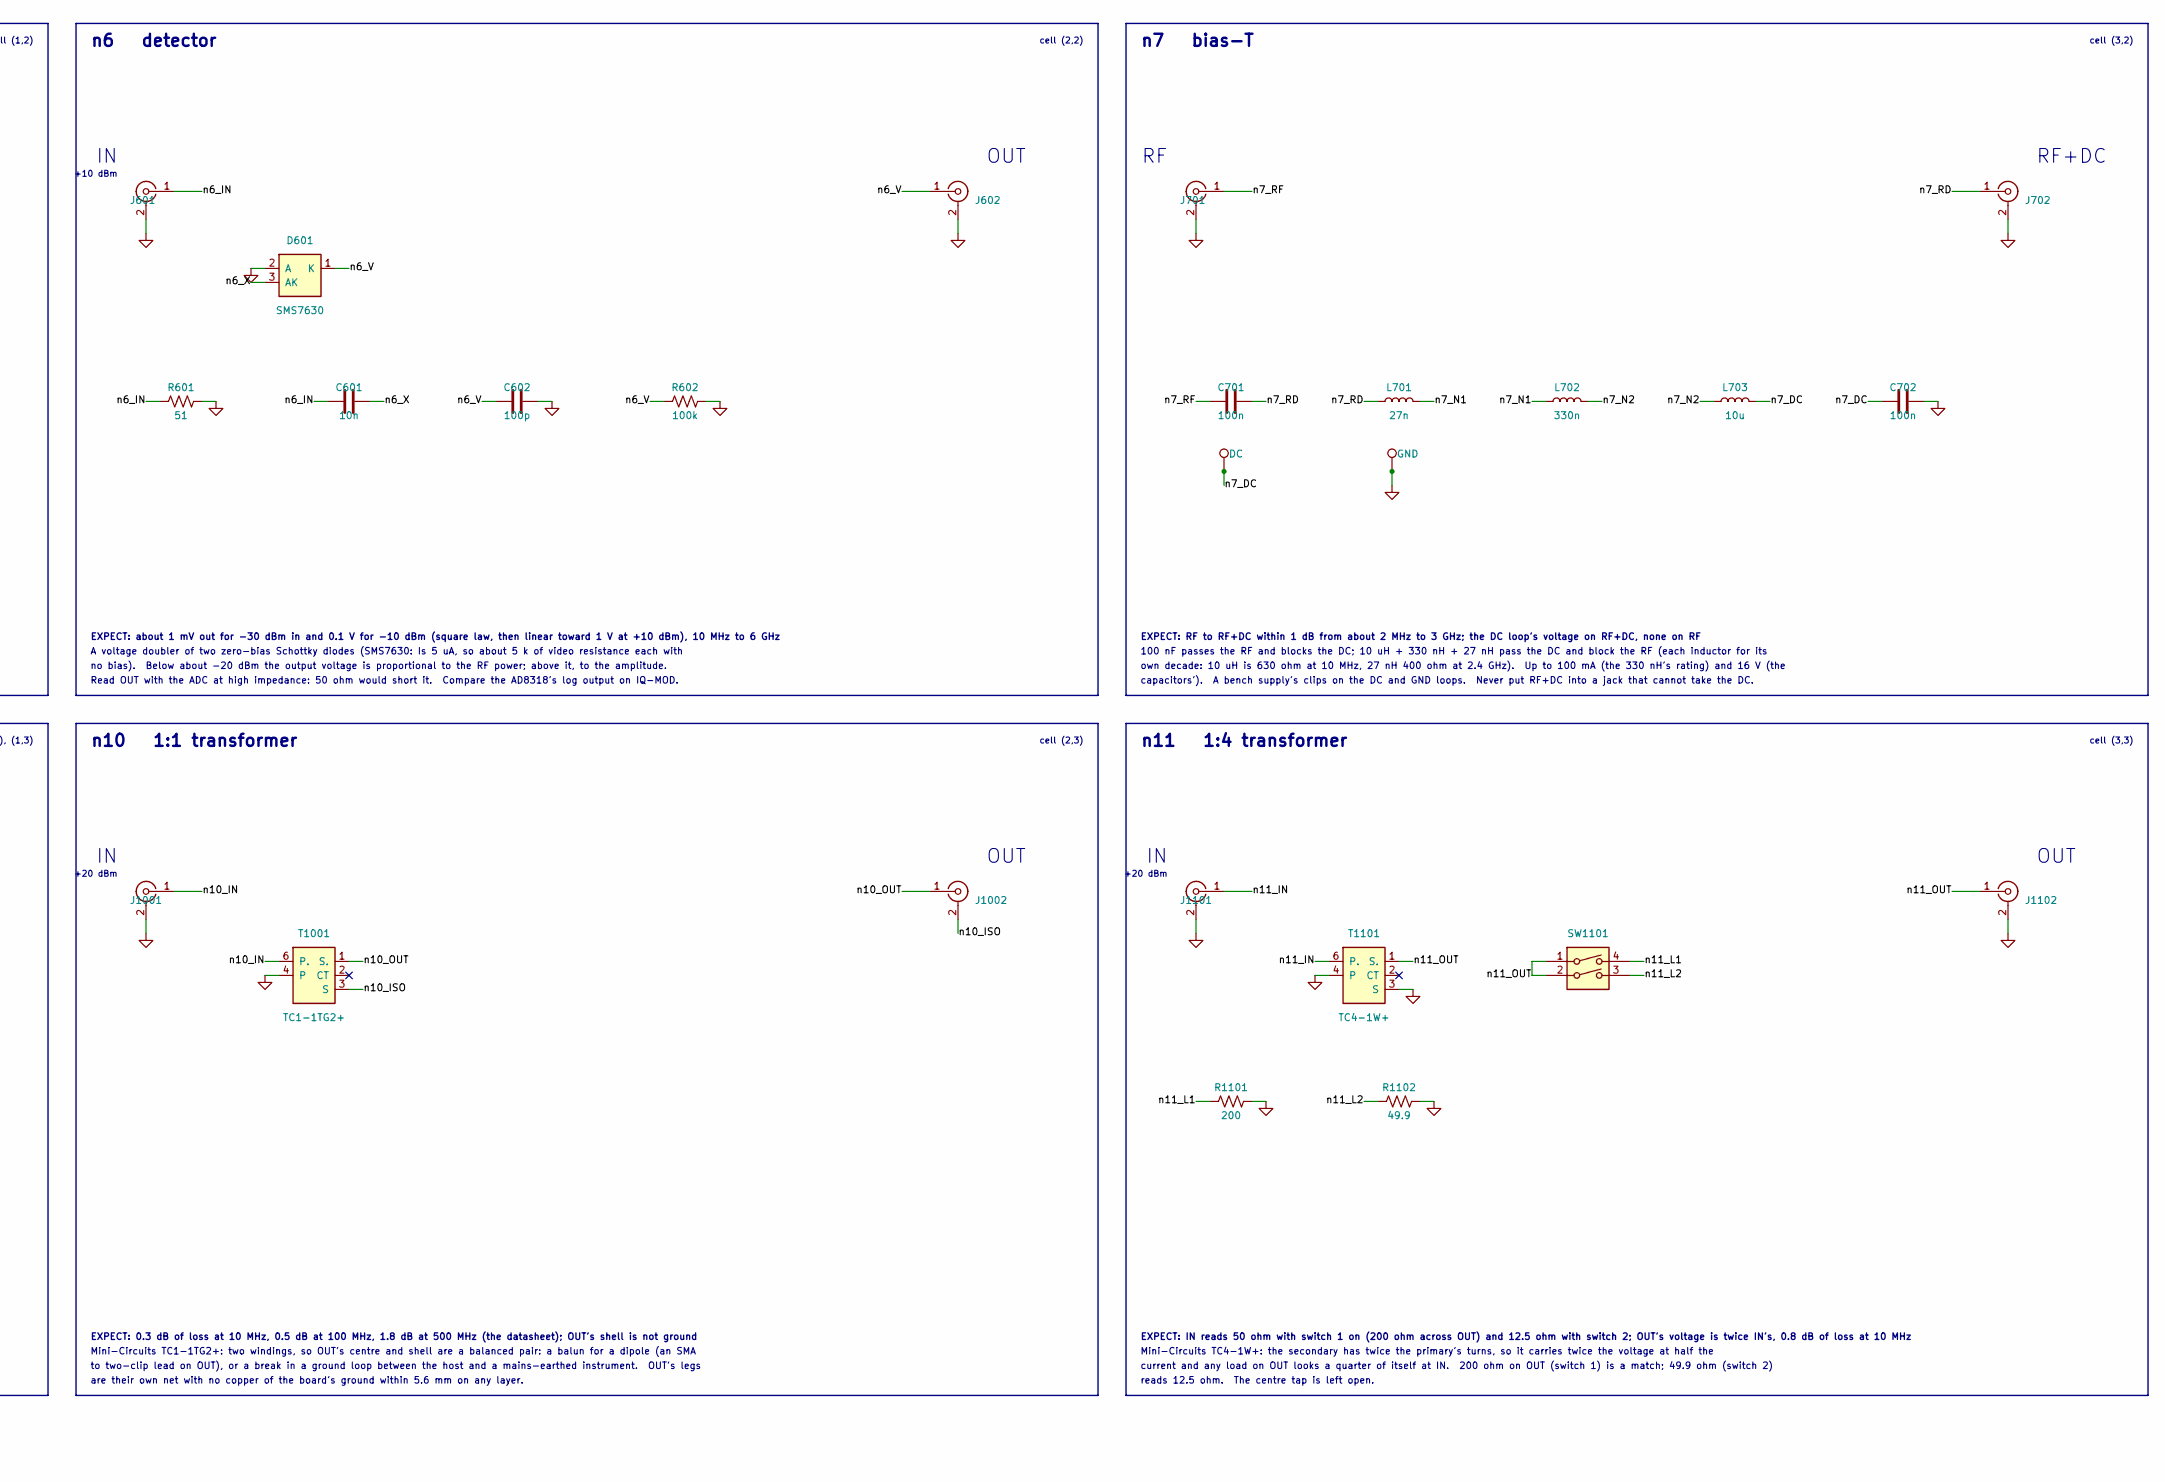
[picture p236: schematic amod_n.kicad_sch, AMOD-N: passive RF and analog blocks, part in row 2, column 2]

Parts:
C601: 10n; C_0402_1005Metric; MPN CL05B103KB5NNNC; LCSC C15195
C602: 100p; C_0402_1005Metric; MPN 0402CG101J500NT; LCSC C1546
C701, C702, C801, C802, C803, C906: 100n; C_0402_1005Metric; MPN CL05B104KO5NNNC; LCSC C1525
C901, C902: 220p; C_0402_1005Metric; MPN 0402CG221J500NT; LCSC C39122
C903: 22p; C_0402_1005Metric; MPN 0402CG220J500NT; LCSC C1555
C904: 1n; C_0402_1005Metric; MPN 0402B102K500NT; LCSC C1523
C905: 2.2p; C_0402_1005Metric; MPN 0402CG2R2C500NT; LCSC C1559
D601: SMS7630; SOT-23; MPN SMS7630-006LF; LCSC C6489012
D901: BB133; D_SOD-323; MPN BB133; LCSC C5334579
FL501: LFCN-1000+; Filter_LTCC_1206_LFCN; MPN LFCN-1000+; LCSC C879868
J101, J102, J103, J104, J105, J106, J201, J202, J203, J301, J302, J303, J401, J402, J501, J502, J601, J602, J701, J702, J801, J802, J901, J902, J1001, J1002, J1101, J1102: SMA; SMA_BWSMA-KE-Z001_Vertical; MPN BWSMA-KE-Z001; LCSC C496549
J803: Pmod; PinHeader_2x06_P2.54mm_Horizontal_PZ254R-12-12P; MPN PZ254R-12-12P; LCSC C492434
L701: 27n; L_0402_1005Metric; MPN LQW15AN27NG80D; LCSC C882469
L702: 330n; L_0603_1608Metric; MPN CS0603-R33J-S; LCSC C142165
L703, L901: 10u; L_1210_3225Metric; MPN NLV32T-100J-PF; LCSC C76835
Q901: AO3401A; SOT-23; MPN AO3401A; LCSC C15127
Q902: MMBT3904; SOT-23; MPN MMBT3904(RANGE:100-300); LCSC C20526
R101, R102: 100; R_0402_1005Metric; MPN 0402WGF1000TCE; LCSC C25076
R103, R104, R1102: 49.9; R_0402_1005Metric; MPN CRCW040249R9FKEDHP; LCSC C844112
R201, R202, R203: 16.9; R_0402_1005Metric; MPN 0402WGF169JTCE; LCSC C82287
R601: 51; R_0402_1005Metric; MPN 0402WGF510JTCE; LCSC C25125
R602, R801, R802, R803, R804, R805, R806, R807, R808, R809, R902, R903, R904: 100k; R_0402_1005Metric; MPN 0402WGF1003TCE; LCSC C25741
R901: 680; R_0402_1005Metric; MPN 0402WGF6800TCE; LCSC C25130
R1101: 200; R_0402_1005Metric; MPN 0402WGF2000TCE; LCSC C25087
SW801: SPI / dB; SW_DIP_SPSTx08_Slide_1.27mm_DSHP08; MPN DSHP08TSGET; LCSC C40738
SW901: ON; SW_SPDT_Shouhan_MSK12C02; MPN MSK12C02; LCSC C431540
SW1101: LOAD; SW_DIP_SPSTx02_Slide_1.27mm_DSHP02; MPN DSHP02TSGET; LCSC C40735
T1001: TC1-1TG2+; MiniCircuits_AT224_5P; MPN TC1-1TG2+; LCSC C3305009
T1101: TC4-1W+; MiniCircuits_AT224_5P; MPN TC4-1W+; LCSC C879855
TP701: DC; TestPoint_Loop_RH-5019; MPN RH-5019; LCSC C5199800
TP702, TP9901, TP9902, TP9903, TP9904: GND; TestPoint_Loop_RH-5019; MPN RH-5019; LCSC C5199800
U301: ADP-2-1+; MiniCircuits_CD636_ADP-2-1; MPN ADP-2-1+; LCSC C2683460
U801: PE43711; QFN-24-1EP_4x4mm_P0.5mm_EP2.7x2.7mm; MPN PE43711B-Z; LCSC C470929

Connections:
/PMOD2: J803.10, U801.18 (SI)
/PMOD3: J803.8, U801.17 (CLK)
/PMOD4: J803.6, R809.1, U801.16 (LE)
/PMOD_VCC: C801.1, J803.1, J803.2, Q901.2 (S), R809.2, SW801.9, SW801.10, SW801.11, SW801.12, SW801.13, SW801.14, SW801.15, SW801.16, SW901.3 (C), U801.2 (VDD)
/n1_LOAD: J103.1 (In), R101.1, R102.1
/n1_MIS: J104.1 (In), R103.1, R104.1
/n1_THRU: J105.1 (In), J106.1 (In)
/n2_IN: J201.1 (In), R201.1
/n2_O1: J202.1 (In), R202.1
/n2_O2: J203.1 (In), R203.2
/n2_S: R201.2, R202.2, R203.1
/n3_P1: J302.1 (In), U301.3 (1)
/n3_P2: J303.1 (In), U301.4 (2)
/n3_S: J301.1 (In), U301.1 (S)
/n3_TIE: U301.2 (TIE), U301.5 (TIE)
/n4_L: J401.1 (In), J402.1 (In)
/n5_IN: FL501.1 (IN), J501.1 (In)
/n5_OUT: FL501.3 (OUT), J502.1 (In)
/n6_IN: C601.1, J601.1 (In), R601.1
/n6_V: C602.1, D601.1 (K), J602.1 (In), R602.1
/n6_X: C601.2, D601.3 (AK)
/n7_DC: C702.1, L703.2, TP701.1
/n7_N1: L701.2, L702.1
/n7_N2: L702.2, L703.1
/n7_RD: C701.2, J702.1 (In), L701.1
/n7_RF: C701.1, J701.1 (In)
/n8_B0: R802.1, SW801.2, U801.1 (C0.25)
/n8_B1: R803.1, SW801.3, U801.24 (C0.5)
/n8_B2: R804.1, SW801.4, U801.23 (C1)
/n8_B3: R805.1, SW801.5, U801.22 (C2)
/n8_B4: R806.1, SW801.6, U801.21 (C4)
/n8_B5: R807.1, SW801.7, U801.20 (C8)
/n8_B6: R808.1, SW801.8, U801.19 (C16)
/n8_IN: C802.1, J801.1 (In)
/n8_OUT: C803.2, J802.1 (In)
/n8_PS: R801.1, SW801.1, U801.3 (P/S)
/n8_RA: C802.2, U801.5 (RF1)
/n8_RB: C803.1, U801.14 (RF2)
/n9_A: C904.1, L901.2
/n9_B: C901.2, C904.2, Q902.1 (B), R902.1
/n9_E: C901.1, C902.1, C903.1, Q902.2 (E), R901.1
/n9_G: Q901.1 (G), SW901.2 (B)
/n9_OUT: C903.2, J902.1 (In)
/n9_T: C905.2, D901.1 (K), L901.1, R903.2, R904.2
/n9_TUNE: C905.1, J901.1 (In), R903.1
/n9_VS: C906.1, Q901.3 (D), Q902.3 (C), R902.2, R904.1
/n10_IN: J1001.1 (In), T1001.6 (P.)
/n10_ISO: J1002.2 (Ext), T1001.3 (S)
/n10_OUT: J1002.1 (In), T1001.1 (S.)
/n11_IN: J1101.1 (In), T1101.6 (P.)
/n11_L1: R1101.1, SW1101.4
/n11_L2: R1102.1, SW1101.3
/n11_OUT: J1102.1 (In), SW1101.1, SW1101.2, T1101.1 (S.)
GND: C602.2, C702.2, C801.2, C902.2, C906.2, D601.2 (A), D901.2 (A), FL501.2 (GND), FL501.4 (GND), J101.1 (In), J101.2 (Ext), J102.2 (Ext), J103.2 (Ext), J104.2 (Ext), J105.2 (Ext), J106.2 (Ext), J201.2 (Ext), J202.2 (Ext), J203.2 (Ext), J301.2 (Ext), J302.2 (Ext), J303.2 (Ext), J401.2 (Ext), J402.2 (Ext), J501.2 (Ext), J502.2 (Ext), J601.2 (Ext), J602.2 (Ext), J701.2 (Ext), J702.2 (Ext), J801.2 (Ext), J802.2 (Ext), J803.3, J803.4, J901.2 (Ext), J902.2 (Ext), J1001.2 (Ext), J1101.2 (Ext), J1102.2 (Ext), R101.2, R102.2, R103.2, R104.2, R601.2, R602.2, R801.2, R802.2, R803.2, R804.2, R805.2, R806.2, R807.2, R808.2, R901.2, R1101.2, R1102.2, SW901.1 (A), T1001.4, T1101.3 (S), T1101.4, TP702.1, TP9901.1, TP9902.1, TP9903.1, TP9904.1, U301.6 (GND), U801.4 (GND), U801.6 (GND), U801.7 (GND), U801.8 (GND), U801.9 (GND), U801.10 (GND), U801.11 (GND), U801.12 (GND), U801.13 (GND), U801.15 (GND), U801.25 (GND)

Notes on the sheet:
SUM
cells (2,1), (3,1)
EXPECT: -3.1 to -3.4 dB from SUM to each port, 0.5-400 MHz; 25-34 dB between port 1 and port 2 (the datasheet)
OUT
EXPECT: 0.3 dB of loss at 10 MHz, 0.5 dB at 100 MHz, 1.8 dB at 500 MHz (the datasheet); OUT's shell is not ground
EXPECT: 0 to 31.75 dB in 0.25 dB steps (1.5-2.8 dB of loss at 0 dB, rising with frequency), set by the switches or by an 8-bit word over the Pmod
n1 calibration
cells (0,0), (1,0), (2,0)
n3 transformer splitter
cell (0,2)
measures each tile from its pads with its jacks taken out.
RF+DC
25 OHM: 2 x 49.9 ohm at the end of 4.75 mm of line, a verification standard (VSWR 2). THRU: 19.8 mm of 50 ohm line,
n11 1:4 transformer
cell (3,3)
An open stub a quarter wavelength long looks like a short circuit at its other end: the line from IN to OUT is
(fringing about 30 fF, to be measured against the NanoVNA's SMA open). LOAD: 4 mm of 50 ohm line into 2 x 100 ohm.
25 OHM
PORT 2
A voltage doubler of two zero-bias Schottky diodes (SMS7630: Is 5 uA, so about 5 k of video resistance each with
OUT 2
THRU A
+20 dBm
n2 resistive splitter
EXPECT: SHORT, OPEN and LOAD at the jacks' pins and a 19.8 mm THRU: a full SOLT calibration; the 25 ohm standard then reads |S11| = 1/3 (9.5 dB return loss)
LOAD
n8 step attenuator
the FPGA); a tone on TUNE near f also couples through 2.2 pF and the oscillator locks to it over a range that grows
EXPECT: RF to RF+DC within 1 dB from about 2 MHz to 3 GHz; the DC loop's voltage on RF+DC, none on RF
are their own net with no copper of the board's ground within 5.6 mm on any layer.
of isolation, 0.5-400 MHz).
current and any load on OUT looks a quarter of itself at IN. 200 ohm on OUT (switch 1) is a match; 49.9 ohm (switch 2)
EXPECT: a notch near 2.45 GHz (and 7.35 GHz) 20 dB or more deep; 0 dB at DC, -3 dB about 0.6 GHz either side
EXPECT: -6.0 dB from IN to each OUT, DC to 6 GHz, every port 50 ohm; OUT 1 to OUT 2 also -6 dB (no isolation)
no bias). Below about -20 dBm the output voltage is proportional to the RF power; above it, to the amplitude.
n5 low-pass
cell (2,3)
capacitors'). A bench supply's clips on the DC and GND loops. Never put RF+DC into a jack that cannot take the DC.
EXPECT: about 1 mV out for -30 dBm in and 0.1 V for -10 dBm (square law, then linear toward 1 V at +10 dBm), 10 MHz to 6 GHz
Mini-Circuits ADP-2-1+: a transformer splitter (a centre-tapped winding with a resistor across its ends), so the two
OUT 1
cells (0,3), (1,3)
ground loops for the scope's clips, one per channel, in the board's margins
to two-clip lead on OUT), or a break in a ground loop between the host and a mains-earthed instrument. OUT's legs
A Clapp oscillator: the emitter follower's 220 pF / 220 pF divider feeds back what the series LC (10 uH and the
100 nF passes the RF and blocks the DC; 10 uH + 330 nH + 27 nH pass the DC and block the RF (each inductor for its
+-2 V
no mounting holes: four stick-on rubber feet, marked on the back
EXPECT: 0.3 dB at 500 MHz, 0.8 dB at 1 GHz, 3 dB at 1.3 GHz, 26 dB at 1.5 GHz, 30 dB from 1.9 to 5 GHz (the datasheet)
n7 bias-T
intermodulation test) as well as a splitter. Pins 2 and 5 are joined and must not be grounded.
OPEN
Mini-Circuits LFCN-1000+, an LTCC low-pass in a 1206: a MAX2871 at 915 MHz has its second harmonic 30 dB down
Mini-Circuits TC1-1TG2+: two windings, so OUT's centre and shell are a balanced pair: a balun for a dipole (an SMA
TUNE
shorted at its middle at 2.45 GHz. At DC and at 4.9 GHz (a half wave) it is open and the line passes. The length
about 115 ps (enter it as the thru's delay). Every jack on the boards is the same part, so a calibration here
EXPECT: about 10.5 MHz with TUNE at 0 V, 9.6 MHz at -2 V and 11.5 MHz at +2 V; about -22 dBm into 50 ohm; locks to a tone on TUNE within a few kHz of it
output gets half the input's voltage. Symmetric, so any port is IN. Compare n3's transformer splitter (3 dB, 25 dB
cell (2,2)
BB133) passes at its resonance, f = 1 / (2 pi sqrt(L C)) with C the three capacitors in series. The varactor's
Mini-Circuits TC4-1W+: the secondary has twice the primary's turns, so it carries twice the voltage at half the
with the tone's amplitude (Adler's equation). Compare its phase noise with the MAX2871's. The switch turns it off.
n10 1:1 transformer
n9 oscillator
Read OUT with the ADC at high impedance: 50 ohm would short it. Compare the AD8318's log output on IQ-MOD.
Calibration standards at the board surface. SHORT: the centre pin poured to ground all round. OPEN: the bare pin
SHORT
THRU B
FPGA's pin floats). By the FPGA: every bit off, SPI on, then shift 8 bits (bit 7 = 0, then 4 x dB, least significant
Below 48 MHz it takes less power: about +9.5 dBm under 0.5 MHz and +15 dBm at 5 MHz (+23 dBm above 48 MHz).
cell (1,2)
after it, and the synthesizer's square-ish output becomes a sine.
pSemi PE43711. By hand: SPI off, the bits on the switch (direct parallel mode: P/S low, LE held high by 100 k when the
reads 12.5 ohm. The centre tap is left open.
is 17.3 mm for an effective permittivity of 3.1; the coplanar line's real one moves the notch a few percent.
+10 dBm
cell (3,2)
first) on SDATA (IO2) with SCLK (IO3) while LE (IO4) is low, and raise LE. Either way it needs the Pmod's 3.3 V.
n6 detector
own decade: 10 uH is 630 ohm at 10 MHz, 27 nH 400 ohm at 2.4 GHz). Up to 100 mA (the 330 nH's rating) and 16 V (the
cell (3,0)
ports are isolated from each other: a combiner for two generators (the two DACs into one amplifier, for a two-tone
cathode is at (3.3 V + TUNE) / 2, so TUNE tunes it (an FM transmitter from a DAC, or the control of a PLL closed in
Three 16.9 ohm (50 / 3) from a star to the three ports: each port sees 16.9 + (16.9 + 50) / 2 = 50 ohm, and each
cells (0,1), (1,1)
PORT 1
EXPECT: IN reads 50 ohm with switch 1 on (200 ohm across OUT) and 12.5 ohm with switch 2; OUT's voltage is twice IN's, 0.8 dB of loss at 10 MHz
n4 quarter-wave stub

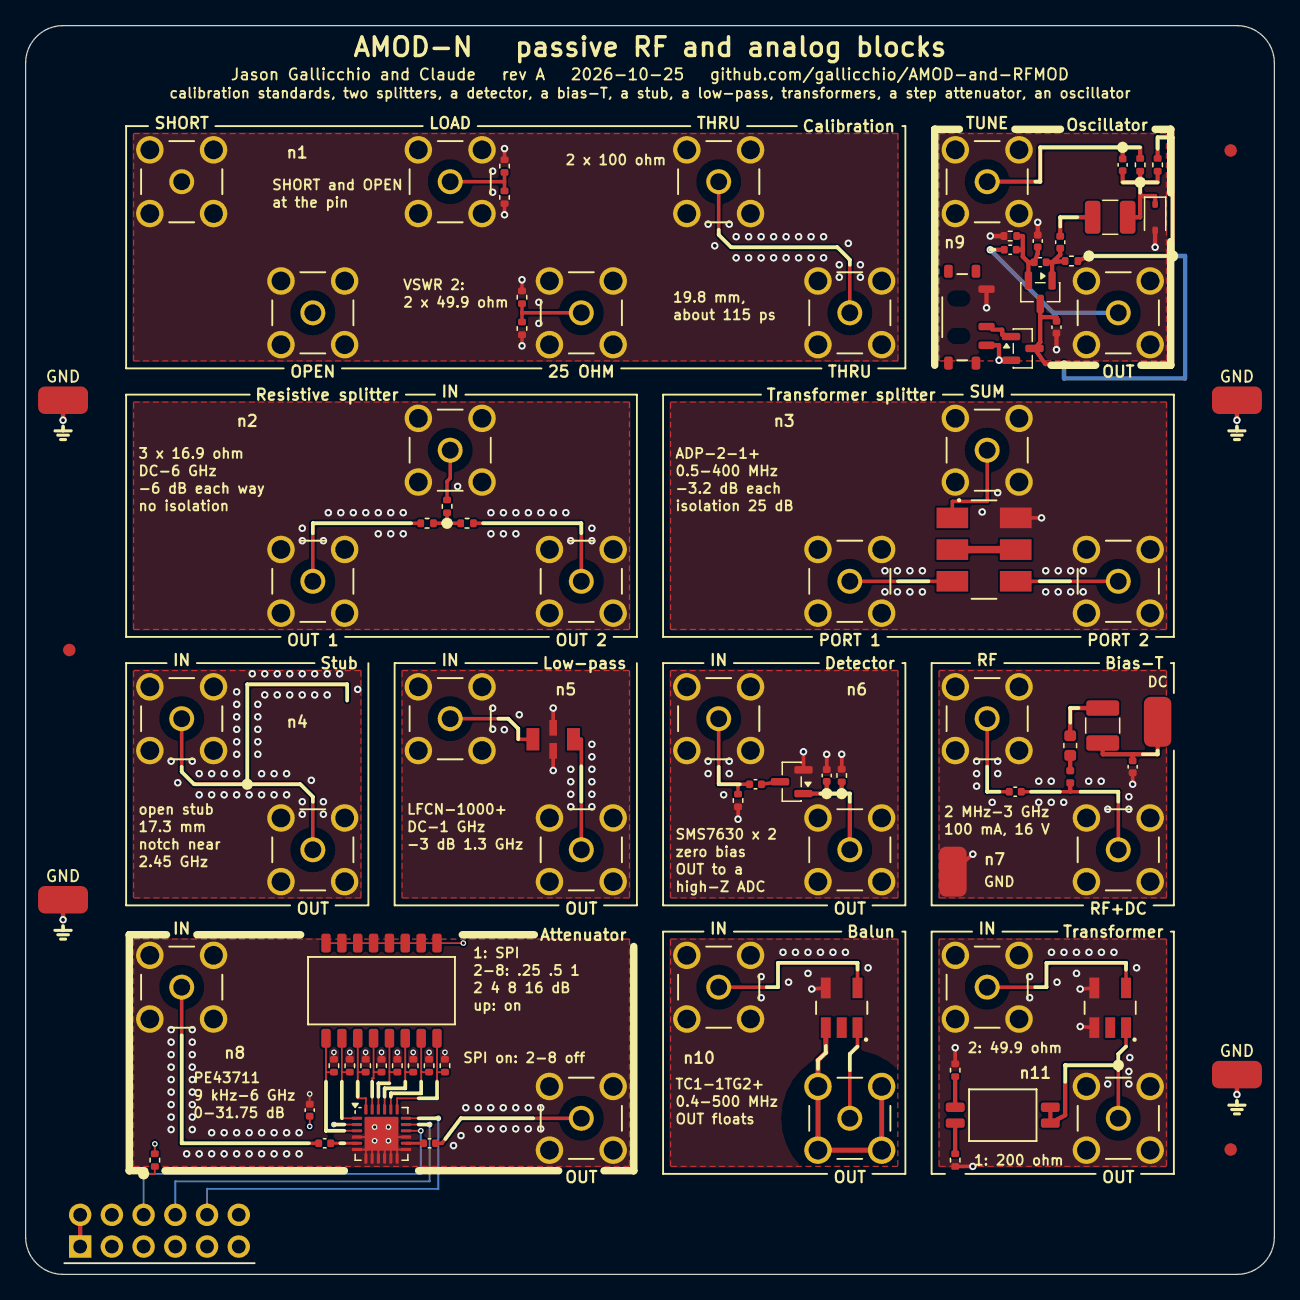
[picture p237: board amod_n.kicad_pcb from above]

Board: 4 copper layers, 100.0 x 100.0 mm, 88 parts (0 on the bottom side), 54 nets.
