gallicchio/AMOD-and-RFMOD/hardware/amod_b.kicad_pcb

## KiCad design hardware/amod_b.kicad_pcb (2026-10-30)

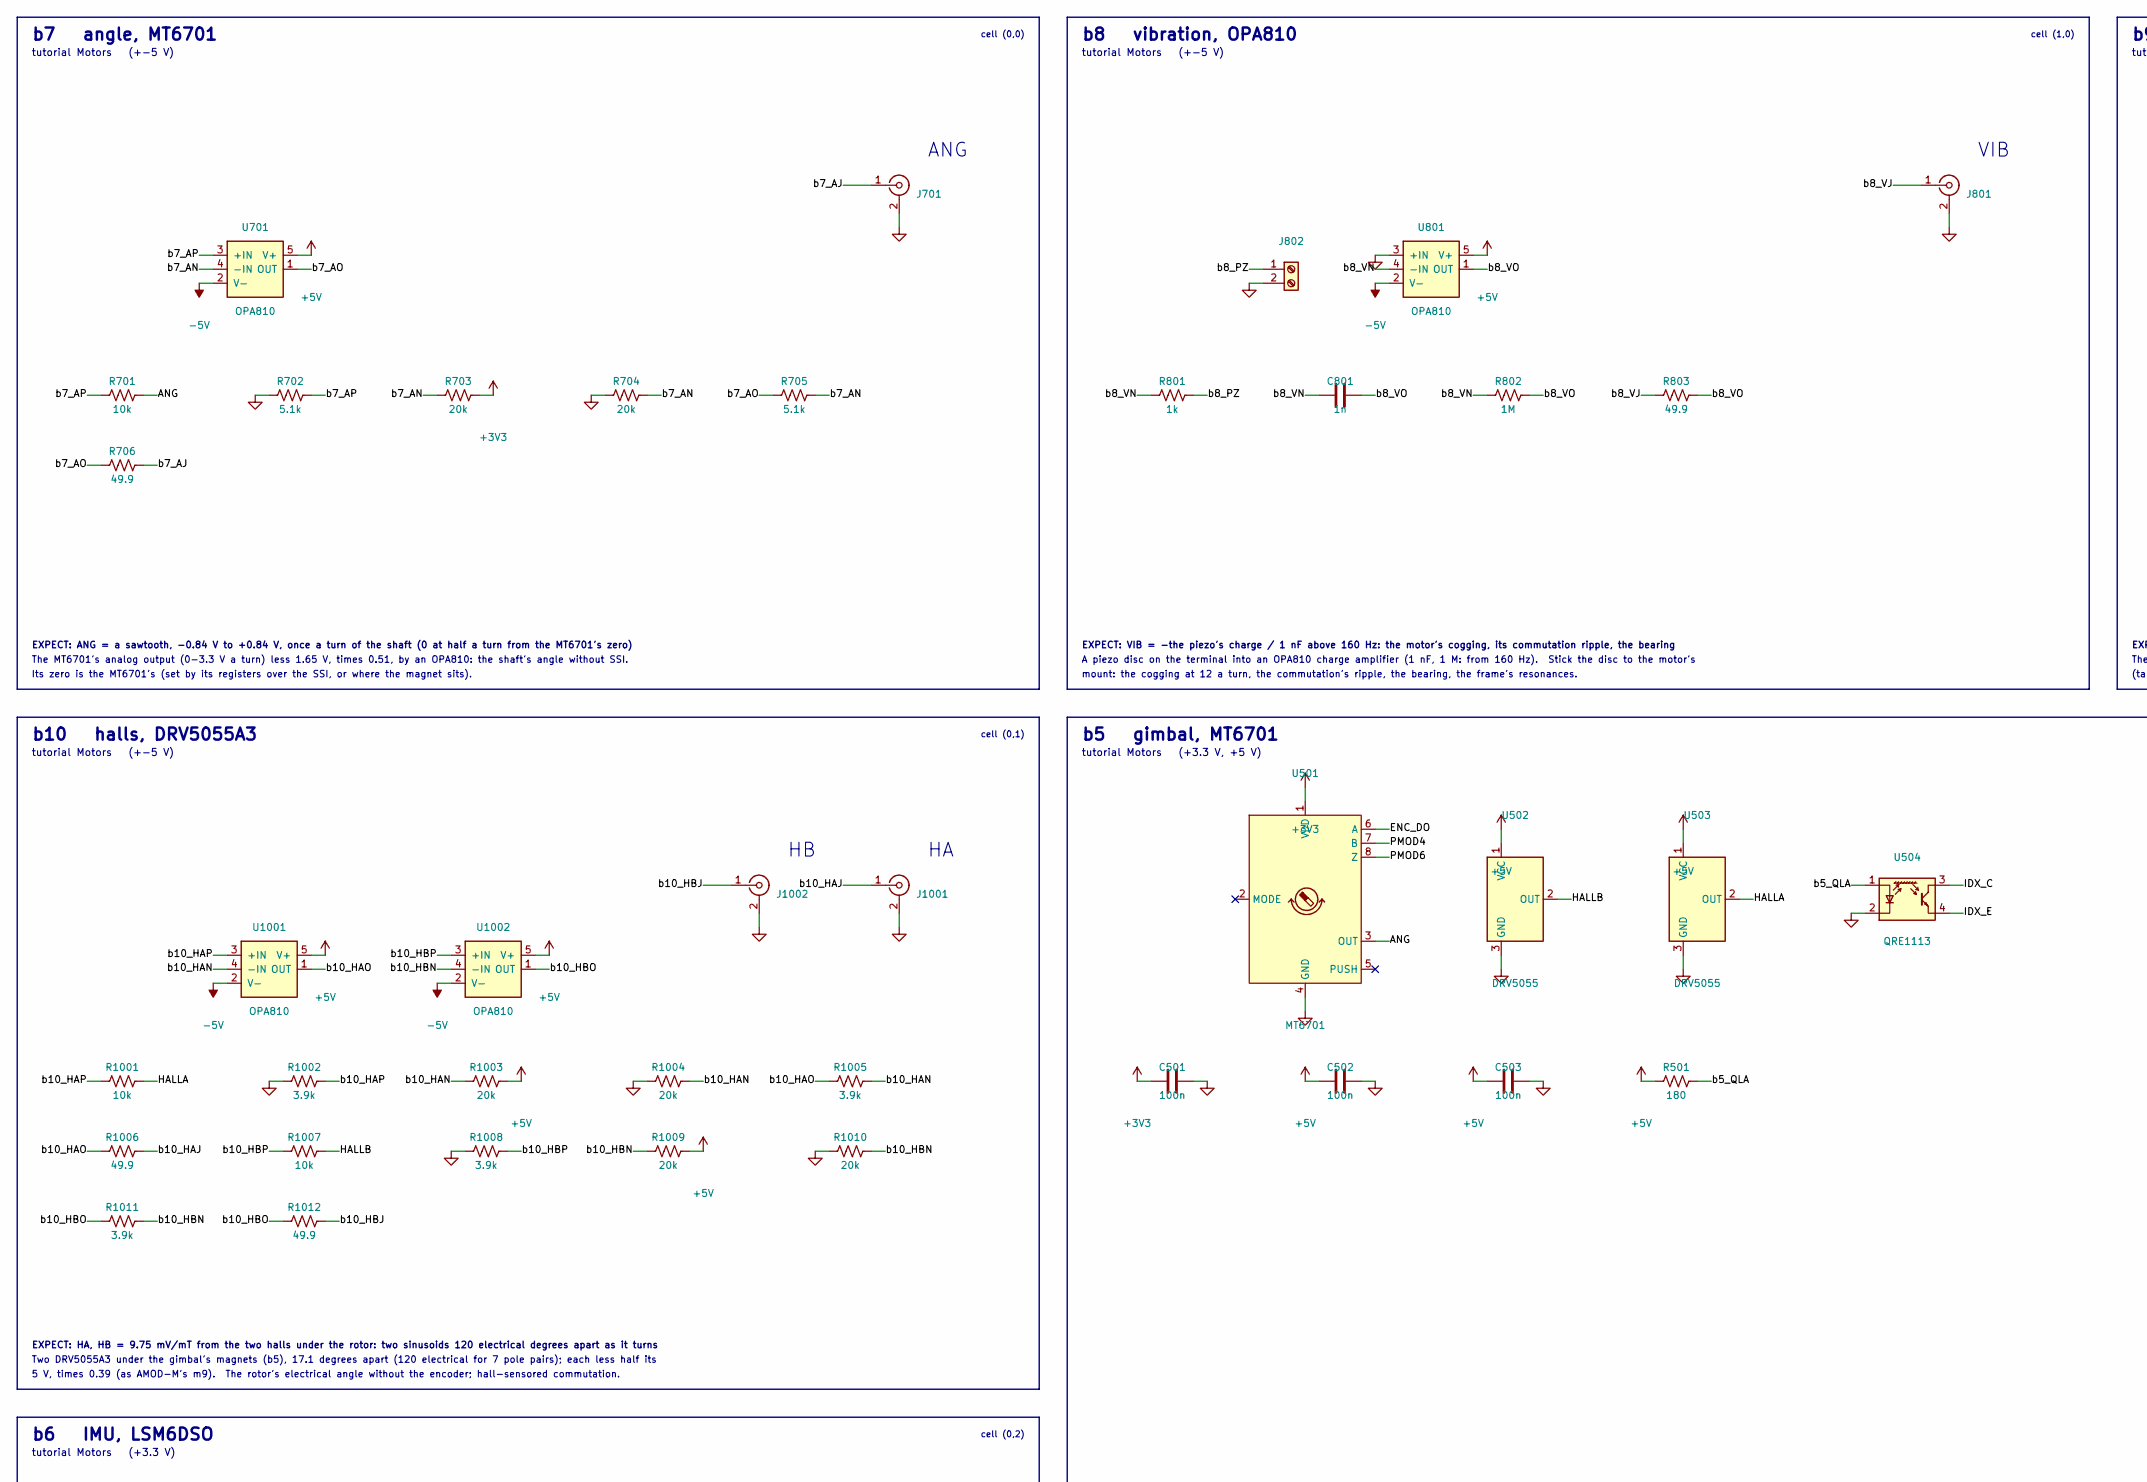
[picture p238: schematic amod_b.kicad_sch, AMOD-B: brushless motors, part in row 1, column 1]

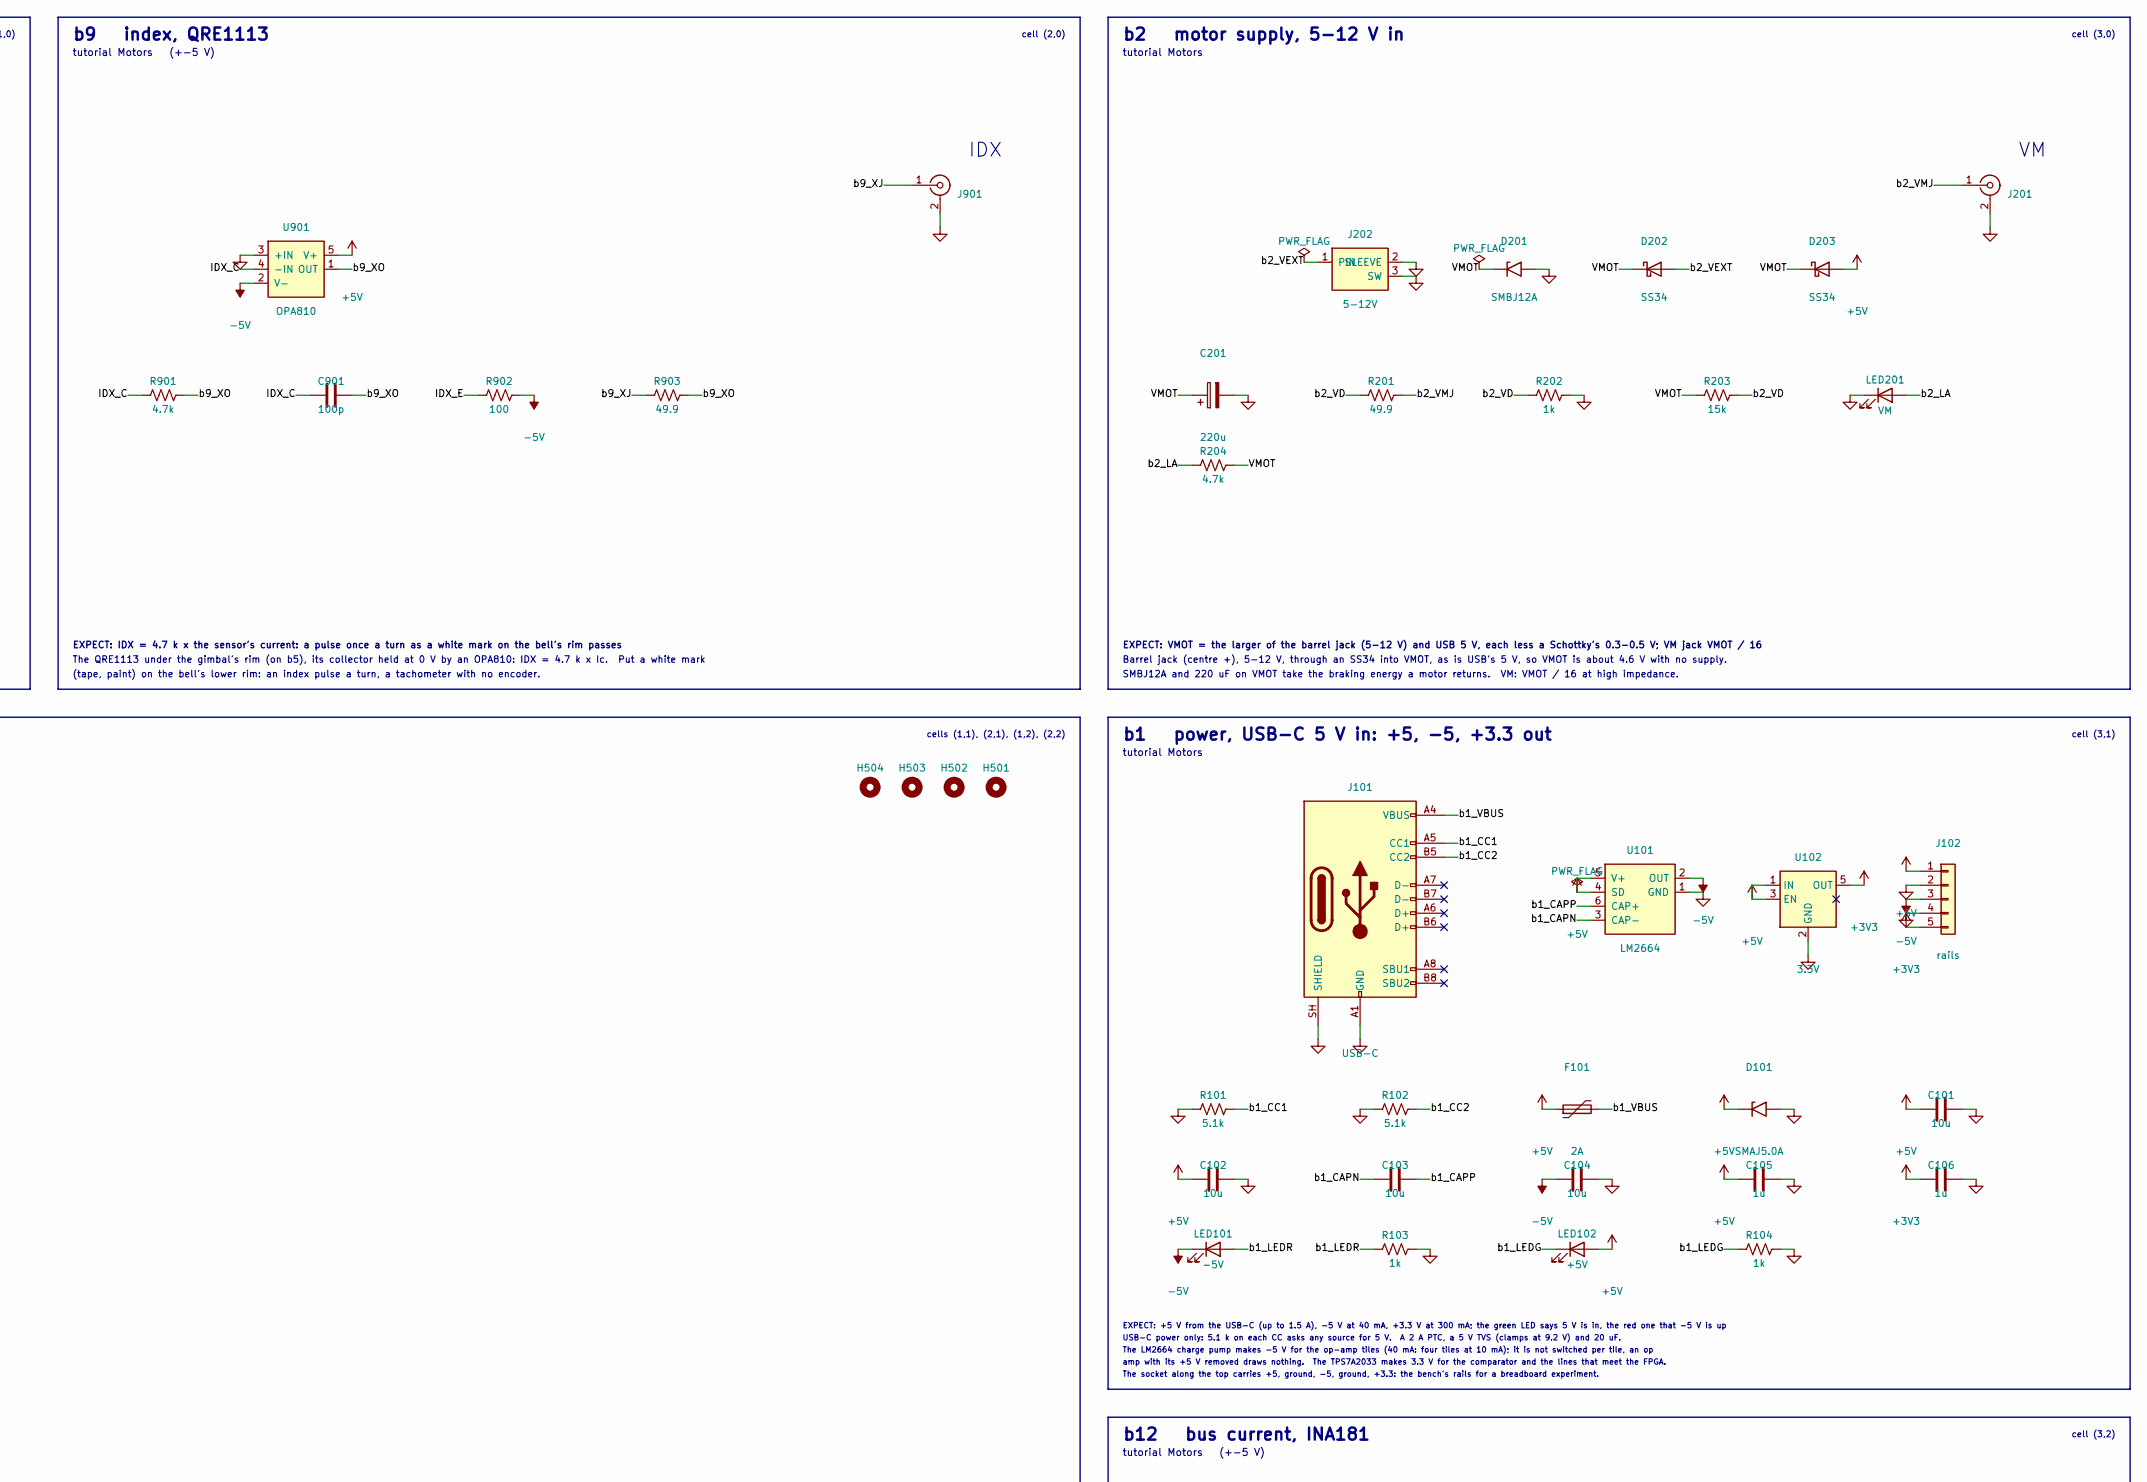
[picture p239: schematic amod_b.kicad_sch, AMOD-B: brushless motors, part in row 1, column 2]

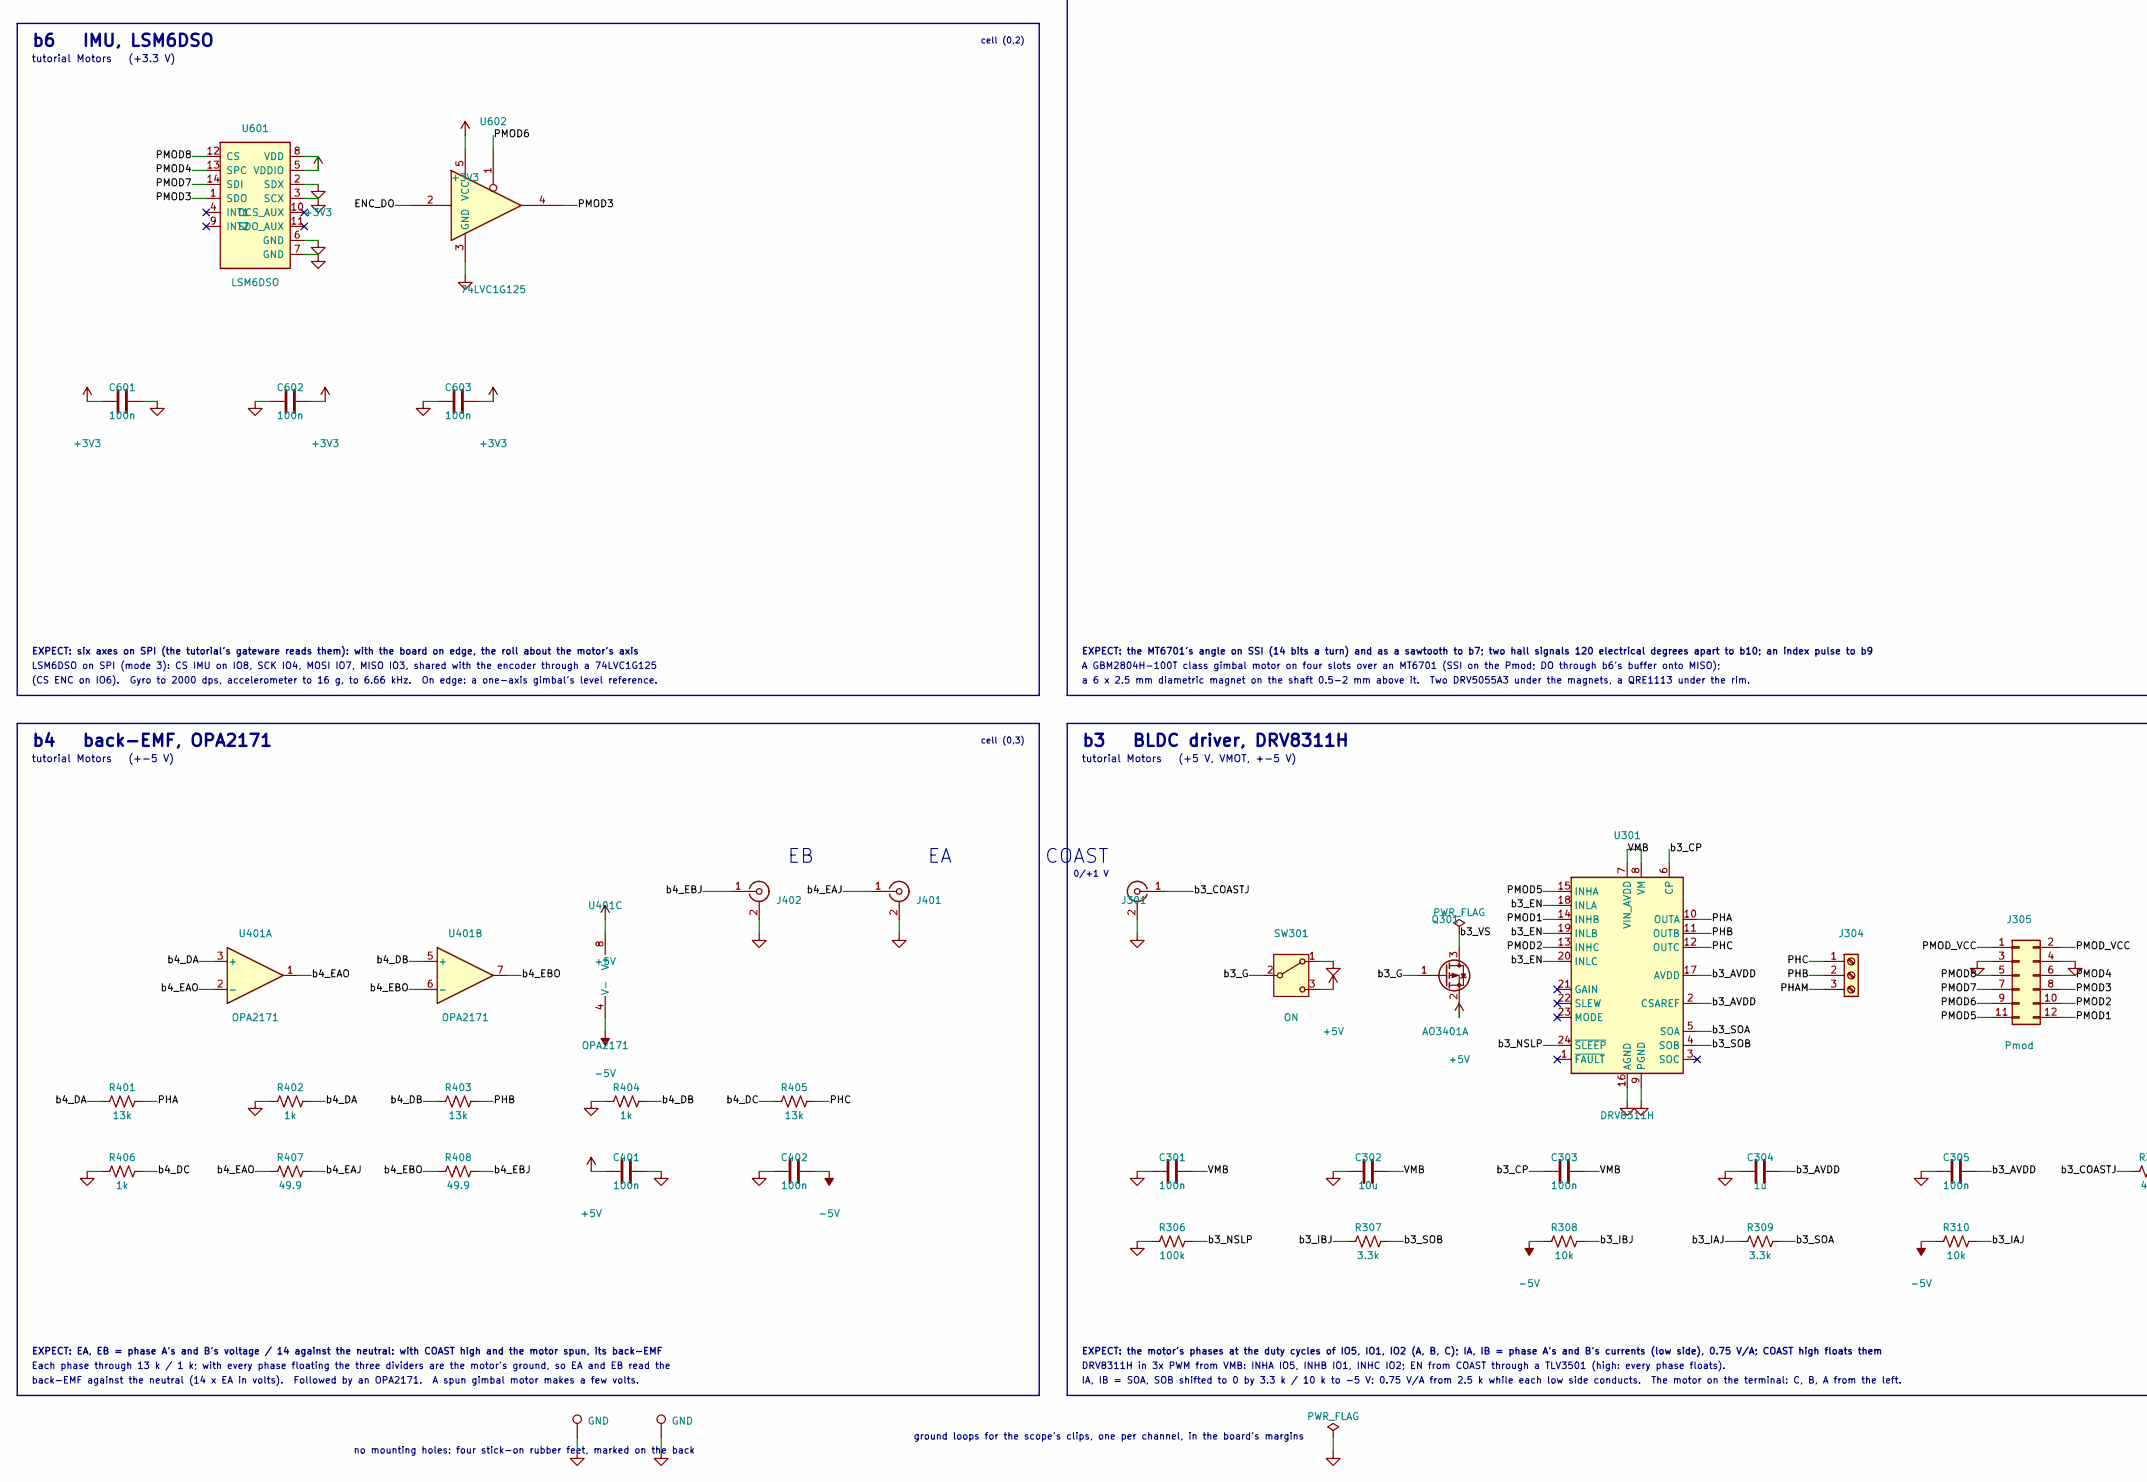
[picture p240: schematic amod_b.kicad_sch, AMOD-B: brushless motors, part in row 2, column 1]

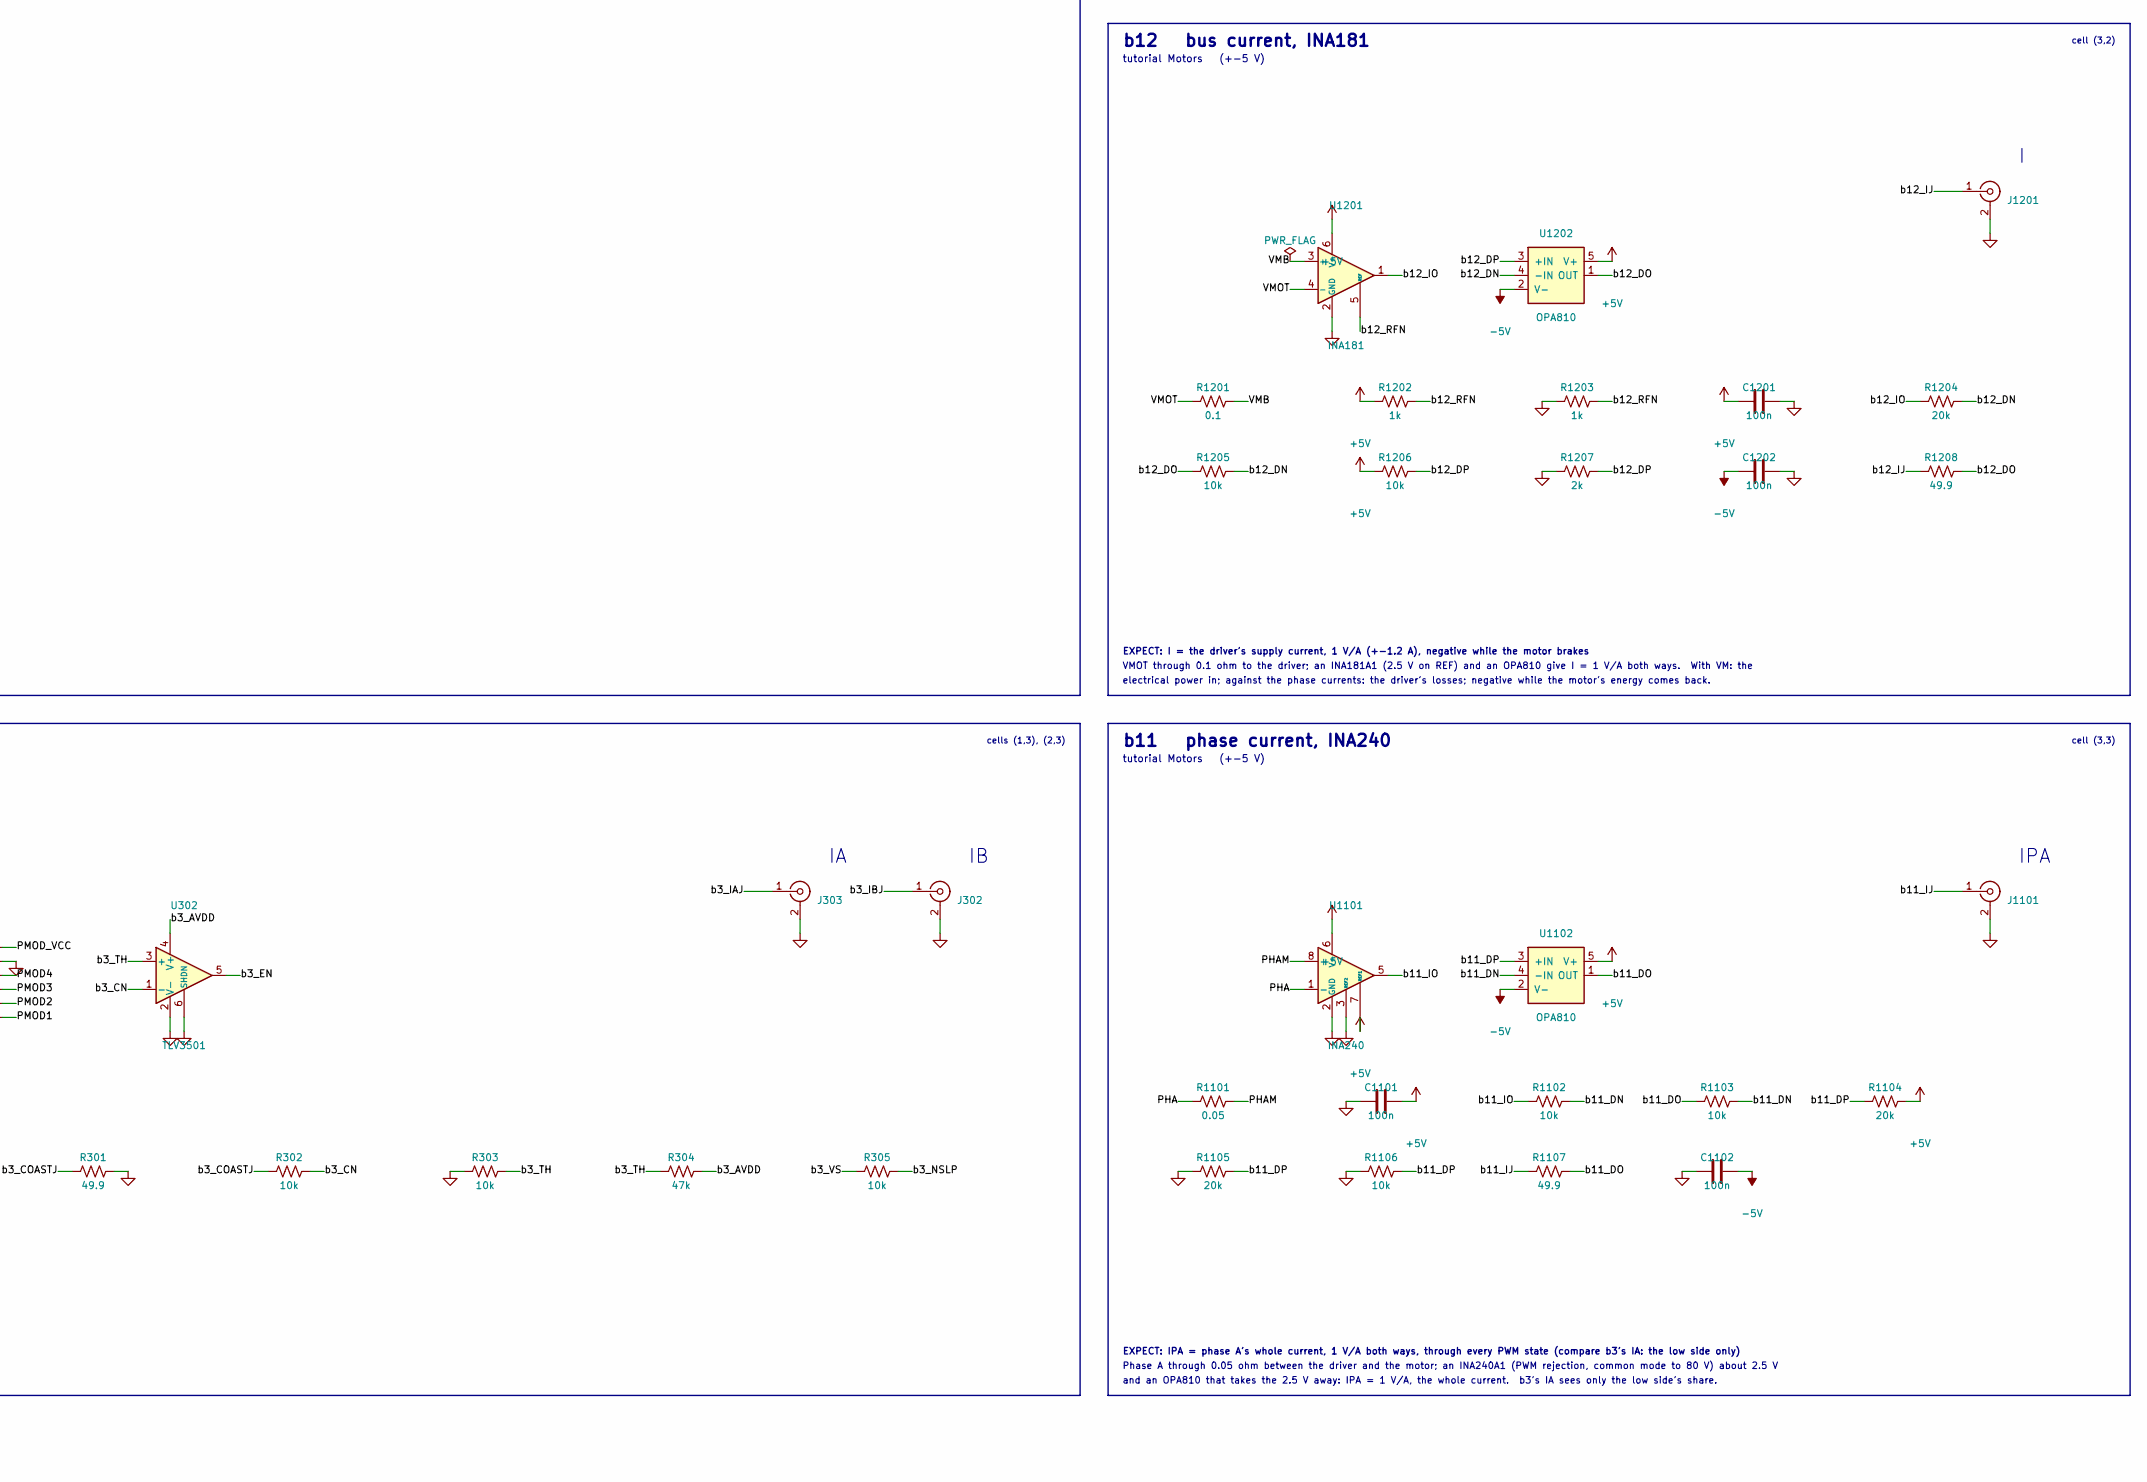
[picture p241: schematic amod_b.kicad_sch, AMOD-B: brushless motors, part in row 2, column 2]

Parts:
C101, C102, C103, C104, C302: 10u; C_0805_2012Metric; MPN CL21A106KAYNNNE; LCSC C15850
C105, C106: 1u; C_0805_2012Metric; MPN CL21B105KBFNNNE; LCSC C28323
C201: 220u; CP_Elec_6.3x7.7; MPN XT220UF25V90RV0075; LCSC C2992606
C301, C303, C305, C401, C402, C501, C502, C503, C601, C602, C603, C1101, C1102, C1201, C1202: 100n; C_0402_1005Metric; MPN CL05B104KO5NNNC; LCSC C1525
C304: 1u; C_0603_1608Metric; MPN CL10A105KB8NNNC; LCSC C15849
C801: 1n; C_0402_1005Metric; MPN 0402B102K500NT; LCSC C1523
C901: 100p; C_0402_1005Metric; MPN 0402CG101J500NT; LCSC C1546
D101: SMAJ5.0A; D_SMA; MPN SMAJ5.0A; LCSC C78401
D201: SMBJ12A; D_SMB; MPN SMBJ12A; LCSC C19077565
D202, D203: SS34; D_SMA; MPN SS34; LCSC C8678
F101: 2A; Fuse_1812_4532Metric; MPN MF-MSMF200-2; LCSC C210837
H501, H502, H503, H504: slot; Slot_Motor_3.4x7.4mm
J101: USB-C; USB_C_Receptacle_HRO_TYPE-C-31-M-12; MPN TYPE-C-31-M-12; LCSC C165948
J102: rails; PinSocket_1x05_P2.54mm_Vertical; MPN PZ254-1-05-Z-8.5; LCSC C2894928
J201, J301, J302, J303, J401, J402, J701, J801, J901, J1001, J1002, J1101, J1201: SMA; SMA_BWSMA-KE-Z001_Vertical; MPN BWSMA-KE-Z001; LCSC C496549
J202: 5-12V; BarrelJack_DC-005-5A_Horizontal; MPN DC-005-5A-2.0; LCSC C381116
J304: motor; TerminalBlock_KF301_1x03_P5.00mm; MPN KF301-5.0-3P; LCSC C474882
J305: Pmod; PinHeader_2x06_P2.54mm_Horizontal_PZ254R-12-12P; MPN PZ254R-12-12P; LCSC C492434
J802: piezo; TerminalBlock_KF301_1x02_P5.00mm; MPN KF301-5.0-2P; LCSC C474881
LED101: -5V; LED_0805_2012Metric_Kbar; MPN NCD0805R1; LCSC C84256
LED102: +5V; LED_0805_2012Metric_Kbar; MPN KT-0805G; LCSC C2297
LED201: VM; LED_0805_2012Metric_Kbar; MPN KT-0805G; LCSC C2297
Q301: AO3401A; SOT-23; MPN AO3401A; LCSC C15127
R101, R102: 5.1k; R_0805_2012Metric; MPN 0805W8F5101T5E; LCSC C27834
R103, R104: 1k; R_0805_2012Metric; MPN 0805W8F1001T5E; LCSC C17513
R201, R301, R407, R408, R706, R803, R903, R1006, R1012, R1107, R1208: 49.9; R_0402_1005Metric; MPN CRCW040249R9FKEDHP; LCSC C844112
R202, R402, R404, R406, R801, R1202, R1203: 1k; R_0402_1005Metric; MPN 0402WGF1001TCE; LCSC C11702
R203: 15k; R_0402_1005Metric; MPN 0402WGF1502TCE; LCSC C25756
R204, R901: 4.7k; R_0402_1005Metric; MPN 0402WGF4701TCE; LCSC C25900
R302, R303, R305, R308, R310, R701, R1001, R1007, R1102, R1103, R1106, R1205, R1206: 10k; R_0402_1005Metric; MPN 0402WGF1002TCE; LCSC C25744
R304: 47k; R_0402_1005Metric; MPN 0402WGF4702TCE; LCSC C25792
R306: 100k; R_0402_1005Metric; MPN 0402WGF1003TCE; LCSC C25741
R307, R309: 3.3k; R_0402_1005Metric; MPN 0402WGF3301TCE; LCSC C25890
R401, R403, R405: 13k; R_0402_1005Metric; MPN 0402WGF1302TCE; LCSC C25754
R501: 180; R_0805_2012Metric; MPN 0805W8F1800T5E; LCSC C25270
R702, R705: 5.1k; R_0402_1005Metric; MPN 0402WGF5101TCE; LCSC C25905
R703, R704, R1003, R1004, R1009, R1010, R1104, R1105, R1204: 20k; R_0402_1005Metric; MPN 0402WGF2002TCE; LCSC C25765
R802: 1M; R_0805_2012Metric; MPN 0805W8F1004T5E; LCSC C17514
R902: 100; R_0402_1005Metric; MPN 0402WGF1000TCE; LCSC C25076
R1002, R1005, R1008, R1011: 3.9k; R_0402_1005Metric; MPN 0402WGF3901TCE; LCSC C51721
R1101: 0.05; R_1206_3216Metric; MPN 1206W3F500MT5E; LCSC C127691
R1201: 0.1; R_1206_3216Metric; MPN 1206W4F100LT5E; LCSC C25334
R1207: 2k; R_0402_1005Metric; MPN 0402WGF2001TCE; LCSC C4109
SW301: ON; SW_SPDT_Shouhan_MSK12C02; MPN MSK12C02; LCSC C431540
TP9901, TP9902: GND; TestPoint_Loop_RH-5019; MPN RH-5019; LCSC C5199800
U101: LM2664; SOT-23-6; MPN LM2664M6X/NOPB; LCSC C108573
U102: 3.3V; SOT-23-5; MPN TPS7A2033PDBVR; LCSC C2862740
U301: DRV8311H; Texas_RRW0024A_WQFN-24-1EP_3x3mm_P0.4mm_EP1.9x1.9mm; MPN DRV8311HRRWR; LCSC C5218862
U302: TLV3501; SOT-23-6; MPN TLV3501AIDBVR; LCSC C193413
U401: OPA2171; SOIC-8_3.9x4.9mm_P1.27mm; MPN OPA2171AIDR; LCSC C40904
U501: MT6701; SOIC-8_3.9x4.9mm_P1.27mm; MPN MT6701CT-STD-R; LCSC C3003196
U502, U503: DRV5055; SOT-23; MPN DRV5055A3QDBZR; LCSC C266128
U504: QRE1113; OnSemi_CASE100CY; MPN QRE1113GR; LCSC C232862
U601: LSM6DSO; LGA-14_3x2.5mm_P0.5mm_LayoutBorder3x4y; MPN LSM6DSOTR; LCSC C2655100
U602: 74LVC1G125; SOT-23-5; MPN SN74LVC1G125DBVR; LCSC C23654
U701, U801, U901, U1001, U1002, U1102, U1202: OPA810; SOT-23-5; MPN OPA810IDBVR; LCSC C2833513
U1101: INA240; SOIC-8_3.9x4.9mm_P1.27mm; MPN INA240A1DR; LCSC C2060769
U1201: INA181; SOT-23-6; MPN INA181A1IDBVR; LCSC C2058943

Connections:
+3V3: C106.1, C501.1, C601.1, C602.2, C603.2, J102.5, R703.2, U102.5 (OUT), U501.1 (VDD), U601.5 (VDDIO), U601.8 (VDD), U602.5 (VCC)
+5V: C101.1, C102.1, C105.1, C401.1, C502.1, C503.1, C1101.2, C1201.1, D101.1 (A1), D203.2 (A), F101.1, J102.1, LED102.2 (A), Q301.2 (S), R501.1, R1003.2, R1009.2, R1104.2, R1202.1, R1206.1, SW301.3 (C), U101.4 (SD), U101.5 (V+), U102.1 (IN), U102.3 (EN), U401.8 (V+), U502.1 (VCC), U503.1 (VCC), U701.5 (V+), U801.5 (V+), U901.5 (V+), U1001.5 (V+), U1002.5 (V+), U1101.6 (V+), U1101.7 (REF1), U1102.5 (V+), U1201.6 (V+), U1202.5 (V+)
-5V: C104.1, C402.2, C1102.2, C1202.1, J102.3, LED101.1 (K), R308.1, R310.1, R902.2, U101.2 (OUT), U401.4 (V-), U701.2 (V-), U801.2 (V-), U901.2 (V-), U1001.2 (V-), U1002.2 (V-), U1102.2 (V-), U1202.2 (V-)
/ANG: R701.2, U501.3 (OUT)
/ENC_DO: U501.6 (A), U602.2
/HALLA: R1001.2, U503.2 (OUT)
/HALLB: R1007.2, U502.2 (OUT)
/IDX_C: C901.1, R901.1, U504.3, U901.4 (-IN)
/IDX_E: R902.1, U504.4
/PHA: R401.2, R1101.1, U301.10 (OUTA), U1101.1 (-)
/PHAM: J304.3, R1101.2, U1101.8 (+)
/PHB: J304.2, R403.2, U301.11 (OUTB)
/PHC: J304.1, R405.2, U301.12 (OUTC)
/PMOD1: J305.12, U301.14 (INHB)
/PMOD2: J305.10, U301.13 (INHC)
/PMOD3: J305.8, U601.1 (SDO), U602.4
/PMOD4: J305.6, U501.7 (B), U601.13 (SPC)
/PMOD5: J305.11, U301.15 (INHA)
/PMOD6: J305.9, U501.8 (Z), U602.1
/PMOD7: J305.7, U601.14 (SDI)
/PMOD8: J305.5, U601.12 (CS)
/PMOD_VCC: J305.1, J305.2
/VMB: C301.2, C302.2, C303.2, R1201.2, U301.7 (VIN_AVDD), U301.8 (VM), U1201.3 (+)
/VMOT: C201.1, D201.1 (A1), D202.1 (K), D203.1 (K), R203.1, R204.2, R1201.1, U1201.4 (-)
/b1_CAPN: C103.1, U101.3 (CAP-)
/b1_CAPP: C103.2, U101.6 (CAP+)
/b1_CC1: J101.A5 (CC1), R101.2
/b1_CC2: J101.B5 (CC2), R102.2
/b1_LEDG: LED102.1 (K), R104.1
/b1_LEDR: LED101.2 (A), R103.1
/b1_VBUS: F101.2, J101.A4 (VBUS), J101.A9 (VBUS), J101.B4 (VBUS), J101.B9 (VBUS)
/b2_LA: LED201.2 (A), R204.1
/b2_VD: R201.1, R202.1, R203.2
/b2_VEXT: D202.2 (A), J202.1 (PIN)
/b2_VMJ: J201.1 (In), R201.2
/b3_AVDD: C304.2, C305.2, R304.2, U301.2 (CSAREF), U301.17 (AVDD), U302.4 (V+)
/b3_CN: R302.2, U302.1 (-)
/b3_COASTJ: J301.1 (In), R301.1, R302.1
/b3_CP: C303.1, U301.6 (CP)
/b3_EN: U301.18 (INLA), U301.19 (INLB), U301.20 (INLC), U302.5
/b3_G: Q301.1 (G), SW301.2 (B)
/b3_IAJ: J303.1 (In), R309.1, R310.2
/b3_IBJ: J302.1 (In), R307.1, R308.2
/b3_NSLP: R305.2, R306.2, U301.24 (~SLEEP)
/b3_SOA: R309.2, U301.5 (SOA)
/b3_SOB: R307.2, U301.4 (SOB)
/b3_TH: R303.2, R304.1, U302.3 (+)
/b3_VS: Q301.3 (D), R305.1
/b4_DA: R401.1, R402.2, U401.3 (+)
/b4_DB: R403.1, R404.2, U401.5 (+)
/b4_DC: R405.1, R406.2
/b4_EAJ: J401.1 (In), R407.2
/b4_EAO: R407.1, U401.1, U401.2 (-)
/b4_EBJ: J402.1 (In), R408.2
/b4_EBO: R408.1, U401.6 (-), U401.7
/b5_QLA: R501.2, U504.1 (A)
/b7_AJ: J701.1 (In), R706.2
/b7_AN: R703.1, R704.2, R705.2, U701.4 (-IN)
/b7_AO: R705.1, R706.1, U701.1 (OUT)
/b7_AP: R701.1, R702.2, U701.3 (+IN)
/b8_PZ: J802.1, R801.2
/b8_VJ: J801.1 (In), R803.1
/b8_VN: C801.1, R801.1, R802.1, U801.4 (-IN)
/b8_VO: C801.2, R802.2, R803.2, U801.1 (OUT)
/b9_XJ: J901.1 (In), R903.1
/b9_XO: C901.2, R901.2, R903.2, U901.1 (OUT)
/b10_HAJ: J1001.1 (In), R1006.2
/b10_HAN: R1003.1, R1004.2, R1005.2, U1001.4 (-IN)
/b10_HAO: R1005.1, R1006.1, U1001.1 (OUT)
/b10_HAP: R1001.1, R1002.2, U1001.3 (+IN)
/b10_HBJ: J1002.1 (In), R1012.2
/b10_HBN: R1009.1, R1010.2, R1011.2, U1002.4 (-IN)
/b10_HBO: R1011.1, R1012.1, U1002.1 (OUT)
/b10_HBP: R1007.1, R1008.2, U1002.3 (+IN)
/b11_DN: R1102.2, R1103.2, U1102.4 (-IN)
/b11_DO: R1103.1, R1107.2, U1102.1 (OUT)
/b11_DP: R1104.1, R1105.2, R1106.2, U1102.3 (+IN)
/b11_IJ: J1101.1 (In), R1107.1
/b11_IO: R1102.1, U1101.5
/b12_DN: R1204.2, R1205.2, U1202.4 (-IN)
/b12_DO: R1205.1, R1208.2, U1202.1 (OUT)
/b12_DP: R1206.2, R1207.2, U1202.3 (+IN)
/b12_IJ: J1201.1 (In), R1208.1
/b12_IO: R1204.1, U1201.1
/b12_RFN: R1202.2, R1203.2, U1201.5 (REF)
GND: C101.2, C102.2, C104.2, C105.2, C106.2, C201.2, C301.1, C302.1, C304.1, C305.1, C401.2, C402.1, C501.2, C502.2, C503.2, C601.2, C602.1, C603.1, C1101.1, C1102.1, C1201.2, C1202.2, D101.2 (A2), D201.2 (A2), J101.A1 (GND), J101.A12 (GND), J101.B1 (GND), J101.B12 (GND), J101.SH (SHIELD), J102.2, J102.4, J201.2 (Ext), J202.2 (SLEEVE), J202.3 (SW), J301.2 (Ext), J302.2 (Ext), J303.2 (Ext), J305.3, J305.4, J401.2 (Ext), J402.2 (Ext), J701.2 (Ext), J801.2 (Ext), J802.2, J901.2 (Ext), J1001.2 (Ext), J1002.2 (Ext), J1101.2 (Ext), J1201.2 (Ext), LED201.1 (K), R101.1, R102.1, R103.2, R104.2, R202.2, R301.2, R303.1, R306.1, R402.1, R404.1, R406.1, R702.1, R704.1, R1002.1, R1004.1, R1008.1, R1010.1, R1105.1, R1106.1, R1203.1, R1207.1, SW301.1 (A), TP9901.1, TP9902.1, U101.1 (GND), U102.2 (GND), U301.9 (PGND), U301.16 (AGND), U301.25 (PGND), U302.2 (V-), U302.6 (SHDN), U501.4 (GND), U502.3 (GND), U503.3 (GND), U504.2 (K), U601.2 (SDX), U601.3 (SCX), U601.6 (GND), U601.7 (GND), U602.3 (GND), U801.3 (+IN), U901.3 (+IN), U1101.2 (GND), U1101.3 (REF2), U1101.4 (GND), U1201.2 (GND)

Notes on the sheet:
The MT6701's analog output (0-3.3 V a turn) less 1.65 V, times 0.51, by an OPA810: the shaft's angle without SSI.
tutorial Motors (+5 V, VMOT, +-5 V)
electrical power in; against the phase currents: the driver's losses; negative while the motor's energy comes back.
(tape, paint) on the bell's lower rim: an index pulse a turn, a tachometer with no encoder.
b2 motor supply, 5-12 V in
tutorial Motors (+-5 V)
cell (0,2)
cell (2,0)
The QRE1113 under the gimbal's rim (on b5), its collector held at 0 V by an OPA810: IDX = 4.7 k x Ic. Put a white mark
cell (3,3)
cells (1,3), (2,3)
USB-C power only: 5.1 k on each CC asks any source for 5 V. A 2 A PTC, a 5 V TVS (clamps at 9.2 V) and 20 uF.
LSM6DSO on SPI (mode 3): CS IMU on IO8, SCK IO4, MOSI IO7, MISO IO3, shared with the encoder through a 74LVC1G125
b12 bus current, INA181
The socket along the top carries +5, ground, -5, ground, +3.3: the bench's rails for a breadboard experiment.
0/+1 V
tutorial Motors (+3.3 V)
cell (0,1)
tutorial Motors
VMOT through 0.1 ohm to the driver; an INA181A1 (2.5 V on REF) and an OPA810 give I = 1 V/A both ways. With VM: the
cell (0,3)
IDX
amp with its +5 V removed draws nothing. The TPS7A2033 makes 3.3 V for the comparator and the lines that meet the FPGA.
a 6 x 2.5 mm diametric magnet on the shaft 0.5-2 mm above it. Two DRV5055A3 under the magnets, a QRE1113 under the rim.
SMBJ12A and 220 uF on VMOT take the braking energy a motor returns. VM: VMOT / 16 at high impedance.
The LM2664 charge pump makes -5 V for the op-amp tiles (40 mA: four tiles at 10 mA); it is not switched per tile, an op
back-EMF against the neutral (14 x EA in volts). Followed by an OPA2171. A spun gimbal motor makes a few volts.
IA, IB = SOA, SOB shifted to 0 by 3.3 k / 10 k to -5 V: 0.75 V/A from 2.5 k while each low side conducts. The motor on the terminal: C, B, A from the left.
cells (1,1), (2,1), (1,2), (2,2)
ground loops for the scope's clips, one per channel, in the board's margins
no mounting holes: four stick-on rubber feet, marked on the back
b11 phase current, INA240
5 V, times 0.39 (as AMOD-M's m9). The rotor's electrical angle without the encoder; hall-sensored commutation.
Each phase through 13 k / 1 k; with every phase floating the three dividers are the motor's ground, so EA and EB read the
COAST
and an OPA810 that takes the 2.5 V away: IPA = 1 V/A, the whole current. b3's IA sees only the low side's share.
EXPECT: VMOT = the larger of the barrel jack (5-12 V) and USB 5 V, each less a Schottky's 0.3-0.5 V; VM jack VMOT / 16
EXPECT: the MT6701's angle on SSI (14 bits a turn) and as a sawtooth to b7; two hall signals 120 electrical degrees apart to b10; an index pulse to b9
b4 back-EMF, OPA2171
Barrel jack (centre +), 5-12 V, through an SS34 into VMOT, as is USB's 5 V, so VMOT is about 4.6 V with no supply.
DRV8311H in 3x PWM from VMB: INHA IO5, INHB IO1, INHC IO2; EN from COAST through a TLV3501 (high: every phase floats).
(CS ENC on IO6). Gyro to 2000 dps, accelerometer to 16 g, to 6.66 kHz. On edge: a one-axis gimbal's level reference.
b3 BLDC driver, DRV8311H
EXPECT: VIB = -the piezo's charge / 1 nF above 160 Hz: the motor's cogging, its commutation ripple, the bearing
EXPECT: I = the driver's supply current, 1 V/A (+-1.2 A), negative while the motor brakes
A GBM2804H-100T class gimbal motor on four slots over an MT6701 (SSI on the Pmod; DO through b6's buffer onto MISO);
b8 vibration, OPA810
EXPECT: six axes on SPI (the tutorial's gateware reads them): with the board on edge, the roll about the motor's axis
b10 halls, DRV5055A3
VIB
cell (0,0)
EXPECT: +5 V from the USB-C (up to 1.5 A), -5 V at 40 mA, +3.3 V at 300 mA; the green LED says 5 V is in, the red one that -5 V is up
b6 IMU, LSM6DSO
ANG
EXPECT: the motor's phases at the duty cycles of IO5, IO1, IO2 (A, B, C); IA, IB = phase A's and B's currents (low side), 0.75 V/A; COAST high floats them
b1 power, USB-C 5 V in: +5, -5, +3.3 out
Phase A through 0.05 ohm between the driver and the motor; an INA240A1 (PWM rejection, common mode to 80 V) about 2.5 V
EXPECT: HA, HB = 9.75 mV/mT from the two halls under the rotor: two sinusoids 120 electrical degrees apart as it turns
tutorial Motors (+3.3 V, +5 V)
cell (3,2)
IPA
b7 angle, MT6701
b5 gimbal, MT6701
b9 index, QRE1113
cell (3,0)
EXPECT: EA, EB = phase A's and B's voltage / 14 against the neutral: with COAST high and the motor spun, its back-EMF
mount: the cogging at 12 a turn, the commutation's ripple, the bearing, the frame's resonances.
Its zero is the MT6701's (set by its registers over the SSI, or where the magnet sits).
cell (1,0)
EXPECT: IDX = 4.7 k x the sensor's current: a pulse once a turn as a white mark on the bell's rim passes
EXPECT: ANG = a sawtooth, -0.84 V to +0.84 V, once a turn of the shaft (0 at half a turn from the MT6701's zero)
EXPECT: IPA = phase A's whole current, 1 V/A both ways, through every PWM state (compare b3's IA: the low side only)
Two DRV5055A3 under the gimbal's magnets (b5), 17.1 degrees apart (120 electrical for 7 pole pairs); each less half its
A piezo disc on the terminal into an OPA810 charge amplifier (1 nF, 1 M: from 160 Hz). Stick the disc to the motor's
cell (3,1)

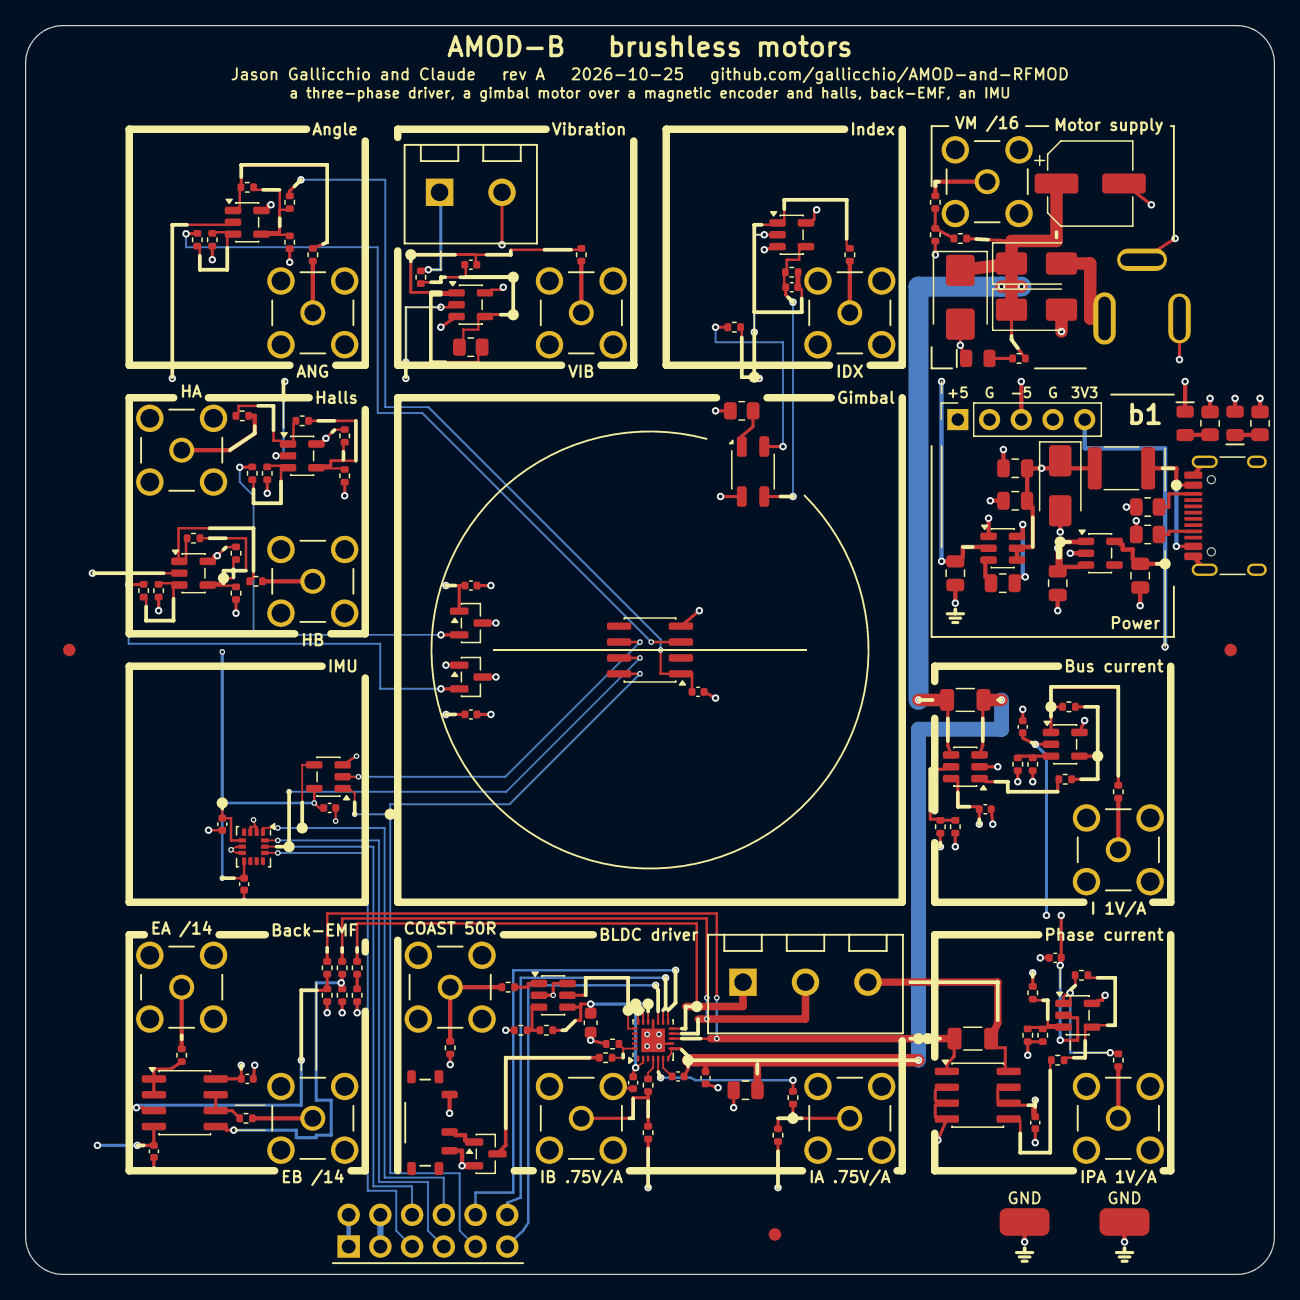
[picture p242: board amod_b.kicad_pcb from above]

Board: 4 copper layers, 100.0 x 100.0 mm, 147 parts (0 on the bottom side), 86 nets.
