gallicchio/AMOD-and-RFMOD/hardware/phmod.kicad_pcb

## KiCad design hardware/phmod.kicad_pcb (2026-10-30)

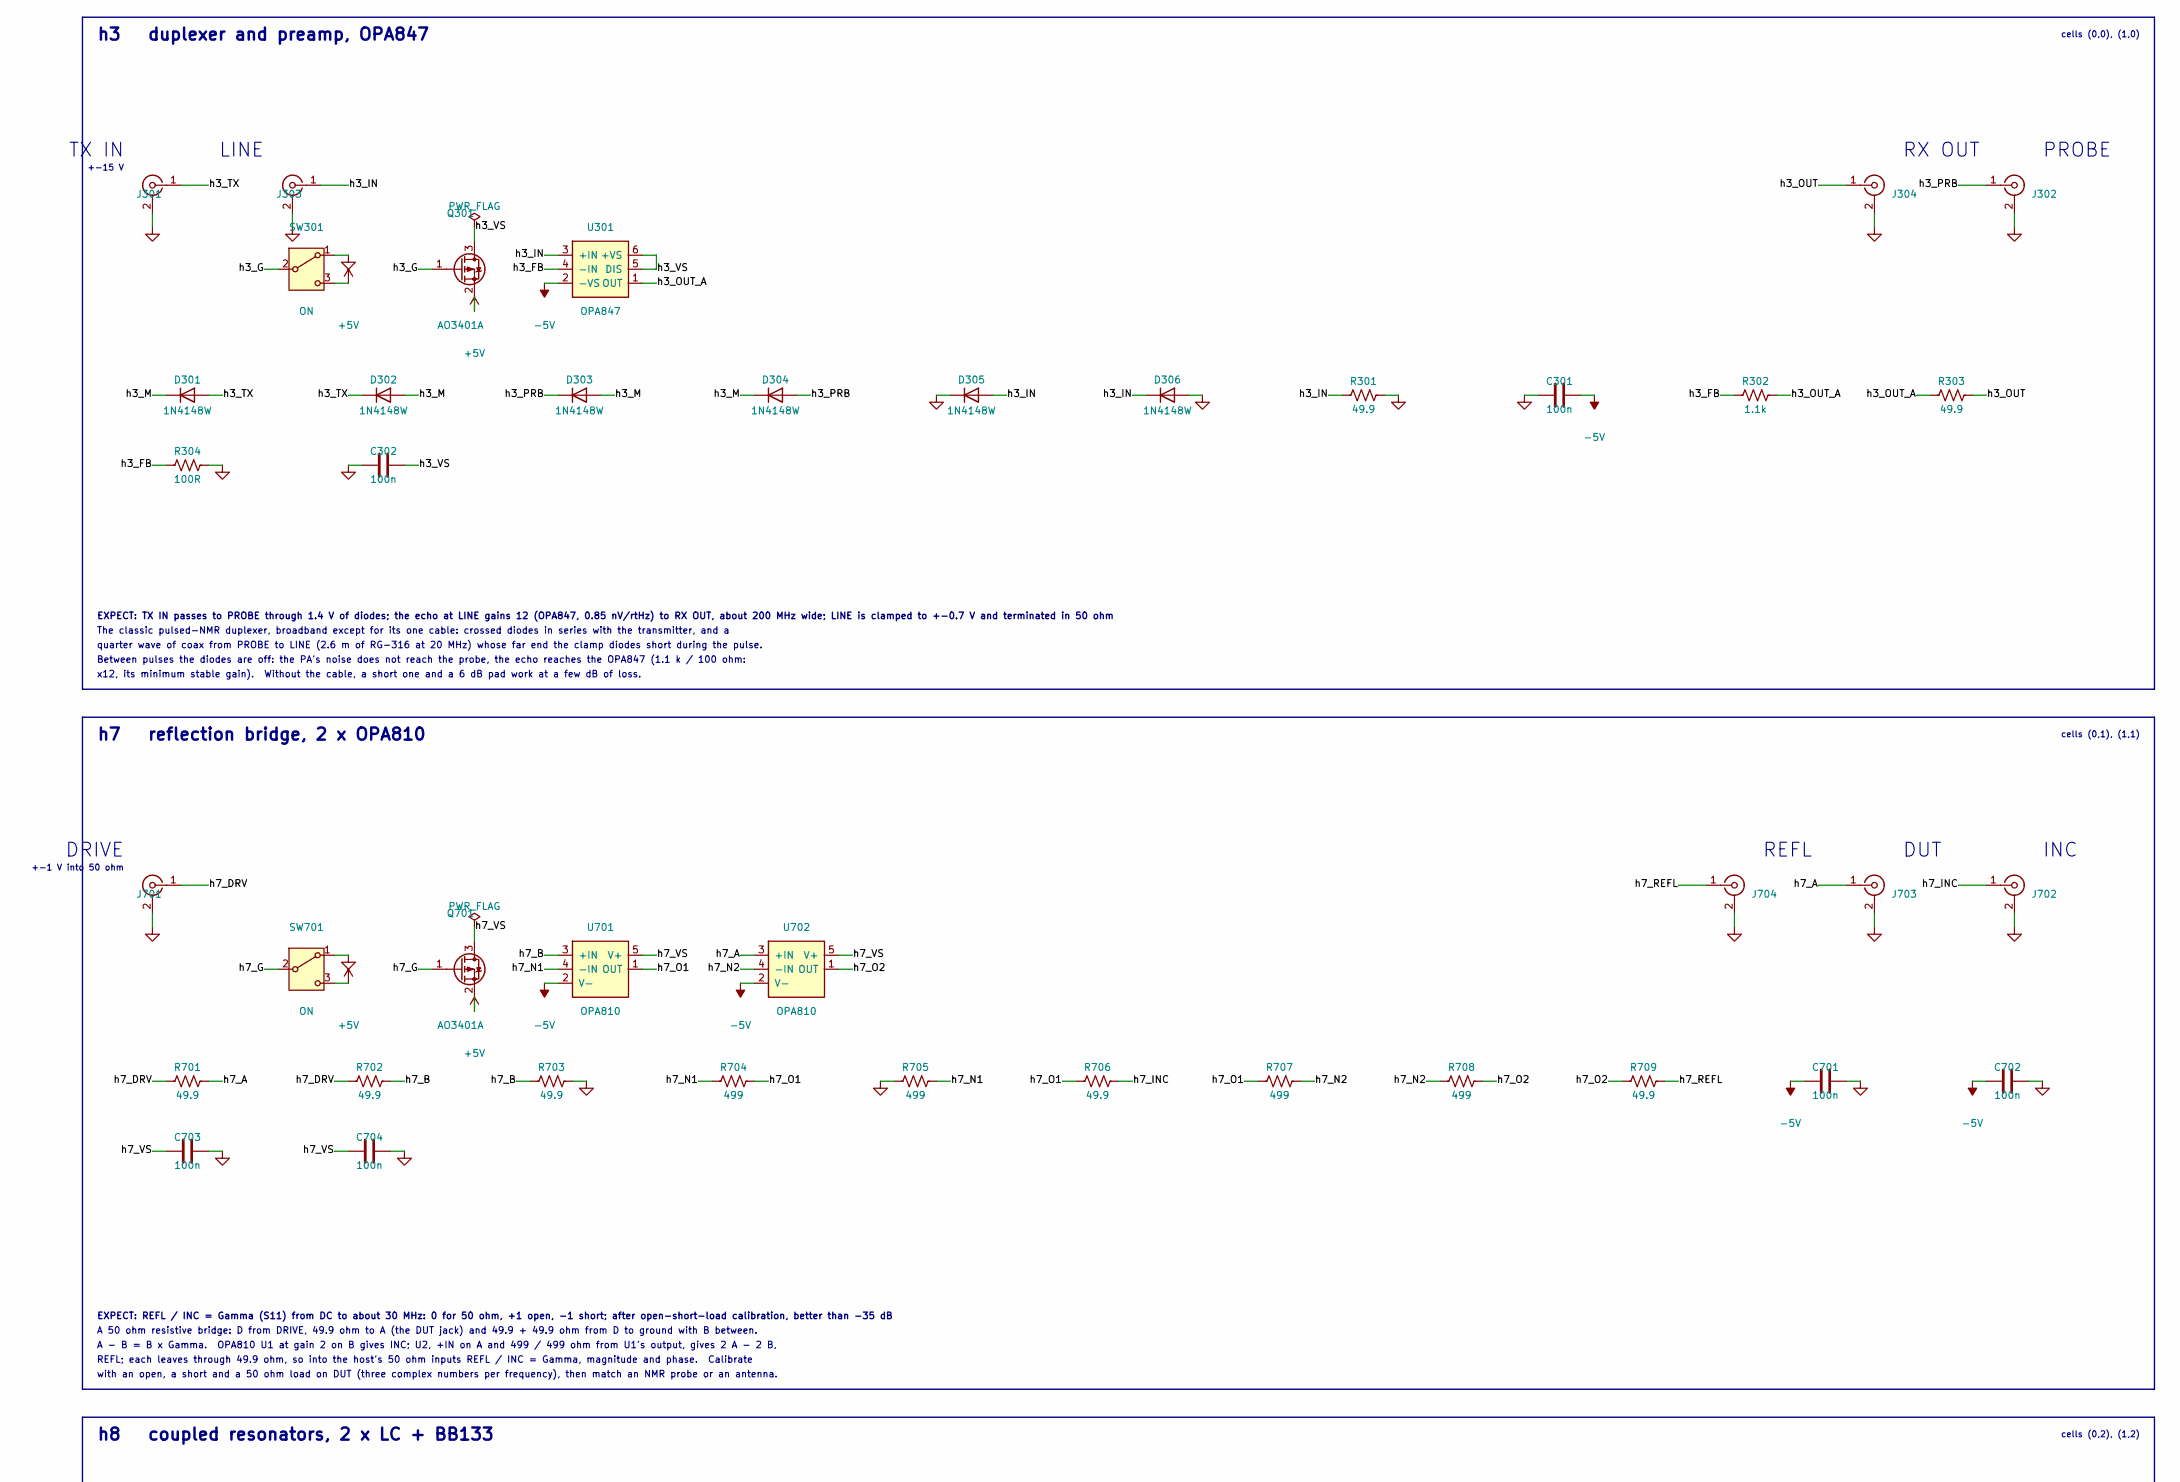
[picture p243: schematic phmod.kicad_sch, PhMOD: magnetic resonance, the ionosphere and light, part in row 1, column 1]

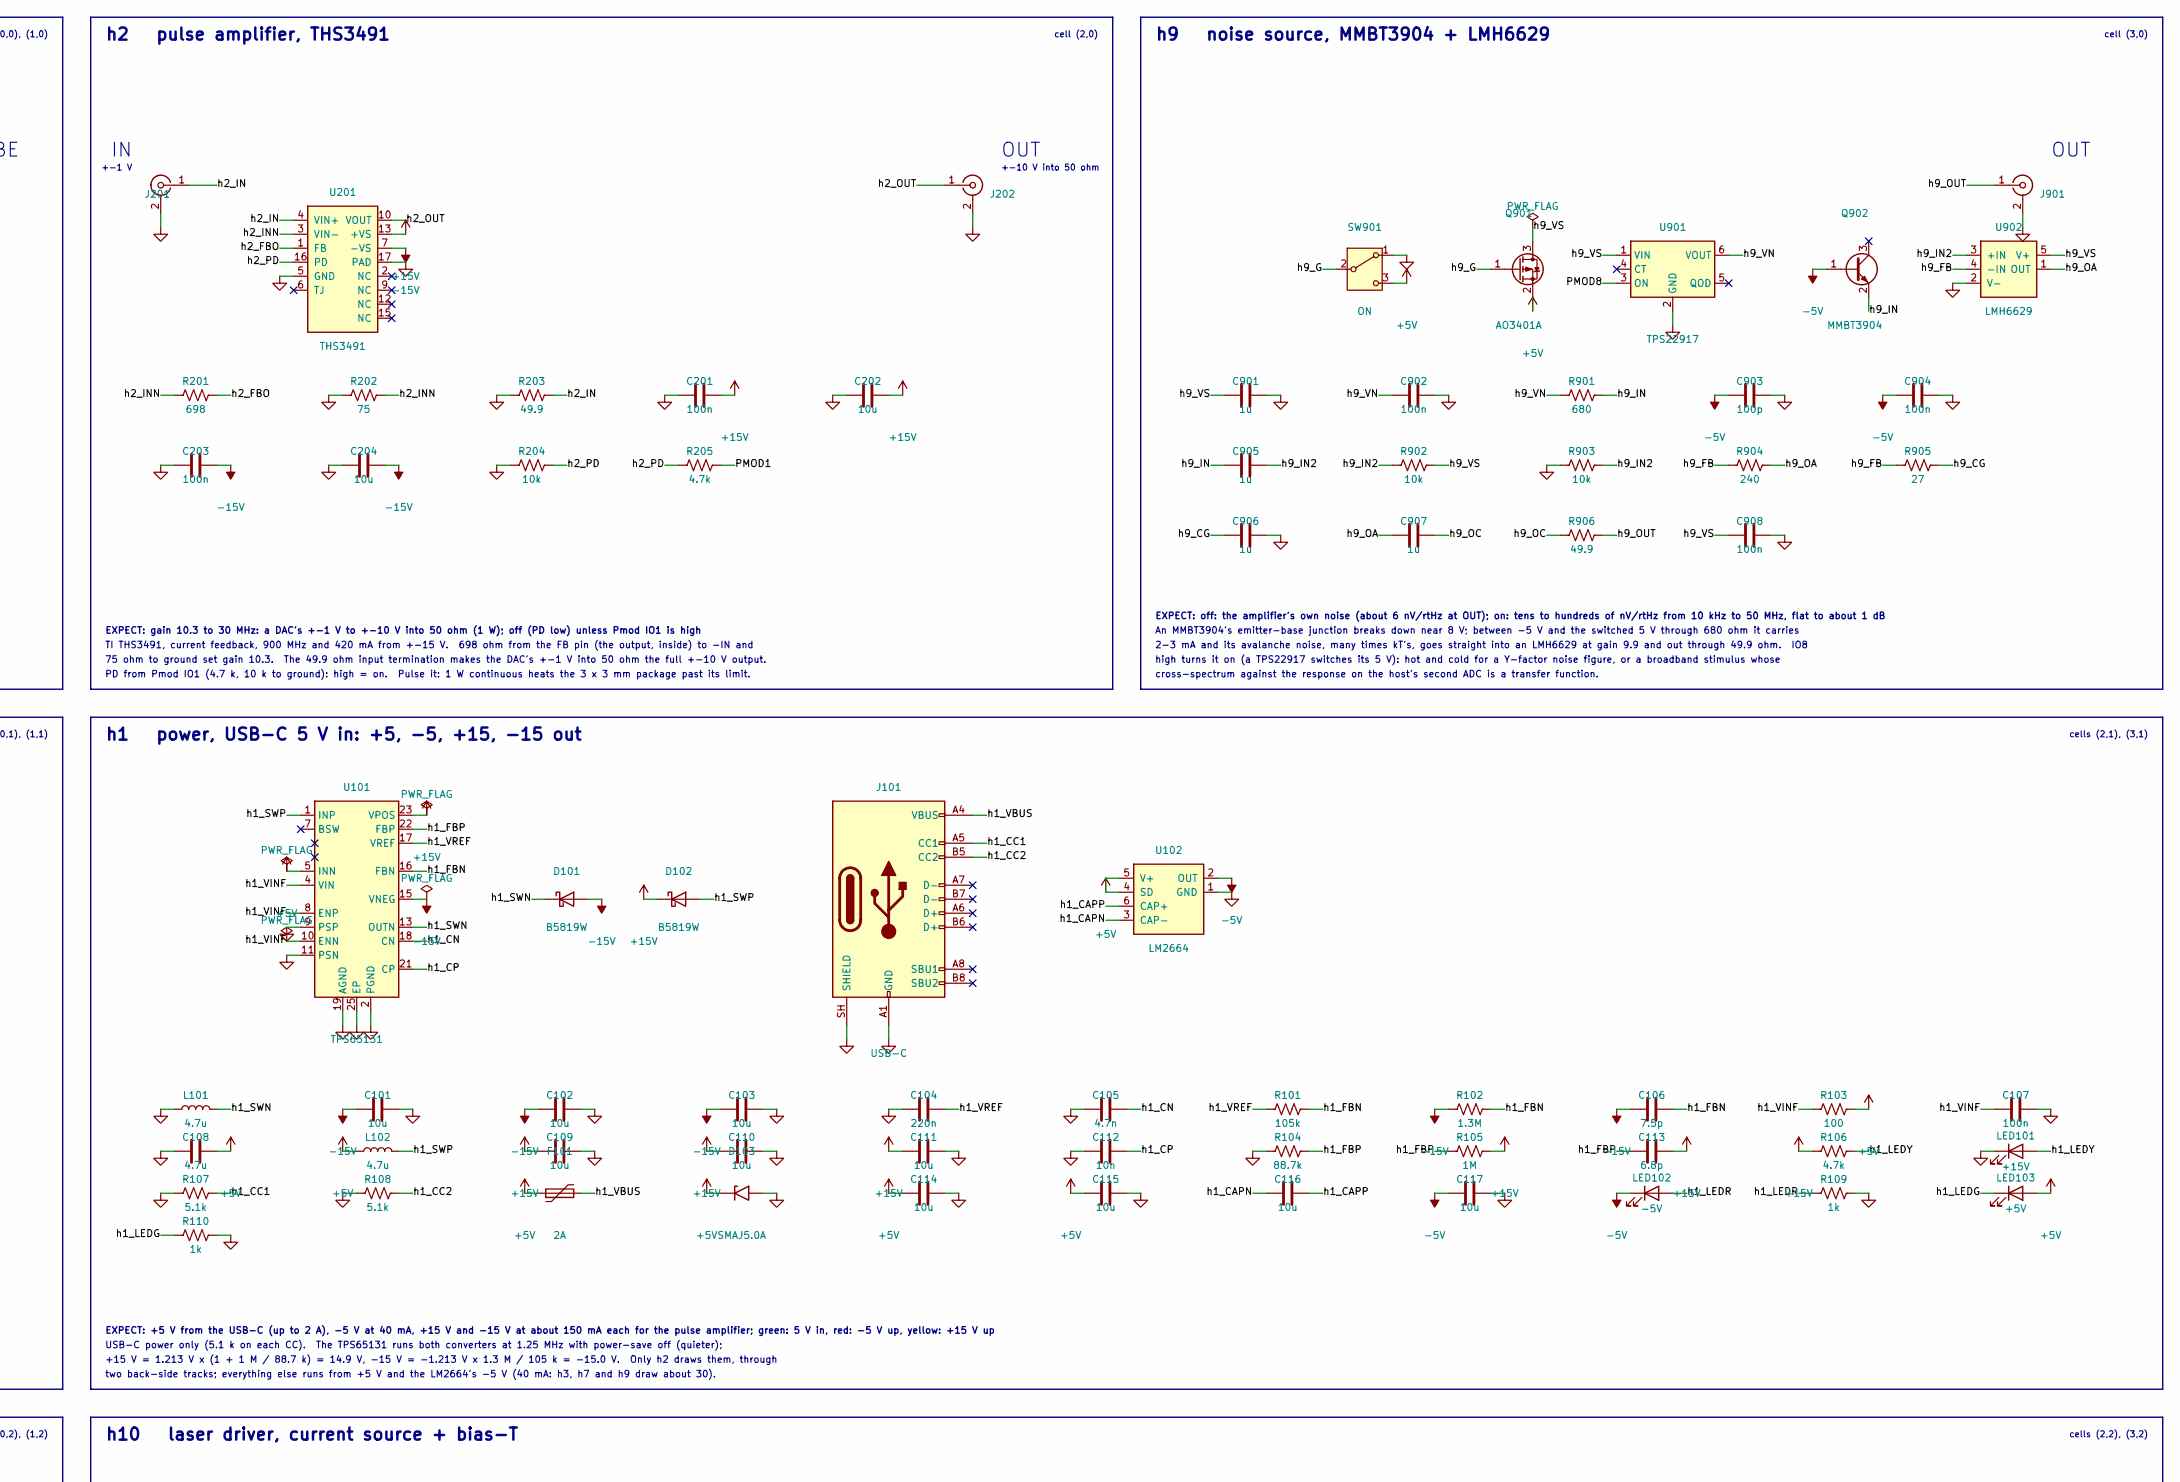
[picture p244: schematic phmod.kicad_sch, PhMOD: magnetic resonance, the ionosphere and light, part in row 1, column 2]

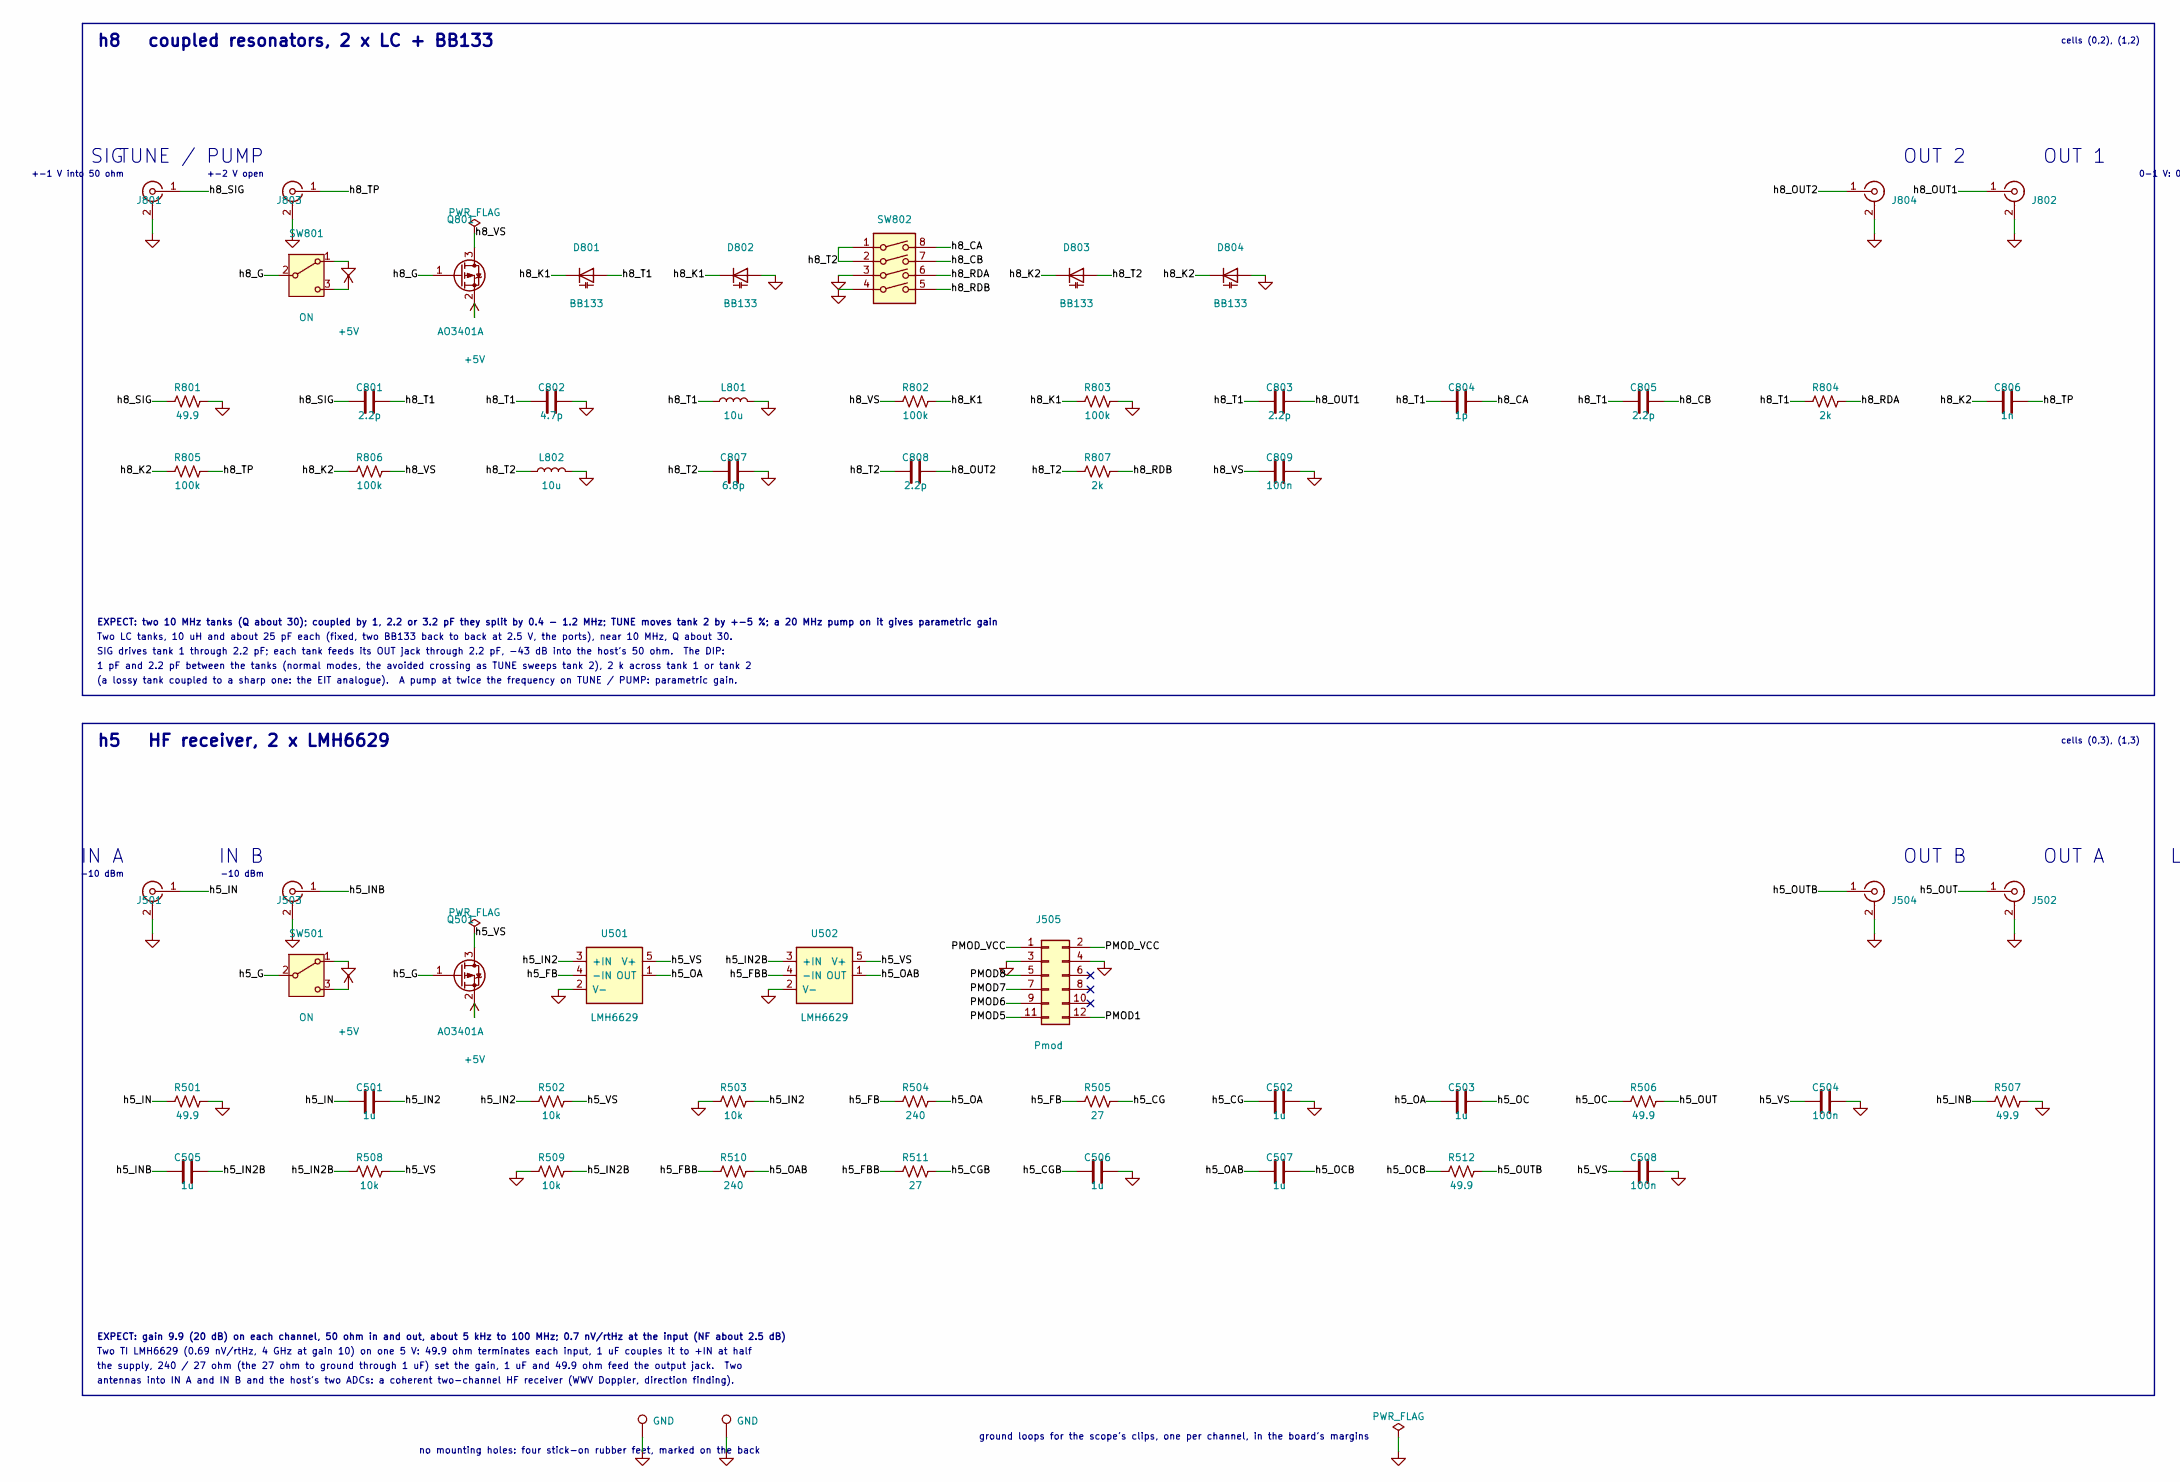
[picture p245: schematic phmod.kicad_sch, PhMOD: magnetic resonance, the ionosphere and light, part in row 2, column 1]

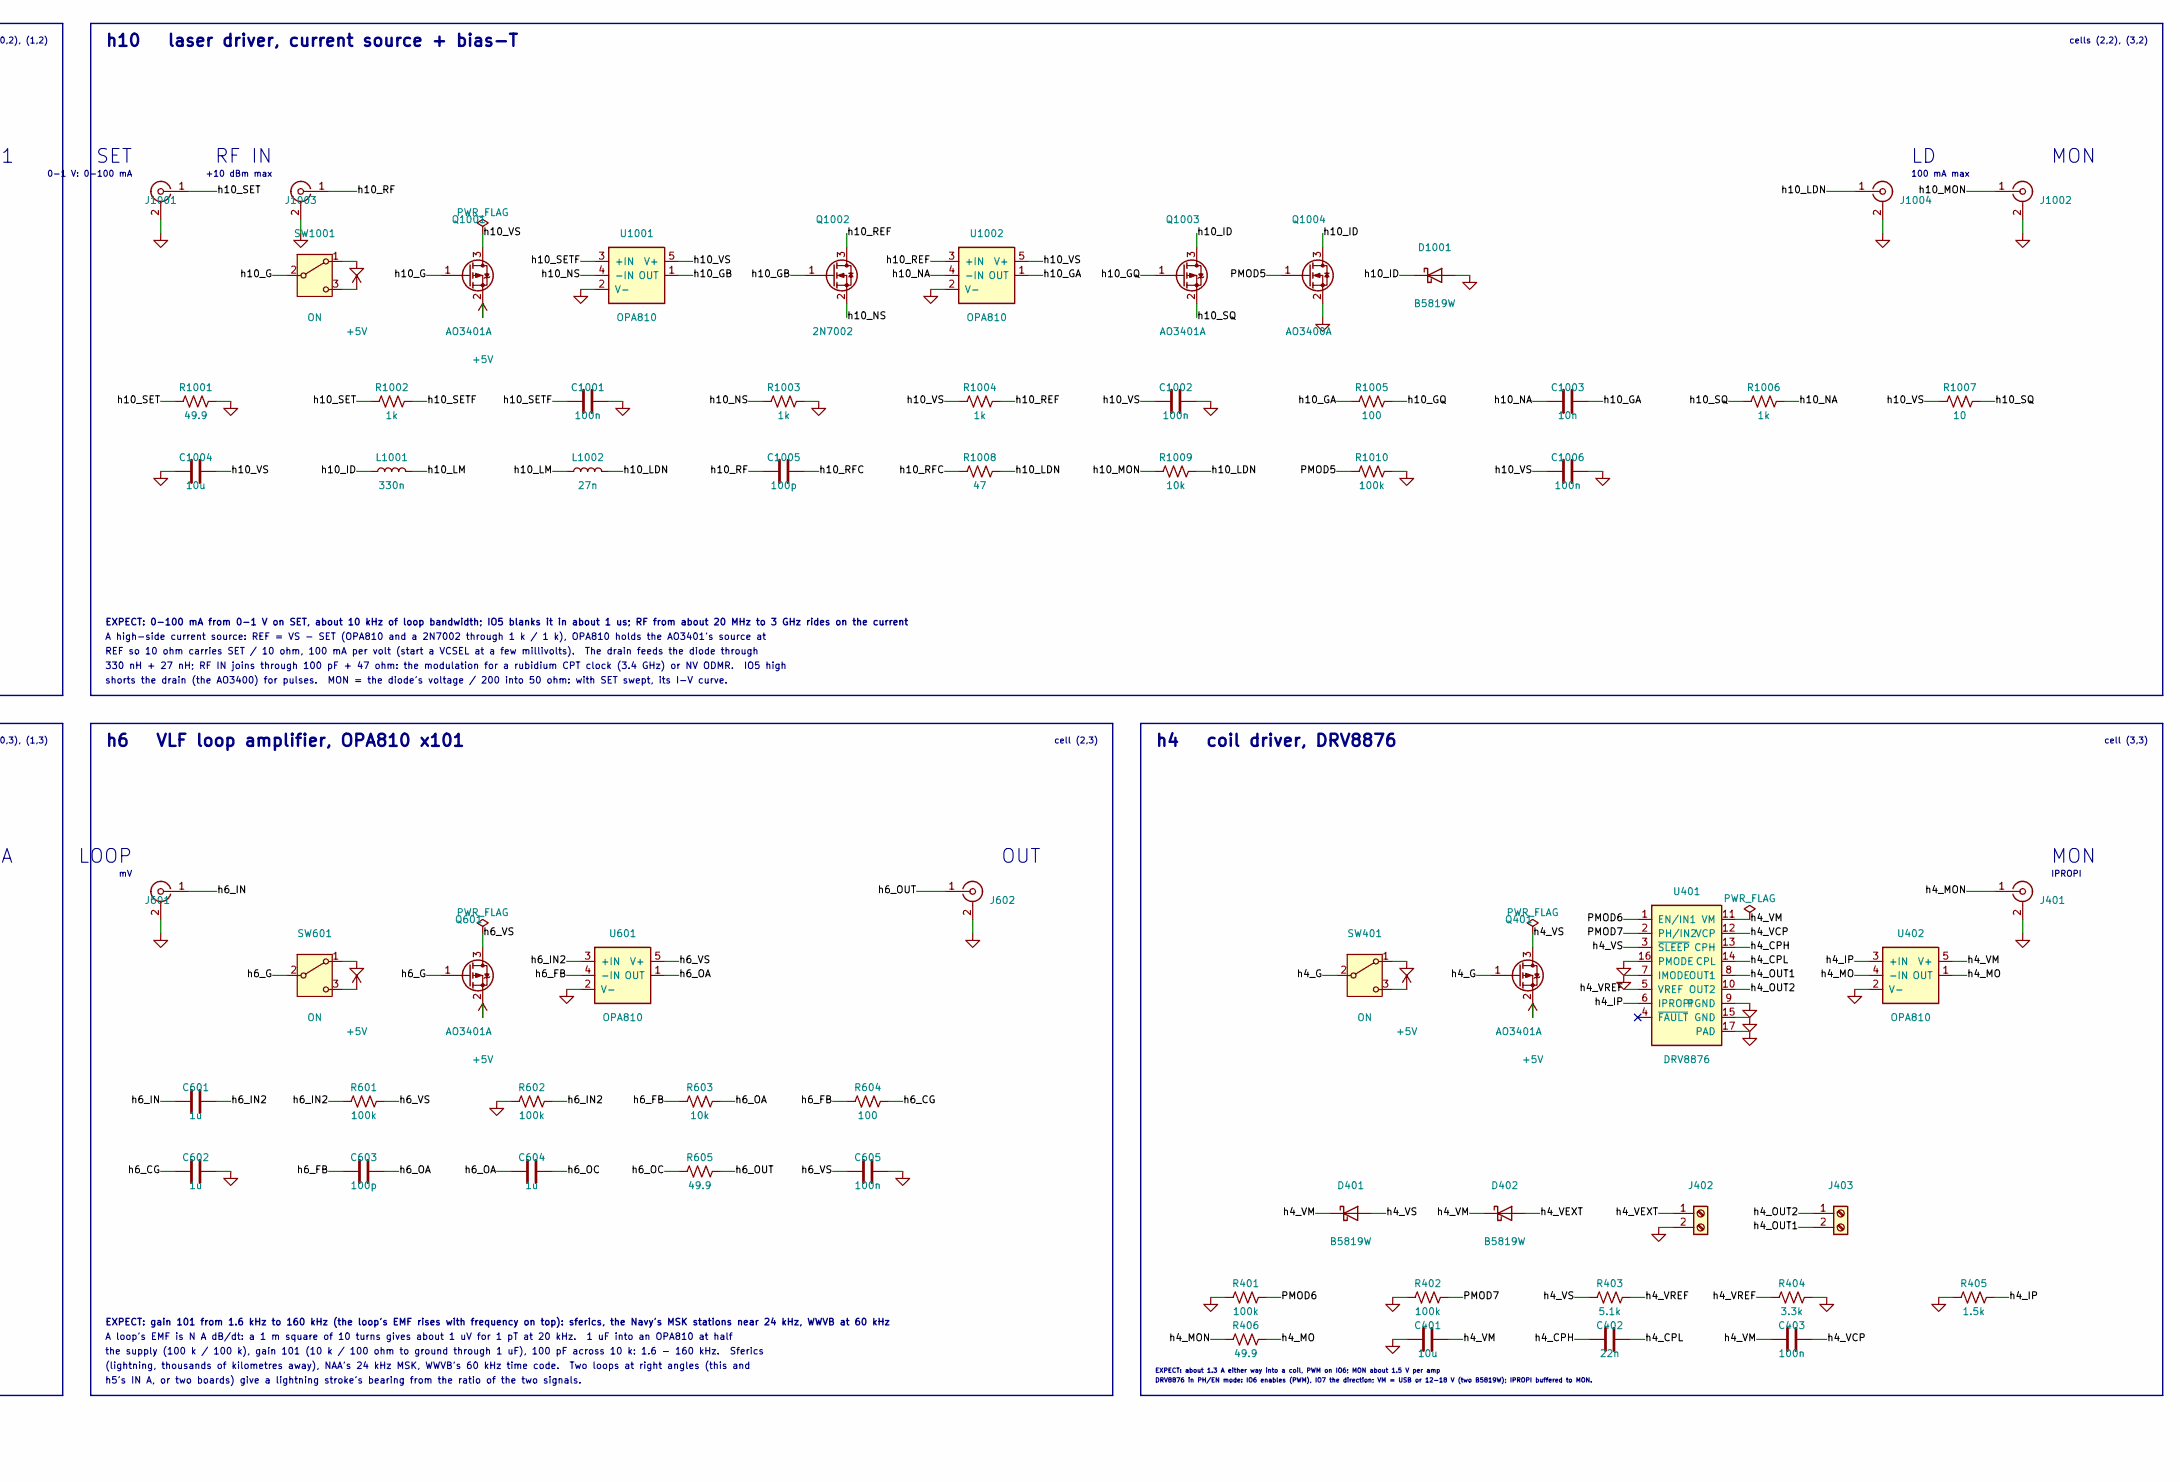
[picture p246: schematic phmod.kicad_sch, PhMOD: magnetic resonance, the ionosphere and light, part in row 2, column 2]

Parts:
C101, C102, C103, C109, C110, C111, C114, C115, C116, C117, C202, C204, C401, C1004: 10u; C_0805_2012Metric; MPN CL21A106KAYNNNE; LCSC C15850
C104: 220n; C_0402_1005Metric; MPN CL05B224KO5NNNC; LCSC C16772
C105: 4.7n; C_0402_1005Metric; MPN CL05B472KB5NNNC; LCSC C84705
C106: 7.5p; C_0402_1005Metric; MPN 0402CG7R5C500NT; LCSC C43514
C107, C201, C203, C403, C504, C508, C605, C701, C702, C703, C704, C809, C902, C904, C908, C1001, C1002, C1006: 100n; C_0402_1005Metric; MPN CL05B104KO5NNNC; LCSC C1525
C108: 4.7u; C_0805_2012Metric; MPN CL21A475KAQNNNE; LCSC C1779
C112, C1003: 10n; C_0402_1005Metric; MPN CL05B103KB5NNNC; LCSC C15195
C113, C807: 6.8p; C_0402_1005Metric; MPN 0402CG6R8C500NT; LCSC C1576
C301, C302: 100n; C_0603_1608Metric; MPN CC0603KRX7R9BB104; LCSC C14663
C402: 22n; C_0402_1005Metric; MPN CL05B223KB5NNNC; LCSC C337699
C501, C502, C503, C505, C506, C507, C601, C602, C604, C901, C905, C906, C907: 1u; C_0402_1005Metric; MPN CL05A105KP5NNNC; LCSC C14445
C603, C903, C1005: 100p; C_0402_1005Metric; MPN 0402CG101J500NT; LCSC C1546
C801, C803, C805, C808: 2.2p; C_0402_1005Metric; MPN 0402CG2R2C500NT; LCSC C1559
C802: 4.7p; C_0402_1005Metric; MPN 0402CG4R7C500NT; LCSC C1569
C804: 1p; C_0402_1005Metric; MPN 0402CG1R0C500NT; LCSC C1550
C806: 1n; C_0402_1005Metric; MPN 0402B102K500NT; LCSC C1523
D101, D102, D401, D402, D1001: B5819W; D_SOD-123; MPN B5819W; LCSC C64885
D103: SMAJ5.0A; D_SMA; MPN SMAJ5.0A; LCSC C78401
D301, D302, D303, D304, D305, D306: 1N4148W; D_SOD-123; MPN 1N4148W; LCSC C81598
D801, D802, D803, D804: BB133; D_SOD-323; MPN BB133; LCSC C5334579
F101: 2A; Fuse_1812_4532Metric; MPN MF-MSMF200-2; LCSC C210837
J101: USB-C; USB_C_Receptacle_HRO_TYPE-C-31-M-12; MPN TYPE-C-31-M-12; LCSC C165948
J201, J202, J301, J302, J303, J304, J401, J501, J502, J503, J504, J601, J602, J701, J702, J703, J704, J801, J802, J803, J804, J901, J1001, J1002, J1003, J1004: SMA; SMA_BWSMA-KE-Z001_Vertical; MPN BWSMA-KE-Z001; LCSC C496549
J402: VM in; TerminalBlock_KF301_1x02_P5.00mm; MPN KF301-5.0-2P; LCSC C474881
J403: coil; TerminalBlock_KF301_1x02_P5.00mm; MPN KF301-5.0-2P; LCSC C474881
J505: Pmod; PinHeader_2x06_P2.54mm_Horizontal_PZ254R-12-12P; MPN PZ254R-12-12P; LCSC C492434
L101, L102: 4.7u; L_4x4_XRNR4030; MPN SWPA4030S4R7MT; LCSC C57269
L801, L802: 10u; L_1210_3225Metric; MPN NLV32T-100J-PF; LCSC C76835
L1001: 330n; L_0805_2012Metric; MPN SDWL2012CR33JSTF; LCSC C98210
L1002: 27n; L_0402_1005Metric; MPN LQW15AN27NG80D; LCSC C882469
LED101: +15V; LED_0805_2012Metric_Kbar; MPN KT-0805Y; LCSC C2296
LED102: -5V; LED_0805_2012Metric_Kbar; MPN NCD0805R1; LCSC C84256
LED103: +5V; LED_0805_2012Metric_Kbar; MPN KT-0805G; LCSC C2297
Q301, Q401, Q501, Q601, Q701, Q801, Q901, Q1001, Q1003: AO3401A; SOT-23; MPN AO3401A; LCSC C15127
Q902: MMBT3904; SOT-23; MPN MMBT3904(RANGE:100-300); LCSC C20526
Q1002: 2N7002; SOT-23; MPN 2N7002; LCSC C8545
Q1004: AO3400A; SOT-23; MPN AO3400A; LCSC C20917
R101: 105k; R_0402_1005Metric; MPN 0402WGF1053TCE; LCSC C25742
R102: 1.3M; R_0402_1005Metric; MPN 0402WGF1304TCE; LCSC C423245
R103, R604, R1005: 100; R_0402_1005Metric; MPN 0402WGF1000TCE; LCSC C25076
R104: 88.7k; R_0402_1005Metric; MPN 0402WGF8872TCE; LCSC C25922
R105: 1M; R_0402_1005Metric; MPN 0402WGF1004TCE; LCSC C26083
R106: 4.7k; R_0805_2012Metric; MPN 0805W8F4701T5E; LCSC C17673
R107, R108: 5.1k; R_0805_2012Metric; MPN 0805W8F5101T5E; LCSC C27834
R109, R110: 1k; R_0805_2012Metric; MPN 0805W8F1001T5E; LCSC C17513
R201: 698; R_0402_1005Metric; MPN 0402WGF6980TCE; LCSC C33359
R202: 75; R_0402_1005Metric; MPN 0402WGF750JTCE; LCSC C25133
R203, R301, R406, R501, R506, R507, R512, R605, R701, R702, R703, R706, R709, R801, R906, R1001: 49.9; R_0402_1005Metric; MPN CRCW040249R9FKEDHP; LCSC C844112
R204, R502, R503, R508, R509, R603, R902, R903, R1009: 10k; R_0402_1005Metric; MPN 0402WGF1002TCE; LCSC C25744
R205: 4.7k; R_0402_1005Metric; MPN 0402WGF4701TCE; LCSC C25900
R302: 1.1k; R_0603_1608Metric; MPN 0603WAF1101T5E; LCSC C22764
R303: 49.9; R_0603_1608Metric; MPN SR0603FR-7T49R9L; LCSC C6230117
R304: 100R; R_0603_1608Metric; MPN 0603WAF1000T5E; LCSC C22775
R401, R402, R601, R602, R802, R803, R805, R806, R1010: 100k; R_0402_1005Metric; MPN 0402WGF1003TCE; LCSC C25741
R403: 5.1k; R_0402_1005Metric; MPN 0402WGF5101TCE; LCSC C25905
R404: 3.3k; R_0402_1005Metric; MPN 0402WGF3301TCE; LCSC C25890
R405: 1.5k; R_0402_1005Metric; MPN 0402WGF1501TCE; LCSC C25867
R504, R510, R904: 240; R_0402_1005Metric; MPN 0402WGF2400TCE; LCSC C25094
R505, R511, R905: 27; R_0402_1005Metric; MPN CR0402FF27R0G; LCSC C100353
R704, R705, R707, R708: 499; R_0402_1005Metric; MPN 0402WGF4990TCE; LCSC C4125
R804, R807: 2k; R_0402_1005Metric; MPN 0402WGF2001TCE; LCSC C4109
R901: 680; R_0402_1005Metric; MPN 0402WGF6800TCE; LCSC C25130
R1002, R1003, R1004, R1006: 1k; R_0402_1005Metric; MPN 0402WGF1001TCE; LCSC C11702
R1007: 10; R_0805_2012Metric; MPN 0805W8F100JT5E; LCSC C17415
R1008: 47; R_0402_1005Metric; MPN 0402WGF470JTCE; LCSC C25118
SW301, SW401, SW501, SW601, SW701, SW801, SW901, SW1001: ON; SW_SPDT_Shouhan_MSK12C02; MPN MSK12C02; LCSC C431540
SW802: DIP4; SW_DIP_SPSTx04_Slide_1.27mm_DSHP04; MPN DSHP04TSGET; LCSC C40736
TP9901, TP9902: GND; TestPoint_Loop_RH-5019; MPN RH-5019; LCSC C5199800
U101: TPS65131; QFN-24-1EP_4x4mm_P0.5mm_EP2.7x2.7mm; MPN TPS65131RGER; LCSC C87663
U102: LM2664; SOT-23-6; MPN LM2664M6X/NOPB; LCSC C108573
U201: THS3491; QFN-16-1EP_3x3mm_P0.5mm_EP1.7x1.7mm; MPN THS3491IRGTR; LCSC C2058688
U301: OPA847; SOT-23-6; MPN OPA847IDBVT; LCSC C2059024
U401: DRV8876; HTSSOP-16-1EP_4.4x5mm_P0.65mm_EP3.4x5mm_Mask2.66x2.46mm; MPN DRV8876PWPR; LCSC C575551
U402, U601, U701, U702, U1001, U1002: OPA810; SOT-23-5; MPN OPA810IDBVR; LCSC C2833513
U501, U502, U902: LMH6629; SOT-23-5; MPN LMH6629MFX/NOPB; LCSC C2059678
U901: TPS22917; SOT-23-6; MPN TPS22917DBVR; LCSC C2681320

Connections:
+5V: C108.2, C114.1, C115.1, D103.1 (A1), F101.1, L102.1, LED103.2 (A), Q301.2 (S), Q401.2 (S), Q501.2 (S), Q601.2 (S), Q701.2 (S), Q801.2 (S), Q901.2 (S), Q1001.2 (S), R103.2, SW301.3 (C), SW401.3 (C), SW501.3 (C), SW601.3 (C), SW701.3 (C), SW801.3 (C), SW901.3 (C), SW1001.3 (C), U101.5 (INN), U101.6 (INN), U102.4 (SD), U102.5 (V+)
+15V: C109.1, C110.1, C111.1, C113.2, C201.2, C202.2, D102.1 (K), R105.2, R106.1, U101.23 (VPOS), U201.13 (+VS), U201.14 (+VS)
-5V: C117.1, C301.2, C701.1, C702.1, C903.1, C904.1, LED102.1 (K), Q902.1 (B), U102.2 (OUT), U301.2 (-VS), U701.2 (V-), U702.2 (V-)
-15V: C101.1, C102.1, C103.1, C106.1, C203.2, C204.2, D101.2 (A), R102.1, U101.15 (VNEG), U201.7 (-VS), U201.8 (-VS)
/PMOD1: J505.12, R205.2
/PMOD5: J505.11, Q1004.1 (G), R1010.1
/PMOD6: J505.9, R401.2, U401.1 (EN/IN1)
/PMOD7: J505.7, R402.2, U401.2 (PH/IN2)
/PMOD8: J505.5, U901.3 (ON)
/PMOD_VCC: J505.1, J505.2
/h1_CAPN: C116.1, U102.3 (CAP-)
/h1_CAPP: C116.2, U102.6 (CAP+)
/h1_CC1: J101.A5 (CC1), R107.2
/h1_CC2: J101.B5 (CC2), R108.2
/h1_CN: C105.2, U101.18 (CN)
/h1_CP: C112.2, U101.21 (CP)
/h1_FBN: C106.2, R101.2, R102.2, U101.16 (FBN)
/h1_FBP: C113.1, R104.2, R105.1, U101.22 (FBP)
/h1_LEDG: LED103.1 (K), R110.1
/h1_LEDR: LED102.2 (A), R109.1
/h1_LEDY: LED101.2 (A), R106.2
/h1_SWN: D101.1 (K), L101.2, U101.13 (OUTN), U101.14 (OUTN)
/h1_SWP: D102.2 (A), L102.2, U101.1 (INP), U101.24 (INP)
/h1_VBUS: F101.2, J101.A4 (VBUS), J101.A9 (VBUS), J101.B4 (VBUS), J101.B9 (VBUS)
/h1_VINF: C107.1, R103.1, U101.4 (VIN), U101.8 (ENP), U101.10 (ENN)
/h1_VREF: C104.2, R101.1, U101.17 (VREF)
/h2_FBO: R201.2, U201.1 (FB)
/h2_IN: J201.1 (In), R203.2, U201.4 (VIN+)
/h2_INN: R201.1, R202.2, U201.3 (VIN-)
/h2_OUT: J202.1 (In), U201.10 (VOUT), U201.11 (VOUT)
/h2_PD: R204.2, R205.1, U201.16 (PD)
/h3_FB: R302.1, R304.1, U301.4 (-IN)
/h3_G: Q301.1 (G), SW301.2 (B)
/h3_IN: D305.2 (A), D306.1 (K), J303.1 (In), R301.1, U301.3 (+IN)
/h3_M: D301.1 (K), D302.2 (A), D303.2 (A), D304.1 (K)
/h3_OUT: J304.1 (In), R303.2
/h3_OUT_A: R302.2, R303.1, U301.1 (OUT)
/h3_PRB: D303.1 (K), D304.2 (A), J302.1 (In)
/h3_TX: D301.2 (A), D302.1 (K), J301.1 (In)
/h3_VS: C302.2, Q301.3 (D), U301.5 (DIS), U301.6 (+VS)
/h4_CPH: C402.1, U401.13 (CPH)
/h4_CPL: C402.2, U401.14 (CPL)
/h4_G: Q401.1 (G), SW401.2 (B)
/h4_IP: R405.2, U401.6 (IPROPI), U402.3 (+IN)
/h4_MO: R406.2, U402.1 (OUT), U402.4 (-IN)
/h4_MON: J401.1 (In), R406.1
/h4_OUT1: J403.2, U401.8 (OUT1)
/h4_OUT2: J403.1, U401.10 (OUT2)
/h4_VCP: C403.2, U401.12 (VCP)
/h4_VEXT: D402.2 (A), J402.1
/h4_VM: C401.2, C403.1, D401.1 (K), D402.1 (K), U401.11 (VM), U402.5 (V+)
/h4_VREF: R403.2, R404.1, U401.5 (VREF)
/h4_VS: D401.2 (A), Q401.3 (D), R403.1, U401.3 (~SLEEP)
/h5_CG: C502.1, R505.2
/h5_CGB: C506.1, R511.2
/h5_FB: R504.1, R505.1, U501.4 (-IN)
/h5_FBB: R510.1, R511.1, U502.4 (-IN)
/h5_G: Q501.1 (G), SW501.2 (B)
/h5_IN: C501.1, J501.1 (In), R501.1
/h5_IN2: C501.2, R502.1, R503.2, U501.3 (+IN)
/h5_IN2B: C505.2, R508.1, R509.2, U502.3 (+IN)
/h5_INB: C505.1, J503.1 (In), R507.1
/h5_OA: C503.1, R504.2, U501.1 (OUT)
/h5_OAB: C507.1, R510.2, U502.1 (OUT)
/h5_OC: C503.2, R506.1
/h5_OCB: C507.2, R512.1
/h5_OUT: J502.1 (In), R506.2
/h5_OUTB: J504.1 (In), R512.2
/h5_VS: C504.1, C508.1, Q501.3 (D), R502.2, R508.2, U501.5 (V+), U502.5 (V+)
/h6_CG: C602.1, R604.2
/h6_FB: C603.1, R603.1, R604.1, U601.4 (-IN)
/h6_G: Q601.1 (G), SW601.2 (B)
/h6_IN: C601.1, J601.1 (In)
/h6_IN2: C601.2, R601.1, R602.2, U601.3 (+IN)
/h6_OA: C603.2, C604.1, R603.2, U601.1 (OUT)
/h6_OC: C604.2, R605.1
/h6_OUT: J602.1 (In), R605.2
/h6_VS: C605.1, Q601.3 (D), R601.2, U601.5 (V+)
/h7_A: J703.1 (In), R701.2, U702.3 (+IN)
/h7_B: R702.2, R703.1, U701.3 (+IN)
/h7_DRV: J701.1 (In), R701.1, R702.1
/h7_G: Q701.1 (G), SW701.2 (B)
/h7_INC: J702.1 (In), R706.2
/h7_N1: R704.1, R705.2, U701.4 (-IN)
/h7_N2: R707.2, R708.1, U702.4 (-IN)
/h7_O1: R704.2, R706.1, R707.1, U701.1 (OUT)
/h7_O2: R708.2, R709.1, U702.1 (OUT)
/h7_REFL: J704.1 (In), R709.2
/h7_VS: C703.1, C704.1, Q701.3 (D), U701.5 (V+), U702.5 (V+)
/h8_CA: C804.2, SW802.8
/h8_CB: C805.2, SW802.7
/h8_G: Q801.1 (G), SW801.2 (B)
/h8_K1: D801.1 (K), D802.1 (K), R802.2, R803.1
/h8_K2: C806.1, D803.1 (K), D804.1 (K), R805.1, R806.1
/h8_OUT1: C803.2, J802.1 (In)
/h8_OUT2: C808.2, J804.1 (In)
/h8_RDA: R804.2, SW802.6
/h8_RDB: R807.2, SW802.5
/h8_SIG: C801.1, J801.1 (In), R801.1
/h8_T1: C801.2, C802.1, C803.1, C804.1, C805.1, D801.2 (A), L801.1, R804.1
/h8_T2: C807.1, C808.1, D803.2 (A), L802.1, R807.1, SW802.1, SW802.2
/h8_TP: C806.2, J803.1 (In), R805.2
/h8_VS: C809.1, Q801.3 (D), R802.1, R806.2
/h9_CG: C906.1, R905.2
/h9_FB: R904.1, R905.1, U902.4 (-IN)
/h9_G: Q901.1 (G), SW901.2 (B)
/h9_IN: C905.1, Q902.2 (E), R901.2
/h9_IN2: C905.2, R902.1, R903.2, U902.3 (+IN)
/h9_OA: C907.1, R904.2, U902.1 (OUT)
/h9_OC: C907.2, R906.1
/h9_OUT: J901.1 (In), R906.2
/h9_VN: C902.1, R901.1, U901.6 (VOUT)
/h9_VS: C901.1, C908.1, Q901.3 (D), R902.2, U901.1 (VIN), U902.5 (V+)
/h10_G: Q1001.1 (G), SW1001.2 (B)
/h10_GA: C1003.2, R1005.1, U1002.1 (OUT)
/h10_GB: Q1002.1 (G), U1001.1 (OUT)
/h10_GQ: Q1003.1 (G), R1005.2
/h10_ID: D1001.1 (K), L1001.1, Q1003.3 (D), Q1004.3 (D)
/h10_LDN: J1004.1 (In), L1002.2, R1008.2, R1009.2
/h10_LM: L1001.2, L1002.1
/h10_MON: J1002.1 (In), R1009.1
/h10_NA: C1003.1, R1006.2, U1002.4 (-IN)
/h10_NS: Q1002.2 (S), R1003.1, U1001.4 (-IN)
/h10_REF: Q1002.3 (D), R1004.2, U1002.3 (+IN)
/h10_RF: C1005.1, J1003.1 (In)
/h10_RFC: C1005.2, R1008.1
/h10_SET: J1001.1 (In), R1001.1, R1002.1
/h10_SETF: C1001.1, R1002.2, U1001.3 (+IN)
/h10_SQ: Q1003.2 (S), R1006.1, R1007.2
/h10_VS: C1002.1, C1004.2, C1006.1, Q1001.3 (D), R1004.1, R1007.1, U1001.5 (V+), U1002.5 (V+)
GND: C101.2, C102.2, C103.2, C104.1, C105.1, C107.2, C108.1, C109.2, C110.2, C111.2, C112.1, C114.2, C115.2, C117.2, C201.1, C202.1, C203.1, C204.1, C301.1, C302.1, C401.1, C502.2, C504.2, C506.2, C508.2, C602.2, C605.2, C701.2, C702.2, C703.2, C704.2, C802.2, C807.2, C809.2, C901.2, C902.2, C903.2, C904.2, C906.2, C908.2, C1001.2, C1002.2, C1004.1, C1006.2, D103.2 (A2), D305.1 (K), D306.2 (A), D802.2 (A), D804.2 (A), D1001.2 (A), J101.A1 (GND), J101.A12 (GND), J101.B1 (GND), J101.B12 (GND), J101.SH (SHIELD), J201.2 (Ext), J202.2 (Ext), J301.2 (Ext), J302.2 (Ext), J303.2 (Ext), J304.2 (Ext), J401.2 (Ext), J402.2, J501.2 (Ext), J502.2 (Ext), J503.2 (Ext), J504.2 (Ext), J505.3, J505.4, J601.2 (Ext), J602.2 (Ext), J701.2 (Ext), J702.2 (Ext), J703.2 (Ext), J704.2 (Ext), J801.2 (Ext), J802.2 (Ext), J803.2 (Ext), J804.2 (Ext), J901.2 (Ext), J1001.2 (Ext), J1002.2 (Ext), J1003.2 (Ext), J1004.2 (Ext), L101.1, L801.2, L802.2, LED101.1 (K), Q1004.2 (S), R104.1, R107.1, R108.1, R109.2, R110.2, R202.1, R203.1, R204.1, R301.2, R304.2, R401.1, R402.1, R404.2, R405.1, R501.2, R503.1, R507.2, R509.1, R602.1, R703.2, R705.1, R801.2, R803.2, R903.1, R1001.2, R1003.2, R1010.2, SW301.1 (A), SW401.1 (A), SW501.1 (A), SW601.1 (A), SW701.1 (A), SW801.1 (A), SW802.3, SW802.4, SW901.1 (A), SW1001.1 (A), TP9901.1, TP9902.1, U101.2 (PGND), U101.3 (PGND), U101.9 (PSP), U101.11 (PSN), U101.19 (AGND), U101.25 (EP), U102.1 (GND), U201.5 (GND), U201.17 (PAD), U401.7 (IMODE), U401.9 (PGND), U401.15 (GND), U401.16 (PMODE), U401.17 (PAD), U402.2 (V-), U501.2 (V-), U502.2 (V-), U601.2 (V-), U901.2 (GND), U902.2 (V-), U1001.2 (V-), U1002.2 (V-)

Notes on the sheet:
PD from Pmod IO1 (4.7 k, 10 k to ground): high = on. Pulse it: 1 W continuous heats the 3 x 3 mm package past its limit.
cells (2,1), (3,1)
LINE
h4 coil driver, DRV8876
Two TI LMH6629 (0.69 nV/rtHz, 4 GHz at gain 10) on one 5 V: 49.9 ohm terminates each input, 1 uF couples it to +IN at half
h10 laser driver, current source + bias-T
330 nH + 27 nH; RF IN joins through 100 pF + 47 ohm: the modulation for a rubidium CPT clock (3.4 GHz) or NV ODMR. IO5 high
USB-C power only (5.1 k on each CC). The TPS65131 runs both converters at 1.25 MHz with power-save off (quieter);
cells (2,2), (3,2)
high turns it on (a TPS22917 switches its 5 V): hot and cold for a Y-factor noise figure, or a broadband stimulus whose
(lightning, thousands of kilometres away), NAA's 24 kHz MSK, WWVB's 60 kHz time code. Two loops at right angles (this and
A high-side current source: REF = VS - SET (OPA810 and a 2N7002 through 1 k / 1 k), OPA810 holds the AO3401's source at
with an open, a short and a 50 ohm load on DUT (three complex numbers per frequency), then match an NMR probe or an antenna.
cell (2,0)
IPROPI
cell (3,3)
h3 duplexer and preamp, OPA847
REFL; each leaves through 49.9 ohm, so into the host's 50 ohm inputs REFL / INC = Gamma, magnitude and phase. Calibrate
+-1 V into 50 ohm
SIG
Two LC tanks, 10 uH and about 25 pF each (fixed, two BB133 back to back at 2.5 V, the ports), near 10 MHz, Q about 30.
IN A
+10 dBm max
OUT 1
h6 VLF loop amplifier, OPA810 x101
RF IN
EXPECT: 0-100 mA from 0-1 V on SET, about 10 kHz of loop bandwidth; IO5 blanks it in about 1 us; RF from about 20 MHz to 3 GHz rides on the current
EXPECT: gain 10.3 to 30 MHz: a DAC's +-1 V to +-10 V into 50 ohm (1 W); off (PD low) unless Pmod IO1 is high
75 ohm to ground set gain 10.3. The 49.9 ohm input termination makes the DAC's +-1 V into 50 ohm the full +-10 V output.
EXPECT: gain 9.9 (20 dB) on each channel, 50 ohm in and out, about 5 kHz to 100 MHz; 0.7 nV/rtHz at the input (NF about 2.5 dB)
cells (0,0), (1,0)
EXPECT: gain 101 from 1.6 kHz to 160 kHz (the loop's EMF rises with frequency on top): sferics, the Navy's MSK stations near 24 kHz, WWVB at 60 kHz
h7 reflection bridge, 2 x OPA810
+15 V = 1.213 V x (1 + 1 M / 88.7 k) = 14.9 V, -15 V = -1.213 V x 1.3 M / 105 k = -15.0 V. Only h2 draws them, through
+-2 V open
100 mA max
h5's IN A, or two boards) give a lightning stroke's bearing from the ratio of the two signals.
TI THS3491, current feedback, 900 MHz and 420 mA from +-15 V. 698 ohm from the FB pin (the output, inside) to -IN and
quarter wave of coax from PROBE to LINE (2.6 m of RG-316 at 20 MHz) whose far end the clamp diodes short during the pulse.
cell (2,3)
TUNE / PUMP
cells (0,3), (1,3)
ground loops for the scope's clips, one per channel, in the board's margins
+-10 V into 50 ohm
OUT
-10 dBm
REF so 10 ohm carries SET / 10 ohm, 100 mA per volt (start a VCSEL at a few millivolts). The drain feeds the diode through
EXPECT: two 10 MHz tanks (Q about 30); coupled by 1, 2.2 or 3.2 pF they split by 0.4 - 1.2 MHz; TUNE moves tank 2 by +-5 %; a 20 MHz pump on it gives parametric gain
no mounting holes: four stick-on rubber feet, marked on the back
OUT B
A - B = B x Gamma. OPA810 U1 at gain 2 on B gives INC; U2, +IN on A and 499 / 499 ohm from U1's output, gives 2 A - 2 B,
LOOP
1 pF and 2.2 pF between the tanks (normal modes, the avoided crossing as TUNE sweeps tank 2), 2 k across tank 1 or tank 2
TX IN
x12, its minimum stable gain). Without the cable, a short one and a 6 dB pad work at a few dB of loss.
PROBE
MON
h1 power, USB-C 5 V in: +5, -5, +15, -15 out
h2 pulse amplifier, THS3491
A 50 ohm resistive bridge: D from DRIVE, 49.9 ohm to A (the DUT jack) and 49.9 + 49.9 ohm from D to ground with B between.
SIG drives tank 1 through 2.2 pF; each tank feeds its OUT jack through 2.2 pF, -43 dB into the host's 50 ohm. The DIP:
EXPECT: REFL / INC = Gamma (S11) from DC to about 30 MHz: 0 for 50 ohm, +1 open, -1 short; after open-short-load calibration, better than -35 dB
OUT A
SET
Between pulses the diodes are off: the PA's noise does not reach the probe, the echo reaches the OPA847 (1.1 k / 100 ohm:
INC
RX OUT
EXPECT: off: the amplifier's own noise (about 6 nV/rtHz at OUT); on: tens to hundreds of nV/rtHz from 10 kHz to 50 MHz, flat to about 1 dB
A loop's EMF is N A dB/dt: a 1 m square of 10 turns gives about 1 uV for 1 pT at 20 kHz. 1 uF into an OPA810 at half
the supply (100 k / 100 k), gain 101 (10 k / 100 ohm to ground through 1 uF), 100 pF across 10 k: 1.6 - 160 kHz. Sferics
the supply, 240 / 27 ohm (the 27 ohm to ground through 1 uF) set the gain, 1 uF and 49.9 ohm feed the output jack. Two
OUT 2
EXPECT: TX IN passes to PROBE through 1.4 V of diodes; the echo at LINE gains 12 (OPA847, 0.85 nV/rtHz) to RX OUT, about 200 MHz wide; LINE is clamped to +-0.7 V and terminated in 50 ohm
REFL
DUT
h9 noise source, MMBT3904 + LMH6629
+-1 V
2-3 mA and its avalanche noise, many times kT's, goes straight into an LMH6629 at gain 9.9 and out through 49.9 ohm. IO8
EXPECT: about 1.3 A either way into a coil, PWM on IO6; MON about 1.5 V per amp
0-1 V: 0-100 mA
An MMBT3904's emitter-base junction breaks down near 8 V; between -5 V and the switched 5 V through 680 ohm it carries
h8 coupled resonators, 2 x LC + BB133
cell (3,0)
DRV8876 in PH/EN mode: IO6 enables (PWM), IO7 the direction; VM = USB or 12-18 V (two B5819W); IPROPI buffered to MON.
cross-spectrum against the response on the host's second ADC is a transfer function.
cells (0,1), (1,1)
DRIVE
two back-side tracks; everything else runs from +5 V and the LM2664's -5 V (40 mA: h3, h7 and h9 draw about 30).
IN B
cells (0,2), (1,2)
+-15 V
antennas into IN A and IN B and the host's two ADCs: a coherent two-channel HF receiver (WWV Doppler, direction finding).
shorts the drain (the AO3400) for pulses. MON = the diode's voltage / 200 into 50 ohm: with SET swept, its I-V curve.
The classic pulsed-NMR duplexer, broadband except for its one cable: crossed diodes in series with the transmitter, and a
h5 HF receiver, 2 x LMH6629
(a lossy tank coupled to a sharp one: the EIT analogue). A pump at twice the frequency on TUNE / PUMP: parametric gain.
EXPECT: +5 V from the USB-C (up to 2 A), -5 V at 40 mA, +15 V and -15 V at about 150 mA each for the pulse amplifier; green: 5 V in, red: -5 V up, yellow: +15 V up
