gallicchio/AMOD-and-RFMOD/hardware/phmod.kicad_pcb

## KiCad design hardware/phmod.kicad_pcb (continued)

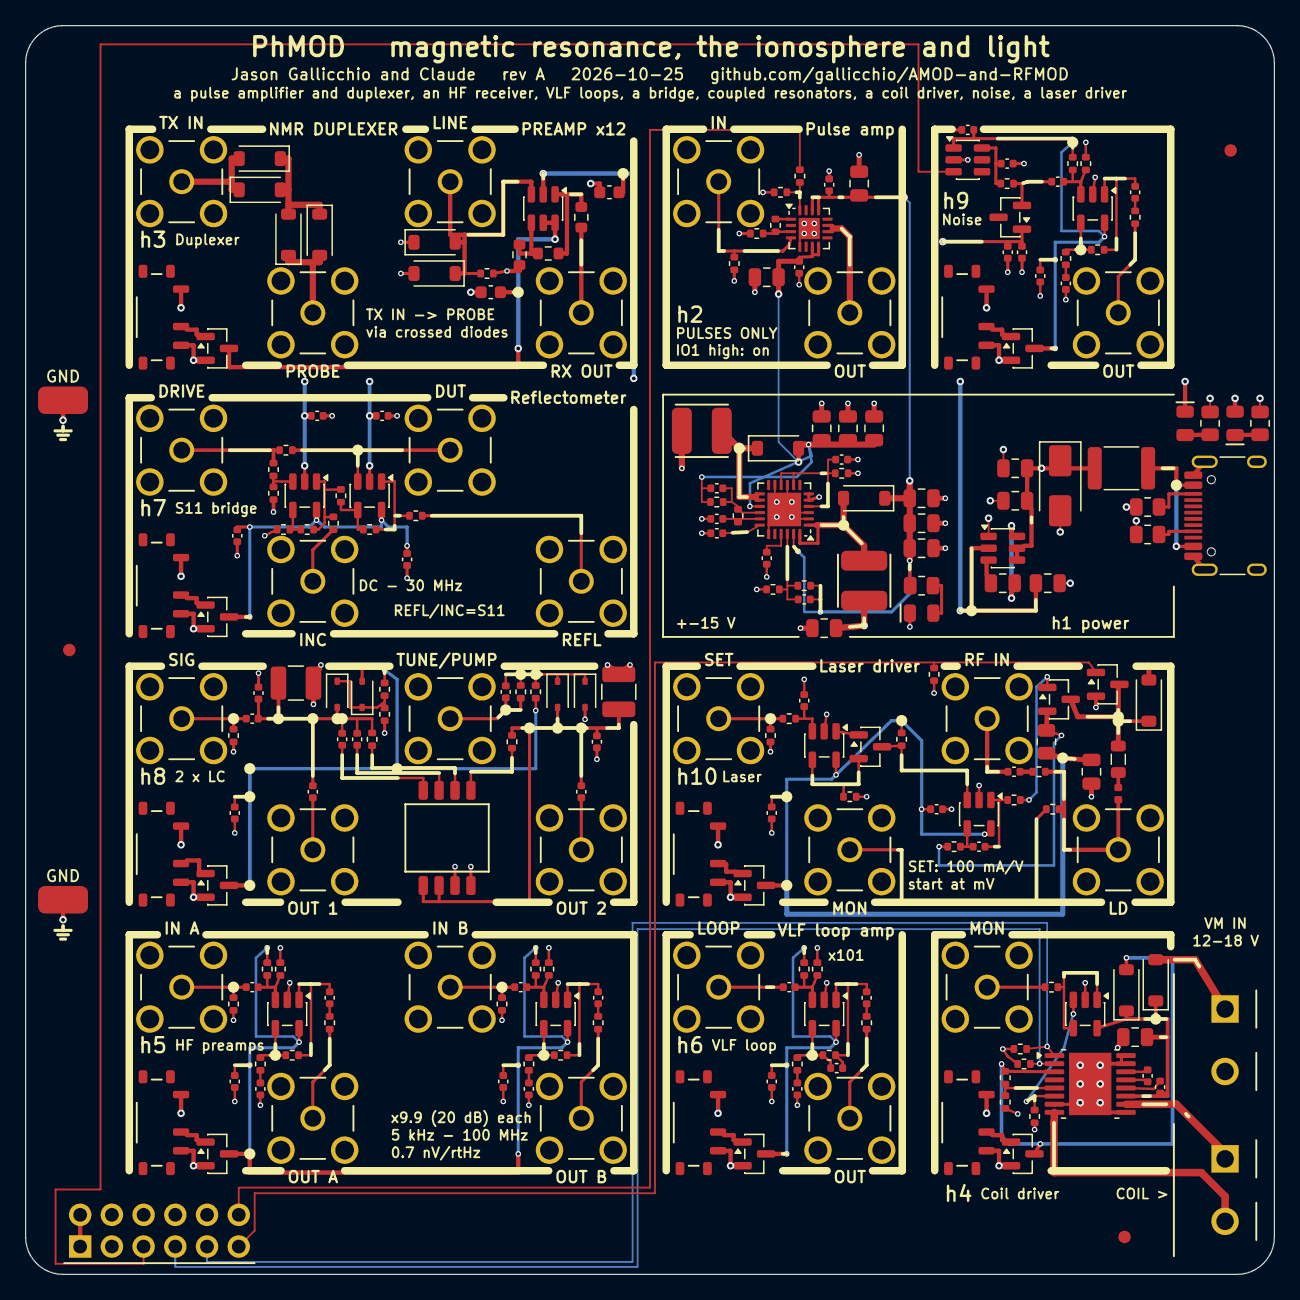
[picture p247: board phmod.kicad_pcb from above]

Board: 4 copper layers, 100.0 x 100.0 mm, 234 parts (0 on the bottom side), 131 nets.
