gallicchio/AMOD-and-RFMOD/hardware/amod_c.kicad_pcb

## KiCad design hardware/amod_c.kicad_pcb (2026-10-30)

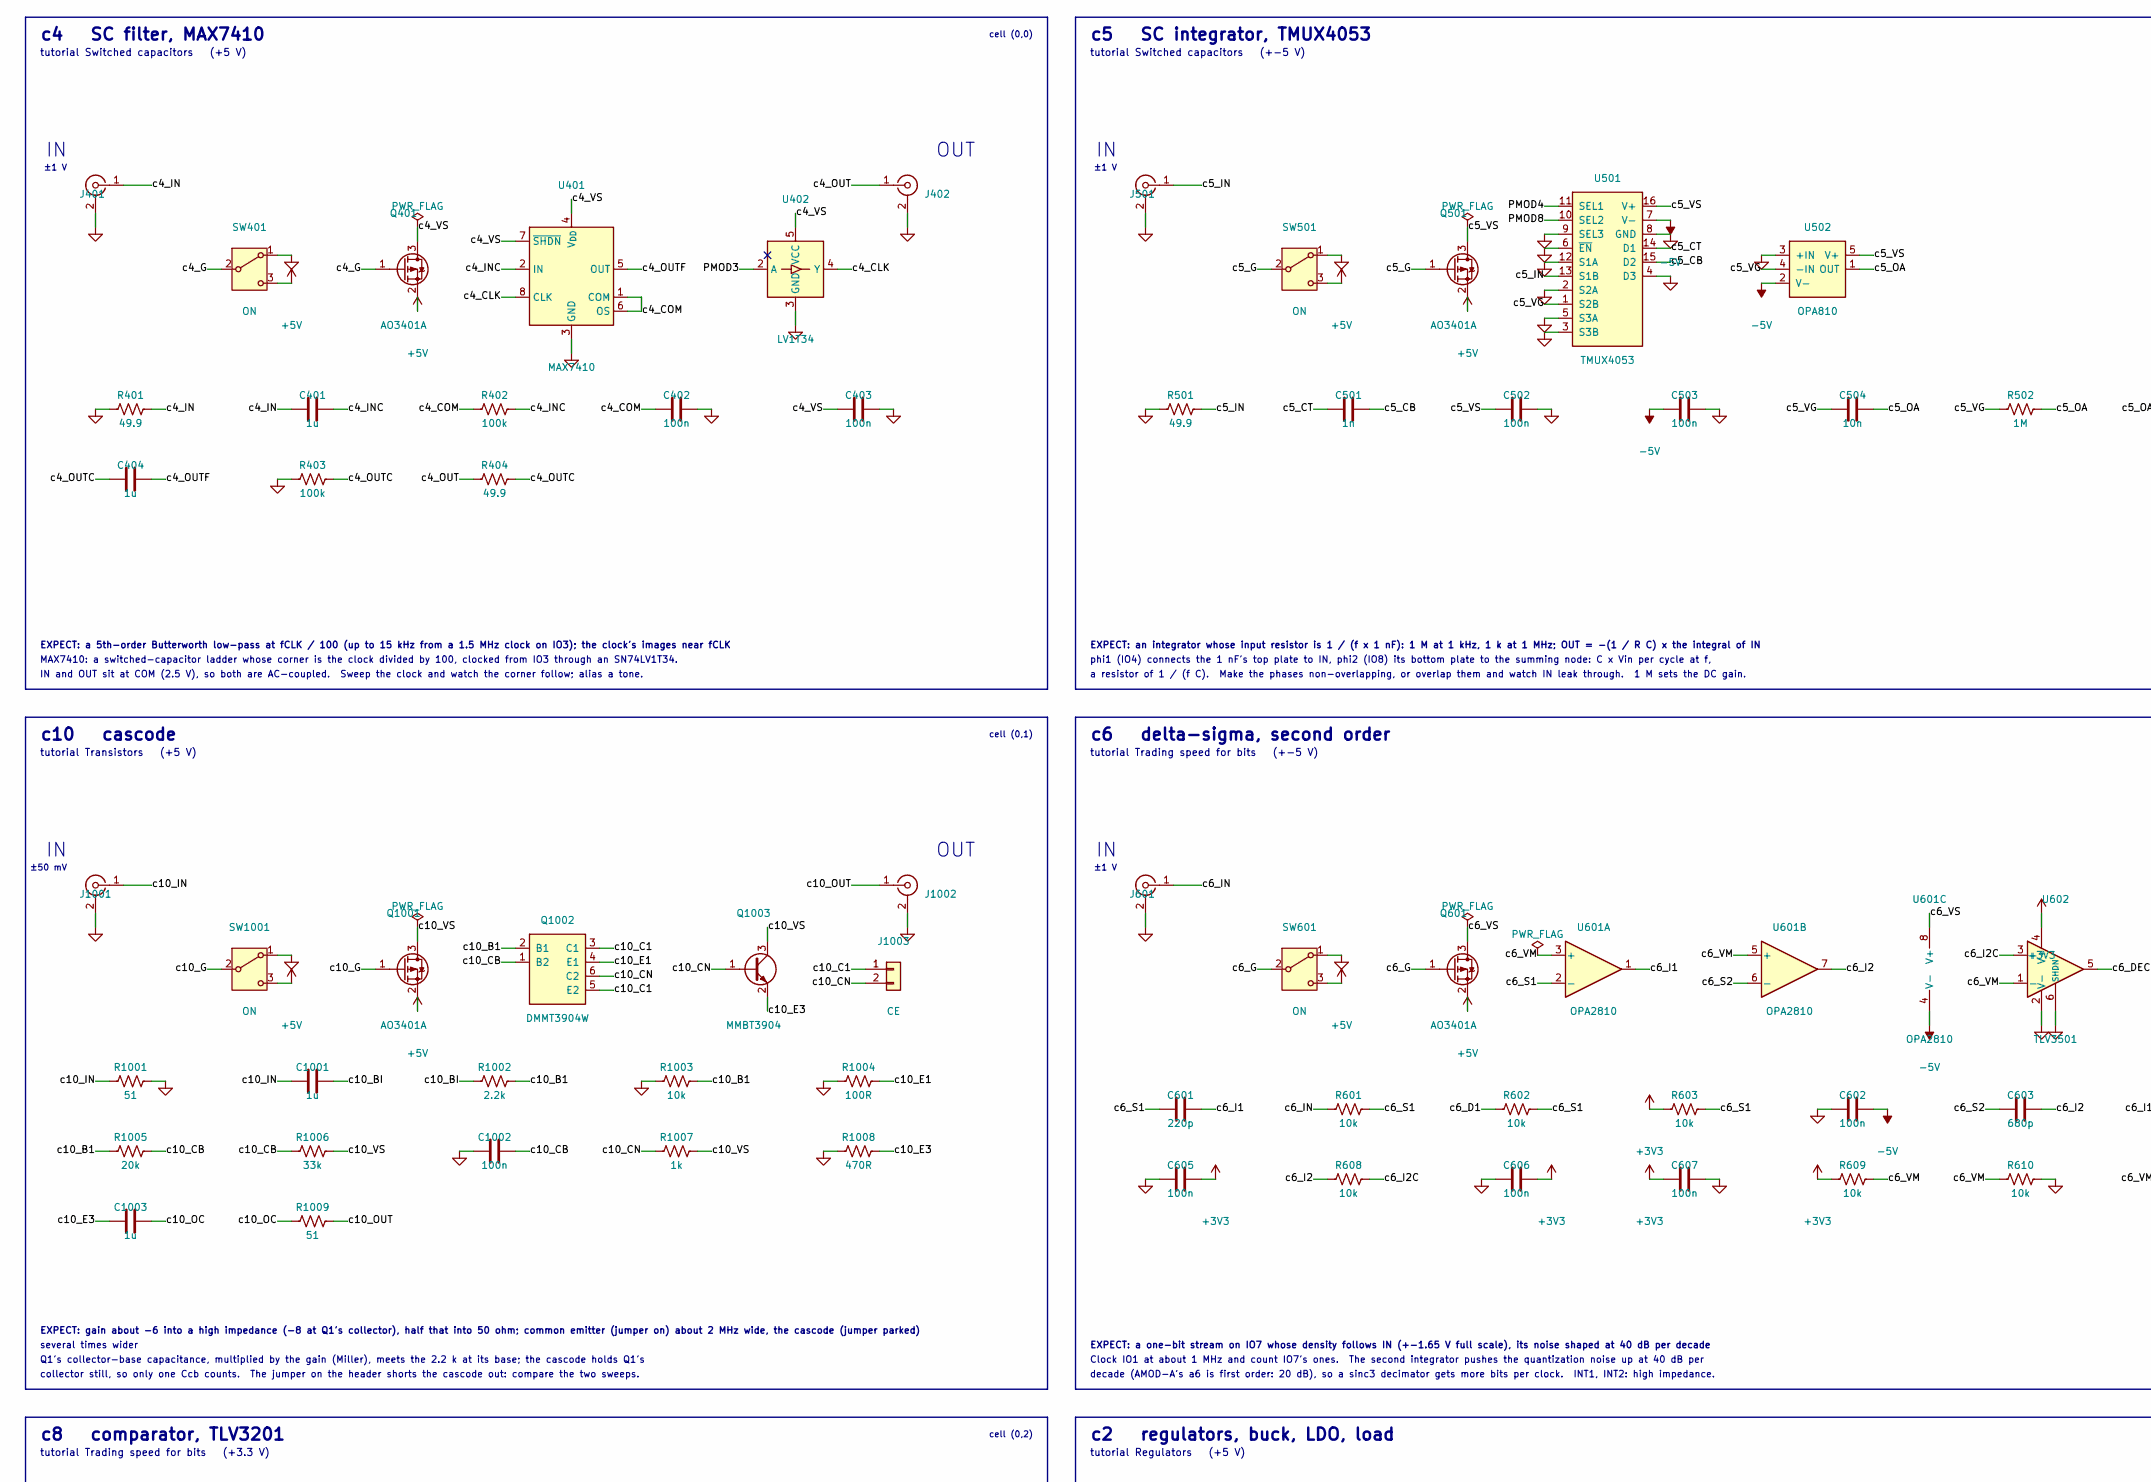
[picture p248: schematic amod_c.kicad_sch, AMOD-C: power and data conversion, part in row 1, column 1]

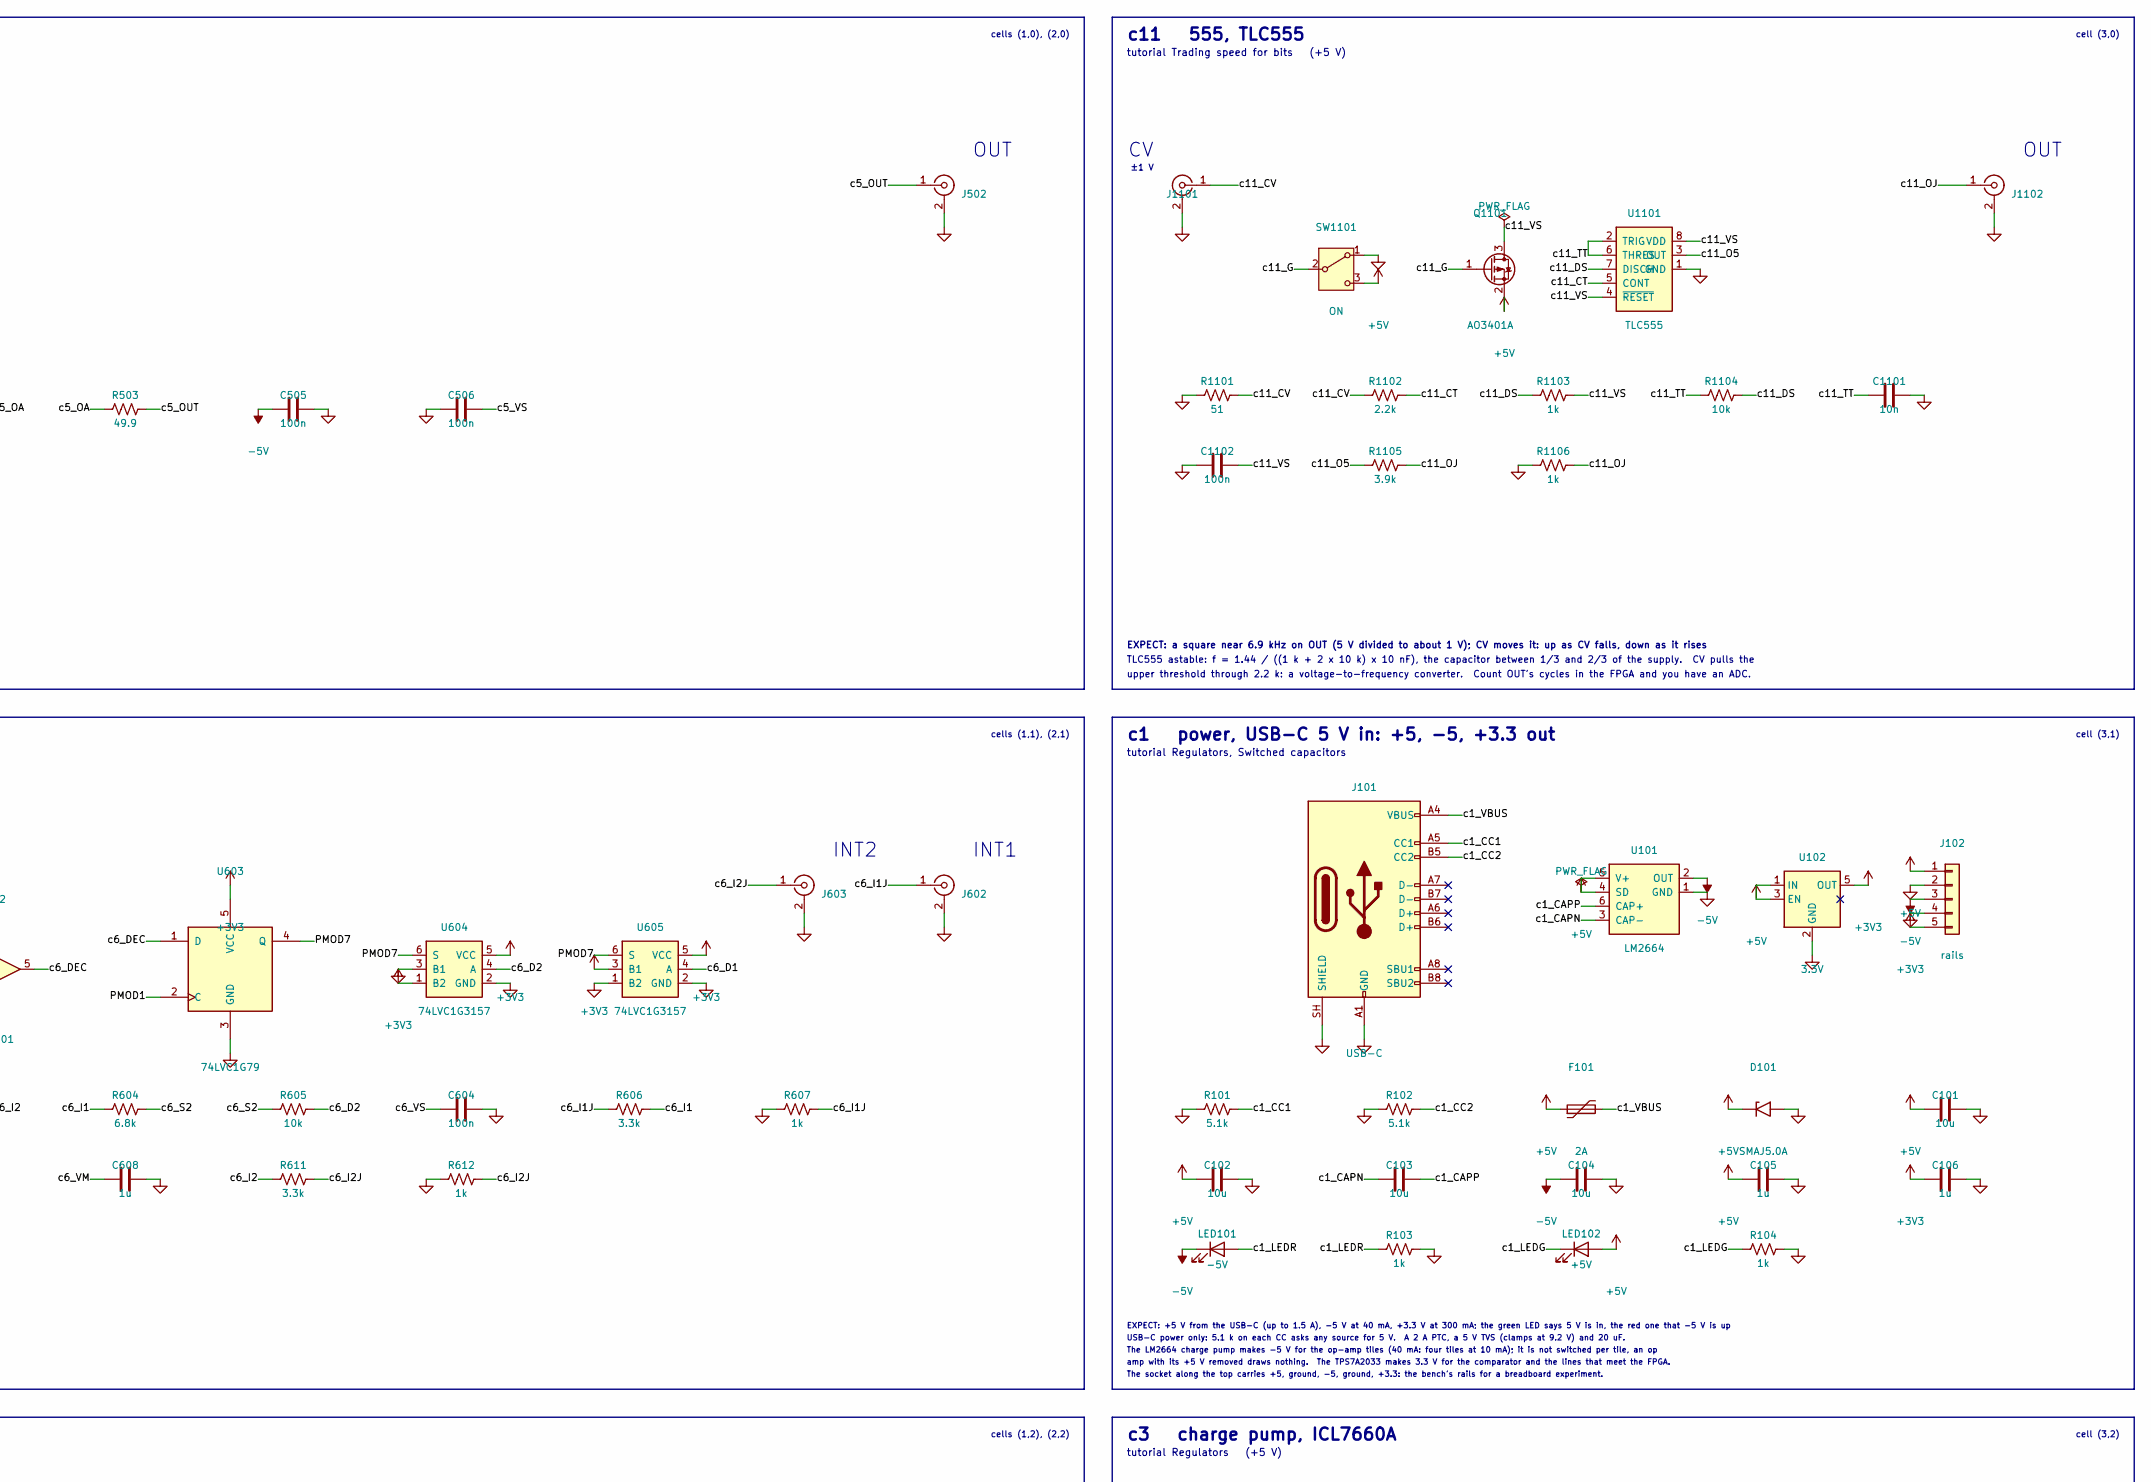
[picture p249: schematic amod_c.kicad_sch, AMOD-C: power and data conversion, part in row 1, column 2]

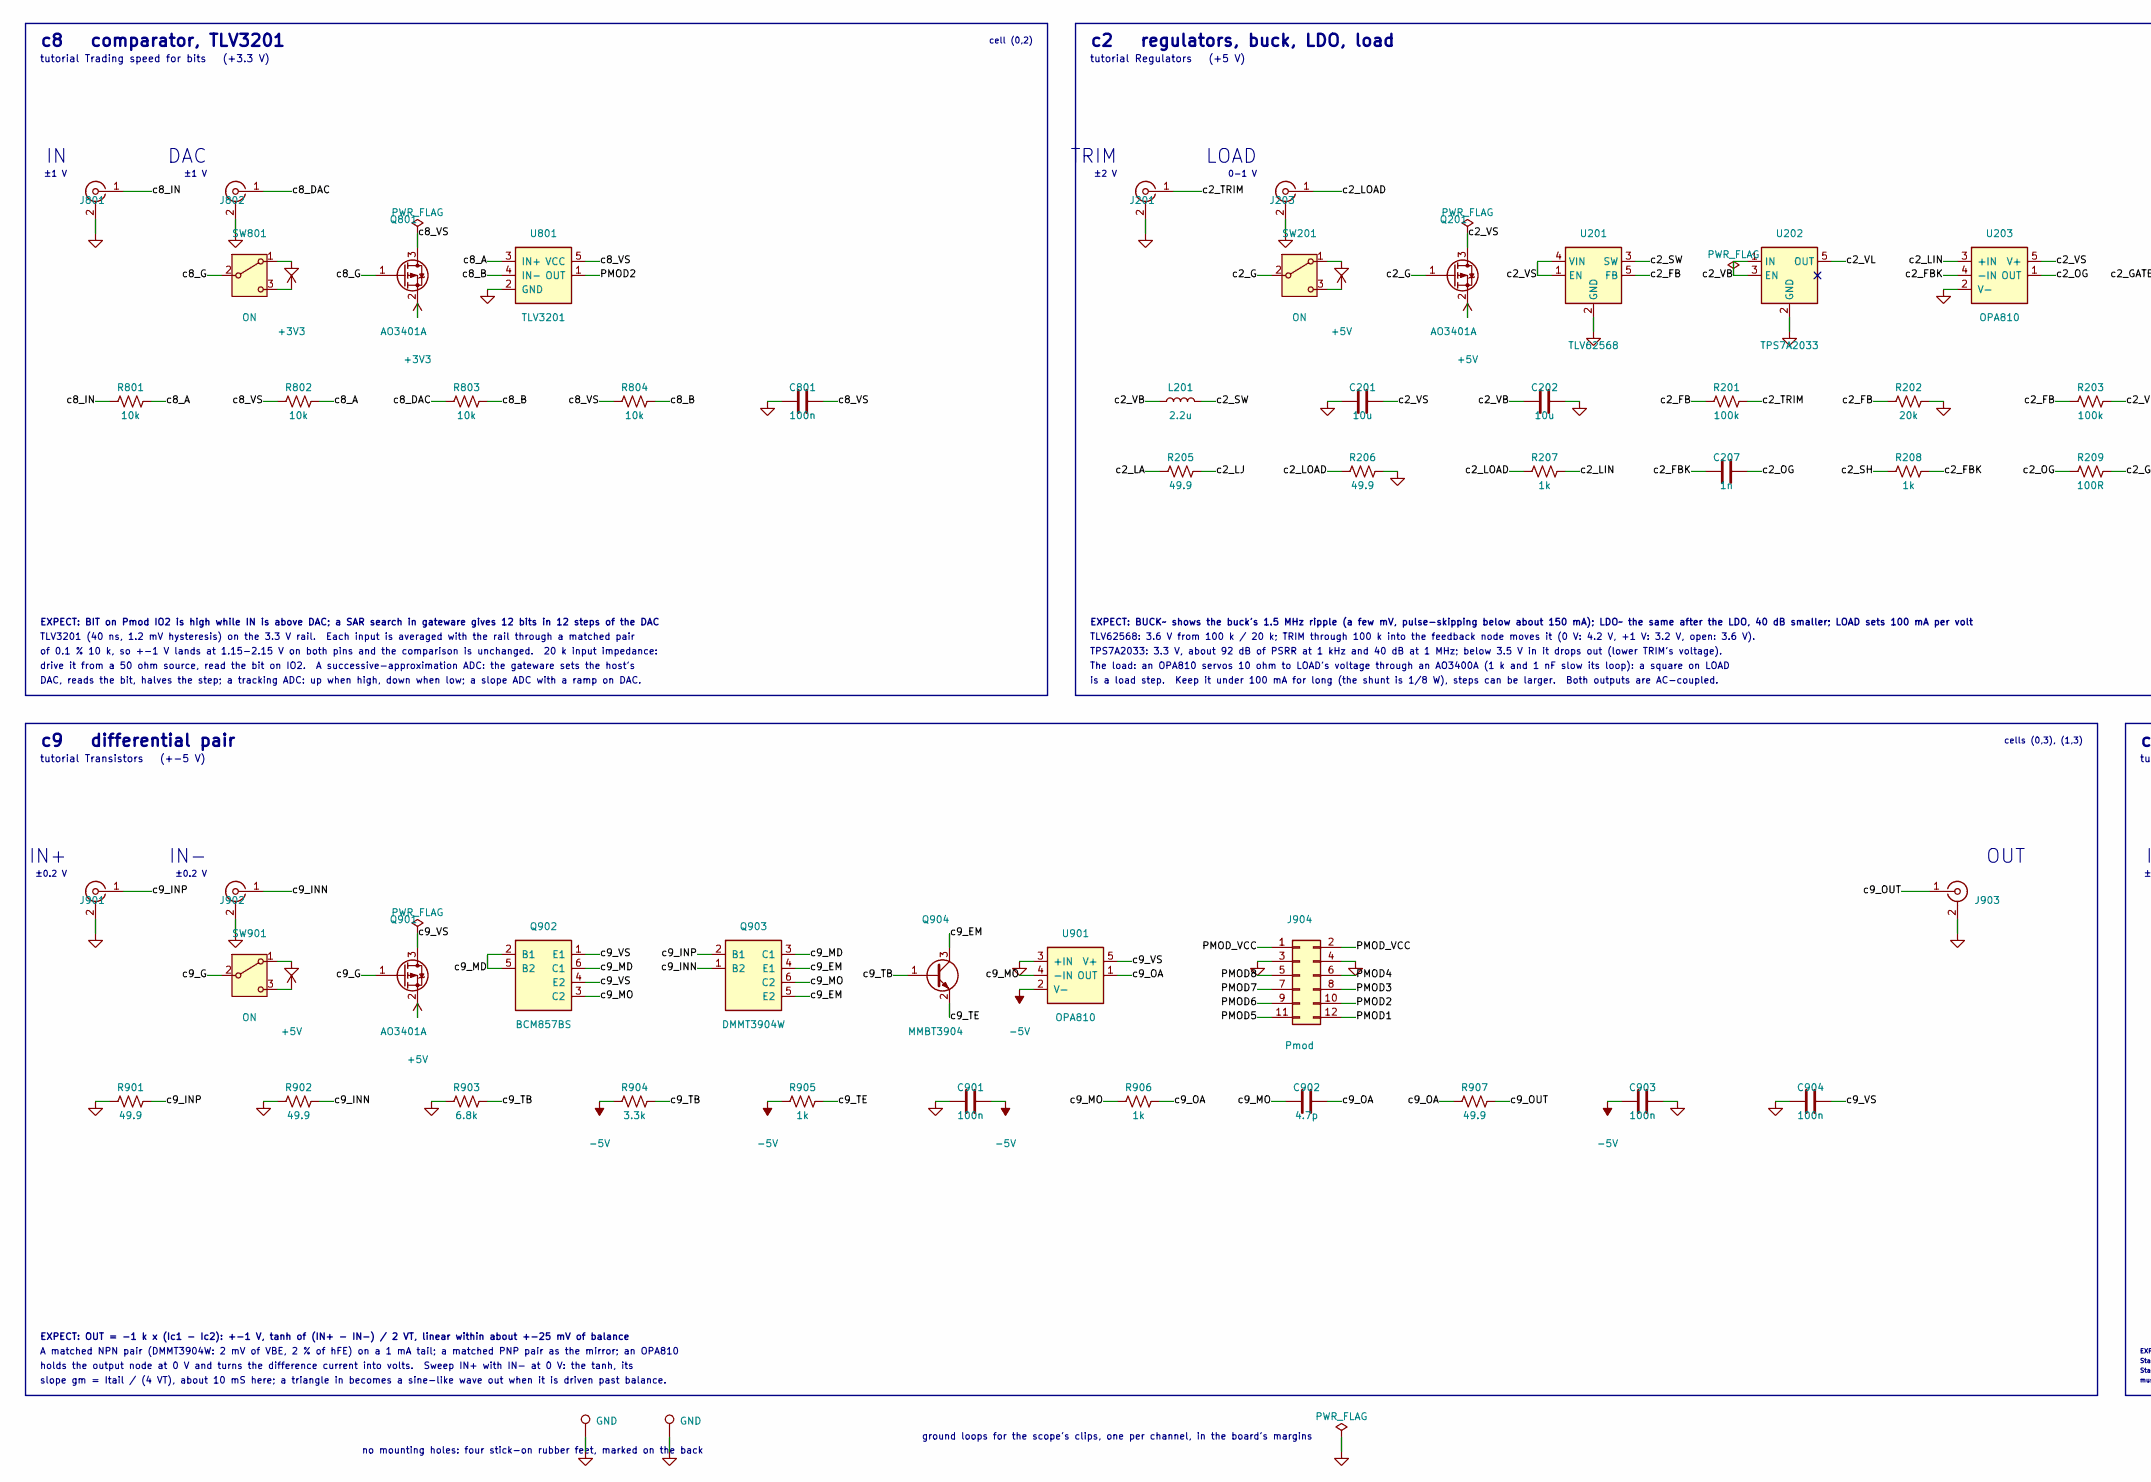
[picture p250: schematic amod_c.kicad_sch, AMOD-C: power and data conversion, part in row 2, column 1]

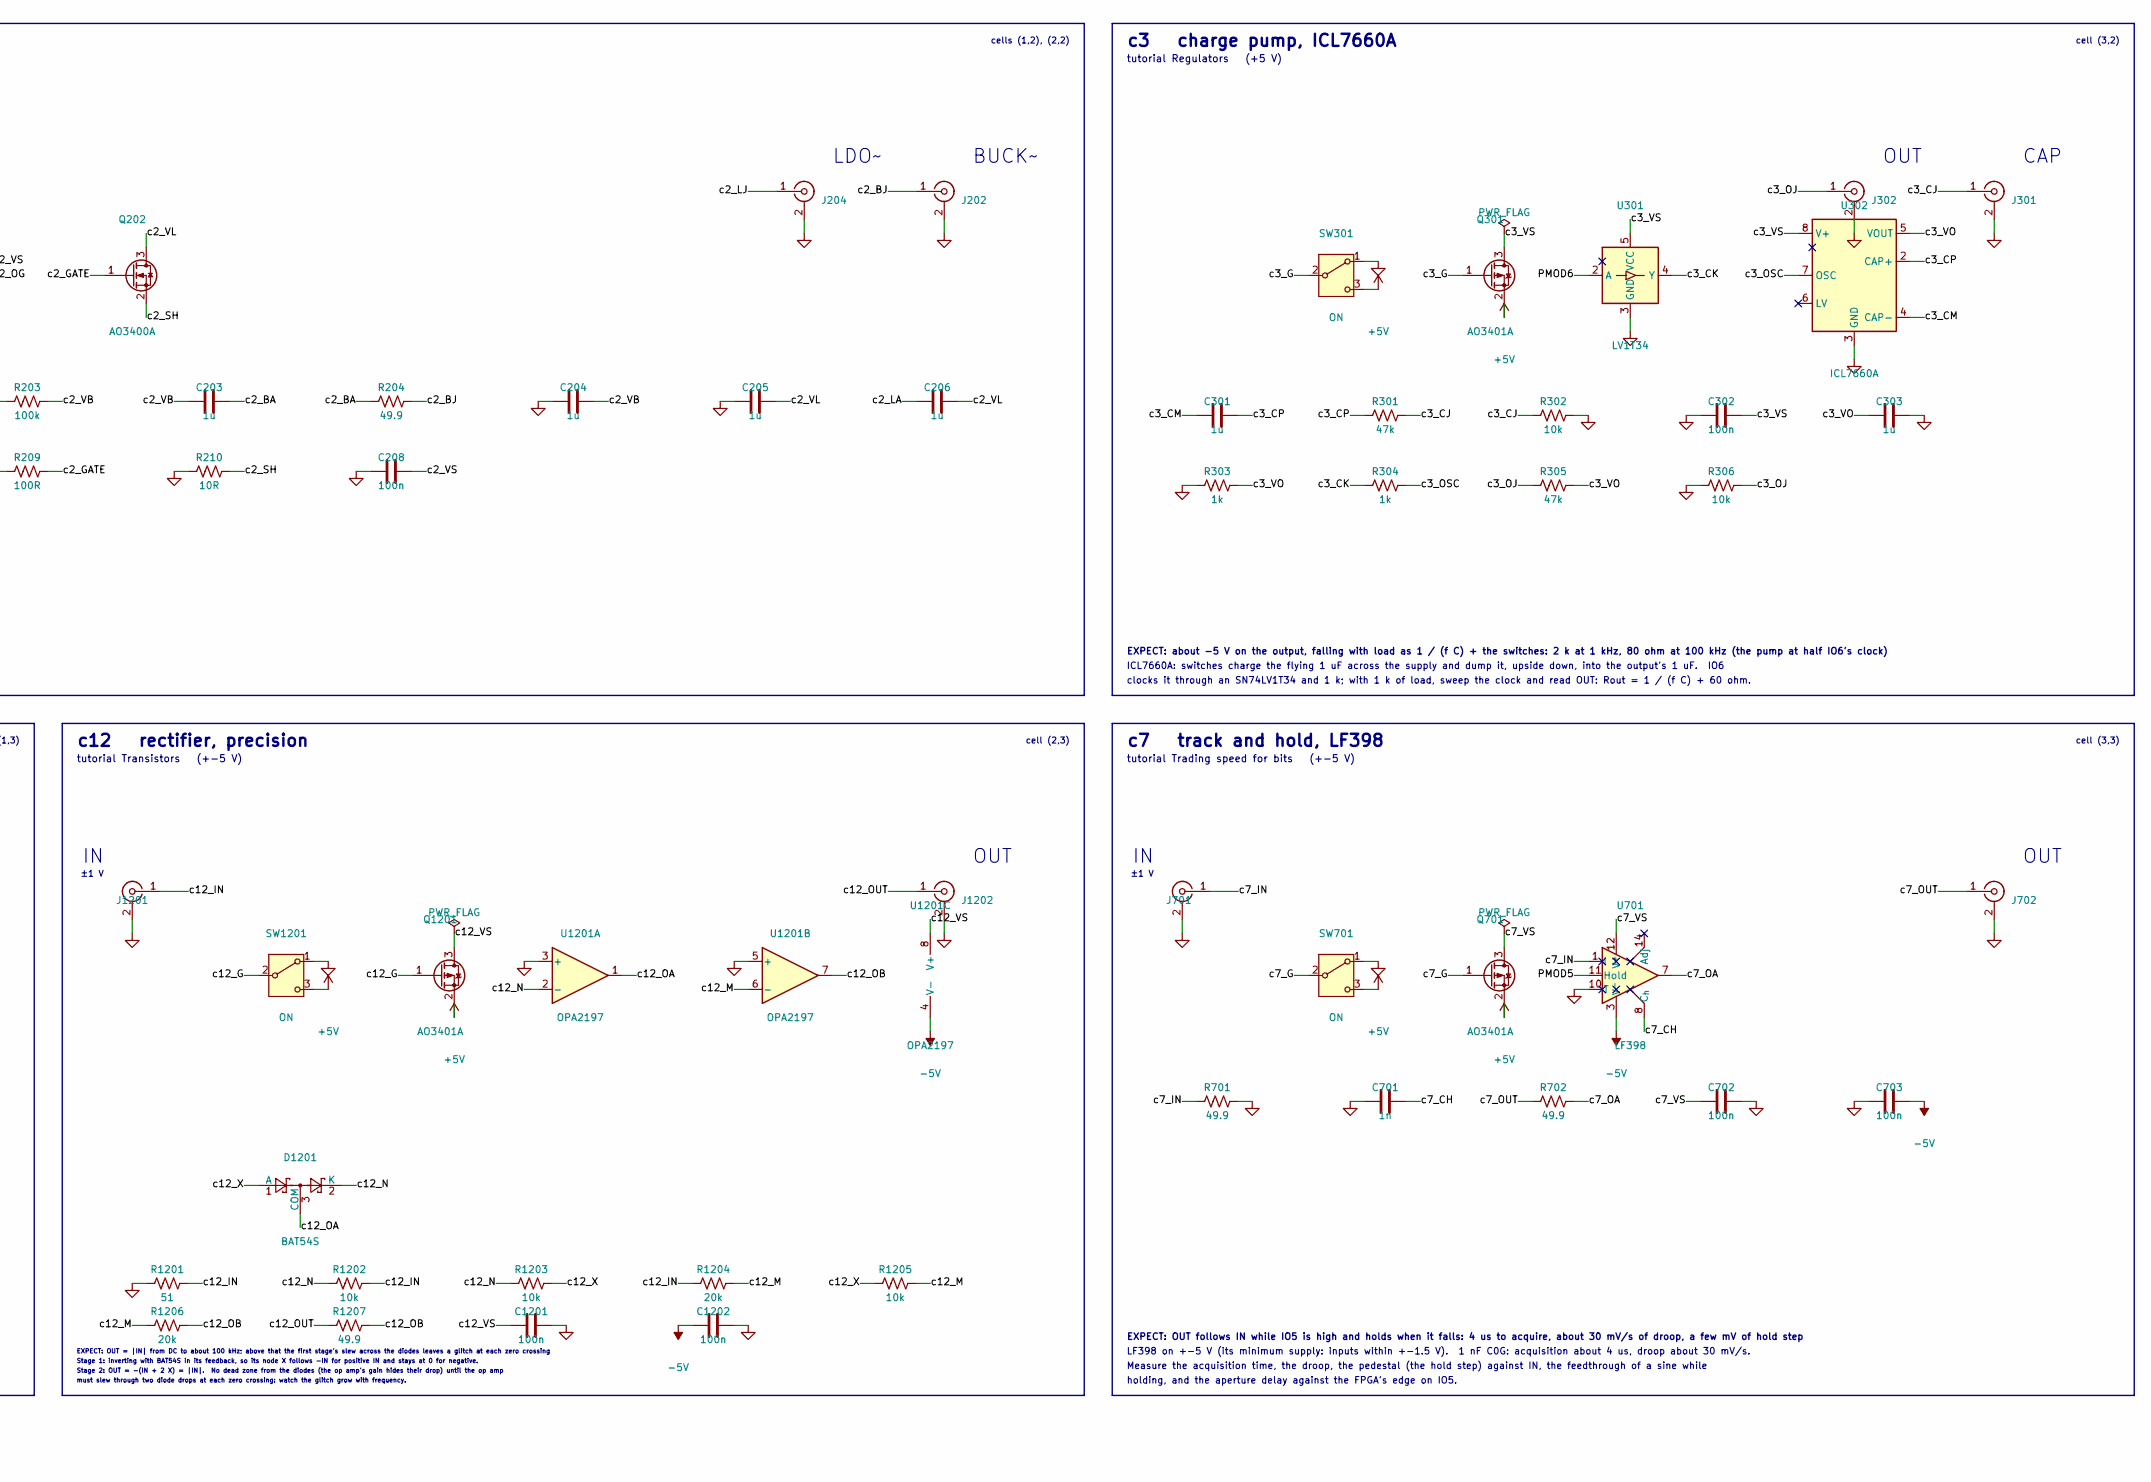
[picture p251: schematic amod_c.kicad_sch, AMOD-C: power and data conversion, part in row 2, column 2]

Parts:
C101, C102, C103, C104, C201, C202: 10u; C_0805_2012Metric; MPN CL21A106KAYNNNE; LCSC C15850
C105, C106: 1u; C_0805_2012Metric; MPN CL21B105KBFNNNE; LCSC C28323
C203, C204, C205, C206, C301, C303, C608: 1u; C_0603_1608Metric; MPN CL10A105KB8NNNC; LCSC C15849
C207, C501, C701: 1n; C_0603_1608Metric; MPN 0603CG102J500NT; LCSC C1636
C208, C302, C402, C403, C502, C503, C505, C506, C602, C604, C605, C606, C607, C702, C703, C901, C903, C904, C1002, C1102, C1201, C1202: 100n; C_0402_1005Metric; MPN CL05B104KO5NNNC; LCSC C1525
C401, C404, C1001, C1003: 1u; C_0402_1005Metric; MPN CL05A105KP5NNNC; LCSC C14445
C504, C1101: 10n; C_0603_1608Metric; MPN GRM1885C1H103JA01D; LCSC C85973
C601: 220p; C_0402_1005Metric; MPN 0402CG221J500NT; LCSC C39122
C603: 680p; C_0402_1005Metric; MPN 0402CG681J500NT; LCSC C301953
C801: 100n; C_0603_1608Metric; MPN CC0603KRX7R9BB104; LCSC C14663
C902: 4.7p; C_0402_1005Metric; MPN 0402CG4R7C500NT; LCSC C1569
D101: SMAJ5.0A; D_SMA; MPN SMAJ5.0A; LCSC C78401
D1201: BAT54S; SOT-23; MPN BAT54S; LCSC C8592
F101: 2A; Fuse_1812_4532Metric; MPN MF-MSMF200-2; LCSC C210837
J101: USB-C; USB_C_Receptacle_HRO_TYPE-C-31-M-12; MPN TYPE-C-31-M-12; LCSC C165948
J102: rails; PinSocket_1x05_P2.54mm_Vertical; MPN PZ254-1-05-Z-8.5; LCSC C2894928
J201, J202, J203, J204, J301, J302, J401, J402, J501, J502, J601, J602, J603, J701, J702, J801, J802, J901, J902, J903, J1001, J1002, J1101, J1102, J1201, J1202: SMA; SMA_BWSMA-KE-Z001_Vertical; MPN BWSMA-KE-Z001; LCSC C496549
J904: Pmod; PinHeader_2x06_P2.54mm_Horizontal_PZ254R-12-12P; MPN PZ254R-12-12P; LCSC C492434
J1003: CE; PinSocket_1x02_P2.54mm_Vertical; MPN PZ254-1-02-Z-8.5; LCSC C2894925
L201: 2.2u; L_Cenker_CKCS201610; MPN WPN201610H2R2MT; LCSC C97005
LED101: -5V; LED_0805_2012Metric_Kbar; MPN NCD0805R1; LCSC C84256
LED102: +5V; LED_0805_2012Metric_Kbar; MPN KT-0805G; LCSC C2297
Q201, Q301, Q401, Q501, Q601, Q701, Q801, Q901, Q1001, Q1101, Q1201: AO3401A; SOT-23; MPN AO3401A; LCSC C15127
Q202: AO3400A; SOT-23; MPN AO3400A; LCSC C20917
Q902: BCM857BS; SOT-363_SC-70-6; MPN BCM857BS-7-F; LCSC C105896
Q903, Q1002: DMMT3904W; SOT-363_SC-70-6; MPN DMMT3904W-7-F; LCSC C155305
Q904, Q1003: MMBT3904; SOT-23; MPN MMBT3904(RANGE:100-300); LCSC C20526
R101, R102: 5.1k; R_0805_2012Metric; MPN 0805W8F5101T5E; LCSC C27834
R103, R104: 1k; R_0805_2012Metric; MPN 0805W8F1001T5E; LCSC C17513
R201, R203, R402, R403: 100k; R_0402_1005Metric; MPN 0402WGF1003TCE; LCSC C25741
R202, R1005, R1204, R1206: 20k; R_0402_1005Metric; MPN 0402WGF2002TCE; LCSC C25765
R204, R503: 49.9; R_0603_1608Metric; MPN SR0603FR-7T49R9L; LCSC C6230117
R205, R206, R401, R404, R501, R701, R702, R901, R902, R907, R1207: 49.9; R_0402_1005Metric; MPN CRCW040249R9FKEDHP; LCSC C844112
R207, R208, R304, R607, R612, R905, R906, R1007, R1103, R1106: 1k; R_0402_1005Metric; MPN 0402WGF1001TCE; LCSC C11702
R209, R1004: 100R; R_0402_1005Metric; MPN 0402WGF1000TCE; LCSC C25076
R210: 10R; R_0805_2012Metric; MPN 0805W8F100JT5E; LCSC C17415
R301, R305: 47k; R_0402_1005Metric; MPN 0402WGF4702TCE; LCSC C25792
R302, R306, R601, R605, R608, R1003, R1104, R1202, R1203, R1205: 10k; R_0402_1005Metric; MPN 0402WGF1002TCE; LCSC C25744
R303: 1k; R_0603_1608Metric; MPN 0603WAF1001T5E; LCSC C21190
R502: 1M; R_0402_1005Metric; MPN 0402WGF1004TCE; LCSC C26083
R602, R603, R609, R610, R801, R802, R803, R804: 10k; R_0603_1608Metric; MPN RT0603BRD0710KL; LCSC C95204
R604, R903: 6.8k; R_0402_1005Metric; MPN RC0402FR-076K8L; LCSC C93940
R606, R611, R904: 3.3k; R_0402_1005Metric; MPN 0402WGF3301TCE; LCSC C25890
R1001, R1009, R1101, R1201: 51; R_0402_1005Metric; MPN 0402WGF510JTCE; LCSC C25125
R1002, R1102: 2.2k; R_0402_1005Metric; MPN 0402WGF2201TCE; LCSC C25879
R1006: 33k; R_0402_1005Metric; MPN 0402WGF3302TCE; LCSC C25779
R1008: 470R; R_0402_1005Metric; MPN 0402WGF4700TCE; LCSC C25117
R1105: 3.9k; R_0402_1005Metric; MPN 0402WGF3901TCE; LCSC C51721
SW201, SW301, SW401, SW501, SW601, SW701, SW801, SW901, SW1001, SW1101, SW1201: ON; SW_SPDT_Shouhan_MSK12C02; MPN MSK12C02; LCSC C431540
TP9901, TP9902: GND; TestPoint_Loop_RH-5019; MPN RH-5019; LCSC C5199800
U101: LM2664; SOT-23-6; MPN LM2664M6X/NOPB; LCSC C108573
U102: 3.3V; SOT-23-5; MPN TPS7A2033PDBVR; LCSC C2862740
U201: TLV62568; SOT-23-5; MPN TLV62568DBVR; LCSC C163219
U202: TPS7A2033; SOT-23-5; MPN TPS7A2033PDBVR; LCSC C2862740
U203, U502, U901: OPA810; SOT-23-5; MPN OPA810IDBVR; LCSC C2833513
U301, U402: LV1T34; SOT-353_SC-70-5; MPN SN74LV1T34DCKR; LCSC C78541
U302: ICL7660A; SOIC-8_3.9x4.9mm_P1.27mm; MPN ICL7660AIBAZA-T; LCSC C7881
U401: MAX7410; MSOP-8_3x3mm_P0.65mm; MPN MAX7410EUA+T; LCSC C17492626
U501: TMUX4053; TSSOP-16_4.4x5mm_P0.65mm; MPN TMUX4053PWR; LCSC C5377936
U601: OPA2810; SOIC-8_3.9x4.9mm_P1.27mm; MPN OPA2810IDR; LCSC C1849413
U602: TLV3501; SOT-23-6; MPN TLV3501AIDBVR; LCSC C193413
U603: 74LVC1G79; SOT-23-5; MPN SN74LVC1G79DBVR; LCSC C42878
U604, U605: 74LVC1G3157; SOT-23-6; MPN SN74LVC1G3157DBVR; LCSC C10426
U701: LF398; SOIC-14_3.9x8.7mm_P1.27mm; MPN LF398MX/NOPB; LCSC C2864267
U801: TLV3201; SOT-353_SC-70-5; MPN TLV3201AQDCKRQ1; LCSC C3658542
U1101: TLC555; SOIC-8_3.9x4.9mm_P1.27mm; MPN TLC555CDR; LCSC C6986
U1201: OPA2197; MSOP-8_3x3mm_P0.65mm; MPN OPA2197IDGKR; LCSC C2867268

Connections:
+3V3: C106.1, C605.2, C606.2, C607.1, J102.5, Q801.2 (S), R603.1, R609.1, SW801.3 (C), U102.5 (OUT), U602.4 (V+), U603.5 (VCC), U604.1 (B2), U604.5 (VCC), U605.3 (B1), U605.5 (VCC)
+5V: C101.1, C102.1, C105.1, D101.1 (A1), F101.1, J102.1, LED102.2 (A), Q201.2 (S), Q301.2 (S), Q401.2 (S), Q501.2 (S), Q601.2 (S), Q701.2 (S), Q901.2 (S), Q1001.2 (S), Q1101.2 (S), Q1201.2 (S), SW201.3 (C), SW301.3 (C), SW401.3 (C), SW501.3 (C), SW601.3 (C), SW701.3 (C), SW901.3 (C), SW1001.3 (C), SW1101.3 (C), SW1201.3 (C), U101.4 (SD), U101.5 (V+), U102.1 (IN), U102.3 (EN)
-5V: C104.1, C503.1, C505.1, C602.2, C703.2, C901.2, C903.1, C1202.1, J102.3, LED101.1 (K), R904.1, R905.1, U101.2 (OUT), U501.7 (V-), U502.2 (V-), U601.4 (V-), U701.3 (V^{-}), U901.2 (V-), U1201.4 (V-)
/PMOD1: J904.12, U603.2 (C)
/PMOD2: J904.10, U801.1 (OUT)
/PMOD3: J904.8, U402.2 (A)
/PMOD4: J904.6, U501.11 (SEL1)
/PMOD5: J904.11, U701.11 (Hold)
/PMOD6: J904.9, U301.2 (A)
/PMOD7: J904.7, U603.4 (Q), U604.6 (S), U605.6 (S)
/PMOD8: J904.5, U501.10 (SEL2)
/PMOD_VCC: J904.1, J904.2
/c1_CAPN: C103.1, U101.3 (CAP-)
/c1_CAPP: C103.2, U101.6 (CAP+)
/c1_CC1: J101.A5 (CC1), R101.2
/c1_CC2: J101.B5 (CC2), R102.2
/c1_LEDG: LED102.1 (K), R104.1
/c1_LEDR: LED101.2 (A), R103.1
/c1_VBUS: F101.2, J101.A4 (VBUS), J101.A9 (VBUS), J101.B4 (VBUS), J101.B9 (VBUS)
/c2_BA: C203.2, R204.1
/c2_BJ: J202.1 (In), R204.2
/c2_FB: R201.1, R202.1, R203.1, U201.5 (FB)
/c2_FBK: C207.1, R208.2, U203.4 (-IN)
/c2_G: Q201.1 (G), SW201.2 (B)
/c2_GATE: Q202.1 (G), R209.2
/c2_LA: C206.1, R205.1
/c2_LIN: R207.2, U203.3 (+IN)
/c2_LJ: J204.1 (In), R205.2
/c2_LOAD: J203.1 (In), R206.1, R207.1
/c2_OG: C207.2, R209.1, U203.1 (OUT)
/c2_SH: Q202.2 (S), R208.1, R210.2
/c2_SW: L201.2, U201.3 (SW)
/c2_TRIM: J201.1 (In), R201.2
/c2_VB: C202.1, C203.1, C204.2, L201.1, R203.2, U202.1 (IN), U202.3 (EN)
/c2_VL: C205.2, C206.2, Q202.3 (D), U202.5 (OUT)
/c2_VS: C201.2, C208.2, Q201.3 (D), U201.1 (EN), U201.4 (VIN), U203.5 (V+)
/c3_CJ: J301.1 (In), R301.2, R302.1
/c3_CK: R304.1, U301.4 (Y)
/c3_CM: C301.1, U302.4 (CAP-)
/c3_CP: C301.2, R301.1, U302.2 (CAP+)
/c3_G: Q301.1 (G), SW301.2 (B)
/c3_OJ: J302.1 (In), R305.1, R306.2
/c3_OSC: R304.2, U302.7 (OSC)
/c3_VO: C303.1, R303.2, R305.2, U302.5 (VOUT)
/c3_VS: C302.2, Q301.3 (D), U301.5 (VCC), U302.8 (V+)
/c4_CLK: U401.8 (CLK), U402.4 (Y)
/c4_COM: C402.1, R402.1, U401.1 (COM), U401.6 (OS)
/c4_G: Q401.1 (G), SW401.2 (B)
/c4_IN: C401.1, J401.1 (In), R401.2
/c4_INC: C401.2, R402.2, U401.2 (IN)
/c4_OUT: J402.1 (In), R404.1
/c4_OUTC: C404.1, R403.2, R404.2
/c4_OUTF: C404.2, U401.5 (OUT)
/c4_VS: C403.1, Q401.3 (D), U401.4 (V_{DD}), U401.7 (~SHDN), U402.5 (VCC)
/c5_CB: C501.2, U501.15 (D2)
/c5_CT: C501.1, U501.14 (D1)
/c5_G: Q501.1 (G), SW501.2 (B)
/c5_IN: J501.1 (In), R501.2, U501.13 (S1B)
/c5_OA: C504.2, R502.2, R503.1, U502.1 (OUT)
/c5_OUT: J502.1 (In), R503.2
/c5_VG: C504.1, R502.1, U501.1 (S2B), U502.4 (-IN)
/c5_VS: C502.1, C506.2, Q501.3 (D), U501.16 (V+), U502.5 (V+)
/c6_D1: R602.1, U605.4 (A)
/c6_D2: R605.2, U604.4 (A)
/c6_DEC: U602.5, U603.1 (D)
/c6_G: Q601.1 (G), SW601.2 (B)
/c6_I1: C601.2, R604.1, R606.2, U601.1
/c6_I1J: J602.1 (In), R606.1, R607.2
/c6_I2: C603.2, R608.1, R611.1, U601.7
/c6_I2C: R608.2, U602.3 (+)
/c6_I2J: J603.1 (In), R611.2, R612.2
/c6_IN: J601.1 (In), R601.1
/c6_S1: C601.1, R601.2, R602.2, R603.2, U601.2 (-)
/c6_S2: C603.1, R604.2, R605.1, U601.6 (-)
/c6_VM: C608.1, R609.2, R610.1, U601.3 (+), U601.5 (+), U602.1 (-)
/c6_VS: C604.1, Q601.3 (D), U601.8 (V+)
/c7_CH: C701.2, U701.8 (C_{h})
/c7_G: Q701.1 (G), SW701.2 (B)
/c7_IN: J701.1 (In), R701.1, U701.1 (I)
/c7_OA: R702.2, U701.7
/c7_OUT: J702.1 (In), R702.1
/c7_VS: C702.1, Q701.3 (D), U701.12 (V^{+})
/c8_A: R801.2, R802.2, U801.3 (IN+)
/c8_B: R803.2, R804.2, U801.4 (IN-)
/c8_DAC: J802.1 (In), R803.1
/c8_G: Q801.1 (G), SW801.2 (B)
/c8_IN: J801.1 (In), R801.1
/c8_VS: C801.2, Q801.3 (D), R802.1, R804.1, U801.5 (VCC)
/c9_EM: Q903.4 (E1), Q903.5 (E2), Q904.3 (C)
/c9_G: Q901.1 (G), SW901.2 (B)
/c9_INN: J902.1 (In), Q903.1 (B2), R902.2
/c9_INP: J901.1 (In), Q903.2 (B1), R901.2
/c9_MD: Q902.2 (B1), Q902.5 (B2), Q902.6 (C1), Q903.3 (C1)
/c9_MO: C902.1, Q902.3 (C2), Q903.6 (C2), R906.1, U901.4 (-IN)
/c9_OA: C902.2, R906.2, R907.1, U901.1 (OUT)
/c9_OUT: J903.1 (In), R907.2
/c9_TB: Q904.1 (B), R903.2, R904.2
/c9_TE: Q904.2 (E), R905.2
/c9_VS: C904.2, Q901.3 (D), Q902.1 (E1), Q902.4 (E2), U901.5 (V+)
/c10_B1: Q1002.2 (B1), R1002.2, R1003.2, R1005.1
/c10_BI: C1001.2, R1002.1
/c10_C1: J1003.1, Q1002.3 (C1), Q1002.5 (E2)
/c10_CB: C1002.2, Q1002.1 (B2), R1005.2, R1006.1
/c10_CN: J1003.2, Q1002.6 (C2), Q1003.1 (B), R1007.1
/c10_E1: Q1002.4 (E1), R1004.2
/c10_E3: C1003.1, Q1003.2 (E), R1008.2
/c10_G: Q1001.1 (G), SW1001.2 (B)
/c10_IN: C1001.1, J1001.1 (In), R1001.1
/c10_OC: C1003.2, R1009.1
/c10_OUT: J1002.1 (In), R1009.2
/c10_VS: Q1001.3 (D), Q1003.3 (C), R1006.2, R1007.2
/c11_CT: R1102.2, U1101.5 (CONT)
/c11_CV: J1101.1 (In), R1101.2, R1102.1
/c11_DS: R1103.1, R1104.2, U1101.7 (DISCH)
/c11_G: Q1101.1 (G), SW1101.2 (B)
/c11_O5: R1105.1, U1101.3 (OUT)
/c11_OJ: J1102.1 (In), R1105.2, R1106.2
/c11_TT: C1101.1, R1104.1, U1101.2 (TRIG), U1101.6 (THRES)
/c11_VS: C1102.2, Q1101.3 (D), R1103.2, U1101.4 (~RESET), U1101.8 (VDD)
/c12_G: Q1201.1 (G), SW1201.2 (B)
/c12_IN: J1201.1 (In), R1201.2, R1202.2, R1204.1
/c12_M: R1204.2, R1205.2, R1206.1, U1201.6 (-)
/c12_N: D1201.2 (K), R1202.1, R1203.1, U1201.2 (-)
/c12_OA: D1201.3 (COM), U1201.1
/c12_OB: R1206.2, R1207.2, U1201.7
/c12_OUT: J1202.1 (In), R1207.1
/c12_VS: C1201.1, Q1201.3 (D), U1201.8 (V+)
/c12_X: D1201.1 (A), R1203.2, R1205.1
GND: C101.2, C102.2, C104.2, C105.2, C106.2, C201.1, C202.2, C204.1, C205.1, C208.1, C302.1, C303.2, C402.2, C403.2, C502.2, C503.2, C505.2, C506.1, C602.1, C604.2, C605.1, C606.1, C607.2, C608.2, C701.1, C702.2, C703.1, C801.1, C901.1, C903.2, C904.1, C1002.1, C1101.2, C1102.1, C1201.2, C1202.2, D101.2 (A2), J101.A1 (GND), J101.A12 (GND), J101.B1 (GND), J101.B12 (GND), J101.SH (SHIELD), J102.2, J102.4, J201.2 (Ext), J202.2 (Ext), J203.2 (Ext), J204.2 (Ext), J301.2 (Ext), J302.2 (Ext), J401.2 (Ext), J402.2 (Ext), J501.2 (Ext), J502.2 (Ext), J601.2 (Ext), J602.2 (Ext), J603.2 (Ext), J701.2 (Ext), J702.2 (Ext), J801.2 (Ext), J802.2 (Ext), J901.2 (Ext), J902.2 (Ext), J903.2 (Ext), J904.3, J904.4, J1001.2 (Ext), J1002.2 (Ext), J1101.2 (Ext), J1102.2 (Ext), J1201.2 (Ext), J1202.2 (Ext), R101.1, R102.1, R103.2, R104.2, R202.2, R206.2, R210.1, R302.2, R303.1, R306.1, R401.1, R403.1, R501.1, R607.1, R610.2, R612.1, R701.2, R901.1, R902.1, R903.1, R1001.2, R1003.1, R1004.1, R1008.1, R1101.1, R1106.1, R1201.1, SW201.1 (A), SW301.1 (A), SW401.1 (A), SW501.1 (A), SW601.1 (A), SW701.1 (A), SW801.1 (A), SW901.1 (A), SW1001.1 (A), SW1101.1 (A), SW1201.1 (A), TP9901.1, TP9902.1, U101.1 (GND), U102.2 (GND), U201.2 (GND), U202.2 (GND), U203.2 (V-), U301.3 (GND), U302.3 (GND), U401.3 (GND), U402.3 (GND), U501.2 (S2A), U501.3 (S3B), U501.4 (D3), U501.5 (S3A), U501.6 (~EN), U501.8 (GND), U501.9 (SEL3), U501.12 (S1A), U502.3 (+IN), U602.2 (V-), U602.6 (SHDN), U603.3 (GND), U604.2 (GND), U604.3 (B1), U605.1 (B2), U605.2 (GND), U701.10 (T), U801.2 (GND), U901.3 (+IN), U1101.1 (GND), U1201.3 (+), U1201.5 (+)

Notes on the sheet:
Stage 1: inverting with BAT54S in its feedback, so its node X follows -IN for positive IN and stays at 0 for negative.
OUT
TPS7A2033: 3.3 V, about 92 dB of PSRR at 1 kHz and 40 dB at 1 MHz; below 3.5 V in it drops out (lower TRIM's voltage).
0-1 V
±1 V
c1 power, USB-C 5 V in: +5, -5, +3.3 out
TLV3201 (40 ns, 1.2 mV hysteresis) on the 3.3 V rail. Each input is averaged with the rail through a matched pair
cell (0,2)
is a load step. Keep it under 100 mA for long (the shunt is 1/8 W), steps can be larger. Both outputs are AC-coupled.
c10 cascode
TRIM
IN and OUT sit at COM (2.5 V), so both are AC-coupled. Sweep the clock and watch the corner follow; alias a tone.
a resistor of 1 / (f C). Make the phases non-overlapping, or overlap them and watch IN leak through. 1 M sets the DC gain.
cell (3,3)
USB-C power only: 5.1 k on each CC asks any source for 5 V. A 2 A PTC, a 5 V TVS (clamps at 9.2 V) and 20 uF.
cells (1,1), (2,1)
DAC
The socket along the top carries +5, ground, -5, ground, +3.3: the bench's rails for a breadboard experiment.
EXPECT: OUT = -1 k x (Ic1 - Ic2): +-1 V, tanh of (IN+ - IN-) / 2 VT, linear within about +-25 mV of balance
The load: an OPA810 servos 10 ohm to LOAD's voltage through an AO3400A (1 k and 1 nF slow its loop): a square on LOAD
±0.2 V
c11 555, TLC555
cell (0,1)
upper threshold through 2.2 k: a voltage-to-frequency converter. Count OUT's cycles in the FPGA and you have an ADC.
DAC, reads the bit, halves the step; a tracking ADC: up when high, down when low; a slope ADC with a ramp on DAC.
Q1's collector-base capacitance, multiplied by the gain (Miller), meets the 2.2 k at its base; the cascode holds Q1's
TLC555 astable: f = 1.44 / ((1 k + 2 x 10 k) x 10 nF), the capacitor between 1/3 and 2/3 of the supply. CV pulls the
of 0.1 % 10 k, so +-1 V lands at 1.15-2.15 V on both pins and the comparison is unchanged. 20 k input impedance:
tutorial Trading speed for bits (+5 V)
ICL7660A: switches charge the flying 1 uF across the supply and dump it, upside down, into the output's 1 uF. IO6
amp with its +5 V removed draws nothing. The TPS7A2033 makes 3.3 V for the comparator and the lines that meet the FPGA.
tutorial Switched capacitors (+-5 V)
holding, and the aperture delay against the FPGA's edge on IO5.
c3 charge pump, ICL7660A
EXPECT: a square near 6.9 kHz on OUT (5 V divided to about 1 V); CV moves it: up as CV falls, down as it rises
The LM2664 charge pump makes -5 V for the op-amp tiles (40 mA: four tiles at 10 mA); it is not switched per tile, an op
c8 comparator, TLV3201
MAX7410: a switched-capacitor ladder whose corner is the clock divided by 100, clocked from IO3 through an SN74LV1T34.
several times wider
cell (2,3)
tutorial Transistors (+-5 V)
decade (AMOD-A's a6 is first order: 20 dB), so a sinc3 decimator gets more bits per clock. INT1, INT2: high impedance.
c12 rectifier, precision
cells (0,3), (1,3)
ground loops for the scope's clips, one per channel, in the board's margins
EXPECT: OUT = |IN| from DC to about 100 kHz; above that the first stage's slew across the diodes leaves a glitch at each zero crossing
LOAD
holds the output node at 0 V and turns the difference current into volts. Sweep IN+ with IN- at 0 V: the tanh, its
no mounting holes: four stick-on rubber feet, marked on the back
TLV62568: 3.6 V from 100 k / 20 k; TRIM through 100 k into the feedback node moves it (0 V: 4.2 V, +1 V: 3.2 V, open: 3.6 V).
LDO~
EXPECT: BIT on Pmod IO2 is high while IN is above DAC; a SAR search in gateware gives 12 bits in 12 steps of the DAC
c5 SC integrator, TMUX4053
EXPECT: BUCK~ shows the buck's 1.5 MHz ripple (a few mV, pulse-skipping below about 150 mA); LDO~ the same after the LDO, 40 dB smaller; LOAD sets 100 mA per volt
tutorial Switched capacitors (+5 V)
CAP
cells (1,2), (2,2)
IN-
EXPECT: an integrator whose input resistor is 1 / (f x 1 nF): 1 M at 1 kHz, 1 k at 1 MHz; OUT = -(1 / R C) x the integral of IN
drive it from a 50 ohm source, read the bit on IO2. A successive-approximation ADC: the gateware sets the host's
tutorial Regulators (+5 V)
c2 regulators, buck, LDO, load
c7 track and hold, LF398
c6 delta-sigma, second order
clocks it through an SN74LV1T34 and 1 k; with 1 k of load, sweep the clock and read OUT: Rout = 1 / (f C) + 60 ohm.
phi1 (IO4) connects the 1 nF's top plate to IN, phi2 (IO8) its bottom plate to the summing node: C x Vin per cycle at f,
INT1
tutorial Transistors (+5 V)
tutorial Regulators, Switched capacitors
EXPECT: a one-bit stream on IO7 whose density follows IN (+-1.65 V full scale), its noise shaped at 40 dB per decade
slope gm = Itail / (4 VT), about 10 mS here; a triangle in becomes a sine-like wave out when it is driven past balance.
c9 differential pair
INT2
cell (0,0)
tutorial Trading speed for bits (+-5 V)
EXPECT: +5 V from the USB-C (up to 1.5 A), -5 V at 40 mA, +3.3 V at 300 mA; the green LED says 5 V is in, the red one that -5 V is up
±50 mV
Clock IO1 at about 1 MHz and count IO7's ones. The second integrator pushes the quantization noise up at 40 dB per
EXPECT: about -5 V on the output, falling with load as 1 / (f C) + the switches: 2 k at 1 kHz, 80 ohm at 100 kHz (the pump at half IO6's clock)
A matched NPN pair (DMMT3904W: 2 mV of VBE, 2 % of hFE) on a 1 mA tail; a matched PNP pair as the mirror; an OPA810
cell (3,2)
cell (3,0)
EXPECT: gain about -6 into a high impedance (-8 at Q1's collector), half that into 50 ohm; common emitter (jumper on) about 2 MHz wide, the cascode (jumper parked)
±2 V
cells (1,0), (2,0)
collector still, so only one Ccb counts. The jumper on the header shorts the cascode out: compare the two sweeps.
Stage 2: OUT = -(IN + 2 X) = |IN|. No dead zone from the diodes (the op amp's gain hides their drop) until the op amp
LF398 on +-5 V (its minimum supply: inputs within +-1.5 V). 1 nF C0G: acquisition about 4 us, droop about 30 mV/s.
Measure the acquisition time, the droop, the pedestal (the hold step) against IN, the feedthrough of a sine while
BUCK~
EXPECT: OUT follows IN while IO5 is high and holds when it falls: 4 us to acquire, about 30 mV/s of droop, a few mV of hold step
tutorial Trading speed for bits (+3.3 V)
IN+
EXPECT: a 5th-order Butterworth low-pass at fCLK / 100 (up to 15 kHz from a 1.5 MHz clock on IO3); the clock's images near fCLK
cell (3,1)
c4 SC filter, MAX7410
must slew through two diode drops at each zero crossing: watch the glitch grow with frequency.
