gallicchio/AMOD-and-RFMOD/hardware/amod_c.kicad_pcb

## KiCad design hardware/amod_c.kicad_pcb (continued)

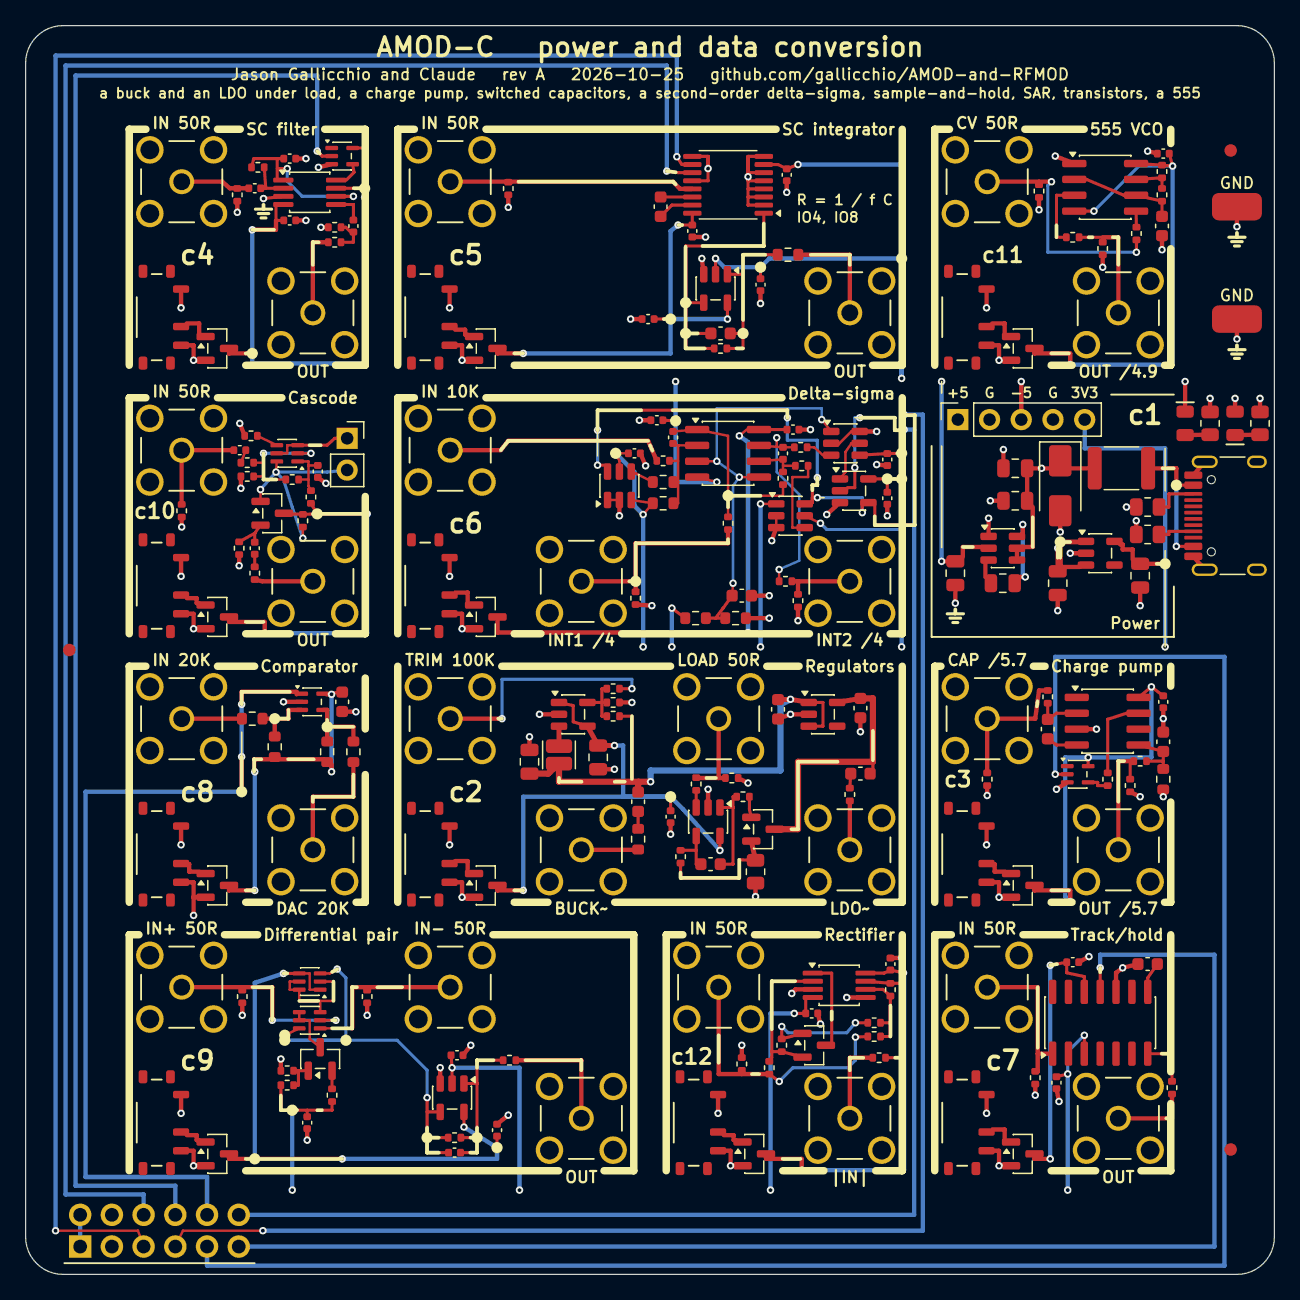
[picture p252: board amod_c.kicad_pcb from above]

Board: 4 copper layers, 100.0 x 100.0 mm, 211 parts (0 on the bottom side), 129 nets.
