gallicchio/AMOD-and-RFMOD/hardware/amod_p.kicad_pcb

## KiCad design hardware/amod_p.kicad_pcb (2026-10-30)

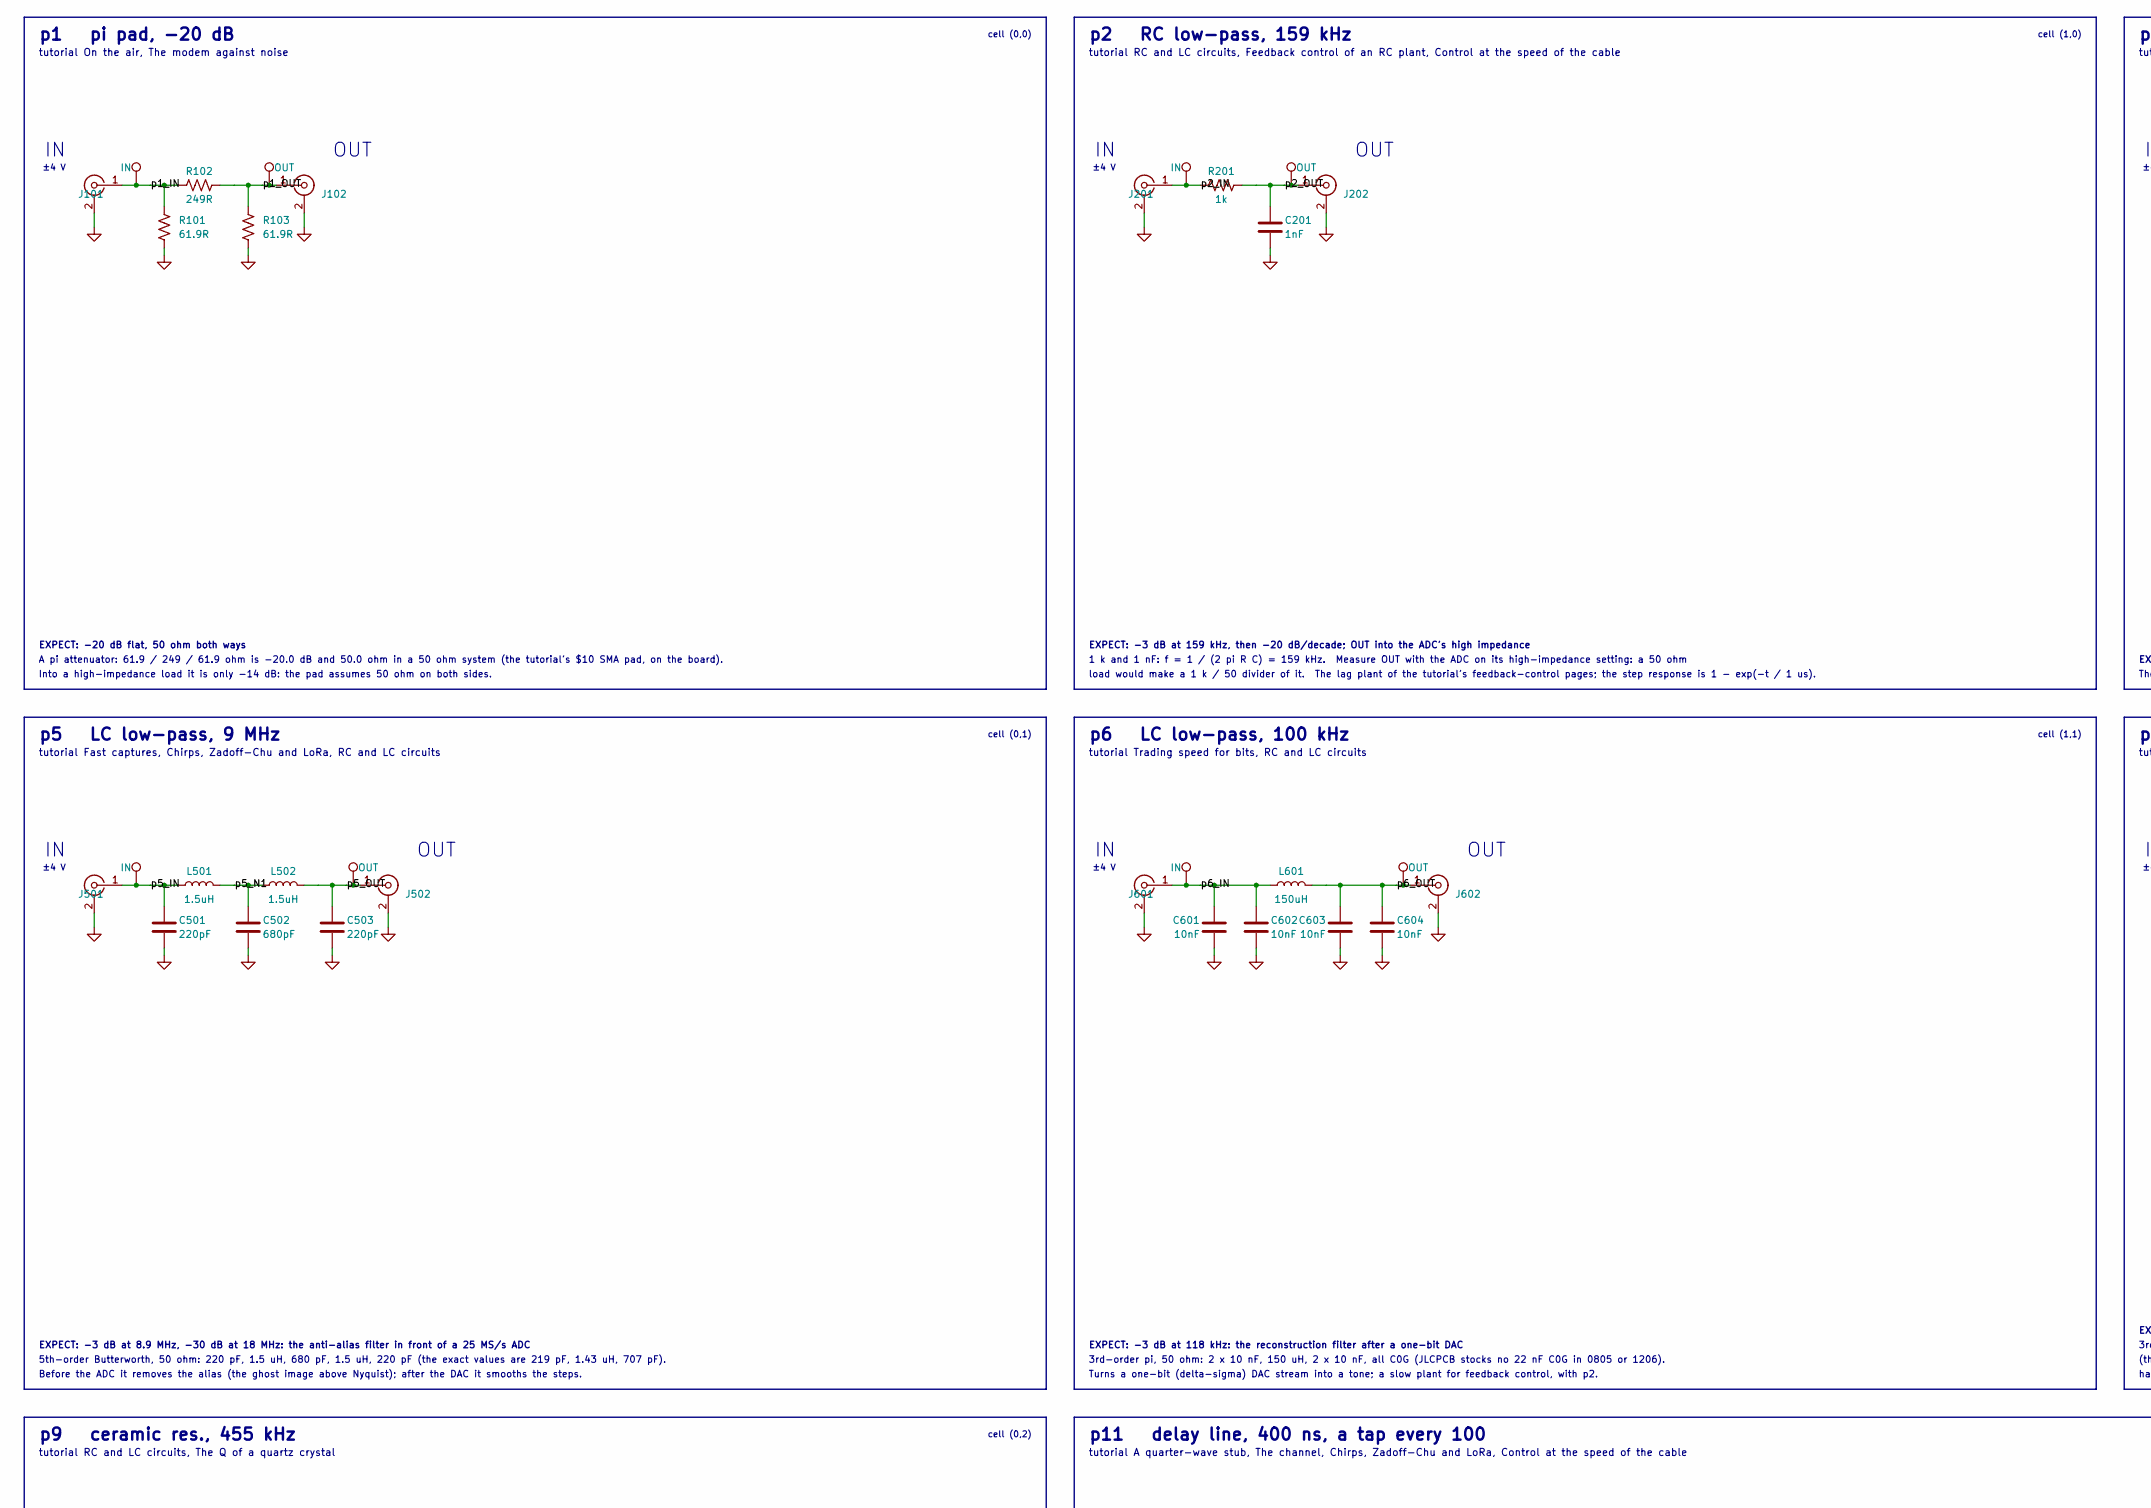
[picture p253: schematic amod_p.kicad_sch, AMOD-P: passive building blocks for the converters, part in row 1, column 1]

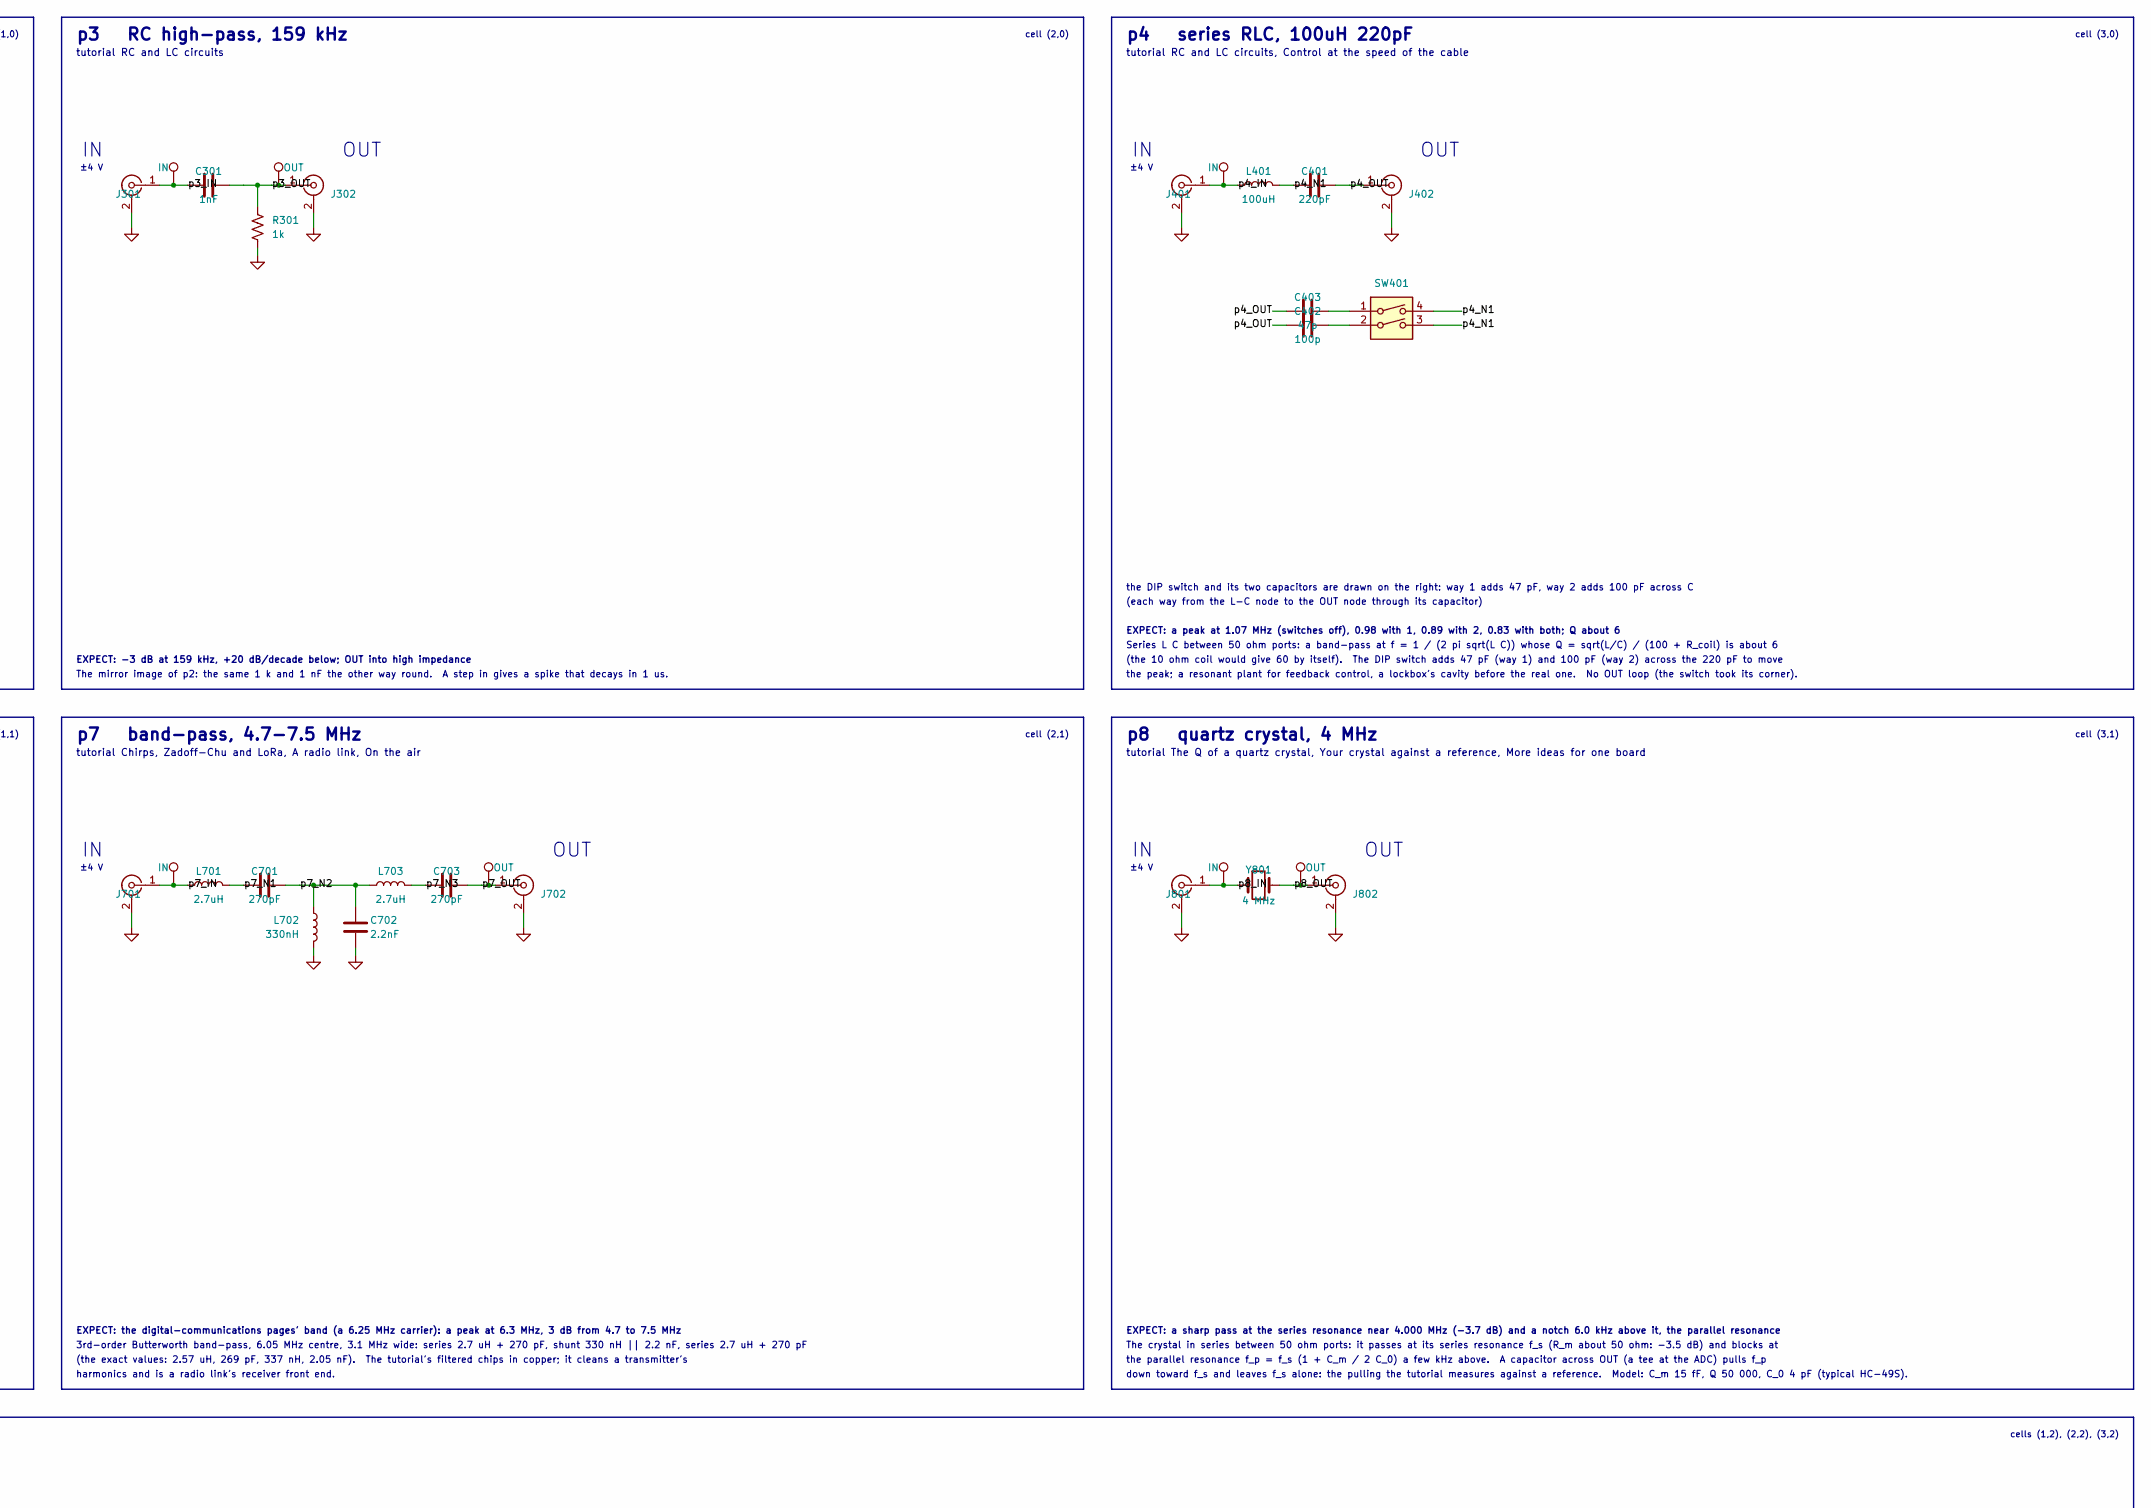
[picture p254: schematic amod_p.kicad_sch, AMOD-P: passive building blocks for the converters, part in row 1, column 2]

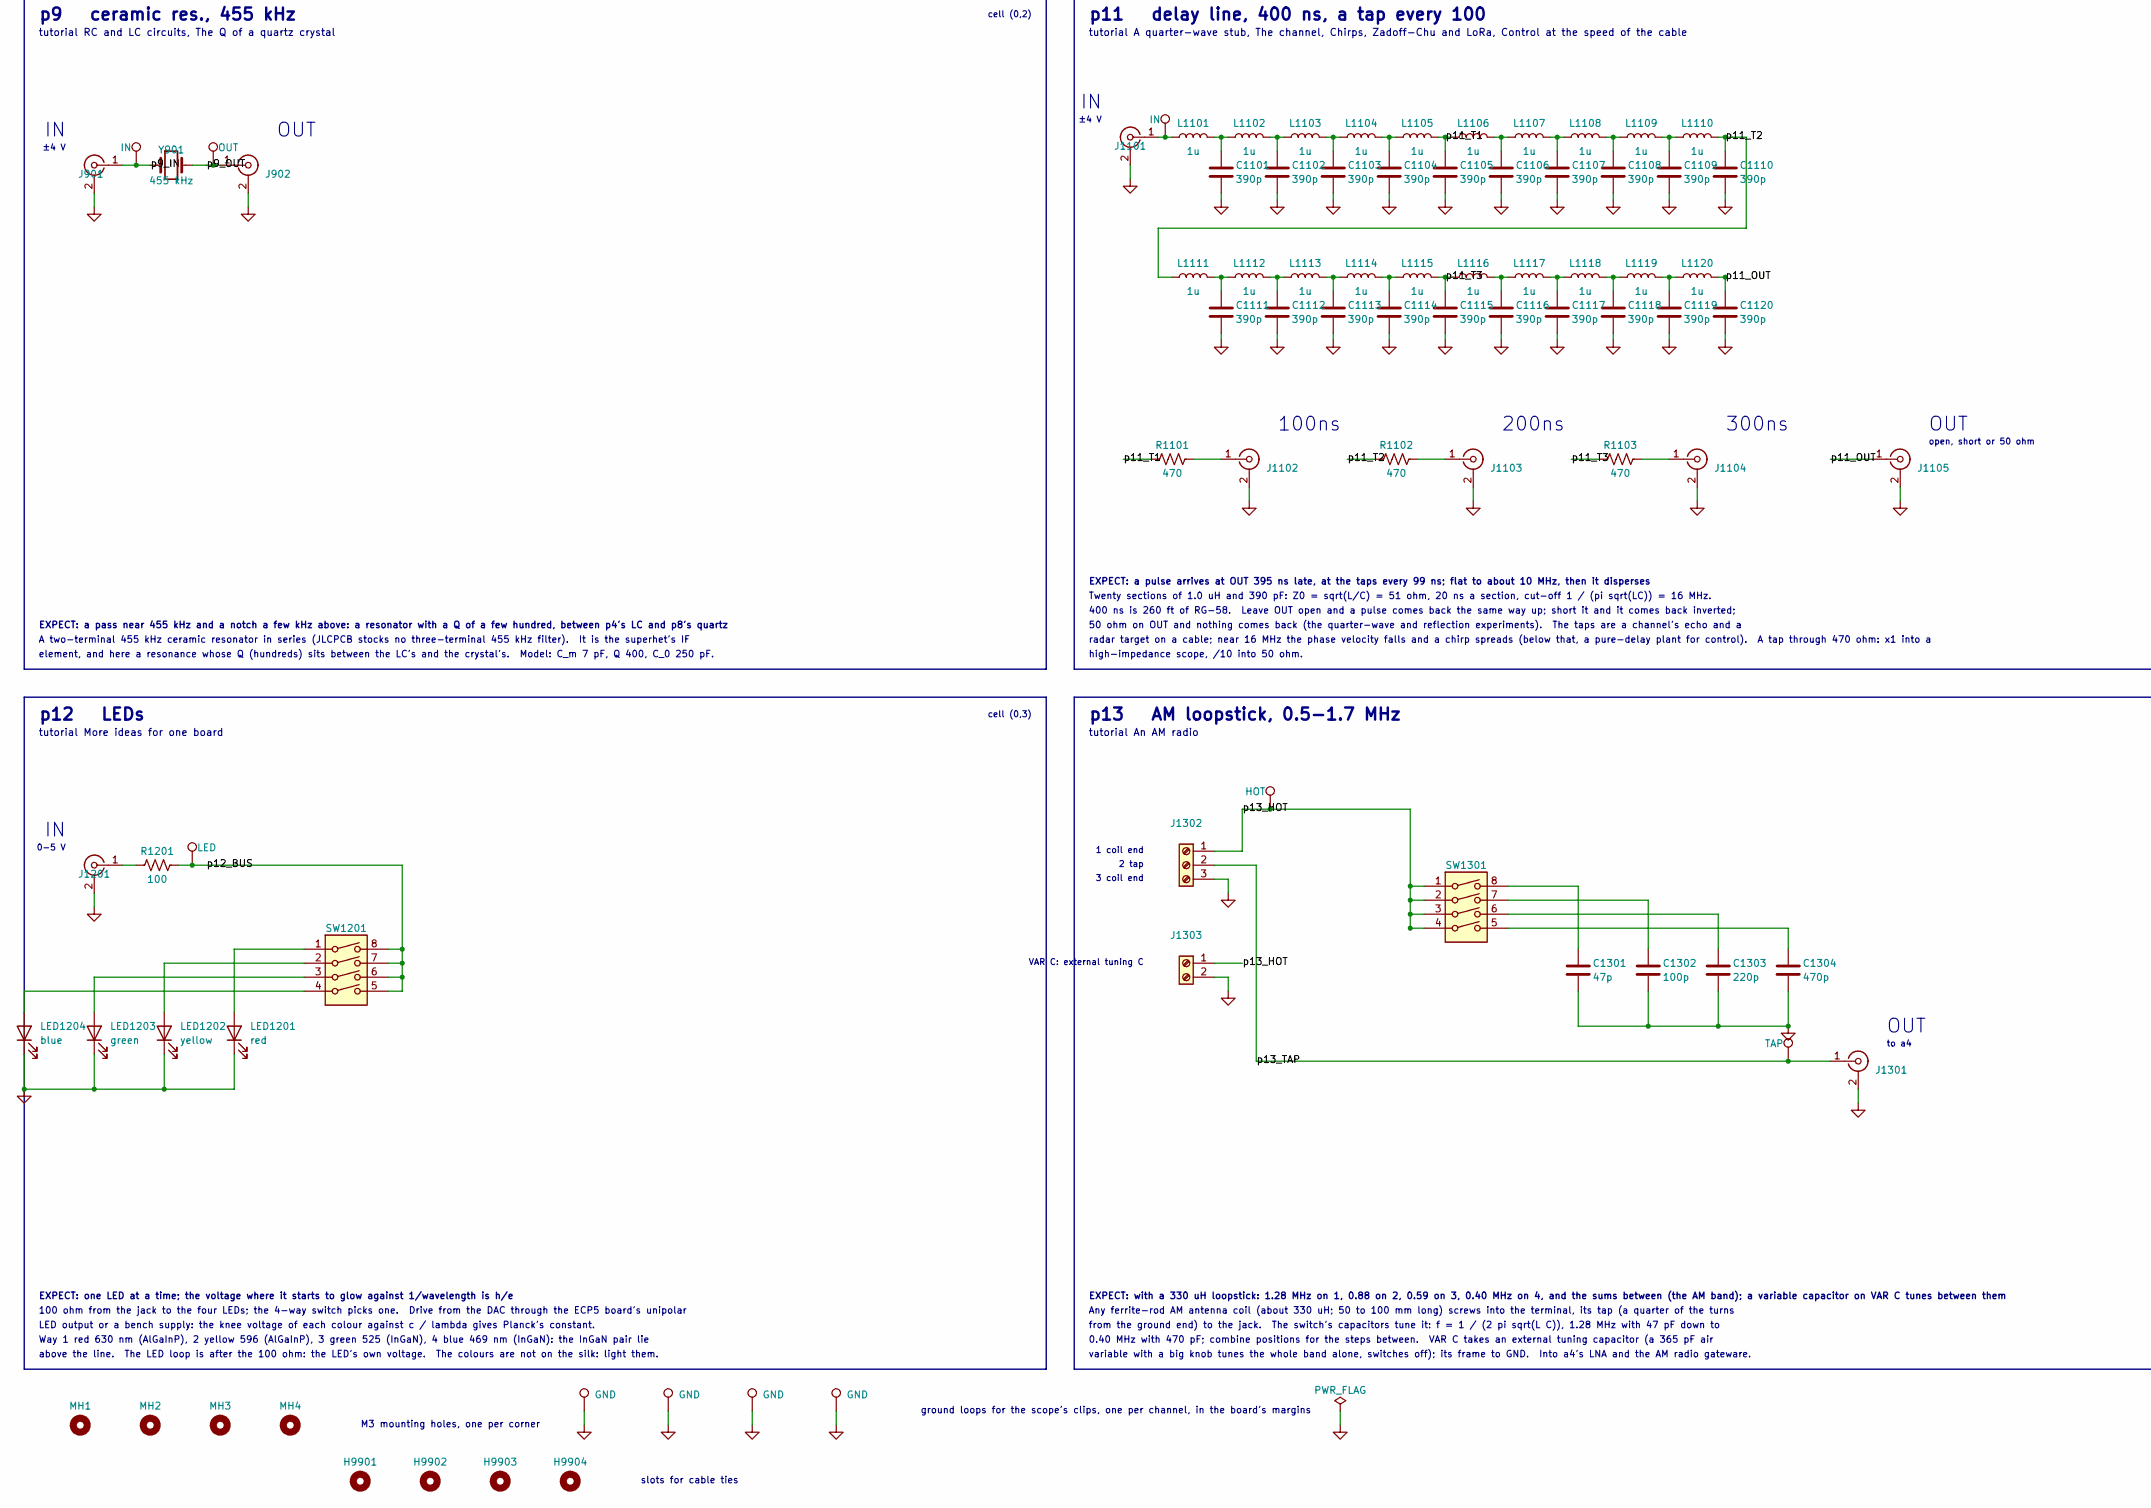
[picture p255: schematic amod_p.kicad_sch, AMOD-P: passive building blocks for the converters, part in row 2, column 1]

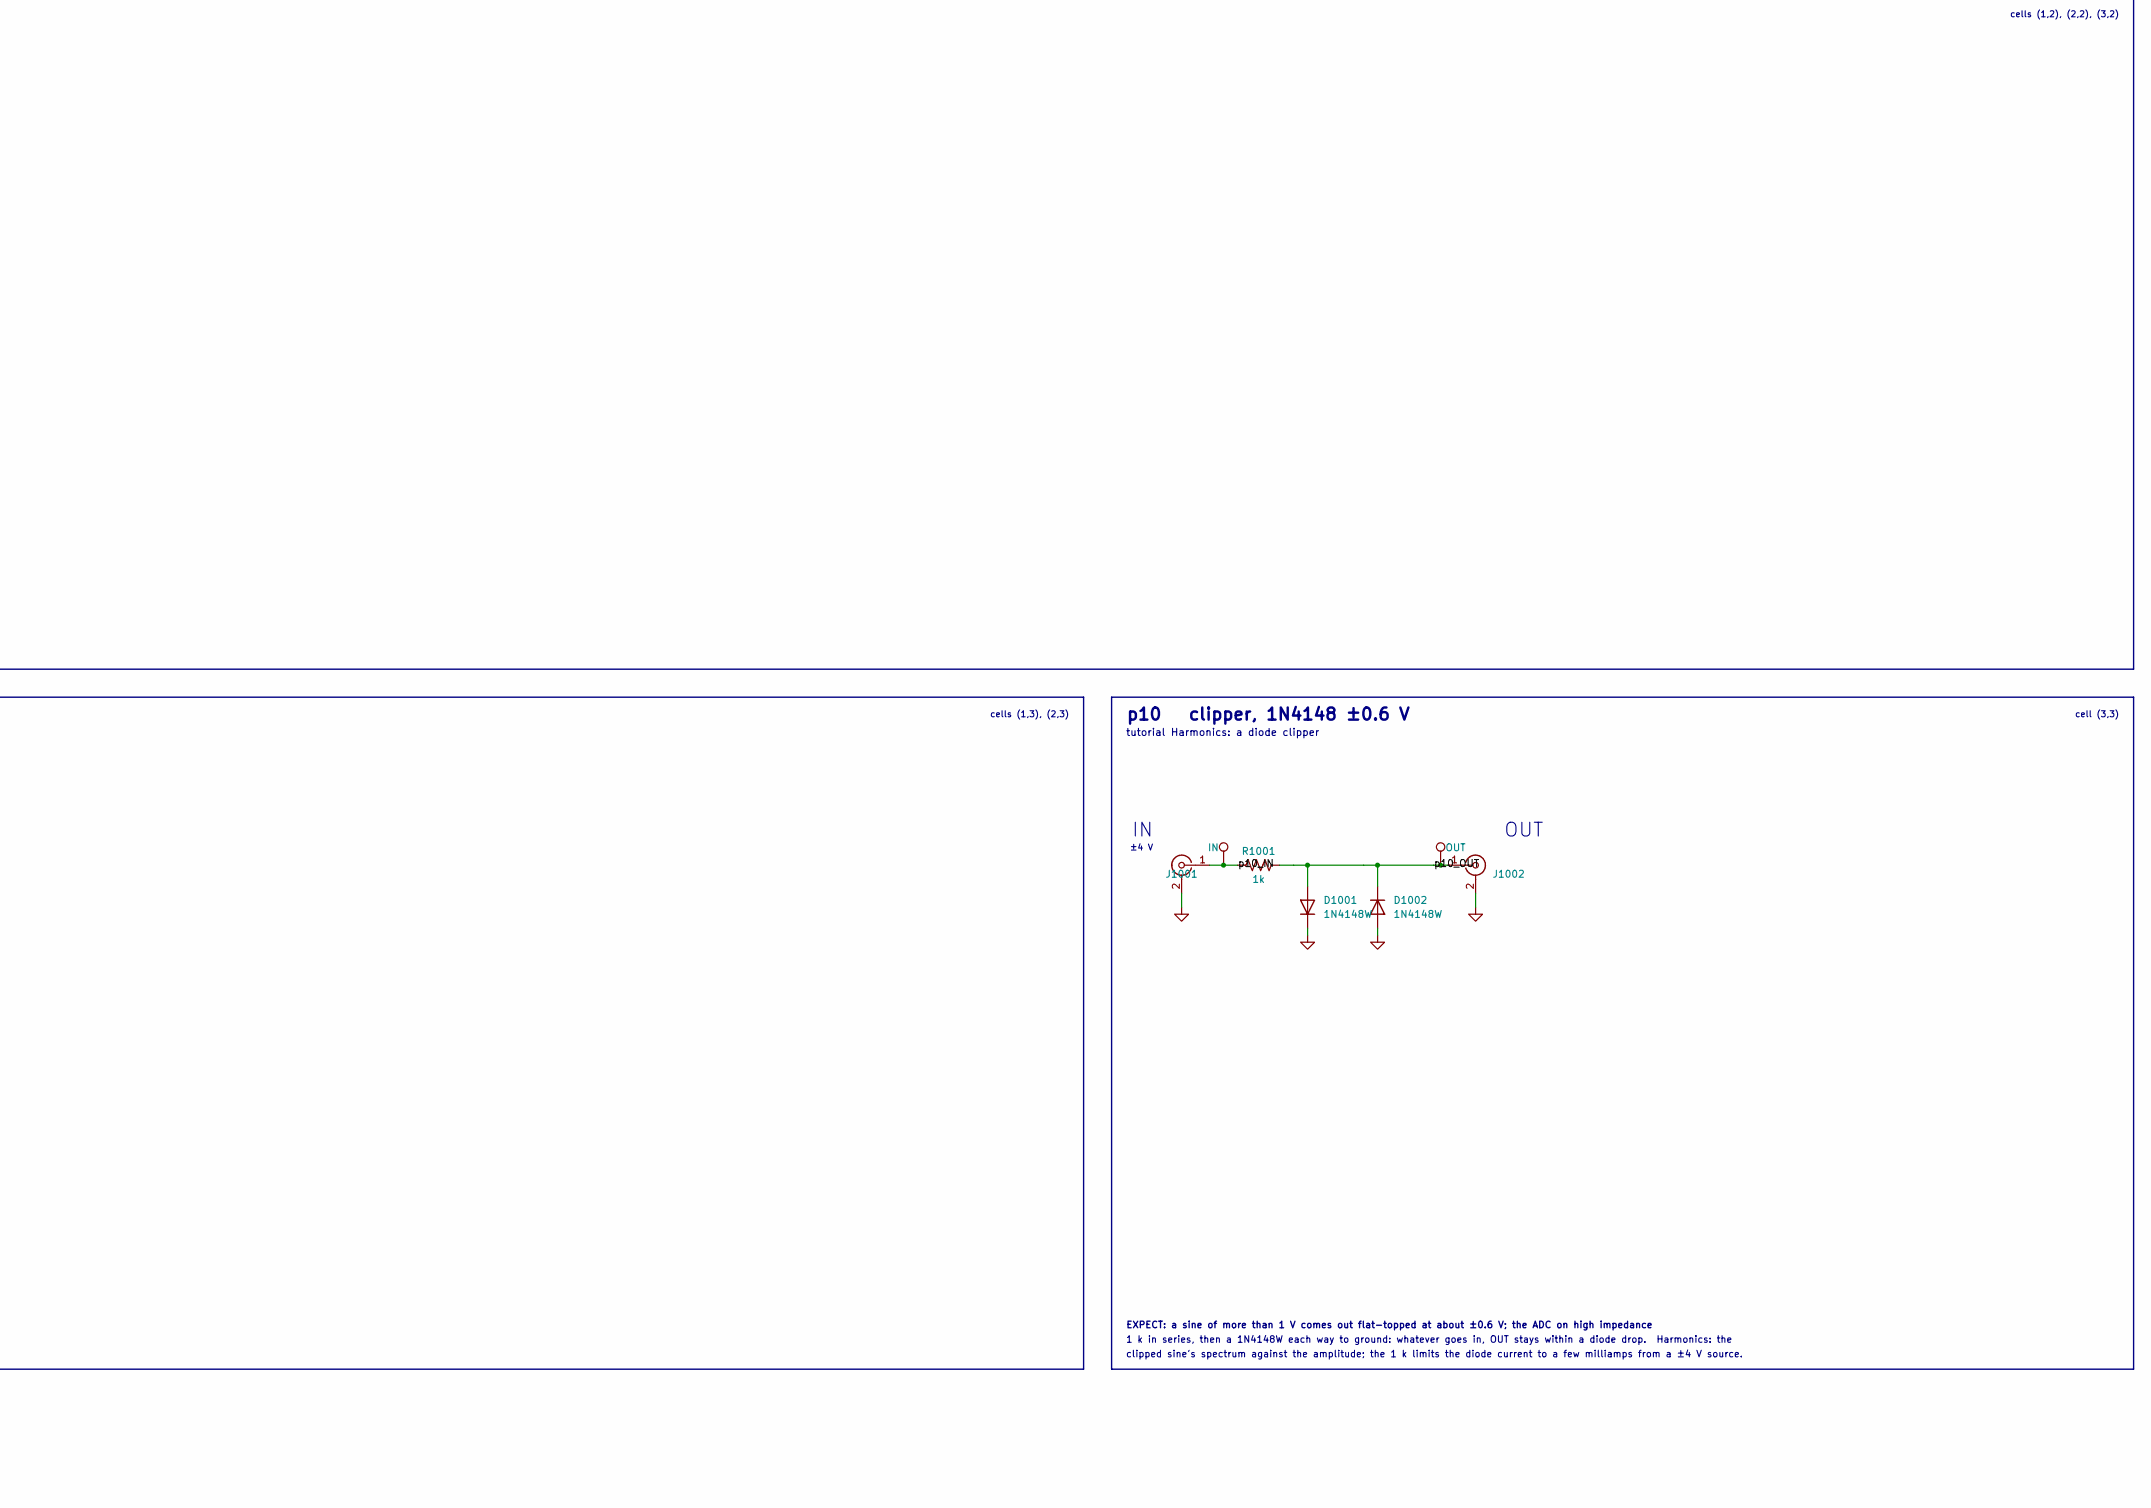
[picture p256: schematic amod_p.kicad_sch, AMOD-P: passive building blocks for the converters, part in row 2, column 2]

Parts:
C201, C301: 1nF; C_0805_2012Metric; MPN 0805CG102J500NT; LCSC C29925
C401, C501, C503: 220pF; C_0805_2012Metric; MPN 0805CG221J500NT; LCSC C1805
C402: 100p; C_0603_1608Metric; MPN CL10C101JB8NNNC; LCSC C14858
C403: 47p; C_0603_1608Metric; MPN CL10C470JB8NNNC; LCSC C1671
C502: 680pF; C_0805_2012Metric; MPN 0805CG681J500NT; LCSC C1835
C601, C602, C603, C604: 10nF; C_0805_2012Metric; MPN 0805CG103J500NT; LCSC C2971995
C701, C703: 270pF; C_0603_1608Metric; MPN 0603CG271J500NT; LCSC C501846
C702: 2.2nF; C_0603_1608Metric; MPN 0603CG222J500NT; LCSC C2991172
C1101, C1102, C1103, C1104, C1105, C1106, C1107, C1108, C1109, C1110, C1111, C1112, C1113, C1114, C1115, C1116, C1117, C1118, C1119, C1120: 390p; C_0402_1005Metric; MPN CC0402JRNPO9BN391; LCSC C282239
C1301: 47p; C_0805_2012Metric; MPN CL21C470JBANNNC; LCSC C14857
C1302: 100p; C_0805_2012Metric; MPN CL21C101JBANNNC; LCSC C1790
C1303: 220p; C_0805_2012Metric; MPN 0805CG221J500NT; LCSC C1805
C1304: 470p; C_0805_2012Metric; MPN 0805CG471J500NT; LCSC C1822
D1001, D1002: 1N4148W; D_SOD-123; MPN 1N4148W; LCSC C81598
H9901, H9902, H9903, H9904: slot; Slot_CableTie_1.2x3.4mm
J101, J102, J201, J202, J301, J302, J401, J402, J501, J502, J601, J602, J701, J702, J801, J802, J901, J902, J1001, J1002, J1101, J1102, J1103, J1104, J1105, J1201, J1301: SMA; SMA_BWSMA-KE-Z001_Vertical; MPN BWSMA-KE-Z001; LCSC C496549
J1302: coil; TerminalBlock_KF301_1x03_P5.00mm; MPN KF301-5.0-3P; LCSC C474882
J1303: VAR C; TerminalBlock_KF301_1x02_P5.00mm; MPN KF301-5.0-2P; LCSC C474881
L401: 100uH; L_1210_3225Metric; MPN NLV32T-101J-PF; LCSC C76836
L501, L502: 1.5uH; L_0805_2012Metric; MPN SDFL2012Q1R5KTF; LCSC C316402
L601: 150uH; L_1210_3225Metric; MPN NLCV32T-151K-EF; LCSC C250237
L701, L703: 2.7uH; L_0603_1608Metric; MPN SDFL1608Q2R7KTF; LCSC C29946
L702: 330nH; L_0603_1608Metric; MPN CS0603-R33J-S; LCSC C142165
L1101, L1102, L1103, L1104, L1105, L1106, L1107, L1108, L1109, L1110, L1111, L1112, L1113, L1114, L1115, L1116, L1117, L1118, L1119, L1120: 1u; L_0603_1608Metric; MPN SDFL1608Q1R0KTF; LCSC C22037
LED1201: red; LED_0805_2012Metric_Kbar; MPN NCD0805R1; LCSC C84256
LED1202: yellow; LED_0805_2012Metric_Kbar; MPN KT-0805Y; LCSC C2296
LED1203: green; LED_0805_2012Metric_Kbar; MPN KT-0805G; LCSC C2297
LED1204: blue; LED_0805_2012Metric_Kbar; MPN KT-0805B; LCSC C2293
MH1, MH2, MH3, MH4: MountingHole; MountingHole_3.2mm_M3
R101, R103: 61.9R; R_0805_2012Metric; MPN 0805W8F619JT5E; LCSC C17779
R102: 249R; R_0805_2012Metric; MPN 0805W8F2490T5E; LCSC C32281
R201, R301, R1001: 1k; R_0805_2012Metric; MPN 0805W8F1001T5E; LCSC C17513
R1101, R1102, R1103: 470; R_0805_2012Metric; MPN 0805W8F4700T5E; LCSC C17710
R1201: 100; R_0805_2012Metric; MPN 0805W8F1000T5E; LCSC C17408
SW401: DIP2; SW_DIP_SPSTx02_Slide_1.27mm_DSHP02; MPN DSHP02TSGET; LCSC C40735
SW1201, SW1301: DIP4; SW_DIP_SPSTx04_Slide_1.27mm_DSHP04; MPN DSHP04TSGET; LCSC C40736
TP101, TP201, TP301, TP401, TP501, TP601, TP701, TP801, TP901, TP1001, TP1101: IN; TestPoint_Loop_RH-5019; MPN RH-5019; LCSC C5199800
TP102, TP202, TP302, TP502, TP602, TP702, TP802, TP902, TP1002: OUT; TestPoint_Loop_RH-5019; MPN RH-5019; LCSC C5199800
TP1201: LED; TestPoint_Loop_RH-5019; MPN RH-5019; LCSC C5199800
TP1301: TAP; TestPoint_Loop_RH-5019; MPN RH-5019; LCSC C5199800
TP1302: HOT; TestPoint_Loop_RH-5019; MPN RH-5019; LCSC C5199800
TP9901, TP9902, TP9903, TP9904: GND; TestPoint_Loop_RH-5019; MPN RH-5019; LCSC C5199800
Y801: 4 MHz; Crystal_HC49-S_SMD; MPN X49SM4MSD2SC; LCSC C13774
Y901: 455 kHz; Resonator_Ceramic_2Pin_P5.00mm_KCR455E; MPN KCR455E; LCSC C366989

Connections:
/p1_IN: J101.1 (In), R101.1, R102.1, TP101.1
/p1_OUT: J102.1 (In), R102.2, R103.1, TP102.1
/p2_IN: J201.1 (In), R201.1, TP201.1
/p2_OUT: C201.1, J202.1 (In), R201.2, TP202.1
/p3_IN: C301.1, J301.1 (In), TP301.1
/p3_OUT: C301.2, J302.1 (In), R301.1, TP302.1
/p4_IN: J401.1 (In), L401.1, TP401.1
/p4_N1: C401.1, L401.2, SW401.3, SW401.4
/p4_OUT: C401.2, C402.2, C403.2, J402.1 (In)
/p5_IN: C501.1, J501.1 (In), L501.1, TP501.1
/p5_N1: C502.1, L501.2, L502.1
/p5_OUT: C503.1, J502.1 (In), L502.2, TP502.1
/p6_IN: C601.1, C602.1, J601.1 (In), L601.1, TP601.1
/p6_OUT: C603.1, C604.1, J602.1 (In), L601.2, TP602.1
/p7_IN: J701.1 (In), L701.1, TP701.1
/p7_N1: C701.1, L701.2
/p7_N2: C701.2, C702.1, L702.1, L703.1
/p7_N3: C703.1, L703.2
/p7_OUT: C703.2, J702.1 (In), TP702.1
/p8_IN: J801.1 (In), TP801.1, Y801.1
/p8_OUT: J802.1 (In), TP802.1, Y801.2
/p9_IN: J901.1 (In), TP901.1, Y901.1
/p9_OUT: J902.1 (In), TP902.1, Y901.2
/p10_IN: J1001.1 (In), R1001.1, TP1001.1
/p10_OUT: D1001.2 (A), D1002.1 (K), J1002.1 (In), R1001.2, TP1002.1
/p11_OUT: C1120.1, J1105.1 (In), L1120.2
/p11_T1: C1105.1, L1105.2, L1106.1, R1101.1
/p11_T2: C1110.1, L1110.2, L1111.1, R1102.1
/p11_T3: C1115.1, L1115.2, L1116.1, R1103.1
/p12_BUS: R1201.2, SW1201.5, SW1201.6, SW1201.7, SW1201.8, TP1201.1
/p13_HOT: J1302.1, J1303.1, SW1301.1, SW1301.2, SW1301.3, SW1301.4, TP1302.1
/p13_TAP: J1301.1 (In), J1302.2, TP1301.1
GND: C201.2, C501.2, C502.2, C503.2, C601.2, C602.2, C603.2, C604.2, C702.2, C1101.2, C1102.2, C1103.2, C1104.2, C1105.2, C1106.2, C1107.2, C1108.2, C1109.2, C1110.2, C1111.2, C1112.2, C1113.2, C1114.2, C1115.2, C1116.2, C1117.2, C1118.2, C1119.2, C1120.2, C1301.2, C1302.2, C1303.2, C1304.2, D1001.1 (K), D1002.2 (A), J101.2 (Ext), J102.2 (Ext), J201.2 (Ext), J202.2 (Ext), J301.2 (Ext), J302.2 (Ext), J401.2 (Ext), J402.2 (Ext), J501.2 (Ext), J502.2 (Ext), J601.2 (Ext), J602.2 (Ext), J701.2 (Ext), J702.2 (Ext), J801.2 (Ext), J802.2 (Ext), J901.2 (Ext), J902.2 (Ext), J1001.2 (Ext), J1002.2 (Ext), J1101.2 (Ext), J1102.2 (Ext), J1103.2 (Ext), J1104.2 (Ext), J1105.2 (Ext), J1201.2 (Ext), J1301.2 (Ext), J1302.3, J1303.2, L702.2, LED1201.1 (K), LED1202.1 (K), LED1203.1 (K), LED1204.1 (K), R101.2, R103.2, R301.2, TP9901.1, TP9902.1, TP9903.1, TP9904.1
unnamed: C402.1, SW401.2
unnamed: C403.1, SW401.1
unnamed: C1101.1, L1101.2, L1102.1
unnamed: C1102.1, L1102.2, L1103.1
unnamed: C1103.1, L1103.2, L1104.1
unnamed: C1104.1, L1104.2, L1105.1
unnamed: C1106.1, L1106.2, L1107.1
unnamed: C1107.1, L1107.2, L1108.1
unnamed: C1108.1, L1108.2, L1109.1
unnamed: C1109.1, L1109.2, L1110.1
unnamed: C1111.1, L1111.2, L1112.1
unnamed: C1112.1, L1112.2, L1113.1
unnamed: C1113.1, L1113.2, L1114.1
unnamed: C1114.1, L1114.2, L1115.1
unnamed: C1116.1, L1116.2, L1117.1
unnamed: C1117.1, L1117.2, L1118.1
unnamed: C1118.1, L1118.2, L1119.1
unnamed: C1119.1, L1119.2, L1120.1
unnamed: C1301.1, SW1301.8
unnamed: C1302.1, SW1301.7
unnamed: C1303.1, SW1301.6
unnamed: C1304.1, SW1301.5
unnamed: J1101.1 (In), L1101.1, TP1101.1
unnamed: J1102.1 (In), R1101.2
unnamed: J1103.1 (In), R1102.2
unnamed: J1104.1 (In), R1103.2
unnamed: J1201.1 (In), R1201.1
unnamed: LED1201.2 (A), SW1201.1
unnamed: LED1202.2 (A), SW1201.2
unnamed: LED1203.2 (A), SW1201.3
unnamed: LED1204.2 (A), SW1201.4

Notes on the sheet:
1 k in series, then a 1N4148W each way to ground: whatever goes in, OUT stays within a diode drop. Harmonics: the
±4 V
the peak; a resonant plant for feedback control, a lockbox's cavity before the real one. No OUT loop (the switch took its corner).
50 ohm on OUT and nothing comes back (the quarter-wave and reflection experiments). The taps are a channel's echo and a
p10 clipper, 1N4148 ±0.6 V
Series L C between 50 ohm ports: a band-pass at f = 1 / (2 pi sqrt(L C)) whose Q = sqrt(L/C) / (100 + R_coil) is about 6
EXPECT: -3 dB at 159 kHz, then -20 dB/decade; OUT into the ADC's high impedance
p8 quartz crystal, 4 MHz
cell (2,1)
EXPECT: -20 dB flat, 50 ohm both ways
2 tap
100 ohm from the jack to the four LEDs; the 4-way switch picks one. Drive from the DAC through the ECP5 board's unipolar
EXPECT: with a 330 uH loopstick: 1.28 MHz on 1, 0.88 on 2, 0.59 on 3, 0.40 MHz on 4, and the sums between (the AM band); a variable capacitor on VAR C tunes between them
cell (0,2)
EXPECT: -3 dB at 8.9 MHz, -30 dB at 18 MHz: the anti-alias filter in front of a 25 MS/s ADC
The mirror image of p2: the same 1 k and 1 nF the other way round. A step in gives a spike that decays in 1 us.
clipped sine's spectrum against the amplitude; the 1 k limits the diode current to a few milliamps from a ±4 V source.
cell (2,0)
(the exact values: 2.57 uH, 269 pF, 337 nH, 2.05 nF). The tutorial's filtered chips in copper; it cleans a transmitter's
p11 delay line, 400 ns, a tap every 100
p13 AM loopstick, 0.5-1.7 MHz
cell (3,3)
400 ns is 260 ft of RG-58. Leave OUT open and a pulse comes back the same way up; short it and it comes back inverted;
cells (1,3), (2,3)
p4 series RLC, 100uH 220pF
EXPECT: -3 dB at 118 kHz: the reconstruction filter after a one-bit DAC
above the line. The LED loop is after the 100 ohm: the LED's own voltage. The colours are not on the silk: light them.
3rd-order Butterworth band-pass, 6.05 MHz centre, 3.1 MHz wide: series 2.7 uH + 270 pF, shunt 330 nH || 2.2 nF, series 2.7 uH + 270 pF
p9 ceramic res., 455 kHz
p12 LEDs
p6 LC low-pass, 100 kHz
slots for cable ties
p2 RC low-pass, 159 kHz
200ns
cell (0,1)
EXPECT: a sine of more than 1 V comes out flat-topped at about ±0.6 V; the ADC on high impedance
(the 10 ohm coil would give 60 by itself). The DIP switch adds 47 pF (way 1) and 100 pF (way 2) across the 220 pF to move
radar target on a cable; near 16 MHz the phase velocity falls and a chirp spreads (below that, a pure-delay plant for control). A tap through 470 ohm: x1 into a
cells (1,2), (2,2), (3,2)
cell (0,3)
element, and here a resonance whose Q (hundreds) sits between the LC's and the crystal's. Model: C_m 7 pF, Q 400, C_0 250 pF.
OUT
LED output or a bench supply: the knee voltage of each colour against c / lambda gives Planck's constant.
tutorial Harmonics: a diode clipper
tutorial Chirps, Zadoff-Chu and LoRa, A radio link, On the air
p5 LC low-pass, 9 MHz
the DIP switch and its two capacitors are drawn on the right: way 1 adds 47 pF, way 2 adds 100 pF across C
down toward f_s and leaves f_s alone: the pulling the tutorial measures against a reference. Model: C_m 15 fF, Q 50 000, C_0 4 pF (typical HC-49S).
EXPECT: the digital-communications pages' band (a 6.25 MHz carrier): a peak at 6.3 MHz, 3 dB from 4.7 to 7.5 MHz
Way 1 red 630 nm (AlGaInP), 2 yellow 596 (AlGaInP), 3 green 525 (InGaN), 4 blue 469 nm (InGaN): the InGaN pair lie
ground loops for the scope's clips, one per channel, in the board's margins
p1 pi pad, -20 dB
3 coil end
EXPECT: a pass near 455 kHz and a notch a few kHz above: a resonator with a Q of a few hundred, between p4's LC and p8's quartz
A two-terminal 455 kHz ceramic resonator in series (JLCPCB stocks no three-terminal 455 kHz filter). It is the superhet's IF
high-impedance scope, /10 into 50 ohm.
EXPECT: one LED at a time; the voltage where it starts to glow against 1/wavelength is h/e
EXPECT: a pulse arrives at OUT 395 ns late, at the taps every 99 ns; flat to about 10 MHz, then it disperses
Any ferrite-rod AM antenna coil (about 330 uH; 50 to 100 mm long) screws into the terminal, its tap (a quarter of the turns
5th-order Butterworth, 50 ohm: 220 pF, 1.5 uH, 680 pF, 1.5 uH, 220 pF (the exact values are 219 pF, 1.43 uH, 707 pF).
from the ground end) to the jack. The switch's capacitors tune it: f = 1 / (2 pi sqrt(L C)), 1.28 MHz with 47 pF down to
VAR C: external tuning C
p7 band-pass, 4.7-7.5 MHz
load would make a 1 k / 50 divider of it. The lag plant of the tutorial's feedback-control pages; the step response is 1 - exp(-t / 1 us).
3rd-order pi, 50 ohm: 2 x 10 nF, 150 uH, 2 x 10 nF, all C0G (JLCPCB stocks no 22 nF C0G in 0805 or 1206).
300ns
The crystal in series between 50 ohm ports: it passes at its series resonance f_s (R_m about 50 ohm: -3.5 dB) and blocks at
EXPECT: a peak at 1.07 MHz (switches off), 0.98 with 1, 0.89 with 2, 0.83 with both; Q about 6
harmonics and is a radio link's receiver front end.
0-5 V
open, short or 50 ohm
Twenty sections of 1.0 uH and 390 pF: Z0 = sqrt(L/C) = 51 ohm, 20 ns a section, cut-off 1 / (pi sqrt(LC)) = 16 MHz.
cell (0,0)
to a4
tutorial The Q of a quartz crystal, Your crystal against a reference, More ideas for one board
1 coil end
tutorial More ideas for one board
tutorial RC and LC circuits
0.40 MHz with 470 pF; combine positions for the steps between. VAR C takes an external tuning capacitor (a 365 pF air
tutorial RC and LC circuits, Control at the speed of the cable
A pi attenuator: 61.9 / 249 / 61.9 ohm is -20.0 dB and 50.0 ohm in a 50 ohm system (the tutorial's $10 SMA pad, on the board).
cell (3,0)
tutorial On the air, The modem against noise
tutorial An AM radio
M3 mounting holes, one per corner
p3 RC high-pass, 159 kHz
tutorial A quarter-wave stub, The channel, Chirps, Zadoff-Chu and LoRa, Control at the speed of the cable
variable with a big knob tunes the whole band alone, switches off); its frame to GND. Into a4's LNA and the AM radio gateware.
Turns a one-bit (delta-sigma) DAC stream into a tone; a slow plant for feedback control, with p2.
the parallel resonance f_p = f_s (1 + C_m / 2 C_0) a few kHz above. A capacitor across OUT (a tee at the ADC) pulls f_p
cell (1,0)
Before the ADC it removes the alias (the ghost image above Nyquist); after the DAC it smooths the steps.
1 k and 1 nF: f = 1 / (2 pi R C) = 159 kHz. Measure OUT with the ADC on its high-impedance setting: a 50 ohm
tutorial Trading speed for bits, RC and LC circuits
EXPECT: a sharp pass at the series resonance near 4.000 MHz (-3.7 dB) and a notch 6.0 kHz above it, the parallel resonance
cell (1,1)
Into a high-impedance load it is only -14 dB: the pad assumes 50 ohm on both sides.
tutorial Fast captures, Chirps, Zadoff-Chu and LoRa, RC and LC circuits
tutorial RC and LC circuits, Feedback control of an RC plant, Control at the speed of the cable
cell (3,1)
EXPECT: -3 dB at 159 kHz, +20 dB/decade below; OUT into high impedance
100ns
(each way from the L-C node to the OUT node through its capacitor)
tutorial RC and LC circuits, The Q of a quartz crystal
