gallicchio/AMOD-and-RFMOD/hardware/amod_p.kicad_pcb

## KiCad design hardware/amod_p.kicad_pcb (continued)

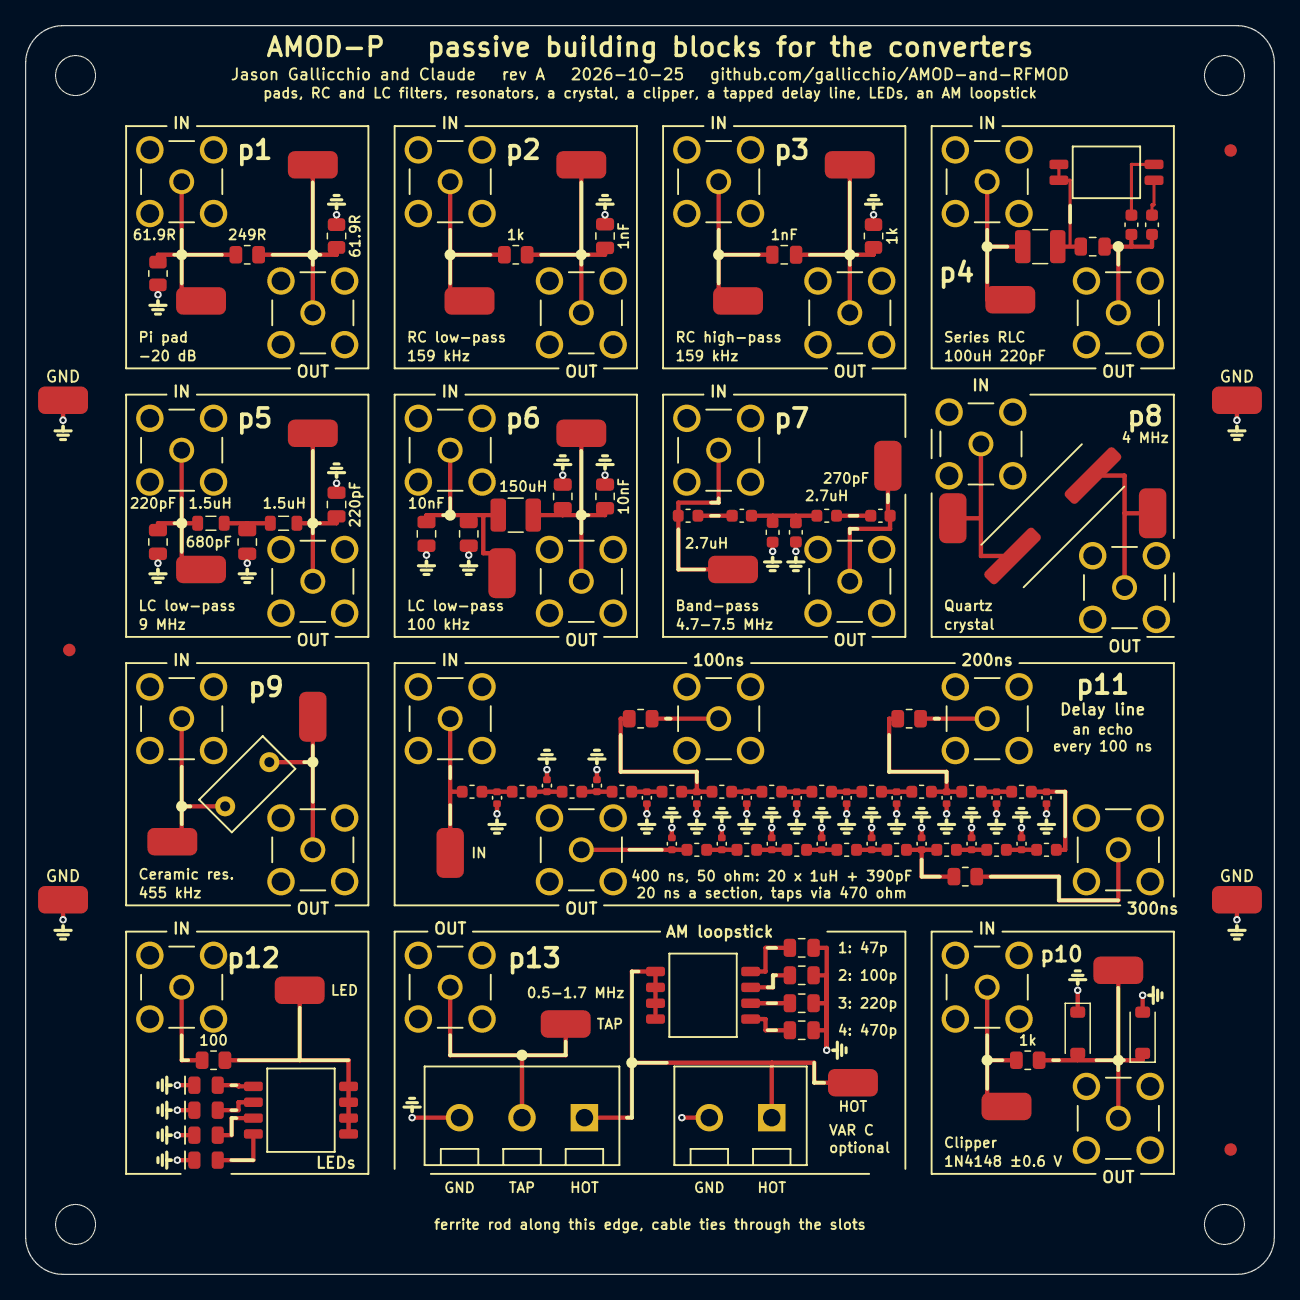
[picture p257: board amod_p.kicad_pcb from above]

Board: 2 copper layers, 100.0 x 100.0 mm, 151 parts (0 on the bottom side), 64 nets.
