gallicchio/AMOD-and-RFMOD/icepi_adapter/IcepiZero_AD9280_AD9708_2x12_Pmod.kicad_pcb

## KiCad design icepi_adapter/IcepiZero_AD9280_AD9708_2x12_Pmod.kicad_pcb (2026-10-25)

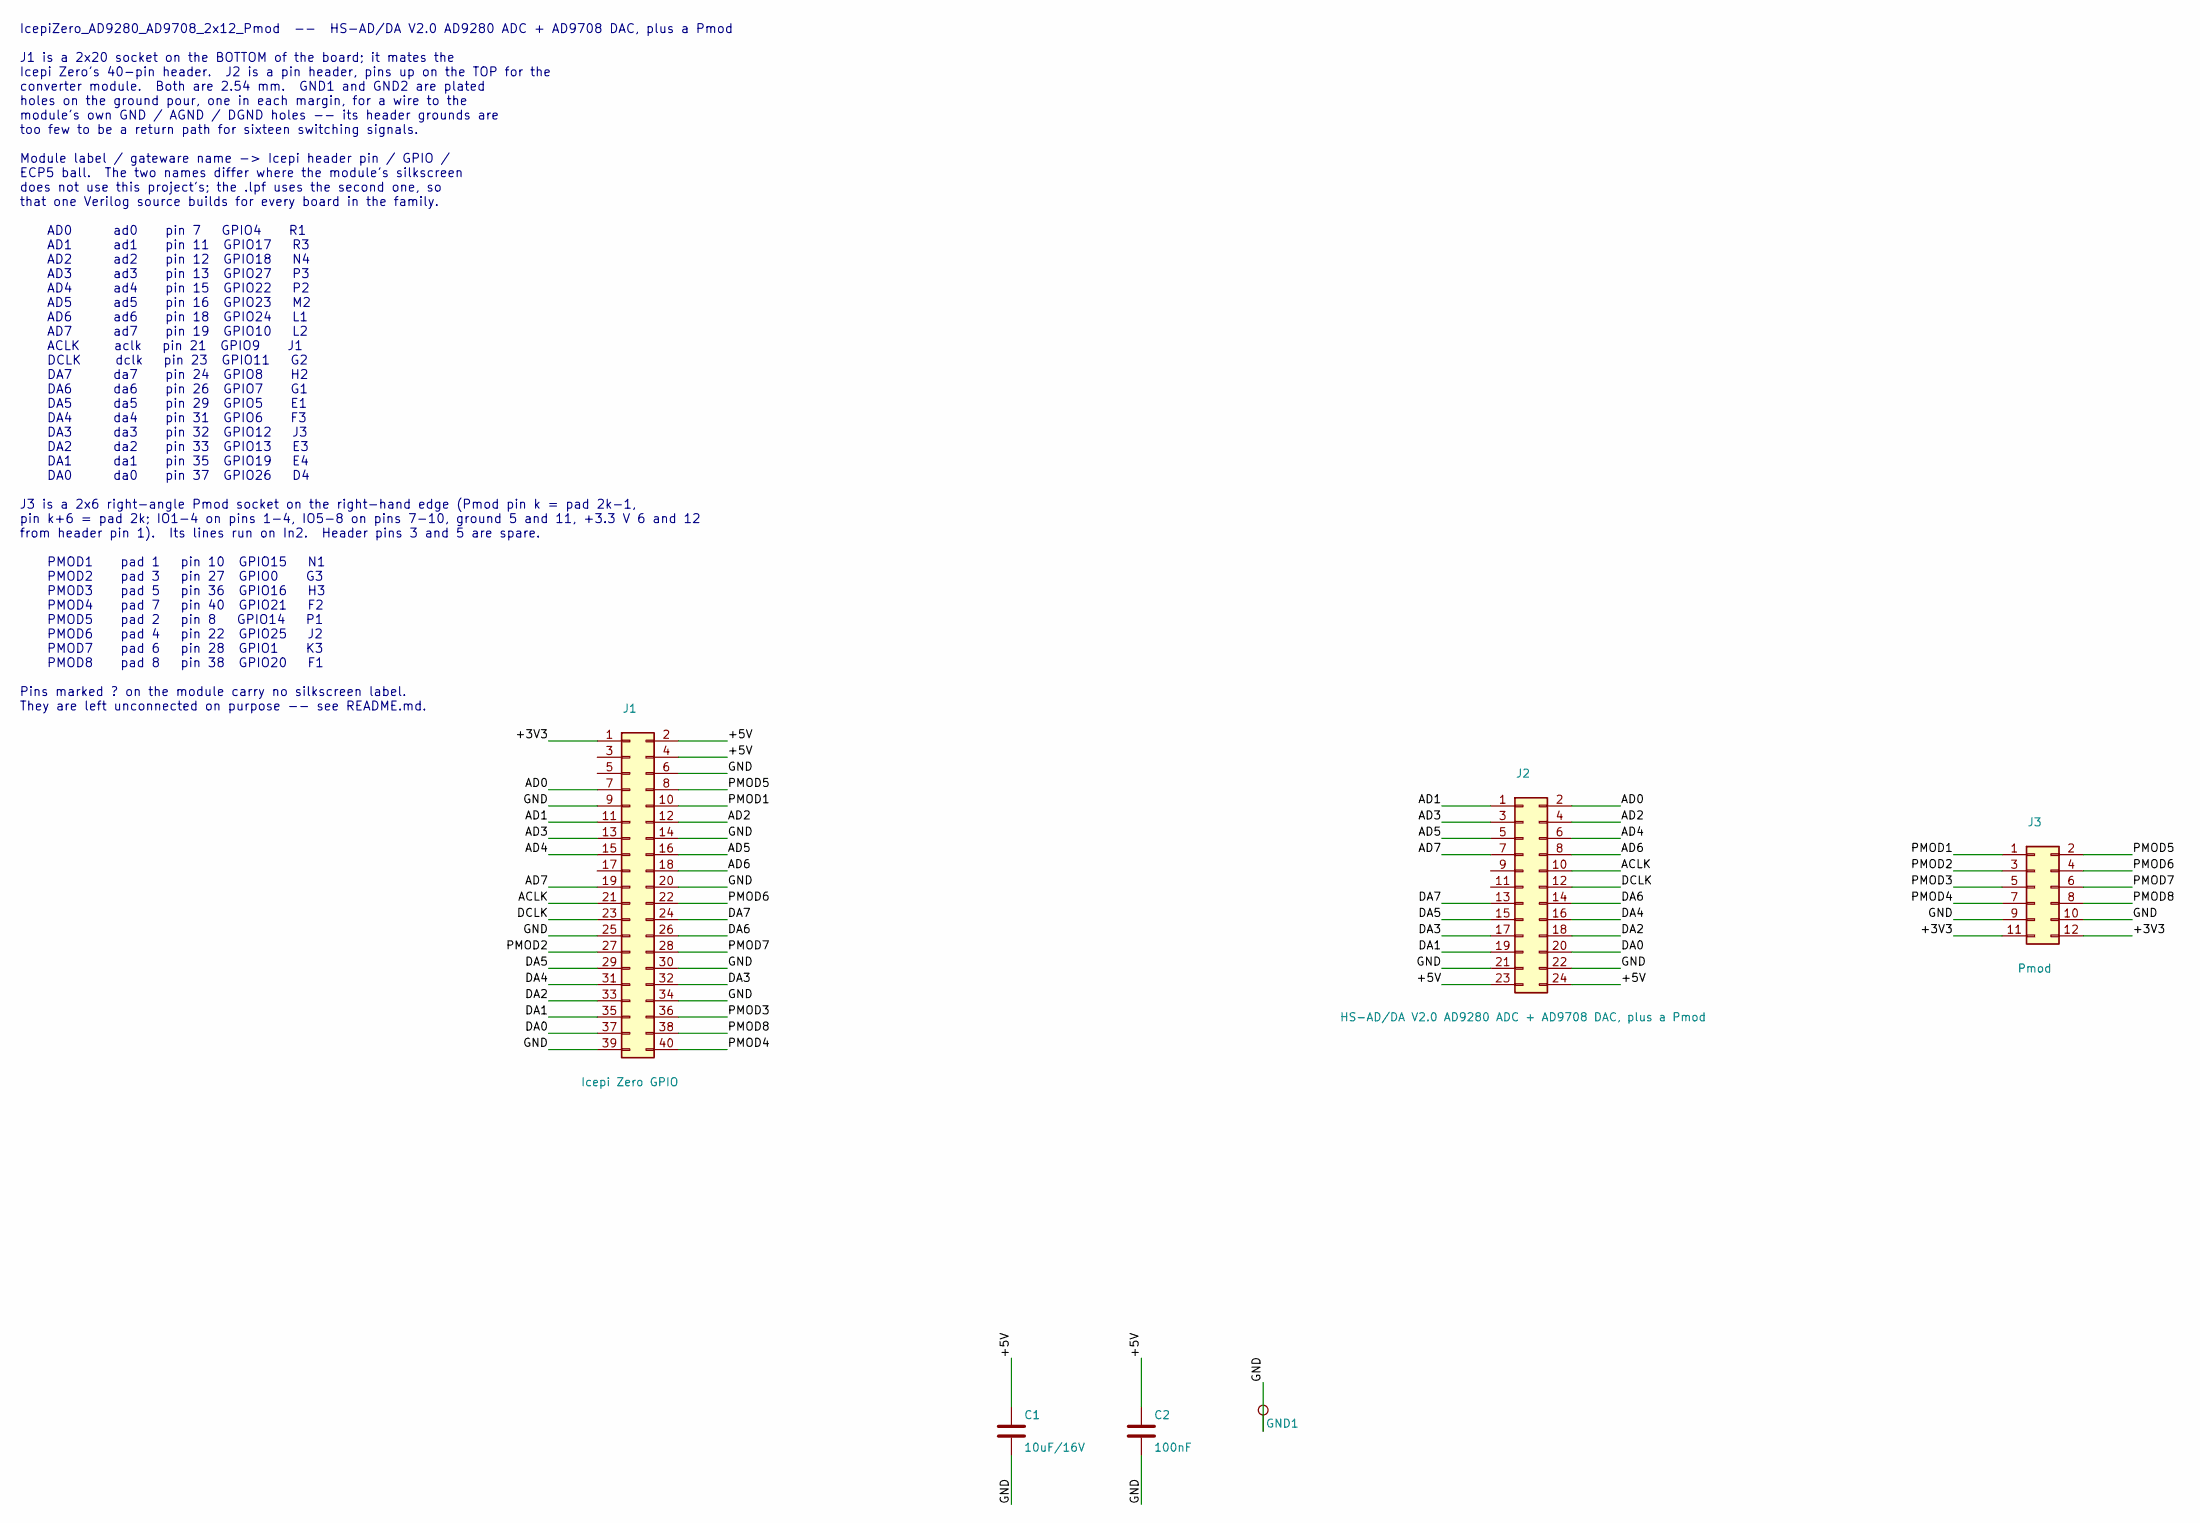
[picture p258: schematic IcepiZero_AD9280_AD9708_2x12_Pmod.kicad_sch]

Parts:
C1: 10uF/16V; C_0805_2012Metric
C2: 100nF; C_0603_1608Metric
GND1: GND; TestPoint_THTPad_1.5x1.5mm_Drill0.7mm
J1: Icepi Zero GPIO; PinSocket_2x20_P2.54mm_Vertical
J2: HS-AD/DA V2.0 AD9280 ADC + AD9708 DAC, plus a Pmod; PinHeader_2x12_P2.54mm_Vertical
J3: Pmod; PinSocket_2x06_P2.54mm_Horizontal

Connections:
+3V3: J1.1, J3.11, J3.12
+5V: C1.1, C2.1, J1.2, J1.4, J2.23, J2.24
ACLK: J1.21, J2.10
AD0: J1.7, J2.2
AD1: J1.11, J2.1
AD2: J1.12, J2.4
AD3: J1.13, J2.3
AD4: J1.15, J2.6
AD5: J1.16, J2.5
AD6: J1.18, J2.8
AD7: J1.19, J2.7
DA0: J1.37, J2.20
DA1: J1.35, J2.19
DA2: J1.33, J2.18
DA3: J1.32, J2.17
DA4: J1.31, J2.16
DA5: J1.29, J2.15
DA6: J1.26, J2.14
DA7: J1.24, J2.13
DCLK: J1.23, J2.12
GND: C1.2, C2.2, GND1.1, J1.6, J1.9, J1.14, J1.20, J1.25, J1.30, J1.34, J1.39, J2.21, J2.22, J3.9, J3.10
PMOD1: J1.10, J3.1
PMOD2: J1.27, J3.3
PMOD3: J1.36, J3.5
PMOD4: J1.40, J3.7
PMOD5: J1.8, J3.2
PMOD6: J1.22, J3.4
PMOD7: J1.28, J3.6
PMOD8: J1.38, J3.8

Notes on the sheet:
IcepiZero_AD9280_AD9708_2x12_Pmod -- HS-AD/DA V2.0 AD9280 ADC + AD9708 DAC, plus a Pmod J1 is a 2x20 socket on the BOTTOM of the board; it mates the Icepi Zero's 40-pin header. J2 is a pin header, pins up on the TOP for the converter module. Both are 2.54 mm. GND1 and GND2 are plated holes on the g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

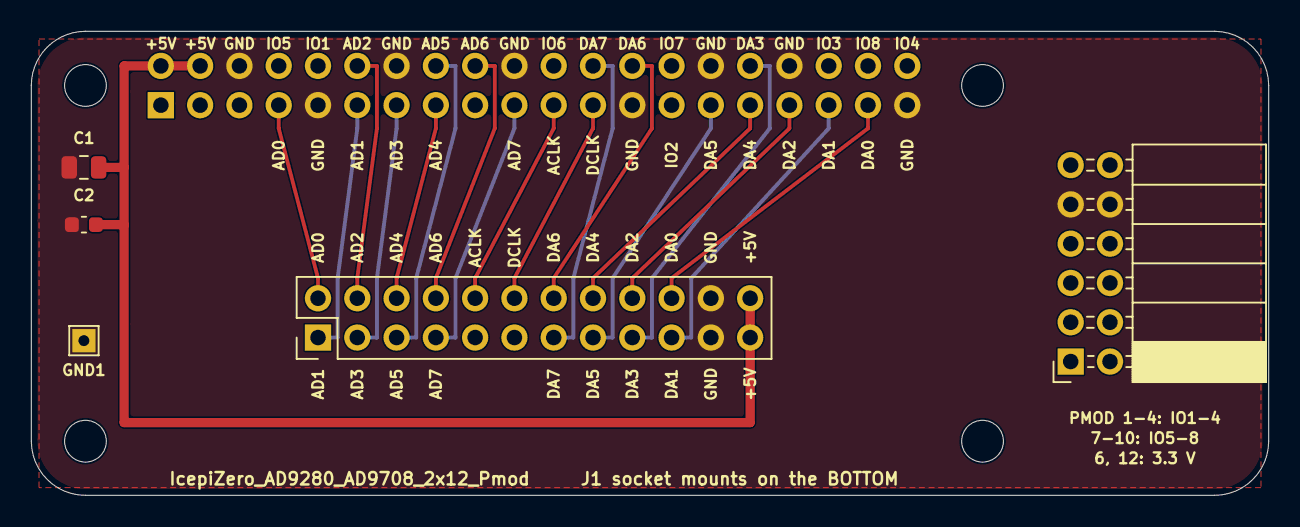
[picture p259: board IcepiZero_AD9280_AD9708_2x12_Pmod.kicad_pcb from above]

Board: 4 copper layers, 80.0 x 30.0 mm, 10 parts (1 on the bottom side), 29 nets.

Other parts of the board:
H1, H2, H3, H4: M2.5; MountingHole_2.7mm_M2.5_ISO7380
