gallicchio/AMOD-and-RFMOD/boards/amod_c.py

"""AMOD-C: conversion, rev A (Prompt 19).  Sixteen cells, four layers, USB-C power on c1 as AMOD-A's a1.  Power
conversion (a buck and an LDO under an electronic load, a charge pump the FPGA clocks) and data conversion (a
second-order delta-sigma with its integrators on jacks, a track-and-hold, a comparator that makes the host's DAC a SAR
or tracking ADC), the switched capacitors both use (a filter chip and a capacitor-and-two-switches resistor), and the
component-level stages Analog Devices' university labs teach (a differential pair on a current mirror, common emitter
against cascode, a precision rectifier, a 555).  `docs/ADI_LABS_SURVEY.md` has the survey; PLAN.md sections 12 and 13
the decisions.

Jason, Prompt 18: "Whole areas that we are missing include power regulation and other component-level circuits, but
something like a switched capacitor filter or details of their Delta - Sigma Modulator, if there is room, might be
worth it."

L1 the parts and the drawn wires, L2 ground, L3 the rails (+5 V under the board; -5 V in the gutter under row 0, down
the left margin and along the bottom margin; +3.3 V in the gutters under rows 1 and 2, joined down the right margin),
L4 ground with the Pmod lines and the back-side text.  Every powered tile has the standard header
(tiles.power_header): a slide switch and a P-FET, so its rail is dead until the slider is up.
"""
import os, sys
HERE = os.path.dirname(os.path.abspath(__file__))
sys.path.insert(0, os.path.join(HERE, "..", "scripts"))
sys.path.insert(0, HERE)
import tiles as T
from tiles import Tile, power_header, HDR_VS
import geometry as G
from amod_a import power_tile

STEM = "amod_c"
LAYERS = 4


# ------------------------------------------------------------------------------------------------------------ c1 --
def tile_c1():
    return power_tile("c1", sections=["Regulators", "Switched capacitors"])


def vs_up(t, x=10.6, y=9.0, dx=0.0):
    """VS from the header's FET: on the front to a via at (x, 18.5), up the back to a via at (x, y); returns (x, y)."""
    t.wire("VS", [HDR_VS, (8.54, 18.5), (x, 18.5)])
    t.wire("VS", [(x, 18.5), (x, y)], layer="B.Cu", silk=False)
    return (x, y)


def rail(t, net, pt, gutter):
    """A rail from a point in the tile to its strip: a via at the point, the back to a via in the gutter at the same x
    (gutter: "below" 20.5, "above" -0.75, "margin" 21.0, the bottom margin under row 3)."""
    y = {"below": 20.5, "above": -0.75, "margin": 21.0}[gutter]
    t.wire(net, [pt, (pt[0], y)], layer="B.Cu", silk=False)
    t.via(net, pt[0], y)


# ------------------------------------------------------------------------------------------------------------ c4 --
def tile_c4():
    """A switched-capacitor filter: the MAX7410 (5th-order Butterworth, fc = fCLK / 100, 5 V) clocked from Pmod IO3
    through an SN74LV1T34 (the clock pin wants 4.5 V); IN terminated in 49.9 ohm and AC-coupled into the chip's input,
    biased at COM (2.5 V) by 100 k; OS on COM; OUT AC-coupled through 1 uF and 49.9 ohm to the OUT jack.  The chip at
    rot 0 (COM, IN, GND, VDD down its left at 12.8; CLK, SHDN, OS, OUT down its right at 17.2), the buffer above its
    right side, VS up the back along the tile's right edge to SHDN and the buffer."""
    t = Tile("c4", "SC filter", [(0, 0)], supply="+5 V", subtitle="MAX7410", sections=["Switched capacitors"])
    t.jack("TL", "IN", "IN", "in", "±1 V", silk="IN 50R")
    t.jack("BR", "OUT", "OUT", "out", "")
    power_header(t)
    W = 0.25
    u = t.add("U", "MAX7410", "MAX7410", 15.0, 5.6, 0, {"1": "COM", "2": "INC", "3": "GND", "4": "VS", "5": "OUTF", "6": "COM", "7": "VS", "8": "CLK"},
              hide_value=False, label=None)
    b = t.add("U", "LV1T34", "LV1T34", 17.6, 2.7, 0, {"2": "/PMOD3", "3": "GND", "4": "CLK", "5": "VS"}, hide_value=True, label=None)
    rt = t.add("R", "R0402 49.9R", "49.9", 9.2, 5.8, 90, {"1": "GND", "2": "IN"}, label=None)              # pad 2 up, on the line
    ci = t.add("C", "C0402 1uF", "1u", 10.6, 5.275, 0, {"1": "IN", "2": "INC"}, label=None)
    rb = t.add("R", "R0402 100k", "100k", 10.85, 3.6, 0, {"1": "COM", "2": "INC"}, label=None)
    cc = t.add("C", "C0402 100nF", "100n", 13.4, 2.9, 0, {"1": "COM", "2": "GND"}, label=None)
    cv = t.add("C", "C0402 100nF", "100n", 13.4, 7.85, 0, {"1": "VS", "2": "GND"}, label=None)
    co = t.add("C", "C0402 1uF", "1u", 18.5, 8.3, 90, {"1": "OUTC", "2": "OUTF"}, label=None)              # pad 2 up
    rp = t.add("R", "R0402 100k", "100k", 17.0, 8.4, 0, {"1": "GND", "2": "OUTC"}, label=None)
    ro = t.add("R", "R0402 49.9R", "49.9", 17.0, 9.6, 0, {"1": "OUT", "2": "OUTC"}, label=None)
    t.wire("IN", [("J%d01" % t.idx, "1"), (8.0, 4.75), (8.6, 5.275), (ci, "1")])
    t.wire("INC", [(ci, "2"), (u, "2")], width=W)
    t.wire("INC", [(rb, "2"), (11.48, 5.275)], width=W)
    t.wire("COM", [(rb, "1"), (10.52, 2.9), (12.4, 2.9), (12.4, 4.625)], width=W)
    t.wire("COM", [(12.4, 2.9), (cc, "1")], width=W)
    t.wire("GND", [(u, "3"), (11.3, 6.1)], width=W)
    t.via("GND", 11.3, 6.1)
    t.wire("VS", [(u, "4"), (12.3, 6.575), (12.3, 7.85), (cv, "1")], width=W)
    t.wire("CLK", [(b, "4"), (18.55, 4.0), (17.925, 4.625)], width=W)
    t.wire("VS", [(b, "5"), (19.4, 2.05), (19.4, 5.275), (u, "7")], width=W)
    t.wire("VS", [(19.4, 5.275), (19.4, 6.0)], width=W)
    t.wire("OUTF", [(u, "5"), (18.5, 6.575), (co, "2")], width=W)
    t.wire("OUTC", [(co, "1"), (18.5, 9.6), (ro, "2")], width=W)
    t.wire("OUTC", [(rp, "2"), (17.9, 8.4), (18.5, 9.0)], width=W)
    t.wire("OUT", [(ro, "1"), (15.25, 9.6), ("J%d02" % t.idx, "1")])
    t.gnd_stub(rt, "1", (9.2, 7.2), sym=(0, 0))
    t.gnd_stub(cc, "2", (14.7, 2.9), sym=(0, 0))
    t.gnd_stub(cv, "2", (14.7, 7.85), sym=(0, 0))
    t.gnd_stub(rp, "1", (15.9, 8.4), sym=(0, 0))
    t.gnd_stub(b, "3", (15.7, 3.6), sym=(0, 0))
    t.via("/PMOD3", 15.6, 2.3)
    t.wire("/PMOD3", [(15.6, 2.3), (16.0, 2.7), (b, "2")], width=W)
    # VS: up the back from the header to the chip's VDD capacitor, and on along the bottom and up the right edge to SHDN
    t.wire("VS", [HDR_VS, (8.54, 18.5), (10.4, 18.5)])
    t.wire("VS", [(10.4, 18.5), (10.4, 8.6)], layer="B.Cu", silk=False)
    t.wire("VS", [(10.4, 8.6), (12.3, 8.6), (12.3, 7.85)])
    t.wire("VS", [(10.4, 18.5), (10.4, 19.3), (19.4, 19.3), (19.4, 6.0)], layer="B.Cu", silk=False)
    # OS to COM: off the chip's right side, under it on the back, up to a via beside COM's capacitor
    t.wire("COM", [(u, "6"), (18.5, 5.925)], width=W)
    t.wire("COM", [(18.5, 5.925), (14.4, 5.925), (13.2, 4.7), (13.2, 3.7)], layer="B.Cu", silk=False, width=W)
    t.wire("COM", [(13.2, 3.7), (12.4, 3.7)], width=W)
    t.text(6.0, 10.6, "c4", 1.5, 0.3, "center")
    t.titles.append("SC filter")
    t.result = "a 5th-order Butterworth low-pass at fCLK / 100 (up to 15 kHz from a 1.5 MHz clock on IO3); the clock's images near fCLK"
    t.notes = ["MAX7410: a switched-capacitor ladder whose corner is the clock divided by 100, clocked from IO3 through an SN74LV1T34.",
               "IN and OUT sit at COM (2.5 V), so both are AC-coupled.  Sweep the clock and watch the corner follow; alias a tone."]
    t.sch_draw = lambda ctx, tt: ctx.netlist_block(tt)
    return t


# ------------------------------------------------------------------------------------------------------------ c5 --
def tile_c5():
    """A switched-capacitor resistor and integrator, two cells along the top: a TMUX4053 (three SPDTs on +-5 V, 3.3 V logic)
    switches 1 nF between IN and ground on one side (phi1, Pmod IO4) and between ground and the integrator's summing node on
    the other (phi2, IO8): the parasitic-insensitive integrator, whose resistor is 1 / (f C).  An OPA810 with 10 nF (C0G)
    and 1 M across it integrates; OUT through 49.9 ohm.  The FPGA makes the two phases, so it can make them overlap on
    purpose.  The third switch is grounded.  The chip turned 180 in the right cell's top-left quarter (SEL3, SEL2, SEL1, S1A,
    S1B, D1, D2, VDD down its left at 24.14; GND, VSS, EN, S3A, D3, S3B, S2A, S2B down its right at 29.86), its grounds
    joined under its body; IN along y 4.75 from the jack; the capacitor standing left of D1 and D2.  The integrator below
    (the OPA810 at rot 270: +IN, V-, OUT along its top, -IN and V+ along its bottom), the summing node coming down from S2B
    to a column on its left, the feedback pair lying under it, OUT over to the right and on to the jack between its top
    legs.  VS up the back from the header; -5 V on the back to the right edge and the gutter."""
    t = Tile("c5", "SC integrator", [(1, 0), (2, 0)], supply="+-5 V", subtitle="TMUX4053", sections=["Switched capacitors"])
    t.jack("TL0", "IN", "IN", "in", "±1 V", silk="IN 50R")
    t.jack("BR1", "OUT", "OUT", "out", "")
    power_header(t)
    t.fine = True
    W = 0.25
    u = t.add("U", "TMUX4053", "TMUX4053", 27.0, 5.0, 180, {"9": "GND", "10": "/PMOD8", "11": "/PMOD4", "12": "GND", "13": "IN", "14": "CT",
                                                            "15": "CB", "16": "VS", "8": "GND", "7": "-5V", "6": "GND", "5": "GND", "4": "GND",
                                                            "3": "GND", "2": "GND", "1": "VG"}, hide_value=False, label=None)
    rt = t.add("R", "R0402 49.9R", "49.9", 9.4, 5.3, 90, {"1": "GND", "2": "IN"}, label=None)              # pad 2 up, on the line
    cs = t.add("C", "C0603 1nF", "1n", 21.6, 6.75, 270, {"1": "CT", "2": "CB"}, label=None)               # pad 1 up, level with D1
    cdd = t.add("C", "C0402 100nF", "100n", 24.1375, 8.7, 270, {"1": "VS", "2": "GND"}, label=None)       # pad 1 up, under VDD
    css = t.add("C", "C0402 100nF", "100n", 31.7, 4.2, 270, {"1": "-5V", "2": "GND"}, label=None)         # pad 1 up
    t.wire("IN", [("J%d01" % t.idx, "1"), (22.6, 4.75), (23.15, 5.325), (u, "13")])
    t.wire("IN", [(9.4, 4.75), (rt, "2")])
    t.gnd_stub(rt, "1", (9.4, 6.8), sym=(0, 0))
    # the grounds: SEL3 and S1A to a bus under the chip's left row, GND, EN and the unused switches to one under its right
    t.wire("GND", [(u, "9"), (25.4, 2.725), (25.4, 4.675), (u, "12")], width=W, silk=False)
    t.gnd_stub(u, "9", [(25.4, 2.725), (25.4, 3.7)], sym=(0, 0), width=W)
    t.wire("GND", [(u, "8"), (28.6, 2.725), (28.6, 6.625), (u, "2")], width=W, silk=False)
    for pin, y in (("6", 4.025), ("5", 4.675), ("4", 5.325), ("3", 5.975)):
        t.wire("GND", [(u, pin), (28.6, y)], width=W, silk=False)
    t.gnd_stub(u, "8", [(28.6, 2.725), (28.6, 4.35)], sym=(0, 0), width=W)
    t.wire("-5V", [(u, "7"), (31.0, 3.375), (css, "1")], width=W)
    t.wire("-5V", [(css, "1"), (32.6, 3.375)], width=W)
    t.gnd_stub(css, "2", (31.7, 5.6), sym=(0, 0))
    t.via("/PMOD4", 22.1, 3.9)
    t.via("/PMOD8", 22.9, 2.75)
    t.wire("/PMOD4", [(u, "11"), (23.0, 4.025), (22.1, 3.9)], width=W)
    t.wire("/PMOD8", [(u, "10"), (23.3, 3.375), (22.9, 2.75)], width=W)
    t.wire("CT", [(u, "14"), (cs, "1")], width=W)
    t.wire("CB", [(u, "15"), (22.5, 6.625), (cs, "2")], width=W)
    t.wire("VS", [(u, "16"), (cdd, "1")], width=W)
    t.wire("VS", [(23.0, 8.22), (cdd, "1")], width=W)
    t.gnd_stub(cdd, "2", (25.2, 9.18), sym=(0, 0))
    # the integrator
    oa = t.add("U", "OPA810", "OPA810", 26.0, 13.3, 270, {"1": "OA", "2": "-5V", "3": "GND", "4": "VG", "5": "VS"}, hide_value=False, label=None)
    ci = t.add("C", "C0603 10nF", "10n", 26.4, 16.9, 0, {"1": "VG", "2": "OA"}, label=None)
    rl = t.add("R", "R0402 1M", "1M", 26.4, 18.1, 0, {"1": "VG", "2": "OA"}, label=None)
    ro = t.add("R", "R0603 49.9R", "49.9", 31.8, 10.6, 0, {"1": "OA", "2": "OUT"}, label=None)
    cvn = t.add("C", "C0402 100nF", "100n", 29.6, 13.0, 270, {"1": "-5V", "2": "GND"}, label=None)        # pad 1 up
    cvp = t.add("C", "C0402 100nF", "100n", 20.6, 15.75, 0, {"1": "GND", "2": "VS"}, label=None)
    t.wire("VG", [(u, "1"), (29.8625, 9.9), (23.6, 9.9), (23.6, 18.1), (rl, "1")], width=W)
    t.wire("VG", [(23.6, 14.4375), (oa, "4")], width=W)
    t.wire("VG", [(23.6, 16.9), (ci, "1")], width=W)
    t.wire("OA", [(oa, "1"), (28.2, 12.1625)], width=W)
    t.wire("OA", [(ro, "1"), (28.2, 10.6), (28.2, 18.1), (rl, "2")], width=W)
    t.wire("OA", [(28.2, 16.9), (ci, "2")], width=W)
    t.wire("OUT", [(ro, "2"), (36.75, 10.6), ("J%d02" % t.idx, "1")])
    t.gnd_stub(oa, "3", (24.9, 10.9), sym=(0, 0))
    t.via("-5V", 26.0, 10.9)
    t.wire("-5V", [(oa, "2"), (26.0, 10.9)], width=W)
    t.via("-5V", 29.6, 11.6)
    t.wire("-5V", [(29.6, 11.6), (cvn, "1")], width=W)
    t.gnd_stub(cvn, "2", (29.6, 14.5), sym=(0, 0))
    t.wire("-5V", [(26.0, 10.9), (26.7, 11.6), (29.6, 11.6)], layer="B.Cu", silk=False)
    t.wire("-5V", [(29.6, 11.6), (30.3, 10.9), (40.9, 10.9), (40.9, 20.5)], layer="B.Cu", silk=False)
    t.wire("-5V", [(32.6, 3.375), (40.9, 3.375), (40.9, 20.5)], layer="B.Cu", silk=False)
    t.via("-5V", 40.9, 20.5)
    # VS: the FET's drain to a via, along the back under the cells' bottom and up to the switch's capacitor; a branch to a
    # via under V+, with its capacitor on the way
    t.wire("VS", [HDR_VS, (8.54, 18.5), (10.6, 18.5)])
    t.wire("VS", [(10.6, 18.5), (22.4, 18.5), (22.4, 8.7), (23.0, 8.22)], layer="B.Cu", silk=False)
    t.wire("VS", [(22.4, 15.75), (26.95, 15.75)], layer="B.Cu", silk=False)
    t.wire("VS", [(oa, "5"), (26.95, 15.75)], width=W)
    t.wire("VS", [(cvp, "2"), (22.4, 15.75)], width=W)
    t.gnd_stub(cvp, "1", (19.2, 15.75), sym=(0, 0))
    t.text(6.0, 10.6, "c5", 1.5, 0.3, "center")
    t.titles.append("SC integrator")
    t.info(["R = 1 / f C", "IO4, IO8"], near=(36.0, 3.0), reach=6.0)
    t.result = "an integrator whose input resistor is 1 / (f x 1 nF): 1 M at 1 kHz, 1 k at 1 MHz; OUT = -(1 / R C) x the integral of IN"
    t.notes = ["phi1 (IO4) connects the 1 nF's top plate to IN, phi2 (IO8) its bottom plate to the summing node: C x Vin per cycle at f,",
               "a resistor of 1 / (f C).  Make the phases non-overlapping, or overlap them and watch IN leak through.  1 M sets the DC gain."]
    t.sch_draw = lambda ctx, tt: ctx.netlist_block(tt)
    return t


# ------------------------------------------------------------------------------------------------------------ c6 --
def tile_c6():
    """A second-order delta-sigma modulator with its insides on jacks, two cells.  Both OPA2810 integrators sit on a 1.65 V
    virtual ground (VMID: the board's +3.3 V halved by two 0.1 % 10 k), so each one-bit DAC is just an SN74LVC1G3157
    switching 10 k between +3.3 V and ground: +-165 uA about VMID, ratiometric with VMID, with no negative reference; 10 k
    from +3.3 V into the first node cancels IN's own offset from VMID.  IN through 10 k into 220 pF, the first output
    through 6.8 k into 680 pF; a TLV3501 compares the second output (through 10 k, which limits the current into its
    input clamps when an integrator rails) with VMID; a 74LVC1G79 registers it on the FPGA's clock
    (Pmod IO1) and hands the bit to IO7 and to both switches (the first wired the other way round, so both loops are
    negative).  INT1 and INT2 on their jacks through 3.3 k / 1 k (read at high impedance: about a quarter, offset by 0.38
    V).  Full scale +-1.65 V; clock 1 MHz.  The OPA2810 (SOIC-8 at rot 0: OUT A, -IN A, +IN A, V- down its left at 24.5;
    V+, OUT B, -IN B, +IN B down its right at 29.5) in the right cell's top-left quarter: the first integrator's parts on
    a column left of it, the second's right of it; OUT A crosses under the body and out of its bottom to the 6.8 k and
    INT1's divider; +IN A and +IN B on vias under the body joined on the back, V+ on a via under the body.  The
    comparator and the register over the right cell's top-right, the second switch under the second integrator, the
    first switch beside its 10 k; VMID's divider in the right cell's bottom-left quarter.  VS comes along the bottom edge
    and up the back; the bit and IO1 leave on the back for the Pmod plug."""
    t = Tile("c6", "delta-sigma", [(1, 1), (2, 1)], supply="+-5 V", subtitle="second order", sections=["Trading speed for bits"])
    t.jack("TL0", "IN", "IN", "in", "±1 V", silk="IN 10K")
    t.jack("BR0", "INT1", "I1J", "out", "", silk="INT1 /4")
    t.jack("BR1", "INT2", "I2J", "out", "", silk="INT2 /4")
    power_header(t)
    t.pwr_flags.append("VM")
    W = 0.25
    WF = 0.2
    # ---- the integrators
    u = t.add("U", "OPA2810", "OPA2810", 27.0, 5.0, 0, {"1": "I1", "2": "S1", "3": "VM", "4": "-5V", "5": "VM", "6": "S2", "7": "I2", "8": "VS"},
              hide_value=False, label=None)
    c1 = t.add("C", "C0402 220pF", "220p", 22.6, 3.73, 90, {"1": "S1", "2": "I1"}, label=None)              # pad 2 up
    rin = t.add("R", "R0402 10k", "10k", 21.8, 5.6, 0, {"1": "IN", "2": "S1"}, label=None)
    rd1 = t.add("R", "RP0603 10k", "10k", 21.8, 7.3, 0, {"1": "D1", "2": "S1"}, label=None)
    roff = t.add("R", "RP0603 10k", "10k", 21.8, 9.0, 0, {"1": "+3V3", "2": "S1"}, label=None)
    cu1n = t.add("C", "C0402 100nF", "100n", 21.3, 2.35, 0, {"1": "GND", "2": "-5V"}, label=None)
    # 680 pF, not the 330 pF the loop's arithmetic first gave: the comparator sees only the sign of OUT B, so scaling the
    # second integrator changes no bit, and half the swing keeps OUT B inside the TLV3501's 3.3 V input range up to an
    # input of 1.5 V (simulated: +-0.73 V about VMID at 1 V in, +-1.2 V at 1.5 V)
    c2 = t.add("C", "C0402 680pF", "680p", 31.4, 5.0, 90, {"1": "S2", "2": "I2"}, label=None)               # pad 2 up
    r12 = t.add("R", "R0402 6.8k", "6.8k", 31.4, 7.0, 90, {"1": "I1", "2": "S2"}, label=None)               # pad 2 up
    rd2 = t.add("R", "R0402 10k", "10k", 32.9, 6.0, 0, {"1": "S2", "2": "D2"}, label=None)
    cu1p = t.add("C", "C0402 100nF", "100n", 32.2, 3.1, 0, {"1": "VS", "2": "GND"}, label=None)
    ro1 = t.add("R", "R0402 3.3k", "3.3k", 27.0, 10.6, 90, {"1": "I1J", "2": "I1"}, label=None)             # pad 2 up
    rg1 = t.add("R", "R0402 1k", "1k", 19.6, 16.6, 90, {"1": "GND", "2": "I1J"}, label=None)                # pad 2 up
    # IN: from its jack along y 4.0 to the 10 k
    t.wire("IN", [("J%d01" % t.idx, "1"), (8.8, 4.75), (9.4, 4.0), (20.6, 4.0), (rin, "1")])
    # the first integrator: its capacitor between OUT A and -IN A, a column down from -IN A to the three 10 k
    t.wire("I1", [(u, "1"), (c1, "2")], width=WF)
    t.wire("S1", [(u, "2"), (23.0, 4.365), (23.0, 9.0), (roff, "2")], width=WF)
    t.wire("S1", [(23.0, 4.365), (c1, "1")], width=WF)
    t.wire("S1", [(23.0, 5.6), (rin, "2")], width=WF)
    t.wire("S1", [(23.0, 7.3), (rd1, "2")], width=WF)
    # OUT A under the body and out of its bottom: to the 6.8 k and down to INT1's 3.3 k
    t.wire("I1", [(u, "1"), (27.0, 3.6), (27.0, 8.4), (31.4, 8.4), (r12, "1")], width=WF)
    t.wire("I1", [(27.0, 8.4), (ro1, "2")], width=WF)
    t.wire("I1J", [(ro1, "1"), (27.0, 12.2), (19.6, 12.2), (19.6, 15.25), ("J%d02" % t.idx, "1")])
    t.wire("I1J", [(19.6, 15.25), (rg1, "2")])
    t.gnd_stub(rg1, "1", (20.9, 17.2), sym=(0, 0))
    # +IN A and +IN B on vias under the body, joined on the back; V- to a via under the body, on the back to the -5 V strip
    t.via("VM", 26.1, 5.635)
    t.via("VM", 27.9, 6.905)
    t.wire("VM", [(u, "3"), (26.1, 5.635)], width=WF, silk=False)
    t.wire("VM", [(u, "5"), (27.9, 6.905)], width=WF, silk=False)
    t.wire("VM", [(26.1, 5.635), (27.9, 6.905)], layer="B.Cu", silk=False, width=WF)
    t.via("-5V", 26.1, 7.3)
    t.wire("-5V", [(u, "4"), (26.1, 7.3)], width=WF, silk=False)
    t.wire("-5V", [(26.1, 7.3), (22.8, 7.3), (22.8, -0.75)], layer="B.Cu", silk=False)
    t.via("-5V", 22.8, -0.75)
    t.via("-5V", 22.8, 2.4)
    t.wire("-5V", [(22.8, 2.4), (cu1n, "2")], width=W)
    t.gnd_stub(cu1n, "1", (19.9, 2.35), sym=(0, 0))
    # the second integrator: its capacitor between OUT B and -IN B, the 6.8 k and DAC2's 10 k on -IN B
    t.wire("S2", [(u, "6"), (c2, "1")], width=WF)
    t.wire("S2", [(c2, "1"), (r12, "2")], width=WF)
    t.wire("S2", [(31.4, 6.0), (rd2, "1")], width=WF)
    t.wire("I2", [(u, "7"), (c2, "2")], width=WF)
    t.wire("VS", [(u, "8"), (cu1p, "1")], width=W)
    t.gnd_stub(cu1p, "2", (33.6, 3.1), sym=(0, 0))
    # ---- the decision: TLV3501 (SOT-23-6 at rot 0: -IN, V-, +IN down its left; SHDN, OUT, V+ up its right) right of the
    # second integrator, OUT under its body to the register below; V- and SHDN joined under the body
    cmp_ = t.add("U", "TLV3501", "TLV3501", 36.4, 4.2, 0, {"1": "VM", "2": "GND", "3": "I2C", "4": "+3V3", "5": "DEC", "6": "GND"}, hide_value=False, label=None)
    ccmp = t.add("C", "C0402 100nF", "100n", 39.75, 5.5, 90, {"1": "GND", "2": "+3V3"}, label=None)       # pad 2 up
    # OUT B reaches +IN through 10 k lying between the capacitor and the comparator: past full scale (or with the tile
    # switched off) the integrators sit near a rail, and 10 k holds the current into the comparator's input clamps under
    # 0.5 mA.  INT2's divider takes OUT B from ahead of it (a via above the I2 track, below)
    rcmp = t.add("R", "R0402 10k", "10k", 32.82, 4.52, 0, {"1": "I2", "2": "I2C"}, label=None)
    t.wire("I2", [(c2, "2"), (rcmp, "1")], width=WF)
    t.wire("I2C", [(rcmp, "2"), (33.9, 4.52), (34.6, 5.15), (cmp_, "3")], width=WF)
    t.via("VM", 34.5, 2.3)
    t.wire("VM", [(34.5, 2.3), (cmp_, "1")], width=WF)
    t.wire("GND", [(cmp_, "2"), (35.925, 4.2), (36.875, 3.25), (cmp_, "6")], width=WF, silk=False)
    t.gnd_stub(cmp_, "6", (38.9, 3.25), sym=(0, 0))
    t.wire("+3V3", [(cmp_, "4"), (ccmp, "2")], width=W)
    t.gnd_stub(ccmp, "1", (38.9, 5.9), sym=(0, 0))
    t.via("+3V3", 40.9, 5.0)
    t.wire("+3V3", [(40.9, 5.0), (ccmp, "2")], width=W)
    rail(t, "+3V3", (40.9, 5.0), "below")
    # the register (SOT-23-5 at rot 0: D, CLK, GND down its left; VCC, Q up its right) below the comparator
    ff = t.add("U", "LVC1G79", "74LVC1G79", 37.1, 8.0, 0, {"1": "DEC", "2": "/PMOD1", "3": "GND", "4": "/PMOD7", "5": "+3V3"}, hide_value=False, label=None)
    cff = t.add("C", "C0402 100nF", "100n", 39.75, 8.6, 90, {"1": "GND", "2": "+3V3"}, label=None)        # pad 2 up
    t.wire("DEC", [(cmp_, "5"), (36.875, 4.2), (36.4, 4.9), (36.4, 6.5), (ff, "1")], width=WF, silk=False)
    t.gnd_stub(ff, "3", (34.9, 9.9), sym=(0, 0))
    t.wire("+3V3", [(ff, "5"), (39.75, 7.05), (cff, "2")], width=W)
    t.wire("+3V3", [(39.75, 7.05), (40.9, 7.05), (40.9, 5.0)], width=W)
    t.gnd_stub(cff, "1", (39.75, 10.0), sym=(0, 0))
    # the second switch (SOT-23-6 at rot 0: B2, GND, B1 down its left; S, VCC, A up its right) under the second
    # integrator: A under its body and up to DAC2's 10 k
    sw2 = t.add("U", "LVC1G3157", "74LVC1G3157", 32.0, 10.0, 0, {"1": "+3V3", "2": "GND", "3": "GND", "4": "D2", "5": "+3V3", "6": "/PMOD7"},
                hide_value=True, label=None)
    t.wire("D2", [(sw2, "4"), (32.15, 10.95), (32.15, 6.9), (33.41, 6.9), (rd2, "2")], width=WF, silk=False)
    t.via("+3V3", 34.4, 10.6)
    t.wire("+3V3", [(sw2, "5"), (34.4, 10.6)], width=WF)
    t.wire("+3V3", [(34.4, 10.6), (34.9, 11.1), (40.9, 11.1), (40.9, 20.5)], layer="B.Cu", silk=False, width=W)
    t.via("+3V3", 29.6, 9.05)
    t.wire("+3V3", [(29.6, 9.05), (sw2, "1")], width=WF)
    rail(t, "+3V3", (29.6, 9.05), "below")
    t.wire("GND", [(sw2, "2"), (sw2, "3")], width=WF)
    t.gnd_stub(sw2, "3", (30.5, 12.0), sym=(0, 0))
    # the first switch (rot 90: B2, GND, B1 along its bottom; S, VCC, A along its top) beside DAC1's 10 k; B1 straight to
    # the offset resistor's +3.3 V end, A to DAC1's 10 k
    sw1 = t.add("U", "LVC1G3157", "74LVC1G3157", 18.3, 7.6, 90, {"1": "GND", "2": "GND", "3": "+3V3", "4": "D1", "5": "+3V3", "6": "/PMOD7"},
                hide_value=True, label=None)
    csw1 = t.add("C", "C0402 100nF", "100n", 19.5, 5.0, 0, {"1": "+3V3", "2": "GND"}, label=None)
    t.wire("D1", [(sw1, "4"), (19.6, 6.6), (rd1, "1")], width=WF)
    t.wire("+3V3", [(sw1, "3"), (roff, "1")], width=WF)
    t.via("+3V3", 18.0, 5.0)
    t.wire("+3V3", [(sw1, "5"), (18.3, 5.6), (18.0, 5.0), (csw1, "1")], width=WF)
    t.gnd_stub(csw1, "2", (20.4, 6.0), sym=(0, 0))
    t.wire("GND", [(sw1, "1"), (sw1, "2")], width=WF)
    t.gnd_stub(sw1, "2", (18.3, 10.0), sym=(0, 0))
    t.via("+3V3", 20.2, 9.9)
    t.wire("+3V3", [(roff, "1"), (20.2, 9.9)], width=WF)
    t.wire("+3V3", [(18.0, 5.0), (19.5, 6.5), (19.5, 9.2), (20.2, 9.9), (20.2, 20.5)], layer="B.Cu", silk=False)
    t.via("+3V3", 20.2, 20.5)
    # VMID in the right cell's bottom-left quarter: 10 k / 10 k (0.1 %) from +3.3 V with 1 uF; +IN B's via comes down the back
    rv1 = t.add("R", "RP0603 10k", "10k", 24.4, 18.2, 0, {"1": "+3V3", "2": "VM"}, label=None)
    rv2 = t.add("R", "RP0603 10k", "10k", 27.6, 18.2, 0, {"1": "VM", "2": "GND"}, label=None)
    cvm = t.add("C", "C0603 1uF", "1u", 28.1, 16.4, 0, {"1": "VM", "2": "GND"}, label=None)
    t.wire("VM", [(rv1, "2"), (rv2, "1")], width=W)
    t.wire("VM", [(26.0, 18.2), (26.6, 17.4), (cvm, "1")], width=W)
    t.via("+3V3", 22.5, 17.4)
    t.wire("+3V3", [(22.5, 17.4), (rv1, "1")], width=W)
    t.wire("+3V3", [(22.5, 17.4), (22.5, 20.5)], layer="B.Cu", silk=False)
    t.via("+3V3", 22.5, 20.5)
    t.gnd_stub(rv2, "2", (30.3, 18.2), sym=(0, 0))
    t.gnd_stub(cvm, "2", (30.3, 16.4), sym=(0, 0))
    t.via("VM", 27.4, 15.4)
    t.wire("VM", [(27.9, 6.905), (27.4, 7.6), (27.4, 15.4)], layer="B.Cu", silk=False, width=WF)
    t.wire("VM", [(27.4, 15.4), (cvm, "1")], width=WF)
    # INT2: 3.3 k / 1 k into its jack between the left legs
    ro2 = t.add("R", "R0402 3.3k", "3.3k", 31.6, 15.25, 0, {"1": "I2", "2": "I2J"}, label=None)
    rg2 = t.add("R", "R0402 1k", "1k", 32.6, 16.8, 90, {"1": "GND", "2": "I2J"}, label=None)               # pad 2 up
    t.wire("I2J", [(ro2, "2"), ("J%d03" % t.idx, "1")])
    t.wire("I2J", [(32.6, 15.25), (rg2, "2")])
    t.gnd_stub(rg2, "1", (32.6, 18.4), sym=(0, 0))
    # VS: the FET's drain along the bottom edge to a via, up the back to a via under the chip's body by V+
    t.wire("VS", [HDR_VS, (8.54, 19.35), (28.6, 19.35)], silk=False)
    t.wire("VS", [(28.6, 19.35), (28.6, 4.1), (27.9, 3.6)], layer="B.Cu", silk=False)
    t.wire("VS", [(27.9, 3.6), (28.5, 3.095)], width=WF, silk=False)
    # VMID: +IN A's via over the top on the back to the comparator's -IN
    t.wire("VM", [(26.1, 5.635), (26.1, 1.4), (34.5, 1.4), (34.5, 2.3)], layer="B.Cu", silk=False, width=WF)
    # the bit and the clock: vias at the tile's top-right corner for the lines to the plug (BACK_WIRES), the router between
    # the register, the switches and them
    t.via("/PMOD7", 41.1, 1.9)
    t.via("/PMOD1", 41.1, 3.1)
    for net, a2, b2 in (("/PMOD7", (ff, "4"), (sw2, "6")), ("/PMOD7", (sw2, "6"), (sw1, "6")), ("/PMOD7", (ff, "4"), (41.1, 1.9)),
                        ("/PMOD1", (ff, "2"), (41.1, 3.1))):
        t.route(net, [a2, b2], width=W)
    # I2: a via above the track from OUT B to the capacitor, down the back left of the INT2 jack's legs to its 3.3 k
    t.via("I2", 30.9, 3.75)
    t.wire("I2", [(30.9, 3.75), (30.9, 4.47)], width=WF, silk=False)
    t.wire("I2", [(30.9, 3.75), (30.9, 6.5), (32.7, 8.3), (32.7, 13.6), (31.09, 14.3)], layer="B.Cu", silk=False, width=WF)
    t.wire("I2", [(31.09, 14.3), (ro2, "1")], width=WF)
    t.text(6.0, 10.6, "c6", 1.5, 0.3, "center")
    t.titles.append("Delta-sigma")
    t.result = "a one-bit stream on IO7 whose density follows IN (+-1.65 V full scale), its noise shaped at 40 dB per decade"
    t.notes = ["Clock IO1 at about 1 MHz and count IO7's ones.  The second integrator pushes the quantization noise up at 40 dB per",
               "decade (AMOD-A's a6 is first order: 20 dB), so a sinc3 decimator gets more bits per clock.  INT1, INT2: high impedance."]
    t.sch_draw = lambda ctx, tt: ctx.netlist_block(tt)
    return t


# ------------------------------------------------------------------------------------------------------------ c2 --
def tile_c2():
    """A buck converter, an LDO after it and an electronic load, two cells.  Left: the TLV62568 (1.5 MHz, pulse-skipping at
    light load) from the switched 5 V with 2.2 uH, 10 uF in and out, its feedback 100 k / 20 k (3.6 V) and TRIM (a DAC)
    through 100 k into the feedback node, so the buck's output moves 2.2-5 V and the LDO can be pushed into dropout;
    BUCK~ is its output AC-coupled (1 uF, 49.9 ohm) for the ripple.  Right: the TPS7A2033 LDO (3.3 V) from the buck,
    LDO~ its output AC-coupled likewise; an OPA810 holds 10 ohm at LOAD's voltage through an AO3400A: 100 mA per volt from
    the LDO's output (LOAD terminated in 49.9 ohm), its loop closed slowly through 1 k and 1 nF so the FET's gate cannot
    make it ring.  The buck (SOT-23-5 at rot 0: EN, GND, SW down its left; VIN, FB up its right) in the left cell's
    top-right quarter, EN to VIN under its body, the inductor under SW, the feedback network stacked right of FB; its
    output along y 9.8 to BUCK~'s coupling in the gutter and on the back to the LDO in the right cell's top-right quarter
    (turned 0: IN, GND, EN down its left; OUT up its right), whose output goes right and down to LDO~'s coupling over its
    jack and left and down to the load in the right cell's bottom-left quarter."""
    t = Tile("c2", "regulators", [(1, 2), (2, 2)], supply="+5 V", subtitle="buck, LDO, load", sections=["Regulators"])
    t.jack("TL0", "TRIM", "TRIM", "in", "±2 V", silk="TRIM 100K")
    t.jack("BR0", "BUCK~", "BJ", "out", "", silk="BUCK~")
    t.jack("TL1", "LOAD", "LOAD", "in", "0-1 V", silk="LOAD 50R")
    t.jack("BR1", "LDO~", "LJ", "out", "", silk="LDO~")
    power_header(t)
    t.pwr_flags.append("VB")                                        # the buck's output feeds the LDO: no power-output pin drives it
    W = 0.25
    # ---- the buck
    bk = t.add("U", "TLV62568", "TLV62568", 14.6, 4.4, 0, {"1": "VS", "2": "GND", "3": "SW", "4": "VS", "5": "FB"}, hide_value=False, label=None)
    l1 = t.add("L", "L2016_2U2", "2.2u", 13.4625, 7.65, 90, {"1": "VB", "2": "SW"}, label=None)              # pad 2 up, under SW
    cbi = t.add("C", "C0805 10uF", "10u", 16.6, 7.85, 90, {"1": "GND", "2": "VS"}, label=None)               # pad 2 up, under VIN
    cbo = t.add("C", "C0805 10uF", "10u", 11.1, 8.2, 90, {"1": "VB", "2": "GND"}, label=None)                # pad 1 down
    rtr = t.add("R", "R0402 100k", "100k", 17.8, 2.35, 0, {"1": "FB", "2": "TRIM"}, label=None)
    rfb = t.add("R", "R0402 20k", "20k", 17.8, 3.45, 0, {"1": "FB", "2": "GND"}, label=None)
    rft = t.add("R", "R0402 100k", "100k", 17.8, 4.55, 0, {"1": "FB", "2": "VB"}, label=None)
    cac1 = t.add("C", "C0603 1uF", "1u", 19.8, 11.4, 270, {"1": "VB", "2": "BA"}, label=None)              # pad 1 up
    rac1 = t.add("R", "R0603 49.9R", "49.9", 19.8, 14.4, 270, {"1": "BA", "2": "BJ"}, label=None)          # pad 1 up
    t.wire("VS", [(bk, "1"), (14.6, 3.7), (14.6, 5.0), (bk, "4")], width=W, silk=False)       # EN to VIN under the body
    t.gnd_stub(bk, "2", (11.9, 4.4), sym=(0, 0))
    t.wire("SW", [(bk, "3"), (l1, "2")], width=0.4)
    t.wire("VS", [(bk, "4"), (cbi, "2")], width=0.4)
    t.wire("FB", [(bk, "5"), (16.9, 3.45), (rfb, "1")], width=W)
    t.wire("FB", [(16.9, 3.45), (16.9, 2.35), (rtr, "1")], width=W)
    t.wire("FB", [(16.9, 3.45), (16.9, 4.55), (rft, "1")], width=W)
    t.gnd_stub(rfb, "2", (19.3, 3.45), sym=(0, 0))
    # TRIM: right from its jack to a via, along the back over the top to a via by its 100 k
    t.wire("TRIM", [("J%d01" % t.idx, "1"), (8.9, 4.75)])
    t.wire("TRIM", [(8.9, 4.75), (8.9, 1.6), (19.3, 1.6), (19.3, 2.35)], layer="B.Cu", silk=False, width=W)
    t.wire("TRIM", [(19.3, 2.35), (rtr, "2")], width=W)
    # VB: the inductor's foot to its capacitor and along y 9.8 (up the gutter to the top of the divider) to BUCK~'s
    # capacitor and a via; on the back under the LOAD jack and up to the LDO
    t.wire("VB", [(cbo, "1"), (12.6, 9.15), (l1, "1")], width=0.5)
    t.wire("VB", [(l1, "1"), (13.4625, 9.8), (20.8, 9.8)], width=0.5)
    t.wire("VB", [(19.3, 9.8), (19.3, 4.55), (rft, "2")], width=W)
    t.wire("VB", [(19.8, 9.8), (cac1, "1")], width=0.5)
    t.wire("VB", [(20.8, 9.8), (20.8, 8.9), (31.2, 8.9), (31.2, 3.6), (32.0, 3.2)], layer="B.Cu", silk=False, width=0.5)
    t.gnd_stub(cbo, "2", (11.1, 6.2), sym=(0, 0))
    t.gnd_stub(cbi, "1", (17.9, 8.8), sym=(0, 0))
    t.wire("BA", [(cac1, "2"), (rac1, "1")], width=W)
    t.wire("BJ", [(rac1, "2"), (19.8, 15.25), ("J%d02" % t.idx, "1")])
    # ---- the LDO (SOT-23-5 at rot 0) in the right cell's top-right quarter: EN to IN under the body
    ld = t.add("U", "TPS7A2033", "TPS7A2033", 34.6, 4.4, 0, {"1": "VB", "2": "GND", "3": "VB", "5": "VL"}, hide_value=False, label=None)
    cli = t.add("C", "C0603 1uF", "1u", 31.0, 4.0, 90, {"1": "GND", "2": "VB"}, label=None)                # pad 2 up
    clo = t.add("C", "C0603 1uF", "1u", 37.6, 3.9, 90, {"1": "GND", "2": "VL"}, label=None)                # pad 2 up
    cac2 = t.add("C", "C0603 1uF", "1u", 37.6, 9.15, 0, {"1": "LA", "2": "VL"}, label=None)
    rac2 = t.add("R", "R0402 49.9R", "49.9", 36.75, 10.82, 270, {"1": "LA", "2": "LJ"}, label=None)         # pad 1 up, over the jack
    t.wire("VB", [(ld, "3"), (34.6, 5.35), (34.6, 3.45), (ld, "1")], width=W, silk=False)
    t.wire("VB", [(32.0, 3.2), (ld, "1")], width=0.4)
    t.wire("VB", [(32.0, 3.2), (cli, "2")], width=0.4)
    t.gnd_stub(ld, "2", (32.0, 4.4), sym=(0, 0))
    t.gnd_stub(cli, "1", (32.0, 4.4), sym=(0, 0))
    t.wire("VL", [(ld, "5"), (clo, "2")], width=0.4)
    t.gnd_stub(clo, "1", (37.6, 5.8), sym=(0, 0))
    t.wire("VL", [(clo, "2"), (38.6, 3.125), (38.6, 8.2), (32.6, 8.2), (32.6, 13.6)], width=0.5)
    t.wire("VL", [(38.6, 8.2), (38.6, 9.15), (cac2, "2")], width=W)
    t.wire("LA", [(cac2, "1"), (rac2, "1")], width=W)
    t.wire("LJ", [(rac2, "2"), ("J%d04" % t.idx, "1")])
    # ---- the load in the right cell's bottom-left quarter: the OPA810 (rot 270: +IN, V-, OUT along its top; -IN, V+ along
    # its bottom) with 1 nF under it from OUT to -IN, 1 k from the shunt to -IN on its left, the FET and its shunt right
    ua = t.add("U", "OPA810", "OPA810", 25.4, 13.0, 270, {"1": "OG", "2": "GND", "3": "LIN", "4": "FBK", "5": "VS"}, hide_value=False, label=None)
    rtl = t.add("R", "R0402 49.9R", "49.9", 27.3, 9.5, 0, {"1": "LOAD", "2": "GND"}, label=None)
    # 1 k between LOAD and +IN: the op amp's negative rail is ground, so a DAC swinging below 0 V (or any input with the
    # tile switched off) would drive its input clamp from 25 ohm; 1 k holds that under 0.5 mA (its FET input draws nothing)
    rli = t.add("R", "R0402 1k", "1k", 24.45, 9.98, 270, {"1": "LOAD", "2": "LIN"}, label=None)             # pad 1 up
    cc = t.add("C", "C0603 1nF", "1n", 25.6, 16.4, 0, {"1": "FBK", "2": "OG"}, label=None)
    rc = t.add("R", "R0402 1k", "1k", 23.2, 15.8, 90, {"1": "SH", "2": "FBK"}, label=None)                  # pad 2 up
    rg = t.add("R", "R0402 100R", "100R", 28.2, 11.0, 0, {"1": "OG", "2": "GATE"}, label=None)
    q = t.add("Q", "NFET", "AO3400A", 29.8, 13.6, 0, {"1": "GATE", "2": "SH", "3": "VL"}, hide_value=True)
    rsh = t.add("R", "R0805 10R", "10R", 29.2, 17.0, 90, {"1": "GND", "2": "SH"}, label=None)               # pad 2 up
    coa = t.add("C", "C0402 100nF", "100n", 22.4, 12.6, 90, {"1": "GND", "2": "VS"}, label=None)            # pad 2 up
    t.wire("LOAD", [("J%d03" % t.idx, "1"), (26.25, 9.5), (24.45, 9.5), (rli, "1")])
    t.wire("LIN", [(rli, "2"), (ua, "3")], width=W)
    t.wire("LOAD", [(26.25, 9.5), (rtl, "1")])
    t.gnd_stub(rtl, "2", (28.6, 9.9), sym=(0, 0))
    t.gnd_stub(ua, "2", (25.4, 10.4), sym=(0, 0))
    t.wire("FBK", [(ua, "4"), (24.45, 16.4), (cc, "1")], width=W)
    t.wire("FBK", [(rc, "2"), (24.45, 15.29)], width=W)
    t.wire("OG", [(ua, "1"), (27.4, 11.8625), (27.4, 16.4), (cc, "2")], width=W)
    t.wire("OG", [(27.4, 11.8625), (27.4, 11.0), (rg, "1")], width=W)
    t.wire("GATE", [(rg, "2"), (28.71, 12.0), (q, "1")], width=W)
    t.wire("SH", [(q, "2"), (rsh, "2")], width=0.4)
    t.wire("SH", [(rsh, "2"), (27.9, 16.05), (27.9, 17.5), (23.2, 17.5), (rc, "1")], width=W)
    t.wire("VL", [(32.6, 13.6), (q, "3")], width=0.5)
    t.gnd_stub(rsh, "1", (29.2, 19.0), sym=(0, 0))
    t.via("VS", 26.35, 15.3)
    t.wire("VS", [(ua, "5"), (26.35, 15.3)], width=W)
    t.wire("VS", [(22.4, 11.0), (coa, "2")], width=W)
    t.gnd_stub(coa, "1", (22.4, 14.0), sym=(0, 0))
    # VS: the FET's drain to a via, along the back under the BUCK~ jack's legs to a via by the load's capacitor (a branch up
    # the gutter to the buck's input capacitor) and on to a via under the op amp's V+
    t.wire("VS", [HDR_VS, (8.54, 18.5), (10.6, 18.5)])
    t.wire("VS", [(10.6, 18.5), (10.6, 11.0), (22.4, 11.0)], layer="B.Cu", silk=False)
    t.wire("VS", [(17.9, 6.9), (18.6, 6.9), (18.6, 11.0), (22.4, 11.0)], layer="B.Cu", silk=False)
    t.wire("VS", [(17.9, 6.9), (cbi, "2")], width=0.4)
    t.wire("VS", [(22.4, 11.0), (23.4, 12.0), (26.35, 15.3)], layer="B.Cu", silk=False)
    t.text(6.0, 10.6, "c2", 1.5, 0.3, "center")
    t.titles.append("Regulators")
    t.result = "BUCK~ shows the buck's 1.5 MHz ripple (a few mV, pulse-skipping below about 150 mA); LDO~ the same after the LDO, 40 dB smaller; LOAD sets 100 mA per volt"
    t.notes = ["TLV62568: 3.6 V from 100 k / 20 k; TRIM through 100 k into the feedback node moves it (0 V: 4.2 V, +1 V: 3.2 V, open: 3.6 V).",
               "TPS7A2033: 3.3 V, about 92 dB of PSRR at 1 kHz and 40 dB at 1 MHz; below 3.5 V in it drops out (lower TRIM's voltage).",
               "The load: an OPA810 servos 10 ohm to LOAD's voltage through an AO3400A (1 k and 1 nF slow its loop): a square on LOAD",
               "is a load step.  Keep it under 100 mA for long (the shunt is 1/8 W), steps can be larger.  Both outputs are AC-coupled."]
    t.sch_draw = lambda ctx, tt: ctx.netlist_block(tt)
    return t


# ------------------------------------------------------------------------------------------------------------ c3 --
def tile_c3():
    """A charge pump the FPGA clocks: the ICL7660A from the switched 5 V, its OSC pin driven from Pmod IO6 through an
    SN74LV1T34 and 1 k (the pump runs at half the clock), 1 uF flying and 1 uF on the output, 1 k of load on the output;
    CAP shows the flying capacitor's top (0-5 V) and OUT the output (about -5 V), each through 47 k / 10 k (read at high
    impedance).  SOIC-8 at rot 0 (BOOST, CAP+, GND, CAP- down its left at 11.925; V+, OSC, LV, VOUT down its right at
    16.875) in the top-right quarter: the flying capacitor standing left of it with CAP's 47 k above, the output
    capacitor, V+'s capacitor and the load down the right edge, OSC under the body to the 1 k from the buffer below; CAP's
    10 k under its jack, OUT's divider over the OUT jack.  VS comes up the back to the buffer and V+; IO6 from the back."""
    t = Tile("c3", "charge pump", [(3, 2)], supply="+5 V", subtitle="ICL7660A", sections=["Regulators"])
    t.jack("TL", "CAP", "CJ", "out", "", silk="CAP /5.7")
    t.jack("BR", "OUT", "OJ", "out", "", silk="OUT /5.7")
    power_header(t)
    W = 0.25
    b = t.add("U", "LV1T34", "LV1T34", 12.0, 9.2, 0, {"2": "/PMOD6", "3": "GND", "4": "CK", "5": "VS"}, hide_value=True, label=None)
    u = t.add("U", "ICL7660A", "ICL7660A", 14.4, 4.95, 0, {"2": "CP", "3": "GND", "4": "CM", "5": "VO", "7": "OSC", "8": "VS"}, hide_value=False, label=None)
    cf = t.add("C", "C0603 1uF", "1u", 9.6, 5.585, 90, {"1": "CM", "2": "CP"}, label=None)                  # pad 2 up
    rc1 = t.add("R", "R0402 47k", "47k", 9.6, 3.0, 90, {"1": "CP", "2": "CJ"}, label=None)                 # pad 2 up
    rc2 = t.add("R", "R0402 10k", "10k", 4.75, 9.6, 270, {"1": "CJ", "2": "GND"}, label=None)              # pad 1 up, under the jack
    cv = t.add("C", "C0402 100nF", "100n", 18.85, 3.4, 90, {"1": "GND", "2": "VS"}, label=None)            # pad 2 up
    co = t.add("C", "C0603 1uF", "1u", 18.85, 6.6, 90, {"1": "VO", "2": "GND"}, label=None)                # pad 2 up
    rl = t.add("R", "R0603 1k", "1k", 18.85, 9.6, 90, {"1": "GND", "2": "VO"}, label=None)                 # pad 2 up
    rosc = t.add("R", "R0402 1k", "1k", 14.4, 9.6, 90, {"1": "CK", "2": "OSC"}, label=None)                # pad 2 up
    ro1 = t.add("R", "R0402 47k", "47k", 17.0, 8.15, 0, {"1": "OJ", "2": "VO"}, label=None)
    ro2 = t.add("R", "R0402 10k", "10k", 16.2, 10.1, 90, {"1": "GND", "2": "OJ"}, label=None)              # pad 2 up
    # the flying capacitor and CAP's divider: 47 k above it, the jack's pin, 10 k under the jack
    t.wire("CP", [(u, "2"), (10.3, 4.315), (cf, "2")], width=W)
    t.wire("CP", [(rc1, "1"), (cf, "2")], width=W)
    t.wire("CM", [(u, "4"), (10.3, 6.855), (cf, "1")], width=W)
    t.wire("CJ", [(rc1, "2"), (8.9, 2.49), (8.6, 4.75), ("J%d01" % t.idx, "1")])
    t.wire("CJ", [("J%d01" % t.idx, "1"), (rc2, "1")])
    t.gnd_stub(rc2, "2", (4.75, 10.9), sym=(0, 0))
    t.gnd_stub(u, "3", (13.5, 5.585), sym=(0, 0))
    # VOUT down the right edge: its capacitor, the load, the divider to the OUT jack
    t.wire("VO", [(u, "5"), (co, "1")], width=W)
    t.wire("VO", [(co, "1"), (rl, "2")], width=W)
    t.wire("VO", [(18.85, 8.15), (ro1, "2")], width=W)
    t.wire("OJ", [(ro1, "1"), (15.25, 8.15), ("J%d02" % t.idx, "1")])
    t.wire("OJ", [(ro1, "1"), (16.2, 8.15), (ro2, "2")], width=W)
    t.gnd_stub(rl, "1", (18.85, 11.0), sym=(0, 0))
    t.gnd_stub(ro2, "1", (17.0, 11.0), sym=(0, 0))
    t.gnd_stub(co, "2", (18.85, 4.75), sym=(0, 0))
    t.gnd_stub(cv, "1", (18.85, 4.75), sym=(0, 0))
    # OSC under the body to the 1 k, the buffer's output beside it; IO6 up from the back
    t.wire("OSC", [(u, "7"), (15.9, 4.315), (14.4, 4.8), (rosc, "2")], width=W, silk=False)
    t.wire("CK", [(b, "4"), (13.6, 9.85), (13.6, 10.11), (rosc, "1")], width=W)
    t.via("/PMOD6", 10.2, 9.2)
    t.wire("/PMOD6", [(10.2, 9.2), (b, "2")], width=W)
    t.gnd_stub(b, "3", (10.3, 10.4), sym=(0, 0))
    # VS: the FET's drain right to a via, up the back left of the OUT jack's legs to a via under the buffer's VCC, on
    # under the chip and up to a via by V+
    t.wire("VS", [HDR_VS, (8.54, 18.5), (11.4, 18.5), (11.4, 19.4)])
    t.wire("VS", [(11.4, 19.4), (11.0, 19.0), (11.0, 7.85), (17.9, 7.85), (17.9, 2.2)], layer="B.Cu", silk=False)
    t.via("VS", 12.84, 7.85)
    t.wire("VS", [(12.84, 7.85), (b, "5")], width=W)
    t.wire("VS", [(17.9, 2.2), (u, "8")], width=W)
    t.wire("VS", [(17.9, 2.2), (cv, "2")], width=W)
    t.text(2.4, 9.6, "c3", 1.2, 0.24, "center")
    t.titles.append("Charge pump")
    t.result = "about -5 V on the output, falling with load as 1 / (f C) + the switches: 2 k at 1 kHz, 80 ohm at 100 kHz (the pump at half IO6's clock)"
    t.notes = ["ICL7660A: switches charge the flying 1 uF across the supply and dump it, upside down, into the output's 1 uF.  IO6",
               "clocks it through an SN74LV1T34 and 1 k; with 1 k of load, sweep the clock and read OUT: Rout = 1 / (f C) + 60 ohm."]
    t.sch_draw = lambda ctx, tt: ctx.netlist_block(tt)
    return t


# ------------------------------------------------------------------------------------------------------------ c7 --
def tile_c7():
    """A track-and-hold: the LF398 on +-5 V (its minimum), 1 nF C0G as the hold capacitor, LOGIC from Pmod IO5 (high:
    track; TTL threshold 1.4 V, so 3.3 V drives it), LOGIC REF grounded; IN terminated in 49.9 ohm, OUT through 49.9 ohm.
    The SOIC-14 turned 90 low in the cell (IN, V-, OUT along its bottom at y 10.08; OFFSET, V+, LOGIC, LOGIC REF, CH along
    its top at 5.13), the hold capacitor, V+'s capacitor and the logic's via in the band above it; IN down the left to
    pin 1, its termination below; OUT round the right edge to its 49.9 ohm and in between the jack's right legs; V- to a
    via under the body and on the back to its capacitor in the strip left of the jack and the bottom margin; VS up the
    back on the left."""
    t = Tile("c7", "track and hold", [(3, 3)], supply="+-5 V", subtitle="LF398", sections=["Trading speed for bits"])
    t.jack("TL", "IN", "IN", "in", "±1 V", silk="IN 50R")
    t.jack("BR", "OUT", "OUT", "out", "")
    power_header(t)
    W = 0.25
    u = t.add("U", "LF398", "LF398", 13.8, 7.6, 90, {"1": "IN", "3": "-5V", "7": "OA", "8": "CH", "10": "GND", "11": "/PMOD5", "12": "VS"},
              hide_value=False, label=None)
    rt = t.add("R", "R0402 49.9R", "49.9", 8.6, 12.0, 270, {"1": "IN", "2": "GND"}, label=None)            # pad 1 up
    ch = t.add("C", "C0603 1nF", "1n", 17.6, 2.9, 0, {"1": "GND", "2": "CH"}, label=None)
    ro = t.add("R", "R0402 49.9R", "49.9", 19.55, 12.8, 90, {"1": "OUT", "2": "OA"}, label=None)           # pad 2 up, clear of the leg
    cvp = t.add("C", "C0402 100nF", "100n", 11.6, 2.75, 0, {"1": "VS", "2": "GND"}, label=None)
    cvn = t.add("C", "C0402 100nF", "100n", 10.3, 12.4, 90, {"1": "GND", "2": "-5V"}, label=None)          # pad 2 up
    t.wire("IN", [("J%d01" % t.idx, "1"), (8.8, 4.75), (8.8, 10.075), (u, "1")])
    t.wire("IN", [(8.8, 10.075), (8.8, 11.49), (rt, "1")])
    t.gnd_stub(rt, "2", (8.6, 13.4), sym=(0, 0))
    # the band above the chip: CH to the hold capacitor, LOGIC REF to ground, LOGIC to IO5's via, V+ to its capacitor
    t.wire("CH", [(u, "8"), (17.61, 4.0), (ch, "2")], width=W)
    t.gnd_stub(u, "10", [(15.07, 3.6), (15.6, 3.2)], sym=(0, 0))
    t.gnd_stub(ch, "1", (15.6, 3.2), sym=(0, 0))
    t.via("/PMOD5", 13.8, 3.2)
    t.wire("/PMOD5", [(13.8, 3.2), (u, "11")], width=W)
    t.wire("VS", [(cvp, "1"), (11.12, 3.6), (12.53, 3.9), (u, "12")], width=W)
    t.gnd_stub(cvp, "2", (12.9, 2.3), sym=(0, 0))
    # OUT round the right edge to the 49.9 ohm and into the jack between its right legs
    t.wire("OA", [(u, "7"), (19.55, 10.075), (ro, "2")], width=W)
    t.wire("OUT", [(ro, "1"), (19.55, 15.25), ("J%d02" % t.idx, "1")])
    # -5 V: a via under the body, on the back to a via by its capacitor and down to the bottom margin
    t.via("-5V", 12.53, 8.6)
    t.wire("-5V", [(u, "3"), (12.53, 8.6)], width=W, silk=False)
    t.wire("-5V", [(12.53, 8.6), (11.2, 9.9), (11.2, 11.7)], layer="B.Cu", silk=False, width=W)
    t.wire("-5V", [(11.2, 11.7), (cvn, "2")], width=W)
    rail(t, "-5V", (11.2, 11.7), "margin")
    t.gnd_stub(cvn, "1", (10.5, 13.9), sym=(0, 0))
    # VS: the FET's drain right to a via and up the back on the left to a via by V+'s capacitor
    t.wire("VS", [HDR_VS, (8.54, 18.5), (9.8, 18.5)])
    t.wire("VS", [(9.8, 18.5), (9.8, 3.0)], layer="B.Cu", silk=False)
    t.wire("VS", [(9.8, 3.0), (cvp, "1")], width=W)
    t.text(6.0, 10.6, "c7", 1.5, 0.3, "center")
    t.titles.append("Track/hold")
    t.result = "OUT follows IN while IO5 is high and holds when it falls: 4 us to acquire, about 30 mV/s of droop, a few mV of hold step"
    t.notes = ["LF398 on +-5 V (its minimum supply: inputs within +-1.5 V).  1 nF C0G: acquisition about 4 us, droop about 30 mV/s.",
               "Measure the acquisition time, the droop, the pedestal (the hold step) against IN, the feedthrough of a sine while",
               "holding, and the aperture delay against the FPGA's edge on IO5."]
    t.sch_draw = lambda ctx, tt: ctx.netlist_block(tt)
    return t
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
