gallicchio/AMOD-and-RFMOD/(commit log)

2026-10-25 Repository skeleton: licences, gitignore, the shared scripts from the op-amp board
    Claude-Session: https://claude.ai/code/session_01RKeoKvFFzjk3cEBLCXXHnB
2026-10-25 AMOD-P: ERC, circuit checks and DRC all clean; the tile budget redone (line 10.6, loops lying under the jacks, values above the line, sections under the number), half-pitch DSHP switches, the delay l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
    [amod_p.kicad_pcb, amod_p.kicad_sch]
2026-10-25 AMOD-P: fab package passes every check; the LED footprint with a cathode bar and its model; stale DSIC files removed
    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
    [amod_p-B_Cu.gbr, amod_p-B_Mask.gbr, amod_p-B_Paste.gbr, amod_p-B_Silkscreen.gbr, amod_p-Edge_Cuts.gbr, amod_p-F_Cu.gbr, amod_p-F_Mask.gbr, amod_p-F_Paste.gbr]
2026-10-25 AMOD-A: framework (4 layers, rail pours, power header, grid router), A1 power, A2 x10, A3 x100 at DRC 0
    - gen_pcb: every pad is an obstacle (the SMA's four legs were one), polygon rail pours, wire silk
    clipped around footprint silk, wires can ask for no silk, loops can hide their name
    - A1: socket along the top edge with its pins named in the gutter, LEDs in the margin, rails on the back
    - A2/A3: one hand-placed layout (opa_tile) with every clearance checked against the footprints
    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
    [amod_a.kicad_pcb, amod_a.kicad_sch]
2026-10-25 AMOD-A A4: the OPA847 LNA at DRC 0 (feedback through the NC pin, VS on the back, own SOIC-8 symbol)
    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
    [amod_a.kicad_pcb, amod_a.kicad_sch]
2026-10-25 AMOD-A A5: Johnson noise on an LT6230 (1.1 nV) in the A2 geometry, 10k / 1k by DIP or a socketed resistor, DRC 0
    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
    [amod_a.kicad_pcb, amod_a.kicad_sch]
2026-10-25 AMOD-A A6 (delta-sigma), A8 (heater), A11 (ultrasound + the Pmod plug and lines) at DRC 0; the op-amp geometry takes an offset
    - +3.3 V tiles' header via in the gutter below; board-level back wires; the QR and back text per board
    - the schematic joins adjacent same-net pins with one label
    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
    [amod_a.kicad_pcb, amod_a.kicad_sch]
2026-10-25 AMOD-A A7 (4046 PLL) and A9 (MC1496 mixer) at DRC 0; the Pmod corridor moved left of A9's LO jack; 0402 passives
    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
    [amod_a.kicad_pcb, amod_a.kicad_sch]
2026-10-25 AMOD-A complete: A10 (light) and A12 (audio) at DRC 0; all twelve tiles, the Pmod lines and the -5 V pour across both gutters
    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
    [amod_a.kicad_pcb, amod_a.kicad_sch]
2026-10-25 AMOD-A: the fab package passes every check; stand-in 3D models for three library footprints; gen_docs (handbook, manufacturing, design notes); the chat log
    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
    [amod_a-B_Cu.gbr, amod_a-B_Mask.gbr, amod_a-B_Paste.gbr, amod_a-B_Silkscreen.gbr, amod_a-Edge_Cuts.gbr, amod_a-F_Cu.gbr, amod_a-F_Mask.gbr, amod_a-F_Paste.gbr]
2026-10-25 Plan: the AMOD-A table as built; the handbook carries the tiles' notes
    [amod_a.kicad_sch]
2026-10-25 RF-MOD rev A, first five tiles at DRC 0: filters R2/R4, GALI-84+ gain blocks R5/R12, power and reference R9; the RF framework (top pour, launch voids, via fences, RF net class); IN top-left / OUT bot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
    [rf_mod-B_Cu.gbr, rf_mod-B_Mask.gbr, rf_mod-B_Paste.gbr, rf_mod-B_Silkscreen.gbr, rf_mod-Edge_Cuts.gbr, rf_mod-F_Cu.gbr, rf_mod-F_Mask.gbr, rf_mod-F_Paste.gbr]
2026-10-25 RF-MOD: the two MAX2871 synthesizer tiles (R10 host of the Pmod plug, R11) at DRC 0; a Fine net class at 0.127 mm with 0.45/0.25 vias for the QFN fan-out, V33 islands on L3, FRONT_WIRES; the fab pack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
    [amod_a.kicad_sch, amod_p.kicad_sch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]
2026-10-25 RF-MOD filled: ADL5350 mixers R7/R8, a resistive splitter R1, ten tiles on sixteen cells at ERC/DRC 0 and the fab package passing; stand-in 3D bodies scaled 1/2.54 (VRML unit) on every board
    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
    [amod_a.kicad_pcb, amod_a.kicad_sch, amod_p.kicad_pcb, amod_p.kicad_sch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]
2026-10-25 Pmod plugs: fix the mirrored pinout on AMOD-A and RF-MOD (JLCPCB's numbering of the PZ254R runs opposite to KiCad's): plug two columns left, nets renamed to the standard IO numbers, a fab check of ev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
    [amod_a-B_Cu.gbr, amod_a-B_Mask.gbr, amod_a-B_Silkscreen.gbr, amod_a-F_Cu.gbr, amod_a-F_Mask.gbr, amod_a-F_Silkscreen.gbr, amod_a-In1_Cu.gbr, amod_a-In2_Cu.gbr]
2026-10-25 The fourth board: the Icepi Zero 2x12 adapter with a Pmod (copied from the OpticsPCBs generator's adda12p), with its README
    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
    [IcepiZero_AD9280_AD9708_2x12_Pmod-pinmap.csv, IcepiZero_AD9280_AD9708_2x12_Pmod.kicad_pcb, IcepiZero_AD9280_AD9708_2x12_Pmod.kicad_sch]
2026-10-25 Docs: PLAN as built for RF-MOD and the adapter, the Pmod renumbering in AMOD-A's prose and table, the DOA lists and the review brief
    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
    [amod_a.kicad_pcb, amod_a.kicad_sch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]
2026-10-25 docs/KIT.md: what a bench needs beside the boards (power, SMA cables and adapters, antennas, transducers, feet)
    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
2026-10-25 README (the repository's landing page, which every board's QR code points at); chat log Prompts 8-10; a clean rebuild of all three boards (ERC 0, DRC 0, every fab check), zone fills differing by micr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
    [amod_a.kicad_pcb, amod_a.kicad_sch, amod_p.kicad_sch, rf_mod.kicad_sch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]
2026-10-25 Jacks in a checkerboard on every board (Prompt 12): every pair 14.85 mm or more
    IN at a cell's top-left slot, OUT at its bottom-right, a two-cell tile's third jack
    at its right cell's top-left. geometry.py now asserts 14.3 mm between every pair.
    - AMOD-P: all thirteen tiles re-laid; P8's crystal and P9's resonator at 45 degrees
    (P8's jacks 0.5 mm further out, slots TLo/BRo); P11's taps on TL/BR slots.
    - AMOD-A: A2-A4 share opa_tile_br; A4's OPA847 now SOT-23-6 (C160422); A7 now
    Nexperia's 74HC4046APW-Q100J in TSSOP-16 (C546981, 234 in stock); A8, A9 and A11
    re-laid with OUT at the bottom-right; the back's QR code moved. $50.90 of parts.
    - RF-MOD: the mixers' LO jacks moved from the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
    [amod_a-B_Cu.gbr, amod_a-B_Mask.gbr, amod_a-B_Silkscreen.gbr, amod_a-F_Cu.gbr, amod_a-F_Mask.gbr, amod_a-F_Paste.gbr, amod_a-F_Silkscreen.gbr, amod_a-In1_Cu.gbr]
2026-10-25 RF-MOD rev A: the QPL9547 LNA in R5 and the TRF3722 quadrature transmitter as R13 (Prompt 13)
    - R5: QPL9547TR7 (C5367093, 5,070 in stock; rev A's search had missed the reel) on
    Qorvo's evaluation circuit, in place of a second GALI-84+: 0.3 dB of noise figure
    for every receiver. R12 stays the GALI-84+ gain block; the 7.8 V strip now ends at it.
    - R13 (cells of the old R11): TRF3722 (C1850395, 2,218) with I and Q from the ECP5
    board's two DACs through resistor networks to its 0.25 V common mode, TI's
    fractional loop filter, a TLV75733 in the WSON (0.56 W) on a 3.3 V island, the
    reference from R10's REF IN on the back, SPI shared with R10 (LE IO6, readback IO5).
    Jason's "Yes. Add t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
    [rf_mod-B_Cu.gbr, rf_mod-B_Mask.gbr, rf_mod-B_Silkscreen.gbr, rf_mod-F_Cu.gbr, rf_mod-F_Mask.gbr, rf_mod-F_Paste.gbr, rf_mod-F_Silkscreen.gbr, rf_mod-In1_Cu.gbr]
2026-10-25 AMOD-A rev A: A5 an HB100 Doppler radar, A10 an impedance and I-V tile (Prompt 13)
    The ECP5-2ADC-2DAC board has its own Johnson-noise source with a x100 input, an LED
    current source and a 9 MHz photodiode amplifier, so A5 (Johnson noise) and A10 (LED
    and photodiode) duplicated it.
    - A5: a 1 x 3 header for an HB100 10.525 GHz Doppler module (+5 V from the tile's
    switch, IF, ground), its IF through 1 uF into the A2 geometry at x101: a speed gun,
    vibrometry, breathing; the only route above 6 GHz.
    - A10: DRIVE IN x2 is the node S (and S OUT through 49.9 ohm); a 4-way DIP picks
    47 / 470 / 4.7 k / 47 k from S to X, the part on the DUT jack, an OPA810 follower to
    X OUT. Two ADCs make an i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
    [amod_a-B_Cu.gbr, amod_a-B_Mask.gbr, amod_a-B_Silkscreen.gbr, amod_a-F_Cu.gbr, amod_a-F_Mask.gbr, amod_a-F_Paste.gbr, amod_a-F_Silkscreen.gbr, amod_a-In1_Cu.gbr]
2026-10-25 RF-MOD-2 rev A: the coherent I/Q transceiver board (Prompt 13)
    Eleven tiles for the ECP5-2ADC-2DAC board: an ADL5375-05 modulator fed by its
    DACs (X1), an ADL5380 demodulator with two OPA810 difference amplifiers into its
    ADCs (X2), RF-MOD's MAX2871 synthesizer with its own REF IN (X3) split by a
    resistive splitter into both LOs (X5), the QPL9547 LNA (X4), an AD8318 log
    detector (X6), a switched avalanche noise source with an ADL5611 and a 20 dB
    pad (X7), a GNSS front end (bias-T, SAW, MAX2659, SAW: X8), a loop for NV
    centres' ODMR with every plane cleared under it (X9), USB-C and -5 V (X10) and
    a SKY13370 absorptive SPDT on two Pmod lines (X11). ERC, DRC and every fab
    check pass; parts $98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
    [amod_a.kicad_pcb, amod_a.kicad_sch, amod_p.kicad_sch, rf_mod.kicad_pcb, rf_mod.kicad_sch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]
2026-10-25 AMOD-2 in progress: Y1 power (TPS65131 +-15 V, USB-C, LM2664), Y2 THS3491 pulse amplifier, Y3 duplexer and OPA847 preamp, Y5 two-channel LMH6629 HF receiver with the Pmod plug
    ERC 0, DRC 0 so far. The schematic's rails now include +-15 V as power symbols; THS3491 in RGT, DRV8876 symbols;
    the first-level schematics regenerate with the wrapped-notes block heights (connectivity unchanged).
    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
    [amod_2.kicad_pcb, amod_2.kicad_sch, amod_a.kicad_sch, amod_p.kicad_sch, rf_mod.kicad_sch, rf_mod_2.kicad_sch]
2026-10-26 AMOD-2 in progress: Y9 switched noise source, Y7 reflection bridge (INC and REFL = 2A - 2B), Y8 passive coupled resonators with capacitive ports
    ERC 0, DRC 0. IO8 reaches Y9 round the left and top margins; Y9's -5 V up a finger of L3 from the gutter.
    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
    [amod_2.kicad_pcb, amod_2.kicad_sch]
2026-10-26 AMOD-2 in progress: Y10 laser driver (100 mA/V high-side source, IO5 shunt, 20 MHz - 3 GHz bias-T, diode-voltage monitor)
    ERC 0, DRC 0. IO5 up the gutter at x 50.4; a foot moved off the LD jack.
    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
    [amod_2.kicad_pcb, amod_2.kicad_sch]
2026-10-26 AMOD-2 rev A: all ten tiles (Y6 VLF loop amplifier, Y4 DRV8876 coil driver added); per-board fiducials
    ERC 0, DRC 0. IO6 / IO7 reach Y4 on the back along the bottom edge and across the top of Y6; the third fiducial
    moves off Y4's coil terminal (FIDUCIALS in the board module, default unchanged).
    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
    [amod_2.kicad_pcb, amod_2.kicad_sch]
2026-10-26 Prompt 13 documents: AMOD-2 and RF-MOD-2 handbooks and DOA lists, PLAN_LEVEL2 as built, first-level DOA and PLAN updated for A5/A10/R5/R13, README for five boards, review brief, chat log; determinist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
    All five boards rebuilt from scratch: ERC 0, DRC 0, every fab check. Parts per board: AMOD-P $16.97, AMOD-A $50.40,
    RF-MOD $57.19, AMOD-2 $78.19, RF-MOD-2 $98.61. The schematic's block frames had a bare string for a uuid, which KiCad
    replaced with a random one on every save (the frames reordered each build); they now use uid().
    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
    [amod_2-B_Cu.gbr, amod_2-B_Mask.gbr, amod_2-B_Paste.gbr, amod_2-B_Silkscreen.gbr, amod_2-Edge_Cuts.gbr, amod_2-F_Cu.gbr, amod_2-F_Mask.gbr, amod_2-F_Paste.gbr]
2026-10-26 KIT.md: the second level's needs (NMR magnet, coils, DPPH, HF and VLF antennas, low-pass, lasers, Rb cell, NV diamond, ODMR amplifier, GNSS antenna) and A5's HB100; 30 dB on SET for a VCSEL on Y10
    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
2026-10-28 Silkscreen says what each tile is and whose jack is whose: jack names on their own tile's frame, titles in words on the top frame, ranges and levels placed inside; tutorial section numbers off the bo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
    [amod_2.kicad_pcb, amod_a.kicad_pcb, amod_a.kicad_sch, amod_p.kicad_pcb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]
2026-10-28 A12: the speaker channel's jack is SPEAKER IN (whose input: the speaker's), beside MIC OUT; A11's docs say its 5 V powers the TX bridge and the RX op amp
    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
    [amod_a.kicad_pcb, amod_a.kicad_sch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]
2026-10-28 P13: a VAR C screw terminal beside the coil's for an external tuning capacitor (a polyvaricon and its dial do not fit a cell); the DIP and its capacitors moved up into the right cell's top half; KIT.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
    [amod_p-B_Cu.gbr, amod_p-B_Mask.gbr, amod_p-B_Silkscreen.gbr, amod_p-F_Cu.gbr, amod_p-F_Mask.gbr, amod_p-F_Paste.gbr, amod_p-F_Silkscreen.gbr, amod_p-PTH-drl_map.gbr]
2026-10-28 RF-MOD: R1 is a diode-ring mixer (ADEX-10L+, 10-1000 MHz, LO +4 dBm; its baluns and ring of four diodes drawn on the silk) in the splitter's place; R10's RFOUTA- comes out on OUT A- (bottom-right of 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
    Generators: silk drawings (Tile.draw_line / draw_arc), a top-pour tongue below an RF tile (Tile.pour_below), jack names slide up to 4.5 mm and say what blocks them; footprints, symbols and models for the ADEX-10L+ and the HHM22137A1 coupler.
    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
    [rf_mod-B_Cu.gbr, rf_mod-B_Mask.gbr, rf_mod-B_Silkscreen.gbr, rf_mod-F_Cu.gbr, rf_mod-F_Mask.gbr, rf_mod-F_Paste.gbr, rf_mod-F_Silkscreen.gbr, rf_mod-In1_Cu.gbr]
2026-10-28 RF-MOD-2: X5 is a dual directional coupler (two HHM22137A1 back to back, 0.6-3.5 GHz, FWD and REFL 25 dB down, 20 dB directivity) in the splitter's place; X3's RFOUTA- on OUT A- (its right cell's bot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
    [rf_mod.kicad_pcb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]
2026-10-28 Docs for Prompt 15: the tile records, handbooks and README tables for R1 (diode-ring mixer), R10 and X3 (OUT A+ and OUT A-), X5 (dual directional coupler), P13 (VAR C), A12 (SPEAKER IN); DOA items fo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
2026-10-28 RF-MOD and RF-MOD-2 subtitles (on the copper and the schematic) without the splitters; rebuilt
    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
    [rf_mod.kicad_pcb, rf_mod.kicad_sch, rf_mod_2.kicad_pcb, rf_mod_2.kicad_sch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]
2026-10-28 Rename AMOD-2 to PhMOD (Jason, Prompt 17: the board with the laser and the NV-centre work is the physics board; AMOD-2 will be the name's past)
    PhMOD: magnetic resonance, the ionosphere and light. The stem is phmod (boards/phmod.py, docs/HANDBOOK_phmod.md,
    docs/DOA_phmod.md, out/phmod/, hardware/phmod.*); the tiles keep their numbers Y1-Y10. The back's name is printed as
    spelled (no upper-casing). Rebuilt: ERC 0, DRC 0, all fab checks, $78.19 of parts a board as before.
    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
    [amod_2-B_Cu.gbr, amod_2-B_Mask.gbr, amod_2-B_Paste.gbr, amod_2-B_Silkscreen.gbr, amod_2-Edge_Cuts.gbr, amod_2-F_Cu.gbr, amod_2-F_Mask.gbr, amod_2-F_Paste.gbr]
2026-10-28 JLCPCB placements: the SOT-23 family, SOICs, TSSOP and headers turned as JLCPCB draws them; parts moved to JLCPCB's origins
    scripts/check_rotations.py fits JLCPCB's own land pattern (easyeda) onto each footprint on the board, pad number by pad
    number, at each quarter turn, and reports the turn that fits and where JLCPCB's origin sits in our footprint. It found:
    - every SOT-23 / SOT-23-5 / SOT-23-6 at 0 in rev A's table ('the standard drawing'). JLCPCB's drawings marked -BR have
    pin 1 bottom-right: KiCad's turned 180 (AO3401A in every powered tile, 2N7002s, MMBT3904, TMP235, LM2664, TLV3501,
    TPS22917, TPS7A2033, LVC1G17, LMH6629). The -BL ones (OPA847, LT6230, MT3608) are KiCad's turn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
    [amod_a_cpl_jlcpcb_upload.csv, phmod_cpl_jlcpcb_upload.csv, rf_mod_2_cpl_jlcpcb_upload.csv, rf_mod_cpl_jlcpcb_upload.csv]
2026-10-28 AMOD-P2: the second passive board (Jason, Prompt 17), twelve tiles on sixteen cells, two of them on the Pmod's 3.3 V
    "Make a analog passive board and fill it with the tiles that got bumped or new ones that would be great to have";
    "SLOT for VNA-type calibration, passive splitters"; "If something can run on 3.3V, it could still be plugged into the
    PMOD port but wouldn't require an external USB 5V input."
    P14 calibration (SHORT and OPEN at the pin, LOAD, a 25 ohm check standard, a 19.8 mm THRU), P15 two Smith-chart loads
    (200 ohm, and 200 ohm matched at 9.2 MHz by 1.5 uH / 150 pF), P16 a resistive splitter (3 x 16.9 ohm, DC-6 GHz), P17 a
    transformer splitter (ADP-2-1+, 0.5-400 MHz, 25 dB isol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
    [amod_p2-B_Cu.gbr, amod_p2-B_Mask.gbr, amod_p2-B_Paste.gbr, amod_p2-B_Silkscreen.gbr, amod_p2-Edge_Cuts.gbr, amod_p2-F_Cu.gbr, amod_p2-F_Mask.gbr, amod_p2-F_Paste.gbr]
2026-10-28 Silk case convention on all six boards (Jason, Prompt 17: "To distinguish whole-tile labels from SMA or port labels, use different cases")
    Ports (the jacks' names, terminal and loop names, a port named inside a note) stay UPPER CASE. A tile's label (its
    title on the frame, its name in the corner) is Mixed case: the first letter capitalised and the rest as written ("RC
    low-pass", "Synthesizer", "I/Q demodulator"; tiles.label_case). Ranges, values and notes are lower case except units,
    acronyms and part numbers ("loss 1.7 dB", "OUT floats"). RF-MOD-2's X1 and X2 take word titles with their chips in
    the info; RF-MOD's and RF-MOD-2's LNA tiles are titled "Preamp" ("Low-noise amp" does not fit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
    [amod_a.kicad_pcb, amod_a.kicad_sch, amod_p.kicad_pcb, phmod.kicad_pcb, phmod.kicad_sch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]
2026-10-28 Documents for AMOD-P2 and the renames: handbook text, README (six boards, AMOD-P2 second), PLAN.md section 11, review brief, DOA lists
    AMOD-P2's handbook introduction and 'The tiles together'; the README's table and board section; PLAN.md section 11 (what
    was decided and why, the tiles as built, what was left out, the placement audit); the review brief; docs/DOA_amod_p2.md;
    every powered board's DOA list gets the placement correction as an order gate; RF-MOD-2's coupler check calibrates on
    P14. Generated handbooks, MANUFACTURING.md and DESIGN_NOTES.md rewritten.
    Claude-Session: https://claude.ai/code/session_01RKeoKvFFzjk3cEBLCXXHnB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
2026-10-28 Final rebuild of all six boards; the chat log for Prompt 17; AMOD-P2's handbook says its Pmod 3.3 V is its supply; the rotation audit's known exceptions
    All six boards: ERC 0, DRC 0, every fab check. check_rotations.py: 187 codes, every fit agrees with the table except five
    recorded with their reasons (three LEDs read at 0 in a preview, a two-pad crystal, the ADL5350's renumbered footprint).
    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
    [amod_a.kicad_pcb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]
2026-10-28 Back-side panels on all six boards; P22 set by hand or by the FPGA; P15 dropped
    Jason, Prompt 18: "I hope that the silkscreen (including on the back) is appropriately used to document anything that a
    user definitely needs to know to use the tiles successfully and without damaging anything. If there is additional room
    on the back, putting plots of expected responses or other relevant parameters would be great."
    - gen_pcb.back_panels: under each tile, mirrored on the back silk, its number and title and the lines in its board's
    BACK dict (levels, loads, supplies, cautions), and where there is one its expected response as a small plot
    (BACK_PLOTS, or the ladder tiles' own simulation; scrip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
    [amod_a.kicad_pcb, amod_p.kicad_pcb, amod_p2.kicad_pcb, amod_p2.kicad_sch, phmod.kicad_pcb, rf_mod.kicad_pcb, rf_mod_2.kicad_pcb]
2026-10-28 Full rebuild of all six boards with the back panels; AMOD-P2's documents for P22's switch and P15's removal; the ADI labs survey and a proposed AMOD-A2
    - Every stage of every board: ERC 0, DRC 0, all checks; check_rotations 186 codes, 0 differ (the DSHP08 entered at 0).
    - AMOD-P2: eleven tiles, 28 jacks, $43.82 of parts. PLAN.md's row and section 11 table, the DOA list (P22's pins and
    hand mode, the 8-way switch's orientation, bench steps), KIT, the review brief (items 12 and 13: the back panels and
    P22's hand mode), the README's row and a paragraph on the back panels.
    - docs/ADI_LABS_SURVEY.md: Analog Devices' university labs against the boards (Jason, Prompt 18). PLAN.md section 12: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
    [amod_a.kicad_pcb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]
2026-10-28 One letter per board, tiles in lower case: AMOD-P2 is AMOD-N (n1-n11), RF-MOD-2 is IQ-MOD (q1-q11), PhMOD's tiles h1-h10
    Jason, Prompt 19: "If we can have a nice, well justified single-letter designator for each board, it would make
    everything much more clear", and "d11, q11, and c11 don't look like obvious electronics or PCB things".
    - p passive, n networks (AMOD-P2's P14, P16-P25), a active, r radio, h PhMOD (Y1-Y10), q quadrature (RF-MOD-2's X1-X11);
    c, m and b are taken for the conversion, motor and brushless boards to come. PLAN.md section 13 has the table and
    the reasons (no letter moves to another board, no retired name is reused, no s: s11 is the reflection coefficient).
    - Ever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
    [amod_a.kicad_pcb, amod_a.kicad_sch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]
2026-10-29 AMOD-C in progress (Prompt 19): every tile hand-placed against its courtyards and checked; c12 on an OPA2197, c10 on a DMMT3904W pair with a 1 x 2 jumper, c6's DACs ratiometric to +3.3 V; +3.3 V pour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
    [amod_c.kicad_pcb, amod_c.kicad_sch]
2026-10-29 AMOD-C: DRC 0 (Prompt 19). The Pmod's eight lines in lanes that never cross (the IOs reassigned so they nest: c5 IO8/IO4, c4 IO3, c8 IO2 down the left margin; c6 IO1/IO7, c7 IO5, c3 IO6 along the bot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
    [amod_c.kicad_pcb, amod_c.kicad_sch]
2026-10-29 AMOD-C: back panels for every tile (the front's four orphan notes moved there), a 5th-order Butterworth under c4 and the pair's tanh under c9
    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
    [amod_c.kicad_pcb]
2026-10-29 AMOD-C: handbook, tile docs, Pmod line names and the README's table; JLCPCB rotations for its fifteen new codes (check_rotations: 209 codes, 0 differ); c10's gain stated from IN (-6) as well as at th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
    [amod_c-B_Cu.gbr, amod_c-B_Mask.gbr, amod_c-B_Paste.gbr, amod_c-B_Silkscreen.gbr, amod_c-Edge_Cuts.gbr, amod_c-F_Cu.gbr, amod_c-F_Mask.gbr, amod_c-F_Paste.gbr]
2026-10-29 Two pinouts read against their datasheets and fixed: the DMMT3904W (AMOD-C's c9 and c10) is 1 B2, 2 B1, 3 C1, 4 E1, 5 E2, 6 C2, not the BCM857BS's order (c9's pair turned 180 with IN+ under it on the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
    [amod_c.kicad_pcb, amod_c.kicad_sch, rf_mod.kicad_pcb, rf_mod.kicad_sch]
2026-10-29 AMOD-C: c6's second integrator 680 pF (half the swing, the same bits: the comparator sees only its sign) and 10 k into the comparator's +IN, so the 3.3 V comparator survives an integrator at a rail; 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
    [amod_c.kicad_pcb, amod_c.kicad_sch]
2026-10-29 AMOD-C: the dead-on-arrival list (pins, rotations, the bench's first numbers) and the regenerated handbook
    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
    [amod_c-B_Cu.gbr, amod_c-B_Silkscreen.gbr, amod_c-F_Cu.gbr, amod_c-F_Mask.gbr, amod_c-F_Paste.gbr, amod_c-F_Silkscreen.gbr, amod_c-In1_Cu.gbr, amod_c-In2_Cu.gbr]
2026-10-29 AMOD-M: the motor board's eleven tiles laid out, ERC 0 and DRC 0 (Prompt 19)
    m3 a brushed DC motor (DRV8251A, IPROPI and the terminal voltage on jacks,
    a JST PH for the encoder motor, its own 3.3 V), m4 a stepper (two DRV8251A,
    the XH's leads nested from below), m5 a servo, m6 a solenoid (NCE6020AK, the
    flyback chosen by a jumper on a 1 x 3 header: Schottky, TVS or avalanche),
    m7 a DC-coupled TCA0372 bridge with its load current both ways, m8 a
    TPS28225 synchronous buck stage, m9 hall, m10 optical, m11 load cell, m1 and
    m2 the power. The QR code over m7's right cell, the back's text in the
    bottom margin. New parts' JLCPCB rotations and origins from
    check_rotations (64 codes, 0 differ); sub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
    [amod_m-B_Cu.gbr, amod_m-B_Mask.gbr, amod_m-B_Paste.gbr, amod_m-B_Silkscreen.gbr, amod_m-Edge_Cuts.gbr, amod_m-F_Cu.gbr, amod_m-F_Mask.gbr, amod_m-F_Paste.gbr]
2026-10-29 AMOD-M: the back panels, the Pmod lines, the handbook, the dead-on-arrival list; AMOD-C and AMOD-M in the README's table
    Each tile's back says what to know while cabling it (the encoder's PH order, the
    stepper's XH, the servo header, the solenoid's jumper, the linear amplifier's
    watt); tile_docs gains AMOD-M's eleven entries and the motor chips' pages.
    m7's clipping plot found no room beside the QR code and was dropped.
    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
    [amod_m.kicad_pcb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]
2026-10-29 AMOD-B: the brushless board laid out, ERC 0, DRC 0, fab checks passed (Prompt 19)
    Twelve tiles: a DRV8311H in 3x PWM from three Pmod lines with COAST from a DAC (its current amplifiers shifted to 0 by
    3.3 k / 10 k to -5 V: 0.75 V/A), a GBM2804 gimbal motor on four slots over an MT6701 (turned 180, its pins to vias
    under it), two halls and an index sensor; back-EMF, phase and bus currents, the encoder's analog angle, vibration and
    an LSM6DSO IMU that shares MISO with the encoder through a 74LVC1G125. The lines between tiles run on the back
    (BACK_WIRES): the plug's five SPI lines up the gutter in nested lanes (MISO on IO3, CS ENC on IO6 so they nest), the
    encoder's on 45-degree lines between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
    [amod_b-B_Cu.gbr, amod_b-B_Mask.gbr, amod_b-B_Paste.gbr, amod_b-B_Silkscreen.gbr, amod_b-Edge_Cuts.gbr, amod_b-F_Cu.gbr, amod_b-F_Mask.gbr, amod_b-F_Paste.gbr]
2026-10-29 The documents brought up to nine boards (Prompt 19), and a full rebuild of all nine: ERC 0, DRC 0, every fab check
    PLAN.md section 14 rewritten as built (AMOD-M on DRV8251A, its supply / 16 and no terminal, m4 on IN1 / IN2, m6's three
    flybacks, m7's gain of 4; AMOD-B's twelve tiles, b3's passive level shift, the SPI lanes' nesting and the +3.3 V band
    over the gimbal's slots) and a section 15 for AMOD-C as built; the letters table's tile ranges and the status list.
    KIT.md: AMOD-C's note and a Motors and actuators section for AMOD-M and AMOD-B (about $100 a bench, $82 with PhMOD's
    supply), from the parts search of 2026-10-28, with the gimbal motor's screws, the N20's lead to make and the a12
    s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
    [amod_c.kicad_pcb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]
2026-10-30 Pre-order checks from CLAUDE_PCB.md's new lessons (Prompt 21): the KF301 terminals turned for their wire openings (CPL +180, body 3.7 / 4.0, a wire-face check), four oversold parts swapped (27R, 6.8k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
    Claude-Se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
    [amod_a.kicad_pcb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]
2026-10-30 AMOD-A's PAM8302 on its real MSOP-8 (Prompt 22: JLCPCB's preview showed the MSOP-8 on our SOIC-8 pads; a12 re-laid, pin 2 NC); check_overlay.py lays JLCPCB's drawing on our pads in every build (a wro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
    [amod_a-B_Cu.gbr, amod_a-F_Cu.gbr, amod_a-F_Mask.gbr, amod_a-F_Paste.gbr, amod_a-F_Silkscreen.gbr, amod_a-In1_Cu.gbr, amod_a-In2_Cu.gbr, amod_a-PTH-drl_map.gbr]
2026-10-30 MANUFACTURING.md: the RF boards' quote as Jason filled it (Prompt 23): JLC04161H-7628 by name, Impedance Control no requirement, the 0.25 mm vias' TG155 and Kelvin-test surcharge; the chat log
    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
